doinbest/Yachiyo/xjx/模版搭建/Code/upper-computer-web/local-car/assets/parasol-original.png

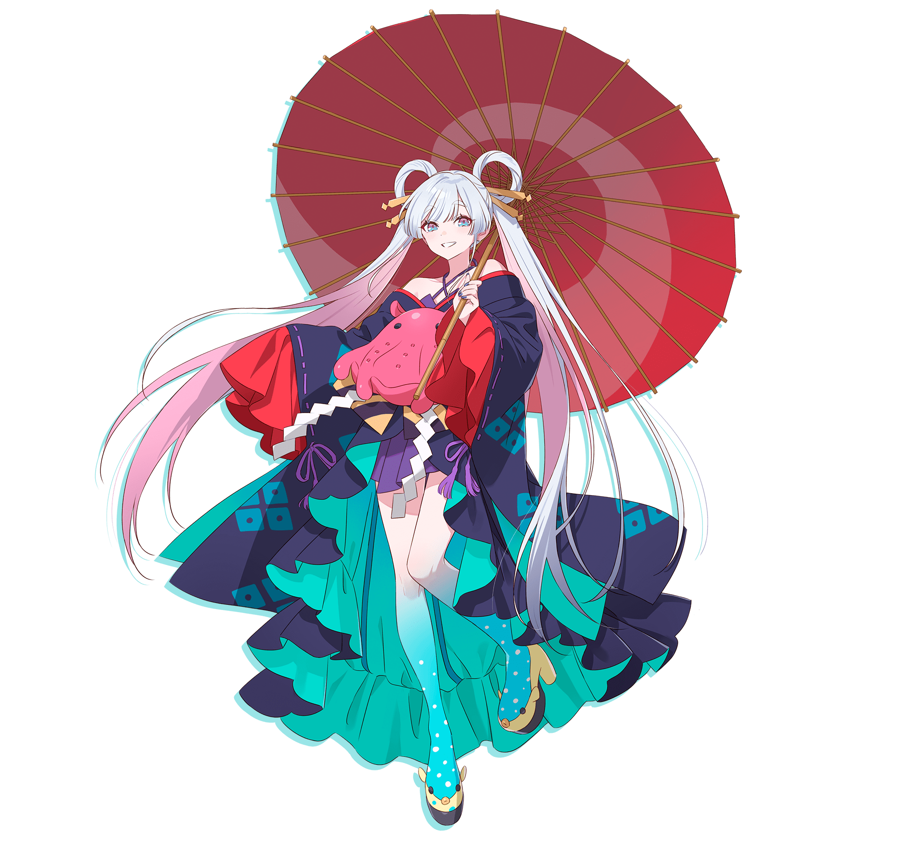
xjx/模版搭建/Code/upper-computer-web/local-car/assets/parasol-original.png
