doinbest/Yachiyo/xjx/模版搭建/docs/开发记录/README.md

# 历史开发记录索引

- [编号环外部85与车仓18](2026-10-17-编号环外部85与车仓18.md)：外部取放默认85 mm，车仓取出及固定放回共用18 mm；仅修改源码、网页初值与对应说明，未测试编译或烧录。

- [取消独立编号环取仓X30避让](2026-10-17-取消独立编号环取仓X30避让.md)：run/take取仓后X保持收回，Z高位后再转Base；正式比赛及反向store保持，验证和下载状态分别记录。

- [机构None动作应答与查询保留](2026-10-17-机构None动作应答与查询保留.md)：修改前保存0d2bff5；ID5～8动作按TX完成推进，保留真实查询及200 ms到位证据；只编译、审查，未烧录或操作实车。

- [独立编号环取仓先抬Z再转Base](2026-10-17-独立编号环取仓先抬Z再转Base.md)：仅run/take采用抬Z/收X并行准备，夹紧后Z高位与X避让均到位再回转；比赛与反向store保持，验证和下载分别记录。

- [使能与回零前核验Receive](2026-10-17-使能与回零前核验Receive.md)：覆盖ID5～8首次使能/HOME，RAM核验完成才发送，停止/失能不等待；相关验证和编译通过，用户明确要求未烧录。

- [静止应答模式切换诊断入口](2026-10-17-静止应答模式切换诊断入口.md)：四轮RAM模式切换/轮询交错/2、3、5 ms对照，保留运动拦截、停车优先和恢复原设置；实现、软件验证、下载与实机分别记录。

- [混用驱动版本只读识别](2026-10-17-混用驱动版本只读识别.md)：bus read ID version，兼容5/7版本帧，编译/下载/真实读取状态单列。

- [编号环共用高度与双向完整取放](2026-10-17-编号环共用高度与双向完整取放.md)：一个外部高度、一个车仓升降距离；正向放置后抬Z，反向入仓后抬Z/X30/Base回位，未测试编译下载。

- [比赛航向测试接口适配修复](2026-10-17-比赛航向测试接口适配修复.md)：运动/取仓替身衔接补齐，参数传递和5组相关回归通过；全量推进至底盘零速交接断言，仅修改测试层。

- [静态视觉自适应制动与X速度前瞻](2026-10-17-静态视觉自适应制动与X速度前瞻.md)：制动预算随实际批次/反馈年龄更新，静态X按纠偏速度执行60 ms有限前瞻，保留完成精度；软件、编译、下载及实车状态分别记录。

- [正式比赛可选起步平滑处理](2026-10-17-正式比赛可选起步平滑处理.md)：新增默认关闭的lower/linear开局连续转向选项，保留QR停车、K倍率、暂停进度和原默认路线；源码/主机验证/未下载状态分别记录。

- [航向测试入口返回值修复](2026-10-17-航向测试入口返回值修复.md)：补显式返回值，两项航向测试通过；完整回归已越过旧阻断点，后续停在比赛航向夹具缺接口处，仅改测试。

- [第二批物料台接近直线误限速修复](2026-10-17-第二批物料台接近直线误限速修复.md)：长直线与60弯道分离，正式linear接近上限800，后续路线静态检查；未测试编译下载。

- [静态视觉底盘与X独立调度](2026-10-17-静态视觉底盘与X独立调度.md)：底盘不再被普通机构查询连带阻塞，X最新目标空闲发送，保持最终精度与停稳；验证、编译与下载分别记录。

- [正式比赛加工与首层暂存离站矫正](2026-10-17-正式比赛加工与首层暂存离站矫正.md)：保留两批加工离站，补第一批暂存离站；第二批码垛暂不增加，未测试编译下载。

- [编号环视觉矫正取仓放置完整入口](2026-10-17-编号环视觉矫正取仓放置完整入口.md)：grab ring run环/仓/本次下降距离，自动航向及位置对准后取仓放置；源码接入，未测试编译下载。

- [比赛倍率K统一缩放](2026-10-17-比赛倍率K统一缩放.md)：总限速、各段平移速度及起停加速度统一缩放并锁定，网页草稿/设备值分离；后续按用户要求停止编译和审查，未下载。此前已执行验证事实单独记录。

- [静态视觉有限目标反馈间断续调](2026-10-17-静态视觉有限目标反馈间断续调.md)：资格暂缺保留目标并暂停使用，连续实测恢复后续调；已审查并补主入口反馈边界回归，同步现行文档，验证与烧录状态分别记录。

- [工位放置高度110与码垛100](2026-10-17-工位放置高度110与码垛100.md)：加工/第一层暂存共用110 mm，码垛100 mm；共用加工夹取同步110，仅源码修改。

- [加工区取回后离站航向矫正](2026-10-17-加工区取回后离站航向矫正.md)：两批加工三件全部入仓记账后，空爪观察并复核航向，再回Base、退出转向；软件、编译和手动烧录状态分别记录。

- [加工与暂存旧故障覆盖审查](2026-10-17-加工与暂存旧故障覆盖审查.md)：四工位分支未确认旧故障复发，13组工位/集成专项及16个ID8抢占场景通过；新增离站校正的现行文档例外待对齐，本轮未改运行代码或下载。

- [比赛转向上限与固定视觉选项](2026-10-17-比赛转向上限与固定视觉选项.md)：转向可选360、默认100，高位与视觉矫正固定开启；仅改源码未测试下载。

- [比赛控制台默认开启视觉航向矫正](2026-10-17-比赛控制台默认开启视觉航向矫正.md)：比赛卡片与命令构造默认开启，保留显式关闭和设备实际读回；仅网页修改，25项相关测试通过。

- [X/Z驱动加速度0档试用](2026-10-17-XZ驱动加速度0档试用.md)：默认及接口改为支持X/Z零档，按用户安排未测试、编译或下载。

- [ID8反馈查询被停车抢占修复](2026-10-17-ID8反馈查询被停车抢占修复.md)：纯查询取消只重采反馈，不重放运动或延长原期限；新专项及22组联动通过，Keil 0错误0警告，未烧录，代码审查按用户要求延后。

- [静态对准停稳衔接与提前识别](2026-10-17-静态对准停稳衔接与提前识别.md)：连续静止时间接续但补新反馈，加工/暂存/码垛换环及准备期间预请求，接管不重启且排除准备期坐标；本轮仅主机验证，未编译烧录。

- [物料台与车仓下降高度调整](2026-10-17-物料台与车仓下降高度调整.md)：默认45/25/25 mm，软件验证及下载状态分别记录。

- [静态视觉恢复交接与连续纠偏修复](2026-10-17-静态视觉恢复交接与连续纠偏修复.md)：重发前保留新到坐标/待解析USB输入，采用混合批新有效帧并结束旧漏检计时；有限目标续调、速度及完成精度保持。主机验证通过，未编译主车固件、未烧录或部署视觉端。

- [取放与ID8并行衔接实施](2026-10-16-取放与ID8并行衔接实施.md)：视觉期间选仓、X30后Base/ID8并行、第三件270°提前准备、同角度读回和100 ms等待；软件验证及独立审查结果见记录，未编译主车固件、未烧录。

- [HWT101比赛快速标定](2026-10-16-HWT101比赛快速标定.md)：保留完整20＋30秒，新增显式20＋10秒快速模式；内部采集、判据、保存与恢复共用。定向C及网页验证通过，未编译主车固件、未烧录或实车验收。

- [串口张大头多机控制对照分析](2026-10-16-串口张大头多机控制对照分析.md)：按用户范围仅比较UART张大头，区分逐轮生效、缓存同步、反馈与估时完成；未改运行代码。

- [开源工程来源清单整理](2026-10-16-开源工程来源清单整理.md)：汇总历史记录及本对话可确认的28个GitHub/Gitee入口，区分代码深读、视觉程序、邻近AGV与资料收录，仅文档整理。

- [首件放置车仓正转90度避让](2026-10-16-首件放置车仓正转90度避让.md)：按用户确认补充加工/暂存/码垛首件Base到位后ID8+90°，等到位再放置，暂停保存绝对目标；Node41项通过，C未编译运行、未烧录。

- [行驶总线故障与公开实现对照分析](2026-10-16-行驶总线故障与公开实现对照分析.md)：确认P022错误恢复会清掉未解析的完整应答；区分静态X Both竞争嫌疑、UART帧错误及坏帧，核对原厂CSDN、DMA开源示例及本地HAL；仅分析登记，未改控制代码或编译烧录。追问时更正0x04为FE，NE为0x02。

- [静态视觉实测剩余目标与2120开口恢复](2026-10-16-静态视觉实测剩余目标与2120开口恢复.md)：高位静态漏检期间按共同时间实测位移扣减有限像素目标，预计到点不假报完成；恢复车仓下降前2120 μs。静态复核及Node38项通过，C未编译运行、未烧录。

- [加工进站转向后贴近Y350](2026-10-16-加工进站转向后贴近Y350.md)：380停稳转180°后以≤50 mm/s贴近350，之后才视觉；两批固定/雷达共用，暂停续接与425离站保持，标准预览连接同步；C仅准备，未编译烧录。

- [正式比赛接入已验证色环航向矫正](2026-10-16-正式比赛接入已验证色环航向矫正.md)：正式色环反号1∶1、IMU P闭环及独立10°/s上限，地图同步与转后复测；Node54项通过，C未编译运行、未烧录。

- [加工区编号环对准耗时与取仓闭爪核查](2026-10-16-加工区编号环对准耗时与取仓闭爪核查.md)：24秒耗时拆分为首帧等待、5次视觉重获及2次F6超时；静态X Both与动态Receive区分，闭爪步骤仍在；仅分析未改程序。

- [比赛卡住问题系统分析](2026-10-16-比赛卡住问题系统分析.md)：按现场版本区分零速占用、恢复旧错误与真实通信异常；确认P014仅定位失效分支仍遗漏及P020测试前置错配，P019当前源码已改待验证；本轮只读分析、未编译烧录。

- [Z轴任务速度统一250](2026-10-16-Z轴任务速度统一250.md)：扫码、夹取、抬升、放置和入仓统一250，旧速度键同步兼容，手动Z默认2250 RPM；验证及下载状态见记录。

- [追踪结束与普通任务零速交接修复](2026-10-16-追踪结束与普通任务零速交接修复.md)：P019公共MoveTo/转向/路径接管排空零速，新取放busy拒绝保留上下文；Node38项通过，C未编译运行、未烧录。

- [比赛恢复与IMU资格五项修复](2026-10-16-比赛恢复与IMU资格五项修复.md)：P008反馈准入、P012启动模式复核、P014保留阶段等待IMU、P015未知MODE恢复及P016终态归属；源码及静态核查完成，Node124项通过，C/Keil/下载及实车未验证。

- [四轮状态补读与总线交接修复](2026-10-16-四轮状态补读与总线交接修复.md)：P018单次3A漏答有限补读，停车/迟到回复补齐原2 ms交接，保守状态年龄及自动证据；未编译烧录，C仅补用例。

- [地面与转盘取放入口及高度](2026-10-16-地面与转盘取放入口及高度.md)：地面Z−120、入仓下降20，地面静态与转盘追踪入口分开，下降共用比赛Z配置；验证与下载状态见记录。

- [参数读取取消与恢复停车修复](2026-10-16-参数读取取消与恢复停车修复.md)：P017纯读取消排空、写后快照核验及停车配置互斥，恢复前自动取证；本轮未编译烧录，C用例待运行。

- [整场比赛流程再次静态审查](2026-10-16-整场比赛流程再次静态审查.md)：确认P008后续反馈准入仍被拒绝及P016旧路线跨轮次暂停问题；P014/P015/P012仍在，速度回归夹具需同步；本轮不编译烧录。

- [扫码后右上接驳降速](2026-10-16-扫码后右上接驳降速.md)：扫码后到右上直线改800/800，停车300；本轮未编译烧录。

- [右下扫码直线降速](2026-10-16-右下扫码直线降速.md)：第3段目标速度/起步加速度改800/800，停车300；前段斜移及扫码离站不变，本轮未编译烧录。

- [原料入仓后零速交接](2026-10-16-原料入仓后零速交接.md)：修复第二件因历史底盘忙标记被bus_unavailable拒绝；专项、集成及Keil结果和下载状态见记录。本轮按用户要求暂不审查。

- [IMU全链路静态复审](2026-10-16-IMU全链路静态复审.md)：确认独立IMU短暂异常仍终止比赛、状态查询读失败阻断资格恢复，并细化P012只读复核方案；本轮仅审查，未编译或操作设备。

- [手动Base保留标定与姿态复核](2026-10-16-手动Base保留标定与姿态复核.md)：P001获准修复，手动位置保留锚点/J，清旧观测并经作业准备核验恢复；测试已补，本轮不编译烧录。

- [静态对准计时分离与稳定复用](2026-10-16-静态对准计时分离与稳定复用.md)：P007双时钟、X饱和分配、主动停车复用视觉窗口及低位Z/水平轮转；软件与编译结果见记录，本轮不烧录。

- [底部恢复兼容比赛回复](2026-10-16-底部恢复兼容比赛回复.md)：P008兼容比赛保留恢复结果，继续停车编号及四轮反馈核验；106项网页相关检查通过，未编译烧录。

- [IMU短暂异常保留地图参考](2026-10-16-IMU短暂异常保留地图参考.md)：P002暂时缺数据只撤销航向有效性，保留映射/原点；真实基准变化仍撤销。本轮不编译烧录，回归待运行。

- [扫码离站与右上角连续衔接](2026-10-16-扫码离站与右上角连续衔接.md)：linear标准右上角10 mm过点、正常路线两组停稳与反馈优先；后续工位只记录候选。本轮未编译、未烧录，C回归待执行。

- [加工离站直达Y425](2026-10-16-加工离站直达Y425.md)：加工两批末件入仓后直接返回425，统一固定/雷达交接及暂停恢复，保留进站380和视觉锚点；验证与下载状态见记录。

- [不再处理余弦雷达开局P010](2026-10-16-不再处理余弦雷达开局P010.md)：用户当前不使用余弦模式，P010移出当前待修复范围；保留代码和历史问题证据，仅文档更新。

- [HWT101保存读回恢复与结果判定修复](2026-10-16-HWT101保存读回恢复与结果判定修复.md)：P011保存后只读恢复共用5秒期限，失败总体FAIL保留测量结果；测试已补，用户要求不编译烧录。

- [动态追踪通信中断与恢复停车修复](2026-10-16-动态追踪通信中断与恢复停车修复.md)：串口首故障为ID2位置回复缺失且收到X异步通知；动态X改Receive、固定动作保留Both，取消停车与定位分离，pause撤销待续接自动恢复。编译、下载及实车状态见记录。

- [比赛恢复定位与旧动作交接](2026-10-16-比赛恢复定位与旧动作交接.md)：同一中断动作先核验新鲜反馈后续接，区分停车与定位待恢复；保留其他对话修改，本轮不编译、不烧录，C用例待运行。

- [HWT101原生标定保存确认失败核查](2026-10-16-HWT101原生标定保存确认失败核查.md)：官网及最新两轮日志表明30秒验证通过后保存读回BUSY；复现P011短暂读失败及PASS误报、P012启动未复核，未改运行代码或烧录。

- [整场比赛流程审查](2026-10-16-整场比赛流程审查.md)：确认雷达加工离站越界、静态纠偏计时与网页恢复等5项新问题，复核P002；记录主机/网页通过项及失败，未改控制代码或烧录。

- [Base作业姿态117.5度与前序改动集成交付](2026-10-16-Base作业姿态117.5度与前序改动集成交付.md)：更新共享作业/回仓角度，汇总前序近回零、诊断与视觉流程修改的本轮编译下载证据。

- [Base自动回零改为就近](2026-10-16-Base自动回零改为就近.md)：上电、rehome及网页快捷按钮改mode=0；用户确认此前驱动重置后未设零，源码未编译烧录。

- [Base回零失败事务诊断](2026-10-16-Base回零失败事务诊断.md)：补充失败命令、配置阶段、原始应答与读回差异；只增诊断，未编译烧录。

- [静态预对准交接去重](2026-10-16-静态预对准交接去重.md)：空爪对准保存位置保留已完成窗口，取仓复用有效停稳证据；新帧与失效重验保留，C用例已准备、未编译烧录。

- [比赛与视觉追踪复核](2026-10-16-比赛与视觉追踪复核.md)：正式feedback及扫码/码垛衔接符合方向，确认HOLD稳定重建和快照后重复停车两处效率问题；仅审查及修正文档，未改运行代码、未编译烧录。

- [追踪实测与估计分离](2026-10-16-追踪实测与估计分离.md)：feedback/visual不运行指令位置预测，predict保留独立估计；50 mm预算及参考改用真实时间对齐的实测位移，延迟计入限速；暂不编译烧录。

- [静态对准新帧调度与增益入口](2026-10-16-静态对准新帧调度与增益入口.md)：静态纠偏按新有效帧，忙时保留最新观测及Z总线机会；上位机静态λ显式读写核对。本轮暂不编译、不烧录，验证状态见记录。

- [视觉对准与底盘机械臂联动审查](2026-10-16-视觉对准与底盘机械臂联动审查.md)：追踪预测位置混入实测、静态100 ms忙后等待及第三轮稳定窗口；核对取仓恢复、暂停与码垛快照，同步准心和低位高度文档；本轮不改运行代码、不编译烧录。

- [视觉像素位移尺度](2026-10-16-视觉像素位移尺度.md)：固定识别姿态640×480 px覆盖450×330 mm，更新共享J默认值及网页元数据；验证、编译和下载状态分别记录。

- [2026-10-16 原地转向单P0.1](2026-10-16-原地转向单P01.md)：仅将原地转向P由0.02改为0.1，角速度上限仍100°/s；本轮不烧录。

- [2026-10-16 正式比赛速度分配](2026-10-16-正式比赛速度分配.md)：分段起步500/800/1000、停车300，航向P0.1/D0；备份、验证与下载状态分别记录。

- [普通航向纠偏死区与视觉精转例外](2026-10-15-航向纠偏死区与视觉精转例外.md)：普通平移/heading/hold增加±0.1°死区，视觉精转绕过；本轮按用户要求仅源码及静态核对，未编译、未烧录。

- [线性起步与停车减速度分离](2026-10-15-线性起步与停车减速度分离.md)：独立测试初值500/300，制动预算使用减速度，正常到点参考降零后停车；普通路线300/300保留。

- [底盘测试直接启动与按需准备](2026-10-15-底盘测试直接启动与按需准备.md)：直接提交本次运动、展示最近回报及年龄，查询与准备独立；仅网页修改。

- [底盘1ms控制与独立曲线周期](2026-10-15-底盘1ms控制与独立曲线周期.md)：控制目标1 ms、独立测试曲线周期可调，默认1 ms；软件、下载、实车状态分别见记录。

- [单段测试余弦K与航向PD可调](2026-10-15-单段测试余弦K与航向PD可调.md)：K、P、D按次受理并回报，默认沿用现行K200/P0.02/D0；验证与下载状态见记录。

- [直线航向恢复单P0.02](2026-10-15-直线航向恢复单P002.md)：关闭D，保留±0.50 rad/s限幅；软件验证、下载及实车结果分别见记录。

- [单段测试线性加速度可调](2026-10-15-单段测试线性加速度可调.md)：按次输入、端到端指令及实际值回报；软件验证、下载与实车状态分别见记录。

- [2026-10-15 直线航向PD试验版](2026-10-15-直线航向PD试验版.md)：P0.10/D0.01、40 ms实际测量率滤波、直线±0.50 rad/s；原地转向保留。
- [四轮分配、航向保持与左偏重心打滑分析](2026-10-15-底盘四轮分配与左偏重心打滑分析.md)：30×30 cm外框与轮心几何分开核对；速度逆解未见明显错误，航向为P，编码器/IMU存在滑移观测盲区；36个假设条件及三组图说明附着、加速度和段长约束，未再次操作设备。

- [四轮反馈时间对齐修复](2026-10-15-四轮反馈时间对齐修复.md)：位置组连续读取、共同时间插值及已发送目标诊断；31项相关主机、43项网页检查通过，3项既有失败另记；已下载校验，后退两米到点停稳，用户确认仍不走直，高速稳定性未通过。

- [四轮同步下发与反馈时序核查](2026-10-15-四轮同步下发与反馈时序核查.md)：同步批次未见拆批错误；真实代码主机模拟复现异步反馈假差速/假横移，快照规划目标不等于已发送目标；6项专项通过，未改固件或操作实车，实车横摆因果待证。

- [底盘解除锁定与1000 mm/s测试](2026-10-15-底盘解除锁定与千速测试.md)：解除入口恢复总线和四轮反馈，网页665项通过、正常解除入口实机验证；一米前进与两米后退到点停稳，采集中断另记；两米中段明显横摆由用户确认，直线稳定性未通过，中段采样缺失尚待定位，另有峰值超目标和末端慢收敛。

- [IMU返回正常模式后的完整验证](2026-10-15-IMU返回正常模式后的完整验证.md)：实机两段各10秒、旧固件5秒验证通过；已见零偏阶段后提前回0继续等待并完整验证/保存，新固件整轮状态见记录。

- [IMU双阶段兼容审查与实车失败核查](2026-10-15-IMU双阶段兼容审查与实车失败核查.md)：本次兼容与文档一致；最新实机在第二次读取恢复后提前读到模式0而失败，登记P003，未操作设备。

- [IMU原生标定双阶段兼容](2026-10-15-IMU原生标定双阶段兼容.md)：实机在约10秒由模式1进入模式2，被旧单模式判断误拦；兼容有效标定阶段并保留严格正常模式确认，下载及实车状态见记录。

- [IMU恢复模式复核与诊断](2026-10-15-IMU恢复模式复核与诊断.md)：恢复模式异常间隔100 ms复核、保留中止前模式证据；专项、编译及下载状态分别见记录。

- [余弦减速连续性修复](2026-10-15-余弦减速连续性修复.md)：反馈触发连续余弦减速、低速位置收敛及速度变化约束；专项、全量、编译、烧录与实车状态分别见记录。

- [底盘单段测试准备与停止副本](2026-10-15-底盘单段测试准备与停止副本.md)：独立副本主动查询、四轮反馈准备、自动结果及卡片停车；副本审查后已按用户确认合入正式工作区；合入后Node653项、Python104项通过，原有测试时序竞争已修正；重启本地服务并刷新网页后生效，未实车验收。

- [IMU读取中断续接](2026-10-15-IMU读取中断续接.md)：读取失败先等待5秒恢复，原生标定续接、验证重采完整窗口；专项、网页637项与Keil通过，下载与实车状态见记录。

- [启动参数预读取消回零](2026-10-15-启动参数预读取消回零.md)：串口重启诊断，ID7/0x42早期超时取消HOME；Both准备延后至首次固定位置动作，专项与Keil通过，下载及实车状态见记录。

- [原版视觉与STM32兼容审查](2026-10-15-原版视觉与STM32兼容审查.md)：用户当前使用上传原版；格式匹配，但旧角度有效复用及锁定后失稳会被当前STM32接受，已做跨端报文回放；本轮仅审查和状态文档同步。

- [码垛前方黑线航向](2026-10-15-码垛前方黑线航向.md)：Python/STM32/网页分开接入0D色环与0E前方黑线；专项、网页与Keil通过，全量固件仍有失败，DAP探测成功但未烧录，远端未部署。

- [比赛流程连续衔接](2026-10-15-比赛流程连续衔接.md)：扫码立即离站、恢复并行、高位连续追踪夹取、件间准备重叠及机构到位应答；本轮暂不编译、不烧录。

- [编号环独立自动取仓放置](2026-10-15-编号环独立自动取仓放置.md)：选择料盘，复用比赛的保存对准位置、取仓、恢复X和放置流程。

- [夹爪打开统一2450微秒](2026-10-15-夹爪打开统一2450微秒.md)：普通打开、车仓取料、初始化和释放共用2450 μs；夹取仍1920 μs，下载与实车结果见记录。

- [视觉作业姿态127.5度](2026-10-15-视觉作业姿态127.5度.md)：统一Base视觉准备与作业返回角，用户要求只修改不编译烧录。

- [IMU标定异常与BUSY恢复](2026-10-15-IMU标定异常与BUSY恢复.md)：持续HAL_BUSY局部恢复主控I2C2，模式退出等待通信并保留首次错误；验证及下载状态见记录。

- [总线噪声告警与恢复放行](2026-10-15-总线噪声告警与恢复放行.md)：短时RX错误保留当前事务；零速缓存已确认后的同步拒绝告警；非比赛自动通信恢复。

- [IMU原生标定审查](2026-10-15-IMU原生标定审查.md)：4项相关主机验证通过，确认P002短暂IMU异常导致地图锚点及原点丢失；同步现行协议与恢复手册，未修改固件或烧录。

- [第二层码垛先对准后取仓](2026-10-14-第二层码垛先对准后取仓.md)：空爪对准第一层同色物料、保存位置后取仓，恢复X并直接下降码垛。

- [加工进站Y380](2026-10-14-加工进站Y380.md)：两批固定路线、雷达目标与网页共用预览同步为Y380。

- [工位放置加深10 mm](2026-10-14-工位放置加深10mm.md)：加工/暂存第一层−140 mm、第二层−110 mm；加工取回共用高度。

- [加工观察点与暂存纵向进站](2026-10-14-加工观察点与暂存纵向进站.md)：加工Y400直接视觉接管、工位换环保留实际位置、中心至暂存停车转向后纵向行驶，连续转弯暂缓。

- [原料预分度与固定返回角](2026-10-14-原料预分度与固定返回角.md)：原料预分度取消Base名义角±2°门槛，保留外侧姿态与停稳反馈；固定返回参考+130°，收X阶段补交未提交分度。

- [线性模式恢复分段开局](2026-10-14-线性模式恢复分段开局.md)：线性恢复斜移至(2100,300)、停稳顺时针转90°再直行；余弦连续开局保留，预演分别选择；相关测试、审查及Keil通过，DAP检测失败未下载。

- [底盘双模式与X/Z固定档位](2026-10-14-底盘双模式与XZ固定档位.md)：默认linear300、可选cosine K200；比赛锁定与单段结果对比，X20/Z255固定动作恢复；审查修复两项网页问题，测试及Keil通过，DAP探测失败未下载。

- [X/Z余弦速度规划](2026-10-14-XZ余弦速度规划.md)：固定X伸缩、Z升降保守曲线，30个相关固件测试、34项网页测试及Keil编译通过；DAP探测失败，未下载。

- [第一批物料台恢复横移后转向](2026-10-14-第一批物料台恢复横移后转向.md)：右侧保持90°横移至物料台中间，停稳后原地转0°；第二批曲线保留，本轮仅修改未编译烧录。

- [底盘独立余弦运动测试](2026-10-14-底盘独立余弦运动测试.md)：八方向单段位移复用当前K=200，独立参考与距离/速度输入。

- [开局右通道长距离转向](2026-10-14-开局右通道长距离转向.md)：替换贴近禁区的内凹短弯，在600 mm内完成90°转向，开局段200 mm/s，固件和网页共用几何。

- [路线直线余弦加减速K200](2026-10-14-路线直线余弦加减速K200.md)：400 ms速度过渡、短段峰值适配及反馈制动，连续转弯约束保留；验证与下载结果见记录。

- [比赛动作省时与默认路线速度1000](2026-10-14-比赛动作省时与默认速度1000.md)：固定目标与完成姿态复用新鲜反馈，夹爪等待拆分为300 ms；Z先到0再收X，加工取回顺序保留。

- [上位机转向输入上限500°/s](2026-10-14-上位机转向输入上限500.md)：仅放宽网页输入，保留固件限制，相关34项测试通过。

- [近准心漏检等待与加工区900 mm](2026-10-14-近准心漏检等待与加工区900mm.md)：短漏检保留识别流、新鲜帧恢复，统一加工目标及进出站衔接。

- [暂存第一层先对环后取料](2026-10-14-暂存第一层先对环后取料.md)：空爪预对准保存位置、回仓取料后直接放置，保留暂停续接与第二层流程。

- [物料台进站姿态完成衔接修复](2026-10-14-物料台进站姿态完成衔接修复.md)：修正move位置修正阶段漏接work_ready造成的到站不夹取。

- [加工第三件车仓避让](2026-10-14-加工第三件车仓避让.md)：直接转至仓3+90°，抬Z后回仓3并行Base，保存暂停目标；后续7组C回归及编译、DAP烧录校验通过。

- [独立航向停车证据修复](2026-10-14-独立航向停车证据修复.md)：解决已停稳但0D请求被阻塞。
- [编号环简写默认高位修复](2026-10-14-编号环简写默认高位修复.md)：补齐两个串口入口的Z=0保持默认，并同步比赛默认说明。

- [航向观察高度与暂停窗口修正](2026-10-14-航向观察高度与暂停窗口修正.md)：保留更高实际Z、区分标定资格、恢复后重新观测；本轮未编译烧录。
- [独立视觉航向测试](2026-10-14-独立视觉航向测试.md)：共用准备姿态，原地观测/标定后校正。
- [加工暂存默认高位对准](2026-10-14-加工暂存默认高位对准.md)：比赛与独立工位默认Z=0识别，保留显式低位对照及原实际取放高度；含验证和下载结果。

2026-10-14：[ 比赛视觉航向分支实现与验证 ](2026-10-14-比赛视觉航向分支实现与验证.md)，默认关闭；尚未标定时开启只观测。

- [底盘三组反馈直接确认停稳](2026-10-14-底盘三组反馈直接确认停稳.md)：取消额外500 ms等待，保留停车发送后3组新鲜四轮反馈及速度/位移门槛，含回归与下载结果。
- [项目规则精简与现行约定整理](2026-10-14-项目规则精简与现行约定整理.md)：合并现行规则、迁移详细任务约定，同步旧总述和按需读取入口，仅文档调整。

- [底盘页精简与雷达页面命名纠正](2026-10-14-底盘页精简与雷达页面命名纠正.md)：底盘重复说明与指令展示精简；确认两个雷达接口均属于F407，纠正F1旧标题，网页610项回归通过。

- [比赛视觉矫正分支修改计划](../superpowers/plans/2026-10-14-比赛视觉矫正分支修改计划.md)：默认关闭的测试选项、两批阶段插入点、随Base/X/Z运动的相机约束及63字符命令兼容；尚未执行运行代码修改。

- [色环参照校正地图航向方案](../superpowers/specs/2026-10-14-色环参照校正地图航向方案.md)：IMU相对测角准确，针对摆车初始角误差，用加工/暂存固定环列校正全局航向映射；仅方案，未改运行代码。

- [新版视觉代码收录与工位校准接入分析](2026-10-14-新版视觉代码收录与工位校准接入分析.md)：原样新增视觉文件并保留旧入口；分析0x0D三环姿态、两工位调度、暂停恢复与接入验证，尚未修改固件或部署。

- [控制台全页审查与冗余分析](2026-10-14-控制台全页审查与冗余分析.md)：比赛页共享状态与停止语义、各页职责和展示层级审查；核对雷达方向、速度绑定及状态年龄，含离线验证，仅分析未重构。

- [物料取放合并追踪入口](2026-10-14-物料取放合并追踪入口.md)：统一控制台入口、颜色/参数/状态，保留折叠联调与诊断；无需烧录。

- [编号环对准高度与抬升选择](2026-10-14-编号环对准高度与抬升选择.md)：独立对准选择高低位和结束后保持/抬升，上限处省去重复运动。

- [统一DX/DY与物料台一次横移](2026-10-14-统一DXDY与物料台一次横移.md)：删除MCU旧准心与码垛重复补偿；90°一次左移至(1200,2100)再转0°，含回归与烧录结果。

- [比赛工位视觉对准高度分支](2026-10-13-比赛工位视觉对准高度分支.md)：比赛入口选择按工位高度下降对准或Z=0高位对准，固件锁定本轮模式并支持暂停续接。

- [加工区持料放置连续下降](2026-10-13-加工区持料放置连续下降.md)：车仓取料后恢复保存X，Z直接下降至−130 mm，不在−100 mm中途停顿；覆盖暂停续接与单次释放。

- [加工取回先对准再固定下降](2026-10-13-加工取回先对准再固定下降.md)：最新取回需求，−100 mm识别对准后固定水平位置下降至−130 mm；最终下降不再依赖视觉，保留机构到位和停车。

- [加工区连续下降与车仓并行分度](2026-10-13-加工区连续下降与车仓并行分度.md)：正式空爪对环连续下降，取仓/加工入仓时ID8与抬Z收X并行，加工取回下降前采用2120 µs开口。

- [加工取回在夹取高度对准](2026-10-13-加工取回在夹取高度对准.md)：先降至实际夹取高度，同高度DX/DY对准与闭爪，出窗不再提回30 mm；保留±1 px窗口，覆盖暂停和视觉恢复。

- [扫码段并行衔接](2026-10-13-扫码段并行衔接.md)：右下开局Base35°、右上扫码准备及扫码后Base回转与底盘平移重叠，保留扫码/转向汇合与新鲜避让证据。

- [比赛动作连续衔接](2026-10-13-比赛动作连续衔接.md)：末件入仓直接行驶、Base与底盘平移重叠及汇合、总线忙重试、相容纯途经点连续通过；包含并行暂停三种完成顺序验证与本轮构建下载结果。

- [比赛启动命令八字段修复](2026-10-13-比赛启动命令八字段修复.md)：网页及固件同步支持新比赛命令，定向回归通过，Keil编译及DAP下载校验成功。

- [DMA接收与比赛恢复重试](2026-10-13-DMA接收与比赛恢复重试.md)：实时DMA游标、独立恢复错误证据、限时通信重试及编号环下降对照。

- [比赛内总线恢复与扫码转向修复](2026-10-13-比赛内总线恢复与扫码转向修复.md)：通信故障保留任务、恢复并重新验证后续跑，正式扫码取消180°掉头；本批未编译烧录。

- [车仓取料开口2120 μs](2026-10-13-车仓取料开口2120us.md)：用户实测专用取料开口，车仓/Base到位后设置并等待1秒；手动2500/1920保留，本批未编译烧录。

- [夹爪自定义脉宽测试](2026-10-13-夹爪自定义脉宽测试.md)：保留2500/1920μs快捷值，新增与雷达卡片一致的手动输入；复用现有grip duty，不改自动默认、不需新固件。

- [加工台先对准再取料与X避让](2026-10-13-加工台先对准再取料与X避让.md)：先空爪稳定对环并保存X/Z，再回仓取料；前两盘提起同步伸X30mm，第三盘保持收回，恢复位置后放置；X上限130mm，本轮不编译不烧录。

- [加工台对准和放置高度](2026-10-13-加工台对准和放置高度.md)：加工台对准−100 mm、最终松爪−130 mm，Z回零后载入；流程重排继续暂缓。

- [比赛暂停与终止分离](2026-10-13-比赛暂停与终止分离.md)：暂停保留续接，停止结束本轮；修正原暂停错误依赖到位标记，统一使用实际停车反馈，保留夹持、配置、参考及库存。

- [比赛自动准备底盘定位](2026-10-13-比赛自动准备底盘定位.md)：开始即声明摆车完成，固件自动获取四轮反馈、验证并复用或建立右下定位；短时缺反馈等待恢复，普通暂停不重设原点。

- [普通位置稳定反馈到位](2026-10-13-普通位置稳定反馈到位.md)：新增缺失到位位时的时间/误差补充判定，覆盖入仓等X/Z动作；审查复位遗漏已修复，软件验证通过。

- [入仓默认下降40 mm](2026-10-13-入仓默认下降40mm.md)：固件与网页默认值同步，回归和编译通过，Keil烧录校验成功。

- [ID8正向仓位](2026-10-13-ID8正向仓位.md)：仓2/3默认+90°/+180°，测试与编译通过，Keil烧录校验成功并运行。

- [ID8近似回零继续](2026-10-13-ID8近似回零继续.md)：HOME失败后停稳验证并建立近似参考，软件验证和编译通过；OpenOCD及Keil自动下载均未成功。

- [Base负向方向回零](2026-10-13-Base负向方向回零.md)：自动Base及网页快捷入口使用方向模式；读改写保留参数，核对负向后启动，测试和编译通过，探针检测失败未烧录。

- [初始化开爪与下载规则](2026-10-13-初始化开爪与下载规则.md)：Z/X验证后先开爪再启动Base，取消两个DAP的数量要求；回归和编译通过，自动下载因SWD IDR读取失败未完成。

- [ID8到位容差与等待时间](2026-10-13-ID8到位容差与等待时间.md)：容差±2.5°仅用于完成确认，保持精确目标与电机使能；延长等待并补充超时诊断，定向回归和Keil通过，未烧录。

- [入仓返回停止后允许换色夹取](2026-10-13-入仓返回停止后允许换色夹取.md)：已释放记账后可换色换仓，自动补齐准备姿态；重复停止取消待启动任务，定向回归与Keil通过，未烧录。

- [指定料盘入仓无需库存确认](2026-10-13-指定料盘入仓无需库存确认.md)：指定1/2/3号盘直接入仓，完成后记录库存；自动选仓及续接保留，定向回归/Keil通过，未烧录。

- [车仓1号采用就近回零](2026-10-13-车仓1号采用就近回零.md)：共用选仓接口对仓1执行ID8就近回零、仓2/3保持最短定位；回零验证后继续，保留库存及任务上下文，未烧录。

- [雷达盘实测转出与收回](2026-10-13-雷达盘实测转出与收回.md)：TD-8125MG实测2450 μs转出扫描、1450 μs收回；删除旧快捷档与停PWM接口，保留手动输入，规则和代码已同步，未烧录。

- [统一比赛任务实现与验证](2026-10-12-统一比赛任务实现与验证.md)：统一入口、实际扫码与固定码分离、追踪入仓/持料放置/加工取回、停车续接、独立审查；软件验证通过，未烧录与整场实车验收。

- [统一比赛任务需求与实施计划](2026-10-12-统一比赛任务需求与实施计划.md)：统一入口、两种执行码来源都实际扫码且串口屏只显示实际码；入仓也X收回并删除旧参数，持料对准后自动放置。AGENTS/设计/计划已更新，本轮未改运行代码。

- [地图留白与控制栏空间](2026-10-12-地图留白与控制栏空间.md)：保留完整地图比例，收窄多余白色边带并扩展右侧控制栏；宽栏建图按钮三列，窄屏两列，相关回归42项通过。

- [PD12雷达盘舵机控制](2026-10-12-PD12雷达盘舵机控制.md)：五档及自定义微秒脉宽、独立停止PWM、优先取消旧命令；软件测试和Keil编译通过，未烧录，安装行程待实测。

- [手动车仓取出保持X收回](2026-10-12-手动车仓取出保持X收回.md)：take work跳过伸X到x_car阶段，Base/ID8到位等待1秒后直接下降夹取，X保持收回；其他入仓/释放配置保留。

- [手动车仓取出不依赖库存](2026-10-12-手动车仓取出不依赖库存.md)：take work按所选盘直接执行，取消库存/颜色前置要求；未知颜色不伪造红色，保留自动搬运库存及实际机构校验。

- [车仓取出保持并转128度](2026-10-12-车仓取出保持并转128度.md)：选盘、取放口到位等待1秒、默认下降40/上升40 mm，保持闭爪转到参考+128°；独立取出入口和显式停车续接，未烧录。

- [追踪夹取衔接车仓入仓](2026-10-12-追踪夹取衔接车仓入仓.md)：夹取默认100 px/10 ms、Z−50，准备到位开爪2500 µs；固件一条任务完成ID8先分度、Base回仓、放料记库存及返回，显式续接保留上下文；网页入口融合，仓位默认0°/−90°/−180°。软件验证/编译通过，未烧录。

- [追踪夹取窗口与保持时间可调](2026-10-12-追踪夹取窗口与保持时间可调.md)：上位机可调双轴夹取窗口及连续视觉保持，默认±5 px/200 ms；下降仍50 px，保留Z到位/停车反馈，启动前读回确认。

- [纯视觉追踪恢复速度与增益](2026-10-12-纯视觉追踪恢复速度与增益.md)：用户实车反馈80/30、lambda1过慢，两验证组恢复160/60 mm/s、lambda2，保留X前瞻60 ms；只调整参数，提前减速算法未在本轮修改。

- [追踪夹取两阶段下降](2026-10-12-追踪夹取两阶段下降.md)：双轴50 px边追踪边下降，默认5 px与Z到位后停车确认闭爪；下降暂停/恢复、Z反馈轮询及中文提示同步，软件验证通过，待实车验收。

- [纯视觉追踪收敛参数调整](2026-10-12-纯视觉追踪收敛参数调整.md)：visual/feedback默认80/30 mm/s、lambda1.0、X前瞻60 ms；原预测参数保留，网页模式预设与固件同源。

- [物料追踪与码垛采用视觉偏差](2026-10-12-物料追踪与码垛采用视觉偏差.md)：物料视觉默认372/345，追踪与码垛直接使用B2 DX/DY，保留码垛39/−1补偿及独立静态参考。

- [Base回零降级继续](2026-10-12-Base回零降级继续.md)：单独 HOME 失败经实际零速与位置验证后接受近似参考；保留严格模式、局部确认和硬故障停车。

- [Base电流与驱动诊断](2026-10-12-Base电流与驱动诊断.md)：新增单次只读电流/回零/驱动配置查询，核对重载调参依据与限制。

- [Base与ID8角度关系纠正](2026-10-12-Base与ID8角度关系纠正.md)：Base回零即朝向车仓，作业+128°、默认回仓−128°；ID8仓位独立。

- [准备抓取128度同步](2026-10-12-准备抓取128度同步.md)：共用准备姿态改为回零参考加128°，当时车仓方向误设为Base参考−90°，已按用户澄清纠正。

- [Base最后回零](2026-10-12-Base最后回零.md)：Z/X与ID8先并行完成，上电Base最后回零；重新回零同样先Z/X、后Base，保留停止与局部验证。

- [抓取任务状态查询入口说明](2026-10-12-抓取状态查询入口说明.md)：先在独立副本验证，再应用正式控制台；准备按钮旁提供明确查询与反馈跳转，追踪页展示抓取状态，拒绝提示说明具体入口。

- [2026-10-12-规则与机构运行基线确认](2026-10-12-规则与机构运行基线确认.md)：确认Base侧方准备128°、夹爪当前2500/1920 µs及旧结构500/700 µs、香橙派无需重开、ID8仓位0°/−90°/−180°、右下−180°起步及右上雷达(2050,2250)；本次仅同步文档，明确准备角与仓位默认值的固件差距。

- [2026-10-12-底盘标定向导与归位验证计划](../superpowers/plans/2026-10-12-底盘标定向导与归位验证计划.md)：用户认可上位机标定向导后形成完整计划，覆盖三系数共用模型、STM32测试采样、实测拟合、参数应用复测及最终180°归位。当前仅文档，尚未实现、构建、烧录或实车验收；照片中心偏差仅作粗估，不写固定补偿。

- [控制台开始停止链修复](2026-10-12-控制台开始停止链修复.md)：全局手动机械臂停车、单轴ACK抢占、HTTP旧动作取消、解除编号匹配及三模式只读查询。

- [姿态准备停止与局部参考恢复](2026-10-11-姿态准备停止与局部参考恢复.md)：准备中停止后直接重试，只补剩余动作；手动Base就近回零后由准备入口局部确认并继续。

- [右下跑图起步朝向统一](2026-10-11-右下跑图起步朝向统一.md)：按已确认二维码前路线统一180°起步，驶入通道后转90°；固件与C预演一致。

- [2026-10-11-扫描与跑图准备解耦](2026-10-11-扫描与跑图准备解耦.md)：支持先扫描后准备；复用合适原点，保留地图与行车就绪的独立判断。

- [UART5应答期限按接收时间判定](2026-10-11-UART5应答期限按接收时间判定.md)
- [2026-10-11-转盘点动与UART5串口诊断](2026-10-11-转盘点动与UART5串口诊断.md)：静止ID8测试、总线恢复、重复点动模式问题与即时故障回复。

- [2026-10-11-上电四机构并行回零](2026-10-11-上电四机构并行回零.md)：恢复ID8就近回零，三轴先启动再验证，停车中断所有未完成回零，四者完成后交接IMU。

- [2026-10-11-上位机Z轴相对角度范围](2026-10-11-上位机Z轴相对角度范围.md)：Z轴输入及发送校验统一为±3600°，Base/X保留±360°。

- [2026-10-11-总线恢复残余速度复查](2026-10-11-总线恢复残余速度复查.md)：复现单次残余速度导致恢复退出，原期限内复查并补充速度诊断。

- [2026-10-11-物料追踪纯视觉与反馈减速对照](2026-10-11-物料追踪纯视觉与反馈减速对照.md)：保留预测追踪，新增两个只跟随验证入口，参数隔离及停转过调审查。

记录保留当时版本、原因、参数和验证状态，不自动代表当前设备版本或现行操作。当前入口见[资料索引](../README.md)，已知暂缓问题见[问题清单](../待解决问题.md)。

[2026-10-09整理前文档快照](2026-10-09-文档整理前快照/README.md)保存旧规则、README、协议和交接内容。

## 2026-10

2026-10-11 二维码路线到点转180°：按用户要求，在专用二维码测试的两种起点路线末段追加原地转向，右下直行到接近点后由90°转至−90°，右上由−90°转至90°。沿用 `ChassisMotion_TurnTo` 的IMU闭环、四轮停车确认和取消流程，转向耗时计入路线段预算；只有转向完成并停稳才交给原Z下降/上升扫码逻辑。右下出发斜移、顺时针90°以及正式固定路线、搬运任务经过二维码的行为保留。状态新增原因 `qr_scan_turn`，网页显示“到二维码处原地转180°”，相关按钮说明、操作手册与底盘协议同步。

新增路线及扫码交接断言在旧实现分别失败，修改后通过；验证两起点最终航向、原地转向、单次执行、取消、驱动故障、停车未确认时不继续及Z等待转向。完整固件主机回归PASS，见[固件回归](../../.embeddedskills/tests/qr-arrival-turn-firmware-suite.log)；网页548项通过，见[网页回归](../../.embeddedskills/tests/qr-arrival-turn-web-suite.log)。Keil template构建0错误0警告，见[构建日志](../../.embeddedskills/build-qr-arrival-turn/template-template-build.log)，Flash 256280字节、RAM 187032字节。本次未烧录、复位或发送实车指令；实际转向尚未上板验收，此前ID4无有效应答和ID1帧错误须在实车测试前解决。

2026-10-11 18:25 单ID4通信实测：用户执行 `bus test 4 10`，发送完成30、有效应答0、应答超时30、UART错误0、拒绝0。此次主控与地址4未建立有效应答通信；与18:23 ID1的18笔正常/12笔UART错误不同。测试允许运动隔离下的选定只读请求，且发送计数30，不能将无应答解释为运动锁定拦截。received=0仅表示没有匹配地址/功能/格式的有效应答，不证明RX线上无任何字节；max_reply_ms=0为没有成功样本，不是零延迟；uart_errors=0也不等于通信健康。仍需核对驱动实际地址4、115200/8N1、串口模式和TX/RX/GND支路；用户此前4号重启与Phase相线报错不直接证明本次超时根因。全断电后只保留主控与4号通信支路、正确共地并供电复测，可区分多机共线影响与目标支路/配置问题。此次仅读取用户日志并记录分析，没有改产品代码、烧录或发送实车命令。

2026-10-11 18:23 单ID1通信实测分析：用户在已烧录测试版上执行 `bus test 1 10`，发送30笔，有效18、UART错误12、超时0、拒绝0，成功应答耗时均显示1 ms；状态3A为5/10正常，位置36为5/10正常，速度35为8/10正常。11笔0x04 FE，1笔0x06 NE+FE；HAL当前包定义NE=0x02、FE=0x04，[ST RM0090第980页](https://www.st.com/resource/zh/reference_manual/DM00031020.pdf)说明FE为接收停止位未在预期时刻被识别，NE为采样噪声。成功原始状态`01 3A 03 6B`表示使能和到位，速度`01 35 00 00 00 6B`为0，位置计数7至15；本轮不支持把问题归为驱动未使能、完全无应答或单纯等待预算不足。检查源码确认仅目标ID查询，其他普通提交/排队读暂停；成功查询间隔20 ms，故障后排空并等待100 ms安静，运动锁定仍保留。记录的是故障查询数，不是错误字节数，1 ms也不证明可靠性。

上述证据优先提示UART5接收信号/配置及共享TTL支路问题，不能据事务ID断言ID1驱动故障，也不能仅靠这组日志排除主控接收/时钟等因素。用户此前确认ID8通电且通信连接，不能沿用旧未供电ID8假设；本轮全部节点供电和实际地址仍需实物核对。后续先相同条件分别测ID2/4/6作比较，再在全断电后只保留主控与目标ID通信支路、正确共地后复测同一命令，以区分共享支路影响和目标链路问题；本轮只分析源码、用户日志和官方手册，未改产品代码、未烧录或发送实车命令。

- [2026-10-11-机械臂设零与回零快捷按钮](2026-10-11-机械臂设零与回零快捷按钮.md)

2026-10-11 18:22 单ID通信测试固件烧录：用户明确要求烧录，沿用已确认CMSIS-DAP/SWD、4000 kHz、stm32f4x配置，将最终Keil `template.hex` 写入主车并执行verify/reset。OpenOCD返回programmed=true、verified=true、returncode=0；固件SHA256为 `5DE60C36900F06D5CE389CE6993FD14BB10B308E3D6E464432FD03DAA572319D`，证据见[烧录结果](../../.embeddedskills/logs/openocd/bus-test-flash-20261011.json)。本次未发送电机通信测试或其他串口命令，单ID实物通信尚未验收。烧录后须重开香橙派程序，等待用户完成后再进行依赖视觉的实车测试；网页串口服务更新需重启服务并刷新网页。

2026-10-11 单ID电机通信测试：按用户要求新增 `bus test <1..8> [1..100轮]`（默认10轮）、`bus test status`、`bus test stop`。独立PROBE事务来源保留原0～7编号，暂停其他普通总线提交/排队读，等待原在途只读事务和100 ms线路安静后，仅发所选ID的3A/36/35查询；不运动、不使能、不写配置，紧急停止可打断。已有运动隔离时允许选定只读查询，成功不解锁、不抹首次故障，一台超时后可换测另一台，不要求全部8台先恢复。逐笔打印原始HEX、耗时与当前UART错误，汇总发送/有效回复/超时/传输错误/拒绝；发送超时与应答超时分开。共享TTL线路的电气干扰、重复地址仍需实物对照，不能凭事务ID认定故障来源。

网页“系统与标定”增加ID选择、测试轮数、结果和结束入口，前后端停止锁定的只读白名单均同步，普通进入/刷新不发测试帧。控制台原实现先在新增命令断言处失败，修改后通过；真实motor_bus虚拟UART验证目标ID独占、非目标回复忽略、锁定下测试、当前NE与历史FE分离、超时后换ID、运动准入及紧急停止。完整固件回归通过，见[回归日志](../../.embeddedskills/tests/bus-test-firmware-suite.log)；收尾故障提示与统计回归通过，见[控制台验证](../../.embeddedskills/tests/bus-test-console-final.log)。网页548项、服务39项通过，见[网页日志](../../.embeddedskills/tests/bus-test-web-suite.log)、[服务日志](../../.embeddedskills/tests/bus-test-bridge.log)，最后的发送/应答超时显示专项21项通过，见[终端日志](../../.embeddedskills/tests/bus-test-terminal.log)。最终Keil template构建0错误0警告，见[构建日志](../../.embeddedskills/build-bus-test-final/template-template-build.log)。未修改EIDE、官方Emm驱动或硬件配置，未烧录、复位或发送实车命令，实物通信尚未验收。

2026-10-11 17:23用户提供底盘run运行时帧错误：09:34:56构建的设备在启动前`locked=0 reason=idle error=0 ack=2 units=65536 yaw_valid=1`，`chassis run 100 0 0 1000`受理后首次故障为`reason=uart_error fault_ms=60214 owner=1 addr=1 func=0xF6 active=1 wait=1 uart_error=0x04`。HAL当前包将0x04定义为FE；[ST RM0090第980页](https://www.st.com/resource/en/reference_manual/rm0090-stm32f407-advanced-armbased-32bit-mcus-stmicroelectronics.pdf)说明接收时未在预期时刻识别停止位会由硬件置FE。故障发生在底盘速度指令应答阶段，不是启动准入拒绝、ID8读取超时或软件校验失败；上下文ID1不证明干扰源必为ID1。普通完整应答后2 ms交接仍在源码，未发现此次修改删除延时；9月27日已实测未供电TTL节点仍连接时FE、全部供电后恢复，现优先询问ID8及其他节点供电/通信连接状态，再核对地址、115200/8N1和支路波形。启动`recovered_fe=1 last_ms=33`是启动早期历史恢复，与本次60214 ms错误分开。证据见[用户日志摘录](../../.embeddedskills/wheel-single-check-20261011/chassis-run-fe-user-1723.log)。本轮仅分析和记录，无产品代码修改，无实车发送或烧录；具体电气或驱动应答原因尚未实测定位。

17:23诊断补充：用户回复确认ID8通电且通信线连接，因此不能把本次故障归为ID8未供电支路。其余节点的供电、实际地址及UART设置仍待核对；此前用户对4号驱动做的Rebot是否为普通重启或Restore尚不明确，只有恢复出厂才需重点核对地址是否改变，不将普通重启等同地址恢复。后续以单ID1只读查询及单支路对照区分驱动/配置和共享线路问题，再判断连续应答交接。此补充未定位具体故障源。

2026-10-11 关闭ID8车载转盘上电自动回零：用户要求仅取消转盘启动回零。将 `Turntable_Init()` 的自动待办标志初始化为false，三轴 `home_complete` 不再触发ID8使能、回零或位置查询；手动 `turntable home`、原点建立、分度与库存语义保留。新增缺失ID8的启动回归：连续600次主循环、机械臂由未就绪转为就绪，不发送电机帧、不锁共享总线、不伪造参考；旧实现先断言失败，修改后通过，后续手动回零仍读取实际多圈位置建立第一仓参考。完整固件主机回归PASS，见[回归日志](../../.embeddedskills/tests/id8-manual-home-suite.log)；Keil `template.uvprojx` / Target `template` 增量编译0错误0警告，见[构建日志](../../.embeddedskills/build-id8-manual-home/template-template-build.log)。已同步硬件基线、机械臂协议和视觉任务说明。本次仅修改和构建，未烧录或发送实车命令；设备仍需更新固件才生效，既有ID1恢复超时未在此次修改中验收。

2026-10-11 09:22底盘run拒绝诊断：`chassis run 100 0 0 1000`格式有效；09:22:01 IMU验证通过。沿此前串口诊断授权，经已连接COM11、115200服务仅发送`chassis task`和`info`，09:26返回`reason=bus_unavailable locked=1 units=65536 yaw_valid=1`，首次共享总线故障为`reason=reply_timeout fault_ms=7833 owner=7 addr=8 func=0x36 uart_error=0`。该故障发生在三轴回零完成、车载转盘自动就近回零受理之后：ID8位置读取未得到应答，隔离共享总线进而禁止底盘启动；不是此次run参数或IMU验证失败。此前多次`bus recover`还在ID1查询超时，恢复失败与首次ID8故障须分开判断。需实物核对ID8供电、地址、通信及底盘ID1应答，尚未确认具体线缆/驱动原因。证据见[当前诊断](../../.embeddedskills/wheel-single-check-20261011/chassis-run-current-diagnostic.log)与[拒绝及恢复记录](../../.embeddedskills/wheel-single-check-20261011/chassis-run-rejection.log)。未改产品代码，未发送运动、使能、恢复或复位命令。

2026-10-11 单轮指令与极性审查：核对 `arm_console.c` 的 fl/rl/rr/fr 解析、`motor_id_config.h` 的 ID1～4、`mecanum_chassis.c` 的单帧非同步 F6 批次，以及 `motor_bus.c` 的原帧 DMA 发送。当前源码的每条 `wheel` 只给目标 ID 写入非零速度，不广播启动、不作 IMU 纠偏，但不会停止此前已启动的其他轮子；逐轮验证须在两次测试间 `wheel stop` 并确认停车。`+10/-10 RPM` 八组虚拟 UART 检查通过；连续 fl→fr 检查证明只发送 ID1、ID4 两条非零 F6，中间没有给 ID1 停车。日志见 [polarity-review.log](../../.embeddedskills/wheel-single-check-20261011/polarity-review.log)。正值方向配置为左前/左后 dir=0、右后/右前 dir=1，负值反转；新结构的实际极性、已烧录版本和实物联动尚未由本次检查确认。本次未修改产品代码，未发送实车命令。

后续实物现象：用户报告 rl -10 时2/4轮转、rr -10 时3/4轮转、fr -10 时4轮不转，并确认四轮全部接地。现有服务日志确认08:06:48、08:07:14、08:07:33三条命令被主控受理，中间08:07:05和08:07:24均已确认停车，排除此前命令持续未停这一解释；启动构建标记仍为05:46:06。日志见 [ground-follow-up.log](../../.embeddedskills/wheel-single-check-20261011/ground-follow-up.log)。接地状态下4号轮可能被整车位移带动，尚不能认定4号驱动响应其他地址；建议先架空四轮复测4号正反转，确认轮胎绕自身轴转动后再判断极性。主控受理、驱动应答及实际转动分别判断；本次仅读取已有服务日志，没有发送运动、配置或查询指令。

使能入口核查：用户随后确认右前轮未成功使能。当前 `wheel` 只发 F6 速度帧，底盘没有单独 F3 使能的 ASCII 入口，也没有四轮启动使能流程；`enable base|z|x|all` 仅机械臂ID5～7，`turntable enable` 为ID8。官方 `Emm_V5_En_Control` 与X42S手册第50页一致，ID4立即使能帧为 `04 F3 AB 01 00 6B`，属于电机总线二进制协议，不能作为网页ASCII文字指令粘贴执行。板子上电与电机输出使能分开；未使能的具体原因需核对EN配置、驱动状态或保护记录。此轮仅解释现有入口，没有修改产品代码或发送使能命令。

4号驱动重启后的新增证据：用户报告屏幕 `Phase AABB error`。厂家张大头智控发布的 [ZDT_X系列_V2说明书](https://2048ai.net/681c767ba5baf817cf497faa.html) 将 `Phase AA BB Error`、`Phase A+ A- Error`、`Phase B+ B- Error` 列为电机线序错误；当前X42S手册第6页亦将Phase相线错误指向线序检查。建议断电并与驱动断开后测两组绕组、检查接头/断线，按同组接A+/A−及B+/B−，确认无误后空载校准。原先4号未主动转动与相线错误相符，但未实测确认具体接线或电机/驱动故障。用户的Rebot是否为普通重启或Restore恢复出厂尚不明确；若为后者，校准后另核对ID4。未改代码或执行实车命令。

- [2026-10-11-右下起点二维码路线测试](2026-10-11-右下起点二维码路线测试.md)

- [2026-10-11-恢复三轴上电回零与使能恢复](2026-10-11-恢复三轴上电回零与使能恢复.md)

- [2026-10-11-暂时关闭机械臂上电自动回零](2026-10-11-暂时关闭机械臂上电自动回零.md)

- [2026-10-11-实车点云冻结与采集方向修复](2026-10-11-实车点云冻结与采集方向修复.md)

- [2026-10-11-清除历史雷达结果](2026-10-11-清除历史雷达结果.md)

- [2026-10-11-雷达安装随起点与独立坐标](2026-10-11-雷达安装随起点与独立坐标.md)

- [2026-10-11-车辆状态卡片精简](2026-10-11-车辆状态卡片精简.md)

- [2026-10-11-雷达参考坐标与实车映射修正](2026-10-11-雷达参考坐标与实车映射修正.md)

- [2026-10-11-实车起点与停车信息精简](2026-10-11-实车起点与停车信息精简.md)

- [2026-10-11-预演转向停顿与机械臂标记](2026-10-11-预演转向停顿与机械臂标记.md)

- [2026-10-11-F407十五圈稳定雷达接入](2026-10-11-F407十五圈稳定雷达接入.md)

- [2026-10-11-地图监控分工与路线编号](2026-10-11-地图监控分工与路线编号.md)

- [2026-10-11-实车监控与路线计划对照](2026-10-11-实车监控与路线计划对照.md)

- [2026-10-09-右上起点二维码与缓慢降Z控制测试](2026-10-09-右上起点二维码与缓慢降Z控制测试.md)

- [2026-10-09-X42瞬时堵转误判与追踪停车修复](2026-10-09-X42瞬时堵转误判与追踪停车修复.md)

- [2026-10-09-追踪电机故障串口排查与后台记录](2026-10-09-追踪电机故障串口排查与后台记录.md)

- [2026-10-09-逐帧像素记录与速度诊断精简](2026-10-09-逐帧像素记录与速度诊断精简.md)

- [2026-10-09-动态追踪整段磁盘记录与TXT导出](2026-10-09-动态追踪整段磁盘记录与TXT导出.md)

- [2026-10-09-控制台故障原因中文提示](2026-10-09-控制台故障原因中文提示.md)

- [2026-10-09-反装夹爪舵机2500与1920脉宽同步](2026-10-09-反装夹爪舵机2500与1920脉宽同步.md)

- [2026-10-09-MaterialVision退役与控制台保留](2026-10-09-MaterialVision退役与控制台保留.md)
- [2026-10-09-底盘与视觉任务收敛](2026-10-09-底盘与视觉任务收敛.md)
- [2026-10-09-项目规则README与协议分层整理](2026-10-09-项目规则README与协议分层整理.md)
- [2026-10-09-退役ArmVision独立对准](2026-10-09-退役ArmVision独立对准.md)
- [2026-10-09-机械轴参数统一与定义收敛](2026-10-09-机械轴参数统一与定义收敛.md)
- [2026-10-09-控制台输出与旧版本冗余清理](2026-10-09-控制台输出与旧版本冗余清理.md)
- [2026-10-09-取消上层代码风格要求与规范精简](2026-10-09-取消上层代码风格要求与规范精简.md)
- [2026-10-08-静态对准统一与手动码垛滚轮调高](2026-10-08-静态对准统一与手动码垛滚轮调高.md)
- [2026-10-08-转动物料追踪反馈饥饿与停车锁定分析](2026-10-08-转动物料追踪反馈饥饿与停车锁定分析.md)
- [2026-10-08-编号环独立参考点378333](2026-10-08-编号环独立参考点378333.md)
- [2026-10-08-编号环横向接近与渐进下降](2026-10-08-编号环横向接近与渐进下降.md)
- [2026-10-08-编号环对准追踪参数与顶部返回修复](2026-10-08-编号环对准追踪参数与顶部返回修复.md)
- [2026-10-08-编号环对准后保持低位观察](2026-10-08-编号环对准后保持低位观察.md)
- [2026-10-08-码垛准心后固定像素补偿](2026-10-08-码垛准心后固定像素补偿.md)
- [2026-10-08-控制台视觉任务UI整理](2026-10-08-控制台视觉任务UI整理.md)
- [2026-10-08-控制台故障模拟与按钮恢复](2026-10-08-控制台故障模拟与按钮恢复.md)
- [2026-10-08-实时追踪过调与响应滞后分析](2026-10-08-实时追踪过调与响应滞后分析.md)
- [2026-10-08-反馈轮询切换与追踪启动修复](2026-10-08-反馈轮询切换与追踪启动修复.md)
- [2026-10-08-动态追踪行程暂停后自动续追](2026-10-08-动态追踪行程暂停后自动续追.md)
- [2026-10-08-动态追踪公平查询与停车回读修复](2026-10-08-动态追踪公平查询与停车回读修复.md)
- [2026-10-08-一键追踪与快速物料夹取](2026-10-08-一键追踪与快速物料夹取.md)
- [2026-10-08-Base微调绝对目标修复](2026-10-08-Base微调绝对目标修复.md)
- [2026-10-08-0608追踪夹取日志分析](2026-10-08-0608追踪夹取日志分析.md)
- [2026-10-07-首仓库存待核对与路线启动诊断](2026-10-07-首仓库存待核对与路线启动诊断.md)
- [2026-10-07-追踪实时长日志与发送反馈诊断](2026-10-07-追踪实时长日志与发送反馈诊断.md)
- [2026-10-07-转盘上电回零与自动软件参考](2026-10-07-转盘上电回零与自动软件参考.md)
- [2026-10-07-路线作业Base并行转向修复](2026-10-07-路线作业Base并行转向修复.md)
- [2026-10-07-蓝色首件路线与任务码隔离](2026-10-07-蓝色首件路线与任务码隔离.md)
- [2026-10-07-粗加工单件放置标定](2026-10-07-粗加工单件放置标定.md)
- [2026-10-07-机械臂统一位置接口与过度互锁检查](2026-10-07-机械臂统一位置接口与过度互锁检查.md)
- [2026-10-07-机械臂初始车载放料入口](2026-10-07-机械臂初始车载放料入口.md)
- [2026-10-07-最新版视觉数字同心圆协议分析](2026-10-07-最新版视觉数字同心圆协议分析.md)
- [2026-10-07-普通停车等待反馈应答交接修复](2026-10-07-普通停车等待反馈应答交接修复.md)
- [2026-10-07-实车后向机械臂两批任务流程](2026-10-07-实车后向机械臂两批任务流程.md)
- [2026-10-07-入仓反馈过期DAPLink验证与共用速度](2026-10-07-入仓反馈过期DAPLink验证与共用速度.md)
- [2026-10-07-UART5应答驱动统一调度实施](2026-10-07-UART5应答驱动统一调度实施.md)
- [2026-10-07-UART5应答交接间隔与入仓连续循环实测修复](2026-10-07-UART5应答交接间隔与入仓连续循环实测修复.md)
- [2026-10-07-UART5上板通信测试与紧急停车间隔修复](2026-10-07-UART5上板通信测试与紧急停车间隔修复.md)
- [2026-10-07-IMU短暂异常后有效状态恢复](2026-10-07-IMU短暂异常后有效状态恢复.md)
- [2026-10-07-ID8转盘控制台基本控制](2026-10-07-ID8转盘控制台基本控制.md)
- [2026-10-06-雷达缺包角度插值与逐圈证据修复](2026-10-06-雷达缺包角度插值与逐圈证据修复.md)
- [2026-10-06-第一阶段底盘伸缩轴稳定追踪](2026-10-06-第一阶段底盘伸缩轴稳定追踪.md)
- [2026-10-06-机械臂上电回零提交忙与故障诊断修复](2026-10-06-机械臂上电回零提交忙与故障诊断修复.md)
- [2026-10-06-实车监控判障范围恢复150至2250](2026-10-06-实车监控判障范围恢复150至2250.md)
- [2026-10-06-实车监控三圈判障与结果同步提速](2026-10-06-实车监控三圈判障与结果同步提速.md)
- [2026-10-06-串口免断电清理四轮同步缓存](2026-10-06-串口免断电清理四轮同步缓存.md)
- [2026-10-05-雷达紧凑结果原子刷新与提速实测](2026-10-05-雷达紧凑结果原子刷新与提速实测.md)
- [2026-10-05-雷达无线坏页恢复与DAPLink实测](2026-10-05-雷达无线坏页恢复与DAPLink实测.md)
- [2026-10-05-雷达单次扫描切换与旧圈补读修复](2026-10-05-雷达单次扫描切换与旧圈补读修复.md)
- [2026-10-05-车载取放口X默认100mm](2026-10-05-车载取放口X默认100mm.md)
- [2026-10-05-正式雷达首段显示与执行统一](2026-10-05-正式雷达首段显示与执行统一.md)
- [2026-10-05-正式雷达路线接驳折角优化](2026-10-05-正式雷达路线接驳折角优化.md)
- [2026-10-05-正式雷达改为F1逐格计数判障](2026-10-05-正式雷达改为F1逐格计数判障.md)
- [2026-10-05-实车监控安装偏移与场边回波实测修复](2026-10-05-实车监控安装偏移与场边回波实测修复.md)
- [2026-10-05-实车监控参考坐标90度修正](2026-10-05-实车监控参考坐标90度修正.md)
- [2026-10-05-实车监控全场雷达与绕障预演验证](2026-10-05-实车监控全场雷达与绕障预演验证.md)
- [2026-10-05-实车监控F1算法对齐实施与验证](2026-10-05-实车监控F1算法对齐实施与验证.md)
- [2026-10-05-F1雷达连续结果回传与同步提速](2026-10-05-F1雷达连续结果回传与同步提速.md)
- [2026-10-05-F1雷达持续扫描显示延迟分析](2026-10-05-F1雷达持续扫描显示延迟分析.md)
- [2026-10-05-F1雷达持续建图与无线结果同步修复](2026-10-05-F1雷达持续建图与无线结果同步修复.md)
- [2026-10-04-雷达连续实时点云](2026-10-04-雷达连续实时点云.md)
- [2026-10-04-雷达起点中心与障碍轮廓修正](2026-10-04-雷达起点中心与障碍轮廓修正.md)
- [2026-10-04-雷达恢复F1单点判障阈值](2026-10-04-雷达恢复F1单点判障阈值.md)
- [2026-10-04-雷达实机原始包验证](2026-10-04-雷达实机原始包验证.md)
- [2026-10-04-雷达安装朝向参数与历史地图提示](2026-10-04-雷达安装朝向参数与历史地图提示.md)
- [2026-10-04-雷达原始采集诊断与5x5显示](2026-10-04-雷达原始采集诊断与5x5显示.md)
- [2026-10-04-地图起点箭头与单圈雷达扫描](2026-10-04-地图起点箭头与单圈雷达扫描.md)
- [2026-10-04-LDS50C直连上位机第一阶段](2026-10-04-LDS50C直连上位机第一阶段.md)
- [2026-10-04-F407雷达建图上位机第二阶段](2026-10-04-F407雷达建图上位机第二阶段.md)
- [2026-10-04-F1雷达结果回传纠偏](2026-10-04-F1雷达结果回传纠偏.md)
- [2026-10-03-雷达通信查询验证](2026-10-03-雷达通信查询验证.md)
- [2026-10-03-雷达连续报警与停止锁定排查](2026-10-03-雷达连续报警与停止锁定排查.md)
- [2026-10-03-雷达超时排查与网页诊断修复](2026-10-03-雷达超时排查与网页诊断修复.md)
- [2026-10-03-雷达结果自动显示与分页提速](2026-10-03-雷达结果自动显示与分页提速.md)
- [2026-10-03-雷达双起点约束建图与规划](2026-10-03-雷达双起点约束建图与规划.md)
- [2026-10-03-转向100度每秒与控制台角度单位](2026-10-03-转向100度每秒与控制台角度单位.md)
- [2026-10-03-视觉联动二次提速与12秒颜色等待](2026-10-03-视觉联动二次提速与12秒颜色等待.md)
- [2026-10-03-蓝黑主题与停止入口分析](2026-10-03-蓝黑主题与停止入口分析.md)
- [2026-10-03-控制台提示地图与历史入口精简](2026-10-03-控制台提示地图与历史入口精简.md)
- [2026-10-03-控制台平移测试范围提升](2026-10-03-控制台平移测试范围提升.md)
- [2026-10-03-扫码首段先斜移再直行](2026-10-03-扫码首段先斜移再直行.md)
- [2026-10-03-开源参考路线电机RPM](2026-10-03-开源参考路线电机RPM.md)
- [2026-10-03-底盘低速转向路线与验收顺序](2026-10-03-底盘低速转向路线与验收顺序.md)
- [2026-10-03-地图留白与轨迹图例调整](2026-10-03-地图留白与轨迹图例调整.md)
- [2026-10-03-地图比例与控制区重排](2026-10-03-地图比例与控制区重排.md)
- [2026-10-03-参数页对齐与夹爪等待说明](2026-10-03-参数页对齐与夹爪等待说明.md)
- [2026-10-03-参数页密度与标题提示优化](2026-10-03-参数页密度与标题提示优化.md)
- [2026-10-03-参数控制台与ID8单件取放](2026-10-03-参数控制台与ID8单件取放.md)
- [2026-10-03-UART5上电帧错误恢复](2026-10-03-UART5上电帧错误恢复.md)
- [2026-10-02-项目目录整理](2026-10-02-项目目录整理.md)
- [2026-10-02-雷达融合实现与联调](2026-10-02-雷达融合实现与联调.md)
- [2026-10-02-视觉源码更新与align-pick容错分析](2026-10-02-视觉源码更新与align-pick容错分析.md)
- [2026-10-02-抓取参考诊断与终端精简](2026-10-02-抓取参考诊断与终端精简.md)
- [2026-10-02-STM32主车固件精简](2026-10-02-STM32主车固件精简.md)
- [2026-10-02-Code目录统一](2026-10-02-Code目录统一.md)
- [2026-10-01-网页参数调试页实施计划](2026-10-01-网页参数调试页实施计划.md)

## 2026-09

- [2026-09-30-连续视觉任务参考恢复](2026-09-30-连续视觉任务参考恢复.md)
- [2026-09-30-蓝色目标关联与阶段切换修正](2026-09-30-蓝色目标关联与阶段切换修正.md)
- [2026-09-30-蓝色协同对准预检与优化方案](2026-09-30-蓝色协同对准预检与优化方案.md)
- [2026-09-30-蓝色协同对准短暂漏检容忍](2026-09-30-蓝色协同对准短暂漏检容忍.md)
- [2026-09-30-蓝色协同对准模拟与停止修正](2026-09-30-蓝色协同对准模拟与停止修正.md)
- [2026-09-30-蓝色协同对准参数提速与对比](2026-09-30-蓝色协同对准参数提速与对比.md)
- [2026-09-30-蓝色协同对准两次恢复实测](2026-09-30-蓝色协同对准两次恢复实测.md)
- [2026-09-30-联调暂关抓取底盘行程限制](2026-09-30-联调暂关抓取底盘行程限制.md)
- [2026-09-30-烧录后蓝色协同对准串口验证](2026-09-30-烧录后蓝色协同对准串口验证.md)
- [2026-09-30-抓取Z轴默认250RPM](2026-09-30-抓取Z轴默认250RPM.md)
- [2026-09-30-夹爪700us与视觉任务颜色选择及回零分析](2026-09-30-夹爪700us与视觉任务颜色选择及回零分析.md)
- [2026-09-30-保持香橙派不变的STM32蓝色重新识别](2026-09-30-保持香橙派不变的STM32蓝色重新识别.md)
- [2026-09-30-仅协同对准改为蓝色物料](2026-09-30-仅协同对准改为蓝色物料.md)
- [2026-09-30-上位机抓取参数集中区](2026-09-30-上位机抓取参数集中区.md)
- [2026-09-29-视觉漏检暂停与有限恢复](2026-09-29-视觉漏检暂停与有限恢复.md)
- [2026-09-29-视觉初始模型底盘方向实测修正](2026-09-29-视觉初始模型底盘方向实测修正.md)
- [2026-09-29-行程超限停止确认与视觉串口诊断](2026-09-29-行程超限停止确认与视觉串口诊断.md)
- [2026-09-29-控制台中文化与通信启动改进](2026-09-29-控制台中文化与通信启动改进.md)
- [2026-09-29-X轴视觉响应同向修正](2026-09-29-X轴视觉响应同向修正.md)
- [2026-09-29-B2协议兼容恢复](2026-09-29-B2协议兼容恢复.md)
- [2026-09-27-电机总线恢复与手动操作检查](2026-09-27-电机总线恢复与手动操作检查.md)
- [2026-09-27-扫码与静止物料单件协同抓取方案](2026-09-27-扫码与静止物料单件协同抓取方案.md)
- [2026-09-27-单件抓取实现与标定](2026-09-27-单件抓取实现与标定.md)
- [2026-09-27-单件抓取实施计划](2026-09-27-单件抓取实施计划.md)
- [2026-09-27-关闭物料任务底座自动回零](2026-09-27-关闭物料任务底座自动回零.md)
- [2026-09-27-Z轴普通升降默认500RPM](2026-09-27-Z轴普通升降默认500RPM.md)
- [2026-09-27-Z轴安装方向修正](2026-09-27-Z轴安装方向修正.md)
- [2026-09-27-UART5首次锁定诊断](2026-09-27-UART5首次锁定诊断.md)
- [2026-09-26-PE9舵机按键测试](2026-09-26-PE9舵机按键测试.md)
- [2026-09-25路线速度上限与地图布局](2026-09-25路线速度上限与地图布局.md)
- [2026-09-24速度曲线离线地图实验](2026-09-24速度曲线离线地图实验.md)
- [2026-09-24-F103物料台转盘双按键控制](2026-09-24-F103物料台转盘双按键控制.md)
- [2026-09-23串口屏任务码显示适配](2026-09-23串口屏任务码显示适配.md)
- [2026-09-22默认Receive与上电IMU验证](2026-09-22默认Receive与上电IMU验证.md)
- [2026-09-22远程重启与Z轴归零](2026-09-22远程重启与Z轴归零.md)
- [2026-09-22距离制动与停稳纠偏](2026-09-22距离制动与停稳纠偏.md)
- [2026-09-22地图遥测恢复与路线速度](2026-09-22地图遥测恢复与路线速度.md)
- [2026-09-22前进变顺时针旋转静止检查](2026-09-22前进变顺时针旋转静止检查.md)
- [2026-09-22准备状态与1米每秒上限](2026-09-22准备状态与1米每秒上限.md)
- [2026-09-22停车请求节奏修正](2026-09-22停车请求节奏修正.md)
- [2026-09-22USART1-DMA与无线输出整理](2026-09-22USART1-DMA与无线输出整理.md)
- [2026-09-21控制台与历史代码清理](2026-09-21控制台与历史代码清理.md)
- [2026-09-15航向保持串口抓包](2026-09-15航向保持串口抓包.md)
- [2026-09-14起步航向保持补偿](2026-09-14起步航向保持补偿.md)
- [2026-09-14同步取消后保留只读反馈](2026-09-14同步取消后保留只读反馈.md)
- [2026-09-14停车取消反馈查询修复](2026-09-14停车取消反馈查询修复.md)
- [2026-09-14串口设备识别与静止查询](2026-09-14串口设备识别与静止查询.md)
- [2026-09-14IMU验证前Z轴归零](2026-09-14IMU验证前Z轴归零.md)
- [2026-09-14IMU改动对照与指令精简](2026-09-14IMU改动对照与指令精简.md)
- [2026-09-14COM37功能验证](2026-09-14COM37功能验证.md)
- [2026-09-14COM23遥测与最小运动复测](2026-09-14COM23遥测与最小运动复测.md)
- [2026-09-12步进底盘底层与开源实现对照](2026-09-12步进底盘底层与开源实现对照.md)
- [2026-09-12无线地图遥测限速发送](2026-09-12无线地图遥测限速发送.md)
- [2026-09-12控制台指令与网页适配分析](2026-09-12控制台指令与网页适配分析.md)
- [2026-09-12扫码与转盘接近路线](2026-09-12扫码与转盘接近路线.md)
- [2026-09-12底盘同步与二维地图对齐](2026-09-12底盘同步与二维地图对齐.md)
- [2026-09-12工创开源HWT101零偏校准核查](2026-09-12工创开源HWT101零偏校准核查.md)
- [2026-09-12实车前四段反馈路线](2026-09-12实车前四段反馈路线.md)
- [2026-09-12地图遥测COM23实测定位](2026-09-12地图遥测COM23实测定位.md)
- [2026-09-12准备跑图与10秒验证](2026-09-12准备跑图与10秒验证.md)
- [2026-09-12八千代控制台与二维码接入](2026-09-12八千代控制台与二维码接入.md)
- [2026-09-12两批搬运离线路线](2026-09-12两批搬运离线路线.md)
- [2026-09-12UART5循环DMA与单次失能故障修复](2026-09-12UART5循环DMA与单次失能故障修复.md)
- [2026-09-12HWT101原生零偏标定](2026-09-12HWT101原生零偏标定.md)
- [2026-09-12COM23共用控制台与软件停车](2026-09-12COM23共用控制台与软件停车.md)
- [2026-09-11新PCB与USB通信迁移](2026-09-11新PCB与USB通信迁移.md)
- [2026-09-11底盘补偿航向独立测试](2026-09-11底盘补偿航向独立测试.md)
- [2026-09-11工程整理与OLED三页](2026-09-11工程整理与OLED三页.md)
- [2026-09-11IMU标定Flash持久化](2026-09-11IMU标定Flash持久化.md)
- [2026-09-11HWT101手动标定与自动验证](2026-09-11HWT101手动标定与自动验证.md)

## 其他历史资料

- [第一版智能搬运车软件底座实现与使用手册](第一版智能搬运车软件底座实现与使用手册.md)
- [历史Zigbee网页原型协议](历史Zigbee网页原型协议.md)

- [比赛开始自动初始化库存](2026-10-13-比赛开始自动初始化库存.md)

- [比赛扫码Base35度姿态](2026-10-13-比赛扫码Base35度姿态.md)

- [观察位置边界误差修复](2026-10-13-观察位置边界误差修复.md)

- [比赛路线与转向速度](2026-10-13-比赛路线与转向速度.md)

- [比赛双起点与雷达分支](2026-10-13-比赛双起点与雷达分支.md)

- [加工取放与暂存共用高度](2026-10-13-加工取放与暂存共用高度.md)

- [码垛对准与释放默认−100 mm](2026-10-13-码垛对准与释放负100mm.md)

- [原料追踪并行车仓分度](2026-10-13-原料追踪并行车仓分度.md)

- [视觉角单次试转](2026-10-14-视觉角单次试转.md)

- [Base共用作业姿态130度](2026-10-14-Base共用作业姿态130度.md)

- [视觉角试转默认反号](2026-10-14-视觉角试转默认反号.md)

- [开局与物料台连续转弯](2026-10-14-开局与物料台连续转弯.md)：内侧边移边转、暂停续行与共用C预演；编译通过，当前DAP CMD_INFO失败，未烧录。

- [2026-10-14 工位取料最大开口与间隔分析](2026-10-14-工位取料最大开口与间隔分析.md)

- [2026-10-14 比赛航向仅进站一次](2026-10-14-比赛航向仅进站一次.md)

- [2026-10-14 航向五秒与间断一致采样](2026-10-14-航向五秒与间断一致采样.md)
