doinbest/Yachiyo/xjx/模版搭建/Code/reference/2026-09-26/a/Lds50cHost/README.md

# LDS-50C 扫描建图上位机

这是一个面向 Windows 的 LDS-50C-2/-3 雷达上位机。它可以从雷达串口接收单圈或持续更新的整圈原始数据，完成角度、距离和能量筛选；随后把点转换到 2400 × 2400 mm 场地坐标，生成可调整的 5 × 5 地图、标记障碍格，并用四邻域 A* 规划路径。

## 已实现功能

- 雷达直连：串口连接、`LSTARH` 启动、`LSTOPH` 停止、单圈扫描和逐圈刷新的持续扫描。
- 支持普通 `CE FA` 和固定角分辨率 `CF FA` 数据帧、状态帧和报警帧。
- 单次模式冻结一圈原始点；持续模式每完成一圈就替换为最新点云。修改角度、距离、能量筛选条件本身不会触发新扫描。
- 每次单次或持续扫描都会按固定顺序向雷达发送 `LMDMMH`、`LOCONH`、`LFFF1H`、`LSSS1H`、`LSTARH`，分别请求毫米单位、能量数据、去拖点、设备滤波并启动扫描；结束时发送 `LSTOPH`。
- 可在“接收原始”和“上位机筛选”之间切换显示，并可把最新完整一圈的接收数据导出为 CSV。显示模式不会改变障碍格和规划路径。
- 点云画布默认显示 `-2400～2400 mm` 的四个象限，支持以鼠标位置为中心滚轮缩放，也支持按住鼠标左键拖动平移；左上角实时显示鼠标所在场地坐标和相对雷达的顺时针角度。雷达默认位于第一象限左下角附近 `(230, 230) mm`。
- 2400 × 2400 mm 物理场地、5 × 5 分区、禁区编辑和路径规划只作用于第一象限；其他象限仅显示雷达回波。
- 5 × 5 分区的 4 条内部竖线与 4 条内部横线可分别拖动，也可输入毫米值。
- 中间四格为黄色固定禁区，普通格可单击切换为橙色手动禁区，扫描障碍为红色。
- 黑、白两套地图背景；路径以蓝色折线显示，编号任务点以橙色圆形标记显示。
- 支持“编号任务路线”和“普通起点到终点”两种规划方式。默认任务顺序为 `1-5-4-2-3-4-2-3-1`，允许重复经过同一格和原路回退。
- 规划结果包含完整任务顺序、展开格、物理坐标、每段距离、方向和转向（含掉头）。
- STM32 模式支持“暂存配置 → 应用配置 → 下载路径 → 读回配置校验”。
- 本机设置保存在 `%LOCALAPPDATA%\Lds50cHost\settings.json`。

## 接线警告

雷达供电与 UART 电平不是一回事：

- 雷达电源为 `DC 5.1 ± 0.2 V`，手册说明启动电流可达 1.5 A，正常工作约 300–400 mA；电源纹波应小于 50 mV。
- UART 为 `3.3 V` 电平、8 数据位、1 停止位、无校验。不要把 5 V TTL 信号直接接到雷达 RX。
- USB-UART 或 STM32 必须与雷达共地，TX/RX 交叉连接。
- 线序和颜色必须按手头硬件版本及原厂说明核对；接反电源可能损坏雷达。

## 使用方法

1. 用 5 V 稳定电源给雷达供电，以 3.3 V USB-UART 将雷达连接到电脑。
2. 运行 `Lds50cHost.exe`，按控制台显示的地址打开浏览器（默认通常是 `http://localhost:5000`）。开发环境可运行：

   ```powershell
   .\.tools\dotnet\dotnet.exe run --project .\src\Lds50cHost
   ```

3. 选择“雷达直连”、COM 口和波特率。LDS-50C-2 可用 384000；两型号均可按设备配置选 500000、768000、921600，默认 500000。
4. 点击“连接”，再点“单次扫描”。程序会启动雷达、等待完整一圈、冻结点云，然后自动发送停止命令。
5. 若要实时观察数据，点击“持续扫描”。雷达保持旋转，每完成一圈就刷新点云、障碍格和路径；点击“停止持续扫描”后保留最后一圈结果。
6. 在“接收原始”和“上位机筛选”之间切换，判断可疑点来自雷达返回还是上位机筛选。这里的“接收原始”是雷达固件处理后实际发回的点，不是激光器未经设备滤波的光学采样。
7. 调整筛选参数并点“应用筛选”；调整雷达坐标、分区边界和障碍阈值。默认使用编号任务路线；若只需普通路径，可把“规划方式”切换为“普通起点到终点”后选择起点和终点。障碍格判定与 A* 路径规划始终只使用“上位机筛选”后的点，即使画布正在显示“接收原始”。
8. 需要保留数据时，点击“下载最新完整一圈 CSV”。文件只包含已经组装完成的一圈，列依次为 `index`、`angle_deg`、`distance_mm`、`energy`；扫描尚未完成时下载按钮不可用。
9. 在地图空白处按住鼠标左键拖动可平移视图；短按普通格仍可切换手动禁区，黄色固定禁区不能解除。
10. 需要下载给 STM32 时，先断开雷达串口，把同一个串口切换到 STM32，选择“STM32 配置”，再点“下载、应用并校验”。确认运行参数无误后，如需断电保留，再单独点击“保存到 STM32 Flash”。
11. 点击“保存本机配置”，下次启动会自动加载。

角度坐标采用原厂定义：雷达正前方为 `0°`，顺时针增加。因此本软件的场地转换为 `X = 雷达X + 距离 × sin(角度)`，`Y = 雷达Y + 距离 × cos(角度)`。

## 编号任务路线

默认分区和雷达位置下，五个任务点为：

| 编号 | 所在格 | 默认物理坐标（mm） | 坐标来源 |
|---:|---|---:|---|
| 1 | R1C1 | `(230, 230)` | 雷达旋转中心的精确坐标 |
| 2 | R3C1 | `(350, 1200)` | 分区中心 |
| 3 | R5C3 | `(1200, 2050)` | 分区中心 |
| 4 | R3C5 | `(2050, 1200)` | 分区中心 |
| 5 | R1C3 | `(1200, 350)` | 分区中心 |

任务路线输入支持连字符、英文逗号、中文逗号和空白，例如 `1，5 4,2-3-4-2-3-1` 在应用后会统一显示为 `1-5-4-2-3-4-2-3-1`。路线必须包含 2～16 个编号，只能使用 1～5，必须从 1 出发并回到 1，且相邻编号不能相同。输入无效时会显示中文原因，并保留当前路径不变。

点 1 会随雷达 X/Y 参数移动；点 2～5 会随对应分区边界移动。点 2～5 所在格为任务点保护格：雷达点仍会显示并计入该格点数，但不会把这些格标红或阻断路线，也不能手动设为障碍。其他固定、手动和扫描障碍照常参与每一段四邻域 A* 规划；若某一段不可达，诊断区会明确显示类似“任务段 1→5 无可用路径”。

下载到 STM32 的仍是展开后的路径负载 v1，而不是只下载九个任务编号。协议允许重复格和回退；单帧最多 409 个路径点、408 段，总负载 4091 字节。详细字段见 [上位机与 STM32 协议](docs/stm32-protocol.md)。

## 雷达状态与异常判断

诊断面板显示最近一帧雷达状态的接收时间和四项实际状态。开始新扫描后，在收到状态帧前会显示“等待雷达状态”。本软件预期四项分别为：

- 距离单位：毫米。若显示厘米，程序会换算为毫米；状态在一圈中途变化时会丢弃当前半圈，避免一圈内混用两种单位。
- 能量数据：开启。关闭时无法可靠使用“最低能量”筛选。
- 去拖点：开启。关闭时旋转拖尾或边缘伪点可能明显增加。
- 雷达滤波：开启。关闭时雷达发回的噪点分布可能与原厂上位机不同。

状态不符合预期会以警告样式显示。要定位“空旷位置却出现一条墙”的问题，应在雷达和场地保持不动时，先看“接收原始”是否已经存在该回波，再导出 CSV 核对对应角度与距离，最后用原厂上位机测量同一面实体墙作对照。

## 构建与测试

仓库带有零外部测试框架依赖的测试运行器：

```powershell
.\.tools\dotnet\dotnet.exe restore .\Lds50cHost.slnx --source .\packages --packages .\.tools\nuget --force --force-evaluate -p:NuGetAudit=false
.\.tools\dotnet\dotnet.exe run --project .\tests\Lds50cHost.Core.Tests -c Release --no-restore
.\.tools\dotnet\dotnet.exe run --project .\tests\Lds50cHost.App.Tests -c Release --no-restore
.\.tools\dotnet\dotnet.exe build .\Lds50cHost.slnx -c Release --no-restore
```

生成 Windows x64 自包含版本：

```powershell
powershell -ExecutionPolicy Bypass -File .\scripts\publish-windows.ps1
```

输出位于 `artifacts\publish\win-x64`。硬件实测步骤见 [docs/hardware-verification.md](docs/hardware-verification.md)。

## 文档

- [LDS-50C 雷达协议](docs/lds50c-protocol.md)
- [上位机与 STM32 协议](docs/stm32-protocol.md)
- [硬件验证清单](docs/hardware-verification.md)
- [原始数据夹具说明](fixtures/README.md)

## 当前边界

- 目前没有随项目附带真实雷达整圈 `.bin` 数据，协议回归测试使用确定性生成帧；连接硬件后应按验证清单补录一圈脱敏原始数据。
- 上位机负责扫描、地图和规划，不负责根据编码器闭环控制车轮。毫米距离到电机脉冲/车轮圈数的换算必须由底盘轮径、减速比、编码器分辨率和实车标定确定。
- 路径规划始终基于当前最新的一圈地图；持续模式会逐圈重算，但车辆运动过程中仍不提供自身定位或闭环动态避障。
