doinbest/Yachiyo/xjx/模版搭建/docs/硬件与运行基线.md

# 已确认硬件与运行基线

正式比赛新增“起步平滑处理”选项，默认关闭，仅右下起点且linear允许开启，末尾可显式提交smooth=1（smooth=0或省略关闭），可与scale=<K>共同使用且任意顺序各至多一次。开启只在标准右下起点到二维码首段几何生效：先保持180°离开起点至约(2125,350)，沿右通道渐转至(2100,950,90°)，再接本轮扫码Y；中途不停车，二维码终点仍按新鲜反馈停稳。路径接近/转向段基准限速200 mm/s、出弯扫码直线基准上限800，均受本轮基准总限速及倍率K约束，航向角速度/跟随降速独立；不据此宣布提速或实车通过。Base仅在转正及原净空条件通过后准备扫码，保留与后续直行并行；暂停/继续/总线恢复锁定开关及路径进度，不从起点重放。右上/cosine显式开启拒绝，非标准雷达绕障保留原规划和分段，不以平滑替换绕障；独立二维码/普通动作及默认分段开局不变。设备报告start_smooth，底盘路线另报start_smooth_active表示当前首段实际采用；上位机草稿与设备读回分开，编辑/刷新/重连不发送。

Z任务速度统一默认250 mm/s：扫码升降、夹取下降、抬升、放置和入仓共用z_speed；保留z_pick_speed、qr_z_speed兼容键，显式设置任一项同步三项。普通手动Z默认2250 RPM（按480脉冲/mm折算250 mm/s），驱动加速度档位默认0（直接按目标速度运行，不使用驱动曲线）；显式手动调速保留，HOME仍使用驱动回零参数。网页开始夹取前统一写入并核对三项，读取时分别显示设备实际值；刷新/重连不自动写入。

固定视觉识别姿态的640×480 px画面实测覆盖45×33 cm，即450×330 mm；横向为1.422222222222 px/mm、纵向为1.454545454545 px/mm。此为用户提供的观察平面视野尺度，不是底盘各方向/X运动响应的完整实测矩阵；不同目标平面或下降高度的比例仍需分别核验。现行默认映射及适用范围见[B2协议](协议/视觉B2与动态追踪.md#视觉像素与位移尺度)。

linear单段测试支持独立起步加速度与停车减速度，各10～5000 mm/s²；网页初值500/300，参数受理后锁定，只覆盖本次独立动作。旧指令只给一个加速度时仍同时用于加、减速；固件省略参数与普通MoveTo保留300/300；正式linear比赛按路段分配起步500/800/1000，停车减速度300。制动包络用停车减速度，速度矢量减少当前平移动量时用减速度、增加时用起步加速度；前进与后退一致。普通linear直线到点进入位置/航向窗口后，先让平移参考按减速度降至零，再请求同步零速及真实停车确认；人工停止、取消和故障仍立即请求停车，原地转向和连续路径主体沿用独立控制。cosine保持K200，航向默认P0.1/D0。

底盘控制计算目标周期为1 ms；直线平移曲线更新周期默认1 ms，独立单段测试可在上位机填写1～100 ms整数。曲线周期只决定平移速度参考（含位置收敛、制动包络及加减速限制）的更新时间，中间复用最近参考；坐标系转换、按新鲜IMU更新的航向纠偏、四轮分配和到点/停车检查仍按控制循环执行。1 ms与1 ms时同频；例如曲线5 ms时，中间控制循环复用平移参考。参数受理后锁定，仅覆盖本次独立测试，后续普通任务恢复默认1 ms；原地转向、连续路径仍用各自控制。控制周期是主循环调度目标，不保证硬实时1 ms、IMU每1 ms出新样本或串口四轮批次每1 ms生效；同值去重、最新待发目标替换、同步批次及反馈组调度保留，不补发历史积压。

现行资料更新日期：2026-10-14。本文件集中保存已确认实物条件与协议事实；确认值、源码实现、烧录版本和设备RAM分别判断，几何精度及整场比赛仍须实测。协作边界见[AGENTS](../AGENTS.md)，任务细节见[比赛与取放约定](比赛与取放约定.md)，操作见[控制台](../Code/upper-computer-web/local-car/README.md)。

## 主车接线

2026-10-14补充实物条件：摄像头安装在机械臂运动结构上，会随Base旋转及X/Z运动；比赛已有机械臂准备负责朝向色环。相机并非固定于车体，视觉角到地图yaw的关系必须结合本次机构姿态。IMU测角准确；待设计的色环航向校正用于修正初始摆车角与地图名义角的对应误差，不是重新调整IMU测角极性或执行IMU归零。

| 接口 | 引脚 | 用途 |
|---|---|---|
| USART1 | PA9/PA10 | 无线ASCII文本控制台，115200/8N1 |
| USART2 | PA2/PA3 | LDS50C，921600/8N1，DMA1 Stream5/Channel4循环接收 |
| USART3 | PD8/PD9 | 串口屏 |
| UART4 | PC10/PC11 | 二维码 |
| UART5 | PC12/PD2 | 共享步进电机总线 |
| USB CDC | PA11/PA12 | 香橙派B2视觉 |
| I2C1 | PB6/PB7 | OLED |
| I2C2 | PB10/PB11 | HWT101，仅Z角度，SDA=PB11 |
| TIM1_CH1 | PE9 | 夹爪舵机，50 Hz PWM |
| TIM4_CH1 | PD12 | TD-8125MG雷达盘舵机，50 Hz PWM，PSC=83、ARR=19999；上电零脉宽 |

电机ID1/2/3/4为左前/左后/右后/右前，5 Base、6 Z、7 X、8车载三仓盘。车载盘与电机1∶1直连；独立F103物料台转盘另见[模块说明](../Code/物料台转盘/README.md)。CAN1/CAN2当前停用；板卡引脚、供电和探针以实际资料为准，不套用其他F407板卡。

## PD12雷达盘机构实测

用户实测TD-8125MG：**2450 μs转出扫描位置，1450 μs收回车内**。没有机构到位反馈，输出回复不替代实际位置确认。当前比赛雷达分支已由STM32自动展开、等待稳定、采集15圈并规划、收回稳定后出发；手动转出/收回仍为显式操作，进入页面、刷新和重连不动作。代码入口为[mission_navigation.c](../Code/template/App/mission_navigation.c)，机构实测和整场雷达路线验收分别判断。

用户实测超过2800 μs不响应；500～5000 μs手动输入仍作为此前授权的调试范围，不作为比赛位置范围。停止PWM未达到用户期望的实物失能效果，已按要求删除按钮、命令与接口。上电零脉宽保留；软件不新增舵机电源控制。

## Emm与机械事实

- 用户确认X轴最大行程130 mm，软件默认x_min=0、x_max=130 mm；以回零收回位置为起点。默认维护于grab_parameters.def，设备RAM另行读回；固件下载状态按对应开发记录核对，不再沿用早期“仅源码修改”的状态。

- 车仓取放前X保持回零收回位置；旧100 mm伸出方案及x_car参数、校验和网页输入已删除。比赛取仓后1/2号盘提Z并同步伸X30 mm再转Base，3号盘保持收回，这是闭爪后的避让，不恢复旧方案。单项成功、追踪自动入仓和完整两批验收分别记录，详见[取放约定](比赛与取放约定.md#车仓夹持与库存)。

- 夹爪打开/待机及各自动释放统一2450 μs（12.25%），夹取1920 μs（9.6%）；加工取回准备仍用2450 μs；车仓选仓到位后，在Base回仓转向时先用2120 μs防碰开口并计时；下降前核对Base、ID8到位及开口等待。手动自定义预填2450，显式应用只改变当前输出，不改自动默认。舵机重装后的方向与最早结构相反；TIM1保持50 Hz，车仓取料等待默认100 ms、闭合/释放等待保持对应流程。
- 用户已确认使用张大头Emm42固件，只修改电机ID，其余驱动设置默认。位置命令在1.8°、16细分下为3200命令脉冲/电机轴圈；0x36反馈为65536协议单位/电机轴圈，不能互换。手册依据为[ZDT_X42S V1.0.5](硬件资料/执行机构/闭环步进电机/ZDT_X42S第二代闭环步进电机用户手册V1.0.5_260527.pdf) Emm章节第57、72页；这些是协议事实，不要求重新进行65536单位选择实验。
- ID5～8固定动作及动态X统一仅RAM选择None并完整读回核对，不保存驱动Flash。固定动作由每轴实际反馈累计默认200 ms到位确认，TX只表示发送，9F不推进。底盘ID1～4默认None、查询仍回复；初始化不提前预读机构模式，首次使能、HOME或位置动作前按对应ID核验RAM None；原回零运动和完成判据保持。实现、编译、下载及实车状态见[本轮记录](开发记录/2026-10-17-机构None动作应答与查询保留.md)。
- UART5读取及参数配置事务按匹配回复推进，完整回复后保留2 ms非阻塞交接；底盘及机构None动作按TX完成推进，后续普通报文在TX完成后保留2 ms交接；四轮同步批次保持原子性。紧急FE/9C按TX完成推进，保留TX后2 ms停车链。实测依据见[连续入仓记录](开发记录/2026-10-07-UART5应答交接间隔与入仓连续循环实测修复.md)，不恢复旧10/80/100 ms固定门槛。
- Base保存实际多圈车仓参考；作业为原参考+117.5°，扫码为原参考+35°，作业返回车仓默认偏转−117.5°。机械臂在车体中左，作业朝车体左侧；“后向参考”是业务命名，不据此推断物理朝向。机构角与地图yaw分开，ID8仓位角独立。任务Base到位按2°临时业务容差、新鲜反馈及停稳确认；2～5°残差以≤15 RPM重发原绝对目标，不用FD模式2相对补偿；X/Z条件独立。
- X向外为正，Z向上为正。当前Z普通位置运动默认2250 RPM、加速度档位0（直接按目标速度运行）；驱动回零方向/速度由其O_Dir/O_Vel管理。任务阶段速度和驱动加速度档位、MCU加速度分别管理。
- 旧结构历史值：夹爪松开500 µs、完全抓紧700 µs，来自舵机重装前的实测，仅用于后续结构修改时对照，不作为当前控制值。结构再次改变时按实际安装重新核对开合位置。OLED Servo Test页PE2/PE3选择脉宽、PE5开关输出、PE4退出；仅进入页面不驱动舵机。
- 上电夹爪为空，等待1秒（独立启动等待，不使用car_pick_wait_ms）后Z/X碰撞回零与ID8就近回零先并行；X/Z新鲜回零、稳定位置和使能验证通过后先开爪2450 μs，待ID8建立参考后再使能并启动Base单圈就近回零（mode=0），直接使用驱动已保存的单圈机械零点；不预读/修改回零模式与方向，其余速度、电流、超时及阈值保留。驱动器重置后须先在正确车仓姿态建立并保存机械零点，模式选择不能代替设零。显式home base dir保留，负相对角方向按俯视逆时针，BASE_POSITIVE_DIR=1对应回零方向0；仅该手动模式执行RAM参数调整及核对。全部机构完成后IMU静止5秒验证。回零结束短暂未使能复查600 ms，位置稳定无驱动故障才补一次使能，1500 ms内复核；人工停止取消未完成回零和后续待办。grab rehome复用先X/Z验证、开爪再Base的顺序，不重放已完成的ID8回零；单轴回零不自动开爪。Base自动流程与显式home base near均为就近模式；既有历史实测保留，当前源码未编译烧录。
- ID8机械零点首次失能对齐、使能后保存；上电/复位自动就近回零一次，成功后建立仓1 RAM参考，后续仓2/3为+90°/+180°，无需重新实物标定。选仓1复用就近回零，选仓2/3按最短方向定位；分度±2.5°仅完成窗口，目标仍精确且保持。HOME失败仅在已退出、新鲜位置连续稳定、实际速度严格0、使能正常且无保护时建立近似参考，明确ref_degraded=1；稳定窗口不代表真实零点误差，普通停止保留标记、正常回零或人工建立参考清除。回零不清库存，显式停止或人工操作取消未启动待办；普通上电库存待核对，正式新比赛受理才初始化为空。
- 底盘配置中的轮径80 mm、约210/240 mm轮心间距及传动关系以源码与实测记录核对，轮子/IMU位置估计不能当作已消除滑移误差。

## 坐标与参数寿命

- 正式地图左下为原点，X向右、Y向上，yaw从+X逆时针；历史F1参考仅导入时用 `T(x,y)=(2400-y,x)`，不再旋转已验证的底盘、IMU或电机方向。
- 右下车体中心(2250,150)，航向180°（与−180°同向）；正式比赛linear未开启起步平滑时，先保持180°斜移至(2100,300)，停稳后顺时针转90°再直行；余弦模式采用右通道连续转弯到90°，独立二维码/普通底盘测试仍先斜移再转向，非标准绕障保留入口点。右上车体起点(2250,2250)、航向−90°。正式比赛选择起点后由STM32准备定位，最后返回所选起点；扫码段不掉头及物料台连续转弯详见[路线约定](比赛与取放约定.md#起点定位扫码与雷达)。
- 2026-10-11用户确认实车雷达只有两种起点安装：右下0°向左180°、右上0°向下270°，方向不再由网页选择。右下默认采用所提供新版F1的(2280,314)与精确标定；2026-10-12用户确认右上采用(2050,2250)，与车辆名义起点(2250,2250)分开，几何精度仍按实测核验。精确XY可分别填写应用；F1原参考情况1(230,230)只供历史参考文件解释，不作实车安装选择。
- 独立单段测试可按次指定10～5000 mm/s²线性起步加速度/停车减速度（固件省略参数默认300/300，网页初值500/300）、10～2000整数余弦K（默认200，T=K×2 ms）及各0～1的航向P/D（默认0.1/0）；这些输入不修改比赛和普通路线默认值，也不是驱动加速度档位或实测附着上限。
- 普通直线平移及定时heading/hold采用±0.1°航向纠偏死区，区内P/D输出均为0并重置D历史；原地转向、视觉精确转向和视觉坐标对准不套该死区，保留原完成精度与新鲜停稳确认。
- 固定路线默认1000 mm/s；普通MoveTo线性加减速300/300 mm/s²，正式linear比赛按路段采用起步500/800/1000、停车300 mm/s²，可选余弦K200（400 ms），转向上限100°/s。直线航向保持单P0.1、I=0、D=0，保留±0.50 rad/s限幅；与原地转向速度上限独立，具体单位及适用范围见[底盘协议](协议/系统与底盘.md#独立路线加速度测试)。网页角速度显示/输入为°/s，底层run与遥测为rad/s；路线阶段、正式/F1判障边界见[地图与雷达](../Code/upper-computer-web/local-car/docs/地图与雷达.md)。
- HWT101只使用Z轴原生角度；上电等新鲜数据后归零并做一次5秒静止验证，失败不自动反复重试。原生标定手动等待max(20秒，读回两段时长之和)，完整`imu cal start`加30秒验证，比赛快速`imu cal quick`加10秒验证，时长读回无效则标记并沿用20秒下限；本车实测0x4B/0x4D各10秒，不使用退役软件漂移补偿/外部Flash方案。连续两次每秒重探测仍为HAL_BUSY时局部重新初始化主控I2C2，保持现有配置；不发送模块复位、标定或SAVE。标定/验证中的读取中断先等待最多5秒，两个新鲜更新并确认工作模式后续接原生计时或重采完整验证窗口，不重发开始标定/归零。原生标定启动确认允许WORKMODE=1峰峰值或2零偏；等待期每200 ms读模式，已见2后回0只记为待验证并等足时限，不据此宣告完成。未见2就回0或未知模式仍复核后失败；退出正常模式后和验证只允许0。恢复模式首次不在允许范围内隔至少100 ms只读复核，连续两次不符才中止，并独立保留中止前预期/实际模式及阶段；恢复超时同样中止，之后进入最多5秒的正常模式退出；保留首次故障，未完整验证不保存。已验证状态在短暂失联后恢复通信、连续两帧新鲜数据可恢复资格，不自动重启已停止任务；定位锚点保留仍存在[P002](待解决问题.md#p002--imu短暂异常导致地图锚点及原点丢失)，资格恢复不代表地图定位已恢复。
- `grab set`、轴 `config`及转盘配置主要为MCU RAM，复位恢复固件默认；普通停止保留有效值。网页本机保存与MCU RAM分开，未实现这些参数的Flash持久化。默认值统一见[grab_parameters.def](../Code/template/App/grab_parameters.def)，不在多份手册复制整表。
- 保留的vision.py物料准心默认(372,345)、编号环默认(378,333)，具体版本及启动参数见香橙派README；所有普通B2控制使用有符号DX/DY，包括零值。STM32 ref_u/ref_v已删除，CX/CY只用于视野边缘及诊断；用户确认码垛39/−1补偿已在视觉端，STM32不重复补偿。源码、视觉部署及设备状态分别判断。P001已授权修改：手动Base位置运动保留有效车仓锚点及J数值，清除旧观测/快照，完成原作业姿态准备后恢复视觉使用；HOME/ZERO/机械设零仍重新核验参考。源码、未编译烧录及待实测状态见[修复记录](开发记录/2026-10-16-手动Base保留标定与姿态复核.md)。
- 香橙派当前实机程序已修改，启动与运行不再完全依赖USB-TypeC连接成功；2026-10-12用户确认STM32烧录后无需重开程序。本地源码、远端部署和实车验证分别记录，仓库版本差异见[香橙派说明](../Code/orange_pi/README.md)。

雷达原始数据、网页预览和正式地图的用途分开；独立扫描/规划不启动运动，正式比赛雷达分支在准备完成后按比赛调度出发，旧完整地图及本地历史图保留来源与年龄。已确认的规则不等于整车验收完成，详细来源保留在[开发记录](开发记录/README.md)。

本轮连续转弯按用户指定300×300 mm整车外框计算，旋转中心暂按车框中心；用户实测前后轮轴心距200 mm，现有运动学配置210 mm本轮未改，轮径仍80 mm。几何模拟通过不等于实车净空与定位误差已验收。
