doinbest/Yachiyo/xjx/模版搭建/docs/协议/机械臂与取放.md

# 机械臂、取放与车载转盘协议

独立编号环grab ring run/take的取仓准备允许空爪Z抬升与X回缩并行，两轴均实际到位后才转Base进车仓；下降夹紧后X保持收回参考位置，关闭仓1/2原X伸出30 mm避让，Z到本次高位且X仍在收回位后才转Base回工位。回转后恢复已保存X位置放置；首件ID8正90°及放置前汇合保持。该策略随本次动作锁定，暂停/继续保留；正式比赛原X30避让及提前回转策略、普通grab take和反向grab ring store不变。

编号环测试当前扩展：grab ring run <ring> <slot> <place_drop> [car_drop]；grab ring take <slot> [place_drop car_drop]；grab ring store <slot> <pick_drop> <car_drop>。显式距离均为(0,150] mm并受轴实际边界约束。car_drop在正向取仓时表示从z_max下降取料并返回同一高位，在反向入仓时表示从高位下降放料并返回；没有单独第二个上升高度。页面统一外部高度，从Z=0向下计算；正向最终等待Z抬到z_max（默认0）后released，反向复用fixed/proc存料状态机，等待Z高位、X收回参考+30 mm、Base参考+117.5°全部到位后stored。反向不重新视觉识别，开始要求空爪和已验证作业姿态；保留原参考与当前水平对准位置。颜色无法确定时只将指定仓标UNKNOWN，不捏造颜色，其他库存不改。停止/继续保留真实绝对目标和夹持阶段，取消结束；未增加周期运动重发或修改比赛参数。

正式比赛新增“起步平滑处理”选项，默认关闭，仅右下起点且linear允许开启，末尾可显式提交smooth=1（smooth=0或省略关闭），可与scale=<K>共同使用且任意顺序各至多一次。开启只在标准右下起点到二维码首段几何生效：先保持180°离开起点至约(2125,350)，沿右通道渐转至(2100,950,90°)，再接本轮扫码Y；中途不停车，二维码终点仍按新鲜反馈停稳。路径接近/转向段基准限速200 mm/s、出弯扫码直线基准上限800，均受本轮基准总限速及倍率K约束，航向角速度/跟随降速独立；不据此宣布提速或实车通过。Base仅在转正及原净空条件通过后准备扫码，保留与后续直行并行；暂停/继续/总线恢复锁定开关及路径进度，不从起点重放。右上/cosine显式开启拒绝，非标准雷达绕障保留原规划和分段，不以平滑替换绕障；独立二维码/普通动作及默认分段开局不变。设备报告start_smooth，底盘路线另报start_smooth_active表示当前首段实际采用；上位机草稿与设备读回分开，编辑/刷新/重连不发送。

`grab ring run <ring 1..3> <slot 1..3> <drop_mm>`：独立完整编号环取仓放置。drop_mm为正数、范围(0,150]且受真实Z软件边界约束，例如grab ring run 2 1 110表示选2号环、取1号仓、最终Z=-110 mm。要求已回零参考及空爪，无需先手动对准或登记颜色/库存。准备作业姿态后先执行比赛同源色环航向矫正（最高10°/s），只有heading_verified才进入高位对环；5秒无有效证据/参考不合格则报告原因并停止，不宣称完成。对准后保存本次release_z，复用原取仓、2120µs防碰开口、X30避让及首仓ID8避让、恢复位置放置流程。暂停用grab stop，续接grab mission continue，终止grab mission stop；保存的高度与已夹阶段保留，人工停止不自动继续。只在完成取起时更新所选仓，不清其他库存；没有合法地图原点时建立本地测试参考，已有原点保留。普通比赛5秒证据不足沿用原航向的策略不受此独立测试约束影响。

正式linear比赛支持倍率K（默认1，范围0.1～5）：先按基准路线总限速与路段基准限速取较小值，再将最终平移速度、起步加速度及停车减速度各乘K一次。基准总限速默认1000，实际总限速=基准总限速×K；基准及实际总限速均须10～5000 mm/s，超范围明确拒绝。包含扫码、工位贴近/换环/退出、右上连续换向及第二批连续路径的平移限速与加减速；转向上限、视觉纠偏、机械臂、等待、几何及到点/停稳判据独立。K随本轮受理锁定，暂停/继续/总线恢复保留；独立动作使用原默认。cosine兼容入口仅接受K=1，不能与余弦K200混用。新命令可在末尾追加scale=<K>，省略为1；设备报告route_base_speed、route_scale及实际route_speed，网页草稿预览与设备读回分开，编辑/刷新/重连不发送。

正式比赛加工取回末件在本轮视觉航向启用时不调用StoreFinishTravel：先完成三件入仓释放和记账，正常返回观察，再由父任务准备完整work_ready观察姿态。新增报告阶段`departure_heading_prepare`及`departure_heading`分别表示准备工位离站矫正、正在离站色环核验；仍报告原库存计数、第三件/仓3、本批次与工位2。色环采用现行B2/0D、反号1∶1、最高10°/s及停稳复测；结束后转入prepare_departure，才恢复Base行驶姿态，按原路线退出与转向。暂停/继续、总线恢复保留待离站状态，不重新记账；观测不足仍按原5秒规则沿用原航向，不冒充矫正成功。未新增启动指令或RAM参数，第一批暂存三件released并记账后也执行同一完整work_ready→色环核验→行驶姿态链，报告保留工位3及本批库存。第二批码垛离站暂不增加；独立测试保持原流程。详见[实施记录](../开发记录/2026-10-17-加工区取回后离站航向矫正.md)。

上位机比赛启动固定提交高位且开启矫正：grab mission qr <speed> <turn> lower fixed vhigh linear（起点、雷达、执行码和profile按本次选择生成）；页面不再提供align/visual_heading选项。turn默认100°/s，范围5～360，与固件显式转向/路径请求一致。协议仍兼容终端的旧raised/lowered/vlow等显式对照入口；设备实际采用值按回报展示，不以网页固定设置覆盖旧比赛。

X/Z普通位置动作及连续视觉位置入口默认使用驱动加速度0档：直接按目标速度运行，不使用驱动器曲线。位置请求和RAM配置允许X/Z的0～255档，Base及all入口仍为1～255；Base默认20，HOME仍使用驱动回零参数。网页允许编辑和读回X/Z的0档，刷新/重连不写入。此版不增加Z软件加减速规划，X已有视觉控制加减速与任务速度/高度保持。仅修改源码，未执行本轮测试、编译、下载或实车验证。

ID8纯反馈查询（0x36位置、0x35速度、0x3A状态、HOME的0x3B状态）被优先停车取消且总线未隔离、事件无UART错误时，转盘保留当前阶段和绝对目标，仅从位置开始重采完整反馈组；清除中断组及稳定证据，不用旧回复确认到位，不重发FD/HOME/使能/保存。旧应答仍按MotorBus原期限排空，排空超时仍是通信故障；转盘Started、MotionBudget、StopStarted不重置，完整组反复被抢占时仍检查原运动/HOME期限。显式Turntable_Stop撤销原阶段，不因随后读取消事件恢复旧运动。新增诊断为`WARN turntable feedback_read_cancelled resume=read_only target_deg=...`，等待期间reason为`feedback_read_interrupted`；真实故障及非查询命令取消保持原分类。实施及验证见[记录](../开发记录/2026-10-17-ID8反馈查询被停车抢占修复.md)。

正式比赛加工放置、暂存第一层及第二层码垛，在目标仓已确定且Base外侧静止时，ID8与视觉对准并行，不等对准或快照完成。对准仍须新鲜坐标及真实停稳后保存位置，之后才取仓。提前分度的目标随本件交接，不因下一阶段busy检查而取消或重发；已完成仓1HOME暂停后只补读原目标，未完成才续接。首件90°避让可跨picked移交放置，Z及Base完成后可恢复X，下降前汇合；COMPLETE间隙的暂停/取消仍停止所拥有的ID8任务。加工第三件270°可与换环移动重叠，夹起后仍等Z高位才回180°。同角度失鲜先查实际位置/速度/状态，逐组释放总线，保留200 ms实际稳定判据。三项夹爪等待默认100 ms，旧显式参数不自动覆盖；刷新、重连不自动写设备。原料台抬Z后收X和普通入仓Base前等待ID8仍按原顺序，待明确机械条件后另行修改。

当前机构None动作应答与反馈到位已实现于源码；参数与查询仍等待真实回复。本轮只编译和审查，未烧录；结果见[本轮记录](../开发记录/2026-10-17-机构None动作应答与查询保留.md)。

加工区、暂存第一层及第二层码垛的首件放置（取仓1且已保存对准快照），闭爪等待后并行抬Z和伸X30 mm；X避让到位即可启动Base转向及ID8正转90°，Z继续原抬升。Z与Base完成后可报告picked并恢复保存X，ID8目标移交放置流程；外部下降前必须确认ID8新鲜到位，不能把picked当作已经放置。仓1就近回零完成后保存“仓1参考角+90°”绝对避让目标（默认90°），暂停/恢复保持目标、只走剩余角度，已确认到位后失鲜只补读；终止撤销待办。转盘保持避让角至下一件正常选仓，不立即转回，不改变仓2/3库存；原1/2号仓X30 mm和加工第三件取回270°避让均保留。 状态reason=car_pick_tray_clearance；ID8的slot=0仅标识避让姿态，不是清库存或撤销原点。无对准快照的独立grab take 1 work沿用原流程。

正式比赛开启视觉航向时，色环B2/0D采用用户已实测确认的反号1∶1关系（视觉+α→底盘相对−α），不再要求手填head_proc/head_temp映射参数；零点0、比例1仅为本次色环策略，不写入RAM标定参数。仍需原观察高度匹配、可靠Base参考、完整作业姿态及新鲜静止反馈。取3帧新鲜一致角度、最大差0.3°，视觉残差≤±0.2°时通过；需要转动时同步地图航向，再用IMU独立P0.1/D0闭环转正，单次转角到位±0.1°、500 ms起步，角速度上限min(本轮转向上限,10°/s)，停稳后重新取帧复核。黑线B2/0E不套色环实测关系，仍使用独立标定；独立普通核验/观测及单次试转保持各自语义。 状态新增heading_method=direct_ring|mapped|observe|none及heading_speed（°/s，实际采用上限）；turn_speed仍是本轮普通路线转向上限。

Z任务速度统一默认250 mm/s：扫码升降、夹取下降、抬升、放置和入仓共用z_speed；保留z_pick_speed、qr_z_speed兼容键，显式设置任一项同步三项。普通手动Z默认2250 RPM（按480脉冲/mm折算250 mm/s），驱动加速度档位默认0（直接按目标速度运行，不使用驱动曲线）；显式手动调速保留，HOME仍使用驱动回零参数。网页开始夹取前统一写入并核对三项，读取时分别显示设备实际值；刷新/重连不自动写入。

新取放请求先检查活动所有者及底盘零速交接，资源忙时保留上一任务的result、operation、库存及快照。接管已排空的零速不代表停稳，新任务仍完成原PREPARE停车和机构/四轮反馈取证；没有待发运动且实际反馈就绪后才推进。

地面夹取入仓新增`grab store ground <slot 0..3> <color 1..6>`：0按库存选空仓，明确仓位沿用原指定盘规则；复用比赛加工取回的静态颜色高位对准、固定下降、三仓避让和入仓确认，不依赖编号环号。z_proc_place默认−110 mm、z_car_lift默认0、z_place默认−25 mm；转盘追踪仍用独立z_grab默认−45 mm和track_store_drop_mm默认25 mm。两者夹取下降速度共用z_pick_speed默认250 mm/s，Z加速度沿用当前轴配置默认0（直接按目标速度运行）。新入口不改原`grab store proc`固定夹取语义。

动态X绝对前瞻使用专用None入口，不为每个短目标请求异步FD/9F；通过完整读参、仅RAM切换及全字段读回核对，保留其他参数。固定Z/Base/X/ID8同样使用None及实际反馈默认200 ms到位，HOME和人工停车仍独立。TX完成只表示已发送，不代表X已到位或停稳；追踪继续依靠新鲜位置/状态反馈。详见[动态追踪协议](视觉B2与动态追踪.md)。

动态追踪预算与估计分离：visual/feedback使用真实时间对齐的轮位置/IMU实测坐标与速度，predict保留独立控制估计；三模式50 mm预算、参考及延迟限速以实测为准，不增加固定等待、不改变夹取及暂停语义。报文布局保持，详见[B2实测与估计](视觉B2与动态追踪.md#实测位移与控制估计)。

静态协同对准按新有效B2帧更新，正常纠偏及显式低位Z目标不再额外限频100 ms；底盘纠偏独立提交可替换的最新速度目标，不因普通机构查询、机构ACK或在途四轮速度批次暂停计算；实际发送顺序、总线公平性和停车优先仍由底层执行。X单独只保留最新待发绝对目标，机构空闲并完成必要反馈让读后立即发送；等待时不累计未受理位移，重复快照只可发送一次该待办，不重复纠偏。有限目标的待发X在发送前再次按实测剩余距离限幅；停车、暂停、换目标及阶段退出撤销待办。，不补发历史帧或重复积分。漏检恢复、视野、机械边界及视觉/停车完成判据保留。`grab get lambda`、`grab set lambda <0.001..10>`沿用共享静态参数，默认2.5 s⁻¹；上位机“仅协同对准”提供显式读取和写入后读回比较，编辑/重连不发送。动态追踪λ独立。详见[B2静态调度协议](视觉B2与动态追踪.md#静态协同对准的新帧调度与λ)。

视觉默认J尺度按固定识别姿态640×480 px覆盖450×330 mm换算，j00=640/450、j11=j12=480/330 px/mm；其余交叉项和方向保持。静态与动态流程共用，已有显式J设置/响应标定仍可使用，协议报文和±100 px原料窗口不变。参数及适用范围见[B2像素映射](视觉B2与动态追踪.md#视觉像素与位移尺度)。

比赛视觉航向开启时，每次进入加工区或暂存区仅启动一次航向观测：加工区两批及暂存区第一批使用色环B2/0D，暂存区第二批码垛使用色环前方黑线B2/0E；同次访问的换环、逐件放置和加工取回不重复。第二批再次进站重新观测。每件色环/物料位置对准保留；暂停、继续与总线恢复续接当前阶段，未完成观测可继续取证，独立航向测试不变。

航向采样使用独立5秒窗口，从机构停稳、开始请求时计时；漏检、USB重试及采样组重置不延长截止时间。允许间断有效帧累计，至少3个不同序号且接收时刻递增的新鲜样本；最后一帧必须新鲜。已标定使用head_spread比较换算后的角度，未标定/独立观测使用图像角最大差0.3°并取三帧平均值；不凭未标定图像角自动更新地图。无效/缺失帧不清空已有有效样本，不一致则重建采样组；机构运动后旧样本作废。5秒内证据不足报告heading_no_observation并沿用原航向继续。尚未成功提交的校准也受该截止时间约束；已采用校准或开始转向后仍完成运动和停稳验证，不以采样超时跳过。人工暂停后重新给予观测窗口，普通物料视觉等待参数不变。

现行比赛、取放和路线要求统一见[比赛与取放约定](../比赛与取放约定.md)。本文维护命令与完成语义，带日期的实测段落保留当时事实，不从早期版本或历史失败推定当前状态。

比赛扫码衔接：入口扫码姿态仍与允许的平移并行；收到本轮有效码后立即冻结执行码并离站，不等屏幕发送完成或机构/ID8停稳。抬Z、收X、Base恢复行驶参考与小车前进重叠；新车体转向、工位作业核对对应姿态，独立二维码测试仍停车结束。屏幕使用独立USART3 DMA异步刷新、失败重试不阻塞路线。暂停和终止沿各自现行语义。

2026-10-13比赛内部衔接优化不新增串口指令：每批末件入仓（单件赛事入仓同样适用）在释放记账、提Z收X及Base到行驶参考后直接报告`stored`，普通独立入仓仍返回观察姿态。正式比赛在本次新鲜反馈确认X收回、Z达到转移高度后，可重叠Base姿态转动与进站/换位/离站平移；工位作业与离站交接仍等待双方完成。两批加工末件取回入仓记账后保持180°，以50 mm/s局部上限直接到(1200,425)，不先回380；抬Z/收X新鲜避让成立后才平移，425处等待本次停稳及完整travel_ready，再转90°去中心。`return_processing_exit`表示返回加工离站点；进站在380转向、贴近350观察，已保存的实际视觉锚点仍保留，其他工位保留`return_station_center`。路线短暂`busy`保留原阶段重试；共线同向的纯途经点可合并，扫码、工位、转角保持边界。暂停保留两侧绝对目标及结束策略，继续重新核验避让资格。详见[实施记录](../开发记录/2026-10-13-比赛动作连续衔接.md)。

2026-10-13赛事增加`bus_recovery_retry`阶段：可恢复通信错误间隔750 ms重试，15秒内允许启动重试，超过窗口保留进度等待处理；已启动的低层尝试可完成自身验证。手动恢复成功暂停，自动恢复成功续接，人工pause撤销自动续接，stop取消本轮及待重试。`bus recovery`为只读短诊断，`bus attempt`/`bus attempt_rx`记录本次恢复证据，`bus first`为原始首故障；不以历史首故障推断本次失败。接收错误类型、步骤和对环下降对照操作见[连接与恢复](../../Code/upper-computer-web/local-car/docs/连接与恢复.md)。

当前工位默认：z_rough_align与z_temp_align为−100 mm低位对照高度；z_proc_place为−110 mm，加工取放及第一层暂存共用；z_stack_place为−100 mm。默认高位Z=0对准后分别下降110/100 mm。Z回零验证后安装默认值，可用grab get读取、grab set显式修改RAM。

2026-10-13比赛停车分为`grab mission pause`（保留进度、可显式继续）与`grab mission stop`（撤销本轮及抓取子任务续接、结束本轮）。`grab stop`保持正式比赛暂停的兼容语义。终止时保留夹爪输出、有效参考、配置和已完成库存，处于`cancelling`或`cancel_wait`时不能开始新比赛或继续。抓取停车链完成后，最后四轮停车监控核验本次发送完成、新鲜连续停稳反馈；确认后置`cancelled`且`stop_confirmed=1`。未确认时为`cancel_wait`，处理故障后明确再次发送`grab mission stop`重取证据。路线暂停同样使用独立停车监控，不依赖只用于位置任务到位的`motion.stop_confirmed`；恢复路线定位就绪后才恢复抓取子任务。

操作步骤见[视觉任务](../../Code/upper-computer-web/local-car/docs/视觉任务.md)，协议单位与硬件事实见[运行基线](../硬件与运行基线.md)。参数默认值、范围及载入阶段统一见[grab_parameters.def](../../Code/template/App/grab_parameters.def)，实际运行值用grab get/config读回；不再复制历史默认表。

2026-10-12统一比赛固件与网页已实现车仓入/出X保持收回，旧x_car参数及字段已删除。新版明确选择qr/fixed来源，两者均实际扫码；软件实现与实车结果见[实施记录](../开发记录/2026-10-12-统一比赛任务实现与验证.md)。

## Base电流与驱动只读诊断

`bus read <id 1..8> current|voltage|error|home|driver` 单次读取实际驱动数据；Base为ID5。示例：`bus read 5 current` 返回相电流mA；`voltage`返回供电mV；`error`返回有符号位置误差及Emm角度；`home`返回保存的回零模式、方向、RPM、超时及碰撞阈值；`driver`返回闭环电流上限、开环工作电流、输出限制原始值、堵转保护及驱动到位窗口。

这些命令不改参数、不运动、不执行HOME/ZERO，不解除停车锁定。任务空闲后读取，运行中返回tasks_busy；复用单ID只读诊断隔离，停车可中断，完成后释放隔离。当前主车使用Emm驱动布局：误差65536单位/圈，配置回复33字节；X固件布局不在此入口的支持范围。供电/电流为读取当时样本，不是回零过程峰值；普通位置配置`config base`不代表驱动保存的回零速度、电流上限。

读取需烧录含此入口的新固件，网页系统与标定页的“电机只读诊断”可选Base及项目；服务端更新后需重新启动服务并刷新页面。停止锁定期间两端均允许这些查询；完成确认仍以回零专用状态为准。

## 现行静态对准与码垛

短时定位速度资格或三轴反馈缺失/失鲜时，有限目标及实测历史保留但暂停使用；同一定位代次、原点、单位、目标和观察姿态下，反馈恢复且共同时间包围样本齐全后，按实际累计位移续调，不要求先有新图像。不可用期间仍走原宽限减速及停车期限，不扩大600 ms反馈新鲜度、不补算指令位移；定位重建导致代次变化、参考/姿态变化、真实驱动异常、换目标或停止仍撤销目标，停车后不凭旧目标自动续走。有限目标层的保留不取消整个取放任务原有反馈准入：反馈字段必须有效并满足feedback_ms（默认2000 ms）。仅超过有限目标600 ms年龄门槛、但仍满足任务准入时可暂停后续调；字段valid=false或超过任务期限仍沿原feedback_stale停车。定位feedback_valid从有效变无效会递增代次并重建里程基线，旧目标仍撤销；独立速度资格失效不一定改变代次。

静态漏检时，有合格高位视觉/实测时间基线则继续有限剩余调整；否则沿原趋势减速，默认loss_grace_ms=250 ms。接近窗口、重获新误差方向变化或宽限耗尽仍停车，不是单次漏检一律停车。停车期间同请求的有效新帧已经恢复时，撤销待重识别并保留原数据流，避免重复B2/0A清掉视觉跟踪。新鲜性优先用实际接收时刻，恢复仍需停车确认及恢复起点后的3次新观测；旧缓存、错误目标或暂停前报文不能推进。再次持续缺有效数据仍沿原窗口重发，不重置恢复期限。新增vision_gap_expired、vision_pause_near_window、vision_pause_direction_change与vision_stream_retained原因；不改变原控制和停车条件。

静态对准加减速按实际底盘速度受理间隔计算；制动预算采用max(20 ms，本次对准实际四轮速度批次间隔)加共同实测时刻年龄，不再额外固定加250 ms；首批只建立计时基线，之前任务/空闲及显式停车不计为发包间隔。按共同时间实测位移差得到运动速度，沿当前纠偏方向快于上一轮指令时增加制动余量。普通跑图和动态追踪保留各自控制。静态X采用纠偏速度匹配的None短前瞻：目标由当前实测X加本次X纠偏速度乘60 ms生成，受原x_speed、机械范围、lead_mm及实测剩余目标限制，发送前重新核验。60 ms仅表示有限目标前瞻长度，不增加固定等待。忙时只留最新位置/速度，不累计等待位移；同脉冲但速度改变仍更新，零速/已消耗目标撤销旧前瞻。最低RPM和分数脉冲按实际命令量化，同方向亚脉冲不撤回尚在执行的小步；反向、停车、暂停、换目标及阶段退出清理旧待办/分数。保留±1 px、3帧/200 ms视觉稳定及真实停稳，不逐条等待200 ms。低位Z写入后给水平纠偏一次受理机会，到期轴反馈仍可读取。X达到限速后由底盘J补足剩余像素纠偏，底盘速度/加速度、X范围与目标领先限制保持；底盘不能独立补偿时按可行速度缩放。ALIGN完成的视觉稳定窗口保留至本流程停车后，不重计完整视觉保持；必须另有停车发送后的真实三轴/四轮停稳证据和新的在窗B2观测才能推进。偏离、漏检、人工停止、暂停或反馈失效仍重新核验。详见[B2静态调度](视觉B2与动态追踪.md#静态协同对准的新帧调度与λ)。

空爪预对准完成且保持原姿态时，保存位置复用刚完成的视觉稳定窗口，但必须另取一帧新鲜在窗坐标并核验三轴/四轮停稳；不重计完整stable_ms。保存快照至取仓之间没有新动作、反馈仍有效时移交停稳证据，不重复发送停车或重计稳定窗口；新的任务阶段、机构动作、底盘运动/停车、人工停止或反馈失效取消本次移交资格，按原流程重新核验。取仓后的持料放置、避让、夹爪等待及正常静态稳定参数保持。 不新增串口命令或RAM参数；只将刚完成快照到车仓取料的交接作为证据复用入口，普通手动取料及暂停续接保留原准备。

夹爪手动脉宽测试：网页“机械臂与夹爪 → 夹爪舵机”提供500～2500 μs整数输入，使用现有`grip duty <百分比>`，50 Hz下百分比为脉宽/200。例如2300 μs发送`grip duty 11.5`。默认`grip open`=2450 μs、`grip catch`=1920 μs；手动值只改变当前输出，下一次自动open/catch会恢复默认，不修改任务参数。输入编辑不发送，必须明确应用；沿用当前任务忙/停车限制。

车仓取料下降前使用已实测的2120 μs（10.6%）防碰开口，由`GRAB_CAR_PICK_OPEN_PULSE_US`独立维护；`grab take <slot> work`及比赛复用CarPick，在ID8/Base到位后设置该输出，再等待car_pick_wait_ms（默认100 ms）后下降。未夹取续接可重新建立防碰开口，已经闭爪从提起续接不重新开爪。普通OPEN/CATCH及手动默认按钮仍为2450/1920 μs，网页自定义预填2450 μs。历次值的变化保留在开发记录；本次恢复源码尚未编译、烧录或实车验收。

| 命令 | 语义 |
|---|---|
| `grab align color <1..6> [z_mm] [stay]` | 颜色静态对准，直接使用B2 DX/DY |
| `grab align ring <1..3> [z_mm] [stay]` | 编号环静态对准，直接使用B2 DX/DY，不预伸50 mm |
| `grab ring align [1..3] [z_mm] [stay]` | 编号环旧入口兼容，省略编号默认1 |
| `grab start align <color>` | 原物料对准兼容入口 |
| `grab stack align <1..6>` | 按视觉B2的DX/DY归零对准并停稳保持，补偿由香橙派完成 |
| `grab stack lower <z_mm>` | Z绝对位置，可向上调整或覆盖尚未完成目标，不松爪 |
| `grab stack release` | 松爪并保持高度，不自动提起 |
| `grab stack lift` | 独立提起至最高 |
| `grab ring place <z_mm>` | 已对准并人工装料后，Z下降/松爪/提起，不取仓或改库存 |
| `grab status [base|x|z]` | 任务或短轴诊断，只读 |
| `grab stop` | 结束任务/识别并请求停车，普通停止保留有效参数/参考 |

颜色与编号环共用静态控制参数，动态追踪独立。环对准先抬Z/收X、转Base，再请求编号识别；省略高度默认Z=0并保持，显式低位对照才在横向接近后随新坐标逐步下降。640×480边缘左右64 px/上下48 px暂缓下降，Z目标最多领先反馈5 mm，按新有效B2观测和机构条件更新，不再附加100 ms门槛；总线忙时保留最新待处理帧，按既有25 ms轮询规则给反馈读取机会，重复快照不累加下降。完成要求目标高度、±1 px窗口和停稳；明确填写高度且省略stay时抬Z到最高等待装料；省略高度或带stay时保持对准高度并继续只读显示偏差，不持续运动纠偏。这些分段阈值为当前调试值，精度待实车验收。

码垛39/−1像素补偿已由用户加入香橙派程序。STM32与单项/比赛码垛均直接使用视觉B2的DX/DY，目标为0/0；不重复追加补偿，不再经过第二次对准。STM32 ref_u/ref_v参数已移除，准心只在视觉端按任务管理；到位、停车、新鲜坐标和释放验证仍保留。

固定Base/Z/X及ID8位置动作统一None（Response=0），动态X共用该模式。首次固定位置动作、使能或回零前，按对应ID完整读参、仅RAM修改应答字段并完整读回核对，不保存驱动Flash；初始化不提前预读，已核验的None复用，回零运动参数和完成判据保持独立。动作按TX完成推进，transmitted仅表示已发送、acknowledged保持false；查询及参数报文仍等待真实回复；100 ms是缺回复期限，不是固定延时。普通固定动作不再以FD/9F或状态到位位直接完成：X/Z/Base按各自本次目标，在新鲜位置、状态和实测静止证据上独立累计arrival_hold_ms（默认200 ms）；ID8按完整新鲜位置/速度/状态组累计stable_ms（默认200 ms）。累计随新反馈推进，状态机汇合时直接使用结果，避免X/Z串行重计；缓存和超时不能完成。相同已确认目标在机构未动、未停车、参考未变且反馈有效时可复用，不重发或完整重计；变化或失鲜后重新取证。车仓显式仓1HOME保持原语义。连续视觉X按TX完成推进，不等待动作ACK，不逐条等待200 ms；既有X/Z避让、Z先抬再收X、Base回仓前等待ID8及合法并行保持。 底盘ID1～4默认None，查询仍等待真实回复。Base目标2°业务误差及2～5°低速原绝对目标修正保持；HOME、人工停车和静态视觉稳定独立。

固定取放的主动查询不再每25 ms机械轮转六项。X/Z/Base分别按位置、状态实际反馈年龄选取最超期字段：活动且未确认完成的轴目标间隔25 ms，保持轴150 ms；并行动作均参与调度，后台字段超期后可获得机会。三轴提交间隔下限5 ms且只允许一笔在途；自定义feedback_ms较短时，目标间隔不超过其四分之一，实际仍受串口及其他总线客户占用限制。停车优先取得本次停车后的数据，姿态准备同样补齐所需新反馈；视觉让读时若全部字段仍新鲜，立即撤销让读标记，继续处理待纠偏观测。静态纠偏原25 ms让读机会保持，动态追踪独立调度不变。

ID8在普通分度、角度和点动已发起运动后，完整位置/速度/状态组完成至下一组的等待由50 ms缩短为25 ms；每组后仍释放总线给其他客户，HOME及其他操作保持50 ms。机械臂arrival_hold_ms及车仓stable_ms默认仍200 ms，目标容差、真实反馈、人工停车和回零检查不放宽。固定机构及动态X统一None动作应答；TX完成后继续调度，实际固定到位独立累计默认200 ms。

旧vision和material命令只回复退役提示，不自动转为运动。响应标定使用 `grab calib ref` 人工确认当前观察姿态，再以 `grab calib <1..6>` 启动；`grab calib status` 只读，`grab stop` 取消并停车。GrabTask 唯一管理标定任务，grab_calibration只推进采样；Base/Z/夹爪保持当前状态。成功更新共用 J 的前后与 X 两列：前后为像素/mm，X 像素/电机度乘 `x_ppm × 360 / 3200` 后转成像素/mm；侧向 j01/j11 保持原值。失败/取消保留上次有效模型，姿态确认不覆盖有效模型。手动Base参考P001仍按原延期策略处理。见[退役记录](../开发记录/2026-10-09-MaterialVision退役与控制台保留.md)。

## 车载转盘与单件取放
ID 8、三仓、1∶1 直连为已确认硬件关系。2026-10-12用户再次确认机械回零对应仓1；相对仓1的角度为0°、+90°、+180°，分别对准仓1/2/3。当前源码默认值已同步为0°/+90°/+180°；旧设备RAM是否已设置仍需分别get读回。显式set只修改RAM，复位恢复新固件默认；库存上电仍待核对。人工对齐首仓后执行 `turntable origin`，读取实际位置建立偏移。该命令不回零、不清驱动位置计数。常规使用改为首次失能手动对齐第一仓、使能、`turntable save_zero` 保存机械零点；以后执行 `turntable home`，成功后自动同步第一仓参考，无需每次人工建立参考。机械零点保存在 ID 8 驱动器，区别于 STM32 RAM 中的仓位角度和库存。位置指令使用 3200 命令脉冲/圈，反馈使用 65536 协议单位/圈。

| 命令 | 含义 |
|---|---|
| `turntable get <key>` / `turntable set <key> <value>` | RAM 参数读写；`slot1_deg` 只读；其余键为 `slot2_deg`、`slot3_deg`、`speed_rpm`、`acc`、`pos_tol_deg`、`stable_ms`、`feedback_ms` |
| `turntable enable` / `turntable disable` | 单独使能/失能 ID 8，应答后读驱动状态确认 |
| `turntable save_zero` | 将当前单圈机械零点保存到 ID 8 驱动器（0x93，存储标志 1），同时同步第一仓参考 |
| `turntable home` | 单圈就近回零（0x9A，模式 0）；回零状态、速度和位置稳定后自动恢复第一仓参考 |
| `turntable origin` | 人工对齐后的参考采集，受理后等待反馈结果 |
| `grab status base\|x\|z` | 短轴诊断：实际/目标、驱动状态位、新鲜度、停稳、任务到位结果；只读，不发送电机动作 |
| `grab place car` | 独立车载放料：Z提起、X收回、Base转到已验证后向参考、Z到z_place后松爪并停留；不驱动ID8、不更新库存；旧伸X已删除 |
| `turntable index <slot>` | 仓1单圈就近回零，仓2/3最短方向分度；仍需已建立车仓参考与仓位配置 |
| `turntable jog <degree>` | 从当前实际位置相对点动，角度单位 ° |
| `turntable stop` / `turntable status` | 停止请求 / 查询状态；受理、发送和停稳分别报告 |
| `turntable inventory` | 读取三仓软件库存 |
| `turntable inventory empty` | 人工核对后确认三仓为空 |
| `turntable inventory <slot> empty\|unknown\|<color>` | 校正指定仓库存；保留 B2 色号 1～6，`unknown` 表示待核对 |
| `grab start fixed` | 原料固定夹取入最低编号空仓 |
| `grab track pickstore <color> <slot 0..3> [predict\|visual\|feedback]` | 原料DX/DY追踪夹取时并行启动ID8目标仓分度、停车核验、提起收X、核验ID8到位、Base回已验证后向参考、入仓/记库存/返回观察；默认feedback，0自动选空仓，1..3按明确指定的可用盘执行，无需库存确认 |
| `grab track store <slot 0..3>` | 已追踪夹取物料入仓或继续中断的同一入仓流程，0可续接原仓；不重新夹取，保存颜色/高度/返回姿态 |
| `grab start fixed <slot> <color>` | 原料固定夹取入指定仓 |
| `grab start pick [color]` / `grab start pick <color> <slot>` | B2 对准后原料入仓；省略颜色仍为红色 1 |
| `grab store proc <slot> <color>` | 已完成水平对准处夹取粗加工物料并入仓 |
| `grab ring take <slot 1..3>` | 编号环独立自动放置：采用已对准环号，重新核验并保存X/Z及z_proc_place，再取所选车仓、恢复X、下降释放提起；无需库存/颜色登记，完成所选盘置空。不扫码/跑路/清空库存；grab stop暂停，grab mission continue续接，grab mission stop终止。 |
| `grab take <slot> rough\|temp1\|temp2` | 从车载仓取出，在已对准处向粗加工/暂存第一层/第二层竖直释放 |
| `grab take <slot 1..3> work [depth_mm]` | 车仓取出并保持：提起收X、ID8先分度到位、Base回车仓参考；等待car_pick_wait_ms（默认100 ms）、下降/闭爪/等量上升。1/2号盘提起同时X向外伸30mm，3号盘保持收回；两轴到位再转Base至参考+117.5°。默认car_pick_drop_mm=40，Z从z_max开始；完成picked且该仓库存置空，不自动开爪/释放 |
| `grab return` | 有有效外侧参考时显式返回保存的观察姿态 |

转盘调试初值为 30 RPM、加速度档位 8、位置容差 2.5°、稳定 200 ms、反馈窗口 2000 ms。这些是软件初值，仓位及旋转余量仍需实物验收。分度按新鲜位置、速度、状态反馈判断，不能用命令 ACK 替代到位。上电库存全部待核对，普通停止和恢复不清库存；中断夹取/释放后涉及仓位标待核对。

2026-10-13起，明确指定1/2/3号仓的入仓（追踪夹取入仓、已持料入仓、固定夹取及加工取回入仓）视为用户已选择可用料盘，不再因软件UNKNOWN/OCCUPIED拒绝，也不提前清空任何仓记录；完成放料后更新该仓库存。slot=0自动选仓仍只选择记录为空的仓。续接仍限定原仓位，保留高度、参考和真实运动反馈检查。正式比赛启动的三仓初始条件不由单项指定仓操作改写。

2026-10-13起，共用`Turntable_Index(1)`复用`turntable home`的0x9A模式0就近回零；手动选仓、追踪入仓、车仓取出和比赛任务均适用。仓1以ID8已保存的机械零点为准，成功后同步第一仓软件参考；不重新保存零点、不清位置计数，也不改库存、持料和比赛进度。必须确认回零结束、无回零失败、使能正常、无驱动保护故障、新鲜位置连续稳定且实际速度≤1 RPM，才报告`OK turntable home complete ref=1`并允许后续Base动作；不再要求普通位置到位bit1。停止中断该回零，等待停车后显式续接原任务。软件实现不代表已烧录或实车验收。

2026-10-11转盘点动修复：`jog`仍表示从新鲜实际位置相对转动指定角度，仓2/3的`index`按最短方向分度；固件先计算实际多圈绝对目标，再换算为3200命令脉冲/圈，使用FD模式1发送。本车模式2已有Base异常记录，本次ID8再次−90°时实际位置未跟随目标，不能继续依赖模式2。位置定位完成后主动回复`OK turntable arrived`及角度、目标、速度；运行失败立即回复`ERR turntable fault`及动作原因、总线锁定、总线原因、故障地址/功能码和UART错误，区别于下一条命令被拒绝。详见[串口诊断记录](../开发记录/2026-10-11-转盘点动与UART5串口诊断.md)。

最高 Z 位置为 0，下移目标为负。旧 `z_grab / z_lift / z_place` 保持绝对目标含义；新参数仍使用 `grab get/set`：

| 界面距离（正数） | 固件绝对目标或换算 | 固件初值 |
|---|---|---|
| 原料夹取下降 | `-z_grab` | `z_grab=-45 mm` |
| 原料夹取后抬升 | `z_lift-z_grab` | `z_lift=0 mm`，抬升 45 mm |
| 加工取料 / 取料后抬升 | 共用 `z_proc_place` / `z_car_lift` | 默认−110 mm / 0 mm绝对Z |
| 车仓放料下降 / 放料后抬升 | `-z_place` / `z_car_lift-z_place` | `z_place=-25 mm`、`z_car_lift=0 mm` |
| 车仓取料下降 / 取料后抬升 | `car_pick_drop_mm` / 回到取料前z_max高度 | 默认25 mm，z_max=0时取料目标为−25 mm |
| 粗加工释放下降 | `-z_proc_place` | 默认110 mm，实际RAM须读回 |
| 暂存第一层 / 第二层释放下降 | `-z_proc_place` / `-z_stack_place` | 第一层共用加工高度110 mm；第二层默认100 mm |

追踪入仓的放料Z使用`z_lift-track_store_drop_mm`，默认0−25=−25 mm；该下降距离范围0～10000 mm，但启动还核验实际Z行程及必须低于提起目标。原固定/静态/加工取放仍使用`z_place`，不随该参数变动。

车仓取出并保持单独使用`car_pick_drop_mm`，默认25 mm，范围大于0且不超过150；显式命令距离只作用于本次任务，不改该RAM默认。等待使用RAM参数`car_pick_wait_ms`，grab_parameters.def源码默认100 ms，车仓分度和Base反馈到位后开始计时，X保持收回，不按网页串口写出计时。所有车仓取放前使用X收回关系，旧伸X已删除；外侧视觉X对准及取仓后的30 mm避让例外保留。任务停止保留上下文，原仓再次执行work续接，已闭爪从提起继续；下降/闭爪已开始但提起未确认时仓位置UNKNOWN，确认提起后置EMPTY。颜色沿用开始时仓内颜色，不靠新选颜色覆盖。

2026-10-12用户明确手动`take work`只需要选择料盘，不需要库存或颜色前置登记。此入口允许软件UNKNOWN/EMPTY仓执行；已知颜色可保留，未指定时状态color=0，不默认红色、不发相机识别请求。车仓参考、行程及机构反馈仍按原流程处理。自动选仓及`take rough|temp1|temp2`仍使用库存记录；明确指定仓的入仓按上述2026-10-13规则执行。

车仓取放X位置统一使用回零收回参考`x_min`，不再要求单独配置车仓伸出参数。旧x_car参数、默认恢复、校验及网页字段已删除；不能恢复旧参数仅设置为0。`base_car_offset=-117.5°` 是Base从作业姿态返回车仓的原相对转角配置：作业为回零锚点+117.5°，车仓方向就是实际回零锚点本身。ID8仓1/2/3的0°/+90°/+180°相对转盘仓1，与Base转角独立。修改某组下降距离时，界面按该组抬升距离计算提起目标；二层放置高度以实物设置为准，不代入赛题名义高度。

仅检查当前场景所需参数，未知后续高度不阻断已具备条件的前序任务。车仓取放前Z提起、X收回；Base已在外侧且静止时，ID8分度可与抬Z/收X并行，汇合到位后Base回仓。1/2号盘闭爪后提起同步伸X30 mm，两轴到位再转Base；3号盘不伸X。保存绝对目标及参考，续接不重复追加避让；完整入仓/取出结果才释放占用并推进调度。统一两批与自动码垛已实现，实车验收另记。

`grab stop`、`stop all`覆盖ID8，保持夹爪当前输出与Z使能；反馈不足时停车仍未确认。比赛中自动通信恢复可在验证后续跑，手动bus recover等待明确continue；非比赛按原恢复语义，不自动重启已停止任务。软件库存和结果来自动作反馈，不是物料或碰撞传感器确认。

`stop base/z/x`为人工优先停车，可取消当前ARM事务的ACK等待，不因该事务忙而丢弃请求；停车FE仅发送所选ID5/6/7。连续停止合并尚待发送的目标，完成时分别回复对应轴`OK stop <axis> sent`；真正`stop all`仍覆盖ID1～8并取消未发四轮批次，追踪正常零速保持使用原`StopScheduled`调度。停车结果表示发送完成，不能代替新鲜机构停稳反馈。None动作取消不等待缺省不存在的ACK；显式Receive兼容事务的取消仍保留既有总线隔离，优先停车不受该隔离阻挡；正常ACK完成后停车不新增隔离。

参数页五标签全部展开，初始“未读取”，`unset` 留空。读取全部顺序查询所有设备组（雷达整组分页一次），路线待用速度属于浏览器本地设置。应用只提交当前标签的改动，先等待受理，再主动读回比较，拒绝和部分成功分别显示。停止可取消剩余参数请求但保留草稿；断线或 MCU 重启将旧值标历史。页内链接只导航，不读写参数、不启用遥测、不启动运动。

夹爪等待分为三项RAM参数，默认均为300 ms：`close_ms`控制闭爪后提起，`release_ms`控制松爪后退出及入仓记账，`car_pick_wait_ms`控制车仓/Base到位并设置2120 μs防碰开口后下降取料。网页“运动与标定 → 夹爪动作时序”可分别读取和显式写入，普通停止保留，复位恢复固件默认。它们不控制舵机速度，当前PWM夹爪没有到位反馈；视觉稳定、机械臂反馈到位与底盘停车条件保持独立。

### 自动三轴回零与诊断
上电/复位等待1秒后，Z/X碰撞回零与ID8车仓就近回零先并行执行。Z/X的HOME按应答依次发出，不等待Z运动完成才启动X；随后逐轴验证回零结束、稳定位置及正常使能。Z/X均验证成功后先打开夹爪（2450 µs），保留Base启动前原有等待，并等待ID8完成回零建立参考后，才使能并启动Base单圈就近回零（mode=0）。Base承载整套机械臂，最后执行；直接发送0x9A/00使用已保存的单圈机械零点，不执行自动方向参数准备。驱动重置后先在正确车仓姿态设置并保存机械零点；切换回零模式不能替代设零。就近HOME返回0x12表示已在零点，仅接受本条命令结果，随后仍按原HOME退出、新鲜位置与使能/停稳反馈验证；E2/EE仍报错。ID8仍由独立总线所有者推进，全部机构完成后才安排IMU静止5秒验证。`grab rehome`同样先并行Z/X、验证后开爪再启动Base，不重放已完成的上电ID8回零，也不新增其参考依赖；单轴手动命令保留，HOME受理不会自动建立三轴参考。不修改驱动器保存的回零电流、方向、模式或电机ID。

回零中的`grab status`增加`home_started/home_verified`位图，bit0/1/2分别为Z/X/Base；Z/X已验证、ID8仍在回零时为`home_wait_turntable`，此时位图为3/3，Base尚未启动。上电ID8未建立参考报告`home_turntable_failed`，不启动Base。停止先中断已启动但尚未验证完成的回零，再逐轴读取退出状态，同时取消未启动的Base与ID8待办并中断ID8回零；一轴退出未确认不阻止其他轴收到中断。60秒运动窗口从各轴HOME请求受理时计时，Base不消耗前序回零等待时间；停车5秒窗口保留，中断回零标志不等于实车停稳。

每轴先读取回零标志，过温、过流或编码器/校准未就绪则停止；本次 HOME 发送前的 bit3 表示上一次回零失败，允许新 HOME 重试，不把它判成本次失败。HOME 受理后的 bit3 对 X/Z 或严格模式 Base 仍按本次回零失败停止；Base 默认允许下述降级验证。随后发送使能并读取实际电机状态，不能以 ENABLE ACK 代替使能确认。使能状态在 1500 ms 内仍不成立时为 `home_enable_failed`，不开始该轴 HOME。

HOME 完成后仍读取回零状态、位置和电机状态，要求连续两轮使能正常且位置稳定；X/Z 保留 ±182 反馈单位的零点窗口，Base 使用驱动保存的机械原点对应的实际多圈坐标，不清零。若仅使能位短暂为 0，先按 100 ms 查询节奏复查 600 ms（两轮完整的回零/位置/状态查询）；其间使能自行恢复则继续原流程。超过宽限且确认 HOME 成功、位置稳定、无过流/过温/回零失败/堵转保护，输出 `OK grab home_enable_recovery axis=... home_flags=... motor_flags=... raw=...`，仅补发一次 ENABLE，不重发 HOME。补发后 1500 ms 内重新核验两轮位置和使能；持续未使能报告 `home_enable_failed`，位置相对恢复前变化超过本轴稳定窗口（X/Z 为 182 反馈单位，Base 为 5°）报告 `home_position_changed`。驱动真实故障、总线错误和人工停止均不会触发补使能。

除下述 Base 单独回零失败可降级外，这些失败沿现有停止和回零中止流程处理，不建立失败轴参考。排除驱动/通信问题后，可用 `grab rehome` 重新验证；普通人工停止后不会自动续跑。诊断报告增加 `enable_recovery=0/1`，表示本轴是否已提交恢复使能。

回零请求未被总线接收且返回 `HAL_BUSY` 时，固件保持当前轴，按原有 100 ms 轮询节奏重试；已受理的 HOME 不重发，原有每轴 60 s 超时不变。总线因通信错误或超时锁定后，比赛沿既有保留进度的恢复流程处理；非比赛场景由固件停止任务、排空事务后自动恢复通信，恢复内可重试的通信错误间隔2秒重试。人工停止取消待办，同一旧故障不再次触发。自动恢复通信不重启已中断的HOME或宣告参考有效；停止及回零中止的优先发送仍保留。

请求提交硬失败时先输出 `ERR grab home_request axis=... action=... result=... bus_locked=... bus_reason=... uart_error=... fault_ms=...`，随后状态报告 `reason=home_bus_fault`（总线锁定）或 `home_request_failed`（其他提交错误）。驱动回零标志异常仍为 `home_driver_fault`，与提交错误分开。

已受理事务异步失败时，在原有 `ERR grab home ...` 和停车流程前增加以下诊断；不改变原有 `home_feedback_failed`、停车、中止、超时或降级条件：

- `ERR grab home_transaction`：`axis/step/action/result` 是失败发生时的轴、回零步骤和任务命令；`phase` 区分普通事务 `none`、显式手动Base方向回零的 `params_read`（0x22读参数）、`params_write`（0x4C仅RAM写入）、`params_verify`（0x22读回核对）、`trigger`（0x9A发送HOME）。`func` 为本次子命令功能码，`mode` 仅在HOME动作时有意义。
- `sent/ack` 保留原任务命令的发送/应答语义：Base准备参数期间均为0，不能把参数配置应答当成HOME已发送。`wire_sent/reply/bus_result/tx_ms/uart_error` 是当前子事务的实际发送完成、匹配应答、总线结果、发送完成时刻及其错误；无总线事件时 `bus_result=none`，发送时刻仅在 `wire_sent=1` 时有效。这里的 `uart_error` 不是历史首故障，也不包括已成功重启RX的软告警，后者仍看 `WARN bus rx_restarted`。
- `code_valid=1` 才可将 `code` 解释为驱动命令返回码；参数写入的E2/EE不再丢失。读取状态返回的普通标志不是命令码；`code_valid=0` 时不能用 `code=0x00` 推断驱动成功或某个特定故障。
- `ERR grab home_reply axis=... step=... len=... hex=...`：保存本次匹配应答，冒号分隔十六进制；未收到应答为 `len=0 hex=none`。缓存最多18字节（覆盖当前机械臂最长参数应答），`len` 为实际长度；超长时仅输出前18字节，不把零填充当作收到的数据。
- 读回不一致再输出 `ERR grab home_verify axis=... offset=... expected=... actual=...`，`offset` 从参数块首字节0起，报告首个差异。此时没有驱动拒绝码也可能失败，应结合原始18字节与该差异判断。

网页终端为上述三种行提供中文说明，导出的原始协议不变。原有 `home_flags/motor_flags` 仍是最近有效缓存，不代表失败那次事务收到了这些标志，也不能单凭它们锁定本次原因。手动 `home base dir` 的结果事件也携带同一子事务证据；自动流程和 `grab rehome` 输出上述完整诊断。

三轴回零流程已启动、尚未全部验证时，`missing=home_pending` 表示“回零未完成，参考尚未验证”，不能解释为用户漏设 `x_ppm`。X验证成功后恢复命令脉冲尺度约31.746脉冲/mm及回零边界；旧车仓伸出参数恢复将随参数退役删除。三轴完成后才按真实配置输出missing=none或具体缺项；网页中文摘要不参与协议解析。

下表列出现行网页模板与前端范围；固件仍检查任务互锁、位置单位、反馈、IMU 和机械条件。模板占位符不是发送字面值。

| 命令模板 | 用途 | 参数/限制（网页） |
|---|---|---|
| `pos {axis} {degree}` | 相对转动 | axis=base/z/x；网页Z输入范围−3600～3600°，Base/X为−360～360°；Z固件不设单圈角度限制，底层仍检查命令脉冲限制 |

## 机械臂通信错误

2026-10-03 启动接收修复：UART5 在本次上电首次发送尝试前、没有活动事务时遇到单独的 FE 帧错误，会清理接收残片并重启接收，按现行2 ms应答交接与队列调度继续提交请求。接收重启成功才算恢复；失败锁定并报告 `rx_restart_failed`。运行中的NE/FE/ORE短时接收错误，在未锁定且不处于专用探测/恢复过程时，仅清理接收残片并重启RX DMA，保留当前TX、原应答期限和真实应答校验，不重发HOME或运动。报告WARN bus rx_restarted；应答缺失仍按原超时处理。DMA错误、接收溢出及接收重启失败沿故障路径处理。此行为不重发已发送的电机运动命令，也不修改驱动配置。

`info` 在发生过启动恢复时追加 `[MOTOR BUS STARTUP] recovered_fe=<次数> last_ms=<最近一次故障时刻> rx_restarted=1`，表示历史启动接收恢复记录，不是当前实时健康保证。原 `[MOTOR BUS] locked/reason` 仍表示隔离状态与首次隔离原因。当前 `owner=9` 且 `addr=0 func=0 active=0` 表示没有历史发送事务，9 是 owner 枚举的结束标记；单电机通信测试 owner 为8，ID8转盘实际 owner 为7。旧固件未加入测试前的结束标记为8。

### 当前机械臂方向
`config <axis> <rpm> <acc> <limit_pulses>` 的acc对X/Z允许0..255，对Base及all入口仍为1..255；默认Base20、X/Z0。该配置用于固定X/Z任务、手动位置、Base、视觉连续纠偏及标定。固定X/Z直接发送场景速度与所配置档位；0档直接按目标速度运行，不追加MCU余弦规划。阶段速度由x_speed、x_transfer_speed、z_speed、z_pick_speed等决定；grab accel和grab track accel仍是视觉MCU加速度（mm/s²），与驱动档位独立。

`grab get/set` 的名称、默认值、范围和启动/回零载入时机由 `Code/template/App/grab_parameters.def` 定义，网页数值元数据由 `python Code/tools/sync_grab_parameters.py` 生成。`z_speed` 和 `z_pick_speed` 范围均为大于 0、至 333.333 mm/s，`grab track pick` 显式速度也使用此范围；运动前仍按当前 `z_ppm` 检查 1～3000 RPM。网页默认 Z 下限同步为 −110 mm、Base 偏转范围同步为 ±360°。默认值载入时机、未知场景高度留空及 RAM 保存规则保留。

- X：`pos x` 正值向外，负值向内；正值协议方向 CCW（1）。
- Z：当前安装实测 CCW 向下，已将正值协议方向改为 CW（0），使 `pos z` 正值向上、负值向下。设备是否具备此方向以当前固件和读回为准；`info` 输出 `arm positive_dir base=1 z=0 x=1 (0=CW 1=CCW)` 可核对。
- `home z collision` 的方向独立采用驱动器 `O_Dir`；当前安装要向上回零，应将其设为 CW。STM32 方向宏不修改驱动器已存储的回零参数。
- Z 普通运动上电默认等效于 `config z 2250 0 0`：普通位置默认速度2250 RPM、Emm加速度档位0（直接按目标速度运行）、单次脉冲数无限制（不代表机械行程保护）。控制台临时`config`只在RAM，STM32复位后恢复默认值。固定Z任务同样读取该档位；回零速度仍由驱动器`O_Vel`决定。

现有 `enable/disable/state` 命令不变。单轴错误增加总线隔离状态：

- `ERR motor tx bus_locked=0/1`：请求未能提交到电机发送层。
- `ERR motor communication axis=base bus_locked=0/1`：异步传输失败，没有有效电机返回码。
- `ERR ack_timeout axis=base state_unknown bus_locked=0/1`：未在期限内收到合法应答，不能据此判断电机没有执行命令。

`bus_locked=1` 表示共享 UART5 总线处于故障隔离，后续普通电机请求会被拒绝；不是网页按钮失效，也不是驱动实际复位的证明。参见[UART5 循环 DMA 修复记录](../开发记录/2026-09-12UART5循环DMA与单次失能故障修复.md)。

2026-09-27 起，启动及 `info` 增加 `BUILD motorbus_diag=1 date=... time=...`。上述通信错误后以及 `info` 中输出首次锁定记录：

```text
[MOTOR BUS] locked=1 reason=uart_error fault_ms=12345 owner=2 addr=7 func=0x3A active=0 wait=0 uart_error=0x00000004
```

此行为格式示例，不是实车采样。`fault_ms` 为 MCU 启动后的故障时刻；`owner` 为 0=停车、1=底盘、2=机械臂、3=旧驱动接口、4=四轮反馈、5=尚无事务。`active/wait` 为故障记录时是否存在事务/等待应答；空闲 UART 错误时，`addr/func` 仅标记最后下发的事务，不能据此归责该电机。`drain_timeout` 则标记被取消且尚未收完应答的查询。

| reason | 含义 |
|---|---|
| `none` | 当前没有保留的隔离记录，其他故障字段不用于判断 |
| `uart_error` | UART5 HAL 错误回调；错误码在重新启动接收前保存 |
| `rx_overflow` | UART5 软件接收环形缓冲溢出 |
| `reply_timeout` | 已发送，等待驱动器应答超时 |
| `tx_timeout` | 未在期限内收到发送完成回调 |
| `cancelled_reply` | 取消了等待应答的普通事务，保留迟到应答隔离 |
| `drain_timeout` | 被取消的反馈查询未在期限内收完应答 |

`uart_error` 为位掩码：PE=0x01、NE=0x02、FE=0x04、ORE=0x08、DMA=0x10，可组合。首次记录不会被后续失败覆盖；正常查询不会清除记录或解锁。`info` 只读取 RAM，即使总线锁定也可以查看。详见[首次锁定诊断记录](../开发记录/2026-09-27-UART5首次锁定诊断.md)。

### Base 回零降级继续

`grab get base_home_degrade` 读取策略；`grab set base_home_degrade 1` 为默认比赛模式，`0` 为严格模式。该项为 MCU RAM 配置，普通停止保留，复位恢复源码默认 1。网页“参数调试 → 运动与标定”提供同名参数，显式应用并读回才生效。

仅在本次 Base HOME 已受理、编码器及校准就绪且只有回零失败 bit3 时降级。要求 HOME 已退出、无过温/过流，读取新鲜位置及电机状态，使能正常、无瞬时堵转/堵转保护，再读取实际 0x35 转速。连续两轮位置稳定且实际转速为 0 RPM，才把当前多圈位置作为近似后向车仓参考，继续上电 IMU 验证或手动 Base 回零后的姿态准备。Base 两次位置差窗口为 5°，并不表示距离保存机械零点不超过 5°；X/Z 的窗口仍为 182 反馈单位。降级且短暂失能时，恢复 ENABLE 前也须读取实际零速，之后仍核验新鲜反馈。

输出 `OK grab home_degraded axis=base failed_home_flags=0x0B rear_deg=... reference=approximate motion=quiet`，完成原因为 `home_complete_degraded`；状态字段 `base_home_degraded=1` 持续到该参考失效或正常回零重新建立，后续准备、抓放及普通停止仍可见。`home_verified` 位图表示流程已验证通过，Base 可能为降级参考，必须结合此字段，不等于三轴均精准回零。近似参考的误差会带入 Base 作业 +117.5° 和返回车仓，不写驱动机械零点、不清多圈位置、不改变 ID8 仓位或底盘航向。

严格模式退出或降级验证超时后，如果本次 Base 回零失败且 X/Z 已验证，可在“视觉任务 → 回零与通信恢复”点击“确认 Base 近似参考并继续”，或发送 `grab home accept`。人工需确认当前方向接近车仓；命令仅重新读取 Base 反馈，不重发 HOME/X/Z 动作，仍要求上述停稳与正常驱动状态。接受后不自动恢复此前已取消的姿态准备，需再次点击准备；上电流程会继续安排 IMU 验证。中断可能清除驱动失败位，显式接受仍标记为近似参考，保留原始失败标志。无本次失败记录、X/Z 未验证、机构正忙或总线锁定时拒绝。人工停止取消待办，不迟到续跑。

过温/过流、编码器或校准未就绪、堵转保护、读回失败仍沿原故障停车路径。HOME 持续运行、实际转速非零、位置持续变化不会建立参考；短时波动恢复后继续验证，60 秒原有上限保留。

## 后向机械臂两批任务

已启动的进站作业姿态持续等待work_ready，不依赖底盘之后是否切入move位置修正阶段；姿态启动仍限于原work_turn/work_dock边界。底盘已到工位且确认停稳、该次姿态完成后才交接抓取；暂停继续保留已经启动的姿态，不重复创建准备任务；恢复时仍按原流程重新核验姿态，不用旧任务完成状态放行。

2026-10-13通信恢复新增状态`bus_recovery_stopping/bus_recovering/bus_recovery_verify/bus_recovery_wait`，比赛回复可附带`bus_recoveries`与`auto_resume=0|1`；恢复计数仅诊断。仅当前锁定且属于串口噪声/帧/溢出或通信超时的故障自动触发，历史fault不触发。抓取子任务在退出前保存阶段、绝对目标、夹持/释放及库存上下文；总线恢复复用已有停止/中断HOME、三轮8电机检查、四轮零速缓存写入/同步/新鲜反馈验证（四轮零速写入均已确认时，单独同步被拒绝改记告警，仍逐轮验证真实停稳），恢复后重新获得机构和四轮停车证据、原定位资格再续接。不重新HOME/ZERO、不重扫、不初始化库存。驱动未使能或保护等验证失败保留待处理。

比赛活动期间手动`bus recover`转入保留比赛的恢复路径，受理回复`OK bus recover requested mission_preserved=1 tasks_resumed=0`，完成后等待`grab mission continue`；自动故障恢复成功可续接原阶段。恢复中`grab mission pause`取消自动续接意图，`grab mission stop`终止本轮并取消恢复。`bus_recovery_wait`下continue明确重试恢复并请求续跑。非比赛或终止停车阶段仍可沿旧入口恢复硬件，不重新获得已终止任务所有权。

Base回零位置稳定窗口按GRAB_BASE_HOME_STABLE_TOL_DEG，当前为5°（65536反馈单位/圈）；连续新鲜反馈确认，不能据稳定窗口推断真实零点误差。X/Z维持原182反馈单位窗口。回零按HOME退出/结果、实际位置、使能及无故障验证，允许降级时结合base_home_degraded字段；普通位置到位位不是回零必要条件。

Base共用作业转角按当前要求统一为117.5°，需与既有路线及工位车体转向衔接。共用 `grab pose work` 和从后向参考进入任务准备已统一为后向锚点加117.5°，由 `grab_parameters.def` 的 `GRAB_BASE_WORK_OFFSET_DEG` 定义；需烧录新固件后生效。该机构准备转角与地图车体yaw分别管理，既有工位车体转向规则保留。

正式命令为 `grab mission qr [speed_mm_s] [turn_deg_s] [lower|upper] [fixed|radar] [lowered|raised]` 或 `grab mission fixed <15字符码> [speed_mm_s] [turn_deg_s] [lower|upper] [fixed|radar] [lowered|raised]`；路线默认1000 mm/s、范围10～5000，转向默认100°/s、范围5～360；扫码接近统一使用路线速度。省略来源不受理。`grab mission status`查询，`grab stop`暂停，`grab mission continue`从config_wait或暂停阶段继续；`stop_wait`表示续接待处理，须结合stop_confirmed和reason区分停车待确认与已停稳但反馈/参考待恢复；按本轮自动或人工续接安排重新核验，不一概要求重复恢复总线。物理Base回零朝后，保存其实际多圈锚点；作业为锚点+117.5°，车仓方向就是锚点，车仓X使用收回位置。`grab pose rear|work`先核验Z抬起、X收回再转Base，work到位后开爪2450 µs、rear保持夹爪，不执行HOME/ZERO；不得用于已持料的正式对准准备。普通准备停止保留锚点和配置，再次启动按新鲜停稳位置补齐剩余动作，不把中途位置当成新原点。

正式比赛开始表示用户已按所选起点放车并清空料盘，不额外确认。机构准备后STM32自动选择四轮反馈，等速度/位置/状态新鲜、静止、使能正常无驱动保护，再检查已验证IMU；符合所选起点的原定位直接复用，否则建立本轮(2250,150,180°)或(2250,2250,−90°)定位。缺反馈/IMU短时等待恢复，不清零或重校IMU，不依赖网页遥测；暂停保留原点，已出发阶段不重新声明起点。独立单件测试和准备跑图维持原行为，具体证据见[现行定位约定](../比赛与取放约定.md#起点定位扫码与雷达)。

任务外已发送Base普通位置动作不再调用完整参考失效：保留有效RearBase及J/航向标定数值，清除旧观测、追踪参考/拟合、本件快照和待续接子动作，撤销当前位置资格；ACK未知同样须复核，未发送不触发。视觉入口返回work_pose_required；已有grab pose work完成原锚点+117.5°及既有机构新鲜到位/停稳核验后解除该等待，不自动发起视觉或运动。普通停止、rear/qr准备及grab calib ref不解除等待。HOME/ZERO/ORIGIN_SET真实参考改变仍走参考失效与核验流程。当前仅源码完成，未编译烧录，见[修复记录](../开发记录/2026-10-16-手动Base保留标定与姿态复核.md)。

任务外 `home base near` 已实际发送完成、底层结果成功后，若仅后向 Base 锚点待验证，`grab pose rear|work` 可受理本轴局部验证：状态为 `homing operation=pose ref_cause=base_reference_verifying home_scope=base`，仅读取HOME状态、位置和使能，沿既有连续稳定反馈规则建立锚点后自动衔接已请求的姿态。X/Z配置保持；Base视觉参数按既有回零验证规则恢复。HOME发送完成本身不构成回零完成证明；运动未结束时等待，失败、未校准、总线错误不建立锚点。手动回零发送未完成或传输结果未知、非near模式、随后Base移动/清零/停止/中断均不能走该自动恢复。停止局部验证取消后续姿态，恢复需重新 `home base near` 后再准备；不要求重新回零X/Z。局部诊断中 `home_started/home_verified` 只报告Base的bit2，X/Z不被伪报为本次已验证；完整回零诊断为 `home_scope=all`。

正式任务在二维码处交接真实扫码及Z搜索流程，基线排除启动前旧码与模拟码。串口屏只显示本轮真实结果，采用码在真实扫码后冻结；固定模式采用请求中的固定码，绝不把固定码写入QR模拟缓存。每批原料三件入仓→粗加工三件全部放好再取回→暂存；第二批按第一批颜色对应环码垛→返回所选起点。粗加工环1/2/3为右/中/左，暂存为下/中/上，间距150 mm，按已确认官方图。所有工位交接用station/visit，不依赖中转点序号。

正式比赛第一批从(2100,2100)保持90°向左平移到(1200,2100)，phase=work_approach、direction=lateral；到点及停车确认后在原位顺时针转90°至0°，phase=work_turn、direction=turn。两阶段分别核验停车，不在横移中转车体。第二批从中心进入物料台保留连续转向；右下标准开局按本轮profile区分，默认linear保持180°斜移至(2100,300)，停车后顺时针原地转至90°再直行扫码，cosine才保留连续转至90°的开局。连续曲线的phase为entry_curve/work_curve、direction=curve，物料台曲线转弯完成后标记work_dock准备Base姿态。曲线中间不请求停车，暂停保存路径进度，终点仍核验新鲜定位与实际停车。加工观察点(1200,380)到点转180°后直接视觉接管，不固定贴近Y300；中心到暂存区采用0°倒车或180°前进，外侧(425,1200)再转90°并保留75 mm接近；Base工作为原参考+117.5°。姿态避让资格成立后可并行平移，工位交接仍等待双方完成；不删除绕障途经点。旧grab route和radar task start为独立首件测试，保持其原分支语义。

任务报告沿用 `OK|ERR grab route state=...`，字段为 `mode=mission code_source=qr|fixed source=qr|fixed scan_code=... exec_code=... code=... batch=1|2 item=1..3 slot ring station visit stored placed stop_confirmed elapsed_ms reason`。`code`兼容字段与exec_code相同，采用前为none；实际扫码单独scan_code。stored/placed各0～12，只在完整子动作结果完成后计数。config_wait的reason为具体缺项，grab set在此允许填写；普通暂停保留库存和进度，重复完成不重复计数。仓1/2/3默认0°/+90°/+180°，运行RAM仍须读回。启动要求有效转盘参考及仓位配置；正式新比赛受理表示实盘已清空，自动初始化三仓空库存，不检查旧库存或另行确认空仓。

本机C规划结果增加 `route_profiles.task_fixed/task_planned` 与任务阶段 `arm_pose=rear|work`，旧fixed/planned字段不变。预览只播放底盘，不计实际取放耗时。接口、工位表、软件验证与实车顺序见[后向任务记录](../开发记录/2026-10-07-实车后向机械臂两批任务流程.md)。

### 正式取放与独立入仓共用 X 速度

`grab get/set x_transfer_speed`（mm/s，默认 60，上限 100）用于固定取放、X 收回、工位口伸出和行驶/作业姿态切换。`grab place car` 与正式 `grab mission` 共用 `axis_move()` 和这一参数，不维护独立入仓运动代码。`x_speed`用于静态视觉对准，默认值按grab_parameters.def及设备读回；动态追踪 `grab track set x_speed` 独立，默认 60。Z下降、观察、提起、色环放置及扫码统一使用任务速度，默认250 mm/s（当前尺度2250 RPM）；`z_speed`、`z_pick_speed`、`qr_z_speed`为同步兼容键，设备实际值以读回为准。Base 默认 60 RPM；任务转向已停稳但差大于2°且不超过5°时，以≤15 RPM重发同一个绝对目标，不使用模式2相对补偿，按临时2°容差和新鲜停稳反馈确认。固定X/Z、视觉连续纠偏与Base均读取对应config轴档位，X/Z到位判据独立保留。参数只在 STM32 RAM 中，复位恢复固件默认值。

本次 DAPLink 运行中实测：UART5 在读取 ID4 位置时出现 FE（0x04），另一次设 X 60 mm/s 后在回缩阶段读取 ID4 状态时出现 NE（0x02）；随后总线锁定并停止反馈更新，任务报 feedback_stale/stop_unconfirmed。不是 X 行程超时。bus recover 曾恢复全部驱动并确认四轮停稳；完整入仓动作尚未实车通过。

后续05:58烧录校验成功，实测x_transfer_speed=60、X反馈速度约59.2 mm/s；在约20.8 mm缓存位置遇到ID2速度读取期间的UART5 FE，仍未完成入仓。bus recover后确认三轴/四轮停稳。

### 06:26 最终实测：应答交接与连续入仓

本条更新此前“普通Receive应答后立即推进”和05:58仍失败的现场状态。普通事务收到完整匹配应答后等待2 ms再发送下一条，不恢复旧10/80/100 ms调度门槛；紧急FE/9C绕过此普通应答间隔，保留既有TX后2 ms停车链节奏。相同固件只把RAM间隔从2改为0，入仓在X约11.8 mm再次出现UART5 FE；恢复2 ms后完成。

自动Base转向使用保存的多圈朝后锚点计算绝对目标，发送FD模式1；不重新HOME/ZERO。仅Z上限收回允许在新鲜反馈、命令后持续静止、现有位置容差内且使能无故障时确认，不依赖驱动到位位；下降松爪和所有X目标仍要求驱动到位。独立入仓与正式任务继续共用同一机构动作和x_transfer_speed=60 mm/s。

06:26:53经DAPLink烧录校验后，连续两轮 `grab place car` → `grab pose rear` 均完成，中间未复位或重新回零：入仓X约100 mm、Z约−60 mm并执行开爪；最终travel_ready，Base约−0.012°、Z约−0.065 mm、X约0.011 mm，三轴速度为0，首故障记录为空。完整赛事流程与带料实际释放仍需对应实物验收。详见[应答交接与连续循环记录](../开发记录/2026-10-07-UART5应答交接间隔与入仓连续循环实测修复.md)。

### 蓝色单件路线测试

`grab route [speed_mm_s]`（默认1000、10～5000）现复用正式后向任务流程：准备后向姿态→右下固定路线→二维码直接通过→原料前车体/Base转向作业→蓝色3入第一仓→后向收回结束，完成reason=single_piece_stored。不继续加工、暂存或返回起点。`radar task start`仍保留旧模拟扫码/红色首件流程。

单件测试用本地固定颜色，不写QR或屏幕任务码；报告mode=single source=test code=none color=3 slot=1，已有真实/模拟任务码继续保留。正式grab mission仍按任务码，两入口不会同时运行。第一仓需已建立转盘参考、配置角度、确认空仓；不要求第二/第三仓配置或为空。取放缺项仍config_wait，可补齐后grab mission continue；grab stop取消。控制台视觉任务→单件抓取第5项直接显示启动按钮，上方单件颜色选择不影响此入口。

### 转盘手动就近回零与软件参考

ID8上电自动就近回零恢复，启动等待完成后与Z/X回零并行，仅执行一次；ID8与Z/X完成后才启动Base，不等待三轴`home_complete`。自动与手动`turntable home`使用驱动器已保存机械零点，不发送save_zero或清位置计数。读取回零状态、实际位置、速度与正常使能并稳定确认后，将实际多圈位置存为OriginRaw，第一仓相对角度0°、ref=1；启动受理不表示参考已建立。停止或受理的显式人工操作取消尚未启动的自动待办，不在恢复总线后重放。

回零完成日志为 `OK turntable home complete ref=1`，自动启动另外报告`OK turntable boot_home accepted mode=near`。自动/手动HOME或人工对齐后的`turntable origin`实际成功前，第一仓软件参考保持未建立，不预置reference_valid=true。第一仓默认slot1_deg=0；第二/第三仓已确认相对角度+90°/+180°，当前源码默认已同步为+90°/+180°，运行RAM值仍需读回；库存上电仍待核对，不因回零改为空。

2026-10-07首仓诊断补充：单件路线启动分别报告first_slot_angle_unset（第一仓角度未配置）、first_slot_inventory_unknown（库存待核对）、first_slot_occupied（已有物料），不再混成first_empty_configured_slot_required。启动失败报mode=single source=test code=none color=3 slot=1，不套旧模拟扫码状态。视觉页第5项旁提供“确认第一仓为空”，显式发送turntable inventory 1 empty；复位不自动假定空仓。

底盘自动路线与grab route共用ChassisMotion停车判定。位置整组和四轮速度由不同UART事务更新，等待四轮新速度后再消费新位置组；某轮速度仍是新鲜的上次样本时只等待，不判作运动或重复计组。当前以停车发送完成后的连续至少3组新四轮反馈确认，保留600ms新鲜度、≤1RPM/≤2mm和路线停车3秒超时，取消额外500ms稳定等待。独立停车监控采用同一组数、速度及位移门槛；视觉/机械臂任务自己的稳定时间独立保留。软件回归覆盖交错反馈、旧缓存、运动重置及毫秒计时回绕。

### 机械臂位置接口与运行中查询
机械臂内部Position/PositionEx不因底盘路线运行统一拒绝，仍以请求互斥及UART5实际TX完成推进，到位另取真实反馈；动作是否可并行由任务层按姿态和步骤控制。正式任务的Base转向共用PositionEx，没有测试专用位置旁路；手动命令与自动任务互斥、HOME/ZERO及驱动配置的限制保留。

`grab route status`、`grab mission status`只读当前组合路线；`chassis task`、`chassis route status`只读底盘缓存状态，任务运行时可查询，不启动/停止执行。

### 正式持料与加工取回接口

父任务直接调用抓取接口，不由网页发送延时命令。正式比赛第一层暂存先空爪对准目标编号环，确认新鲜视觉、稳定及停车后保存本件实际X/Z、工位、环号和绝对释放目标；保持底盘位置与朝向，抬Z收X并回仓取料，保留1/2号盘伸X30 mm避让。持料转回作业方向后恢复保存X并确认到位，Z连续直达保存的z_proc_place目标松爪，不再请求色环视觉。默认高位Z=0，显式低位使用z_temp_align；暂停继续保留本件快照和已夹/已释放阶段。第二层码垛先空爪识别第一层已放好的同色物料，协同对准并核验新鲜视觉及停稳后保存实际X/Z、目标颜色和z_stack_place绝对释放目标；再抬Z收X、回仓取出第二批物料（1/2号盘仍并行伸X30 mm避让），持料转回作业方向、恢复保存X，确认机构到位后下降至保存高度释放。取仓后至释放不再请求视觉，不因持料遮挡而重对准；暂停/通信恢复保留本件快照及已夹/已释放阶段，终止作废快照。独立持料测试入口保持原语义。正式粗加工放置先调用`GrabTask_AlignPlaceStartForSlot("rough", ring, raised, slot)`明确本件仓位，独立未指定仓的入口保持`GrabTask_AlignPlaceStart("rough", ring)`：默认在绝对Z=0高位识别；显式低位对照才在视觉启动纠偏后连续下降到z_rough_align；对准编号环并稳定停稳，`GrabTask_AlignPlaceCapture()`再次核验新鲜坐标与机构停稳，保存实际X/Z，完成后才调用`GrabTask_CarPickStart(slot)`。目标仓明确且Base在外侧静止时，ID8分度与视觉对准及后续抬Z收X并行，汇合到位后Base才回仓。1/2号盘闭爪提起同时伸X30mm，X到位即可保持闭爪转参考+117.5°，Z继续抬升；3号盘保持收回，仍等Z抬升到位再转。随后`GrabTask_AlignedPlaceStart("rough", ring, color)`恢复保存X并确认到位，Z直接发送一次完整z_proc_place目标（默认−110 mm），途中不停车、不切换目标，确认最终到位后释放并提起；不要求持料时重新识别被物料遮挡的环。暂停保留本件快照及绝对放置目标，继续不重复松爪，终止或参考变化清除。暂存第一层使用同一预对准/保存/放置接口，scene为`temp1`，低位对准高度改用z_temp_align；第二层码垛复用预对准/保存/放置接口，scene为`temp2`、target为第一层物料颜色1～6，使用z_stack_place，加工取回复用`GrabTask_ProcessedStoreStart`，取回默认在Z=0识别对准后下降至−110 mm夹取。完整released/stored结果才推进父任务。

加工取回受理后，先输出2450 µs打开脉宽进行视觉识别，对准停稳后再下降，Z到位以1920 µs闭爪，后续入仓松爪仍2450 µs。车仓取料下降前使用独立2120 µs防碰开口。加工区前两件在Base外侧静止条件下，ID8可在视觉对准期间提前分度，并与后续下降夹取、Z抬升和X收回重叠；提前到位反馈过期时使用VerifySlot补读，不能重复触发HOME。暂停停止取消提前分度，继续保存原目标仓和已闭爪阶段。共用车仓取出入口使暂存/码垛取料也采用相同提前分度；原料动态追踪此前已提前分度。

加工区第三件取回入仓单独避让：正式比赛在换环前/途中满足Z高位及Base外侧静止条件时，保存仓3配置角、仓3+90°避让角及z_car_lift绝对高度并启动270°预备；下一件取回接管该目标，不覆盖第二件库存和stored结果。独立取回在受理时建立相同目标。Base在外侧且Z已提起时，ID8从仓2直接正转180°到避让位置（默认270°），不在中途仓3停下或确认；避让到位后才开始对准/下降。夹取后必须等Z抬升到位，再反转90°回仓3（默认180°），可与收X及Base回仓并行；X收回、Base和ID8均到位后才下降入仓。暂停/通信恢复沿用保存的绝对目标，已到避让位置且机构处于低位时只补读验证，不重新旋转；释放后才记库存。此例外不作用于原料、加工区前两件、暂存或码垛；同一加工取回接口指定仓3的单项测试也采用该避让。 内部Turntable_AngleStart使用保存的参考角目标及FD模式1，180°方向在原分度容差内优先正向，普通index/jog语义保持。Turntable_AngleVerify仅读位置/速度/状态；低位恢复若实际偏离已确认目标，报告position_changed并按现有故障停车处理，不在低位自动转仓。未新增串口命令。

`z_rough_align`、`z_temp_align`为显式低位对照使用的绝对对准Z参数，当前默认均为−100 mm；高度范围使用z_min/z_max，放置/夹取高度不得高于对应对准高度。加工取回默认在绝对Z=0；显式低位对照才先降至z_rough_align确认到位。使用物料DX/DY按`dx_tol/dy_tol`（默认各±1 px）、`frames`（默认3帧）、`stable_ms`（源码默认200 ms）稳定对准并确认停车。随后停止视觉请求，固定水平位置下降至z_proc_place（默认−110 mm），确认Z到位就闭爪；最终下降不核验视觉误差、不因视觉缺失等待，也不提起重获。暂停前尚未对准则继续视觉对准；已进入最终下降则只续接原绝对Z目标，仍验证机构反馈。入仓后保持原高位返回。编号环准心由视觉端独立管理；独立暂存持料测试低位持料放置按原渐进下降/重获流程，raised对准后的最终下降不依赖视觉，不重复松爪。

2026-10-13连续追踪入仓：释放等待及库存记账已完成、仅剩返回时，停稳后可用新`grab track pickstore`或`grab track pick`选择下一件。固件回报`phase=prepare`，先复用空夹抓取姿态准备，再自动进入新追踪。仍持料、释放未记账或停车未确认时不跳过原任务；准备期间stop取消待启动请求。旧件库存保留，不重复投料。

2026-10-13 ID8分度：默认pos_tol_deg=2.5，仅作为到位接受窗口，位置指令仍发精确目标角度，成功到位不提前停车或失能，驱动继续修正并保持。位置等待预算=max(5000 ms, 2×理论匀速时间+feedback_ms+stable_ms)，不改变转速或加速度档位；超时附带实际/目标角度、偏差、容差、速度、原始状态位、新鲜度、已用时间和预算。驱动故障、使能及停稳条件保留；普通位置到位bit1不再作为分度完成的必要条件，新鲜位置在容差内、速度≤1 RPM、无堵转状态且使能正常持续stable_ms后完成。驱动仍保持精确目标指令。

历史实现记录（2026-10-13，当时的自动方向模式已被当前就近模式取代）：上电及grab rehome的Base阶段改为单圈方向回零（mode=1），X/Z验证后先开爪2450 µs再进入Base阶段。home base dir同样自动读取0x22参数，仅以0x4C不存储方式将模式设1、方向设为负相对角度对应的0，读回完整参数核对后发送0x9A。保持原有速度、超时、电流与碰撞阈值；不改机械零点。此方向按用户实物为俯视逆时针。显式home base near仍保留就近模式，ID8回零不变。网页Base快捷回零默认改为负向。

2026-10-13 ID8近似回零：HOME失败bit3置位时不立即中断整车初始化；等待HOME退出、无过温/过流及电机堵转标志，新鲜反馈使能正常、实际转速严格0 RPM、相邻位置变化在pos_tol_deg内并持续stable_ms，才接受当前位置为1号盘近似参考。位置稳定窗口不代表距真实零点误差已知。输出reference=approximate、ref_degraded=1，状态reason=home_approximate，初始化继续。近似参考用于后续分度，不写机械零点、不清计数或库存；普通停止保留标记，正常回零或显式建立参考后清除。仍在运行或暂未停稳时继续等待，保留原60秒回零上限；堵转和真实驱动故障仍停车。

普通固定位置动作采用axis_stable_arrival测量确认，arrival_hold_ms默认200 ms；每轴随新反馈独立累计，复用仍有效的同目标证据。旧Both/9F直接完成及500 ms后备均为历史实现，不作为当前路径。X/Z按pos_tol、Base按现行业务容差，HOME、停车及静态视觉稳定独立。

比赛起点与雷达（2026-10-13）：省略末尾选项时为lower、fixed。upper为右上(2250,2250)，初始航向−90°；lower为右下(2250,150)，初始航向180°。路线模式fixed与执行码来源fixed是独立概念。radar由STM32在开始后展开雷达，采集15圈当前起点的新地图，规划并收回雷达后出发；失败进入config_wait，显式continue重试，不使用旧地图或自动改走固定路线。最终返回所选起点。

当前工位默认：z_rough_align与z_temp_align为−100 mm低位对照高度；z_proc_place为−110 mm，加工取放及第一层暂存共用；z_stack_place为−100 mm。默认高位Z=0对准后分别下降110/100 mm。Z回零验证后安装默认值，可用grab get读取、grab set显式修改RAM。

### 比赛工位视觉对准模式（2026-10-13）

比赛命令末尾可选lowered/raised：省略默认raised；lowered仅用于显式下降对照。raised在绝对Z=0完成加工区编号环、加工物料取回、暂存一层色环及二层物料码垛对准。受理后复制为本轮模式，暂停、继续及通信恢复保留，状态报告align=lowered或align=raised。独立工位取放接口也默认高位，Ex接口仍可显式选择低位对照；原料追踪不受此选项影响。

高位模式在新鲜视觉稳定、停车确认后，保持水平位置并下降到原实际取放高度；最终下降不再依赖视觉，暂停续接也不重新请求该阶段视觉。加工区和第一层暂存先空爪对环再取仓，恢复保存X后连续下降到释放高度。高位无需配置未使用的对准高度，但真实取放高度、Z=0软件行程和机构反馈仍须有效。网页草稿与设备采用模式分开显示，不在切换选项或重连时发送指令。

比赛命令在对准模式之后可追加linear或cosine，省略默认linear；例如`grab mission fixed 156+123+516+231 1000 100 upper radar lowered cosine`。命令链最多12字段、95字节，不含换行；模式与倍率在受理后冻结，状态profile字段报告本轮模式，route_scale报告本轮倍率，暂停及通信恢复不改变。

### 编号环独立对准高度与完成动作（2026-10-14）

视觉任务 → 编号环 → 第一条“视觉对准”提供两个独立选择：对准高度默认“高位对准 · Z=0”，可显式选“下降对准 · 仅对照测试”（草稿−100 mm）；完成后默认“保持对准高度”，也可选“抬回上限 · 默认Z=0”。统一点击“开始对准”发送一条命令。

高位表示回到绝对Z=0，不是保持任意当前高度；选择高位时下降高度输入禁用但保留草稿，不参与命令校验。抬高复用既有z_max上限（默认0），在该上限完成对准且有本次停车后的新鲜、正常、静止位置反馈时，直接完成，不重复发送抬升。保持高度时继续识别供观察，不继续纠偏；抬高完成停止识别。比赛入口的本轮选择不影响这个独立入口。

四种组合使用现有协议（以1号环、下降−100 mm为例）：

| 对准高度 | 完成后 | 指令 |
|---|---|---|
| 下降−100 mm | 抬高 | `grab align ring 1 -100` |
| 下降−100 mm | 保持 | `grab align ring 1 -100 stay` |
| Z=0 | 抬高 | `grab align ring 1 0` |
| Z=0 | 保持 | `grab align ring 1 0 stay` |

手动命令 `grab align ring 1`、`grab ring align 1` 省略Z高度时也默认Z=0并保持；旧别名 `grab ring align` 省略环号默认1号环。明确填写Z高度时保留原语义：不带stay则完成后抬回上限，带stay则保持该高度。

修改选择、切页、刷新与重连不发送动作。通信故障A/B对照入口保留。后续手动装料在对准停稳后执行，需要高位装料时选抬高；第三步下降松爪后仍按既有规则返回本次放置开始高度。

### 视觉角单次底盘试转

此入口和已标定的自动视觉航向校正均走`ChassisMotion_TurnToPrecision`，绕过普通平移航向保持的±0.1°纠偏死区；原有完成精度及新鲜停稳判定保留。普通死区不修改视觉DX/DY对准、图像角测量或地图角校正。

`grab heading angle <proc|temp> [<1|-1> [speed_deg_s]]`：省略方向默认−1（反号），显式+1仍为同号；方向参数为图像角到本次底盘相对转角的符号，不是固定转动1°；速度默认5°/s，范围5～10。先完成`grab pose work`。与普通`grab heading proc|temp [speed]`共用独立定位和停车准备，但强制前后观测模式，即使已有标定也不提交地图角或自动闭环校正。附加`line`时使用独立黑线协议：`grab heading angle temp -1 5 line`，普通核验为`grab heading temp 5 line`；不附加时仍为色环0D。黑线参数`head_line_zero/head_line_gain`单独标定，未设置时普通核验仅观测。获取所选参照的新有效B2/0D或0E角后固定一次目标`当前地图角 + 方向×图像角`，跨±180°归一；通信忙重试同一目标，按0.1°精度转向、停稳后再次观测。角度超出当前水平线协议−90°～+90°不转动并报告`heading_angle_mismatch`。

状态仍为`OK|ERR grab route ... mode=heading`，增加`heading_source=ring|line`、`probe=1`、`probe_before`、`probe_after`、`probe_delta`、`probe_yaw_delta`（单位°，缺失为nan）。准备转动/转动中为`heading_probe_turn`/`heading_probe_moving`；`reason=heading_probe_done`仅表示一次试转和前后观测完成，不代表已对正。转前缺图不动；转后缺图报告`heading_no_observation`。`grab stop`沿用人工停止与新鲜停车确认，不能continue续转。此入口不加入正式比赛自动调用，不清库存，不写标定参数。

工位换环保留本次进站首个成功视觉对准/放置时的底盘定位XY及对应环号，下一环按150 mm间距计算目标，保持首次对准的离台距离；每件仍需视觉微调确认。暂停与通信恢复保留锚点，下一次工位到站清除重建；定位反馈暂缺时沿用任务等待新鲜定位，不用过期值建立锚点。命令格式不变。

### 比赛倍率命令与读回

示例：`grab mission qr 1000 100 lower fixed vhigh linear scale=1.2`，基准总限速1000，实际总限速1200；扫码段基准800→960、起步800→960、停车300→360，工位局部50→60。K=1网页沿用旧命令，不增加尾字段。`route_scale_range`表示倍率非法，`route_scaled_speed_range`表示有效总限速越界，`route_scale_linear_only`表示cosine不能采用非1倍率。底盘路线缓存另报告base_speed_mm_s、route_scale及有效speed_mm_s，phase_speed_mm_s为本段有效值。连续路径的原60限速、300向量变化率和150前瞻制动参考均乘K，角速度不乘；路径副本缩放，暂停时原几何和未缩放路径保持。
