doinbest/Yachiyo/xjx/模版搭建/docs/开发记录/2026-10-15-IMU双阶段兼容审查与实车失败核查.md

# IMU双阶段兼容审查与实车失败核查

## 范围与操作边界

用户开始重新标定，要求审查本次代码及现行文档，不发送实车命令、不复位、不再次烧录；期间补充本次又失败。主代理与独立审查者按 `.embeddedskills/imu-mode-stage/baseline/` 比较本次差异，读取本地已有串口事件并运行纯主机检查，没有串口/HTTP命令、调试器连接或硬件操作。本轮未修改固件或网页源码。

## 代码审查

未发现可确认的本次新增代码缺陷。启动确认及原生退出写0之前允许模式1/2，正常模式退出后和验证仍只允许0；100 ms异常复核、5秒读取恢复截止、原20秒总计时、完整30秒采样及保存确认保持。恢复模式证据不被后续正常模式退出及status寄存器刷新覆盖。

四个源文件哈希与08:55:55下载清单一致，冻结HEX哈希仍为932cae049b67343ca188b847646ce2359fcd66ba3a0e372d48e8d90ca222117b；实物日志构建时间08:53:46及allowed_mode_mask字段也与该版本相符。主机通过及文件一致不代替实车通过。

独立审查者得到相同结论：提前0的拒绝路径在本次前已有；当前证据不足以把它改成成功。未将其他既有未提交修改并入本次审查结论。

## 最新实车失败证据

服务原始事件24723～24799，08:56:32.520发送imu cal start，08:56:32.789收到受理。第一次约10秒角度读取异常后，08:56:44.764报告i2c_recovered，CAL_WAIT模式2及掩码6正常续接；证明本次模式2兼容已生效。

08:56:48.440第二次读取中断，08:56:50.502/50.612两次模式读回0，设备tick=54554/54664，间隔110 ms，仍处于CAL_WAIT。08:56:51.076报告recovery_mode_changed；最终elapsed_ms=18183、samples=0、verify_elapsed_ms=0、i2c_errors=2、save_requested=0。尚未进入30秒验证，因此这次不能称为漂移再次超标。此前上电5秒drift=0.05457度/秒失败是另一轮结果。

主机使用真实驱动/状态机重放“约10秒模式2且BUSY，约16秒模式0且BUSY”，18.130秒复现同一失败；starts=1、zeros=0、saves=0。可确认失败触发路径，不证明模块为何提前回0。程序正常退出写0仅在原20秒后启动，本轮失败前没有走该路径；失败后退出写0不解释先前读值。

本车当前0x4B/0x4D时长未读取，同系列资料默认各10秒不足以推定本车参数；自动提前完成、异常退出或模块重启仍待区分。登记[P003](../待解决问题.md#p003--imu原生标定在20秒前回到模式0)，本轮不放行提前0、不放宽漂移门限或保存条件。

## 文档一致性与同步

AGENTS、主车README、系统与底盘协议、硬件基线、连接恢复手册的模式允许范围及复核条件与代码一致。上轮历史记录所写“下载时尚未实车重测”保留为当时事实，本记录补充之后的失败。本轮在问题清单登记P003，并在对应现行手册补充目前实车未通过及证据边界；没有修改规则迁就未确认行为。根README已区分源码、软件验证和实车验收，并链接问题清单，无需改写能力入口。

## 软件验证

本轮重新运行7项检查通过：hwt101_i2c_test、hwt101_calibration_test、hwt101_recovery_integration_test、hwt101_read_recovery_test、arm_console_host_test、hwt101_upload_test.py、arm_console_test.py；网页terminal-format/protocol共47项通过；另有上述纯主机实机序列回放通过（成功复现失败路径）。日志位于.embeddedskills/imu-stage-review/。

未重跑固件全量，不声明全量通过；本轮无产品源码变更，因此未重编译或烧录。当前标定仍未实车通过，后退1000 mm、500 mm/s余弦测试仍未执行。后续需要用户另行允许只读设备参数诊断后取得实机时长及版本行为证据。
