doinbest/Yachiyo/xjx/模版搭建/docs/开发记录/2026-10-15-IMU恢复模式复核与诊断.md

# IMU恢复模式复核与诊断

## 依据与范围

用户要求针对原生标定失败修改程序并烧录验证。实机run_id=4在约10.3秒发生一次角度寄存器0x3F读取WRONG_START，约2秒后恢复通信，整轮12.341秒以recovery_mode_changed结束；未进入验证、未保存。原日志仅有最终正常模式，不能证明触发中止时的具体读回值，更不能据此认定模块重启或真实退出标定。原始日志为.embeddedskills/logs/serial/imu-native-cal-20261015-083805。本次只修复单次异常模式读回立即中止的处理并补充诊断，不修改底盘余弦、I2C配置、HAL或漂移阈值，不处理P002。

## 实现

- 读取恢复仍需两个不同更新的新鲜角度。模式首次不符隔至少100 ms只读复核，连续两次成功读回仍不符才中止；匹配后续接原阶段。新增读取错误撤销连续不符判断并重新取证，仍共用原5秒恢复截止，不重发MODE=1、归零或SAVE。
- 独立记录恢复开始时步骤及预期模式、首次/最近成功模式、最近HAL/有效性、读取次数与时刻，保留至下次恢复或新一轮。退出恢复正常模式及status刷新不会覆盖证据。未成功读取时mode_seen=0；最近读取失败时mode_valid=0，不能使用last_mode冒充本次值。
- main.c输出[IMU MODE]，imu status提供同一证据；网页仅新增诊断字段及复核原因中文显示，刷新后生效。原失败、中止、验证完整新窗口、正常模式退出及保存确认保持。
- 同步AGENTS、主车README、系统与底盘协议、硬件基线和连接恢复手册。历史记录保持原事实。

## 验证

先用真实I2C驱动及标定状态机注入一次异常模式，旧程序在CALIBRATING继续断言失败；修改后通过。覆盖间隔前不复核、tick回绕、单次不符后继续且标定不重启、验证重采不重零、持续不符退出及证据不被正常模式覆盖、人工取消、原有通信超时/保存/漂移故障。输出测试在旧上传器缺少[IMU MODE]时失败，新增后通过。

7项检查通过：hwt101_i2c_test、hwt101_calibration_test、hwt101_recovery_integration_test、hwt101_read_recovery_test、arm_console_host_test、hwt101_upload_test.py、arm_console_test.py。网页terminal-format/protocol共47项通过。主车Keil template为0错误0警告。本轮按影响范围验证，未重跑固件全量，不声明整个工程全部测试通过；此前全量失败保持原记录。

日志与产物位于.embeddedskills/imu-mode-confirm/。当前DAP serial=7b168f48、SWD stm32f4x、1000 kHz重新探测成功，身份与当前工程核对；读回CPUID=0x410fc241、DBGMCU_IDCODE=0x10076413、Flash=1024 KiB。冻结固件为.embeddedskills/imu-mode-confirm/build/imu-mode-confirm.hex，SHA256=8e6d33f652f1d13af5ee5cd56e18bc3579bfcd5aa463e192569f0793505044ab。

## 下载与实车状态

首次下载在0x08000000写入阶段失败，记录为flash-attempt-1.json；随后只读核对目标仍连通、扇区未保护、Flash状态无错误标志。沿用相同探针、速率、目标、program verify reset exit及相同冻结固件重试，保留原始完整输出，不解锁、不整片擦除、不改变下载参数。

2026-10-15T08:49:27第二次完成下载校验，programmed=true、verified=true，SHA256=8e6d33f652f1d13af5ee5cd56e18bc3579bfcd5aa463e192569f0793505044ab；结果见.embeddedskills/imu-mode-confirm/flash-result.json及flash-attempt-2.log。首次失败的瞬时原因尚未确定。按约定本轮立即结束，未追加串口或调试器操作。

本轮软件验证不能证明物理I2C异常消失；新固件尚未实车重做原生标定或验证此前后退1000 mm、500 mm/s余弦运动。按协作约定，下载校验成功立即结束本轮，不追加串口标定/运动、复位或再次下载；后续调试期间按用户指令开展代码与现行文档审查。
