doinbest/Yachiyo/xjx/模版搭建/docs/开发记录/2026-10-15-余弦减速连续性修复.md

# 余弦减速连续性修复

用户授权修复小车末端减速时反复起停，保留K200作同条件对照。此前实车前进1000 mm、目标500 mm/s，完整快照记录剩余53.174 mm时速度指令为0；340 ms后的缺字帧保留了48.447 mm/s指令及25.263 mm剩余距离，只作为诊断线索，不视为完整实车复现证据。日志位于`.embeddedskills/logs/serial/cosine-test-1000-0-500-20261015-080749/`。

## 实现

- 保留K200、400 ms半余弦起步及距离制动参考，不改张大头驱动PID或硬件参数，linear300与曲线路径、独立转向保持原控制。
- 删除余弦制动距离中“实测速度减上一轮指令速度”的重复扣除，避免输出越低、下次扣除越多的自反馈。
- 同段采用已观测最大反馈年龄作为制动预算，新帧刷新不立即放宽；新位移、出弯及停车后纠偏重新建立预算。
- 余弦有效位置增益取min(2.5,1/(2×delay+T))，delay为250 ms驱动响应余量加上述年龄，T=400 ms。速度矢量变化受曲线峰值加速度约束；末端20 mm内速度上限取min(50,10/delay) mm/s。不会在到点前锁定零速，也不会完成400 ms过渡后强制整段爬行。
- 到点/航向、最多两次20 mm/s停车后纠偏、真实驱动故障及新鲜四轮停稳检查不变。短段和末端可能更慢，不能以本次修复宣称比赛提速。

## 验证

新增`chassis_cosine_continuity_test.c`调用真实控制器。修改前1000 mm/300 mm/s/200 ms延迟产生13个距目标大于25 mm时的零速周期，测试按预期失败。最终版本五个用例覆盖300/500/1000 mm/s、100/200 ms延迟、120 ms快响应及200 ms响应/600 mm/s²受限带载；提前归零和减速后回升均为0，真实模型终点误差约−7.73～−6.36 mm，均在10 mm内。

探索过固定时间减到低速的实现，但慢响应会超调，保守提前又会增加长段低速爬行；最终实现保留空间制动参考并平滑、减弱延迟位置反馈。外力推移测试沿用原30 mm总位移与20 mm/s反向限制，未放宽原到位或停车容差。

全量固件回归第一处失败为grab_mission_pause_test；继续检查剩余用例共82项通过、8项失败，详见`.embeddedskills/cosine-continuity/tests-remaining/summary.json`：grab_mission_pause_test、grab_pose_test、grab_track_task_test、motor_bus_test、turntable_test、turntable_bus_fairness_test、mecanum_bus_test、mechanical_arm_emergency_chain_test。这些构建均不链接本次修改的chassis_motion.c，不属于本次余弦改动引入的回归；本轮不修改无关机构/总线行为。不得称全量回归通过。

最终版本11项底盘控制专项已全部通过，Keil编译0错误、0警告；烧录状态如下。软件模型不替代修复版实车验收。

## 交付状态

- 专项：最终11项全部通过，覆盖位置/航向、连续性、余弦短段与延迟预算、距离纠偏、曲线路径、停车、转向和任务取消/暂停；全量仍有上述8项独立失败。
- Keil：Target template，0错误、0警告；冻结HEX和源码哈希见`.embeddedskills/cosine-continuity/build-final/manifest.json`。
- 烧录：2026-10-15T08:32:08+08:00，指定DAP探针及1 MB STM32F4核验后，冻结HEX执行program verify reset exit成功，烧录与读回校验通过。
- 实车：修复版尚未验收；整场比赛完成率和定位效果仍需实物确认。

## 后续实车记录：09:28后退专项

2026-10-15 09:28，用户授权后退1000 mm、目标合速度500 mm/s并读取日志。沿用当前串口服务COM23、115200/8N1，未修改固件、复位或烧录。开始时比赛与路线均空闲；上轮原生标定测角已通过，但SAVE读回失败仍使control_ready=0。确认四轮新鲜零速后，沿用用户此前“重新验证，通过后继续测试”的授权，仅执行一次imu verify：51个样本、完整5000 ms，drift_dps=0、rms_deg=0、i2c_errors=0，verified=1、control_ready=1。保存持久性仍未验证，该静止验证不能证明上轮SAVE成功。

原点无效，故在空闲状态建立chassis origin 0 0 0，仅作为本次局部测试参考。随后只发送一次chassis test -1000 0 500 cosine，动作id=1。设备最终报告state=3、elapsed_ms=5985、peak_mm_s=560.534、error_mm=9.261、stop_ms=185、stop_confirmed=1；最后一帧四轮新鲜转速均为0，总线tx.error=0。峰值为四轮反馈推算，约比目标高12.1%；位置误差也为轮速/位置反馈定位值，未用外部尺量确认。

无线串口存在缺字，部分帧虽能解析JSON但数组长度已损坏，分析时另按字段形状筛选，仅保留6帧有效运动/终态快照。有效样本中速度指令由500逐步降至171.377、47.643、35.286、12.950 mm/s，最终归零；未观察到提前归零后重新提速。采样稀疏，不能据此证明每个控制周期连续或宣布实物顿挫已经消除；末端轮速仍有波动，整场验收尚未完成。

日志：`.embeddedskills/logs/serial/cosine-test--1000-0-500-20261015-092822/`，含原始events.jsonl、transcript.txt、result.json、validated-motion-samples.csv及analysis.json。验证日志：`.embeddedskills/logs/serial/imu-verify-cosine-20261015-092802/`。09:26预检查因control_ready=0退出，未发送运动，日志另行保留。
