doinbest/Yachiyo/xjx/模版搭建/docs/开发记录/2026-10-15-底盘四轮分配与左偏重心打滑分析.md

# 底盘四轮分配、航向保持与左偏重心打滑分析

## 本轮边界与实车事实

用户确认刚下载的时间对齐版本仍未走得很直，要求Review四轮分配、IMU航向保持，并按30×30 cm、重心偏左做高速打滑预估。对于相对上轮的左右摆变化，用户另答“没注意”。本轮只审查、读取已保存日志、查询原始研究资料及做主机仿真；没有再发送运动、标定、复位或烧录。

用户不知道总重、重心偏移、高度与地面参数，因此以下接触模型均为条件分析，不是测出了本车重心、摩擦系数或实际摆幅。部署固件源码SHA256与`.embeddedskills/wheel-alignment/manifest.json`一致。

刚完成的后退任务：2000 mm、1000 mm/s、cosine，仅发送一次，7.078秒到点，反馈位置误差9.488 mm，158 ms停稳确认，最终四轮0 RPM；实际直线稳定性未通过。1250.093 mm/s为异步轮速估算峰值，不能单独证明车体真实超速或轮地打滑。原始证据及下载状态见[时间对齐修复记录](2026-10-15-四轮反馈时间对齐修复.md)。

## 代码审查发现

| 项目 | 源码事实 | 判断与影响 |
|---|---|---|
| 四轮逆解 | `u=[vx-vy-kω, vx+vy-kω, vx-vy+kω, vx+vy+kω]`，顺序FL/RL/RR/FR，`k=(轴距+轮距)/2`；RPM按`60/(πD)`换算 | 未发现这一层的明显公式、单位或正反向符号错误；物理轮序/滚子安装仍不能仅凭源码验证。 |
| 正反向协议 | 逻辑向前为正，发送/反馈按0/0/1/1映射电机方向；F6缓存四轮后FF同步 | 一致；没有发现普通调速四轮各自立即执行。 |
| 纯直线目标 | 80 mm轮径、传动比1：300/500/1000 mm/s分别约72/119/239整数RPM | 重心左偏不应直接改成左右轮不同的固定速度。载荷改变所需推力/扭矩，不改变理想直行的相同轮速条件。 |
| 航向保持 | `ω=clip(0.02×角度误差[°], ±0.15)` rad/s，新IMU更新后计算；不是含I/D的PID | 最高纠偏约8.59°/s。误差1°给0.02 rad/s；它控制角度，不直接观测纯横向滑移。不能仅因“不直”就加大P或加I。 |
| 地图补偿 | `distance_command`先按X/Y目标误差取方向和限速，再按当前地图yaw转为车体系速度，另叠加航向P | 源码已经有车头偏角对应的横向补偿，不能用“完全没补偿车头偏角”解释本车。补偿需要轮地接触真正实现侧向分量。 |
| 横向位置反馈 | 位置来自轮编码器与IMU融合，当前已对齐时间；没有独立地面横向位置观测 | 时间对齐消除了一个错误来源，仍不能消除打滑造成的里程计盲区。车头角度正确、编码器估计Y近零，都不能证明实际走直。 |
| 加速度约束 | linear限平移向量300 mm/s²；cosine K200对应T=0.4 s，1000 mm/s名义峰值3927 mm/s²；驱动档位0 | 没有根据轻载轮载荷/摩擦限制附着需求，也没有独立的逐轮附着/扭矩分配。现有3000 RPM上限是协议/转速约束，不是轮地附着约束。 |
| 角速度变化 | 平移向量有变化率限制，直行航向P输出没有对应的角加速度变化率限制 | 航向误差快速变化时，`k×Δω/Δt`还会叠加各轮加速度。理论±0.15在20 ms反向时可额外产生3375 mm/s²的单轮线加速度；这是最坏阶跃计算，不是本次实测。 |
| 几何 | 源码轴距210 mm、轮距240 mm、轮径80 mm；现行实物记录前后轮心距200 mm，轮径/轮距仍近似 | 30×30 cm是外包络，不应直接代入轴距/轮距。仅210→200使旋转力臂225→220 mm，约2.3%，不宜据此解释所有横摆；各轮有效半径差尚需区分。 |
| 整数RPM | F6为整数RPM，80 mm轮1 RPM约4.189 mm/s | 小角度纠偏呈台阶，阈值随行驶RPM舍入相位变化；可能造成小幅残差/极限环，不足以单凭源码解释明显大幅横摆。 |

主要位置：[运动学](../../Code/template/App/chassis_model.c)、[运动与航向控制](../../Code/template/App/chassis_motion.c)、[参数](../../Code/template/App/chassis_config.h)、[同步与反馈](../../Code/template/App/mecanum_chassis.c)、[位置观察器](../../Code/template/App/chassis_observer.c)。

当前控制链是“X/Y位置P与曲线限速→地图到车体系变换→叠加航向P→麦轮逆解→四轮F6/FF→驱动内环→轮地接触”；没有在MCU额外做四轮实际转速之间的速度PID同步环。驱动器自己的闭环不能保证轮子不相对地面滑动。

## 本轮日志能确认什么

5条快照仅2条同时满足完整状态结构；另1条虽可解析JSON，任务对象却混入了反馈字段、缺少target/applied/feedback，不能作为完整样本。完整快照都在后段，不能还原高速中段最大横偏或航向误差。新整理文件位于原串口日志目录的`wheel-target-following.csv`、`snapshot-validation.json`。

批次91的四轮查询在9 ms内，目标发送后9～18 ms读取：目标逻辑RPM为-103/-117/-98/-111，实际反馈为-108/-127/-65/-57。这个样本确认同批目标下存在瞬态轮速差；不能直接认定稳定跟随误差或某驱动坏了。后续批次133，目标-36/-38/-35/-37、反馈-33/-38/-31/-35，差异明显较小。还需要分辨驱动动态、真实附着和航向输出变化。

后段command积分位姿Y约325 mm，feedback估计Y约1 mm。前者同时使用指令角速度积分形成自己的角度，不是实际横移，也不能直接代替已发送车体系vy；不能据325 mm宣称测出了车身侧滑量。

## 模型一：速度分配与航向执行敏感性

速度逆解采用源码轮心几何210×240 mm，力学模型采用现行实物记录200 mm轴距、暂按240 mm轮距，避免把车体外框当轮心矩形。

航向P在理想角速度跟随下的等效增益为`0.02×180/π=1.146 s⁻¹`，时间常数约0.873秒。它最终使角度误差减小，但实际横向偏移不会因此自动归零。

为了尊重源码已有地图补偿，引入侧向执行比例η：请求`vx_body=V cosψ, vy_body=-V sinψ`，实际只实现η倍侧向分量时，地图侧速为`(1-η)V sinψ cosψ`。η=1时这个理想模型侧移为0；η=0.5时补偿只实现一半。初始角误差3°、V=1000 mm/s、沿现有P规律回正，3秒累积条件横偏约22 mm（η=0.5）或44 mm（η=0）。这些是执行敏感性例子，η和初始误差没有在本车标定，不能当实车预测。

同样，若驱动存在80 ms一阶滞后，3927 mm/s²峰值处的近似瞬态轮速误差可达75 RPM量级；这说明几十RPM瞬态差不必然是故障。80 ms只是假设，源码0.25秒响应预算不是测出的驱动时间常数。一阶模型不会自行产生超过全程最高目标的真实速度，不能用它单独解释1250 mm/s峰值。

航向与量化敏感性

## 模型二：左偏重心、载荷转移与附着边界

采用平地、四轮均接触、四角等效垂向刚度相同、理想45°滚子的简化模型。刚性四点支撑本身不能唯一决定各轮载荷；这里明确指定等效支撑假设，实际可能因车架扭曲、弹性和地面不平而不同。

重心向左偏e、离地h，轮心前后距L、左右距B，加速度ax向前为正，各轮法向载荷比例为：

`Ni/(mg) = 1/4 × [1 + sy×2e/B − sx×2axh/(gL)]`

其中sx为前+1/后−1，sy为左+1/右−1。转向或侧向加速时还应计侧向载荷转移，本表只考察直行起停。

典型假设e=40 mm、h=100 mm、L=200 mm、B=240 mm：静止左侧承担66.7%、右侧33.3%。向前以3927 mm/s²加速时，ID1/2/3/4约承担23.3%/43.3%/26.7%/6.7%；右前轮大幅减载。前进制动时轻载角转为右后；后退加速时是右后，后退制动时是右前。它可能使加速/制动的偏航扰动反向，不保证实际一定左右摆。

理想45°滚子下，轮的纵向广义驱动力近似满足`|fi|≤μNi/√2`。本模型未把工业文献中的具体地面摩擦系数当作本车实测值。该接触方向与附着条件参考[Galati等，Scientific Reports，2022](https://www.nature.com/articles/s41598-022-24270-x)；载荷、接触各向异性和实际轨迹的关系另参考[Manzl等，Mechanism and Machine Theory，2024](https://doi.org/10.1016/j.mechmachtheory.2023.105548)。

需要区分三种“配力”，它们不是给左右轮随意改转速：

1. 等轮驱动力：最轻轮先超附着；而且左偏重心下会有`e×ma`偏航力矩，不能把它直接当作配平后的直行方案。驱动速度环可能自行形成不同驱动力抵消，所以“左偏”不等于必然跑斜。
2. 配平重心力矩的最小范数驱动力：左侧各轮为`ma/4×(1+e/k)`，右侧为`ma/4×(1−e/k)`，k=(L+B)/2；同时满足纵向合力ma、横向合力0、绕重心力矩0。
3. 允许四轮在不改变上述合力/力矩的零空间中进一步优化驱动力：在各轮摩擦界内求可行性，作为同一简化模型内的乐观上界。本车速度模式没有显式实现这样的扭矩优化，不把该上界当可用实测能力。

e=40 mm、h=100 mm、μ=0.5时，等轮努力的轻轮筛查约1708 mm/s²；配平最小范数边界约1973 mm/s²；进一步理想配力的可行上限约2826 mm/s²。总重在这些归一化附着比例中约掉，但电机扭矩、惯量和高转速余量仍依赖总重，不能据此说重量不重要。

| 目标速度 | 当前T=0.4 s名义峰值加速度 | 与上述典型假设模型比较 |
|---|---:|---|
| 300 mm/s | 1178 mm/s² | 低于上述边界，仍不代表所有地面都能通过 |
| 500 mm/s | 1963 mm/s² | 接近最小范数配力边界，轻轮和地面变化可能使余量不足 |
| 1000 mm/s | 3927 mm/s² | 超过这一假设中的理想配力可行上限，值得优先排查附着/加速度 |

加速度与载荷模型

## 模型三：参数范围与速度方案

扫描左偏0/20/40/60 mm、高度60/100/140 mm、μ=0.3/0.5/0.7，共36个条件。除了几何基准，重心、摩擦和支撑刚度均未经实测。本区间内最小范数配力的最低边界约1016 mm/s²；这不是所有可能地面的保证值。

保持左偏40 mm、高100 mm，仅改变假设μ：

| μ | 最小范数配力边界 | 1000 mm/s对应的T临界值（未留余量） |
|---|---:|---:|
| 0.3 | 1347 mm/s² | 1.167 s |
| 0.5 | 1973 mm/s² | 0.796 s |
| 0.7 | 2465 mm/s² | 0.637 s |

因此K400/T=0.8 s不是通用答案：典型μ=0.5条件下1000 mm/s只刚接近边界，μ=0.3时仍过快。可把1000 mm/s的T=1.5～2.0 s（K750～1000）作为后续候选范围，峰值约1047～785 mm/s²；这是仿真候选，不是本次参数修改或附着保证。500 mm/s、T=1.0 s的峰值约785 mm/s²，可用于更温和的比较。

附着参数敏感性

还需同步考虑任务段长。现行余弦控制的有效位置增益是`min(2.5,1/(2delay+T))`，不是只把T放大就完成设计。按delay=0.30秒举例，要在到点收敛限速前达到V，理想必要距离近似`D≥VT/2+V(2delay+T)`：1000 mm/s、T=1.0/1.5/2.0 s分别约2.1/2.85/3.6 m，实际还受反馈、短段降峰和驱动影响。两米场地不能承诺长T下达到1000。

现行linear300在两米起停，理想无延迟三角速度峰值也仅约775 mm/s；加0.3秒响应预算约730 mm/s量级。要充分达到1000并停下，至少约3.33 m，计上述响应预算约3.63 m。两米linear对照适合验证“温和加速度下是否走直”，不能冒充1000 mm/s匀速验收。500 mm/s下两米更适合作完整起停对照。

## 建议顺序与未完成项

- 先保持航向P参数，做相同方向/距离的温和加速度对照，区分加速度附着问题与即使匀速也存在的轮径/安装/偏载问题；这只是后续测试建议，本轮没有发起运动。
- 补实测轮心几何、四轮静态载荷比例和地面条件。四轮称重需保持其余轮同高度支撑，才能估计左右载荷比例；未知值不从本模型反推成实物事实。
- 中段记录应优先覆盖同批已发送四轮目标、查询/回复时刻、当前IMU角与航向输出、位置组共同时间。当前长快照损坏使证据不够，不能继续凭终点位置判断走直。
- 若角度基本稳定而车身横移，优先处理附着与独立横向观测；若角度本身振荡，再核对轮地角速度响应、延迟和航向输出变化率，才判断是否需要调整P或加入角速度阻尼。当前没有足够数据支持直接增加I/D。
- 本次未做扭矩分配、打滑观测、参数修改或固件修复。时间对齐版本已下载，但高速直线效果仍未通过，[P005](../待解决问题.md#p005--高速直线稳定性未通过及偏载附着待核查)保留根因未定状态。

## 可复现产物与验证

运行`python Code/tools/chassis_slip_review.py`；依赖NumPy/Matplotlib。当前系统旧Matplotlib与NumPy2不兼容，本次仅在忽略目录`high-speed-left-cg/deps`放置NumPy1.26用于分析进程，没有修改全局Python环境。模型脚本、CSV、summary.json、PNG及SVG分别保存；数值校验覆盖载荷总和/力矩、驱动力合力与力矩、零空间可行性及239 RPM纯直线基准。图已渲染并检查。

`.embeddedskills/analysis/high-speed-left-cg/traction-grid.csv`保存36个条件，`summary.json`保存中心案例与单位；这些本地分析产物未加入固件工程，不需要编译/烧录。本轮只读核对已部署源码哈希未变化，未改原始日志、原始失败测试或历史审查结论。
