doinbest/Yachiyo/xjx/模版搭建/docs/开发记录/2026-10-15-底盘测试直接启动与按需准备.md

# 底盘测试直接启动与按需准备

## 要求与实现

用户要求底盘测试不要每次运动前重复检测，改为展示状态，有故障时再处理。本轮仅修改网页流程及现行文档，未改固件、Python服务或设备参数。

- “开始测试”只校验表单并提交一次`chassis test`，不先查询任务/路线/比赛/IMU，不申请准备租约，不开关反馈或设置原点。固件原有实时准入与故障、停车判定保留。
- 新增状态区：连接、总线、IMU、定位反馈、设备任务与最近拒绝。状态来自收到的实际报文，并显示回报年龄；未知时明确未读取，不把缓存作为当前运动许可。未单独读取IMU时可展示底盘任务回报的航向有效标志，完整验证资格仅按IMU回报展示。
- “查询状态”只读`chassis task`与`imu status`，不修改反馈配置或定位参考。
- “准备/恢复测试状态”显式执行原有准备流程：核对任务占用、IMU、四轮新鲜静止反馈，开启四轮反馈，仅缺少参考时建立本地(0,0,0°)并读回；已有有效参考保留。准备完成不自动发车，不自动重置IMU或恢复比赛。
- 总线停止锁定沿用底部解除/恢复入口；IMU未验证沿用系统页。设备拒绝显示具体原因，不自动修复、不自动重发运动。
- 受理后仍按动作编号读取进度和真实停车结果。停止、断线和设备重启取消待办；重连保持被动，下一次运动需人工再次点击。

## 软件与界面验证

- 先添加“开始只发送一条运动、不申请准备租约”的回归，旧实现因发送了完整准备序列而失败；实现后通过。
- 单段测试生命周期22项通过：直接启动、连续两轮不重复准备、参数保留、显式查询只读、缓存年龄/断线作废、设备拒绝无自动修复或重发、显式准备保留有效参考、短时反馈恢复、暂停比赛不被准备接管、准备/受理等待期间停止和断线等。
- 网页完整回归结果见`.embeddedskills/direct-chassis-test/web-all.log`；语法及按CRLF约定的差异检查通过。
- 使用内置浏览器打开本地页面并切换底盘，确认“开始测试”、独立查询/准备/停止按钮和最近回报状态可见；检查无页面脚本错误。仅浏览、刷新和接收现有服务事件，未点击查询、准备、运动、停车、复位或其他设备操作按钮；收到的其他页面/现场运动报文不计为本轮发车验收。

## 文档与交付状态

已同步AGENTS、主车README、上位机README、地图与雷达、连接与恢复、系统与底盘协议；历史自动准备记录保留当时事实。主车README同时补齐现有可选曲线周期参数的接口写法。

刷新现有网页即可使用。本轮未编译、烧录或发送实车命令，已有固件保持；当前改动不要求重启本地服务。操作效率与现场连续测试仍由用户验收。
