doinbest/Yachiyo/xjx/模版搭建/docs/开发记录/2026-10-15-直线航向PD试验版.md

# 直线航向PD试验版

## 用户确认与范围

用户确认参考GongXun2025思路实施更积极的PD：P0.10、I0、D0.01、D滤波40 ms；随后要求考虑1000 mm/s测试，允许进一步提高角速度限幅。本轮选择直线±0.50 rad/s（约28.65°/s），不是前一轮候选±0.30。1000 mm/s、80 mm直驱名义约239 RPM；0.50 rad/s在当前210/240 mm轮心几何下增加各轮约±26.86 RPM角速度分量，左减右加或相反，不表示实际附着能力。

## 实现

- `chassis_config.h`维护PD与滤波值，未改linear300、cosine K200、驱动档位、路线速度、IMU资格、停车与总线恢复规则。
- `chassis_motion.c`在已有heading/hold/MoveTo直线控制中使用`omega=0.10*error_deg-0.01*filtered_yaw_rate_deg_s`，再按±0.50 rad/s限幅。没有积分项，没有新增0.5°航向死区。
- D对实际航向测量求导，依据真实`heading_sample_tick`而非控制循环/串口消费时刻。角度差按±180°处理；低通采用`alpha=dt/(40ms+dt)`。同一样本不重复更新D，零时间样本不除零。沿用原IMU数据资格及gap条件，未新增停车条件。
- 新任务播种当前位置、清空滤波速度；位置补偿续段也清空旧D。目标变化不产生误差微分冲击，IMU失效按既有处理作废导数基线。
- 原地转向使用独立`CHASSIS_TURN_KP=0.02`，保留已有速度、起停、精转与停稳确认；连续弯道`path_command`的独立算法保留。普通显式角速度命令不套PD。
- 参考[作者航向参数](https://github.com/zpclyn/GongXun2025/blob/19cb6a69ba3580465f58ab9f204dbaf33878c969/控制代码/CarBody/Chassis_PID.c)和[航向调用](https://github.com/zpclyn/GongXun2025/blob/19cb6a69ba3580465f58ab9f204dbaf33878c969/控制代码/CarBody/Chassis.c)理解PD用途；原项目未见根许可证，本轮没有复制其实现。对方D=3乘相邻调用误差差，本车D0.01按每秒测量变化率定义，不能将其视为等值换算。

## 软件验证

先添加`chassis_heading_pd_test.c`，旧控制在首个P输出检查失败，见`.embeddedskills/heading-pd/red.log`；接入PD后通过，见`green.log`。

16项相关主机测试通过：heading PD、motion、heading/map同步、model、stop、distance、cosine distance、cosine continuity、curve motion、turn、localization、observer、telemetry、mission stop feedback、route pause feedback及真实异步总线heading。结果保存在`.embeddedskills/heading-pd/tests/results.json`及逐项日志。

PD专项覆盖1000 mm/s目标与双向限幅、实际变化率阻尼正反号、40 ms滤波、重复样本不重滤波、真实采样时间与前台延后消费、±180°和毫秒回绕、停止/重启导数清空、零时差样本及原地转向P不变。原motion及mecanum heading测试按新PD行为更新旧0.04/0.15期望，未删除原测例。主机测试不是地面附着、轮速响应或整场比赛验收。

## 当前文档同步

同步AGENTS、主车README、底盘协议、地图与雷达操作手册及硬件运行基线；历史P控制审查与打滑估算保留当时事实。本版仍待实车确认直线效果，P005不据软件通过关闭。

## 构建、下载与实车

Keil `template.uvprojx` / Target `template` 构建通过，0 errors/0 warnings；ROM317152字节，RW+ZI192896字节。本次重新连接DAP 7b168f48 / SWD100 kHz，读回CPUID410fc241、F407设备ID413、Flash1024 KiB；未凭USB枚举或旧记录假定链路。固件与源文件SHA256见`.embeddedskills/heading-pd/manifest.json`。下载状态：2026-10-15T11:44:10+08:00，DAP烧录并校验成功；HEX SHA256=ebd263ab13d150daabe305e9175637dc909c8859bb942e709fa721bee852eb10，结果见`.embeddedskills/heading-pd/flash-result.json`与`flash.log`。未发送实车运动指令，尚无本版实车结论。

## 下载后首轮前进测试

用户另行要求“请测试，向前走”，沿用此前2000 mm、1000 mm/s、cosine参数。复用COM23/115200本地串口服务，IMU verified/control_ready/normal_mode均1，没有重新标定/归零。开启四轮反馈后确认新的零速位置组；本次烧录后origin_valid=0，显式建立本地(0,0,0)测试参考。

运行中服务仍为旧准备白名单，准备租约内的本地原点请求被HTTP400拒绝，尚未送至MCU；保留第一次准备失败日志。随后释放租约，通过既有普通手动接口设置原点并等待MCU回复，再重新获取准备租约核验。未重启服务、复位或再次烧录，未因失败重放运动。

实际只发送一次`chassis test 2000 0 1000 cosine`，id=1。结果state=3/feedback_arrived，elapsed_ms=6656，error_mm=9.466，stop_ms=136，stop_confirmed=1；最终四轮0 RPM、新鲜反馈，总线locked=0/error=0。最终反馈XY=1990.436,0.155 mm，航向=-0.082°。

峰值估算1291.694 mm/s仍来自异步轮速缓存，不是地面真实速度证据。采到3个结构完整的运行中task样本，yaw=[-1.4, 0.01, -0.08]°、omega=[0.3995, 0.0035, 0.0121] rad/s，仅代表采到的时刻，不保证覆盖全过程峰值；实际走直/横摆效果等待用户现场反馈，P005保持未验收。

日志：`.embeddedskills/logs/serial/heading-pd-forward2000-20261015-114908`，含events.jsonl、transcript.txt、metadata.json、result.json、analysis.json及解析样本；已核对运动TX恰好一次。首次未发运动的准备日志目录为`.embeddedskills/logs/serial/heading-pd-forward2000-20261015-114807/`。

## 用户视频反馈与晚间手动测试证据

用户提供`38b69e27984ab90b165fcd77046f3579.mp4`，1280×720、30 fps、约5.57秒，确认行驶中段有明显左右晃动。逐帧查看可见移动中车身姿态变化，不能只按终点偏角评价走直；手持视角、透视和未同步时间限制下，不从图像直接给出精确物理偏角或侧滑毫米值。

本轮仅提取视频帧并GET读取现有本地串口服务日志；没有发任何MCU命令、复位、修改参数或烧录。日志中20:42～20:44存在用户手动执行的4次前后各2000 mm、1000 mm/s、cosine测试，不是本轮自动发出的运动。

最新20:44:00前进测试id4，目标模块角约0.04°。采到的运行样本：20:44:01.887航向−6.51°、误差+6.55°、输出+0.5000 rad/s；20:44:03.044航向+2.19°、误差−2.15°、输出−0.2170 rad/s；后段恢复约−0.08°。这证明已有航向方向反转/过冲，不是仅凭视频怀疑纯横向滑移；采样约1秒一次，不能还原真正峰值、频率或D项分量。视频本身没有与MCU时间严格对齐，不将某帧强配某条报文。最终state3、6728 ms、轮式位置误差8.862 mm、停稳确认208 ms，仍不代表走直通过。

在−6.51°样本里，同条报文的共同时间定位角为+0.497°、反馈年龄128 ms；最新角与旧时刻融合角相差约7°。这两个角本来就属于不同测量时刻，不是直接证明IMU或插值算法算错，但说明高速段的动态及反馈滞后需要重点核查。当前位置规划、实时航向PD、驱动响应及轮地附着之间可能互相影响。

P0.10/D0.01与±0.50限幅这版未解决晃动。现有证据支持先停止放大增益/限幅，重点检查航向误差、实际角速度、P/D分量、下发批次和轮速的时间关系；较大P/限幅与延迟可能放大反摆，但不能仅凭低频日志证明D过大、P单独致振或根因全是打滑。后续参数收敛与任何高频遥测改动需另行实施验证，不凭本视频自动烧录。

分析产物：`.embeddedskills/analysis/pd-video-20261015/`，保存原服务事件快照、四轮次航向样本、最新轮次详细报文、4 fps接触表和1.75/2.25/2.75秒原分辨率帧。

## 航向响应延迟离线估算

用户要求“估算一下”，本轮只读源码、读取已保存样本，并运行独立Python分析；未发送MCU命令、改固件、复位或烧录。分析脚本、675组CSV（每控制器135组）、JSON、PNG和SVG位于`.embeddedskills/analysis/heading-pd-estimate/`。原始假设与完整数值见summary.json，曲线已渲染检查。

### 从日志估算纠偏量级

当前输出上限0.50 rad/s=28.65°/s，当前几何对应每轮±26.86 RPM。若车身理想跟随该上限，100 ms可转2.86°；这只是角速度积分尺度，不是本车实际响应。若已经以10～25°/s转动，单100 ms响应延迟内即可再转1～2.5°，还未计驱动减速；不能由此反推本车延迟就是100 ms。

以第2轮未饱和样本e=0.86°、omega=0.3179 rad/s估算，若打印角误差与输出属于同一控制样本，P项约0.086 rad/s，剩余D项约+0.2319 rad/s（约为P的2.7倍），相当于滤波测量转速约−23.19°/s。其他样本也给出约25～27°/s量级。这里并无真实P/D分量遥测；当前打印角可能比缓存控制输出新至多一个控制周期，不能把这些残差当作精确D实测。它提示D与时序也要检查，不能仅按P小来判断。

1000 mm/s、偏角6.55°时，地图方向补偿请求的车体系侧向速度约114 mm/s。源码已经进行该补偿；若侧向实际执行比例仅0.5（未经实测），地图残余横速约56.7 mm/s，200 ms约11.3 mm。这里只展示偏航和附着不足如何共同放大横移，不宣称测出实际侧滑。

### 延迟模型与比较

模型为`tau*dq/dt+q=gain*u(t-L)`、`dpsi/dt=q`，实际航向20 ms采样控制、D按dt/(40ms+dt)低通、带各自输出限幅；积分1 ms，初始偏角6.55°。它只模拟航向执行链，没有摩擦、偏载、轮速量化或X/Y位置环，不是整车1000 mm/s轨迹仿真；速度只用于上文横向影响换算。控制器参数与源码单位一致。

扫描tau=40/80/150 ms、命令到响应纯延迟L=20/60/100/140/180 ms、增益0.7/1.0/1.3、初始角速度−20/0/+20°/s。均为敏感性假设，未从低频日志辨识本车tau、L或增益；尤其不能把定位feedback_age_ms直接当作航向控制延迟。

中心示例固定tau80 ms、gain1、初始角速度0，比较从+6.55°回正后反向过冲（°）：

| 纯延迟 | 当前P0.10/D0.01/限幅0.50 | 候选A P0.05/D0.003/限幅0.25 | 候选B P0.06/D0.005/限幅0.30 |
|---|---:|---:|---:|
| 60 ms | 0.00 | 0.00 | 0.00 |
| 100 ms | 0.24 | 0.00 | 0.00 |
| 140 ms | 1.32 | 0.10 | 0.10 |
| 180 ms | 2.46 | 0.51 | 0.68 |

当前PD在100 ms中心假设下可快速收敛，180 ms下4秒内仍未进入持续±0.3°；说明当前参数对延迟变化更敏感，不能只按一个理想小延迟模型认定实车会稳定。在人为选定的135组中，当前PD有27组末1秒峰峰值>0.6°，候选A/B为0；这些是有限模型案例计数，不是实车成功率、稳定性证明或普适参数。单独删除D、保留P0.10和限幅0.50时反摆更严重，因此不支持直接认定D无用或把D清零。

假设响应延迟下的航向变化

### 下一轮候选，不是已实施修改

优先候选A：P0.05、I0、D0.003、40 ms滤波、±0.25 rad/s限幅。相较当前，P减半、D为0.3倍、最大纠偏减半；仍比原P0.02的比例纠偏强2.5倍，限幅也高于原0.15。每轮最大角速度修正约13.43 RPM，1000 mm/s名义239 RPM下约5.6%。候选B保留更快纠偏，但首轮优先A收敛。

保持平移模式与K不变可作控制器对照，但不能据本模型排除平移加速度、轮地附着或四轮动态问题。后续应补新鲜IMU采样时间、测量角速度、P/D分量、最终角速度及实际应用批次的紧凑日志，再判断是否需要角速度变化率约束。当前仍部署P0.10/D0.01/±0.50，未把候选参数写入固件。

数值检查包含零偏角零扰动不自行产生运动、正负镜像、旧P零延迟回正；图表仅用于上述假设比较。

## 用户提供旧P版本对照后的诊断调整

用户指出最初P0.02时，中途晃动与当前P0.10/D0.01版本差不多。这是重要的实车对照：不再把“PD增益过大/过小”作为首要根因，也不把上节延迟模型当成已经验证的根因。参数可能改变纠偏过程，但当前证据不支持继续靠换一组增益解决共同问题。上节候选A仅保留为分析建议，暂不实施。

源码复查确认两版共用：X/Y位置误差决定地图平移方向，实时IMU yaw再把地图速度变换为车体系vx/vy，最后另叠加航向角速度。因此，即使航向P较小，也并非四轮接近固定等速；车头变化和轮式横向位置误差均可产生横向速度请求。1000 mm/s、6.55°偏角时，单坐标变换的侧向分量约114 mm/s，对应麦轮对角组每轮约27.2 RPM的加减分量，不能把该量误当作航向P输出或本轮已发送实测值。

后续优先区分：同批四轮固定目标下的真实跟随/机械接触；地图到车体系补偿是否依据正确且同一时间基准的航向；位置外环是否追逐滞后或受滑移影响的Y估计；调速批次间隔与反馈轮询是否形成变化节奏。原始异步四轮缓存、峰值估算和终点姿态均不能替代这些证据。

有意义的实车分层对照为：固定车体系速度且vy=0/omega=0；随后只加入航向保持；再加入完整位置闭环。每层明确速度/距离、停车方式并分别验收，不能直接把“只开航向”的模式与还含地图侧向补偿的模式混淆。本轮没有发起上述运动，没有修改参数、保护或固件；PD和位移曲线保持已下载版本。
