doinbest/Yachiyo/xjx/模版搭建/docs/开发记录/2026-10-15-码垛前方黑线航向.md

# 码垛前方黑线航向

日期：2026-10-15。

用户确认黑线位于色环前方，要求沿用色环校准的角度参考、使用不同协议，并最终明确同步修改Python、STM32和网页。附件内容只作为源码输入，不作为额外操作指令。

## 实现与来源

- 本地 `Code/orange_pi/combined_color_digit_ring.py` 以最新附件 `combined_color_digit_ring(1).py` 为基准更新；附件SHA256为 `D2B148E33D04820A8772553A0CDB138B5764847001460C97F1670ABB5449149C`。旧仓库版本由Git追溯，不在活动工程复制源码备份；`vision.py`和原附件未修改。
- 新附件已经包含0E。对照附件AST，本次只修改三个定义：`_measure_black_line_band_support`、`_extract_pile_line`、`PileLinePoseDetector`；颜色、编号环、色环检测及USB实现保持附件版本。颜色准心(357,324)、编号环/姿态准心(367,316)按附件保留，未改回历史参数。
- 色环请求/回复目标0D、码垛前方黑线0E；仍为4字节请求和14字节回复。0E前两槽为0，角度为有符号0.01°，STOP仅诊断。黑线与色环共用图像水平0°、右端向下为正的参考，未臆造透视补偿或实测比例。
- 黑线采用浮点拟合方向算角；法向剖面识别完整黑带和两侧亮背景，支持不同画面宽度。每帧重新核验稳定窗口；漏检缓存只用于画面提示，线上Valid=0，重获后三帧重新确认。
- Camera新增独立来源请求、快照Target和目标匹配；0D/0E不能互相充当证据或进入普通DX/DY控制。像素日志POSE增加c=13/14。
- 比赛视觉航向开关及每次进站一次的时机保留。加工区两批、暂存第一批使用色环；暂存第二批码垛使用黑线，换环不重复启动。暂停/恢复保留来源，仍按原采样窗口重取证据。
- 黑线映射使用独立RAM参数head_line_zero/head_line_gain，默认NAN，不借用暂存色环零点/增益；观察高度、Base参考失效及机械尺度改变时按现有范围撤销对应资格。黑线入口限定暂存区，沿用暂存可转范围；未标定时普通核验仅观测。
- 网页独立测试增加参照选择；选黑线自动选择暂存区，仅编辑不发送指令。设备回传heading_source=ring|line，独立页和比赛页按设备来源显示；参数页新增黑线零点/比例。
- 独立入口：`grab heading temp 5 line`；显式单次试转：`grab heading angle temp -1 5 line`。不附加来源的旧入口保持色环0D。
- 未新增C模块或改动Keil工程清单，未修改EIDE、引脚、IOC、HAL、取放流程、车体地图目标或IMU测角方向。

## 验证

1. Python专项8项通过：独立0D/0E正负角报文、分包/合包/重复目标、共用参考角、稳定后抖动与恢复、漏检无效和重新确认、3/7/11/21像素合成黑带、空白/全黑/大阴影拒绝、浮点小角输出。测试先在附件复现6处失败，再验证修改版通过；未运行main、未打开相机或串口。日志 `.embeddedskills/pile-line-python-20261015.log`。
2. 固件5组专项通过：camera_usb_test、station_heading_test、grab_heading_source_test、contest_heading_test、grab_route_test。覆盖来源隔离、角度解析、标定独立性、参考失效、第二批自动选黑线、旧入口兼容；保留原STOP独立、五秒、暂停重获及新鲜反馈测试。日志 `.embeddedskills/pile-line-focused-20261015.log`。
3. 网页全量637/637通过。日志 `.embeddedskills/pile-line-web-20261015.log`。
4. Keil主车Target template构建成功，0错误、0警告。产物 `Code/template/MDK-ARM/template/template.hex`、`template.axf`；日志 `.embeddedskills/pile-line-keil-20261015.log` 及 `.embeddedskills/build/pile-line-20261015/template-template-build.log`。
5. 全量固件回归未通过，不能表述为整套软件通过。主流程通过两批12入仓/12放置的生产GrabTask集成后，在grab_mission_pause_test中止，定位到grab_task_test.c:386的阶段等待断言。移除本次GrabTask与参数定义的黑线改动后，在隔离的主机测试副本复现相同断言；不是本次黑线新增行为。证据 `.embeddedskills/pile-line-baseline-result-20261015.log`。
6. 随后继续余下测试，仍失败的测试/场景为grab_pose_test、grab_track_task_test、motor_bus_test、turntable_test、turntable_bus_fairness_test、motor_bus_startup_test（含其异常场景）、mecanum_bus_test、mechanical_arm_emergency_chain_test（含first_tx_error和单轴场景）、motor_bus_circular_rx_test。余下62条顶层测试语句成功，12条测试/场景语句失败，不将语句数冒充用例数。完整位置和输出见 `.embeddedskills/pile-line-firmware-20261015.log`、`.embeddedskills/pile-line-firmware-remainder-20261015.log`。总线文件已有其他未提交修改，本轮未扩展修复这些逻辑，其余失败的起因尚未逐项证明。
7. 回归过程中同步三项过时测试夹具：网页默认追踪保持改为现行0ms；比赛PoseStart模拟真实busy返回；二维码离站断言采用现行立即恢复路线语义。仅更新测试，不改相关生产行为。

## 下载、部署和实车状态

- 沿用已确认的CMSIS-DAP序列号7b168f48、SWD、stm32f4x、1000kHz和工程mission-dap.cfg，当前probe成功；日志 `.embeddedskills/pile-line-dap-probe-20261015.log`。
- 全量固件回归仍有明确失败，本轮保留已构建产物，未烧录；不能把探测成功表述为下载校验成功。
- Python和网页已更新本地文件；未SSH、未切换香橙派服务、未部署远端视觉；刷新本地网页才加载本地改动。新固件尚未下载时不要把新网页入口视为旧固件已支持0E。
- 未发送实车运动/串口命令，未为测试复位目标；黑线视野、真实宽度、遮挡、透视零点、车体角映射和码垛连续执行尚未实车验收。

现行依据已同步AGENTS、比赛与取放约定、视觉协议、机械臂协议、视觉任务手册和对应README；历史设计及当时下载记录保留，不以本次源码覆盖既有实测事实。
