doinbest/Yachiyo/xjx/模版搭建/docs/开发记录/2026-10-15-编号环独立自动取仓放置.md

# 编号环独立自动取仓放置

用户要求编号环页在手动装料/下降外，增加选择料盘、按比赛流程自动取出并放到已对准环上的入口。新增grab ring take <slot>，STM32沿用已完成对准的环号，重新核验新鲜视觉/停稳并保存位置，复用比赛CarPick与AlignedPlace；无需盘内颜色/库存登记，z_proc_place共用比赛默认−140 mm，Base共用127.5°。不跑路、不扫码、不重置其他库存或串口屏。普通停止支持显式续接；终止撤销上下文。

回归先补网页命令测试，旧版本报未知命令；实现后生产联调覆盖三仓UNKNOWN库存、X恢复后下降、取仓后无视觉、抓取/下降/释放暂停及只松爪一次。完整固件主机回归通过；84项网页控制/交互/协议/比赛面板测试通过；最终生产联调另覆盖无地图原点及旧路线取消/旧motion故障不阻挡独立取放，三仓均完成、暂停续接不重复夹取/释放，未知颜色保留0。Keil template最终编译0错误0警告，相关差异空白检查通过。

完整回归首先发现新API在停车反馈模拟中缺少桩，补齐；另有加工取回测试硬编码旧2500 μs与当前2450 μs配置不一致，仅将断言改用ARM_GRIPPER_OPEN_PULSE_US，未改舵机配置，重跑通过。

DAP 7b168f48新鲜探测成功，SWD DPIDR 0x2ba01477、Cortex-M4目标检查成功；烧录未成功：skill后端报告erase_failed；沿用同一配置直接OpenOCD重试，目标识别device id=0x10076413、Flash 1024 KiB，进入Programming Started后报Failed to write memory at 0x200007b0、error writing to flash at address 0x08000000，返回1。未取得programmed/verified成功证据。重试前CPU PC=0xfffffffe、MSP=0xfffffffc，旧固件不可假定完整保留，须成功重烧后实车测试。原始日志.embeddedskills/tests/ring-take-flash-retry-20261015.log，失败JSON ring-take-flash-20261015.json。日志：.embeddedskills/tests/ring-take-full-20261015.log、ring-take-web-20261015.log、ring-take-final-build-20261015.json、ring-take-probe-20261015.json。未执行实车取放验收，全面审查待交付后独立进行。

## 交付后审查

按用户“审查”执行代码和现行文档检查，并安排独立只读审查。未发现本轮可复现的取放动作缺陷；重新核验同一环、实际X/Z快照、三仓取出、1/2号盘避让、无视觉放置、暂停续接及终止作废快照的链路保持。暂停比赛会拒绝独立流程，QR模块和串口屏没有被此入口写入。

发现并修复两处P2显示问题：protocol.mjs的ring_place描述分支原被非mission提前返回挡住，误显示“组合路线”；app.mjs的状态卡为独立取放显示无意义的“第—段 / 来源qr / none”。新增真实状态解析与真实渲染回归，分别先复现失败再修复通过；完成状态改为“取仓放置完成”，不再显示“两批任务结束”。

文档同步：新流程开口由残留2120 μs改为当前2450 μs；区分手动放置输入默认−150 mm和自动共享z_proc_place默认−140 mm；明确不改QR模块/串口屏，但独立父任务状态替代上次已结束比赛的状态副本。

本轮验证：网页控制/交互/协议/比赛面板86项通过；生产GrabTask+contest_mission集成回归通过（完整两批高/低位流程、独立三仓、无地图原点、陈旧路线错误、多阶段暂停续接且只夹取/释放一次）；相关差异空白检查通过。日志为.embeddedskills/tests/ring-take-review-web-20261015.log和ring-take-review-integration-20261015.log。本轮仅修改网页显示、测试和文档，未改固件运动代码，未重新编译、操作实车、复位或烧录。上一轮烧录失败仍未解除，固件实车部署及完整取放验收仍待完成。
