doinbest/Yachiyo/xjx/模版搭建/docs/开发记录/2026-10-16-HWT101原生标定保存确认失败核查.md

# HWT101原生标定保存确认失败核查

2026-10-16。用户补充HWT101静止时角度缓慢漂移，要求检查原生标定失败。范围包括官网流程、现有I2C驱动/标定状态机及最新本机日志。本轮未修改运行代码，未发送设备命令、未标定/归零/复位、未烧录；执行了主机回放与文档同步。

## 直接结论

最新两次实机原生请求均完成模式1/2/0观测和完整30秒静止验证，失败发生在SAVE已发送后的读回确认。不能再把这两次归为旧的“20秒前模式0被拒绝”，也不能称为30秒漂移再次超标。

现有程序对保存确认的一次短暂I2C读取失败直接退出，不使用其他读取阶段的5秒恢复机制；随后因verified仍为1，最终组合报告DONE/PASS、reason=save_failed、control_ready=0。这解释了“测量已通过，整轮仍有问题”的表现，未证明I2C变忙的物理来源或掉电保存成功。

## 官网核对

- [维特HWT101产品页](https://wit-motion.cn/proztmz/54.html)确认型号为单Z轴角度/角速度模组，不能混用多轴磁场校准流程。
- [维特官方商店HWT101系列FAQ](https://witmotion-sensor.com/products/hwt101ct-485-military-grade-z-axis-inclinometer-mems-tilt-sensor-built-in-highly-integrated-crystal-gyroscope-rotation-angle-at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)给出静止漂移的自动获取零偏流程：WORKMODE=1，等待20秒，WORKMODE=0。当前本车主要时序与此一致，使用I2C寄存器写入而非UART帧。FAQ同时说明航向来自角速度积分，无磁力计，空间运动与明显振动可能引起漂移；这些是适用条件，不是本车物理故障已经查明。
- [官方HWT101使用手册V23-0705](https://cdn.shopify.com/s/files/1/0601/1712/3269/files/HWT101_V1.0.pdf?v=1770279805)来自[HWT101官方产品资源页](https://witmotion-sensor.com/products/hwt101-military-grade-crystal-inclinometer-mems-tilt-angle-sensor-module)，确认I2C接口、Z轴量程/换算背景及供电/连接要求。官网参数不能替代本车长时间漂移实测。

未从官网资料中取得本车固件版本SAVE期间具体不可访问时长的保证，因此不把“模块写Flash造成BUSY”写成已证实原因，也不据此任意增大固定延时或取消保存确认。

## 最新实机证据

来源为`.embeddedskills/logs/serial/20261015-204133-c2da65.jsonl`，以下时间已转换为Asia/Shanghai。文件名起始日期不代表其中所有事件都发生在当天。

| 本轮启动 | 30秒验证 | 最终结果 |
| --- | --- | --- |
| 2026-10-15 21:58:07 | 301样本，漂移0.00048°/s，RMS 0.0055°，模式位图0x07 | 21:59:04，save_requested=1、save_readback_ok=0、save_state=ERROR、HAL=2、control_ready=0 |
| 2026-10-16 03:18:35 | 301样本，漂移0.00000°/s，RMS 0.0000°，模式位图0x07 | 03:19:30，同样保存确认失败，HAL=2、control_ready=0 |

第二次之前03:18:33的5秒验证确实因漂移失败：drift_dps=-0.09459、relative_deg=-0.478、I2C错误0，约为每分钟漂移-5.68°。随后原生标定的30秒窗口通过，且bias从0xFFA2变为0xFF3D。说明这次内部零偏变化与短时输出改善有实际证据；不能据此外推长期温漂、完整比赛或掉电保持已经通过。

HAL=2在当前接口表示HAL_BUSY。`[IMU FAULT]`保留的是本轮首次故障，不一定是最终保存确认那次的寄存器/错误码；日志不足以进一步确定SDA/SCL电气状态、供电、模块内部操作与主控BUSY标志的因果。不得把首故障寄存器当成最后失败的精确现场。

摘取的两轮完整IMU事件保存在`.embeddedskills/imu-native-audit-20261016/native-sessions.json`，本机产物不保证随Git提交。

## 代码发现

### P011 / P2：保存确认短暂读取失败不能续接，且总体状态误报PASS

`hwt101_calibration.c:587～592`排除三个SAVE阶段的读取恢复；`715～721`在模式或零偏第一次读失败时直接SaveFailed。SaveFailed保留verified并进入退出；`663`按verified选择DONE，Finish再据DONE+verified生成PASS。因此保存未确认时仍有DONE/PASS，却不给control_ready。

真实驱动及标定状态机回放，只在SAVE已受理后注入一次MODE读取HAL_BUSY，后续链路全部正常，得到：

```text
state=DONE result=PASS reason=save_failed HAL=2
verified=1 control_ready=0 requested=1 readback=0 saves=1 recoveries=0
```

单次HAL_ERROR同样复现。该路径与两次实机记录一致；仿真证明处理缺陷，不证明实物BUSY的电气起因。

建议修复：区分保存命令发送失败与发送后读回暂不可用。SAVE已确认发送后只做有限只读恢复、重新取得正常模式及零偏证据，不重发SAVE、原生开始或归零；未确认时明确报告总体未完成，保留“30秒测量验证通过”的独立事实。长期不恢复、模式异常及真实写入失败仍保留失败。修复后需覆盖单次BUSY/ERROR、恢复超时、取消、保存不重发和结果字段一致性。

### P012 / P2：启动模式首次异常读值没有只读复核

`hwt101_calibration.c:617`在首次启动读回为0或未知值时立即start_readback失败并发送退出模式0，未走其他阶段已有的至少100 ms只读复核。一次模式0读值、随后实际模式仍为1的主机回放得到FAILED/start_readback、starts=1、exits=1、recovery_reads=0。与现行模式异常复核要求不一致。

这能解释另一类偶发启动失败，但最新上述两轮均成功进入原生等待，因此不是它们的结束原因。建议仅复核读值，不重发启动；连续不符再失败，1/2仍正常受理。

## 软件验证与状态

现有hwt101_calibration_test、hwt101_read_recovery_test、hwt101_recovery_integration_test通过。新增本机回放源位于`.embeddedskills/tests/review_hwt101/save_read_glitch.c`、`save_busy_glitch.c`、`initial_mode_glitch.c`，链接真实驱动/状态机，分别复现上述缺陷。现有保存故障测试明确接受DONE/PASS配save ERROR，说明通过原测试不能排除P011。

本轮没有改变漂移门限0.01°/s、RMS门限0.1°、标定时长或运行控制；未做Keil构建及任何硬件操作。P002地图锚点丢失仍是独立问题，不是上述静止漂移的测量来源。原生保存确认与启动复核尚未修复，长时间静止漂移和掉电保持仍待后续实测。
