doinbest/Yachiyo/xjx/模版搭建/docs/开发记录/2026-10-16-整场比赛流程审查.md

# 整场比赛流程审查

2026-10-16，按用户“整个程序比赛任务流程review”请求，审查HEAD `b7a8706`及当前未提交工作区。保留已有修改。本轮未修改控制代码、未做Keil目标构建、未烧录、未复位，未连接串口或SSH；进行了GCC主机回归、Node/Python网页测试和针对性软件回放。

## 代码发现

确认5项新问题，并复核既有P002。下列优先级是修复顺序，不代表实车已经发生对应事件。

### P006 / P1：雷达路线加工区离站进入禁止区域后转向

真实`RadarPlan_BuildFromStart`输出在两次加工访问后均插入中间点(1200,350)。`chassis_route_profile.c:158`仅当紧邻目标Y≥425时加入undock，因此实际生成380→350，再在350处从180°转至90°，跳过现行要求的先退至Y425。来源是`radar_map.c:487～492`的栅格中心接驳，不是测试手工构造的路线。

使用实际雷达规划与阶段生成源码回放，输出第9/10与17/18段均复现。调用网页已有`footprintDiagnostic({x_mm:1200,y_mm:350,yaw_rad:135*Math.PI/180})`，当前300×300 mm车框与加工区白色禁止区域相交（非行车区6）；相同135°姿态在Y380和Y425不相交。这里证实的是当前软件几何模型的越界，未进行实车运动。

修复方向：规划接驳与离站语义统一，确保任何雷达中间点都不能把加工离站引向台面或在离站净空点之前转向；保留有效绕障。回归应使用真实规划器输出，覆盖两批、两起点及实际转向扫掠。

### P002 / P1，既有：短暂IMU不可用永久清除地图定位

`chassis_motion.c:166～170`在一次控制角读取失败或过期时清除map_anchor_valid；`chassis_localization.c:82～84`随之清除origin_valid。IMU资格恢复只恢复测角，路线继续所需原点仍无效，`chassis_route.c:334`持续拒绝续接。比赛出发后不能靠重设名义起点规避。源码链路本轮复核成立，原登记及历史回放保留在[待解决问题P002](../待解决问题.md#p002--imu短暂异常导致地图锚点及原点丢失)，未修复。

### P007 / P2：静态纠偏把忙轮询当成控制更新时间

`GrabTask.c:1628～1635`在机械臂忙、轮批次/同步忙或补读反馈时更新LastControl，却没有受理新输出。随后加速度限幅和X积分只使用最后一个空闲循环的间隔，实际纠偏能力随主循环频率变化，影响比赛空爪预对准与加工取回对准。

真实控制器回放：初始静止、加速度300 mm/s²、总线忙80 ms，在第81 ms空闲。每1 ms调用一次忙分支时下一次速度绝对值为0.300000 mm/s；相同时间仅在空闲时调用为24.299999 mm/s。当前`grab_static_frame_test`反而断言忙时LastControl更新，未覆盖真实控制间隔要求。修复应区分最近受理输出的时间与总线调度时间，同时保留最新帧、不重复积分及反馈限幅。

### P008 / P2：底部恢复不认识比赛恢复的成功回复

比赛中全局停止保留任务；总线同时隔离后，底部“解除停止锁定并恢复底盘”发送`bus recover`，`arm_console.c:2185～2187`转交比赛恢复。成功由`contest_mission.c:511～512`报告`grab route state=paused reason=bus_recovered`。但`stop-recovery.mjs:63～65`只等待非比赛路径的`OK bus recover complete`。

按实际回复格式的软件模拟复现：固件成功后网页仍等25秒，报“等待bus recover完整回复超时”，停止锁仍保留；下一次在底盘已健康时重试才可完成。应兼容比赛保留路径的成功/失败结果，并继续完成本次停车编号核对、反馈恢复；不能将修复通信等同于自动续跑比赛。

### P009 / P2：自动续跑被显示成等待人工继续

`protocol.mjs:381～386`不转换auto_resume，实际`auto_resume=1`解析为字符串`"1"`；`mission-panel.mjs:95`却使用`===1`。恢复期间因此始终显示“验证成功后保持暂停，等待手动继续”，而固件会自动续跑。实际协议行的内存解析已复现。应统一字段类型，并覆盖自动、人工两种恢复显示。

### P010 / P2：开启雷达使余弦标准开局退回分段停车转向

`radar_map.c:550`为标准右下开局插入中间点(2100,300)，而`chassis_route_profile.c:145～156`只有直接目标为扫码工位5时才生成entry_curve。因此无障碍标准地图下，余弦+雷达仍为斜移、停车原地转90°、直行；相同起终点的固定路线则为entry_curve，与当前余弦连续开局约定不符。非标准绕障保留接驳的要求不能代替标准入口模式。

应在真实规划输出中识别已确认的标准入口，并核对连续曲线扫掠；不能直接删掉绕障中间点。已有“planned”用例主要由固定目标拼接路线，没有覆盖真实规划器生成的上述接驳点。

## 已核对流程与通过证据

- 总任务的两批顺序、执行码冻结、实际码异步显示、扫码后机构恢复/平移并行、路段速度分配与模式锁定，未发现其他已确认问题。
- 真实比赛父任务+GrabTask/tracking集成分别运行raised/lowered：12次stored、12次placed，通过取放暂停及机构/底盘并行完成顺序检查。该测试模拟了工位路线，不覆盖上面的真实雷达规划接驳缺陷。
- 原料feedback追踪、高位窗口下降、Z完成闭爪、入仓、空爪对准保存快照后取仓、第二层按同色快照码垛、库存与暂停交接相关主机用例通过；新帧静态调度和对准停稳交接用例通过，但其计时断言未能识别P007。
- 路线暂停/停车、正式速度分配、共同时间反馈观察器及雷达规划主机用例通过；现有覆盖不能替代规划器与路线阶段的真实组合验证。
- 网页重连不发运动、停止取消待办、库存只在新比赛受理时初始化的所查路径未确认新增问题。

## 回归失败与覆盖限制

正式入口`python Code/tests/run_firmware_tests.py`在`grab_mission_pause_test`失败后停止。本轮以临时执行器继续执行该位置之后的顶层测试步骤，未改正式测试入口；7个C测试程序存在失败，记录为9个失败调用步骤：

| 测试程序 | 首个失败及当前判断 |
| --- | --- |
| grab_mission_pause_test | 等待GRAB_SETTLE，当前追踪夹取已绕过该阶段并完成stored；阶段列表过时 |
| grab_transfer_test | 断言pick/align漏检前速度完全相等；现有两入口准备/Z调度不同，进入宽限前速度已不同；不等同于P007的独立回放 |
| motor_bus_test | 要求反馈事件tick恒为171失败；本轮未完成根因定位 |
| turntable_test | 夹具遇未建模的事务触发assert(0)，未完成后续测试 |
| turntable_bus_fairness_test | Turntable_Index(2)受理断言失败，后续公平性检查未执行 |
| mecanum_bus_test | 恢复成功断言失败；本轮未完成根因定位 |
| mechanical_arm_emergency_chain_test | 初次位置受理断言失败，默认/first_tx_error/single_0调用失败；单轴循环在首个失败后未执行single_1/2 |

后四项中的部分夹具仍假定固定位置动作可跳过Both参数准备；不能把所有失败一概视为无害或全部归因于本轮未提交改动。motor_bus/turntable/mecanum及上述四个对应测试源码相对HEAD均未改变。本轮不据此宣称全量回归通过。

Node网页测试695项，694通过、1失败：`radar-diagnostics.test.mjs:37`提取requestStop到独立VM后未声明新增staticAlignGain，触发ReferenceError；实际页面存在该变量。Python网页服务测试105项通过。

针对性回放源与产物保存在本机`.embeddedskills/tests/nav-review-radar-profile.c`、`review_static_busy.c`及对应exe；失败摘要为`competition-review-20261016-remaining.json`；Node日志在`.embeddedskills/logs/2026-10-16-competition-web-review-node.txt`。这些本机产物不保证随Git提交。

## 文档同步与交付状态

已将[硬件与运行基线](../硬件与运行基线.md)中残留的P0.02、对称独立加速度总述同步为当前P0.1/D0、固件300/300与网页500/300及正式分段参数。现行比赛路线要求保留，没有改写规则迁就P006/P010。问题索引登记5项新发现；本记录补充当前证据，不改写此前开发记录中的当时验证/下载事实。

网页比赛模式选项/采用值仍显示“线性300 mm/s²”，属于显示文字漂移，未在本轮改运行代码。香橙派本地源码与远端部署、设备RAM、现车固件版本及完整实车验收分别核对；本轮软件通过项均不代表整场实车通过。
