doinbest/Yachiyo/xjx/模版搭建/docs/开发记录/2026-10-16-正式比赛速度分配.md

# 正式比赛分段速度与单P航向

## 需求与保存点

用户确认将右下起点的分段速度表应用到正式比赛，直线航向P改为0.1，D保持0。修改前全部非忽略文件已提交为`2df6f28`；忽略的日志、设备状态和构建产物保留原位。

用户已确认起步800/1000的独立测试稳定。原始日志`20261015-204133-c2da65.jsonl`中，2000 mm、起步1000、停车300、P0.1/D0两次为5342/5341 ms，峰速919.478/935.176 mm/s；截图测试14为1000 mm、500/300，耗时4589 ms、峰速558.181、终点误差7.823 mm，不能将截图后来填写的2000 mm当成本次距离。

## 实现

- `chassis_config.h`集中维护比赛起步500/800/1000、停车300及速度上限300/700/800/1000。普通MoveTo默认加减速仍300/300，网页独立测试初值仍500/300。
- `ChassisRouteProfile_ApplyTaskLinear`在正式linear阶段生成后分配速度及起步加速度，依据工位/visit与阶段几何，不按雷达路点序号识别。固件与网页预演C核心共用此函数，阶段速度取用户本轮上限与分段上限的较小者，名义时间预算同步调整。
- 短斜移≤300 mm采用500/300、上限300；扫码及右上接驳1000/300、上限1000；首批原料台横移800/300、上限700；两批到加工区800/300、上限1000；其他通道800/300、上限800。工位进退/换环及位置补偿保持原50或更低速度和300/300。
- 正式linear提交MoveToTuned，使停车减速度独立保持300。阶段参数在生成时确定，待提交重试及暂停续接复用；不将用户填写的低速度自动抬高。
- cosine K200与第二批原料台连续曲线保持；曲线向量变化率仍300、主体参考限速60，未把它当作普通直线提速。独立二维码和普通路线不套比赛分段表。
- 普通直线、heading/hold的默认P0.1/D0，网页独立测试默认一致。保留±0.50 rad/s、±0.1°死区及原地转向独立P0.02。视觉角校准与原地转向不套本次分段参数。

完整回归发现已有死区边界失败：修改前Git版本同样无法通过`observe(180,-.1f)==0`。诊断确认度/弧度转换及累计浮点误差使标称±0.1°落到边界外。仅在死区比较增加0.0001°浮点容差，原角度归一化算法保持；新回归确认±0.1°无输出，±0.1002°仍输出纠偏，视觉精确转向仍绕过死区。该容差不是IMU实测精度。

## 软件验证

已先运行新增比赛分配测试，旧实现因短斜移仍提交1000 mm/s而失败；实现后正式固定/规划路线22次平移、16次转向、200 mm/s低速上限、暂停续接、cosine和独立二维码检查通过。航向纯P0.1、D关闭、限幅及原地转向独立参数检查通过。

网页Node685项、规划服务27项通过；正式路线、航向、暂停续接及后续协议/显示检查通过。全量固件回归不是全绿：下列8项失败均在修改前提交2df6f28的独立源码副本中复现，未据此修改无关实现：grab_mission_pause_test、grab_pose_test、grab_track_task_test、motor_bus_test、turntable_test、turntable_bus_fairness_test、mecanum_bus_test、mechanical_arm_emergency_chain_test。基线核对结果保存在`.embeddedskills/mission-speed-baseline-failures.json`。

## 实车状态

此前独立直线效果由用户确认。新的载料1720 mm、横移、所有工位衔接及整场比赛尚待实车验收。本轮不自动发车或发送串口运动命令。

## 本轮最终结果

- Keil `Code/template/MDK-ARM/template.uvprojx` / Target `template`构建通过，0错误、0警告；Code281456、RO34572、RW3316、ZI189684字节。
- 固件保留为`.embeddedskills/mission-speed/mission-speed.hex`，SHA256及源码校验保存在同目录`manifest.json`；构建日志为`build/template-template-build.log`。
- 使用确认过的`mission-dap.cfg`、SWD1000 kHz、探针7b168f48及同一CubeIDE OpenOCD后端检测。找到CMSIS-DAPv2设备，但报`CMSIS-DAP command CMD_INFO failed`，没有完成SWD目标核对，未执行烧录。
- 对照最近成功的`.embeddedskills/asymmetric-linear/probe.log`、`flash.log`确认同样使用CMSIS-DAPv2；未切换猜测后端或提高调试参数。程序代码已应用，实机固件尚未更新；DAP链路恢复后应使用上方已保留产物下载校验。
- 本次同步AGENTS、主车README、地图操作手册、比赛约定、硬件基线及底盘协议；历史记录保持原事实。后续独立审查应包含代码及现行文档一致性，实车完成率另行验收。
