doinbest/Yachiyo/xjx/模版搭建/docs/开发记录/2026-10-16-视觉对准与底盘机械臂联动审查.md

# 视觉对准与底盘机械臂联动审查

2026-10-16，按用户要求审查原料转盘追踪、加工/暂存色环、码垛视觉及底盘、X/Z、Base、ID8联动。基于HEAD b7a8706及本轮未提交的像素尺度修改；保留其它任务的工作区修改。本轮仅审查及同步现行文档，不修改运行代码、不编译、不烧录、不操作设备。

## 已确认代码问题

P2，既有动态追踪反馈链将预测位置作为新实测提交。`GrabTask.c`的`track_observer`先检查原始轮位置年龄≤600 ms，再以已发送指令积分加平滑校正或旧斜率外推填入`sample.position`，并把四轮`time_ms`统一写为当前时刻；IMU也未设置真实样本时间。`ChassisObserver_Feedback`据此判为新位置组并更新feedback，随后`TrackInput.motion_mm`参与50 mm接近余量和预测模式的视觉自身运动补偿。因此轮反馈短时缺失或响应滞后时，预测更新仍会改变所谓实际已走距离。位置预测可保留作控制估计，但不能代替以真实样本时间融合的实测反馈。反馈模式另外保留原始反馈年龄计算，并非全部年龄归零。本项不是新J尺度修改引入。

## 明确效率损耗

- 静态`align_control`最短100 ms更新，最优也只有10 Hz；机械臂或底盘同步批次忙时还将`LastControl`更新为当前时刻，实际空闲后继续受100 ms门槛限制。例如100 ms尝试遇忙、103 ms空闲，最早也到200 ms才再次具备时间资格。这是源码分支计算，未执行C时序回归。动态追踪20 ms参数不控制该静态入口。
- 正式空爪对环/码垛预对准先累计视觉稳定，再停车后重新累计；进入HOLD又清除HaveCapture，父任务保存位置时`vision_read`会再次清空稳定证据，再等3帧及200 ms。最后一轮在机构没有再次运动时也会发生。保留停车后的新鲜坐标复核有意义，重复整个稳定窗口仍有优化空间；本轮没有修改既有静态稳定规则。

## 联动核对结果

- 原料高位±100 px准入后连续下降，底盘/X继续追踪；Z完成即闭爪，随后调度水平零速与X停保持，不走低位再次对准或整套停稳等待。ID8在外侧姿态条件满足时预分度，Base回仓前仍汇合确认。新比例下±100 px约对应横向±70.31 mm、纵向±68.75 mm，夹取容差仍待实测。
- 加工/暂存空爪对准后，保存位置前核验四轮和X/Z/Base新鲜停稳；1/2盘取料时X30避让与Z提起并行，两者完成后转Base。回到外侧后恢复保存X，再连续下降至绝对释放目标，正式持料阶段不重新识别。
- 第二层码垛识别第一层同色物料，保存X/Z及z_stack_place，再取仓恢复放置；暂停保留快照、夹持和释放阶段。加工取回最终下降停止视觉，Z到位直接闭爪，暂停该段不重新请求视觉。
- 未发现上述正式色环/码垛取仓后重新对准、先下降再恢复X、暂停重复记库存等可确认的新功能缺陷。此前独立审查记录的问题未因本轮只读核对而自动修复。

## 文档同步

- 比赛约定的z_temp_align从误写−110 mm纠正为源码默认−100 mm；z_stack_place仍为−110 mm。
- B2协议及视觉手册的当前本地新版准心改为物料(357,324)、编号环(367,316)，与combined_color_digit_ring.py及香橙派README一致。保留旧版本历史说明，实机入口/参数与本地待部署程序分别判断；STM32不新增准心或码垛补偿。

## 验证及实车状态

- 本地新版黑线/色环姿态Python检查8项通过；旧vision.py入口USB/协议检查13项通过。后13项不覆盖新版颜色/编号环完整检测，也不证明当前香橙派部署正确。
- 现行源码调用链及相关C测试内容已阅读；未运行C回归、未编译Keil，未下载、复位、连接串口或SSH。无实车耗时或整场通过结论。
