doinbest/Yachiyo/xjx/模版搭建/docs/开发记录/2026-10-16-追踪实测与估计分离.md

# 追踪实测与估计分离

2026-10-16，用户授权修正动态追踪预测位置混入实际位移，并要求判断估计是否需要。用户当前主要使用feedback，预测模式很久未用；继续遵守暂不编译、不烧录。

## 取舍与实现

- feedback/visual不需要指令位置预测：控制由新鲜DX/DY及反馈减速推进。保留predict既有平滑估计以维持原视觉自身运动补偿能力，未删除该模式；估计观察器仅predict运行。
- `GrabTask.c`以原轮位置和各自position_ms、IMU真实last_update_ms构造实测样本，复用ChassisObserver共同窗口插值。实测速度来自共同窗口的轮位置增量，不把估计或旧斜率外推送入实测通道。
- 新增独立body_left_mm供三模式50 mm预算和自动/显式参考使用；motion_mm仅为控制坐标，predict保留估计，visual/feedback为实测。实测年龄包括共同时间、原轮位置与X位置；预算制动计入测量、控制和发送延迟，不新增固定等待。
- ChassisObserver增加可选max_span_ms，零值保持普通底盘原250 ms限制；动态显式使用600 ms，匹配原单轮读取窗口及已有300 ms交错反馈场景。仍要求有真实包围样本，不外推实测、不放宽每轮年龄和驱动故障条件。
- 暂停、参考、预算、持料/库存及任务流程保留；没有调像素窗口、J尺度、速度、增益或电机加速度。估计多一份独立观察器及历史存储，链接占用须后续编译确认。
- 同步AGENTS、主车README、比赛约定、机械臂/B2协议和视觉手册；网页改为“实测反馈最大年龄”和“控制用局部坐标”，离线报告字段改为feedback_age_p95_ms。TRACK线协议19项布局不变；旧审查报告保留发现时的事实。

## 验证状态

- 准备grab_track_motion_test并注册主机套件，覆盖三模式命令发送但编码器未变、缓存时间不推进、仅实测移动扣预算及predict估计可变化但预算不变；已有交错反馈用例增加实测共同时间检查，控制器预算测试同步新输入字段。
- 遵守用户限制，未运行任何C编译或C回归、未构建Keil、未烧录/复位/部署或发送设备命令。C测试只有源码准备，不报告通过。
- GrabTask、grab_tracking、chassis_observer、新用例及两个既有追踪用例共6个C文件，完成不展开宏/头文件、以占位类型解析的语法结构检查；不是类型、链接或运行验证。3个Python文件语法、实测/估计数据流静态断言及8份现行文档相对链接检查通过，按现有CRLF格式启用cr-at-eol的git diff --check无空白错误（未修改Git配置）。
- tracking_report_test.py的10项Python测试及网页grab-track.test.mjs的26项测试通过；只覆盖报告与网页行为，不代替C控制回归。
- 独立只读审查核对三模式数据流、预算参考、模式切换与暂停恢复，未发现必须修复的运行问题；已补齐fixture的新字段并修正文档旧状态说明。该结论限于静态审查。
- 设备运行效果、动态预算行为及完整比赛仍待后续软件验证、烧录和实车验收。
