doinbest/Yachiyo/xjx/模版搭建/docs/开发记录/2026-10-16-追踪结束与普通任务零速交接修复.md

# 追踪结束与普通任务零速交接修复

2026-10-16，用户授权修复三件原料入仓后停止，并要求排查同类等待。沿用本轮不编译、不烧录限制；保留其它会话已有修改，不操作串口、探针或实车。

## 原因与实现

日志BUILD为06:58:34；07:01:54已stored=3，07:01:55停在leaving/busy，机械臂随后travel_ready。闭爪同步零速已发出，但Mecanum_IsBusy保留显式停车占用。此前仅下一件tracking_start能识别历史占用，普通MoveTo仍拒绝；父任务只重试，没有能改变这个占用的步骤。原始证据见[P019](../待解决问题.md#p019--第三件原料入仓后离站一直busy)和`.embeddedskills/analysis/third-raw-departure-20261016/evidence.json`。

- MoveTo公共启动入口允许上一生产者结束后接管已发送完成的四轮零速，TurnTo/PathStart共用。不清显式停车标记、不假报到点，不另发FE或增加固定等待。直接定时、velocity/hold和IMU仍沿原准入。
- 交接仍排除活动抓取、待发运动、停车/故障；机构并行只沿现有PoseClearance/QrDeparture条件。接管时四轮速度/位置/状态需在600 ms内、速度≤±1 RPM、使能且无0x0c保护，IMU和地图有效。
- 未排空报告chassis_handoff_wait，比赛local_move和路线Pending保留原目标/参数重试；真实总线故障报告bus_unavailable，保护/失能不放行。网页增加相应中文原因。
- 新固定/视觉取放先检查活动所有者，再覆盖操作与结果。排空零速允许进入原PREPARE停车及新鲜反馈取证；busy拒绝不再破坏上一任务的完成上下文。相邻原料原有交接保持。

## 同类等待核查

| 分支 | 处理与边界 |
| --- | --- |
| 两批第三件入仓→回中心→下一站 | MoveTo不再被历史占用永久拦截；仍等真实到点后交接 |
| 工位换位、转向、后续路径 | 共用MoveTo入口；路线已有姿态和转向互斥保留 |
| 下一颜色追踪 | 原raw_handoff保持，不追加停车、不充值50 mm预算 |
| 新固定/视觉取放 | 接管零速后完成原PREPARE；busy拒绝先保留旧结果 |
| 扫码离站等待路线接管 | QrDepartStart已有QrDeparting/travel_ready幂等处理，不重复重启动作；未改 |
| 暂停及总线恢复 | ResumeReady已有选择一次、后续只重开轮询；原阶段和显式继续规则保留，未新增退出计时 |
| 静态对准到保存/取仓 | 已有真实停车、快照和移交资格；未增加清busy捷径 |

本轮未确认这些已核查分支中有其它确定卡点；这不是项目不存在其他问题或整场实车通过的结论。P010余弦雷达开局、P013其它路段连续化不在本轮修改范围。

## 回归准备与验证

先准备C用例再修改运行代码，按用户限制未进行编译或C红绿运行。

- 新chassis_zero_handoff_test链接生产Mecanum、MotorBus和ChassisMotion，模拟HAL及定位/IMU边界，覆盖真实历史busy与零速并存时的平移/转向/路径接管；活动追踪、姿态并行、未发完零速、待发非零、停车、总线故障、过期/运动/保护/失能及直接定时/速度入口拒绝。接管不发FE、不假到位。
- 新grab_raw_handoff_test使用真实GrabTask，覆盖重复busy拒绝保留stored/操作/库存，资源恢复后受理并进入PREPARE。
- 新chassis_handoff_retry_test使用真实路线，覆盖busy/grab_task_busy/chassis_handoff_wait等待后重新提交原目标，invalid_target不吞掉。
- 扩展contest_choreography_test覆盖两批末件离站等待、恢复后回中心并进入下一站；公共运动夹具及两个拥有姿态替身的夹具同步依赖，三项新用例登记主runner。
- Node终端显示38项通过，不调用编译器或设备。静态接口/调用检查、runner Python语法、3项新用例登记与包含路径、4个既有Keil模块登记、10份文档592个本地链接目标及差异空白检查通过；C、Keil及实车均未运行。

## 交付边界

源码、测试、现行规则、模块协议、主车说明和问题状态同步；历史开发记录保留。未生成本轮固件，未烧录、复位或发车。后续允许编译时先运行新增真实组件组合及既有比赛/暂停/运动回归，再构建主车Keil Target template。实车须核验两批末件离站、工位换位、等待期间人工停止及暂停继续，单项成功不代替完整比赛验收。
