doinbest/Yachiyo/xjx/模版搭建/docs/开发记录/2026-10-17-工位放置高度110与码垛100.md

# 工位放置高度110与码垛100

用户要求加工区与暂存第一层下降110 mm、第二层码垛下降100 mm。沿用当前只修改、不测试、不编译、不烧录的安排。

## 实现

唯一参数表grab_parameters.def中z_proc_place默认-120改为-110 mm，z_stack_place默认-110改为-100 mm。以Z=0高位为基准，加工释放及第一层暂存放置到Z=-110，第二层码垛释放到Z=-100。既有z_proc_place同时用于加工区取回夹取及独立地面取料，因此这些共用入口也采用-110；没有拆分新参数或改变流程。原料转盘夹取-45、车仓放料-25、车仓取料下降25 mm保持。

网页元数据由原工具重新生成，地面取放初值随参数表更新；页面说明同步110/45/25及X/Z零档的当前设置。普通显式自定义高度和已受理动作的绝对目标保留原语义，刷新/重连不写设备参数。AGENTS、比赛约定、机械臂协议、硬件基线、主车README及网页操作手册同步当前值；历史开发记录不改写。现有默认值断言源码同步，显式自定义测试数据保留，未执行测试。

## 状态

源码和网页默认值修改完成；仅运行元数据生成工具，未运行测试、未编译、未烧录、未操作实车。当前设备RAM及已烧录版本未读回，不能据此认定实车已采用新高度。此前HEX不包含本次修改。
