doinbest/Yachiyo/xjx/模版搭建/docs/开发记录/2026-10-17-比赛航向测试接口适配修复.md

# 比赛航向测试接口适配修复

用户确认修复完整主机回归中比赛航向测试缺少模拟接口的问题。本轮只补测试夹具和测试用例，不修改小车运行代码，不编译Keil固件或烧录。

## 接口适配

检查时，当前工作区已接入`ChassisMotion_TestParametersDefaults`、`ChassisMotion_MoveToTuned`的共享替身，以及`contest_heading_test`专用的`MISSION_TEST_STUB_LOCAL_TUNING`编译定义。本轮保留这些已有改动，并追加真实比赛`local_move`调用路径的验证：倍率2时，基准局部限速50得到100 mm/s，加速度/减速度均为600 mm/s²；目标坐标不变，忙碌拒绝不推进阶段，资源恢复后可重试。

继续编译发现同一组比赛测试还缺少新取仓入口。已在不链接真实GrabTask的共享替身分支中补齐：

- `GrabTask_RingTakePrepareAtZ`：检查显式高度，转发到原对环取仓准备替身，保留原准入结果。
- `GrabTask_CarPickStartEx`：检查0～150 mm内的正下降距离，转发原取仓替身，记录本次距离。
- `GrabTask_RingStoreStart`：旧比赛替身不模拟新增独立“环处夹取入仓”动作，明确返回拒绝，不伪造成功。该新增入口不属于本轮航向测试覆盖范围；链接真实GrabTask的组合仍直接使用生产函数。

真实GrabTask测试组合仍排除这些替身，不重复定义或覆盖生产函数。没有关闭编译警告、删除断言或把拒绝强行改成成功。

## 验证

本轮先保留缺接口的原始链接失败日志，再补齐接口。最终5组相关主机回归全部通过：`contest_heading_test`、`contest_mission_test`、`mission_scale_task_test`、`mission_grab_integration_test`、`mission_stop_feedback_test`。包含新增参数传递/忙碌重试用例，以及真实GrabTask两批12入仓/12放置和独立编号环放置流程。

完整入口`python Code/tests/run_firmware_tests.py`已通过参数元数据检查和前20组，越过航向返回值及接口缺失阻断；随后在`chassis_zero_handoff_test.c:48`的`Mecanum_IsBusy() && Mecanum_VelocityHandoffReady()`断言失败。该测试直接链接chassis_motion、mecanum_chassis、motor_bus及chassis_model，不链接本次修改的比赛夹具。本轮不据此改动电机控制逻辑，也不宣称完整回归通过。

后续额外编译曾发现新增`GrabTask_RingStoreStart`未覆盖，补齐后上述5组重新通过。原始中间失败日志与最终结果均保留在`.embeddedskills/heading-test-interfaces-20261017/`，最终结果见`related-results-final.json`，全量推进记录见`full-suite.log`。

本轮当前剩余阻断是底盘零速交接断言，具体是测试前置还是实现问题尚未定位，不能直接解释为实车电机故障。主车README、视觉任务手册和开发索引已同步新状态；历史开发记录保留原有事实。本轮无实车命令、复位、固件编译或下载。
