doinbest/Yachiyo/xjx/模版搭建/docs/开发记录/2026-10-17-混用驱动版本只读识别.md

# 混用驱动版本只读识别

用户明确授权修改、编译烧录并通过串口读取版本分析。本轮该授权覆盖下载后的既有自动回零与随后只读诊断；不新增手动运动、回零或配置写入命令。保留此前全部工作区改动。此前04:24只读查询确认ID7为25/25成功0超时、回零完成，而bus read 1 version被旧固件拒绝。

## 实现

新增bus read <id> version，复用原单IDProbe。1F读取兼容5字节（ID/1F/FW8/HW8/6B）和7字节（ID/1F/FW16/HW16/6B），7作为请求最大预期，只对1F放宽长度。扩展硬件series/type字段不为6B，合法byte4终止区分短版。原期限、抢占、2 ms交接保留；取消纯读取排空5或7字节，不重放运动或重发查询。00/EE拒绝只关联当前选定ID的版本探测。版本数据原始值输出，短格式不猜准确型号/补丁；扩展格式保留FW数字及硬件字段。

厂商依据：项目ZDT_X42S用户手册第67页扩展格式；张大头智控Emm_V5说明书6.3.4短格式（https://devpress.csdn.net/xian/68945b69080e555a88d61cd3.html）。该网页示例与解释值本身不一致，因此不按短FW码硬编码全部版本名称。

## 验证与状态

新增motor_bus_version_test先在旧白名单上出现预期拒绝，再实现通过；覆盖5/7分片、回显、错误ID、拒绝、取消排空及原超时不重发。原motor_bus_probe_test的运动等待ACK断言在修改前基线也失败（底盘现已默认None）；夹具显式选择Receive后覆盖其原ACK语义，不修改控制默认。版本测试及该诊断测试通过；交接2ms和控制台主机测试通过。后续构建、下载及真实逐ID读取结果另行追加，不用软件通过代替现场通信正常。

构建/烧录/实机读取结果见下方新增记录；早期阶段说明保留当时事实。

构建结果：2026-10-17 04:32:33，Keil template/Target template，0错误0警告，ROM351128、RAM196164字节。HEX SHA256=d2d870ebc2e2b97a84a6848d3096f6f3d32d98e7517507b064897d1598116fc6。版本/Probe/2ms交接/控制台/恢复取证5项通过。额外motor_bus_test第116行、motor_rx_error_boundary_test第66行失败均在修改前源码副本同样复现，保留基线差异，不宣称全量回归通过。

## 实际下载与读取结果

2026-10-17 04:34:52，DAP 7b168f48 / SWD100 kHz，STM32F407系列ID0x10076413、Flash1024 KiB，Programming Finished及Verified OK确认烧录校验成功；HEX SHA256=d2d870ebc2e2b97a84a6848d3096f6f3d32d98e7517507b064897d1598116fc6。日志位于.embeddedskills/motor-versions-20261017/flash.log，源文件/HEX哈希清单manifest.json保留。

设备启动回报编译时间04:32:28；04:34:56回零完成，随后原IMU验证通过。用户当次明确要求下载后串口分析，故继续只读读取；没有启动比赛、手动HOME、运动或配置写入。04:36:06～04:36:28逐ID版本读取8/8成功，0超时、0 UART错误、0拒绝，回复1～2 ms。最终总线locked=0、recovery active=0。

| ID | 格式 | 固件原始值 | 固件显示 | 硬件原始值 | 原始应答 |
|---|---|---|---|---|---|
| 1 | 7字节 | 0x00C9 | 2.0.1 | 0x2314 | 011F00C923146B |
| 2 | 7字节 | 0x00C8 | 2.0.0 | 0x230A | 021F00C8230A6B |
| 3 | 7字节 | 0x00C9 | 2.0.1 | 0x230A | 031F00C9230A6B |
| 4 | 7字节 | 0x00C9 | 2.0.1 | 0x2314 | 041F00C923146B |
| 5 | 5字节 | 0x0003 | 保留原码，不猜补丁版本 | 0x0082 | 051F03826B |
| 6 | 7字节 | 0x00C8 | 2.0.0 | 0x230A | 061F00C8230A6B |
| 7 | 7字节 | 0x00C8 | 2.0.0 | 0x2314 | 071F00C823146B |
| 8 | 5字节 | 0x0003 | 保留原码，不猜补丁版本 | 0x0082 | 081F03826B |

实测扩展回包的硬件series=2，已超出项目旧手册只列0/1的范围，保留原始硬件字0x23xx，不凭旧枚举断言实际板卡型号或TX电气方式。ID5/8短码0x03、0x82同样不映射成未经确认的型号。ID2/6/7为扩展版本200，ID1/3/4为201，版本混用已证实；不能仅据版本差异判定NE原因，也不升级任何驱动固件。

启动时仍有2次NE：1112 ms发送06F3AB01006B期间，cursor34、NDTR29（位置35），新增FF；4320 ms发送05366B期间，cursor35、NDTR28（位置36），新增FF。两次恢复未打断本次回零，8台版本查询阶段无新增NE。发送当时的owner/ID只是事务背景，不能据此定位噪声一定由该驱动产生。修复X线束后ID7正常，但接收异常源尚未定位，未宣称行驶/多机总线已验收。

完整串口事件目录：C:\Users\xjx\Desktop\Code\STM32F407VxT6\模版搭建\.embeddedskills\uart-ne-20261017\live-043550，结构化版本数据：.embeddedskills/motor-versions-20261017/versions.json。
