doinbest/Yachiyo/xjx/模版搭建/docs/协议/系统与底盘.md

# 系统与底盘协议

线性模式的正式右下标准开局恢复分段路线：(2250,150,180°)保持朝向斜移到(2100,300)，新鲜反馈确认停稳后顺时针原地转到90°，再直行至本轮二维码纵坐标；各平移段使用本轮路线速度上限及300 mm/s²线性规划，不套连续弯道200 mm/s上限。转向停稳后才准备Base扫码姿态，并可与后续直行并行。余弦模式保留右通道连续开局；右上起点、右上角至物料台、第二批进站、非标准绕障和独立二维码测试保持各自现行路线。
`chassis task`仍为只读查询，补充`origin_valid`、`origin_mm=x,y`、`origin_deg`、`feedback_valid`、`feedback_mm=x,y`、`feedback_deg`和`feedback_age_ms`，角度单位为度、坐标为毫米、采样年龄为MCU毫秒。准备跑图在IMU与四轮检查后查询这些字段：原点符合 `(2250,150,-180°)`（车头朝物料加工区域，+180°同向，现有网页准备命令沿用+180°表示），且当前位置在10 mm/2°内、反馈年龄≤600 ms时复用原点；否则等待人工确认起点后才写入`chassis origin`。最终仍等待本次遥测会话中的新鲜静止反馈，查询受理不等于准备完成。

命令、单位和解析字段按主题集中维护；网页只露出常用操作，表中的兼容命令不表示每个都有按钮。旧CRC、sys.ping#及B3接口已退役。操作步骤见[连接与恢复](../../Code/upper-computer-web/local-car/docs/连接与恢复.md)和[地图与雷达](../../Code/upper-computer-web/local-car/docs/地图与雷达.md)。

## 通用命令目录

| 命令模板 | 用途 | 参数/限制（网页） |
|---|---|---|
| `pos {axis} {degree}` | 相对转动 | axis=base/z/x；degree=-360～360 |
| `enable {axis}` | 使能 | axis=base/z/x/all |
| `disable {axis}` | 取消使能 | axis=base/z/x/all |
| `state {axis}` | 查询状态 | axis=base/z/x/all |
| `stop {axis}` | 停止 | axis=base/z/x/all |
| `position {axis}` | 读取当前位置 | axis=base/z/x |
| `home {axis} {mode}` | 执行回零 | axis=base/z/x/all；mode=near/dir/collision/limit |
| `origin {axis}` | 保存机械零点 | axis=base/z/x/all |
| `zero {axis}` | 当前位置计数清零 | axis=base/z/x/all |
| `config {axis}` | 读取运动配置 | axis=base/z/x/all |
| `config {axis} {rpm} {acc} {limit}` | 设置运动配置 | axis=base/z/x/all；rpm=1～3000；acc=1～255；limit=0～3200 |
| `grip open` | 松开夹爪，2500 µs | 50 Hz PWM，占空比 12.5% |
| `grip catch` | 抓紧夹爪，1920 µs | 50 Hz PWM，占空比 9.6% |
| `grip idle` | 待机松开，2500 µs | 与 `grip open` 同一位置 |
| `grip duty {duty}` | 手动设置占空比，仅供标定 | duty=2.5～12.5；反装实测打开12.5%、夹取9.6%；脉宽µs=占空比×200 |
| `chassis {direction} {distance}` | 定距前后移动 | direction=forward/backward；distance=1～200 |
| `chassis velocity {forward} {left} {yaw}` | 持续速度控制 | forward=-1000～1000；left=-1000～1000；网页yaw=-500～500 °/s；当前固件仍限制±360 °/s |
| `chassis stop` | 底盘停止 | — |
| `wheel {wheel} {rpm}` | 单轮测试 | wheel=fl/rl/rr/fr；rpm=-100～100 |
| `wheel stop` | 车轮停止 | — |
| `camera material {target}` | 相机识别物料 | target=1/2/3/4/5/6 |
| `camera stop` | 停止相机请求 | — |
| `camera status` | 相机与 USB 状态 | — |
| `camera ring {number}` | 相机识别编号环，不运动 | number=1/2/3，B2目标0A/0B/0C |
| `grab calib ref` | 人工确认当前标定观察姿态 | 不运动、不回零、不覆盖有效模型；普通停止保留 |
| `grab calib {target}` | 底盘前后/X实际响应标定 | target=1..6；先确认姿态，保持Base/Z/夹爪 |
| `grab calib status` | 只读标定阶段、确认及上次结果 | 运行和停止锁定中均可读；不启动采样 |
| `grab stop` | 取消任务/标定，执行现有停车确认 | 保留上次有效模型；受理不等于物理停车完成 |
| `info` | 设备信息 | — |
| `help` | 固件指令帮助 | — |
| `bus test {id} [rounds]` | 单 ID 只读通信测试 | id=1～8；rounds=1～100，省略为10；每轮读取状态、位置、速度 |
| `bus test status` | 本次或最近一次测试统计 | 仅缓存，不发送电机帧 |
| `bus test stop` | 结束通信测试 | 不表示电机停车；实际停车使用既有停止入口 |
| `chassis run {vx} {vy} {omega} {hold_ms}` | 平移与转向测试 | vx=-300～300；vy=-300～300（合速度≤300 mm/s）；网页角速度=-500～500 °/s，当前固件仍限制±100 °/s，发送时换算rad/s；seconds=0.1～59 |
| `chassis heading {vx} {vy} {heading} {hold_ms}` | 航向保持测试 | vx=-300～300；vy=-300～300（合速度≤300 mm/s）；heading=-180～180；seconds=0.1～59 |
| `chassis turn {map_yaw_deg}` | 反馈到角的原地转向 | 地图绝对航向−180～180°；转向上限100°/s（约1.745329 rad/s），接近目标减速，到角并确认四轮停稳后完成 |
| `chassis origin {x} {y} {heading}` | 设置地图初始位姿 | x=-10000～10000；y=-10000～10000；heading=-180～180 |
| `chassis task` | 读取运动任务 | — |
| `chassis route start [speed_mm_s]` | 开始第 1 段 | 10～5000 mm/s，省略时1000；15个业务目标继承启动速度 |
| `chassis route auto [speed_mm_s]` | 自动执行15个业务目标 | 10～5000 mm/s，默认1000；确认到位停稳后直接继续，附加停留0 ms |
| `chassis route next` | 手动下一段 | — |
| `chassis route cancel` | 取消路线 | — |
| `chassis route status` | 查询实车路线 | — |
| `chassis move {dx} {dy}` | 单段相对位移测试 | dx=-300～300；dy=-300～300 |
| `chassis hold {speed} {seconds}` | 捕获当前已验证模块航向的定时直行 | speed=-100～100；seconds=1～10；无地图原点要求 |
| `chassis status` | 读取旧版直行测试状态 | — |
| `chassis feedback` | 读取四轮反馈缓存 | — |
| `chassis feedback {wheel}` | 选择反馈对象 | wheel=0/1/2/3/4 |
| `chassis feedback on` | 开启反馈轮询 | — |
| `chassis feedback off` | 关闭反馈轮询 | — |

反馈对象选择 `chassis feedback 0|1|2|3|4` 只更新后续轮询名单，并关闭自动轮询，需显式 `chassis feedback on` 恢复。2026-10-08 起，已有查询排队、等待应答或应答未消费时也可以选择；已有查询按原电机编号和请求标记正常完成，不取消、不重新解释其回复。动态追踪和静止对准调用同一接口选择四轮，再开启轮询，避免连续应答轮询始终忙而阻塞任务启动。详见[反馈切换修复记录](../开发记录/2026-10-08-反馈轮询切换与追踪启动修复.md)。
| `chassis profile receive` | 旧客户端兼容入口；固件上电默认 Receive，无需发送 | 不支持 none |
| `chassis units {units}` | 确认协议位置单位 | units=0/65536 |
| `chassis reset-confirmed` | 确认驱动已实际复位 | — |
| `imu status` | 读取 IMU 状态 | — |
| `imu cal start` | 原生零偏标定 | — |
| `imu verify` | 静止验证 5 秒 | — |
| `imu cal cancel` | 取消标定或验证 | — |
| `imu stream on` | 开启模块角度输出 | — |
| `imu stream off` | 关闭模块角度输出 | — |
| `qr status` | 检查支持 / 接收统计 | — |
| `qr read` | 读取最新任务码 | — |
| `qr stream on` | 跟随新任务码 | — |
| `qr stream off` | 关闭任务码跟随 | — |

`camera status` 的 `state=Idle|Off|Wait|Ok|Lost|Stale` 沿用独立相机快照；只有 `Ok` 且数据有效时输出数值 `cx/cy/dx/dy/seq`，其余为 `na`。`age_source=rx frame_age_ms=<间隔>` 为最近匹配报文到达 MCU 后的间隔，不是香橙派图像采集时延。`camera material/ring/status/stop` 的协议和独立坐标输出保留。

`grab calib status` 回复 `OK grab calib phase=<阶段> ref=<0|1> calibrated=<0|1> reason=<原因> fdx=<值|na> fdy=<值|na> xdx=<值|na> xdy=<值|na>`。`calibrated` 和响应表示上次成功结果；失败/取消后仍可读取。前后响应单位像素/mm，X响应单位像素/电机轴度。网页单独解析此回复，不覆盖普通 `grab state=...` 快照。当前普通任务通过 `operation=calibration` 标识标定。

2026-10-09：`ArmVision`、`MaterialVision`、旧后退搜索以及 `vision`/`material` 命令组已退役，只回复 `ERR retired` 与替代入口，不自动转成运动、不取消正在运行的任务或待执行重启。静态对准使用 `grab align color <1..6>|ring <1..3> [z_mm] [stay]`；响应标定移入 `grab_calibration` 并由 GrabTask 唯一调度、轮询及停车。PE2在OLED概览页不启动旧对准，舵机测试页的PE2选择保留。见[退役记录](../开发记录/2026-10-09-MaterialVision退役与控制台保留.md)。

底盘 `velocity`、无距离的 `backward`、`hold` 与 `run/heading/MoveTo/turn` 共用 ChassisMotion 任务状态；`velocity` 持续到显式停车，允许直接更新目标，不以60秒定时任务代替。`hold` 保留捕获当前模块航向、驱动档位20与原时间/速度范围，常规路线/定时曲线仍使用驱动档位0。视觉静态/动态输出已计算自己的加速度约束，直接交给 Mecanum 总线执行，不另套 ChassisMotion 曲线。`chassis status` 的 hold 字段保持兼容；`chassis task` 查询共用运动任务。

路线命令被拒绝时，`ERR chassis route` 仍携带实际路线状态与进度，`reason` 说明本次拒绝原因：`format`（命令或数字格式）、`speed_range`（超出10～5000 mm/s）、`route_reserved`（路线运行或工位交接占用）、`motion_busy`（其他底盘运动占用）、`next_requires_waiting`（不处于手动待继续阶段）、`stop_failed`（取消时停车请求失败）。进入执行后的失败继续使用原路线故障原因；普通拒绝不清除进度，后续 `chassis route status` 返回实际路线原因。

## 主控重启与 Z 轴归零

| 命令 | 用途 | 条件与结果 |
|---|---|---|
| `system reset` | STM32 软件复位，重新执行启动初始化 | 人工确认整车静止，软件任务及通信空闲；不是整车断电，也不代替停车 |
| `imu zero` | HWT101 当前 Z 轴角度设为零 | 保持静止；不标定零偏、不保存参数，不授予航向控制资格 |

`system reset` 先回复 `OK system reset pending target=stm32 peripherals_not_reset=1`，紧急回复完成 USART1 发送后再等待 200 ms，通过 CMSIS `NVIC_SystemReset()` 请求主控复位。200 ms 只是无线链路留时，不保证网页收到。发送失败或超过 5 秒取消重启；等待期间拒绝新业务命令，Ctrl+C、`chassis stop`、合法的 `stop all/base/z/x`、`grab stop`、`camera stop` 可取消重启并执行各自原有停止操作。忙时返回 `ERR system reset busy`。主循环卡死或无线链路中断时无法依靠此命令恢复。

忙检查反映软件任务与通信事务，不是整车静止检测。机械臂 `pos/home` 收到驱动 ACK 后仍可能在运动；发送重启前必须人工确认整车静止。

重启后 RAM 中的任务、验证、地图锚点及订阅重新初始化；电机驱动器、HWT101、香橙派等外部设备并未断电复位，夹爪 PWM 会经历启动初始化。网页收到 `STM32 mechanical arm console ready` 后清除旧状态；请重新验证 IMU、准备跑图和手动开启订阅。本地服务停止锁定期间两条命令均不允许发送，须先确认停车并解除锁定。

`imu zero` 异步执行解锁 `0x69=0xB588` → 等待 100 ms → `CALIYAW 0x76=0` → 等待 100 ms → 读取后续新样本。受理回复为 `OK imu zero started ...`；结束回复 `OK imu zero sample before_deg=... after_deg=... verified=0 control_ready=0`。这表示已收到写入后的样本，是否接近零由实际 `after_deg` 判断；不是漂移验证通过。`imu status` 中结果为 `ZERO_SAMPLE`。I2C 失败、无新样本和取消流程沿用现有标定错误报告。归零会撤销旧航向资格与地图锚点；跑图前重新 `imu verify` 并设置地图起点。`imu cal cancel` 也可取消归零流程。

## 补充接口与操作语义

网页全局停车、原始Ctrl+C及`chassis stop`共同取消自动任务，并覆盖手动Base/X/Z位置运动、四轮及ID8。机械臂任务空闲时补发优先`stop all`；任务占用时保留既有任务中断流程。夹爪输出、Z使能和有效参考保留。`chassis stop-status`中的`wheels_stopped/stop_confirmed`仍仅代表四轮，不能据此确认其他机构停稳。

本地HTTP层（不增加串口命令）：`GET /api/status`返回`command_epoch`；`POST /api/send`对非只读、非停车动作要求携带整数`command_epoch`且等于当前值。模块停止、全局停止、主动断开递增该值并取消旧队列，旧HTTP动作即使随后入队也拒绝；只读和停车可跨代次执行。队列回复及事件携带当前代次，网页只允许新的显式动作，不重放旧请求。`POST /api/resume`要求`stop_token`匹配当前停车请求的token，服务端在同一锁内核对并解除；旧解除不影响后来停车。可信同步CMD入口保持原命令操作，HTTP字段由网页自动维护。

- `chassis stream on <非零uint32会话编号>` / `chassis stream off`：手动遥测订阅。
- `chassis stop [非零uint32客户端编号]`、`chassis stop-status`：独立停车与查询，详细语义见下文。
- `screen status`：读取 USART3 屏幕通信统计，可通过手动终端发送；不属于网页快捷按钮。
- `imu verify 5` 是 `imu verify` 的兼容别名。`imu verify 120` 已移除，返回格式错误。
- `imu cal clear` 为兼容入口，取消当前标定/验证并清除本次验证资格；`imu cal forget` 返回 `ERR imu cal forget deprecated no_erase=1`，不擦除存储。它们不恢复旧软件补偿方案。
- `chassis run vx vy 0 hold_ms` 保持起步模块航向，须本次 IMU 验证通过且数据新鲜，不要求地图原点；非零 omega 执行给定转向。`chassis heading` 仍需锚点。
- `imu cal start` 依次解锁、写 `WORKMODE 0x48=1`、等待20秒、重新解锁并写 `0x48=0`、回读正常模式及零偏，再写 `CALIYAW 0x76=0` 归零，从后续新样本起验证30秒；通过后重新解锁并发送 `SAVE 0x00=0`，回读模式及零偏。寄存器步骤间隔至少100 ms，因此总耗时略长于50秒。独立 verify 同样先归零，再静止验证5秒。原生标定、归零及重新验证都会撤销旧航向资格，需重新建立地图原点。
- `imu status` 的 `zero_requested/zero_sample_received/zero_before_deg/zero_after_deg` 区分归零请求与后续样本；HAL 成功不单独证明实物归零完成。
- `stop all` 的作用取决于当前任务，不能等同整车硬件急停。`grab stop` 的受理回复仅表示已请求停车，完成应以任务停车反馈为准。
- 本车已确认 Emm42 固件仅修改 ID，控制台准备流程使用默认 Receive 应答及 65536 反馈单位/电机轴圈；固件定位初始化默认采用65536，无需重复确认或实测协议常量；units命令保留作诊断配置。四轮安装方向与实际地图起点仍需确认，不能以 3200 控制脉冲/圈替代反馈单位。`chassis reset-confirmed` 不操作硬件复位。

## 二维码查询与事件

查询不消费主循环任务码，跟随开关不启动扫码器。

| 命令 | 含义 |
|---|---|
| `qr status` | 读取接收统计，不消费任务码 |
| `qr read` | 读取最新有效缓存，可重复读取 |
| `qr stream on/off` | 开启/关闭新码事件上报，不控制扫码器 |

回复形式：

```text
OK qr status valid=0 seq=0 age_ms=NA received=0 accepted=0 rejected=0 uart_errors=0 stream=off event_dropped=0
OK qr read valid=0 seq=0 code=NA age_ms=NA
OK qr stream=on
EVT qr code seq=1 code=123+231+312+123 age_ms=0
```

有效原码为四组三位数字；`seq` 与 MCU 毫秒时间为 uint32，可回绕。`age_ms` 是 MCU 计算的最新有效码年龄，没有有效码时为 NA。`received` 按字节、`accepted/rejected` 按完整帧、`uart_errors` 按 UART 错误计数。重复有效码同样递增序号；没有新码不表示离线。新码事件最多 5 Hz，只保留最新待发事件，`event_dropped` 与地图丢弃统计独立。格式化与发送在主循环运行；主循环原单次消费接口保留。

详见 [八千代控制台与二维码接入](../开发记录/2026-09-12八千代控制台与二维码接入.md)。

## 实车反馈距离与完整路线

### 独立路线加速度测试

`chassis test <forward_mm> <left_mm> <speed_mm_s> [linear|cosine]`：以受理时车头为参考，前向为正、左向为正；合位移大于0且不超过3000 mm，合速度10～5000 mm/s。固件换算到当前地图坐标后调用与普通路线相同的 `ChassisMotion_MoveTo`，保持起步航向，采用所选linear300或cosine K200，省略为linear，共用反馈制动，不改变比赛速度参数或驱动加速度档位。

需要有效地图参考、已验证IMU及新鲜四轮停稳反馈。独立测试可在初始化完成后显式发送 `chassis origin 0 0 0`，把当前位置作为本地测试起点；该命令替换地图定位但不复位IMU。已有有效参考时无需重新建立，连续测试均相对当前朝向。正在运行或保留工位占用的路线不能被该测试接管。

例如 `chassis test 1000 0 1000` 前进1 m，`chassis test 0 -500 1000` 右移500 mm。回复 `OK chassis test reason=accepted id=... profile=linear|cosine` 仅表示受理，`chassis task` 查询实际状态/目标/反馈；`chassis stop` 请求停止，完成以新鲜反馈确认为准。测试超时按距离/速度加余量计算，最短60秒、此接口最长385秒，不是每次固定运行时间。

`chassis task`对距离任务另返回`OK chassis test_result id=... state=... profile=... elapsed_ms=... peak_mm_s=... error_mm=... stop_ms=... stop_confirmed=...`。elapsed_ms含停车确认，完成后冻结；peak_mm_s来自新鲜四轮转速正运动学的平移合速度；error_mm为最终反馈位置与目标之差的模；stop_ms为末次停车请求到确认的耗时，停车中为已等待时长。state=3且stop_confirmed=1才是成功结果；其他状态不代表已到位。单段测试在比赛存在待续接进度时拒绝，不能用它切换比赛模式。

网页入口为“底盘 → 底盘单段运动测试”，支持八方向，默认500 mm、1000 mm/s；斜移按合距离归一化。原 `chassis move` 的300 mm/50 mm/s与 `chassis run` 的定时曲线保持原语义，原地转向使用其独立控制器。

### 既有距离与路线接口

`chassis move <map_dx_mm> <map_dy_mm>`用于相对地图位移诊断（长度>0且≤300 mm、50 mm/s）。`chassis turn <map_yaw_deg>`使用地图绝对航向，纯转向时平移输出为零，保留原点与IMU锚点；`chassis heading`仍使用模块角度。原点需显式`chassis origin`设置。

底盘直线平移提供linear与cosine两种模式：linear为默认，软件向量加减速度300 mm/s²；cosine为K=200、名义400 ms半余弦速度过渡，短段降低峰值。两者都计入反馈年龄和驱动响应的制动余量，共用1000 mm/s路线默认速度、工位局部限速、位置/航向及新鲜停稳判定。除线性模式恢复分段开局外，其他连续转弯和原地转向保持现行独立控制。线性制动用恒加速度刹车距离反解，余弦制动用曲线剩余积分反解。保留Kp=2.5末端收敛、20 mm内50 mm/s限速及停车后20 mm/s纠偏，完成仍核验实际位置/航向和新鲜四轮停稳反馈。连续转弯向量变化率保留300 mm/s²，弯道结束从当前速度衔接；页面平移速度不控制旋转，路线转向采用100°/s上限。首个目标内部按(2250,150)→(2100,300)→(2100,1200)执行，保持180°斜移，在(2100,300)顺时针转至90°再直行，中间点不触发工位交接；雷达规划的其他绕行路点不变。长段先转向再前进或后退，到工位恢复90°；暂存位在(425,1200)转向，最后75 mm进出不超过min(启动速度,50)。start模式每个业务目标完成后等待人工next，内部阶段自动连续执行；auto模式业务目标停稳后直接继续，附加停留0 ms。每个转向/行驶动作更新action_id，业务segment/visit保持不变；取消任意阶段后不再提交后续动作。段预算包含转向和接近，范围60～400秒，修正不延长原截止时间。完整目标及实车检查见[低速转向路线与验收顺序](../开发记录/2026-10-03-底盘低速转向路线与验收顺序.md)。

`@CHASSIS`详细快照为v1，紧凑流为v2；原route对象/数组布局保留，增加可选状态：

- `localization`：generation、feedback_tick、origin_valid。
- `route`：state（idle/running/stopping/waiting/done/error/cancelled）、reason、segment（固定路线1～15，规划路线动态）、action_id、target（业务目标地图X/Y mm、航向deg）、error、feedback_valid、stop_confirmed。
- `route_meta`：action_id、total、station、visit、phase、direction、speed_mm_s（本次启动设置）、phase_speed_mm_s（当前阶段限速）、phase_target（内部目标X/Y/yaw）、planned。只与同帧同action_id的route合并。phase可为turn/move/arrival_turn/dock_approach/dock/undock；direction可为turn/forward/reverse/lateral/diagonal。
- `distance`：距离或原地转向任务输出；active、state、reason、action_id、target/error数组及feedback_valid、stop_confirmed。独立move/turn清除旧路线显示；活动路线段显示优先。

`feedback_arrived`和stop_confirmed表示轮子反馈估计到站并满足停止条件，不表示视觉精确对准。等待人工继续期间仍占用任务；查询/停止允许，其他运动/标定/修改定位配置拒绝。详见[实车前四段反馈路线](../开发记录/2026-09-12实车前四段反馈路线.md)。

## USART1 DMA、诊断与发送节奏
USART1 使用 DMA2 Stream2 / Channel4 循环接收，128 字节 DMA 缓冲，IDLE、半满、全满事件读取实时 DMA 写入位置并投递到 512 字节软件环形缓冲。命令在主循环解析。接收损坏/溢出后丢弃到下一换行；Ctrl+C 始终单独锁存，随后由主循环取消运动生产者并请求停车。UART 错误在主循环恢复 RX，不在错误中断中执行阻塞重启。

发送使用 DMA2 Stream7 / Channel4 普通模式，最多64字节一段，不再添加固定30ms等待；DMA完成后下一次主循环继续发送。已开始的完整遥测帧和文本行不被其他消息插入。边界处按以下顺序选择：停车回复 → 普通回复 → 二维码事件 → 地图遥测 → 雷达分页 → IMU/视觉调试。停车回复有独立 1 KB 队列；普通回复 8 KB；IMU/视觉各一个 320 字节最新值槽、每路发送开始间隔至少 500 ms。连续调试更新覆盖未发旧样本，不占普通回复队列；关闭对应输出取消未发样本。

优先级不能抢占正在发送的完整帧，也不能保证无线送达。旧32字节/30ms为历史试调参数，当前已改为64字节且取消固定等待；115200 / 8N1的UART理论字节率11520 B/s不是DL-20无线净吞吐。DMA只减少CPU中断开销，不提高空中链路带宽，取消等待后的无线完整性需实测。

手动诊断命令（不增加专用按钮）：

| 命令 | 含义 |
|---|---|
| `console status` | RX 字节数、软件溢出次数/峰值、UART ORE/FE/NE/DMA 错误；TX 完成字节数、普通回复排队量/峰值及各类丢弃；接收重启成功/失败次数 |
| `chassis snapshot` | 按需输出完整 v1 底盘状态 JSON，不自动开启遥测；未订阅时 session 可为 0 |

`rx_peak` 最大可用值 511，`reply_pending` 只计算尚未取出的普通回复，不包含正在发送的一段。`tx_bytes` 统计 MCU 发送完成，不代表电脑收到；失败段可能已发部分字节而未计入。`debug_dropped` 包括最新值覆盖/取消/拒绝/发送失败，`dropped` 仍是地图软件统计，均不能当作无线丢包率。所有计数掉电重置，uint32 自然回绕。

## 地图紧凑遥测 v2

订阅仍为 `chassis stream on <session>`，先发送 **v1 config**，之后定期发送 **v2 state**。最短状态生成周期仍为 2000 ms，发送积压时延后生成。网页同时兼容 v1 对象状态与 v2 紧凑状态；新固件须使用本次更新的本地控制台。

v2 保持 `@CHASSIS ` 前缀和 JSON；根字段 `v/kind/session/t_ms/trace_seq/dropped` 保持名称，以下字段改为定长数组。单位和数值精度不变，四轮顺序仍是 FL/RL/RR/FR；数组长度或类型错误会清除当前状态，不能补造有效值。

| 字段 | 数组顺序 |
|---|---|
| `task` | `[state, reason, id, control_dt_ms]` |
| `target` | `[vx_mm_s, vy_mm_s, omega_rad_s, rpm_FL, rpm_RL, rpm_RR, rpm_FR]` |
| `feedback` | `[[rpm×4], [raw_position×4], speed_valid_mask, position_valid_mask, [speed_ms×4], [position_ms×4], seq, span_ms]` |
| `yaw` | `[valid, rad]` |
| `pose` | `[[command_valid,x_mm,y_mm,yaw_rad], [feedback_valid,x_mm,y_mm,yaw_rad]]` |
| `localization` | `[generation, feedback_tick, origin_valid]` |
| `route` | `[state,reason,segment,action_id,[target_x,target_y,target_deg],[error_x,error_y,error_deg],feedback_valid,stop_confirmed]` |
| `distance`（仅位移模式） | `[active,state,reason,action_id,[target_x,target_y,target_deg],[error_x,error_y,error_deg],feedback_valid,stop_confirmed]` |
| `tx` | `[seq,stage,error,ack_profile,tx_complete,acknowledged,acknowledged_wheels]` |

valid mask 的 bit0..3 对应四轮，取值 0..15；其余有效性字段仍为 JSON boolean。网页先展开为具名字段，再复用原来的地图、四轮数据和准备跑图检查。没有删掉停车/新鲜度判断所需字段，也不把“估计到站”改成视觉精确到站。

config 的 `telemetry_period_ms` 当前为 2000；旧 config 没有该字段时按 200 ms 处理。首次配置等待 8 秒，配置后接收超时为周期三倍；重复/乱序 MCU 时间丢弃，配置或 trace_seq 变化断开轨迹。反馈估计仍要求四轮位置、采样时间及航向有效，网页依据 MCU 时间检查 600 ms 新鲜度。`stream off` 取消未发地图快照，已开始的帧发送完整后结束。

历史限速依据见[2026-09-12 记录](../开发记录/2026-09-12无线地图遥测限速发送.md)，2026-09-22当时实现及验证见[USART1 DMA 整理](../开发记录/2026-09-22USART1-DMA与无线输出整理.md)。

## 本地服务与独立停车查询

当前网页共享模式从设备列表手动选择串口，不默认选择 COM 号；通信格式默认 115200 / 8N1，由本机服务独占，网页和 CMD 共享接收事件。服务只监听 `127.0.0.1:8765`。GET `/api/status` 获取启动会话 token；POST 须携带同源 Origin 及 `X-Console-Token`，脚本同样遵守这两个请求头。

| 接口 | 用途 |
| --- | --- |
| GET `/api/status` | 连接、停车、配置、准备锁定与最新事件编号 |
| GET `/api/events?after=N` | 读取编号之后的事件；gap 表示记录窗口已过期 |
| GET `/api/ports` | 只读枚举端口号及设备名称，不打开串口 |
| POST `/api/connect` | 显式 `port`、`baudrate`，网页传入用户选中的端口、默认115200 |
| POST `/api/send` | 单条 ASCII `command`；返回排队编号，不等于发送完成 |
| POST `/api/stop` | 清空待发命令、取消准备、锁定运动并优先停车 |
| POST `/api/resume` | 明确解除软件停止锁定，不启动任务 |
| POST `/api/disconnect` | 先请求停车、最多等待 6 秒，再释放串口 |
| POST `/api/config` | 保存人工确认的 profile、units_per_rev、directions_confirmed |
| POST `/api/preparation` | active、owner；限定准备所有者的配置命令，其他来源只允许取消/停止，查询回复也由准备所有者独占；150 秒超时释放 |

事件包括实际 TX、原始 RX 行、连接变化、停止和系统信息。浏览器使用 TX 事件确认已经写入串口；设备处理和物理执行仍以各自回复判断。原始字节和分块时间保存在 `.embeddedskills/logs/serial/`。

2026-09-14 修正：事件对象 `id` 始终为递增流游标；停止事件的 MCU 停车编号使用 `stop_id`，不可覆盖事件 `id`。GET status 返回的 `stop.id` 保持为 MCU 停车编号。

固件新增原始 `0x03`（Ctrl+C）处理，清除未完成输入、取消底盘路线及可继续驱动底盘的自动任务。`chassis stop [非零uint32客户端编号]` 与 `wheel stop` 共用同一停车入口。客户端重发同编号不会重建请求；新的运动会使旧停止确认失效。普通手动停车可省略编号。

`chassis stop-status` 和停车受理返回：

```text
OK chassis stop id=1 token=123 requested_ms=100 tx_complete=0 wheels_stopped=0 reason=pending_tx
```

`tx_complete` 是电机总线停车发送完成；`wheels_stopped` 是发送后至少三组新鲜四轮反馈覆盖 500 ms、各轮速度绝对值 ≤1 RPM、相邻位置变化 ≤2 mm 的独立停止确认。无需到达地图目标、设置地图单位或有效 IMU。停车请求临时获取全四轮速度/位置，按 Emm 固定 65536 单位/圈解释；原轮询关闭或单轮选择也能执行。完成/失败释放临时采集需求，保留用户及任务最近的轮询开关/选择。确认结果作为该 token 的历史结果保留，直到新运动或新请求使其失效；不是永久静止监视。常见 reason 为 pending_tx、monitoring、stopped、missing_feedback、timeout、new_motion、tx_failed。

停车通信节奏（2026-09-22）：立即发送一次 Ctrl+C 和带编号停车请求，不再附加无编号文本停车。未受理时每2秒重试同一编号，最多3次；受理后每2秒查询停车状态以兼容旧固件。2026-09-29 起固件在受理、发送完成、四轮确认或原因变化时主动上报同一格式（包含 token），匹配确认到达即关闭等待中的断开流程，不再等待下一次查询。总等待6秒，超时停止自动发送。连接未断开、未解除锁定且编号匹配的迟到回复仍可更新发送/停止结果，不重新启动查询，不自动解除锁定。

软件请求发出、MCU 受理、发送完成和反馈停止分开显示。旧固件的通用 OK 不能完成本次停车确认；无线失联不能保证停车。详见 [共用控制台与停车记录](../开发记录/2026-09-12COM23共用控制台与软件停车.md)。

### 同步取消后的只读诊断

单台电机通信排查使用 `bus test 4 10`（示例：ID4、10轮），不需要先恢复全部电机。任务必须空闲且当前停车发送已结束；已在发送的普通读请求先完成或超时，然后等待线路安静100 ms。测试每轮仅向选中ID依次发送 `3A`状态、`36`位置和`35`速度查询，不发送运动、使能、回零或参数写入；其他普通总线提交与排队读取暂停，测试结束后恢复原有轮询设置。紧急停车可以打断测试。

原始回复为 `OK bus test reply id=4 round=1 func=0x3A reply_ms=2 hex=04:3A:03:6B`。拒绝、超时和UART错误使用ERR前缀。`bus test status`仅查询缓存；完成报告包含 `attempts/sent/received/timeouts/uart_errors/rejected/max_reply_ms/last_uart_error/locked/reason`，分别是提交次数、发送完成数、有效回复数、超时数、传输错误数、驱动拒绝数、最大回复耗时、最近一笔UART错误、共享运动锁定和测试阶段；一轮有3笔请求。`received`是有效协议回复，不表示使能或回零正常，须根据原始状态字判断。

总线已锁定时仍可进行上述选定ID的只读测试；一次超时后仍可继续查询或结束后换测其他ID，不清除首次故障、不解除运动锁定。当前错误由`last_uart_error`记录，`info`保留首次故障，两者可能不同。`bus test stop`只结束诊断；实际停车仍用既有停车命令。

软件只隔离其他ID的主动查询。所有驱动共用TTL线路，其他节点的电气干扰、重复地址或线序问题仍可能影响目标；正常回复只证明当前查询有响应，不能单独确定干扰源。需要物理支路对照时全断电后再调整接线，按已确认硬件保持正确共地。

运动中停车可能保留 sync_cache_uncertain / locked=1；这表示运动禁止，不应解释为所有状态查询失败。取消底盘运动应答造成隔离时，已开启的四轮反馈可在停车发送结束后继续读取。真实UART故障/超时仍阻止轮询。chassis stop-status 的 wheels_stopped 与运动解锁独立，确认停止不会自动恢复运动。

普通通信锁定可用 `bus recover` 请求停止任务并进行免断电检查，`bus status` 查询结果。检查全部 ID1～8 的速度、故障及回零状态，通过后解锁共享总线，不自动归零或续跑。恢复期间普通命令被拒绝，停止仍可取消恢复。网页停止锁保持不变。

2026-10-06起，`bus recover`也处理停车打断非零同步批次后的缓存不确定锁定：保持旧排空及ID1～8三轮速度/状态/回零检查；随后给ID1～4各写入同步F6零速目标并核对Receive应答，再逐地址发送FF同步、核对应答，最后重新读取四轮速度/状态/回零反馈，全部通过才解锁。严禁广播触发ID5～8。成功回复增加`chassis_cache=cleared wheels_stopped=1`；过程原因依次为`zeroing_chassis`、`syncing_zero`、`verifying_zero`。驱动拒绝、超时、仍运动或人工取消均不解锁，可处理原因后重试同一指令，不自动续跑、不清有效参数或追踪参考，也不重充接近预算。新的运动请求使上一份缓存恢复证明失效。网页停止锁仍需人工解除。

`chassis reset-confirmed`仍保留，仅用于驱动器已经实际复位后的确认，不是强制解锁指令。若`bus recover`返回`chassis_ready=0`，查看`bus status`/`info`的具体原因，不把命令受理当作恢复成功。历史流程见 [电机总线恢复与手动操作检查](../开发记录/2026-09-27-电机总线恢复与手动操作检查.md)。

2026-10-06零速停车修正：中断明确四轮RPM全0的同步F6批次，且不存在此前非零/未知同步缓存时，不制造同步缓存不确定锁定；停车仍优先发送。取消中的零速F6 Receive应答使用排空流程处理，避免晚到ACK污染后续事务；排空超时仍报真实总线故障。后续运动重新写入全部四轮目标再同步，不将此例外用于非零运动批次或既存故障。

## 上电默认行为
### 控制台参数保存边界
`grab set <key> <value>` 和 `config <axis> <rpm> <acc> <limit_pulses>` 修改 STM32 RAM 参数，沿用现有忙状态和取值范围检查；读取成功只确认当前运行值。STM32 复位/重新上电后重新初始化为已烧录固件默认值，机械参考仍需按现有回零与验证流程建立。运行时命令不改写源码宏定义，也不写入 Flash。

网页路线速度只保存到浏览器本地设置，抓取参数的网页预填值只决定输入框内容；它们都不等于固件默认值或 MCU 掉电保存。当前未提供这些参数的保存/加载命令或上电 Flash 加载流程。W25Q128 存储接口和默认关闭的读 ID 诊断完整保留，参数持久化属于后续独立需求。

Emm42 应答方式固定按已确认的 Receive 默认配置初始化（`chassis task` 中 `ack=2`），不修改驱动器寄存器。控制台与准备跑图均不再发送 profile 设置。

外设初始化完成后自动等待 HWT101 新鲜数据（最多 5 秒），只启动一次 Z 轴归零及完整 5 秒静止验证；请从上电起保持整车静止。通过后 `verified=1 control_ready=1`；失败保持禁止依赖航向的运动，不自动反复归零，可用 `imu verify` 或 `imu verify 5` 手动重试。取消等待不会再自动启动。

验证成功后的运行期 I2C 异常、数据过期或超过 300 ms 的采样间隔只暂停 `control_ready`；连续两帧不同更新编号的新鲜有效角度且没有新增 I2C 错误后恢复。重复读取缓存不计入恢复。`reason=control_data_invalid` 表示暂停，`control_data_recovered` 表示恢复；累计错误统计不清零。恢复不写 IMU 寄存器、不归零、不保存、不自动重启停止的任务。验证失败、取消、仅归零、模式未确认或原生标定保存失败均不通过此路径恢复。

以上恢复描述仅表示IMU标定模块的资格恢复。当前系统级缺陷[P002](../待解决问题.md#p002--imu短暂异常导致地图锚点及原点丢失)：底盘在角度暂时不可用时仍清除地图航向锚点，定位模块随即清除原点；资格恢复后不会恢复地图定位。短暂异常保留有效定位的要求仍有效，尚未实现完整恢复；已出发比赛不能通过重设名义起点绕过此问题。原生标定或显式归零真正改变模块角度原点时，作废旧定位仍是预期行为。

### 标定异常及I2C BUSY恢复

读取失败后沿用每秒一次地址探测；连续两次重探测返回 `HAL_BUSY` 时，仅对主控已配置I2C2执行 `HAL_I2C_DeInit` / `HAL_I2C_Init`，再探测并读取新角度。沿用100 kHz、PB10/PB11及现有模块地址，不发送模块复位、标定、归零或保存命令，不清除角度更新编号和累计错误。单次BUSY、随后正常的短暂故障及普通无应答不触发此初始化；恢复失败后仍保持不可用，可在后续探测中继续尝试，累计次数只供诊断。

标定已开始后发生通信异常，原生流程中止并进入正常模式恢复。恢复最多等待5秒，涵盖每秒重探测及局部BUSY恢复；链路未就绪时不消耗三次模式退出尝试。通信恢复后重新解锁、写 `WORKMODE=0` 并回读；恢复成功仍报告原标定失败，未完成本轮30秒验证时不保存、不授予控制资格。5秒内不能确认正常模式返回 `normal_mode_unconfirmed`；排除故障后显式 `imu cal cancel` 重试退出，再用 `imu verify` 验证，或在整车静止时显式重新原生标定。取消恢复保持取消语义，不自动重跑原生流程。

失败终端新增 `[IMU FAULT] first_reason / first_HAL / error / state / op / reg / tick / reinit_count`，保留本轮首次失败，最终 `reason/HAL` 仍表示流程结束原因。`imu status` 另报告驱动最近失败的 `last_HAL/error/state/op/reg/fault_ms`、`probe_failures/reinit_count/reinit_HAL`；op为0探测、1读取、2写入、3局部初始化，reg为寄存器地址。HAL=0/1/2/3分别为OK/ERROR/BUSY/TIMEOUT；state及error为当前HAL包的原始状态/错误码。未就绪的入口拒绝不证明模块内部零偏未曾变化，后续新请求会建立新的本轮诊断；第一次原生异常的完整终端日志应保留。

5 秒是归零后采样窗口，不包含初始化、等待传感器或无线传输耗时。漂移阈值 0.01°/s、残差 RMS 阈值 0.1°、最大样本间隔 300 ms 保持不变；短时通过不代表长期温漂或断电保存验证。`imu cal start` 仍是手动 20 秒原生标定加 30 秒验证。

自动模式使用 `waiting / auto_dwell` 表示停稳后的1秒等待，手动next在自动模式下被拒绝。总线故障、反馈失效和取消操作中止自动继续。末段等待结束后为 `done / route_complete`。查询附加 `auto`、`total=16`、`dwell_ms=1000`；自动流程不执行扫码与抓放，离线编辑也不会上传目标点。

## 距离任务停车与纠偏
历史距离控制曾按刹车距离提前限制速度，Kp=1.5、软件加减速度100mm/s²；这些数值不再代表当前实现，当前双模式直线规划见本协议距离路线章节。可设置1000mm/s不表示每段实际达到此速度；短段会受制动距离限制。末端期望速度限制20mm/s。

`position_correcting`表示已确认停稳后进行低速位置修正（误差≤100mm且航向合格，最多两次）。`position_not_reached`与`stop_confirmed=1`表示已停稳但未到位，路线不会续跑。`stop_unconfirmed`表示停车反馈未在3秒内确认。以上反馈仍基于编码器，不代表视觉精对准。完整说明见开发记录《2026-09-22距离制动与停稳纠偏》。

2026-09-25 历史参数：路线省略速度时使用5000 mm/s；自动模式确认停车后再等100 ms，查询返回`dwell_ms=100`。距离控制Kp=2.5、加减速度1000 mm/s²，末端20 mm内限速50 mm/s；停车后的纠偏另限20 mm/s。2026-10-03已将默认路线速度改为200 mm/s、加减速度改为300 mm/s²，上限仍为5000 mm/s；`chassis move`仍为50 mm/s。历史数值不代表当前默认值，实车带载加速度和停车距离需独立验收。

## 现行时序与恢复边界

UART5普通事务在匹配Receive完整应答后保留2 ms非阻塞交接；紧急FE/9C按TX完成推进、保留TX后2 ms停车链。USART1采用64字节DMA分块，不设全局30 ms等待；正式雷达结果仍使用独立100 ms非阻塞页调度。ACK、发送完成、停车确认分别解释。总线恢复检查ID1～8，成功不自动续跑，不清参数/参考；同步缓存仍不确定时保留对应运动限制。

## 两起点扫码控制测试（2026-10-11）

`grab qr begin [upper|lower] [speed_mm_s]`：默认50 mm/s，范围10～200；省略起点仍为原右上测试。先验证已完成机械回零参考、扫码下降参数及所选起点；进入preparing自动选择并开启四轮反馈，等待新鲜速度/位置后行驶。右上显式设置`chassis origin 2250 2250 -90`，从 `(2250,2250,-90°)` 经 `(2100,2100,-90°)` 到 `(2100,qr_scan_y,-90°)`。右下显式设置`chassis origin 2250 150 180`，再执行`grab qr begin lower 50`：保持车头朝左180°斜移到 `(2100,300)`，确认到位后原地顺时针90°至车头朝上90°，完成转向后直行到 `(2100,qr_scan_y)`。两者共用原IMU、四轮新鲜反馈与停稳确认；测试不自动设置起点。右下扫码测试与普通固定、雷达路线统一使用180°初始朝向。

`grab qr status`输出`OK|ERR grab qr state=idle|preparing|driving|scan|stopping|done|cancelled|error code=none|DDD+DDD+DDD+DDD reason=... elapsed_ms=...`。`done`仅在本轮真实UART任务码已接收且机构停车反馈确认后成立；任务码的显示沿用主循环二维码缓存到串口屏的既有接口，本状态不代替屏幕接收确认。`grab qr stop`、`grab stop`及全局停止均取消继续推进；查询可在任务忙时执行，停止可打断等待。

两起点路线均在 `(2100,qr_scan_y)` 到位停稳后原地转180°：右下由90°转至−90°，右上由−90°转至90°，转向使用既有IMU航向闭环和四轮停车反馈，阶段为`driving/qr_scan_turn`。转向预算计入此段超时；转向中取消、驱动故障或停车未确认均不进入Z扫码。正式固定路线及搬运任务的二维码经过点保持原行为。

底盘完成180°转向且确认停车后，等待`qr_wait_ms`；无本轮新UART码时仅Z轴以`qr_z_speed`下降到`qr_z_min`。Base/X不发位置运动；保留夹爪输出。新二维码收到时停止下降，沿既有停车流程确认；到下限未扫码进入`qr_lower_wait`，等待qr_wait_ms后以同速返回扫码开始时的实际Z高度（`qr_ascending`）；返回停稳后保持`scan/qr_not_found`。一次往返途中收到新码立即停车；人工取消不会自动返回或续跑。驱动真正保护、失能或下降期间反馈失效仍走故障停车。启动前缓存/模拟结果不作本轮成功。

扫码参数默认`qr_scan_y=1200 mm`（1100～1300），`qr_z_min=-50 mm`（−150～0且必须符合现有机械Z边界），`qr_z_speed=5 mm/s`（大于0～20且须可换算驱动RPM），`qr_wait_ms=1000 ms`（0～10000）。均由`Code/template/App/grab_parameters.def`定义，使用`grab get/set`读写，仅RAM有效。

位置依据：[官方命题与运行](../赛事资料/智能搬运赛题/原始资料/附件2-1-第九届中国大学生工创大赛智能+工程创新赛道命题与运行.pdf)第3页图1、第6页二维码说明。图1启停区1位于右上，二维码板沿右侧1100～1300 mm范围随机摆放；1200是区域中心的测试默认接近点，不是固定板位或自动定位结果。
