doinbest/Yachiyo/xjx/模版搭建/docs/开发记录/2026-09-12八千代控制台与二维码接入.md

# 八千代·巡航控制台与二维码接入

日期：2026-09-12。状态：软件交付，未烧录、未连接实车、未发送实车指令。

## 实施基线与边界

按作者批准的“八千代控制台改版实施计划：基于已交付的底盘与地图基线”完成三阶段：网页结构/命令、二维码桥接、集成验证。本轮开始前已保存 `.embeddedskills/backups/yachiyo-20260912-020017.zip`，保留原有未提交修改。没有修改 CubeMX、Keil 源文件列表、底盘控制算法和地图运动学。地图页仍单次挂载，共用 USART1 连接；原生 USB CDC/B2 保持原用途。

本轮文件：

- `upper-computer-web/local-car/index.html`、`styles.css`、`app.mjs`：品牌、六模块、表单、公共终端、背景和状态。
- `protocol.mjs`、`serial.mjs`：新增命令定义/校验/分类，更新版本化引用。保留原 ASCII/CRLF 通道。
- `map-view.mjs`：仅增加经过现有遥测状态模型确认的全局状态提示、时间任务结束文案和资源版本；不以任意 JSON 或单个数据包宣称会话有效、频率达到 5 Hz。
- `qr-panel.mjs`：支持检查、缓存查询、跟随、四组拆分、历史/当前区分；没有视频或主动扫码。
- `template/Hardware/QR.c/.h`：非消费快照、序号、接收时间、统计及 UART 错误处理；原 `QR_TaskCodeGet()` 行为保留。
- `template/App/console_tx.c/.h`：独立事件待发槽；回复优先于事件，事件优先于地图遥测。
- `template/App/arm_console.c`、`template/Core/Src/main.c`：查询命令、5 Hz 上报和 UART4 错误回调。
- 更新/新增 QR、发送队列、控制台和网页命令/解析测试，以及 README、两份规划和协议说明。

## 页面操作

名称为“八千代·巡航”，英文 `INTELLIGENT MATERIAL HANDLING · 2027`；显示“立创·天空星STM32F407VxT6开发板”。继续使用作者原始撑伞 PNG，原图与自选图片共用显示规则。

左侧六页：机械臂与夹爪、底盘、视觉任务、二维码、地图与遥测、系统与标定。机械臂选择轴后直接使能/失能/读状态/停止，相对运动独立；全部轴不能生成单轴运动。视觉三层分别为任务执行、相机调试、标定与分步测试。`material auto` 只发送一条启动命令，`ALIGNED` 显示对准完成。

底盘新的有限任务入口使用物理单位，保持时间 0.1～59 秒转换为整数毫秒，默认速度 0。界面显示保持及总时长。HWT101 模块目标角度和人工地图初始位姿分别填写；旧速度/位置/单轮/hold 测试放调试区。旧 hold 无新版起停规划。驱动参数确认不自动操作。

右侧反馈仅展示对应模块的明确回复。通用错误和无法归属的回复保留在终端；浏览器“已发送”不表示驱动应答或物理停止。`stop all` 的提示按源码修正：视觉/物料忙时优先取消该任务，否则停止全部机械臂轴；新的底盘任务忙时也会请求停止，不称为整车急停。

公共终端支持分类、跟随、导出、清空和收起；短窗口初始收起。清空日志不会清空二维码、设备状态和地图轨迹。手机宽度停止按钮固定于底部。保留 `sky-atelier-v1` 设置与 `{label,wire}` 收藏，未知收藏按手动分类原样保留。

## 二维码实现

新增 `QR_SnapshotGet()` 原子复制最新有效码、序号、接收时间与统计，不清除 ready。主循环原 OLED、串口屏和任务码分组的消费入口不变。

命令：`qr status`、`qr read`、`qr stream on/off`。查询在运动/标定互锁之前独立处理，不调用执行器。跟随默认关闭，只上报开启后的新码；旧缓存通过 `qr read` 获取。

原码格式：`DDD+DDD+DDD+DDD`，CR 或 CRLF 结束。错误帧丢弃至 CR，避免从损坏数据的合法后缀拼出有效码。重复有效码也递增序号。统计 `received` 按字节、`accepted/rejected` 按 CR 结束帧、`uart_errors` 按 UART 错误。年龄/序号采用 uint32 回绕语义。

事件使用独立单槽 `ConsoleTx_Event()`，最多 5 Hz，最新待发覆盖旧事件并计数。发送中帧不被修改；HAL_BUSY 时尚未发送内容保留在原队列，下次仍优先回复。关闭跟随清除未发事件，不中止已经发送中的帧。`event_dropped` 包含生产端跳过及发送端替换/取消/失败，不影响地图丢帧计数。

网页先显式检查支持。只有与待处理查询匹配的回复建立支持资格；超时/旧固件错误不会显示成功。重连撤销支持和跟随状态，但保留任务码历史。没有新扫码不判离线；查询不触发扫码、颜色选择或运动。

## 软件验证结果

| 检查 | 实际结果 |
|---|---|
| `python tests/run_firmware_tests.py` | PASS；包括 QR、发送队列、控制台、机械臂、视觉、HWT101、底盘及 USB B2 回归 |
| `python tests/chassis_map_contract_test.py` | 已由上述完整套件实际执行并 PASS；7 组速度及量化/限幅/脉冲基线，生产 C 遥测与浏览器契约 |
| `node --test upper-computer-web/local-car/tests/*.test.mjs` | 35/35 PASS；包括当前工作区已有路线模型测试，路线功能不计为本轮新交付 |
| JS 语法检查 | app.mjs、map-view.mjs 通过 |
| Keil `template` | 0 错误、0 警告；Flash 100108 B，RAM 36816 B |
| 浏览器 | 六页可加载；离线切页/模拟操作 TX=0；地图节点只有一个、切页保留轨迹；浅深主题及原图可显示 |
| 布局 | 1366×768、1920×1080、390×844 已检查；1920×1080 下 125% 的等效 CSS 空间 1536×864 已检查，无横向溢出。未单独操纵外部 Chrome/Edge 的原生缩放菜单 |

日志：`.embeddedskills/tests/host-tests.log`、`.embeddedskills/tests/yachiyo-web-tests.log`、`.embeddedskills/build/template-template-build.log`。

独立审查修复了：发送锁被拒绝的并发请求提前释放；`EVT qr` 未归类；地图全局提示绕过会话检查；旧 hold 误显示新版起停时长；确认下拉框缺少空选项。资源入口及修改子模块已更新版本标识。

## 作者上板步骤

1. 双击 `upper-computer-web/local-car/start.cmd`，桌面 Chrome/Edge 打开本地地址；已有旧页面先 Ctrl+Shift+R 刷新。
2. 自行烧录本轮构建固件。页面选择实际 USART1/Zigbee COM 口，115200 / 8N1。连接本身不发送命令。
3. 二维码页点击检查支持，确认状态回复；未扫码时读取显示“—”，不是错误。
4. 用 UART4 已接好的二维码模块扫描符合四组格式的码，点击读取。反复读取应返回相同缓存，不影响 OLED/串口屏原显示。
5. 手动开启跟随后重新扫码，观察四组、序号和事件更新；重复同一码也应递增序号。关闭跟随后不再有新的事件，仍能读取缓存。
6. 断开重连，确认跟随不自动恢复、需要重新检查支持。切换模块和清日志不应清任务码历史。
7. 再手动开启地图遥测观察两类数据同时出现；二维码事件不应覆盖地图帧，命令回复仍可正常读取。关闭各订阅后结束测试。
8. 运动测试另按既有底盘/机械臂上板步骤进行。软件回归不代表扫码器、电机、Zigbee 或整车比赛动作已验收。

## 作者反馈后的纵向布局修订

作者认为固定一屏布局遮挡人物，批准恢复纵向方案。已取消页面定高和工作区内滚动，改为工作台顶部导航、左侧功能纵向排列、右侧独立完整人物。反馈移到工作台下方，终端默认展开，停止栏仍固定可见。地图继续全宽，保留同一个地图节点和终端，原路线编辑代码不变。

本次修改 `index.html`、`styles.css`、`app.mjs`（仅取消短屏自动折叠终端）。资源版本为 `vertical-1`；修改前备份为 `.embeddedskills/backups/yachiyo-vertical-before.zip`。网页 35/35 通过，日志 `.embeddedskills/tests/yachiyo-vertical-web-tests.log`。实际检查桌面 1366×900、1920×1080 与手机 390×844、浅深主题、人物滚动停留及地图节点唯一性。浏览器操作 TX=0；固件未改动，本次无需重新烧录。
