doinbest/Yachiyo/xjx/模版搭建/docs/开发记录/2026-09-14同步取消后保留只读反馈.md

# 2026-09-14 同步取消后保留只读反馈

## 问题

运动中停车中断部分同步批次，运动锁sync_cache_uncertain有必要保留，但原实现同时停止四轮查询，无法取得停车后的新反馈。

## 修改

- motor_bus.c/.h：仅取消底盘0xF6/0xFD运动应答造成的隔离可开启只读诊断权限。只允许反馈所属模块向地址1..4发送严格格式的0x35/0x36/0x3A读取，不允许其他命令借此发送。原运动隔离保持。
- mecanum_chassis.c：CANCELLED运动锁下，停车发送结束后允许已开启的反馈轮询继续。正常取消反馈事件不把已停止状态改成发送故障。
- 迟到运动ACK功能码不同，不能完成当前反馈请求。实际UART错误、超时、发送失败会撤销隔离下的诊断权限，避免旧查询回复污染新的查询。
- 保留前一轮只读取消的旧回复接收/丢弃机制。机械臂、其他事务、部分同步缓存保护不自动解除。
- 停止确认仍需要已确认位置单位与新鲜完整反馈。此次未放宽阈值、未代填65536、未修改CubeMX或网页协议。

## 验证

新增同步取消后反馈用例，修改前不能发出速度查询而失败；修改后通过。覆盖运动ACK不能冒充轮速、12项四轮反馈全部恢复、运动仍拒绝、实际UART错误关闭诊断、停止确认成功但运动锁仍保留。

python tests/run_firmware_tests.py 全部PASS，包含C/网页合同测试。
Keil template：0 errors / 0 warnings，Flash109680 bytes，RAM38616 bytes。
日志：.embeddedskills/build/template-template-build.log 与 .embeddedskills/tests/host-tests.log。
固件：template/MDK-ARM/template/template.hex。未自动烧录或操作实车。

## 上板步骤与恢复

1. 烧录后静止开启全部四轮反馈，确认持续更新。
2. 最小有限时长任务期间触发停车，检查stop-status发送完成及反馈接收时间继续更新；任务可保持sync_cache_uncertain/locked=1，这表示禁止运动仍有效，不表示只读反馈失败。
3. 已确认位置单位并满足三个新组覆盖500ms等条件才显示wheels_stopped=1。units=0仍不会通过完整停止确认。
4. 确认实物停止后，对四个驱动器实际断电复位以清除可能缓存的同步目标；主控若也重启则重新准备，若未重启则先关闭反馈并等在途查询结束，再由人工明确执行chassis reset-confirmed。该指令不是代替物理复位的清错按钮。
5. 重新核对反馈、IMU与原点，不自动续跑取消的路线。真实通信错误需先修复原因。

动态停车上板及完整路线验收仍未完成。

## COM37 上板复测：无线回复中断，动态验收无效

串口助手回复正常后接管，最初共用服务无RX；直接serial工具查询成功，相同非阻塞参数独立查询也成功，再连接共用服务恢复。四轮valid=1,1,1、rpm0，task error0 locked0 ack2。

随后IMU查询起无RX；向服务提交有限任务chassis run 20 0 0 2000并约0.8秒后提交停车，均未收到确认。停车token1436352779在6秒内未获MCU确认。停止后续动作，释放服务并用直接串口工具补发chassis stop；后续chassis task回读state3 reason cancelled dt_ms0 seq0 stage5 error0 ack2 locked0 units0。seq0不能证明运动任务执行，本次不计为动态停车测试成功。

再查stop-status和feedback仍无RX，故无法取得最终新鲜轮速。共用服务保持断开，直接串口调用已关闭端口，便于用户接管。无线链路不稳定的根因未定，不能只归因于共用服务。动态保护修复尚待稳定链路下验证。

## COM12 静止验收

接管用户释放的COM12/115200，info/task恢复，四轮valid=1,1,1、rpm0。静止统一停车token2414452576/id3，tx_complete1；task cancelled/stage5/error0/locked0。停车后再次查询四轮均有效，MCU接收时间推进到508xxx ms。units0仍使wheels_stopped未确认。

主机收取停车回复时出现数秒积压及残缺行（例如OK chassis stop ils_stopped...），6秒超时后仍持续收到查询积压。停发等待后单次四轮查询完整。没有启动动态任务；动态验收仍待稳定通信，不能把静止四轮零速当作完整停止确认。共用服务保留COM12连接与停车锁。

## COM12 动态停车上板结果：只读反馈恢复通过

设置receive，四轮全部有效后执行chassis run 20 0 0 2000，在主机提交约0.8秒后发送chassis stop。共用服务将文本stop转为统一停车（raw03/文本/令牌查询），并非单条无轮询停车。token3560653381/id3，requested_ms337803，tx_complete1。

task state4 reason sync_cache_uncertain seq10 stage5 error5 ack2 locked1 units0，运动保护保留。停车后两次完整四轮快照：MCU约375xxx与379xxx ms，全部valid=1,1,1/rpm0，位置均[3071,3263,-3161,-3249]，证明反馈未随运动锁停止且两次读数稳定。IMU前后-0.24/-0.30度，含采集间隔内零漂，不单独作为纯运动误差。

只读反馈恢复验收通过；完整wheels_stopped仍为0/missing_feedback，因位置单位未确认。未伪填单位、未清锁、未继续运动或路线。一次反馈回复缺4号行，后续两次完整；串口持续输出可靠性仍需关注。下一步实际复位驱动清除可能同步缓存并核实每圈位置单位，再验证完整停止条件、定距和跑图。

## 2026-09-14 17:35 COM12 新会话：遥测60秒通过，IMU验证失败

共用服务原已退出，重新以start.cmd --serial-port COM12 --no-browser启动CMD（PID8088），HTTP127.0.0.1:8765。info/task正常，receive应用，四轮反馈有效无总线错误。

imu verify 10：FAIL drift_or_noise，101样本，drift_dps=-0.05056，relative_deg=-0.500，rms_deg0.0039，max_gap100ms，I2C错误0。verified/control_ready=0。未据此启动航向或地图任务。

遥测session3702485289持续60.04s：config1/state29/invalid_json0，状态到达间隔1.991205..2.010327秒。最后帧四轮速度和位置valid全部true，dropped0。位姿无效来自units0、无原点、IMU未验证，不是JSON错误。日志.embeddedskills/logs/serial/telemetry-60s-20260914-173524.json。结束后显式关闭遥测并查询info，未发送运动命令。

本轮未重做之前通过的最小运动与动态取消反馈恢复；仍待IMU静止原生标定/再验证、实测每圈位置单位、恢复起点后100mm定距及路线实物验收。完整任务未宣称通过。
