doinbest/Yachiyo/xjx/模版搭建/docs/开发记录/2026-09-22USART1-DMA与无线输出整理.md

# USART1 DMA 与无线输出整理（2026-09-22）

## 范围与基线

用户在 CubeMX 关闭 CAN、添加 USART1 DMA 并配置 NVIC 后授权集成。
修改前 Git 检查点：b249e04。原有主机回归通过，Keil template 0 错误、0 警告。
本轮只做软件集成，不连接串口、不烧录、不操作电机。

## 实施清单

- [x] 输出调度：停车回复独立队列，IMU/视觉最新值槽，保留完整帧边界和无线限速。
- [x] 遥测：紧凑状态帧、浏览器解码、详细诊断按需读取。
- [x] 诊断：RX 溢出/UART 错误、TX 队列峰值及丢弃/字节计数。
- [x] DMA：RX 循环 + IDLE/HT/TC，TX 普通模式；错误恢复和 Ctrl+C 行为。
- [x] 配置与验证：恢复 4 KB 栈并同步 ioc，修复 RX Circular，清除 EIDE CAN 悬空项，主机/网页/桥接/Keil 回归和独立审查。

## 决策记录

- 在用户正在使用的项目目录内建立 codex 分支实施，保留已生成文件及现有本地服务入口，避免另建工作树导致用户继续编辑不同副本。
- CubeMX 生成的 USART1 RX 是 Normal，需要同时修正 ioc 与生成代码为 Circular。
- CubeMX 将栈从 0x1000 恢复为 0x400；恢复既有 4 KB，并同步 ioc 防止再次生成回退。
- 工程清单逐项比对确认自研模块未丢失；不回滚 CubeMX 的格式变化。EIDE 中仍有 CAN 文件项，需同步删除。
- 32 字节 / 30 ms 仍是待实测限速参数，不以 DMA 改造为由提高空中链路负载。

## 验证记录

基线日志：`.embeddedskills/tests/usart1-baseline.log`、`.embeddedskills/build/usart1-baseline/`。

## 实现与参数

- RX：DMA2 Stream2 Channel4 / Circular / High；128 字节 DMA + 512 字节软件环形缓冲。回调读取实时 NDTR，避免 IDLE 先于延迟 HT/TC 时重复消费。错误恢复只终止 RX，不中止健康 TX；损坏命令丢弃到换行，Ctrl+C 独立锁存。
- TX：DMA2 Stream7 Channel4 / Normal / Low。停车回复独立 1024 字节 FIFO，普通回复 8192 字节，IMU/视觉各 320 字节最新值槽、每路至少 500 ms 发送开始间隔。32 字节 / 完成后 30 ms 限速保留。完整文本行及已开始的 JSON 不插入其他回复。
- NVIC：UART5/DMA1 Stream0/7=1；USART1/DMA2 Stream2/7=2；UART4=3；USB OTG FS=4；USART3/DMA1 Stream3=5；SysTick=15。子优先级均 0。UART5 DMA 仲裁 RX High、TX Medium，串口屏 TX Low。
- CAN 保持停用；EIDE 删除失效 CAN 清单；栈恢复 0x1000，同时写回 CubeMX 配置。
- 地图：v1 config + v2 紧凑状态，2000 ms 最短周期。仅压缩重复字段名，保留四轮原始值、时间戳、有效性、控制目标及路线/停车语义，网页兼容旧 v1。完整 v1 状态由 `chassis snapshot` 按需获取。
- `console status` 提供接收/发送诊断，两个新增查询通过网页和本地服务的只读分类，停车锁定时允许使用。

## 软件验证（2026-09-22）

- 新增输出优先级、DMA 接收、紧凑帧及只读分类测试，均先观察缺失接口/行为导致的失败，再实现通过。
- `python tests/run_firmware_tests.py`：通过，覆盖 DMA 回绕/重复事件/恢复、停车锁存、发送优先级/帧边界、固件功能及实际 C 输出到浏览器的协议合同。日志 `.embeddedskills/tests/usart1-final-host.log`。
- JavaScript：67/67 通过，日志 `.embeddedskills/tests/usart1-final-web.log`。
- Python 桥接：18/18 通过，日志 `.embeddedskills/tests/usart1-python.log`。
- Keil template：0 错误、0 警告，日志 `.embeddedskills/build/usart1-dma/template-template-build.log`。
- 示例状态实测序列化长度：紧凑 488 字节，具名详细状态 995 字节，约减少 51%；不能将此样本当作所有任务的固定帧长。
- 链接 map：RX DMA 缓冲与 TX active 缓冲位于 0x2000xxxx SRAM，未放入 DMA 不可访问的 CCM。静态报告已知最大调用栈 1744 字节，含未知调用路径提示；4 KB 配置仍需实物栈水位验证。
- Keil / EIDE 文件路径逐项检查无悬空项，差异空白检查通过。

## 待实物验收

未烧录或发送任何实车串口命令，未改变 DL-20 模式。待用户确认硬件与烧录后，先静止检查 info / console status、遥测完整率和停车回复延迟，再比较 USART1 有线与 DL-20 无线相同输出。读取软件 dropped=0 不能证明无线没有丢字。连续数据超过 DMA 缓冲覆盖时间而中断长期不能执行仍可能丢失；主机测试不能测量实车中断延迟。

新固件配合更新后的本地网页使用；重启本地 Python 服务并刷新网页，使新增只读查询与 v2 解码同时生效。硬件运动验收独立进行。

## 独立审查

审查发现一项重要边界问题：初始化/错误恢复后的空 IDLE 事件可能将旧 DMA 缓冲误当成新一圈数据。已新增初次启动及错误恢复后的空事件断言，先重现失败，再将初始游标统一为环边界 RX_DMA_SIZE 后通过；HT/TC 正常回绕保持通过。修正后再次执行完整固件主机回归及 Keil 构建，均通过。其余检查未发现具体阻塞问题，未遗留次要项。

工程保留在 `codex/usart1-dma-console` 分支及当前目录，供用户继续使用；不推送、不合并远端。
