doinbest/Yachiyo/xjx/模版搭建/docs/开发记录/2026-09-22停车请求节奏修正.md

# 停车请求节奏修正

用户日志显示一次点击会发送 Ctrl+C、无编号 stop、三次带编号 stop，随后每500ms查询，6秒停止发送后回复仍持续数十秒。代码证实这是桥接自动重试/轮询；不能仅凭延迟断言无线硬件故障。

删除无编号文本请求，保留立即 Ctrl+C 与带编号请求。重试和查询间隔均为2秒；未受理最多发送3次同编号，受理后只查询，6秒超时停止发送。超时后同连接、仍锁定且同编号的迟到回复更新结果，未确认停止时仍保持timeout，不重新查询。确认停止也不自动解锁。断开或解除锁定后忽略迟到回复的状态更新。

同步修正准备跑图白名单残留 imu verify 10，改为 imu verify 5，并移除已退出准备流程的 profile 设置许可。

验证范围：模拟串口测试覆盖首次发送序列、清队列和锁定、重试上限、受理后只查询、迟到回复、错误编号、解除锁定后忽略回复；不连接真实串口。Python桥接20项与JavaScript68项回归通过。本次仅修改本地服务与文档，不修改固件；需要停车后重启本地服务生效，不需要烧录。
