doinbest/Yachiyo/xjx/模版搭建/docs/开发记录/2026-09-27-单件抓取实施计划.md

# 单件抓取实施计划

> 状态更新（2026-09-29）：本文 B4 设计与验证结果保留为历史记录；B4 已退出当前固件任务链。现行请求、稳定条件及限制见 [B2 协议兼容恢复](2026-09-29-B2协议兼容恢复.md) 与 [上位机协议](../上位机协议.md)。不再要求部署双协议香橙派程序。

> 执行：按已确认的方案与新顺序连续实施，使用测试先行；独立协议工作与任务模块可以并行，集成统一验证。

**目标：** 提供固定姿态抓取、物料台协同对准、单件视觉抓取和前四段模拟扫码抓取入口，首件提起后等待人工验收。

**方案依据：** `2026-09-27-扫码与静止物料单件协同抓取方案.md`，以及用户本轮认可的“固定位置抓取→协同对准→单件流程→路线扫码”顺序。

**修改前快照：** `ee59714`。用户已确认底盘方向、机械臂极性和Base回零点设置完成。现有文件及资源已提交；`.embeddedskills`日志、备份不入库。

**架构：** 新增独立 GrabTask 业务模块，复用现有电机总线、反馈和夹爪；不改变硬件引脚、时钟、驱动器配置。旧手动对准和纯16段路线保留。抓取运行期间由该任务独占运动入口；路线在第2/4段停车后显式交接。

**技术栈：** C99/STM32 HAL、Python视觉程序、原生网页JavaScript、现有主机测试与Keil。

## 全局约束

- Base保持工作角度，不自动回零；位置命令3200脉冲/圈与反馈65536单位/圈分开换算，并按安装方向统一符号。
- X/Z的毫米换算、机械边界、观察/夹持/提起位置、闭合时间、准心和像素响应均由显式配置提供；缺项时拒绝运动，不猜实测参数。
- 首轮只抓静止红色，500/800 us，下降期间不做水平追踪，完成不自动计数、不进入第5段。
- 所有运动非阻塞；ACK、到位、停止发送和实际停止分别处理。停止或故障不松爪、不失能Z。
- 沿用B2旧协议；新增可区分的详细颜色帧，携带粗/精阶段、采集帧序号和帧年龄。旧帧不具有自动下降资格。
- 同一次视觉计算给出底盘前后/左右及X修正；局部2×3响应矩阵加权求解，合成限幅，X接近边界逐渐减权；不采用15像素交接。
- 不执行烧录、串口发送或实车运动。未知实测参数不妨碍软件实现和主机测试。

## 接口与任务

- [x] 1. 视觉协议：Camera.c/.h与orange_pi/change.py保持旧B2；增加 `Camera_MaterialStartDetailed` 与 `Camera_DataTypeDef.Phase/FrameId/AgeMs`。测试粗/精、旧帧、重复帧、损坏/分片包及同色请求行为。
- [x] 2. GrabTask.c/.h：提供 `GrabTask_Init/Process/IsBusy/Stop/MotorEventHandle`、`GrabTask_Command(unsigned count,char *tokens[])`。命令最多6字段/63字节。`grab start fixed|align|pick`；`grab status`；`grab stop`；分组 `grab set ...` 配置。测试缺项不运动、到位反馈、绝对零目标、超时/丢帧、联合修正及保持夹持。
- [x] 3. 站点与任务码：路线新增 `ChassisRoute_StationStart(float speed)`、`ChassisRoute_StationResume()`、`ChassisRoute_StationFinish()`；第2和4段进入station状态，IsBusy为false但入口继续保留给组合任务。QR新增模拟数据发布接口，独立来源字段，不增加真实UART统计；屏幕新增发送完成状态。测试1秒等待、显示失败停留、第一组颜色及第4段后不续跑。
- [x] 4. 集成：主循环接入、控制台/按键互锁及紧急停止、允许站点刷新屏幕；机械臂绝对零目标可用。Keil/EIDE同步新增文件；维护现行协议和方案状态。
- [x] 5. 网页：提供单件抓取调试、配置和状态，组合入口 `grab route <speed>`；停止覆盖组合任务；不默认串口、不自动发运动命令，断线重连不恢复。
- [x] 6. 验证：新增用例先失败再实现；固件主机回归、视觉Python协议测试、网页与桥接回归、Keil构建，独立审阅关键停止/反馈路径。

## 重点审阅与验证

1. 未标定、配置含NaN/越界、运行中修改配置必须拒绝。
2. 旧视觉协议、重复帧、粗定位小误差不得触发下降；丢帧后停止，重新累计稳定条件。
3. 只收到运动ACK、旧的reached、旧的速度或位置反馈不得当作到位。
4. 路线waiting与station区分；显示必须完成实际发送才能续跑；取消不能在下一循环复活。
5. 闭合后故障与停止保留PWM和Z使能；成功仅为动作完成、等待人工确认。

## 执行记录

- 2026-09-27：先创建修改前Git快照；实施仍在本目录，保留已有分支，不另建空白基线。

- 最终软件验证：`python tests/run_firmware_tests.py`全部通过，包含新的抓取状态机、路线交接、屏幕完成门槛及10项B4 Python协议测试；旧B2的6项测试继续通过。
- 网页回归88项、桥接回归21项通过；浏览器检查了未连接状态、空白标定参数与分步操作入口，没有发送硬件命令。
- Keil Target `template`构建成功：0错误、0警告；Flash 129884 B，RAM 41704 B，生成AXF与HEX。EIDE仅同步清单，本次未另跑EIDE构建。
- 独立审阅后修复：路线正常stopping过渡被误判取消、屏幕在途更新被旧完成事件清掉、X低速亚脉冲余量丢失、陈旧轮反馈误判停稳、旧单轮反馈选择残留；相关回归通过。忙闲交替的X修正用例先确认失败，再验证修复通过。
- 日志：`.embeddedskills/tests/host-tests.log`、`.embeddedskills/logs/tests/grab-web-20260927.log`、`.embeddedskills/logs/tests/grab-bridge-20260927.log`、`.embeddedskills/build/template-template-build.log`。旧主机测试日志另存时间戳副本。
- 实物边界：未烧录、未向硬件发送运动命令。实测位置/尺度/响应矩阵/闭合时间仍由上板标定补齐；动态绝对目标更新行为仍需实测确认，首件抓持仍由人工验收。
