doinbest/Yachiyo/xjx/模版搭建/docs/开发记录/2026-09-29-视觉初始模型底盘方向实测修正.md

# 2026-09-29 视觉初始模型底盘方向实测修正

> 后续更新：用户确认摄像头随X朝车体左侧伸出后，j12已改为+2。下文保留当时实测与交付记录，当前值和新产物见《2026-09-29-X轴视觉响应同向修正》。

## 授权与保存

用户授权根据串口摄像头坐标继续调整 STM32 的“仅协同对准”。沿用本地桥接选择的 COM11、115200/8N1，没有连接 SSH、修改香橙派、烧录或复位。修改前检查 Git，保留全部原有改动；本轮涉及源码、回归和协议说明的快照为 `.embeddedskills/backups/vision-axis-before-20260929-190610.zip`。

## 实机短移证据

19:01重连原COM11，camera status报告usb=1、rx_bytes=107478、checksum_errors=0、overflows=0。grab为空闲/回零完成；IMU verified=1、control_ready=1。独立camera material 1重新收到B2红色坐标。

| 限时指令 | 移动前坐标主簇 | 移动后坐标主簇 | 观察结论 |
| --- | --- | --- | --- |
| chassis run 0 10 0 500 | 约(310,383) | 约(308,359) | 正左向命令主要使CY减小，DY=338−CY增大 |
| chassis run 10 0 0 500 | 约(308,359) | 约(329,358) | 正前向命令主要使CX增大，DX=CX−334增大 |

两个指令都由MCU限时结束（500ms保持，加既有起停过渡），随后查询均为timed_complete、error=0、locked=0。没有把命令速度乘时间当作实测位移；没有把主簇近似值当作精确均值。静止识别仍偶尔跳至另一坐标簇，本轮没有修改算法或放宽像素容差。

第一段随后独立停车请求token=965331266收到四轮停稳确认。第二段独立停车token=2343002083于19:03:34写出，桥接六秒超时；最终19:05:59才收到相同token的tx_complete=1/wheels_stopped=1。该墙钟延迟包含通信/缓存延迟，不能当作实际机械停车耗时，也不能把四轮确认扩展为机械臂三轴确认。停止锁保留，没有继续闭环运动。原始事件在 `.embeddedskills/logs/vision-axis-probes-20260929.json` 和 `vision-live-20260929.jsonl`。

## 修改与界限

GrabTask初始J由 `[0,2,0];[-2,0,-2]` 改为 `[2,0,0];[0,2,-2]`。行对应DX、DY，列对应命令前向、左向、X伸出。前两列按上述限时运动的主要响应方向修正，避免把水平误差交给主要改变垂直像素的轴。

2像素/mm仍是原试运行尺度，交叉项为初始近似，未完成基于反馈距离的尺度标定；X列未测，保留原值。准心、行程、速度、抓放位置与故障门槛未改。model仍为initial，不能解释为完整标定通过。

新增隔离水平/垂直误差的默认求解器回归：X位于回缩边界时，负水平误差应生成正前向修正；负垂直误差应生成正左向修正。原代码先断言失败，修改后通过；更新原默认方向与X两端边界测试，保留任务不夹取/不转Base的回归。

## 验证与交付

- 针对性RED/GREEN：`.embeddedskills/tests/vision-axis-red.log`、`vision-axis-green.log`。
- 完整固件主机回归PASS：`.embeddedskills/tests/vision-axis-firmware.log`。
- Keil template构建0错误/0警告：`.embeddedskills/build/vision-axis/template-template-build.log`。
- HEX：`template/MDK-ARM/template/template.hex`。
- SHA256：`a878b9c80edb53b739e424448c5b4490cf22fe96c70415b76112032cccc223bb`。

本轮没有网页/桥接代码修改，未重复网页和桥接回归。新默认值仅存在源码和新构建产物，未写入运行中MCU的RAM、未烧录。烧录会载入新模型并按原程序回零；需在串口回复稳定后，继续验证“仅协同对准”能否收敛、X轴响应与尺度。两次限时实测不等于完整视觉闭环或抓取验收通过。
