doinbest/Yachiyo/xjx/模版搭建/docs/开发记录/2026-09-30-蓝色协同对准两次恢复实测.md

# 2026-09-30 蓝色协同对准实测：重新请求两次有效，第三次漏检停止

## 条件与范围

用户要求再执行一次仅协同对准，解释后列出 dx、dy 变化。复用用户已选的本地串口桥接 COM14 / 115200 / 8N1，仅发送一次 `grab start align`；没有 SSH、香橙派代码修改、烧录、复位或抓取动作。

预检 `info` 返回 BUILD date=Sep 30 2026 time=02:28:03，GRAB protocol=B2 align_color=3 pick_color=1；总线 locked=0，IMU ready/fresh/verified/control_ready=1、result=PASS，任务 idle，USB已连接。板上构建时间晚于上一轮 Codex 02:20 构建，本轮没有替用户烧录；运行中两次出现 vision_reacquire_wait，证明本次实测确实走到新版重新请求分支。

## 结果与解释

北京时间 02:31:52 发送启动命令，收到蓝色模式受理。有效状态样本 dx 从 -95 到 -86、-61，第一次恢复后 -61，第二次恢复后 -60，再到最后有效报告 -57；dy 为 -2 至 0。已记录有效状态样本中，横向误差绝对值减少 38 px，约40%，尚未到达对准完成状态。记录不是逐相机帧采样，不能排除未记录帧中的跳变，也不能凭此确定香橙派内部漏检原因。

在任务 3.669 s、4.819 s、6.494 s 触发三次视觉失效。前两次分别先停车确认、提交蓝色B2重新请求，再于4.529 s和5.417 s恢复；从500 ms窗口开始到恢复分别约134 ms和102 ms。第三次已经用完每任务2次恢复额度，触发 vision_recover_limit，并于7.258 s确认停稳。不是本轮15秒脚本上限截断，也不是 vision_recover_timeout。新策略能恢复短暂中断，但未解决反复漏检，因此本次实车对准未通过。

脚本在收到 stopping 后发送 grab stop；该命令已发出，但后续新鲜 grab status 仍报告 error / vision_recover_limit / stop_confirmed=1，不将“发出停止命令”描述为已切换 idle。02:32:27 再次读回上述停稳状态。没有进行第二次运动测试。

## dx、dy与时序

dx、dy是像素误差，越接近0越接近目标参考点；na表示没有可用于当前对准的有效坐标，不代表误差0。表格按固件 elapsed 排序，避免串口队列延迟造成错误时序：3.049 s的周期状态在3.669 s暂停报告之后才到PC，不算一次实际恢复。prepare阶段带有上次任务elapsed=6804，未用作本轮时间数据。没有插值或捏造丢失期间坐标。

| 任务时间/s | 状态 | 原因 | dx/px | dy/px | 恢复次数 | 停稳确认 |
|---:|---|---|---:|---:|---:|---:|
| 0.994 | acquire | running | na | na | 0 | 1 |
| 1.050 | align | running | -95 | -1 | 0 | 0 |
| 2.049 | align | running | -86 | -1 | 0 | 0 |
| 3.049 | align | running | -61 | 0 | 0 | 0 |
| 3.089 | align | running | -61 | 0 | 0 | 0 |
| 3.669 | vision_pause | vision_pause_stopping | na | na | 0 | 0 |
| 4.395 | vision_pause | vision_recover_wait | na | na | 0 | 1 |
| 4.395 | vision_pause | vision_reacquire_wait | na | na | 0 | 1 |
| 4.529 | align | vision_recovered | -61 | -2 | 1 | 0 |
| 4.819 | vision_pause | vision_pause_stopping | na | na | 1 | 0 |
| 5.315 | vision_pause | vision_recover_wait | na | na | 1 | 1 |
| 5.315 | vision_pause | vision_reacquire_wait | na | na | 1 | 1 |
| 5.417 | align | vision_recovered | -60 | 0 | 2 | 0 |
| 6.189 | align | vision_recovered | -57 | -1 | 2 | 0 |
| 6.494 | stopping | vision_recover_limit | na | na | 2 | 0 |
| 7.258 | error | vision_recover_limit | na | na | 2 | 1 |

## 日志

- 原始逐事件记录：`.embeddedskills/logs/blue-align-once-20260930-023152.jsonl`
- 按固件时间排序的状态CSV：`.embeddedskills/logs/blue-align-once-20260930-023152-dx-dy.csv`
- 预检与结束后查询：`.embeddedskills/logs/blue-align-live-20260930.jsonl`

本轮仅实测与记录，未修改生产代码或放宽恢复次数、恢复窗口、停车条件。

## 补充：动作来源与提速限制

用户随后询问缺少参数字段和dx变化来源。configuration_missing按任务模式检查所需参数是否已设定、范围和换算是否合法；missing=none表示该模式配置检查通过，不代表图像有效、任务到位或参数已经完成实物标定。用户贴出的grab start fixed是固定取放，准备后直接下降，不启动视觉请求，dx/dy=na属正常；Color=red只是通用状态中的模式目标色字段，不能据此认定fixed正在识别红色。

本次蓝色对准日志中，1.050 s的X反馈为-0.009 mm，6.189 s为0.017 mm，变化约0.026 mm；2.049 s和3.089 s的底盘前向速度指令分别5.690和9.150 mm/s。当前初始模型规定底盘前后主要改变dx，底盘左右与伸缩轴主要改变dy。因此dx变化主要由底盘引起。vf/vl是控制器提交的速度指令，不是逐轮测得的实际车速。

源码视觉默认body_speed=10 mm/s、lambda=0.3、accel=10 mm/s²，控制更新间隔至少100 ms且还会等待电机总线空闲。现有算法已按像素误差比例减速；在初始2 px/mm模型下，dx=-61且dy近0时，未限幅的前向速度为9.15 mm/s，单独提高body_speed不会改变这个期望值。提速需要联合考虑误差增益、速度和加速度，仍须保留近目标减速及漏检停车。快速对准静止目标与持续跟随移动目标的结束条件不同，已向用户询问目标；本次解释阶段未改参数或代码、未再次驱动实车。
