doinbest/Yachiyo/xjx/模版搭建/docs/开发记录/2026-10-03-UART5上电帧错误恢复.md

# UART5 上电帧错误恢复

## 现场证据与原因

19:29:20 用户提供的 `info`：`locked=1 reason=uart_error fault_ms=29 owner=8 addr=0 func=0 active=0 wait=0 uart_error=0x04`。19:25:24 原始日志中 Z 回零在 `elapsed=1000` 时报告 `home_request_failed`。首次回零命令之前，接收帧错误已令总线隔离；请求因此无法入队，X/Z 参考也没有通过回零恢复。`missing=x_ppm` 是后果。

可确认的软件问题是：发送任何命令前的启动接收 FE 与运行中通信故障采用同一隔离策略，一次启动异常阻断整个回零流程。导致 FE 的具体电气因素尚未实测；不据此认定某个驱动器损坏。owner=8 是枚举结束标记，不是车载转盘 ID。

## 修改与边界

修改前检查点 `cd1a1e5`（前一实现 `c35cf55`），工作区原本干净。修复在 `motor_bus.c/.h`，控制台只追加诊断输出。

- 首次 HAL 发送尝试前、无活动事务/恢复/已有隔离，且错误恰为 FE 时，停止 DMA、清接收残片、重启接收。
- 成功后保留请求队列，沿原有 10 ms 间隔发送；重复启动 FE 可再次恢复，没有新增累计失败次数限制。
- DMA 停止或接收启动失败，报告 `rx_restart_failed` 并隔离；DMA 错误及软件接收溢出不适用例外。
- 首次发送尝试永久关闭此例外，普通停止、手动恢复不重新打开。运行中的原有隔离/停车/应答处理保持原语义。
- `info` 增加历史启动恢复次数与最近故障时刻；参数、位置参考、回零顺序不变。Emm、Flash、IOC、EIDE 不修改，不烧录和操作硬件。

## 软件验证

新增主机回归先在旧代码复现失败：注入 29 ms FE 后 `!MotorBus_IsQuarantined()` 断言失败。修复测试直接链接真实 MotorBus、MechanicalArm 和 Emm 帧封装，检查重复 FE、待发 Z 回零请求保留、10 ms 间隔、实际 0x9A 帧与 ACK、残片不能作为 ACK、首次发送后的空闲/活动错误仍隔离、手动恢复不重开启动例外，以及接收重启失败/DMA停止失败/DMA错误/溢出。

验证日志位于 `.embeddedskills/motorbus-startup-20261003/`：`baseline-firmware.log`、`red.log`、`firmware.log`、`build/`、保护文件哈希。

- 修改前、修改后固件完整主机回归均 PASS；新增启动测试主场景及五个错误场景全部通过。
- 首次全量回归发现旧 `motor_recovery_test` 在任何发送前注入 FE 并期待锁定，与本次修复目标冲突。将其前置改为一次真实状态查询并收到应答，再注入 FE，保留原运行故障、八电机恢复和停止检查；首次结果留在 `firmware-initial.log`。
- Keil `template` 于 2026-10-03 19:34 构建成功，0 错误、0 警告。Code=150708、RO=17592、RW=2420、ZI=79852；未压缩 Code+RO+RW 为 170720 字节，静态 RAM 为 82272 字节，较上一版分别增加 212 和 16 字节。
- 15 项保护文件 SHA-256 与修改前一致；`git diff --check` 通过。构建工具临时改写的日志默认目录已恢复，不提交本地工具配置变化。

## 上板验收与回退

由用户烧录本次构建的 `Code/template/MDK-ARM/template/template.hex` 后，观察一次完整上电：Z → X → Base 回零完成，再静止完成 IMU 验证。读取 `info`，发生启动 FE 时应出现恢复计数且不因这次 FE 锁定；没有 FE 时不输出额外恢复行。若出现实际运行故障，保留新的首次故障记录再分析。

软件模拟和编译不等于实车验收。优先以 `git revert` 撤销修复提交，保留检查点及后来工作，不使用 `reset --hard`。
