doinbest/Yachiyo/xjx/模版搭建/docs/开发记录/2026-10-03-底盘低速转向路线与验收顺序.md

# 2026-10-03 底盘低速、转向路线与验收顺序

## 目的和交付边界

本轮按用户批准方案实施：优先稳定实现动作，保留已有速度上限；从右下起点出发，开局斜向直达扫码位，长段通过转向采用前进或后退。软件修改、回归与Keil构建由Codex完成；没有打开实车串口、烧录、复位或执行机构运动。实车验收由用户按本记录顺序进行。

硬件方向和地图继续使用现有基线：左下原点、X向右、Y向上，地图航向从+X逆时针计；起点为车体中心 `(2250,150,90°)`。Emm42只改ID、其余驱动默认，3200命令脉冲/电机轴圈与65536实时位置协议单位/圈分别使用。

## 参数及RPM

| 参数 | 本轮默认 | 保留的限制 |
|---|---|---|
| 固定、雷达、首件组合路线启动速度 | 200 mm/s | 输入10～5000 mm/s |
| 距离加减速度 | 300 mm/s² | 编译参数，尚无底盘RAM加速度命令 |
| 暂存进出站 | min(路线速度,50) mm/s | 固定绝对地图目标 |
| 独立chassis move诊断 | 50 mm/s | 单次位移长度≤300 mm |
| 原地转向 | ≤0.15 rad/s；起步过渡500 ms | 地图航向−180°～180° |
| 电机命令速度 | 由车体速度/几何计算 | 3000 RPM |

5000是车体mm/s上限，不是5000RPM。按当前80 mm轮径、1∶1直驱，200 mm/s直行理论47.75 RPM，整数命令约48；50 mm/s约12 RPM。开局车头保持90°，200 mm/s斜线的无纠偏逻辑轮速约 `[41,54,41,54]` RPM（FL/RL/RR/FR）；原始回包符号仍受左右镜像方向影响。0.15 rad/s纯转向约8 RPM/轮，一次90°理想转动至少10.47秒。实际指令还受加减速、航向纠偏、整数化和到点制动影响，反馈RPM与请求值分别记录。

项目开源参考的22个有效子点已逐点核算，见[开源参考路线电机RPM](2026-10-03-开源参考路线电机RPM.md)。参考Fast未启用，平移名义最高260 RPM，原地右转按角度PID变化、上限200；其vx/vy直接组合成RPM，不能套用另一套M3508换算。这里的新200 mm/s约48 RPM是当前主车参数，与参考代码里的200 RPM分别使用。

网页启动速度是浏览器设置，统一用于下次固定/雷达/组合路线。旧设置高于200时一次迁移为200，原值留存可查看；10～200保留。迁移后用户仍可明确选择到原上限。页面加载、保存、导航和离线播放不发运动命令。路线执行中保持已接受速度。未实现这些底盘参数的Flash保存。

## 固定15个业务目标

| 段 | 目标/mm | 主要动作 | station/visit |
|---|---|---|---|
| 1 | 2100,1200 | 保持90°斜向直达扫码位 | 5/1 |
| 2 | 2100,2100 | 90°前进 | 0/0 |
| 3 | 1200,2100 | 转180°向西前进，到点恢复90° | 4/2 |
| 4 | 1200,350 | 90°后退到粗加工位 | 2/3 |
| 5 | 1200,1200 | 90°前进 | 0/0 |
| 6 | 350,1200 | 180°前进到425接驳，转90°低速进站 | 3/4 |
| 7 | 1200,1200 | 90°低速退到425，转180°倒车向东 | 0/0 |
| 8 | 1200,2100 | 转90°前进 | 4/5 |
| 9 | 1200,350 | 90°后退 | 2/6 |
| 10 | 1200,1200 | 90°前进 | 0/0 |
| 11 | 350,1200 | 同第6段 | 3/7 |
| 12 | 1200,1200 | 同第7段 | 0/0 |
| 13 | 2100,1200 | 180°倒车向东，到点恢复90°，不再次扫码 | 0/0 |
| 14 | 2100,300 | 90°后退 | 0/0 |
| 15 | 2250,150 | 90°斜向返回起点 | 1/8 |

手动 `start/next`每个业务段执行全部内部动作，只在段末等待一次。自动模式确认停车后等待100 ms继续。所有工位最终保持90°观察姿态；沿用已验证align控制和B2，不新增回零或标定。到点反馈容差10 mm、航向2°；完成还要求三组至少500 ms的新鲜停车反馈。底盘转向不重设地图锚点，也不把反馈位置吸附到目标。

暂存点 `(350,1200)`原地转90°会使现有300 mm车体模型进入非行车区，因此使用绝对接驳 `(425,1200)`与75 mm短侧移，低速≤50；南北方向且车头90°时无需插入该转向。原料点转向的模型最小转盘间距约7.9 mm，实际外廓、定位误差及转盘净空需现场核查。最终起点反馈到点不等于实际外框完全入启停区。

雷达任务首腿直线无障碍时走起点→扫码，受阻则四邻居A*，整个首任务腿保持90°。返程先到 `(2100,300)`恢复90°，最后斜向入起点，避免在右边界转向。工位访问顺序仍为起点→扫码→原料→粗工→暂存→原料→粗工→暂存→起点；中转点不触发交接。

共享C规划表示格路可达；车体旋转通行另做离线诊断。300 mm方框扫掠约424 mm，部分400 mm走廊中的转角有干涉。离线诊断标明首个冲突坐标、阶段和障碍，新增绕行折点先实测净空，再进行全程实车验证。没有增加通用在线足迹互锁、双起点识别或运动中的实时雷达避障。

## 新接口与状态

`ChassisMotion_TurnTo(map_yaw_deg,timeout_ms)`与 `chassis turn <map_yaw_deg>`只输出角速度，角度−180..180为地图绝对航向。现有 `chassis heading`仍使用HWT模块角度。转向未到角、未停稳时不启动下一平移或交接；停车后偏角可在原截止时间内继续修正。取消任一阶段后不续跑。

路线状态增加phase、direction、当前阶段目标、启动速度和阶段速度。原@CHASSIS路线数组保持兼容，新route_meta绑定同帧action_id；雷达nav帧保持256字节预算，阶段由reason显示。内部动作更新action_id，业务段及station/visit不变。扫码交接5/1、首原料交接4/2，组合入口仍是模拟任务码→首件红色pick，不是全赛事自动搬运。

## 软件验证记录

实施前基线：固件完整主机回归通过，网页173项、桥接26项、雷达服务7项、雷达线协议契约通过。

新增转向主机模型包含100 ms整数RPM指令批次、120 ms电机响应和300 ms反馈组：90→180与180→90均约12.02秒，最终误差约1.47°；170→−170约3.92秒，误差约1.55°；XY漂移保留。距离延迟模型中1750 mm、200 mm/s约11.02秒完成，峰值200；75 mm、50 mm/s约2.92秒完成。以上均为软件模型，不是实车成绩。

构建仅维护Keil，官方Emm、W25Q128、IOC、EIDE配置不改。最终结果见本记录末尾。

```powershell
python Code/tests/run_firmware_tests.py
node --test Code/upper-computer-web/local-car/tests/*.test.mjs
python -m unittest discover -s Code/upper-computer-web/local-car/tests -p test_bridge.py
python -m unittest discover -s Code/upper-computer-web/local-car/tests -p test_radar_service.py
python Code/tests/radar_wire_contract_test.py
```

Keil工程 `Code/template/MDK-ARM/template.uvprojx`，Target `template`。记录错误、警告、Program Size、AXF/HEX时间与日志，构建成功后由用户按实际探针下载。

## 实车检查验证顺序

每条运动命令单独执行并观察；保存原始日志与实测结果。串口从设备列表选择，不沿用日志或工具配置中的COM号。Emm Receive和65536沿已确认设置使用，不重新要求一圈协议单位实验。

| 顺序 | 操作 | 检查及记录 |
|---|---|---|
| 1 | 烧录已构建AXF/HEX；启动local-car/start.cmd并选实际串口 | 下载版本、上电回零/IMU最终状态；不把受理当实物完成 |
| 2 | info、bus status、imu status；chassis feedback 0/on，再chassis feedback | 四轮位置速度有效、静止≤1 RPM；已有verified/control_ready资格复用，失败才静止imu verify 5 |
| 3 | 静止chassis stop，再chassis stop-status | 受理、tx_complete、wheels_stopped分别确认；明确解除网页停止锁 |
| 4 | 必要时架空wheel fl 10→wheel stop，依次rl/rr/fr | ID1/2/3/4对应FL/RL/RR/FR，正向向车头滚动；已有可靠记录可复用，raw符号可镜像 |
| 5 | 落地chassis run 50 0 0 1000，停稳后chassis run -50 0 0 1000 | 前后方向、实测位移/侧偏、起停距离；移动中做一次停车响应检查 |
| 6 | 实际场地中心设置chassis origin 1200 1200 90；chassis turn 180、再turn90；转后短前后测试 | 正方向地图逆时针，到角且停车后完成；记录中心漂移、角度误差和耗时；不重新归零 |
| 7 | 同一实际位置不同yaw静止radar scan，读取图与路径 | 同一世界障碍投影一致，验证安装方向；2170,230,180只是参考预设 |
| 8 | 实物摆回右下起点；准备跑图或chassis origin 2250 150 90、chassis stream on 1；snapshot | 原点与实际位置/朝向一致；准备不运动；检查启动速度200及旧速度迁移提示 |
| 9 | 静止radar scan，完成后radar status并读取完整map/path | 完整圈才换图，障碍方向、格位和路径正确；坏帧/DMA/单位变化在10秒窗口重采未完整圈 |
| 10 | chassis route start 200 | 直接斜向到扫码位，不在旧2100,300停车；记录轨迹、漂移、停点和二维码视场 |
| 11 | chassis route next逐段；查询route status/task/snapshot | 先转再长段前后，工位最终90；检查原料实际转盘间距、425转向和75 mm进出、返程外框入区 |
| 12 | 各工位qr/camera/vision status，按需要camera material及grab start align | 核查视场及实际颜色；已验证align不重做标定；抓放另核对实际场景参数、外侧参考和库存 |
| 13 | 回正确实物起点重新准备；chassis route auto 200 | 15个目标完整连续执行；记录时间、最大偏差和异常原因，仅几何路线不自动抓放 |
| 14 | 起点重新扫描现场障碍；离线检查新增转角净空；radar nav start 200 | 规划方向/绕行与反馈一致，station/visit不因中转变化；取消保留完整图 |
| 15 | 当前配置/库存已验收，分别grab route 200、radar task start 200 | 模拟扫码5/1→首原料4/2→红色pick；检查真实夹持、入仓及软件结果，结束后不自动第二件 |
| 16 | 取消、网页断开重连；实际锁定才bus recover、bus status | 无剩余动作重发；普通停止/恢复保留有效配置、参考及历史图；恢复不自动续跑/回零 |

每次至少记录固件版本、启动与阶段速度、业务段/工位、起止实物位置、实际与反馈yaw、停止距离和异常原因。地图页导出完整快照；终端保留原始报文，通信JSONL与RX/TX二进制日志位于 `.embeddedskills/`。独立粗加工/暂存机械高度及车载第二/第三仓仍按现有实际标定状态验收。

## 最终交付验证

- 固件完整主机回归：PASS。包括低速距离/转向延迟模型、15目标与全部内部阶段取消、工位语义交接、原点保留、转向后位置修正及固定剩余截止时间。
- Python桥接26项、雷达服务13项：PASS；雷达线协议契约：PASS。地图/规划50,577项检查无失败。静止雷达投影在不同yaw仍落在相同世界坐标。
- 遥测兼容：紧凑v2与详细v1保留原route布局、加入route_meta；生产C→网页契约PASS。最大身份值下雷达nav帧审查为253/256字节，布局不扩展。
- 当前共享C默认固定路线29个内部阶段、雷达默认32个阶段，理想及整数RPM预览均通过现有300 mm车体扫掠检查。预览限制3000 RPM、平移加减速300 mm/s²；历史16段编辑器限制仍为100 mm/s、100 RPM。
- Edge无头实际页面：无JS异常；加载、切页与播放未发送运动/连接请求，仅离线规划POST `/api/radar/plan`；显示29阶段与默认200。截图及检查结果保存在 `.embeddedskills/analysis/chassis-route-20261003/`。
- 软件测试、浏览器预检及构建均不等于实车验收。本轮没有串口连接、烧录或运动；未实施双起点识别，保留既有双起点设计资料。参数仍为固件默认/RAM或浏览器本地设置，没有新增Flash保存。

网页完整回归187/187通过；运动/雷达与路线/网页分别完成独立规格、质量审查。路线审查发现并修复两项边界：通用斜向计划的194.04°输出转换为−165.96°，与TurnTo范围一致；短EW暂存进出即使保持90°也经425接驳，最后75 mm限速。新增回归均先复现失败再通过，固定及标准雷达阶段数量保持一致。

最终Keil于2026-10-03 14:35:01构建成功，0错误、0警告：Code=148692、RO-data=17428、RW-data=2384、ZI-data=79760；Flash占用168504字节，RAM占用82144字节。产物为 `Code/template/MDK-ARM/template/template.axf` 与 `template.hex`，日志 `.embeddedskills/build/template-template-build.log`；结构化构建结果 `.embeddedskills/analysis/chassis-route-20261003/keil-final.json`。Keil清单含新增C路线模块，XML解析通过。官方Emm、W25Q128、IOC、EIDE无差异。

最终固件主机日志 `.embeddedskills/analysis/chassis-route-20261003/firmware-final.log`，生产工具原始UTF-8日志 `.embeddedskills/tests/host-tests.log`；网页日志 `web-root-final.log`，审查报告 `review-motion-radar.md`、`review-route-web.md`均在同一analysis目录。临时预览服务已关闭，没有保留自动连接或后台运动入口。
