doinbest/Yachiyo/xjx/模版搭建/docs/开发记录/2026-10-03-视觉联动二次提速与12秒颜色等待.md

# 视觉联动二次提速与12秒颜色等待（2026-10-03）

用户准备进行实车夹取，目标颜色可能尚未转入视野，出现后停留可能只有3～4秒；要求参考此前提速经验，提高底盘和机械臂响应，并延长识别等待。用户确认连续静止15秒会被判结束，本次先设12秒识别等待。基线为修改前已提交且工作区干净的`2316b9a`。

## 参数与行为

| 参数 | 本轮前 | 本轮后 |
|---|---:|---:|
| body_speed | 20 mm/s | 40 mm/s |
| lambda | 0.6 s⁻¹ | 1.2 s⁻¹ |
| accel | 20 mm/s² | 60 mm/s² |
| x_speed | 5 mm/s | 10 mm/s |
| z_speed | 27.777778 mm/s（250 RPM） | 55.555556 mm/s（500 RPM） |
| vision_wait_ms | 首次未设固定超时；恢复1500 ms | 首次及恢复均12000 ms |

视觉提速由align/pick共用，仍按误差比例减速。自动Z运动共用一个速度值，因此下降、提起、放置和前往观察高度都会提速；回零驱动速度、普通手动轴配置与此独立。机械行程和电机协议单位不变。X的10 mm/s是控制参数上限；默认尺度下整数RPM向下取整为5 RPM，理论速度约8.4 mm/s，不等于实测速度。

新增`grab get/set vision_wait_ms`，范围1500～120000 ms、整数，网页参数调试的视觉标签同步显示、读取、应用与读回比较。首次等待从B2请求发送成功开始计时；丢失后恢复窗口从确认停稳开始计时。12秒不包含所有准备、停车确认耗时，不是比赛判停计时器。

首次窗口超时报告`vision_acquire_timeout`，恢复超时仍报告`vision_recover_timeout`。累计恢复次数只保留诊断，不再因为成功恢复两次而退出；每次恢复仍使用新的连续观测。原`retries`是停稳后偏出夹取窗口的重新对准限制，本次未改其语义。

保持坐标年龄1000 ms、短漏检250 ms、稳定200 ms及三次新观测；长时间等待不延长旧坐标有效期。人工停止、总线故障、驱动反馈、软件行程与夹取前到位确认保持原处理。香橙派与B2协议未修改。

## 前后模拟

复用生产GrabTask控制和状态机、现有主机硬件端点；2 px/mm初始视觉模型、连续有效坐标、机构理想执行。原参数固定为本轮前20/0.6/20/X5，新参数使用固件默认40/1.2/60/X10。两组均采用相同起点、反馈和对准条件，计时从对准阶段开始。

二次提速模拟对比

| 场景 | 首次进入±5 px：原→新 | 对准与停车完成：原→新 |
|---|---|---|
| DX=-95，DY=-1 | 5.25→2.70 s | 6.05→3.50 s |
| DX=-95，DY=-60，底盘/X联动 | 6.10→3.65 s | 7.20→4.75 s |

曲线不包含Z下降及夹爪闭合；不是移动物料或实车实验。80 mm下降按匀速计算由2.88降到1.44秒，实际还含加减速、反馈和夹爪等待。大初始偏差时，单靠本次参数不能保证在3～4秒驻留内完成夹取；应在观察姿态提前等待，实测目标进入视野时的偏差与完整动作时长。

源码为`Code/tests/grab_tuning_sim_test.c`。CSV、绘图脚本、PNG/SVG与模拟输出位于`.embeddedskills/vision-tuning-20261003/`，未修改9月30日图表和历史记录。绘图使用现有yolo_all Python环境，没有安装依赖。

## 软件验证与产物

- 固件全套主机回归通过；新用例覆盖首次等待10秒后收到颜色、恢复等待10秒后重获、多于两次恢复、12秒边界及超时、人工停止、align/pick一致性。原短漏检、新鲜坐标、停稳、取放及Flash诊断测试继续通过。
- 网页198项通过；新增参数读写与默认值、恢复计数及12000 ms状态解析均覆盖。中文日志补充首次颜色等待超时原因。
- Keil Target `template`：0错误、0警告。最初构建未产生日志，重新启动构建后得到新HEX，未将旧产物作为本次成功结果。
- Emm、Flash、IOC、EIDE等15个保护文件与本日保护哈希基线一致，Git差异仅包含本批范围。
- 实际ROM由169016增至169200字节（+184）；RAM保持82272字节。构建工具未压缩Flash合计170972字节，口径与实际ROM不同。
- 日志为上述目录的`firmware-tests.log`、`web-tests.log`、`simulation.log`及`build/template-template-build.log`；链接基线为`before.map`。
- HEX：`Code/template/MDK-ARM/template/template.hex`，SHA256为`e927f21c81f690a37afdd93537e921ab26f293614ca21b7cfd05541807e20154`。

## 实车生效与验收

本轮只测试、编译，没有烧录、复位或发送运动指令。烧录后读取body_speed、lambda、accel、x_speed、z_speed、vision_wait_ms，核对40、1.2、60、10、约55.5556、12000；刷新网页后“读取当前全部参数”可统一核对。既有固件可临时修改前五项RAM值，新等待参数及恢复策略需要本次固件。

先验证仅协同对准的近目标减速和停稳，再验证固定位置的Z下降/提起，最后用实际转盘做pick。记录目标首次有效坐标、进入窗口、开始下降、夹紧与提起的时间，分别测试首次颜色迟到和识别—丢失—识别。对准HOLD不等于完整抓取；库存与车载几何所需参数仍按现有流程标定。

回退优先`git revert`本批提交，先保存后来新增的工作，不使用`reset --hard`。临时速度可设回20/0.6/20/X5/Z27.777778；要恢复旧等待和两次恢复策略，需要回退固件实现并重新构建、烧录。
