doinbest/Yachiyo/xjx/模版搭建/docs/开发记录/2026-10-03-雷达通信查询验证.md

# 2026-10-03 雷达通信查询验证

## 问题与边界

用户换成学生电源5V直接供电并与单片机共地后，16:58诊断仍为bytes=738022、packets=0、bad=3、overflow=0、alarm=122984、last_alarm=256、unit=unknown。此前也测过4.9V。接收报警说明F407收到数据，扫描受理只说明控制台启动了软件流程，尚不能确认F407→雷达指令线及查询应答。用户要求保持现有接线，通过修改程序验证。

本次增加身份查询和原始RX证据，不改供电、USART2/USART1配置、IOC、官方Emm、Flash、EIDE、底盘或机械臂行为；未连接真实串口、未发送硬件命令、未烧录/复位。实机电源故障原因尚未排除。

## 基线与实现

修改前工作树干净，既有提交`76aa76bb9c1280d2de80dfd51c3c59f32de00830`作为本次Git检查点；修改前固件全套回归及Keil Target template通过，0错误/0警告。

- `radar probe`仅查询LUUIDH，6字节ASCII、不附CRLF，使用现有非阻塞UART2发送队列；不发LSTARH、不设置设备参数、不清地图。读取结果用`radar probe status`，它不重发雷达命令。
- 分别报告MCU TX完成与雷达身份应答；只有发送后的PRODUCT SN及非空身份文本才确认通信。发送完成后等待2秒，持续HAL_BUSY及TX完成超时各500ms；SN分片支持报警穿插，未带结束符时以50ms文本间隔收束。
- 绝对DMA游标排除查询前已到达的DMA/工作缓存字节。接收恢复或覆盖只丢弃未完成SN片段，保留窗口和计数。持续报警、普通测量包、命令回显、旧SN及空SN不能误报成功。
- 保存最多24字节未经解码的原始RX前缀和最多24字符身份。窗口计数与结果结束后冻结；雷达停止可取消查询，已完成地图、点云、RAM参数及证据保留。
- status诊断增加第3页：tx_done、last_tx、tx_errors、uart_errors、rx_ready。每页含前缀和CRLF仍不超过256字节，按页合并，兼容旧诊断。
- 网页“雷达建图→通信检查”增加验证/读取结果两个按钮；停止锁定中可做查询，页面进入及切页不发TX。结果、中文/原始日志、CMD及JSONL均保留证据，旧查询不会混入新id。断线或MCU重启将旧结果标历史。

命令由用户手册的查询表确定；身份前缀核对[厂家旧LDS-50C ROS驱动](https://github.com/BlueSeaLidar/bluesea/blob/9dc5e7866635eb7bc045ba46e951be770abb30b8/src/bluesea_node.cpp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)，并对照[厂家SDK](https://github.com/BlueSeaLidar/sdk2/blob/7fc0f940595732b3ad2cf0001038a64cd3d54086/sdk/LidarDataProcess.cpp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)。两个核对版本的根目录未发现许可证文件，本项目仅使用公开协议事实，自行实现接收逻辑，没有复制/导入SDK实现；原始源码只读摘录保存在忽略的分析日志中。

## 验证证据

新增测试先在未实现的查询API、控制台诊断页数、网页日志分发、停止锁定许可及CMD输出处失败，然后实现并验证：

- 固件主机全套通过。`test_radar_probe`覆盖真实UART调度/DMA路径中的分包SN、连续1200包报警后SN、无终止符、无回复、回显、测量流、旧DMA/工作缓存、空SN、UART恢复、HAL_BUSY/ERROR/TX超时、停止取消和命令占用。
- `test_radar_scan`补充完整地图后执行查询，确认scan/map编号、点云、地图mask和RAM参数保留；两个雷达目标在补充用例后再次通过。控制台满uint32计数/身份及24字符SN/24字节HEX不超256字节。
- 网页194/194通过，包括实际app.receive分发、分页面合并、旧查询证据隔离、历史标记及MCU发送完成不能误报身份确认。
- 桥接28/28通过；FakeSerial验证停止锁定仍允许查询、禁止扫描/任意附加雷达指令，原始查询结果进入CMD和JSONL。
- Keil Target template为0错误/0警告。Emm_V5.c/.h、w25q128.c/.h、IOC和EIDE三个配置共8项SHA256一致；Keil工程清单没有新增固件源文件。
- 用8767端口的独立FakeSerial服务预览，未使用8765真实控制台。实际点击模拟仅报警与SN成功、只读结果入口；确认停止锁仍存在、扫描仍禁用。手机窄屏和1440×900桌面均可显示；截图里的MOCK12345属于模拟，不能作为实机查询成功的证据。预览期间只有radar probe、radar probe、radar probe status三条模拟控制台命令。

日志目录：`.embeddedskills/radar-probe-20261003/`，包含baseline-firmware.log、red-firmware.log、red-console.log、red-web.log、red-bridge.log、firmware.log、web.log、bridge.log、test_radar_probe.log、test_radar_scan.log、build-baseline/、build-after/、baseline.map、after.map、protected-before/after.json及probe-preview[-desktop].png。查询测试和页面预览均未访问实车UART。

| 链接报告项目 | 基线 | 修改后 | 变化（B） |
|---|---:|---:|---:|
| Code | 148812 | 150572 | +1760 |
| RO | 17352 | 17524 | +172 |
| RW | 2384 | 2412 | +28 |
| ZI | 79760 | 79844 | +84 |
| 静态RAM（RW+ZI） | 82144 | 82256 | +112 |
| 链接Total ROM Size（含压缩RW镜像） | 166808 | 168740 | +1932 |

Keil工具另以未压缩RW计算flash_bytes=170508，不能拿该口径与基线链接ROM166808混算。诊断使用固定小缓冲区，无动态内存或连续原始串流输出。

## 实机验证步骤

1. 用户使用本次编译HEX更新主车，重启本地start.cmd以加载Python桥接变更，网页Ctrl+F5；保持现有雷达线和供电。新代码不能仅靠网页刷新加载到STM32。
2. 连接原控制台端口，读取`radar status`：应有status及3页diag。保存TX完成数、最近命令、错误和RX就绪。查询不需要跑图准备、遥测或解除停止锁定。
3. 若还在扫描，发送`radar stop`并等当前STOP结束；随后执行`radar probe`或点击“验证雷达通信”。等待约2秒，再执行`radar probe status`或“读取验证结果”。
4. 粘贴完整三条probe及新diag。confirmed/sn_reply和SN证明本次身份查询往返；tx=true但alarm_only/无SN表示MCU已完成发送，接收仍是报警，身份查询尚未确认。tx_busy/error/timeout指向MCU发送阶段。reply_unknown保留原始RX，可能包含未识别应答；no_reply仅说明该窗口没有收到数据。
5. RX前缀若反复是CE CE CE CE 00 01，就能直接核对0x0100并非网页数字转换造成。该字节与手册电源故障示例一致，但外部供电、雷达内部故障或查询支持情况仍需据实继续定位，不能只据此判定学生电源/XL4015有问题。
6. 身份查询成功后，再静止执行radar scan；测量包增长、报警新增停止、ready及points_valid=true才说明扫描恢复。不要要求累计报警清零。无需先做地图定位；工作室环境同样可以检查完整点云。

本轮软件回归、模拟页面及编译通过，不表示实机已回复SN或雷达供电故障已排除。回退前保存后续工作，使用`git revert`撤销本次通信验证提交，保留76aa76b及之前历史，不使用reset --hard。实现与说明随同一独立提交保存，具体哈希见Git记录和交付信息。
