doinbest/Yachiyo/xjx/模版搭建/docs/开发记录/2026-10-05-实车监控参考坐标90度修正.md

# 实车监控参考坐标90度修正

日期：2026-10-05。范围：正式`#map/monitor`的“沿用备用页安装设置”入口、正式角落起点格的扫描障碍豁免及对应说明；备用`#map/radar`继续使用独立F1参考坐标。

## 原因与修正

正式监控复制备用安装参数时，原实现直接写入备用的`radarX/radarY`，并用`zero_deg=90°`匹配F1的sin/cos投影，遗漏了参考地图到赛事地图的整场逆时针90°转换。两页数值相同不能说明其场地坐标一致：F1原始0°朝+Y，而参考地图经转换后这一方向在正式赛事地图中朝−X。

复制入口按以下关系写入正式雷达RAM：

- 位置：`T(x,y)=(2400-y,x)`，即`lidar_x=2400-backup.radarY`、`lidar_y=backup.radarX`。
- 原始0°地图方向：F1的+Y对应正式90°，再随整场逆时针90°转换为180°，写入`zero_deg=180°`。
- 原始角域、距离、能量和障碍阈值沿用备用页设置；不复制备用任务或网格。

因此同一个备用(230,230)测试安装对应正式(2170,230,180°)。这是测试安装的坐标转换，固件生产默认下方(2250,150,180°)保持原值，上方标准角落配置也不因复制入口变化而改写。

## 坐标修正后实机发现与起点规则

坐标修正后的正式RAM位姿为(2170,230,180°)，实机静止扫描中的R2C1、R5C1方向与现场布局相符。但右下启停格R1C5分别积累200点、196点，并被标为扫描障碍，导致第一段规划无路。此次无路的直接原因是雷达所在起点格参与扫描判障，不是坐标仍需继续旋转；不据这些点数推定全部回波的实物来源。

沿用用户此前确认的F1起点格保护目的，正式扫描建图在`RadarMap_Finish`中仅对雷达所在的标准角落起点格豁免扫描障碍：安装格为右下R1C5/bit4时只豁免bit4，安装格为右上R5C5/bit24时只豁免bit24；安装在其他格时不追加该豁免。另一角落、粗加工和暂存仍正常判障，既有二维码前bit14、原料前bit22豁免保留，不扩展为全部工位保护。

格内原始`counts`与证据均保留，`RadarMap_FinishRaw`继续输出原始证据；人工`radar map.mask`及规划函数不自动清除起点格障碍。自动起点冲突判定仍仅依据二维码前bit14、原料前bit22，不增加起点格冲突条件，也不因扫描豁免抹去冲突证据。

## 影响范围与历史记录

坐标转换仅在复制备用F1安装参数时执行。已是`current`的正式设备地图、路径、点云及冻结pose继续按当前赛事坐标使用，不再次旋转；底盘、IMU、电机方向、车辆原点及工位锚点不变。正式扫描掩码新增上述安装起点格豁免；备用F1页、正式判障网格边界、路径算法和运动入口不变。

[全场雷达与绕障预演验证记录](2026-10-05-实车监控全场雷达与绕障预演验证.md)保留原(230,230,90°)测试参数、计数、耗时和外框检查事实，并补充坐标遗漏状态。旧结果不能作为修正后正式坐标对齐或实车绕障验收的依据，应用新安装参数后需以新完整圈的地图与路线核对。

## 验证结果

软件验证：坐标回归先在旧实现上复现2项失败，修复后网页404项测试全部通过；雷达服务23项测试通过。起点格保护回归先复现4项失败，修复后雷达地图/规划273752项检查通过，完整固件主机回归PASS。Keil Target `template`编译0错误、0警告；Flash 194392 bytes、RAM 110880 bytes。

DAPLink使用CMSIS-DAP/SWD、4000 kHz，烧录当前HEX并得到`Verified OK`。烧录校验期间探针出现一次USB busy/late transfer提示，随后完成校验并正常恢复运行。按本轮“不驱动步进电机”约束，在本次启动的`GrabTask_BootHomeStart`入口命中断点后跳过一次自动回零；未修改固件正常上电流程，普通复位仍会执行原有自动回零。

COM14、115200/8N1的最终读回为(2170,230,180°)、原始角域0～360°、距离100～40000 mm、能量0～255、阈值1。两次真实静止扫描均收齐同圈地图与路径：

| 扫描 | 完整圈状态到达 | 同圈地图/路线收齐 | 扫描障碍格 | 起点格原始计数 | 设备路线 |
|---|---:|---:|---|---:|---|
| 第一次 | 3417 ms | 5286 ms | R2C1、R5C1 | R1C5：119，不判障 | 可达，19点 |
| 第二次 | 2814 ms | 4767 ms | R2C1、R5C1 | R1C5：182，不判障 | 可达，19点 |

时间均从扫描命令请求开始统计，包含串口链路与后台接收，不是纯雷达机械旋转时间。两次设备路径均包含完整业务顺序`1→5→4→2→3→4→2→3→1`。验证没有调用路线模拟审查，没有发送底盘、机械臂或步进电机运动命令；最后停止雷达，保留设备完整结果。

最终通过前，无线接收曾出现截断行和参数应答超时。临时通过DAP清除周期状态Watching标志让无线队列排空；随后正常雷达命令自动恢复Watching，改用仅写入3个变化参数并逐项读回的验证流程，不增加固定30 ms等待，不修改无线发送算法。本轮结果证明坐标/起点保护及最终两圈串口同步通过，不宣称无线偶发丢字问题已彻底消除，也不代表实车运动验收。

证据：`.embeddedskills/monitor-frame-20261005/serial-summary.json`、`serial-coordinate.jsonl`、`flash-no-motion.log`及`build/template-template-build.log`；软件日志位于`.embeddedskills/tests/monitor-frame-web.log`、`monitor-frame-service.log`、`monitor-frame-firmware.log`。
