doinbest/Yachiyo/xjx/模版搭建/docs/开发记录/2026-10-05-车载取放口X默认100mm.md

# 车载取放口 X 默认 100 mm

用户指定 `x_car` 为 10 cm，即相对 X 回零原点的绝对位置 `100 mm`。本次只修改该固件默认值，不改雷达、网页、通信节奏或 Base 回零流程。

## 原因与修改

此前 `GrabTask_Init()` 将 `x_car` 留为未设置；启动回零又清除 X 相关参考，而 X 回零成功后只恢复尺度、行程和预伸位置，未恢复车载取放口位置。因此复位或回零后会报告缺少 `x_car`。

- 在 `Code/template/App/mechanical_arm_config.h` 集中定义 `MECHANICAL_ARM_CAR_X_DEFAULT_MM=100.0f`。
- 在 `GrabTask_Init()` 和 X 回零反馈验证成功的分支恢复该值；100 mm 位于现有 X 默认行程 `[0,100] mm` 内，不扩大行程。
- `grab set x_car ...` 仍只改 RAM，普通停止保留调参值，复位或验证回零后恢复固件默认；手动改变 X 原点仍使相关参考失效。
- 保留现有驱动故障处理；日志中的 Base `home_flags=0x0B` / `home_driver_fault` 为独立问题，不能通过补齐 `x_car` 消除。

## 软件验证

先新增回归并确认旧实现读取不到 `x_car=100`，修改后验证初始化、重置、完整启动回零、参数就绪、普通停止保留调参及手动 X 参考失效。

- `python Code/tests/run_firmware_tests.py`：完整固件主机回归通过；日志 `.embeddedskills/tests/host-tests.log`。
- Keil 全量重建 `Code/template/MDK-ARM/template.uvprojx`，Target `template`：0 错误、0 警告；日志 `.embeddedskills/build/template-template-rebuild.log`。
- Flash 192904 字节，RAM 110872 字节；产物 `Code/template/MDK-ARM/template/template.hex`。

## 上板确认

尚未烧录或发送设备命令。烧录新固件后，在 X 回零验证成功后通过 `grab get x_car` 读回应为 `100`；取放位置仍需实车动作验收。若仍有 Base 回零故障，应单独排查，不把参数读回当作三轴回零或取放成功。
