doinbest/Yachiyo/xjx/模版搭建/docs/开发记录/2026-10-06-第一阶段底盘伸缩轴稳定追踪.md

# 第一阶段：底盘与伸缩轴稳定追踪

## 范围与交付状态

按用户确认的完整计划实现独立动态追踪。从已对准/小偏差姿态进入，像素到点仍保留目标速度前馈；只操作底盘和X，到可达窗口边缘停车保留姿态。不实现大偏差拦截、下降夹取、入仓或自动追下一圈。

已完成控制器、GrabTask接入、追踪总线节奏、独立网页卡、诊断导出及测试，早期版本已Keil构建和DAPLink验证烧录。现场已完成仅观察、恢复间隙及首次静止目标追踪，发现反馈调度问题；最新修复按用户电池耗尽后的要求只编译、不再烧录。真实6/8/10 rpm跟随尚未验收，不能用编译或理想模型宣称稳定追踪成功。

## 实现

- `Code/template/App/grab_tracking.c/.h`：纯C控制器，32个目标/机构运动样本、240 ms局部二次拟合，样本不足一阶估计；重复seq/时间戳不重复计误差。用曝光延迟假设插值机构运动，估计`g=e-Jq`，计算`Jv=-(目标预测速度+lambda·预测误差)`。零误差保留速度，物料停止后前馈回落。
- `GrabTask.c`：观察、匹配、跟随、视觉/窗口暂停、人工停止。局部底盘观察器独立于正式地图；从HOLD保留X/Z/Base，不先执行x_pre。以四轮位置差估计近期速度，按X位置时间戳外推，避免把低频速度缓存或旧X位置当成当前相机运动。
- 速度约束：加权最小范数分配（约30%底盘接近、70%X），活跃约束枚举后重新求解剩余自由度，再按可实现需求缩放。X0～100 mm；料台方向底盘累计接近50 mm，以固定局部参考累计，普通停止/重新开始不重置。依据剩余距离、发送周期及速度提前制动；没有硬编码未经标定的转盘相位。
- X位置流：120 ms前瞻、12 mm领先限幅，按需求速度换算RPM，脉冲余量保留。忙时最新目标替换，不排旧小段；目标停止取消旧前瞻段。
- `mecanum_chassis.c`：追踪专用80 ms目标节奏，其他模式仍100 ms。四轮同步和Receive应答、UART5 10 ms事务间隔、停车优先保持；批次间明确留反馈机会，X位置优先更新，轮位置公平轮询，轮速/驱动状态较低频读取。
- 短漏检≤250 ms：沿近期目标运动预测并衰减，不继续重复积分旧像素误差；更久停车等待新坐标后接回。窗口边缘停车只人工启动。真实驱动故障、人工停车和原点/观察参考变化沿用既有处理。
- `grab-track.mjs`及主页面/桥接：独立卡、13项预设、显式写入读回、优先停止、中文摘要。网页启动/刷新/重连不运动、不自动建立参考；静态参数与追踪参数分开。
- MCU128条环形记录；计算时间、视觉seq/rx、误差、目标速度、实际/命令速度、位置、预算、反馈年龄及请求/发送年龄均记录。`Code/tools/tracking_report.py`仅处理日志，分别统计启动与稳定部分，不访问串口。
- 停车后的记录导出使用紧凑19项CSV及IEEE CRC32，每200 ms发送一条，网页只补读坏条/缺条，收齐才导出；该节奏不进入运动控制路径，不恢复USART1固定30 ms等待。

不修改IOC、EIDE、Emm官方驱动、香橙派B2程序、静态align/pick参数、雷达/路线或上电回零行为。仅Keil添加新模块。

## 参数、方向与机械几何

沿用现有观察姿态：Base回零方向朝车体左侧料台，底盘前向用于横向跟随、左向与X伸出共同承担接近；J列次序为车体前向、左向、X。像素误差为`(CX-ref_u, ref_v-CY)`。不改已验证轮向、IMU符号或地图原点。

料台半径150 mm、物料轨迹半径100 mm、底盘中心初距370 mm、朝台外缘≤150 mm：初始间隙70 mm，预留20 mm，接近预算50 mm。该参考由人工在停止姿态建立，不是假装在线测得料台距离；真实移动料台、换观察姿态后应局部重建。X实际0～100 mm，不扩大机械行程。

追踪默认body_speed160、x_speed60 mm/s；accel300 mm/s²；lambda2.5 s⁻¹；x_weight2.333333；lead12 mm；tol5 px；control50、batch80、latency50、fit240、horizon120、grace250 ms。独立可调上限body300/X100，默认不使用第二阶段240/600档。

`x_ppm`仅负责命令脉冲/mm换算，不能拿它调速度。Emm默认3200命令脉冲/圈，X运动RPM=`|v_x|·x_ppm·60/3200`；位置反馈使用65536协议单位/圈，两者不同。底盘mm/s经麦轮模型/轮径/传动比换算每轮RPM。软件300 mm/s²、底盘驱动加速度档20和X档8是三种不同量，不能混写。计算50 ms不是实际发送20 Hz，必须用同步完成日志核对。

延迟50 ms只作联调假设；日志保留0/50/100 ms接收预测残差比较，接收年龄不等于完整拍摄延迟。现场仍需同高度静止物体±5 mm校正J和运动验证，若现有模型尺度明显不符只改相关J。

## 软件验证

控制器测试覆盖：6/8/10 rpm双方向、零误差不停、启动速度未匹配、自身相机运动扣除、目标停止、重复帧/同时间戳、噪声/延迟/短漏检、X两端、单轴受限重分配、预算保留、奇异J和冻结记录。GrabTask测试覆盖无X回缩/Z/Base/夹爪动作、实际停车反馈、Pi重开后显式观察重发B2、空闲后重新进入刷新反馈但保留参考。

理想模型测试：20 ms时间步、即时执行命令、latency=0、±45°近侧窗口。表中的“末段”仅指该窗口最后35%，不冒充全部稳定段；启动峰值仍保留，全段统计不删除启动样本。

| 名义转速 | 方向 | 末段二维误差RMS / px | 末段峰值 / px | 启动峰值 / px | 实物验收 |
|---|---|---:|---:|---:|---|
| 6 rpm | 两方向相同 | 2.00 | 2.28 | 15.04 | 未完成 |
| 8 rpm | 两方向相同 | 2.67 | 3.16 | 25.18 | 未完成 |
| 10 rpm | 两方向相同 | 4.87 | 8.33 | 37.99 | 未完成 |

因此模型证明可持续跟随趋势，但启动过渡仍明显；不能据末段RMS判定现场已经达到5 px要求。

真实生产总线代码+8 ms模拟应答：45个四轮批次，最大批次间隔99 ms，50次X位置回复，最大X反馈间隔143 ms；验证Receive、同步、旧目标不排队、轮反馈公平与停车。不是UART5实物追踪成绩。

固件主机回归PASS；网页428/428；桥接32/32。Keil最终构建0错误0警告，Code187928、RO20844、RW2680、ZI127272，RAM总计129952 B（含现有4 KiB栈及堆），保持既有存储区域配置。日志位于`.embeddedskills/stable-tracking-20261006/`。

## 上板证据与现象

- COM14明确115200/8N1，DAPLink CMSIS-DAP/SWD、F407目标，使用带地址HEX；最终紧凑日志版`flash-compact.json`记录programmed/verified均true，HEX SHA256 `016872CFC663D2A807F781C44CE5D5885C89D5BE774CBAE25461769923E58AAC`。
- 重新烧录后Z/X/Base回零完成，missing=none、耗时5603 ms；IMU5秒PASS，51样本、max_gap100 ms、I2C错误0。最终版启动广播在开始记录前已结束，`boot-compact.log`为空；事实以`postflash-grab.json`、`postflash-imu.json`查询及前版`boot-final.log`区分，不把空日志当启动抓取成功。
- 仅观察已受理、底盘/X命令速度为0；X反馈年龄摘要约73～76 ms。尚无转盘6/8/10 rpm实际运动段。
- 首次Pi程序重开时MCU尚保持旧识别请求，USB rx_bytes=0；显式观察现已重新发送B2。空闲再观察曾因旧反馈退出，现改为先刷新反馈，不清有效预算或参数；软件回归与上板重新进入分别记录。
- 此阶段尚未建立料台参考或发送`grab track start`；后续恢复间隙与首次静止目标追踪见末节。追踪不自动移动Z、Base、夹爪，烧录后的原上电回零独立发生。

## USB重枚举与本轮范围

用户报告每次烧录后香橙派视觉程序退出。核对本地`vision.py`：USB接收异常存入`reader_error`，`get_command()`向主循环抛出异常；主循环finally关闭摄像头/USB及窗口。源码支持USB断开导致整程序退出这一机制，尚未取得Pi现场异常栈。STM32显式observe可以重发B2颜色请求，但不能重启Linux进程。用户明确要求“先完成追踪，不改香橙派”，本轮不修改连接层、不SSH、不部署；重连修复留后续。

## 最终版仅观察及静态入口实测

`observe-compact.log`、`observe-report.json`：128/128记录、CRC全对、缺条0，无需补传，冻结窗口6350 ms；计算间隔p95=50 ms，X位置反馈年龄p95=81 ms。控制环保留新样本约20.04 Hz；直接视觉状态seq在1秒摘要间增加31～33，原始B2接收约31～32 Hz，二者是不同统计口径。USB checksum_errors/overflows/invalid_reports均0。命令前/左/X均0；环内实际位移0，四轮位置量化估计最大0.02 mm/s、X0。停车请求07:28:49.683，确认07:28:50.222，约539 ms（含无线）；这是观察状态停车流程，不冒充运动制动成绩。

物料未对准时误差(-151,-58) px，仅观察不作纠偏，不能将此误差当追踪失败；静物速度估计归零，静态数据不能标定完整拍摄延迟。此时ref=0，room=0不代表已经用完预算，而是尚未建立料台参考。完整统计181个新测量；128行仅覆盖末段窗口。

用户随后明确授权静态对准。`align-entry.log`：`grab start align 3`受理后5956 ms进入HOLD，dx/dy=-3/-3 px、X12.837 mm、Z-0.002 mm、Base0.02°，stop_requested/stop_confirmed均1；无下降夹取、无track start。静态align过程中会移动底盘接近，不能拿对准前370 mm距离给对准后重新充值50 mm预算；已请求用户核对对准后的实际距离，再开始6 rpm动态段。

## 后续实车验收顺序

1. 仅观察确认Pi程序及颜色坐标恢复，不要求此步物料位于目标像素点。
2. 将机构放到已验证的观察高度，物料静态align至HOLD或小偏差，确认上述370 mm几何及X反馈余量，静止建立料台参考。
3. 先6，再8，最后10 rpm，两个方向；6/8各一段，10每方向连续三段，只验收近侧窗口，到窗口边缘停车保留姿态。
4. 每段记录转速/方向/起始姿态、startup时间与峰值、全段/稳定误差、速度/位移、批次/X年龄、剩余预算及stop_confirmed。稳定后二维RMS≤5 px、95%样本每轴≤10 px，实际批次p95≤120 ms、X年龄p95≤200 ms。
5. 使用日志比较0/50/100 ms假设，不把当前串口接收时差当拍摄延迟；若相机响应尺度不符，先做三方向±5 mm局部J检查。没有样本或参考时报告缺项，不用软件模拟作实车通过。

## 恢复间隙、首次追踪及电池暂停（08:00后）

用户确认对准后车体到料台边缘仅15 mm，并授权低速退55 mm、X补偿。四轮位置反馈测得远离58.293 mm、前向0.144 mm；停车发送完成且四轮停稳。按实测退距补偿，X从12.837到71.189 mm，位置/到位状态及第二次稳定位置读回均通过。Z、Base、夹爪未参与准备动作。用户实测确认间隙70～75 mm，X仅剩约30 mm；保留0～100 mm实际行程。

`observe-restored-gap.log`：静物CX333/CY326，误差约(-1,+12) px；128条冻结记录CRC完整，观察命令速度全零。基于用户确认间隙建立局部参考，预算50 mm；停止保留参考，不修改正式地图原点。

`track-first-armed.log`、`track-first-frozen.log`：首次`grab track start 3`针对**静止**物料，0.8秒进入跟随标记，随后在约2秒控制记录后因`feedback_stale`停车。实际确认stop_requested/stop_confirmed均1；40/40冻结记录CRC有效。全段二维RMS7.06 px，启动每轴峰值1/12 px，标记跟随的14样本RMS2.87 px；短暂跟随标记不代表稳定实车追踪验收。X到66.17 mm，局部累计靠台位移为负（远离），没有消耗接近预算。未启动转盘。

根因回归使用真实MotorBus/Mecanum代码，模拟8 ms应答并同时提交X位置命令与读位置：原40次读请求的四轮低频状态周期超过2000 ms，第三轮状态年龄2001 ms时断言失败，而位置年龄128 ms正常。改为4轮位置后轮流读取一轮速度/状态，低频全周期24次请求；原鲜度条件不放宽，不暂停反馈。修复后该负载39批、最大批次110 ms、46次X位置回复、最大X反馈年龄99 ms通过。另以80 ms延迟模拟GrabTask机械臂事务，X最大年龄160 ms、Z/Base及状态最大880 ms，通过。

同时实物日志发现首次批次间隔混入了此前手动动作到追踪的空闲时间（48605 ms），既污染统计也影响制动延迟。新增失败回归后修正：仅计本段真正已发送的速度批次，首批间隔未知为0，第二批起报告真实差值，观察/停止不沿用旧值。原始40条证据仍保留，不回写历史数据；旧日志的batch p95不能当实际批次时间。

当前静物运动估计仍出现较大波动，待反馈调度修复上板后，先核对同高度局部J、自身运动补偿与0/50/100 ms延迟假设，再启动6 rpm逆时针测试。首段残差0/50/100分别4.60/7.96/12.61 px，只是预测口径比较，不能据此直接认定真实拍摄延迟为0。

用户随后通知电池耗尽，要求“完成代码修改后先只编译，暂时结束对话”。本轮最终修复不烧录、不继续串口或运动；后续先供电并烧录，再确认香橙派程序恢复、机构观察姿态和实际间隙。复位会回零X，不能假装仍保持71 mm补偿位置；不再使用对准前15 mm间隙建立50 mm预算。

最终验证：固件主机全回归PASS；Keil Target `template`在08:14:38构建成功，0错误0警告，Flash211480 B、RAM129952 B。日志`build-battery-pause/template-template-build.log`；HEX SHA256 `4F8F87A22493AD822871B734F63B45A0D819EB5C648703330EBB446D606D4362`。该HEX尚未烧录，设备仍是此前版本；静物持续跟随与6/8/10 rpm验收均待续测。

## 用户重新烧录后：手动转盘测试准备（15:39后）

用户已自行重新烧录，改为人工慢转物料台，STM32只追踪，不发送物料台转盘电机命令。用户再次确认车体到料台间隙70～75 mm、蓝色物料静止。本轮未再烧录；现场查询回零完成5803 ms、missing=none，IMU五秒验证PASS/51样本/最大间隔100 ms/I2C错误0。不能把用户烧录等同于本轮工具校验下载。

复位后X约0，`manual-before-pose.log`仅观察曾出现坐标从约(286,457)跳至(550,122/123)，继而回原位置；目标静止、机构实际/命令速度为0，USB校验错误与溢出均0。跳点污染了二次速度估计。B2不包含粗/精定位阶段或目标身份，本地Pi源码粗定位取最大颜色轮廓，精定位才采用相邻目标选择；当前证据不足以断言现场具体误识别物体，也没有改Pi或为此新增固件过滤门槛。

`manual-restore-x55.log`：只恢复X，实际0.002→55.045 mm，到位及稳定反馈确认，临时6 RPM执行后恢复原手动配置40 RPM/acc20/limit3200；未动Z、Base或夹爪。`manual-at-x55.log`：观察8秒，CX275/CY361，dx/dy=-59/-23；128/128冻结记录CRC有效、静止目标速度估计回到0，未再出现上述跳点。尚未进入动态追踪。

随后进行切向底盘小位移检查，`manual-cal-forward5.log`原定5 mm，但无线查询及缓存反馈延迟使最终编码器位移为前向13.553 mm、左向0.176 mm。停车发送完成且四轮停稳。该结果说明不能用无线逐次读缓存位置来精确截停毫米级校正；后续应由板上控制闭环执行，不重复此主机截停方法。

此次人工停车中断同步批次，`chassis task`报告`sync_cache_uncertain`、stage5/error5/locked1。总线恢复检查通过、arm_ready=1，但chassis_ready=0，固件要求实际驱动复位以清除同步缓存；没有假称驱动已复位而发送`chassis reset-confirmed`。因此新的observe被`bus_unavailable`拒绝，`manual-cal-forward-after.log`不含有效新视觉数据，不能用于J标定或追踪成绩。已请求用户重新上电，转盘继续静止；正式手动旋转段尚未开始。此时不是COM14连接中断或追踪算法失败。

## 重新上电后：分时轮反馈与静物振荡定位（16:00后）

用户重新上电并确认Pi程序恢复、物料静止、车距未人工改变。COM14正常，不把静物追踪误差归因于无线中断。恢复X到65 mm，仍保留实际0～100 mm行程，Z/Base/夹爪不参与追踪。

发现共享底盘反馈观察器要求四轮时间跨度≤250 ms，而追踪公平轮询的真实编码器位置读数相差300～500 ms，导致旧补偿反复丢弃基线。新增实码回归：20 mm/s运动4秒、每100 ms更新一轮，旧观察器q=0且valid=0；追踪专用时间对齐后q=80.001 mm、v=19.999 mm/s，停车后位姿保留、真实过期仍无效。共享地图观察器、IMU、电机极性和正式原点未修改。

此第一版反馈修正经过主机全回归及Keil0错误0警告，DAPLink烧录校验成功（`flash-feedback-alignment.json`；HEX SHA256 `4329E38068E6309E4E74831F711CA3FFC9B55CB543DF200FE86D03BE414A0824`）。启动回零和IMU通过，`feedback-alignment-inspect.log`保留读回。用户重开Pi后视觉约31～32 Hz，仅观察静物坐标稳定。

低速实物验证均为**静止物料**，未让用户转盘；追踪临时body_speed=20、x_speed=10 mm/s：

| 原始日志 | 冻结记录 | 全段二维RMS | 每轴p95 | 四轮批次p95 | X反馈年龄p95 | 结论 |
|---|---:|---:|---|---:|---:|---|
| `feedback-alignment-static-track.log`，fit240/latency50 | 113/113、CRC完整 | 10.55 px | 24/4 px | 103 ms | 97 ms | 反复修正，未通过 |
| `feedback-alignment-static-fit500.log`，仅把fit改500 | 112/112、CRC完整 | 8.07 px | 24/2 px | 102 ms | 97 ms | 仍振荡，不采用此调参作为修复 |

两段均确认停车，参考保留；fit500仅是RAM诊断，不改变固件默认240。短暂“stable”标记的低RMS不能替代全段验收。0/50/100统计为预测残差口径，不能用它直接宣称实际相机拍摄延迟为0。

进一步失败回归表明：将一轮上一段约400 ms的平均编码器速度外推到现在，正反向切换时出现7.211 mm峰值位置误差及3.581 mm单次跳变。此跳变经240 ms二次拟合放大成静物虚假速度；实物记录目标速度估计峰值达927.88 px/s。不是物料真实在高速运动。

第二版在**追踪局部**保留32条已完成同步批次的轮运动积分，按每个编码器的原时间戳计算创新，用真实位置持续校正短暂命令推演，并在100 ms内连续吸收修正，避免单轮回复造成相机位姿瞬跳。未受理/未同步发送的请求不进入推演；actual速度诊断仍来自编码器测量斜率，预测位移不冒充独立测量。未改共享底盘观察器、UART5事务间隔、反馈调度、J、静态align/pick或其他业务参数。

软件回归：相同反向测试误差降为2.284 mm、单步0.442 mm；加入30 Hz量化像素、50 ms视觉延迟、100 ms命令批次、80 ms电机响应和分时编码器的静物闭环，2秒后RMS2.676 px、峰值7 px。属于软件模型，不代表实车通过。完整固件回归PASS，日志`command-alignment-tests.log`；Keil在16:36:49构建0错误0警告，Flash212500 B、RAM130744 B，日志`build-command-alignment/template-template-build.log`，HEX SHA256 `56B2ECFF553274FB13164897E9A14A97A7EE1ACF706FAC4906442DECD743C072`。

第二版DAPLink烧录及校验均成功，`flash-command-alignment.json`记录programmed/verified=true。`command-alignment-boot.log`完整记录回零完成6903 ms，随后`command-alignment-inspect.log`确认IMU五秒PASS、51样本、max_gap100 ms、I2C错误0、底盘无锁定或发送故障。X只恢复至63.218 mm，读回到位/稳定反馈确认，原手动RPM/加速度/脉冲限制恢复；未在此准备动作中移动底盘、Z、Base或夹爪。

用户重开Pi后，`command-alignment-observe.log`最初收到静物CX333/CY336、误差-1/+2 px，随后无线查询突然无回复。DAPLink诊断CFSR/HFSR为0；uwTick及观察器时间曾不增长，内核暂停时PC在HAL_UART_IRQHandler、xPSR异常号54（USART2中断），DFSR.HALTED置位。恢复运行后COM14回复和实际停车确认恢复；尚未确定最初调试暂停的触发来源，不归因于算法振荡或确认无线模块损坏。

`command-alignment-reference-retry.log`复测无新视觉数据并已停车，stop_confirmed=1、ref=0；camera只读确认usb=1、rx_bytes=686、checksum_errors/overflows/invalid_reports=0。停顿后的Pi是否退出未取得现场异常栈，已请求重开程序再继续。第二版尚未完成实物运动追踪，转盘仍静止；不得把21条仅观察静物误差或软件2.676 px结果写作新补偿版实车追踪通过。

### 第二版静物实测与后续阻塞（16:52后）

用户再次重开Pi，`command-alignment-reference-final.log`确认新蓝色坐标恢复、X约63.19 mm，停止状态建立参考并取得停车确认。本次没有重新烧录。

`command-alignment-static-track.log`：静物追踪约6秒，114/114条冻结记录CRC有效、无缺条；全段二维RMS8.108 px、每轴p95为18/2 px、峰值28/2 px，四轮实际批次p95为103 ms，X反馈年龄p95为96 ms。短暂跟随标记60条的RMS1.949 px不能代替整段；静物随后振荡，仍未达到稳定追踪要求。环内前向位移7.46 mm、左向0.01 mm、X变化-1.32 mm，最小剩余接近预算49.99 mm。末尾停止反馈确认，转盘全程未启动。

最高823.07 px/s是`GrabTracking_Update`输出的目标速度估计，不是Center坐标的直接测量速度，也不是底盘实测速度。算法先从像素误差减去J乘相机机构位移，再以240 ms二次拟合估计速度和加速度，最后按接收年龄加50 ms进行预测。MCU该段记录的横向坐标在seq279/280/282/283分别为321/322/348/351，接收时间639022/639059/639122/639157 ms；最大估计出现在seq283。本地Pi源码终端默认每1秒打印一次，而USB坐标更新更快，因此终端显示与MCU中间帧必须区分；尚未取得同一时段Pi逐帧原始输出，不能据此直接认定Pi识别算法错误。即使坐标恒定，机构位移补偿变化也能产生非零拟合速度；分时反馈、命令预测及视觉过滤时序不一致是继续调查的重点，不能把823当物料真实运动或直接用限幅掩盖。

计划中的下一次仅观察被`ERR grab track bus_unavailable`拒绝，`command-alignment-poststop-observe.log`保留失败输入，不能算有效观察或新的追踪成绩。随后只读查询显示底盘stage=5/error=5/locked=1，COM14通信正常。执行既有`bus recover`后，设备返回`arm_ready=1 chassis_ready=0 reason=chassis_cache_or_state_requires_reset`，随后`tx_complete=1 wheels_stopped=1 reason=stopped`。确认驱动停止与解除运动锁定是不同结果；没有发送未经实际驱动复位确认的`chassis reset-confirmed`，也没有开始手动转盘追踪。

已向用户说明需要重新考虑估计闭环：保留自身运动补偿与240 ms拟合，但不能将短窗拟合噪声直接高增益送入前馈。用户追问Center未变为何会产生823 px/s；当前先解释测量、运动补偿及预测的区别，尚未实施新的估计器架构调整。

### Center稳定性串口核验（17:11后）

用户要求继续调用串口，先用既有`camera material 3`独立识别入口，不启动任何运动，不因底盘锁定而跳过视觉验证。`center-only-still-serial.log`记录12.3秒、24条限频坐标输出，全部为CX333/CY339、DX-1/DY-1，序号2226到2599。无线调试输出自身受约500 ms限频，因此24条不能冒充完整USB逐帧记录；接收序号增长支持原始视觉约31～32 Hz。此前首次回复中偶有CX332，仍是1 px量级，未复现运动测试中的大幅坐标变化。不能据静止样本直接否定运动过程的视觉延迟或补偿失配。

用户随后确认电机/整车重新上电并重开Pi。只读核对回零完成7004 ms、missing=none，IMU5秒PASS、51样本、max_gap100 ms、I2C错误0，底盘error=0/locked=0。复位后的X从约0恢复至55.067 mm，再至63.083 mm；两段实际位置和到位/稳定反馈均确认，临时6 RPM后恢复原手动配置。准备动作只动X，未动底盘、Z、Base或夹爪，未烧录。

`center-check-static-observer.log`为新一段**仅观察**：128/128冻结记录CRC完整，无缺条；环内6350 ms，140个新视觉样本覆盖整段统计。计算间隔p95为50 ms、X反馈年龄p95为82 ms；底盘/X实际及命令速度均为0，环内位移均为0，USB checksum_errors/overflows/invalid_reports均0。误差X恒为-1 px，Y为1或2 px，即CX恒333、CY在336/337变化。

此段横向目标速度估计峰值0，纵向峰值38.78 px/s，最后1秒两轴均为0。这给出一个独立证据：即使没有机构运动补偿变化，1 px量化/识别波动经240 ms二次拟合及加速度预测仍能产生数十px/s瞬时前馈。按当前J纵向2 px/mm，38.78 px/s对应约19.39 mm/s的联合运动需求（尚未执行），不能将其当成物料真实运动。运动中的823 px/s还有补偿、时序及闭环因素，不宣称此只观察段已经完全证明其全部根因。

本段结束stop_confirmed=1，随后底盘查询stage=5/error=0/locked=0；未因纯观察停止引入同步缓存锁定。X约62.99 mm，转盘始终静止，当前ref=0（上电后未重新建立），不是接近预算耗尽。本次只做串口验证和记录，未修改估计器或运行新的追踪运动段。

### 噪声约束估计器及静物追踪实测（17:42后）

用户授权继续修改、烧录验证。保留自身运动补偿、默认240 ms局部拟合、目标速度前馈和位置纠偏，不以到点窗口关掉前馈。拟合加入0.5 px RMS的量化噪声初值、12 px/s速度及80 px/s²曲率连续先验；曲率缺少跨像素证据时逐渐减弱加速度，线性趋势清楚时加快速度更新，弱趋势慢更新。不是固定速度阈值删掉慢速物料，也不是对823 px/s结果直接截断。最后一次原始拟合、补偿坐标及趋势权重仅由显式status额外输出，128条循环记录及19列CSV保持不变。

软件失败回归及修复：一像素静物噪声的峰值前馈由17.619降至3.918 px/s；回放此前静物观察日志由38.78降至4.277 px/s。5 px/s量化慢运动估计5.327 px/s，没有被当成静物。6/8/10 rpm双方向理想模型末段RMS为2.33/2.67/4.63 px、峰值2.50/3.15/8.04 px，启动峰值16.31/26.20/37.93 px；带Pi自适应滤波模型的静物闭环2秒后RMS1.445 px、峰值5 px。这些是软件证据，未替代转动物料验收。

估计器版Keil构建0错误0警告，Flash213468 B、RAM130776 B；17:42:59 DAPLink编程及校验成功，已烧录HEX SHA256 `1EBD9D9A7D200AAD57A4B88B2603B919EE463DD517F24505D3A2A7843CDED42A`。`noise-estimator-after-flash.log`确认回零完成6803 ms、missing=none，IMU5秒PASS/51样本/max_gap100 ms/I2C错误0；BUILD广播仍是未重编译的旧对象时间，不能仅用该时间判断HEX版本。用户重开Pi后，只恢复X到55再63.052 mm，到位及稳定反馈均确认，手动配置恢复；未动Z/Base/夹爪。此时仍采用此前用户确认的70～75 mm间隙，静止建立50 mm接近预算。

`noise-estimator-observe.log`：128/128条CRC完整，仅观察新视觉145次，原始USB约32 Hz、控制50 ms周期；坐标一像素波动，环内目标估计峰值4.37 px/s，运动命令及位移为0，USB校验/溢出/非法报告均0，结束stop_confirmed=1。

`noise-estimator-static-track.log`：物料及转盘始终静止，body_speed=20、x_speed=10 mm/s；约8秒共同纠偏，初始误差约(+8,-37) px，约2秒进入±5 px窗口，随后保持约(+1,0～2) px，无此前反复摆动。完整155个新测量包含启动的每轴RMS为2.216/9.516 px，二维RMS约9.771 px、每轴p95为5/30 px。末段128条CRC全对，覆盖6350 ms，二维RMS1.4307 px、每轴p95为1/2 px、峰值2/4 px；四轮实际批次间隔p95=102 ms，X反馈年龄p95=99 ms。冻结环报告中的first_stable_ms=150仅相对末段环起点，不是本段真实启动时间；不删启动样本冒充全程稳定。

本段局部底盘总位移约前向-3.06 mm、左向+12.32 mm，X约63.05→69.60 mm，剩余接近预算37.68 mm；末次目标速度、加速度及前馈归零。按几何推算间隙比此前70～75 mm减少约12.32 mm，下一次不能在此位置重建新的50 mm预算。实际停车反馈确认；末段环内位移仅前向0.10/左向0.25/X1.26 mm，不能代替整段总位移。报告`noise-estimator-static-track-report.json`及原始日志保留。此结果仅证明新版**静物收敛与稳定保持**，尚未完成手动转盘、6/8/10 rpm及双方向追踪验收。

### 零速同步停车误锁定修复及当前烧录阻塞（18:06）

下一段启动被bus_unavailable拒绝。`noise-estimator-poststop-inspect.log`显示stage5/error5/locked1但四轮速度均0；`noise-estimator-stop-cache-memory.log`直接只读DAP内存确认四轮同步F6缓存RPM全为0、BatchIndex=4、SyncCacheUncertain=1。根因是停止中断已开始的同步批次一律按可能含运动目标处理，连零速批次也锁定；Receive模式下取消在途零速F6的迟到应答又被按普通运动取消隔离。

修复限于明确四轮F6/RPM全0的同步批次：没有既存非零/未知同步缓存时不再制造缓存不确定锁定；仍立即发送优先停车，后续运动必须重写全部四轮目标才广播同步。取消中的零速F6应答按既有排空流程消费，停车优先不变；排空超时、非零批次、真实驱动故障和既存未知缓存处理不放宽。软件测试覆盖Receive模式五个中断时刻、晚到ACK、停车、重新运动完整四轮写入与原非零取消锁定。没有发送虚假的reset-confirmed或手工清除设备锁定。

最终完整固件主机回归PASS（`noise-and-zero-stop-final-regression.log`），真实生产总线模拟39批、最大批次110 ms、46次X回复/最大反馈年龄99 ms；Keil18:06:12构建0错误0警告，Flash213588 B、RAM130776 B，`build-noise-and-zero-stop-final/template-template-build.log`。最新HEX SHA256 `4D9C4FA78F90C821D4239935C5B8D40728429A5B291914AE8FF9684473FF5255`。

此前零速修复烧录尝试及再探测均在CMSIS-DAP CMD_INFO阶段无响应，未连接目标，`flash-zero-sync-stop.json`明确status=error，不能据管道退出码0宣称烧录成功。**设备仍为已实测的估计器版，最终零速停车修复尚未烧录。** 已请求用户仅重新插拔DAPLink USB，保持机构及物料台不动；恢复后先烧录校验并核对零速停车/重启，再考虑恢复间隙、X姿态和料台参考。串口当前锁定不是视觉估计失败，也不能把未进行的手动旋转段写成通过。

### DAP恢复、零速停车实测及剩余预算恢复（18:11～18:22）

用户重新上电后CMSIS-DAP恢复，18:11:14最终零速修复烧录及校验成功，`flash-noise-and-zero-stop-final.json`的programmed/verified均true；`noise-and-zero-stop-final-inspect.log`确认回零完成5603 ms、missing=none、IMU5秒PASS、51样本、max_gap100 ms、I2C错误0、error/locked均0。该次boot监听结束早于复位后广播，不能用仅有空字节的boot文件宣称捕获启动。

`noise-and-zero-stop-final-zero-validation.log`：六次零平移/零角速度HOLD_CURRENT请求与优先停车、不同无线等待间隔，每次均得到tx_complete=1、wheels_stopped=1，并能受理下一次请求，error=0/locked=0；最终四轮RPM为0。编码器仅1～9个协议单位量化差，不发生有意义的车体位移。这是实物停车/再启动证据；软件测试覆盖精确在途中断时刻，无线请求无法证明每次都恰好打断同一UART5字节。

重新上电只回零X，不恢复底盘原位置。前一段消耗12.32 mm接近预算，按此前确认间隙推算当前58～63 mm，不能在当前位置重新充值50 mm。新增兼容命令`grab track reference [remaining_mm]`，默认行为50 mm不变，允许显式0～50 mm恢复已知剩余预算；仅改变局部预算锚点，不增加行程、改J或正式地图原点，普通stop/start仍保留锚点。新增失败测试先证明旧命令拒绝37，再验证37读回、超过50拒绝且不改变旧锚点、start/stop不充值。软件全回归PASS（`noise-stop-budget-regression.log`）。

18:20:07 DAPLink再次烧录及校验成功，`flash-noise-stop-budget.json`的programmed/verified均true；当前设备与交付HEX为SHA256 `E85DB70461CDCB7411D5BA7A5E2B2EC5396891779CB8811D79DB0AE6C25FBF6A`。Keil0错误0警告，Flash213732 B、RAM130776 B，`build-noise-stop-budget/template-template-build.log`。`noise-stop-budget-boot.log`捕获原上电回零完成7003 ms，之后inspect确认IMU5秒PASS/51样本/max_gap100 ms/I2C错误0，底盘无锁定。仅恢复X到55再69.515 mm，位置、到位及稳定均确认，手动配置恢复；用户重开Pi后以`grab track reference 37`显式建立剩余预算并确认停止，`noise-stop-budget-reference37.log`保留回复及room=37.00。

最终版`noise-stop-budget-static-final.log`：静物低速纠偏约4秒，74/74冻结记录CRC有效、无缺条；初始(+7,+1) px，约0.5秒进入跟随，整段二维RMS2.5811 px、每轴p95为7/1 px、峰值7/1 px；64个跟随标记样本RMS1.4737 px，仅作附加口径。实际批次p95=112 ms，X反馈年龄p95=100 ms；局部前向-3.15 mm、左向-0.59 mm、X约69.50→68.74 mm，预算37→37.59 mm，实际停车确认。此段涵盖启动，不用稳定段替换整段。转盘始终静止，尚未取得人工旋转样本；已通知用户准备小角度慢转，等待其准备好再启动。

### 人工较快往返转动：低速限幅未通过（18:24～18:29）

用户准备后开始35秒追踪，测试脚本仍沿用静物body_speed=20、x_speed=10 mm/s，而不是固件追踪默认160/60。首个10秒串口轮询返回已发现坐标大幅变化，尚未发出“可以开始转”的提示；随后用户明确说明已在近端不匀速、较快来回转动，速度比6 rpm快不少。不能把此段直接诊断为静物估计器噪声回归，也不能据此声称真实物料恒定某转速或已通过动态追踪。100 mm半径下6 rpm线速度约62.83 mm/s，低速限幅不足以覆盖该运动。

`noise-stop-budget-manual-turn.log`及同名report.json：128/128条CRC完整，末段6350 ms二维RMS107.31 px、每轴p95为170/55 px，无稳定样本；整段677新测量每轴RMS118.509/44.669 px。固件100 px误差分箱的p95=100为溢出下界，不当作精确100 px。命令反复达到20/10上限，反馈批次p95=103 ms、X年龄p95=95 ms，不能把低速度限幅导致的落后解释成总线失联。目标估计仅是局部补偿拟合结果，未取得转盘角度/时间基准，不用估计值冒充实测速率。

本段正常结束实际停车确认，局部底盘forward=-54.65 mm、left=-21.32 mm，X停在82.703 mm，room=58.32 mm（远离料台增加余量，不是重新充值参考）；最小预算未越界。`noise-stop-budget-manual-poststop-inspect.log`确认四轮RPM0、grab stop_confirmed=1，但底盘stage5/error5/locked1：这次停止中断的是**非零**同步批次，既有未知缓存锁定仍生效；本轮零速例外不能清除它，没有使用虚假的reset-confirmed。随后观察被bus_unavailable拒绝，不是成功的新观察段。

使用不依赖底盘运动资格的`camera material 3`只读核验，`noise-stop-budget-after-manual-center.log`：用户停止转动后约6秒坐标稳定在CX370/CY325、DX36/DY13，USB校验/溢出/非法报告均0、序号持续增长。期间未发底盘/X运动，最后camera stop受理。当前追踪RAM测试限幅仍20/10，软件默认仍160/60；下一段必须先恢复电机运动资格、保留或按实际间隙恢复参考，再用原计划速度档单方向慢转验证，不能只解除限幅后直接从未知状态运行。**静物修复已实测有效，动态转动物料验收尚未通过。**

### 18:58 后续：串口恢复同步缓存

用户明确授权免断电恢复功能并烧录；增强`bus recover`，用四轮零速缓存写入、逐地址同步及新鲜停稳反馈解除取消锁定，不假称驱动器已物理复位。最终COM14三次恢复全部通过，耗时约2.2～2.3秒，四轮实际RPM0、error0/locked0，不自动继续运动。详见[串口免断电恢复记录](2026-10-06-串口免断电清理四轮同步缓存.md)。该次烧录已触发三轴回零，当前不再是前段X=82.703的观察姿态；后续追踪需恢复姿态和视觉连接。本轮不追加动态追踪验收。

### 19:30 续测：恢复视觉与启动缓存反馈资格

用户重开Pi后，COM14收到约31 Hz合法B2报文，126条Valid=0，USB校验/溢出均0；不是继续0字节失联。仅恢复X至55.039再63.015 mm，实际到位及稳定反馈确认，手动RPM/acc/limit恢复，未动底盘/Z/Base/夹爪。`resume-x63-observe.log`六秒仅观察稳定CX357/CY367、误差23/-29。重新停止/observe请求后`resume-reference50.log`坐标变为431/396、误差97/-58；机构当时未运动，不能当作目标匀速转动。现场尚未确认是实际物料变化还是Pi重新粗定位选取，不修改Pi算法。后续测试工具增加`--keep-observing`，在停止姿态建立参考后保持仅观察，接入start不重复重启B2目标选择；建立失败仍停止。

`resume-default-speed-static.log`已读回独立追踪160/60 mm/s，上板约0.4秒后因feedback_stale退出；实际停车确认。不能据此宣称默认速度静物或动态通过。首轮诊断X缓存年龄1587 ms，回归进一步复现：暂停后的轴反馈年龄1900 ms、轮位置500 ms均未超过旧阈值，旧启动资格仍放行，其随后可能在首批运动时过期。测试`restart_waits_for_current_feedback`先证实旧代码TrackReady错误放行；修正仅在新observe/start资格阶段要求三轴位置/状态及四轮位置/速度/状态收到本次StartTick之后的回复。运行阈值600/2000 ms不放宽，普通停止保留参考与预算，不强制回零，不改变估计器、J、静态align/pick或总线速度。先前实物feedback_stale的具体单项未在报文中记录，不把软件复现冒充单项现场诊断。

本次新测试及固件全部回归通过，`resume-startup-red3.log`为失败证据，`resume-startup-green.log`及`resume-startup-regression.log`为通过证据。Keil0错误0警告，Flash214156 B/RAM130776 B，`build-resume-startup/template-template-build.log`。19:42:17 DAPLink烧录、校验成功，`flash-resume-startup.json` programmed/verified=true，HEX SHA256 `76B96D9FFECB23DC15A817F2464D2A85417F1C9B123799128658D5F96ADF0E4D`。

`resume-startup-boot.log`监听结束过早为0字节，不冒充已捕获启动；随后`resume-startup-after-flash-inspect.log`读回回零完成6903 ms/missing=none、IMU5秒PASS/51样本/max_gap100/I2C错误0、chassis error0/locked0、X0。再恢复X至约67 mm，实际到位和稳定反馈记录在`resume-startup-x55.log`/`resume-startup-x67.log`。烧录后尚需Pi程序恢复；真实启动恢复及手动慢转均待续测。前段已消耗约1.5 mm接近，复位不会归还；下一次参考使用48 mm剩余预算而非自动充值50，当前X仍限0～100 mm。

### 19:45～20:08 默认速度静物摆动与运动补偿估计权重

用户重开Pi后，以48 mm剩余预算建立参考并保持仅观察，start不再重复重发B2。`startup-fixed-static160.log`默认160/60 mm/s、50 ms补偿延迟运行约6秒，117/117记录CRC完整，无feedback_stale，实际停车确认；但全程二维RMS29.89 px、横向峰值75 px、没有稳定样本。实际批次p95=111 ms、X反馈年龄p95=96 ms。底盘局部前向-30.76/左向+12.88 mm，X约67→80.17 mm，剩余预算35.12 mm；这次不再是此前20/10 mm/s静物通过口径。停止后纯观察CX336、CY334/335稳定、USB约32 Hz，不据此把运动过程跳变直接归咎于识别算法。

闭环回归扩展到160 mm/s、20及75 px初始误差，仍使用真实控制器/观察器、100 ms同步发送、80 ms电机滞后、交错编码器以及Pi自适应滤波模型；旧版20 px初始误差两秒后RMS18.985 px/峰值33 px，按原5/10 px要求失败。软件试调latency=150 ms可稳定模型，但不能直接视为现场延迟标定。

串口实测`static160-latency150.log`在初始(+2,+3) px时全程RMS1.91 px、113/113记录、109跟随标记样本，批次p95=102 ms、X年龄95 ms。然而小偏差复测`static160-offset22-latency150.log`仍摆动：初始约22 px，112/112记录，全程RMS13.84 px/峰值32 px，无稳定样本，最终误差约(0,-2) px且停车确认。准备时低速前向位移目标5 mm，但交错反馈和停车延迟导致实际编码器位移10.094 mm（`latency150-offset5.log`）；不把该动作冒充5 mm尺度标定。两次非零批次取消锁定均由`bus recover`约2.23/2.36秒恢复，四轮RPM0，不重启、不重建料台参考。

本次仅修改`grab_tracking.c`拟合噪声：运动中计算`J*(上一控制速度-实际反馈速度)`，按50 ms不确定性尺度增加该像素轴噪声方差，再进入原速度/曲率先验、趋势置信权重和曲率证据；仅观察保持0.5 px量化初值。目的为不把电机尚未匹配和交错反馈造成的自身运动补偿残差当作高置信度物料加速度。未加目标速度硬截断、未降低160/60上限、未改变50 ms延迟默认或原240 ms拟合窗口；实际完整拍摄及滤波延迟仍待动态现场确定。静态align/pick、J、原点、预算、行程和停车条件不变，RAM不增加。

同一失败回归修正后：20 px初始误差模型两秒后RMS0.563 px/峰值2 px，75 px初始误差RMS1.229 px/峰值4 px；原一像素静物噪声峰值3.918 px/s、5 px/s慢目标估计5.327 px/s、零误差前馈及6/8/10 rpm两方向理想闭环均通过。转盘模型现在明确输入运动状态及真实执行速度，未用零实际反馈掩盖模型差异。完整固件回归PASS（`motion-fit-weight-regression.log`），Keil0错误0警告，Flash214300 B/RAM130776 B。以上仍是软件证据，尚未证明本版实车静物或动态追踪通过。

20:06:31 DAPLink烧录及校验成功，`flash-motion-fit-weight.json` programmed/verified=true，HEX SHA256 `EA9E131D87B12B5C70136D91C6DB15FC19560797382E06791D0FC28822068C85`。`motion-fit-weight-boot.log`捕获启动但监听结束在X回零阶段；后续`motion-fit-weight-inspect.log`确认完整回零7903 ms/missing=none、IMU5秒PASS/51样本/max_gap100 ms/I2C错误0、chassis error0/locked0。只恢复X至55再79.058 mm，位置、到位/稳定反馈均确认，临时手动配置恢复；未发底盘/Z/Base/夹爪准备动作。最后旧参考预算约36.18 mm，重新烧录不归还物理接近距离，下一段显式按35 mm保守恢复，而非新50 mm。已请求重开Pi，等待后续实车静物及人工慢转验证。

### 20:13 新版权重默认速度静物实测

用户重开Pi后，`motion-fit-weight-reference35.log`恢复剩余接近预算35 mm，纯观察收到CX351/CY338、误差(+17,0) px，X79.01 mm；保持observe接入start，不再重复重发B2。本次不改代码、不烧录、不移动Z/Base/夹爪。

`motion-fit-weight-static160.log`默认body_speed160、x_speed60 mm/s及latency50 ms运行约6秒，116/116冻结记录CRC完整、无缺条，覆盖5750 ms并包含启动。全程二维RMS4.313 px，每轴RMS4.298/0.360 px、p95为15/1 px、峰值17/1 px；启动600 ms后首次稳定。104个稳定标记样本二维RMS1.535 px，每轴p95为3/1 px、峰值4/1 px。启动误差仍单独保留，全程横向p95不符合10 px，不能用稳定段替代全程结果。

实际四轮批次p95=101 ms、X反馈年龄p95=91 ms，控制周期p95=50 ms。环内有效采样约20 Hz受50 ms控制记录采样限制，不将该数字当作Pi真实发送帧率。底盘局部前向-7.06 mm、左向-0.62 mm，X79.01→78.70 mm；最低剩余接近预算34.65 mm、结束35.62 mm。实际速度峰值（前向/左向/X）17.07/3.42/1.13 mm/s，命令峰值21.25/0.87/2.04 mm/s；未触及速度上限或实际行程。最终stop_confirmed=1。

这次实物证据支持新版在默认限速、小偏差静物条件下收敛并稳定保持；尚未进行本版人工旋转，更未完成6/8/10 rpm双方向验收。下一段等待用户准备后先启动，再提示单方向慢转10～20°、约3～5秒，避免把未经测量的急速往返当作匀速验收。

### 20:16～20:28 追踪正常X停保持抢占四轮批次修复

用户准备后启动25秒追踪，但尚未发出开始慢转提示，约4秒即出现`chassis_tx`并确认实际停车，故未取得人工旋转段。`motion-fit-weight-manual-slow.log`含79个新样本，每轴RMS1.000/0.159 px，故障前目标仍335/338，不能将此次退出归为动态追踪不准。`motion-fit-weight-manual-fault-inspect.log`显示chassis stage5/error5（CANCELLED）/locked1，四轮实际RPM0、missing=none；随后info显示MotorBus本身未隔离，不能将其宣称COM14断连。

源码定位：`track_io`在X速度<=0.1 mm/s且有旧前瞻目标时调用紧急`MechanicalArm_Stop(X)`；官方封装发送FE优先帧，`MotorBus_Submit`会取消另一所有者的在途普通事务。即使被取消的是零RPM四轮F6、不触发总线隔离，底盘收到CANCELLED事件仍进入故障。原零速停车例外只处理整体停车取消，不使正常追踪中无故收到的取消变为成功。新增真实MechanicalArm+MotorBus回归先用原紧急API复现`wheel_event.result==MOTOR_BUS_REPLY`断言失败，再改为正常调度API通过。

新增`MechanicalArm_StopScheduled`仅接受单轴，仍发送相同地址FE/98/00/6B和原STOP完成事件，但优先标志false，等完整四轮事务结束再发送；追踪取消旧X目标使用该入口。人工`stop`、故障停车、广播停止及官方Emm_V5源码不变，不把驱动锁定直接清除、不放宽实际故障。总线实回归加入位置段与普通FE停保持交替，39批/最大110 ms、46次X读取/最大年龄99 ms，正常停保持至少三次且无锁定；原紧急停车测试保留。完整固件回归PASS，日志`scheduled-x-hold-regression.log`。

Keil20:24:55构建0错误0警告，Flash214476 B、RAM130776 B；`build-scheduled-x-hold/template-template-build.log`。20:26:03 DAPLink烧录programmed/verified=true，HEX SHA256 `6563C38193ACB5317E1EE2E440D7A7803A15C5D9B4042999D87539CE8366FA4D`。`scheduled-x-hold-after-flash-inspect.log`确认回零完成7203 ms、missing=none、IMU5秒PASS/51样本/max_gap100 ms/I2C错误0、底盘error0/locked0。只恢复X0→55.036→78.725 mm，实际到位/稳定及原手动配置恢复；未额外移动底盘/Z/Base/夹爪。预算按上次35.62 mm余量下一段恢复35 mm，不充值50；等待用户重开Pi。正常X停保持修复已有软件证据，烧录后的实物追踪、人工慢转和6/8/10 rpm验收仍待验证。

### 20:30～20:37 正常X停保持实测与人工转动记录时序

用户重开Pi后，以35 mm剩余预算建立局部参考并保持仅观察；`scheduled-x-hold-reference35.log`收到新鲜蓝色坐标336/339，X约78.69 mm。`scheduled-x-hold-manual-slow.log`于20:30:23启动160/60 mm/s追踪，20:30:45发出停车，20:30:46反馈确认停止。全段435个新样本，每轴RMS2.000/0.299 px，二维RMS约2.022 px；最后128条记录全部CRC通过，覆盖6.35秒，二维RMS2.002 px、每轴峰值2/1 px，控制周期p95=50 ms、四轮批次p95=101 ms、X反馈年龄p95=97 ms。环首已处于稳定跟随，报告中first_stable_ms=0只相对该冻结窗口，不代表启动无过渡。全段X约78.69→79.19 mm、结束接近余量约35 mm；无chassis_tx或反馈失效。`scheduled-x-hold-static-poststop.log`确认底盘error0/locked0、四轮实际RPM0、stop_confirmed=1，未调用bus recover。

该追踪窗口内坐标始终约336/338～339，没有可辨认的人工转动变化。用户随后回复“已经转完了”；20:35后仅发`camera material 3`重新获取视觉、不发送机构运动，收到约48/361（误差-286/-23 px），接着`camera stop`受理。最终坐标确实改变，但转动的具体时刻未确认，且重新发B2可能重新选取目标，不能据最终差异判定转动期间闭环表现。此次证据支持正常X停保持连续22秒不再打断四轮批次及小偏差静物保持；人工慢转、6/8/10 rpm双方向追踪仍未验收。下一段需让物料回到近端小偏差姿态，并给人工操作留出足够时间；保留既有参考和剩余预算，不重新充值50 mm、不为测试时序再烧录。

### 20:44～20:57 通信中断后恢复观察姿态及首段人工转动

20:44通过交互串口进入track_follow，起始约334/338，随后COM14完全无回复；结束串口会话后直接重开COM14、发送grab track stop/status及chassis stop仍0字节。端口CH340仍可枚举，不将无回复归因于算法，也没有将发送完成冒充停车确认。已告知用户先停止人工转动、确认实车停车及恢复供电。该次交互工具只保存进程日志，未保存完整串口RX文件，不能据此补造运动记录或剩余预算。

用户重新给PCB上电、X回零，并明确要求恢复伸出。`reboot-restore-x-inspect.log`确认home_complete/missing=none、IMU5秒PASS、底盘error0/locked0、X约0。按先55再24 mm恢复：`reboot-restore-x55.log`和`reboot-restore-x79.log`实际到位及稳定反馈通过，X最终79.076 mm，手动rpm40/acc20/limit3200恢复，没有额外发底盘/Z/Base/夹爪动作。随后用户要求继续，收到合法新蓝色坐标331/338，偏差-3/0；复位使追踪局部参考丢失，显式恢复上次35 mm剩余预算而非充值50 mm，`reboot-track-reference35.log`保留仅观察后接入start。本次没有修改或烧录固件。

`reboot-track-manual-long.log`在160/60 mm/s、延迟50 ms下运行约90秒，包含人工转动和大量前后静止样本。20:53:54左右目标开始明显变化，20:54:00左右重新进入跟随，最终334/338并长期保持。用户回复转完后请求结束记录；PTY的Ctrl-C没有提前结束Python循环，最终按既定90秒窗口停车并导出。因此不能宣称“回复后立即冻结动态圈”：128条完整CRC记录只覆盖最后6.35秒的静止保持，不能用其误差0 px和实际速度接近0冒充动态段通过。该限制属采集工具时序，不修改固件跟随逻辑来掩盖。

设备全段统计1791个新样本，每轴RMS11.258/3.706 px（二维约11.85 px），每轴p95=10/6 px；该统计被大量静止样本稀释，仍不是独立动态段RMS。低频状态动态横向误差至少93 px、纵向至少28 px，低频记录不能证明真实峰值上限。动态期间X一度接近100 mm，最后94.391 mm；局部底盘最终前向128.20 mm、左向32.05 mm（接近），低频诊断前向曾190.78 mm、剩余预算曾0.75 mm，最后2.95 mm。人工实际转角/速度尚未量化，不给这一段填6 rpm或10～20°已执行的结论。

`reboot-track-manual-poststop.log`确认stop_requested=1/stop_confirmed=1、四轮RPM0且全部反馈有效、chassis error0/locked0、IMU正常。最后冻结静止窗控制周期p95=50 ms、四轮批次p95=90 ms、X反馈年龄p95=88 ms；运动期低频诊断批次约101 ms。串口、反馈与正常X停保持本段未打断任务，但动态误差不达既定稳定追踪指标，不能宣布验收。保留X姿态、局部参考及2.95 mm剩余预算，不自动恢复为35或50 mm；继续运动前需处理实际可达窗口，并核对人工转动实际角度/用时及动态估计问题。

### 21:09～21:11 反向小窗口追踪未通过

用户补充上一段实际为约120多度、5秒、单方向转动，末端仅小幅反转；120°/5秒约4 rpm，不能继续记为10～20°测试或比6 rpm更快。100 mm物料半径的120°弦长约173 mm、近端接近分量约150 mm，超过该段开始时35 mm底盘接近预算与约21 mm X伸出余量之和。但该几何事实不能代替对动态过冲的诊断。

用户保持在上一段转动末端，明确计划往回转。`window20-reverse-physical.log`起始CX336/CY338、X94.39 mm、剩余接近2.95 mm，未重建参考或充值预算；提示顺时针朝近端20～30°、3～5秒，用户回复转完，实际角度和用时仍待补充。采集辅助脚本新增`--freeze-after-motion`，仅让运动后回到小误差/近零命令保持时提前结束测量并执行原停车、导出，未改变固件控制；本段实际因窗口边缘反馈确认而结束，没有使用保持结束条件。

本次冻结128/128条记录CRC全部有效，包含动态过程，覆盖6350 ms、121个新有效视觉样本：二维RMS30.94 px，每轴RMS14.74/27.20 px、p95为32/65 px、峰值36/77 px；不能用7个稳定标记样本RMS3.78 px宣称通过。全段931个样本含约40秒静止等待，每轴RMS5.543/9.808 px，同样不代替独立动态段。实际四轮批次p95=102 ms、X反馈年龄p95=94 ms，无反馈失效或总线锁定。

低频状态显示X先94.39→60.85 mm、底盘远离产生34.26 mm接近余量，之后反向接近并伸至99.97 mm，余量耗尽触发track_window_end。冻结窗口局部前向净位移-188.38 mm、左向+8.40 mm、X+5.48 mm；这些是编码器观察器结果，不是已测量的真实车体位移。运行记录中left曾超过35 mm参考接近量（末端约40 mm），说明仅按软件300 mm/s²与批次间隔计算的余量限速还不能证明实际停止距离满足接近预算，后续需核对实际速度、驱动制动与观察器误差，不能仅以最终room=0视为边界控制通过。

`window20-reverse-poststop.log`确认四轮RPM0、全部反馈有效、stop_requested=1/stop_confirmed=1、chassis error0/locked0、X99.969 mm及IMU正常。当前没有继续追踪，没有重置剩余预算，也没有烧录或修改香橙派。

当前动态问题仍未解决。源码和设备报文均标记model=initial，J仍为[[2,0,0],[0,2,2]] px/mm，而非当前观察姿态实测模型。自身运动补偿使用该J减去机构运动后拟合目标速度；J尺度或观测时序误差会进入目标速度前馈并反过来驱动机构。现有记录无法将真实物料运动、模型尺度误差与滤波/反馈时序误差独立分离，因此这里只提出待验证假设，不宣称已定位唯一原因，不继续盲目增减速度/延迟参数。下一步应在静止目标下取得小位移响应，先核对局部J及时间响应；当前X接近100 mm、接近预算耗尽，恢复测试姿态需依据实际间隙，不能重新赋予50 mm预算。

随后用户确认本段反向实际也约120°、3～5秒，平均约4～6.7 rpm。因此本段是大角度反向运动，不是20～30°小窗口验收，也不是已测量的匀速6 rpm测试。跨越大角度会改变局部观察条件；但不能仅凭角度较大把X反向过冲及接近预算超出全部归因于操作。仍需在近端静物姿态核对J/时间响应，然后实际完成小窗口测试。

### 21:24～21:42 实际间隙80 mm、局部尺度标定及RAM试验

用户实测当前车体靠料台外缘到料台边缘约80 mm，取代此前仅按局部编码器接近量推算的间隙，不能继续声称实际只剩20 mm。保留20 mm后的理论接近余量60 mm，本轮仍以原计划最大50 mm建立参考。此处并未证明轮编码器尺度、相对料台方向和侧向位移与真实间隙完全一致，该差异仍需后续实际运动测量核对。

COM14先可打开但grab status、track status、info均0字节；`gap80-before-calibration.log`、`gap80-status-retry.json`、`gap80-info-retry.json`保留证据，没有发运动命令。用户随后回复ok，重试通信恢复；`gap80-reconnected-inspect.log`确认PCB实际也重启过，home_complete8004 ms、IMU5秒PASS/51样本/最大间隔100 ms，X回到约0、追踪参考失效。香橙派仍持续发合法B2无目标报文，rx_bytes4032/invalid_reports288，不是Python退出或USB0字节；恢复X至55再95.06 mm后重新看到蓝色314/358，未要求再重开Pi，也未烧录。

临时诊断脚本`probe_local_scale.py`按静止目标执行原计划小位移，仅X、底盘前向和底盘侧向，Z/Base/夹爪不动。每个停止姿态取8个不同序号视觉快照，记录实际编码器位移、往返像素变化和停稳证据；底盘使用4 mm/s/500 ms保持与既有500 ms过渡/减速，实际总位移约4.3 mm，不将请求值冒充反馈位移。这里是局部静态像素尺度测量，尚非拍摄延迟或真实轮径/滑移标定。

| 轴 | 外出实际位移 mm | 返回实际位移 mm | 外出像素尺度 px/mm | 返回像素尺度 px/mm |
|---|---:|---:|---|---|
| X伸缩 | -5.0603 | +5.1003 | u=-0.148、v=1.704 | u=0、v=1.691 |
| 底盘前向 | +4.3354 | -4.2338 | u=1.845、v=0.058 | u=1.890、v=0.059 |
| 底盘侧向 | -4.4159 | +4.2817 | u=0、v=1.812 | u=0、v=1.868 |

原始日志为`gap80-scale-x.log`、`gap80-scale-forward.log`、`gap80-scale-left.log`。各停稳窗口噪声0～1 px，往返同号且尺度接近，支持该姿态J主对角/接近项约1.87、1.84、1.70，而不是全部2；小交叉项仍在量化及极小偏航影响范围内，本轮没有凭这一次测量加入交叉项。它证明原初始尺度存在偏差，**不证明是全部动态过冲的唯一原因**。

通过原`grab set/get`显式临时写入并读回j00=1.87、j11=1.84、j12=1.70，其他J项仍0；这些是RAM试验值，属于GrabTask共享视觉模型，当前静态align也会读到，尚未更改固件默认或声明独立追踪模型已实现。复位会恢复原默认2。本轮先验证该尺度，不把静态取放流程改动混入试验。`gap80-measured-j-reference50.log`以用户实测80 mm间隙恢复50 mm局部预算，并保持仅观察接入start。

`gap80-measured-j-static.log`8秒静物追踪从(-19,-20) px启动，默认160/60 mm/s、延迟50 ms；152个新样本全段每轴RMS5.505/4.982 px，二维约7.425 px，p95为14/14 px，启动仍有来回摆动，不能宣布全段符合5/10 px标准。最后128条完整CRC记录覆盖6350 ms（不含最初约1.3秒）：二维RMS3.853 px、每轴p95为8/4 px、峰值10/4 px；89个稳定标记样本RMS1.646 px只作附加统计。实际四轮批次p95=102 ms、X反馈年龄p95=99 ms。末端目标334/338附近，底盘局部前向9.64 mm/侧向5.09 mm、剩余接近44.91 mm，X约99.15 mm。

`gap80-measured-j-static-poststop.log`确认四轮RPM0、反馈全部有效、stop_requested=1/stop_confirmed=1、chassis error0/locked0、IMU正常。当前已停止、保留参考与44.91 mm预算，无新的烧录或动态追踪验收。后续小窗口提示改为实际物料沿100 mm半径圆周移动约3～4 cm（约20°），避免再次把约120°操作当作小窗口；等用户准备后才启动，物料先保持静止。

试验结束后已显式恢复并读回j00/j11/j12=2，避免临时标定试验值继续影响原静态align/pick。实测J保存在日志，下一段追踪对照再临时应用；没有更改静态功能的固件默认。当前X姿态及剩余预算不因J恢复而清除。

### 21:51 小窗口启动与静物等待记录

用户回复准备好后，COM14预检确认四轮零速、反馈有效、IMU正常、无运动锁定、X99.151 mm；未重启或重建参考。临时重新应用并读回实测J=1.87/1.84/1.70，observe取得334/337～338的新蓝色坐标、ref=1及room44.91 mm，然后启动追踪并提示实际只转20°/圆周3～4 cm。`window20-calibrated-physical.log`记录21:51:28受理，45秒后按采集脚本时限停车；该时段坐标基本不变、底盘未出现明显位移，目前不能当作动态20°验收，需用户核对实际转动时间。

全段893个新样本RMS为0/0.209 px，末端128条冻结记录完整且CRC无错误，仅覆盖静止的最后6.35秒；不能将该零误差静物窗口称为运动追踪通过。X启动微调99.15→98.33 mm，剩余接近预算44.91 mm保留，停车已反馈确认，随后四轮RPM0且反馈有效。试验J再次恢复并读回2，不影响原静态默认；本轮未修改或烧录固件。

### 21:57～22:07 重试运动记录与恢复间隙

用户确认上一段未转动，重新试验仍临时应用实测J，不重建参考；`window20-calibrated-repeat.log`等待阶段静止，随后记录真实目标移动并到达窗口边界停车，X98.33→99.98 mm、局部接近44.81 mm、剩余预算0.10 mm。128条冻结记录完整CRC通过，覆盖最后6.35秒，二维RMS4.784 px、每轴p95为9/10 px、峰值13/11 px，窗口含运动前静止，不能冒充完整动态段验收。四轮实际批次p95为102 ms、X反馈年龄p95为95 ms。全段1754样本含长时间静止，RMS0.847/0.976 px不能代表运动误差。停车后四轮零速、chassis error0/locked0，J恢复并读回2，无固件修改或烧录。用户随后说明操作失误，要求再次重测，实际角度/方向尚未确认。

用户实测当前车体到料台边缘仅约20 mm，已无保留20 mm后的接近余量。按重试准备执行低速远离料台请求55 mm；`retry-gap20-retreat55.log`最终编码器退离59.818 mm、切向-0.107 mm，人工急停路径发送完成且四轮零速已确认。实际间隙仍需物理测量，不能把编码器退离量直接当作实际增加间隙。

随后observe被`bus_unavailable`拒绝，查询确认为四轮`sync_cache_uncertain/error5/locked1`，非COM14断连；串口`bus recover`返回complete、checked=0xFF、chassis_cache=cleared、wheels_stopped=1，任务不自动恢复，无重新上电。重新仅观察蓝色坐标约304/463，对目标334/338偏差约-30/-125 px，X99.98 mm，无伸出余量；停止并确认后等待用户恢复物料近端观察位置，不用大偏差追踪消耗刚恢复的间隙。Z/Base/夹爪未动作，既有固定参考仍保留，room57.00为退离后局部积分结果，未人为重置预算。实际间隙及新近端姿态确认前不启动追踪。

### 22:13～22:18 77 mm实测间隙与近端姿态恢复

用户确认退车后实物间隙约77 mm，且蓝色物料已转到近端。`gap77-near-observe.log`新鲜坐标249/251，对目标334/338误差-85/+87 px；X99.98 mm。没有直接启动大偏差追踪，采用分步底盘切向移动与X回缩准备，方向由已验证J确定，未向料台靠近，Z/Base/夹爪不动。

底盘前向请求20 mm，实际编码器24.151 mm、靠近方向仅0.247 mm；X以手动6 RPM回缩25 mm，实际99.982→74.942 mm，reached=1及重复位置反馈停稳，原手动40 RPM/acc20/limit3200恢复。新坐标295/301，误差-39/+37 px。随后前向请求16 mm，实际20.273 mm、靠近方向-0.194 mm；X再回缩18.5 mm，实际74.963→56.454 mm，重复位置与到位确认。两次手动底盘优先停车后的同步缓存均按既有bus recover处理并确认完成，任务不自动恢复，不要求断电或回零。

`gap77-prepared-pose-observe.log`确认蓝色337/341、每轴误差3 px、X56.47 mm及伸出余量43.53 mm，局部room56.91 mm是保留原料台参考后退离恢复的积分结果，未重建或人为充值预算。仅观察结束后stop_requested=1/stop_confirmed=1。共享J仍为原值2，未应用之前另一姿态的临时标定值；当前不声明J动态标定已完成。未启动动态追踪，等待用户开始信号再做真实小窗口；本轮无固件代码修改、编译或烧录。

### 22:22～22:25 近端手动追踪：过冲与命令/反馈不一致

用户明确开始后，`gap77-near-window20.log`记录启动受理，约2秒进入334/338保持。22:23:05～14发生第一段明显运动，最终恢复334/338；但中途低频状态已记录横向误差-50 px，不能将最后回到目标称为稳定追踪通过。利用同一运行设备累计统计在samples849与990的平方和差分，可估计这141个新视觉样本的每轴RMS约14.41/5.62 px（原始累计RMS仅保留三位小数，结果为近似值）。这比含长时间静物等待的全段统计更能反映这一局部动态过程，仍不是已确认20°或匀速6 rpm验收。

从运动前22:23:05状态到22:23:16稳定状态，X约57.42→81.77 mm，局部前向43.29→12.82 mm、左向-5.56→14.85 mm，均为反馈观察器坐标。没有独立实物位移测量，不将这些数值冒充真实位移或用其反推已执行转角。实际操作角度、方向、用时及是否有第二次操作待用户核对。

22:23:44后又出现目标变化，随后cx/cy约361/332、dx/dy约27/6持续不消失；X反馈一直约81.78 mm。最后冻结记录`gap77-near-window20-frozen.log`128/128完整CRC通过，覆盖6350 ms、128个新有效样本，每轴RMS与p95都是27/6 px，二维RMS27.66 px，无稳定标记。该窗口实际速度字段（编码器位置变化推导）三轴均为0，而请求速度峰值为38.31/5.78/13.49 mm/s；X净位移0，前向/左向仅-0.11/-0.07 mm。四轮完成批次p95=102 ms、X反馈年龄p95=98 ms，说明控制计算和报告的发送节奏正常不能独立证明机构执行了请求。需核对实际发送的四轮RPM、X目标及驱动执行，不能先归因于视觉算法、COM14断连或硬件供电。源码确认Mecanum_Velocity_Request仅替换待发批次，实际sent_rpm在同步批次结束后更新；当前trace只有计算命令和发送年龄，没有逐批次sent_rpm，不能据此宣布已定位唯一原因。

采集主进程被主机中断后没有执行脚本finally停车；随后立即独立发送grab track stop，取得stop_requested=1/stop_confirmed=1、四轮RPM0/有效反馈、chassis error0/locked0。不能把这次结束描述为120秒自动停车已验证。设备全段2766个新样本每轴RMS17.572/4.070、p95=27/6 px，包含静物等待和异常保持；128条环形记录只保留末尾，第一段动态详细记录已覆盖，未用末尾冻结窗冒充完整动态过程。停车末端X81.775 mm、room33.79 mm、IMU yaw约-5.16°，未重建参考或恢复接近预算。未改固件、烧录或修改香橙派。

用户随后重新上电，并说明本轮主动规避回零。只读`gap77-user-repower-inspect.log`收到home_stop_unconfirmed/home_pending、底盘stage5/error2/locked1、x_ppm=unset，position x被bus_locked拒绝。当前状态属于新上电且未完成原点验证的现场状态，不直接作为新回零算法故障；只读检查后没有补回零、解锁、恢复X或重新启动追踪。上一段日志保留，不能把重启后状态或姿态套回上一段，也不能因串口仍可收发而宣称电机链路已恢复。
