doinbest/Yachiyo/xjx/模版搭建/docs/开发记录/2026-10-07-UART5应答交接间隔与入仓连续循环实测修复.md

# UART5应答交接间隔与入仓连续循环实测修复

日期：2026-10-07。硬件：主车STM32F407、DAPLink CMSIS-DAP、共享控制台COM14/115200。用户授权串口复位、运动验证及烧录。实际使用控制台共享串口API，没有另开COM14争抢连接；DAPLink运行中读取状态，并用于构建产物烧录校验。

## 故障与对照证据

原始报错不是X行程超时：UART5出现FE/NE后总线锁定，机构缓存停止更新，继而feedback_stale及stop_unconfirmed。静止四轮反馈查询约20秒正常；关闭底盘反馈后的单独X动作约30.24 mm也完成。组合入仓则在不同轮电机查询阶段复现。

保留Receive完整应答控制，增加普通应答收齐后2 ms交接，首次完整入仓通过。随后在同一份已烧录固件上仅用DAPLink把RAM中的reply_settle_ms从2改为0；确认回零完成后启动入仓，X约11.768 mm再次出现UART5 FE（0x04），首故障为四轮反馈owner、ID1、功能0x35。恢复为2。该对照支持零间隔应答交接是本车通信故障的触发条件，不证明Receive应答机制本身错误，也不能仅据此确定具体电气根因。

本地X42S手册提示命令之间需要几毫秒延时。采用实测有效的2 ms，不恢复旧10 ms发送门槛或80/100 ms批次限频。完整匹配应答仍是事务推进依据；部分应答不放行。紧急FE/9C绕过新增普通交接，保留原有TX完成后2 ms停车链及迟到应答排空。

## 连续回收时发现的两处问题

1. Z上限收回目标0，实际−0.062～−0.065 mm、速度0、使能无故障且反馈新鲜，驱动到位位仍未置位，任务卡住。仅对Z上限收回允许用命令后持续静止及原有位置容差确认；下降放料和全部X目标仍要求驱动到位位，不放宽X判定。
2. Base从−90°回0°使用FD模式2相对当前位置，实测却到约+89.681°。现代手册将模式2定义为相对实际位置，但本车行为不符合这次命令预期，不能据此断言驱动版本不支持。自动动作改用FD模式1绝对目标，目标来自保存的实际多圈朝后锚点，不重复HOME/ZERO，也不清视觉模型。主机测试覆盖RearBase=397°时车载307°、作业487°、返回397°。

固定取放X速度仍为共用x_transfer_speed默认60 mm/s，独立grab place car与正式任务使用同一axis_move和Base动作；静态视觉x_speed=10、动态追踪独立默认60不混用。本次没有修改驱动器配置、官方Emm_V5、IOC或EIDE。

## 最终烧录与实车结果

Keil Target template：06:26:16构建，0错误、0警告。06:26:53 DAPLink烧录并校验成功。之后无复位、无重新回零，连续执行：

| 动作 | 结果 | X / mm | Z / mm |
| --- | --- | ---: | ---: |
| 第一轮grab place car | released，执行开爪 | 99.997 | −60.009 |
| 第一轮grab pose rear | travel_ready | −0.018 | −0.065 |
| 第二轮grab place car | released，执行开爪 | 99.997 | −60.011 |
| 第二轮grab pose rear | travel_ready | −0.012 | −0.065 |

每次完成stop_confirmed=1，首故障有效字段均为空。结束后DAPLink读取三轴速度均0，Base约−0.012°、Z约−0.065 mm、X约0.011 mm；应答交接RAM值2。现场保持后向收回姿态，关闭调试服务器时没有复位或暂停CPU。released表示控制流程执行开爪完成，不等于带料实际脱落或全赛事搬运验收。

## 软件验证与证据

固件主机回归PASS，包含新增motor_bus_reply_settle_test：部分应答不放行、完整应答后+1 ms不发/+2 ms发送、紧急停车绕过普通交接。既有冻结时钟UART模拟用宏0保持原协议测试节拍，专门测试用2覆盖生产交接行为。Z测试覆盖上限静止确认、下降未到位拒绝、越容差与故障拒绝；Base测试覆盖绝对模式及多圈锚点。

证据保存于.embeddedskills/analysis：

- ack-absolute-final-firmware.log：最终固件主机回归。
- ack-absolute-car-rear-cycles.json：四次实际动作及运行中DAPLink样本。
- ack-absolute-car-rear-serial.json：同轮串口事件。
- ack-absolute-final-state.json：结束后三轴与总线记录。first_fault前16字节为有效故障字段；其后残留报文字节不表示故障。
- driver-fd-mode.png：本地手册FD位置模式章节渲染。

现行协议以docs/上位机协议.md的06:26最终实测更新为准；此前零间隔和05:58失败记录保留为历史事实。
