doinbest/Yachiyo/xjx/模版搭建/docs/开发记录/2026-10-07-粗加工单件放置标定.md

# 粗加工单件放置标定

用户准备单独验证蓝色物料从第一仓释放到粗加工对应色环。现有grab take 1 rough复用正式取放状态机，按已对准位置释放，不识别色环；z_proc_place原为unset。用户摆好小车并将蓝色物料临时放到蓝环作为夹持高度参照。request427 grab pose work完成，Base=89.60°、X=0、Z约0；用户确认夹爪在物料正上方。

空夹爪手动Z点动：request428下降5mm；用户确认其目标为-70mm而非-70cm后，request432到-69.99mm、state=0x03。用户要求继续到-80mm，request438到-80.00mm、state=0x03。用户确认实际还有至少10mm行程且未顶住工位，request441/444分两步到约-85/-90mm。request445/448实际raw=-884555/-884559，对应约-89.98mm，state=0x01（使能、未到位、无堵转/保护标志）；保持等待用户确认高度。

此轮仅手动高度标定，尚未设置z_proc_place或扩大自动任务z_min，尚未取仓/松爪放置。若高度确认-90mm，需将自动任务有效Z范围包含实际放置高度，并验证下降释放所需到位反馈；不将原-80mm软件下限描述为物理极限。

## 下行实际堵转

用户继续指定-100mm，request449/452分两步到-95/-100mm，request453实际raw=-983032，state=0x03，到位。用户随后要求直接到-120mm，先按分步计划向-110mm移动（request455，pos z -540.0439453125，实际4800脉冲）。request456实际raw=-1018259，对应约-103.583mm；request457 state=0x0D（使能，堵转检测及堵转保护标志，未到位）。立即request458 stop z，回复OK stop z sent；request459位置仍-1018259。未发送后续-120mm命令，未改自动Z行程范围或释放参数。询问用户是滑块下端还是夹爪/工位接触，等待具体接触原因后安排退回；不将软件下限与本次碰撞点自动等同，不反复冲撞。

## 重上电后作业姿态-150mm试位

用户确认此前夹爪碰到物料或工位，随后重新上电并要求X先外伸10mm。request461/477回零报告home_axis_fault/home_driver_fault，自动参考参数仍未恢复；当前单轴驱动state正常。request469执行X外伸10mm，用户确认已避开此前接触位置后request474一次向-120mm请求；用户中断该轮并重上电（后续Z/X位置回到约0），因此未确认-120mm结果。

用户要求重新执行先转机械臂/外伸，再一次下降-150mm。request483手动Base相对90°，实际约89.6°，state=0x81；request486 X外伸10mm，state=0x03。用户确认此作业方向路径无遮挡且有足够Z行程，request490读Z=-20raw，request492发一次pos z -8099.89013671875（71999脉冲）向绝对-150mm。request493/495实际raw=-1474239，对应约-149.967mm，两次位置一致；request494/496 state=0x01，使能、无堵转、未置到位位。此轮没有中间停点，未松爪、未变更Z软件下限或放置参数，等待用户确认夹持放置高度；驱动到位位尚未满足，不能称自动释放验收通过。

用户确认约-150mm高度适合且授权夹取。request497/498位置稳定raw=-1474243、state=0x01，无堵转；request499 grip catch已执行。request500按实际位置向-140mm抬升，request501位置raw=-1376438，约-140.019mm，request502 state=0x03到位。等待现场确认蓝色物料是否真正夹起；未自动松爪、未回仓、未将未恢复的自动参考冒充有效。-150mm作为用户确认的本次粗加工试位高度记入记录，RAM参数及固件默认尚未更新。

用户确认蓝色物料已夹起并离开工位。继续原位手动放置验证，request505下降回-150mm，request506/508两次位置raw=-1474307一致（约-149.974mm），request507 state=0x01，无堵转但未置驱动到位位；request509与位置读取交错返回ERR busy，仅诊断查询未执行。依据用户现场已确认高度，以手动步骤request510 grip open释放，request511提起至-140mm，request512位置raw=-1376286（约-140.003mm）、request513 state=0x03到位。等待用户确认物料在蓝色环内稳定落下且夹爪脱离。该结果只覆盖人工对准/取放，不作为grab take 1 rough自动完成证据；后续自动下降释放的驱动到位位问题须核查，未修改其判定。

## 第二轮原位夹取/放置

用户授权重复夹取、提起、下降、放置。request516下降至约-149.986mm，request517/519位置raw=-1474421一致，request518 state=0x01无堵转；按既有现场高度手动request520 grip catch，request521提起至-140mm，request522 raw=-1376298、request524 state=0x03。request523诊断与位置读取交错返回ERR busy，随后单独重读成功。request525回到-150mm，request526 raw=-1474417（约-149.985mm），request527 state=0x03到位；request528 grip open、request529提起，request530 raw=-1376294（约-140.004mm）、request531 state=0x03。本轮释放前驱动到位位已满足，动作链完整执行，无堵转；物料是否稳定落环仍待现场观察确认。自动取仓/路线/固件参数没有修改。

## 2026-10-07 粗加工1号黑白环手动装料测试

入口：视觉任务 →「粗加工1号黑白环 · 手动装料放置测试」。小车人工摆在1号环前，先空爪对准，再人工装入蓝色物料并点击闭合夹爪，最后执行下降放置。官方地图粗加工环从左到右为3、2、1，圆心间距150 mm；环是黑白印刷标记。

- `grab ring align`：使用现有B2黑色（5）通道，复用协同对准、停稳与反馈流程，观察X起始10 mm；完成后停止视觉请求，保持底盘/X，进入等待装料状态。
- `grip open` / `grip catch`：色环对准完成的保持阶段允许人工夹爪操作；下降期间仍由任务控制夹爪。
- `grab ring place -150`：Z绝对位置下降至−150 mm，到位后松爪，再提起到本次对准的观察高度；保持Base/X，不从车载仓取料、不改变库存。完成后可再次人工装料并放置。
- `grab status`：读取ring_align/aligned、ring_place/pending或ring_place/released；`grab stop`结束测试。

B2仅返回目标颜色圆心，不识别数字1。此入口依赖人工摆位，让1号环成为相机主要目标，不能保证画面中多个环时自动选择编号1。沿用香橙派现有程序，未修改或部署视觉脚本。黑色环实际识别与放置精度需实测。

Z回零验证后软件下限由−80改为−150 mm，依据本轮用户确认的实际可夹取高度；原料夹取、车载放置和正式粗加工参数各自保留，未以此次测试覆盖正式任务高度。

软件验证：新增黑环对准/手动装料放置回归，覆盖未对准拒绝、应答未到位不松爪、反馈到位释放并提起、无转盘分度/库存改写。Keil编译0错误0警告；当前实车尚未执行黑环视觉放置。

本次交付验证：固件主机全套PASS；网页439项PASS；Python串口桥接33项PASS；最终Keil 0错误0警告，OpenOCD programmed/verified=true。串口请求533确认z_min=-150；534返回home_driver_fault、ref_cause=home_verifying；535/536分别Z/X raw=0x03，537 Base raw=0x81。与此前手动标定上电回零故障同类，当前未完成机构参考验证，未执行黑环视觉运动。已提醒烧录后重新打开香橙派程序。

### 09:04 黑环对准缺视觉参数的根因与恢复修复

串口545/546确认ref_cause=home_verifying、ref_u=unset，原因是上电Base回零未通过，原视觉默认矩阵未恢复，并非黑色B2请求失败。DAPLink直接读取当前AXF符号对应RAM：BootHomeFlags=0x0B、valid=1、BootAxisIndex=2（Base），普通state base=0x83不能替代回零完成证明。

发现恢复入口两个缺陷：grab rehome只允许idle/complete，拒绝error；控制台grab stop只调用GrabRoute_Stop，后者只取消busy任务，导致inactive error不退出。修复为允许无竞争任务的error启动原验证回零，并让显式stop对inactive抓取状态也请求取消。完整保留总线和竞争任务检查、0x3B故障判据；不直接填写矩阵或绕过Base验证。boot_stop新增失败轴、回零/电机原始状态及有效标记诊断。回归覆盖真实回零失败→重试成功恢复参数，以及控制台停止inactive状态；抓取、控制台、姿态和命令结构测试PASS，Keil0错误0警告。

修正版OpenOCD烧录及校验通过；串口559实测idle/home_complete/missing=none/ref_cause=home_verified，560读回ref_u=334，561读回j00=2，IMU本轮PASS/control_ready=1。此次启动已恢复有效参考，未启动视觉运动；已提醒重新打开香橙派。此前Base 0x0B是实际驱动回零失败，本次回零通过不能证明其间歇原因已消除。

2026-10-07色环准备时序更新：`grab ring align`从已验证后向姿态启动时，先抬Z、收X；随后Base顺时针90°与X伸到绝对10mm并行进行。UART5按匹配应答依次发出两条指令，不等待Base到位才发X；两轴均到位、观察Z到位后才请求B2识别。不重复发送已完成的10mm伸出指令。已在外侧姿态时只准备观察Z/X，不再重复转90°。控制台黑白环测试移除单独“切到外侧作业姿态”前置按钮，直接对准可完成整个准备流程。

方向排查本轮记录：用户确认可做短距离试动，579前向10mm/s·500ms、584左向10mm/s·500ms、590左向20mm/s·1000ms均限时结束。黑色坐标约(378,134)→(375,134)，未获得足够可靠的像素响应符号，未翻转矩阵。用户随后要求停止并改成Base/X同步准备；594停止视觉，598轮反馈零速。本轮新回归覆盖Base尚未到位时X已经受理、X未到位不请求视觉、两轴到位后可完成对准；抓取/姿态/取放回归PASS，网页439项PASS，Keil0错误0警告。方向是否收敛仍待正确观察姿态下复测，不能把准备时序修正称为方向问题已解决。

### 09:27 上电UART5故障与串口恢复

用户报告ring_align缺x_ppm/z_ppm及全部尺度/视觉参数。606状态ref_cause=home_verifying；本次启动日志明确UART5 uart_error=0x00000002、fault_ms=27，Z回零请求tx_error/home_bus_fault，故三轴参考未恢复。607显示此前bus recover已complete/unlocked，608～610普通电机状态Z/X=0x03、Base=0x83；这不等于回零参考有效。

用户授权串口修复后直接对准。611完整rehome中Z/X验证成功，Base 0x3B再次0x0B失败；612位置raw=-406（约+2.23°），613普通状态0x81。615取消并确认idle/stop_confirmed=1；616按上一已验证后向锚点附近作−2.12°小幅位置调整，617读回raw=-56；618重新验证仍在Base home_driver_fault，619错误。未直接补矩阵掩盖失败，也未启动ring_align。已请求用户确认当前实物是否朝后，供后向机械零点恢复判断；现有参考缺项的直接原因和Base重复驱动失败分别记录。

2026-10-07后续调整：用户将黑白环识别前的伸出位置改为X绝对20mm（原10mm时序记录为历史）。`grab ring align`仍在Base转90°时并行伸出，两轴均到位才识别；再次执行不会累计多伸20mm。抓取、姿态、取放回归PASS，网页抓取20项PASS，Keil0错误0警告。本次DAPLink烧录尝试失败：CMSIS-DAP command CMD_INFO failed；串口621/622无回复，故20mm源码/HEX尚未确认写入设备，等待重新接线/上电后重试。

2026-10-07最新调整：黑白环按钮识别前X绝对位置改为50mm，Base转90°与X伸出仍并行，两轴到位后识别；覆盖此前20mm设置。相关抓取回归PASS。新固件须成功烧录后才生效。

09:46 imu_invalid串口恢复：630读回ready/valid/fresh均1、i2c_errors=0，但上电run_id=1静止验证FAILED/drift_or_noise，drift=-0.02092deg/s、rms=0.0235deg、control_ready=0；631抓取idle/missing=none/home_verified。633执行imu verify，run_id=2实际PASS/verified=1/control_ready=1，51样本/5205ms、drift=0、rms=0、i2c_errors=0。只重新静止验证，未修改阈值、重写机构参考或烧录；未自动执行黑环运动。
