doinbest/Yachiyo/xjx/模版搭建/docs/开发记录/2026-10-08-实时追踪过调与响应滞后分析.md

# 实时追踪过调与响应滞后分析

本轮只分析，不修改控制代码、不烧录、不启动新运动。通过现有 COM38 共享串口只读查询 `grab track status`、`grab track log status`；查询时任务已取消且停车确认。

## 证据范围

- 2026-10-08 05:07:56 启动蓝色动态追踪；05:10:29 开启实时记录；05:14:16 人工停止任务。
- 实时记录候选总数 3259；在完整连接日志中找到 192 条 CRC32 校验通过的记录，其中 79 条带运动标志、75 条为不同的新鲜运动观测。实时行缺字、缺行严重，主动跳过诊断和无线传输缺字均可能造成缺失。不能把缺失比例当视觉丢包率，也不能把稀疏记录间隔当控制周期。
- 已保存原始连接快照、提取文本、校验通过的行和解析数据到 `.embeddedskills/analysis/20261008-tracking/`。`session.jsonl` 保留原始事件；`latest.log` 为本轮及准备期间 RX 文本；`validated.log`、`rows.json` 仅含本轮校验通过记录。
- 05:11:57 有发送 `grab track log stop`，未找到对应 `log_end`；本次查询仍返回 `enabled=1`。这次记录订阅停止没有得到设备确认，不能把按键发送当成已停止。当前任务空闲，不因此自动启动或继续运动。

## 正常控制节奏与局部滞后分别评价

人工停止后读取的固件全段统计：

| 指标 | 数值 | 含义 |
|---|---:|---|
| 控制更新间隔 P50 / P95 | 20 / 20 ms | 正常控制节奏 |
| 预测更新间隔 P95 | 20 ms | 定时预测节奏 |
| MCU 收到视觉至计算 P95 / 最大 | 1 / 33 ms | 不包含曝光、相机驱动缓冲和 Pi 处理/滤波 |
| 单次计算 P95 / 最大 | 2 / 2 ms | 没有计算耗时过大的证据 |
| 四轮批次间隔 P50 / P95 | 22 / 49 ms | 应答推进的实际发送节奏 |
| 单个四轮批次最大耗时 | 20 ms | 批次自身传输/应答耗时 |

控制间隔最大 20770 ms、批次间隔最大 21116 ms 包括未更新/未发送的等待区间。源码在视觉暂停、停车确认阶段会暂不调用追踪计算或不提交运动；这两个最大值不能独立证明运行中卡住 20 秒。应与状态和连续运动记录一起判断。

79 条带运动标志的有效记录中，X 位置反馈年龄 P95=97 ms，四轮位置反馈年龄各轮 P95=116～126 ms。速度反馈是轮流读取，个别轮速度年龄可达数百毫秒；`actual` 为位置/观察器估计，不能据此宣称测出了纯电机响应时间。

## 明确的穿越参考点片段

以下时间为 MCU 上电毫秒数，均通过整行 CRC。水平误差为 `CX-ref_u`，速度为底盘前后方向：

| t / ms | dx / px | 指令 / mm/s | 反馈估计 / mm/s | 累计前后位移 / mm |
|---:|---:|---:|---:|---:|
| 274170 | +14 | −33.63 | −28.41 | −47.54 |
| 274235 | +6 | −14.16 | −33.76 | −49.59 |
| 274417 | −6 | +11.34 | −17.90 | −51.25 |

误差接近零时指令已经减速；182 ms 后误差从 +6 变成 −6，指令已反向，反馈仍沿原方向运动。最后一行四轮已发送逻辑 RPM 为 `[1,1,1,1]`，支持“新方向已发出，而运动反馈尚未跟上”的判断。目标本身可能仍在运动，不能把这 182 ms 全部当电机延迟；可以确认的是闭环跨过参考点后仍有反向响应滞后。

另一个连续片段：t=289587/289641/289704 ms，dx=−6/−9/−14 px，前后指令=−6.96/+0.88/+10.90 mm/s，反馈=−27.38/−27.54/−23.11 mm/s。减速、反向后反馈仍保持原方向，误差继续增大。

X 同样存在期望与反馈不一致：t=282232～282407 ms，期望约 −50～−60 mm/s，X 反馈估计约 −19～−27 mm/s；X 新目标发送年龄 13～23 ms。不是单纯一直排队没发出，但 X 位置运动、驱动加减速与反馈求速共同影响响应。

## 源码中会放大局部过调的因素

1. **速度指令与机构响应不完全匹配。** 软件默认加速度 300 mm/s²；底盘驱动使用其独立加速度等级，X 绝对位置指令使用等级 8，并将速度转换为未来 120 ms 的位置目标。驱动等级不能直接当作 mm/s²。前后、左右、X 不是同一种实际响应，当前分配仍依赖统一的运动模型。
2. **视觉滤波延迟随运动变化。** 当前项目 `vision.py` 的 `AdaptiveCenterFilter` 在变化较小时使用最近三帧中值和 alpha=0.35，变化大时改用原始坐标及 alpha=0.85。有效连续片段按 MCU 包序号估算每帧间隔中位 28 ms（34 对局部样本），低变化分支的滤波滞后可粗估到约 80 ms，尚未计入曝光和处理。该估算不是实测整链路延迟，也未读取 Pi 正在运行文件验证版本。固定 50 ms 自运动补偿可能在接近目标、减速反向时失配。
3. **矩阵仍是初始模型。** 本轮状态为 `model=initial`；材料追踪使用 `ref=(334,338)`、`J=[[2,0,0],[0,2,2]]`，即约 2 px/mm，源码明确不是实测标定。比例或耦合误差会使相机自身移动残差进入目标速度估计。240 ms 拟合窗和速度/加速度先验又会保留之前趋势；不能简单把这些窗口相加成固定延迟。色环独立参考 `(378,333)` 没有混入本轮材料追踪。

这些因素能解释为什么接近零误差或目标变化方向时容易多走一段，但本轮稀疏日志不足以单独判定每项占比。

## 行程暂停不是过调

192 条有效实时记录中 152 条底盘接近余量小于 0.5 mm，79 条运动标志记录中 26 条 X≥95 mm。这是日志样本分布，不是全时段比例。状态多次明确报告 `track_window_end`，并找到 13 条完整 `track_window_recovered` 状态行，说明目标回到可达范围后有自动续追。

底盘向料台接近预算固定 50 mm，X 范围 0～100 mm。在当前姿态和物料转动轨迹下，部分目标暂不可达；此时停车等待表现为“响应慢/停顿”，但需要与参考点附近的反向滞后分开。普通等待没有重置预算，也不是又发生反馈饥饿故障。

固件整段 RMS_u=114.413、RMS_v=72.686 px 包含初始大偏差和边界附近目标，不适合拿来作为近目标稳定追踪精度。固件 P95 错误直方图上限为 100 px，打印 `p95=100` 是饱和桶，不表示实际 P95 恰好 100 px。`residual_0/50/100` 为不同预测跨度的残差，不能直接把最小项当最佳曝光补偿延迟。

## 后续改进顺序

先核对/测量材料追踪姿态下的像素—毫米矩阵和时序，并让接近参考点的减速参考真实反馈速度，降低反向时继续沿旧方向走的距离。针对 X 的位置目标前瞻和驱动响应单独调节，不仅提高发送频率或统一加大速度。

视觉侧应核实运行版本和近目标滤波行为，结合上述实测调整补偿；不直接把 `latency_ms` 改为估算值。保留现有应答推进、正常跟随和行程返回后续追。实时记录应减少传输负担并确认启停 ACK；下一轮可低频长日志配合停车后导出 128 条高频冻结记录，覆盖一次反向过程，再评估修改收益。

本轮分析没有新增门槛、放宽反馈超时、改参考预算、改材料/色环参数或烧录。
