doinbest/Yachiyo/xjx/模版搭建/docs/开发记录/2026-10-08-编号环横向接近与渐进下降.md

# 编号环横向接近与渐进下降

## 问题与结果

用户要求先横向接近，再随目标接近进度下降；目标仍靠近画面边缘时暂缓下降。旧 `grab ring align` 一取得编号环坐标就提交完整的 Z 对准高度，可能在 1/3 号环尚未进入中央视野前先降到底。

本轮只调整编号环对准阶段。首次有效坐标先提交底盘/X横向对准，至少下一条新坐标才允许更新Z目标；不等待每段Z到位才继续横向运动。对准高度默认−100mm，独立放置高度默认−150mm，命令和控制台按钮不变。

## 下降规则

- 当前视觉图像640×480。环心处于左右64像素、上下48像素的边缘区域时，Z目标保持在最近测得的高度，不继续追加下降；进入中央区域后继续。
- 用环心相对 `ref_u/ref_v` 的横纵误差，分别除以该方向准心到中央区域边缘的距离。两者较大值决定剩余接近比例，允许高度由Z最高点逐步趋近用户设置的对准高度。已进入±1像素窗口的误差按0计算，以便准确到达最终高度。
- Z目标每次最多领先实际位置反馈5mm，最短更新间隔100ms；需要新坐标及有效机构反馈。短暂漏检时最多执行已提交的小段，不使用重复坐标继续追加下降。边缘暂停不取消任务、不重新回零、不清模型。
- 最终完成仍需要对准Z高度反馈到位、DX/DY各≤1像素和停稳确认。随后停止视觉请求，保持底盘/X，仅抬Z到最高等待人工装料；抬高时不重新追踪。

这些边缘和分段数值为本轮初始调试值，未经本轮实车视觉验收。原料追踪、入仓、放置松爪流程不改。控制台说明及缓存版本同步更新。

## 验证与烧录

新回归先在旧逻辑下因边缘目标仍下降而失败；实现后通过。覆盖首次横向指令先于下降、左右/上下边缘暂停、中央区域部分下降、重复帧不推进、Z只有应答但未移动时不继续累计目标或完成、重新居中后到达目标并停止视觉抬高。

- 固件主机回归：`grab_task_test`、`grab_transfer_test`、`grab_grace_test`、`grab_pose_test`、`grab_command_sim_test`（链接console_tx.c）、`grab_tuning_sim_test`，全部PASS；日志 `.embeddedskills/tests/host-tests.log`。
- 控制台抓取及导航测试23项PASS。
- Keil工程 `Code/template/MDK-ARM/template.uvprojx`，Target `template`：0错误、0警告，Flash234020字节。构建记录 `.embeddedskills/build/ring-progress-build-20261008.json`，HEX `Code/template/MDK-ARM/template/template.hex`。
- 2026-10-08 01:18:12，OpenOCD经CMSIS-DAP/SWD烧录STM32F4成功，`programmed=true`、`verified=true`；记录 `.embeddedskills/build/ring-progress-flash-20261008.json`。

已提醒用户重新打开香橙派程序。本轮未启动视觉实车运动，待程序重开后观察1/3号环接近与渐进下降效果。
