doinbest/Yachiyo/xjx/模版搭建/docs/开发记录/2026-10-09-X42瞬时堵转误判与追踪停车修复.md

# X42瞬时堵转误判与追踪停车修复

## 证据与原因

用户在关闭实时记录、使用上一版启动加速度修正后仍出现故障。20:58的两轮截图均为 ID7（X轴）`flags=0x05`，记录的接收与检测时间相同。该值使能位为1、瞬时堵转位为1、堵转保护位为0。源码此前在轴状态回调、轮停稳检查、追踪轮反馈检查和回零后的普通轴状态检查中以 `0x0C` 任一位判断致命故障，误把瞬时检测等同驱动保护。未证实此前没有原始状态快照的每次轮故障都属于同一原因。

依据：[X42第二代用户手册V1.0.5](../硬件资料/执行机构/闭环步进电机/ZDT_X42S第二代闭环步进电机用户手册V1.0.5_260527.pdf) PDF第73–74页。瞬时堵转要求速度、电流两条件；驱动保护另要求持续时间。不是以加速度推测根因，也不据此认定不存在机械阻力。

## 本轮串口验证

通过用户网页已连接的 COM38、115200/8N1 共享服务发送 `grab track begin 3 50`，实时像素和速度记录保持关闭，不刷屏读取。21:01:41启动、21:05:47发送 `grab stop`，21:05:48收到 `state=idle reason=cancelled stop_confirmed=1`。本轮约4分06秒未见电机故障，未声称已完成手动旋转条件下的故障复现。该运行使用修改前设备固件，只能说明故障不是每次必现，不能验证待烧录修复。

串口原始日志保留于 `.embeddedskills/logs/serial/20261009-190539-ffa902.jsonl`；本轮摘录、手册原文和页面图存于 `.embeddedskills/analysis/20261009-2058-x-stall/`。

## 修改与保留判断

- 普通 `0x3A` 状态检查改为失能或 `0x08` 堵转保护才故障停车；`0x04`保留为原始诊断位，不新增累计次数或超时。
- 回零 `0x3B`专用状态语义保持独立；停车与动作完成仍校验新鲜位置、速度等反馈。
- 保留首次故障原始状态快照，正是此快照将本次原因定位到ID7与0x05。
- 保留上一轮首帧速度修正：原先 `dt=0` 跳过限加速度，可直接输出最大速度；修正后首帧为零、后续按原加速度增长。回归测试证明该独立缺陷存在，但它没有解决0x05误判，不能称为本次根因。没有调低原有参数或驱动配置。

## 验证与上板

状态位回归覆盖轴回调、追踪轮反馈、轮停稳检查：0x03/05/07/83/85/87不中止；失能0x00/02/04与保护0x08/09/0D中止；首次轴/轮故障快照保持不被恢复状态覆盖。先在旧逻辑观察到断言失败，再修改验证通过。

完整固件主机回归通过（`.embeddedskills/tests/tracking-stall-bit-fix-20261009.log`）；Keil Target `template` 构建通过，0错误、0警告，产物 `Code/template/MDK-ARM/template/template.hex`。`git diff --check`通过。此次未烧录、复位或修改驱动参数。新固件烧录后须重开香橙派程序，再复测地面接触下的手动转盘追踪；如果仍停机，使用新快照判断真正保护、失能或其他原因。
