doinbest/Yachiyo/xjx/模版搭建/docs/开发记录/2026-10-09-反装夹爪舵机2500与1920脉宽同步.md

# 反装夹爪舵机2500与1920脉宽同步

用户实测确认反装后的打开位置为2500 µs，夹取位置使用`grip duty 9.6`。TIM1为50 Hz，20 ms周期，因此9.6%对应1920 µs；不采用此前按对称反向推算的2300 µs。修改前工作区干净，基线提交为`f751afa`。

| 操作 | 脉宽 | 占空比 | 指令 |
|---|---:|---:|---|
| 打开 | 2500 µs | 12.5% | `grip open` / `grip duty 12.5` |
| 夹取 | 1920 µs | 9.6% | `grip catch` / `grip duty 9.6` |
| 待机松开 | 2500 µs | 12.5% | `grip idle` |

固件Arm预设和OLED测试共用Arm.h中的两个实测脉宽常量；自动取放继续调用Arm_GripperSet，不逐处更改动作状态机。上位机机械臂与编号环按钮显示对应µs，手动占空比预填9.6%，说明列出两个实测位置；更新浏览器入口及协议资源版本以加载新显示。

软件验证：实际Steer定时器比较值验证打开/待机2500、夹取及直接9.6%均为1920；OLED预选不运动、开关/退出停止PWM及路线期间原有行为通过。固件主机回归通过，网页490项通过，主车Keil template构建0错误/0警告。日志在`.embeddedskills/gripper-reverse-firmware.log`、`gripper-reverse-web.log`和`gripper-reverse-keil.json`。

50 Hz、手动2.5～12.5%范围、任务等待时间和停车保持夹爪策略不变。没有修改HMI编辑工程、引脚/时钟、EIDE或独立转盘；未连接实车或烧录。新版固件烧录后快捷指令才使用新预设；当前设备仍可直接使用两条grip duty指令。
