doinbest/Yachiyo/xjx/模版搭建/docs/开发记录/2026-10-11-UART5应答期限按接收时间判定.md

# UART5应答期限按接收时间判定

用户授权修改代码并烧录验证。此前静止轮询首故障是ID1/0x36应答超时，660次单ID请求及恢复后连续轮询正常；现有日志未保留故障瞬间字节，现场根因仍未证明。源码存在先过期后解析的问题，测试复现：TX在1000ms完成，回复1001ms入队，前台1150ms处理，旧代码将及时回复判为超时。

## 修改

MotorBus_Process先消费RX缓存，ParseByte仅接受完整帧末字节早于TX完成后100ms截止时刻的匹配应答，再对未完成请求判超时；取消请求排空沿用同一规则。100ms期限、FE/驱动故障锁定、停车优先和2ms交接均保留，不自动重放运动。有效应答事件仍保留真实接收时间，因此动作完成检查不会把晚处理时刻冒充新鲜反馈。

首故障保存请求发起后的RX字节计数、最近16字节、最近RX时间、处理入口积压、解析残片和当次MotorBus_Process间隔；bus status仅在有首故障时输出一条fault证据。恢复后historical=1，旧证据不代表当前锁定。IRQ仅更新固定长度环形记录，无格式化或UART发送。

## 验证

新增主机回归先在旧代码的及时应答断言失败；修复后通过。覆盖及时完整帧延迟处理、末字节恰好100ms拒绝、分片末字节99ms通过、完整帧101ms拒绝、TX回调延迟消费、毫秒回绕、取消请求及时排空及故障RX证据。

完整固件主机回归通过；Keil Target template构建0错误0警告。输出见[host-regression.txt](../../.embeddedskills/uart5-deadline-20261011/host-regression.txt)和[构建日志](../../.embeddedskills/uart5-deadline-20261011/build/template-template-build.log)。

使用已确认CMSIS-DAP序列号7b168f48、SWD 1000kHz烧录，OpenOCD确认Programming Finished、Verified OK及Resetting Target。固件SHA256 `6278f3fe31f3822ffc6f93069326d39115a2953c8db3a4de096ea6c44393be6a`，info构建时间22:20:37。日志见[flash.log](../../.embeddedskills/uart5-deadline-20261011/flash.log)。

启动后Z/X/Base确认home_verified=7，ID8回零完成，IMU验证51样本、control_ready=1。通过网页现有COM14/115200连接启用四轮反馈，设置(2250,150,90°)原点并开启遥测，连续观察60秒以上；最新原点有效、反馈位姿有效，locked=0、reason=none、fault_ms=0、error=0。最后累计26352次事务，四轮各6573次请求、timeouts/rejected均0；ID4成功数6572反映快照时仍有一次在途请求，不能把它计为失败或宣称所有请求已完成。四轮最终RPM均0，valid=1,1,1，控制台溢出、UART错误及回复丢弃均0。

静止测试覆盖原先设置原点/开启遥测后约17.8秒出现故障的操作窗口，不执行底盘移动或雷达扫描。遥测恢复测试前off状态，普通四轮反馈保持on，网页串口仍可用。上板证据见[boot.json](../../.embeddedskills/uart5-deadline-20261011/boot.json)、[live-validation.jsonl](../../.embeddedskills/uart5-deadline-20261011/live-validation.jsonl)、[final-status.json](../../.embeddedskills/uart5-deadline-20261011/final-status.json)。

该修改消除了主机测试复现的晚解析误判路径，实车静止验证未复发；未声称原始偶发超时或此前FE的电气根因已完全消除。烧录后无需重开香橙派程序。
