doinbest/Yachiyo/xjx/模版搭建/docs/开发记录/2026-10-11-右下起点二维码路线测试.md

# 右下起点二维码路线测试

## 需求与实现

新增右下扫码路线，保留原右上测试。用户确认二维码接收始终开启，Z 轴只需下降、上升，扫到有效二维码后停止 Z；复用现有搜码流程，不改变 Base 和 X。

右下初始位置 `(2250,150)` mm，车头朝左180°。先保持朝向斜移到 `(2100,300)`，位移约212 mm；到位后原地顺时针转90°，车头变为朝上90°；完成转向再直行到 `(2100,qr_scan_y)`，默认 `qr_scan_y=1200` mm，直行约900 mm。底盘停稳确认后进入现有 Z 搜码流程：先等新码，未取得新码时下降、再上升，过程中扫到本轮真实新码立即停止并等待停止确认。现有默认下降量50 mm、速度5 mm/s保持不变。

二维码页“起点到二维码控制测试”默认选择右下，可切换右上；选择、输入、刷新和连接不发运动命令。界面分别提供对应的起点设置按钮与启动入口。右下使用 `chassis origin 2250 150 180` 与 `grab qr begin lower 50`；右上使用 `chassis origin 2250 2250 -90` 与 `grab qr begin upper 50`。旧 `grab qr begin [speed]` 保持右上语义，默认速度50 mm/s，允许10～200 mm/s。

两条测试共用原回零参考、IMU验证、新鲜四轮反馈及到位停稳确认。右下扫码的180°起始朝向与普通固定路线的90°起始朝向独立，测试不会自动改起点。正常停止、取消保留配置与参考。

## 验证结果

- 先新增回归用例，确认原代码拒绝右下路线与新命令；红阶段证据在 `.embeddedskills/qr-lower-red-20261011-065958/host-tests.log`。
- 路线测试验证斜移、转向、直行顺序，转向完成前不发直行，转向中取消不继续下一段，并保留原右上与普通固定路线回归。
- 任务测试验证新命令、起点匹配、新鲜反馈等待、底盘停稳后才启动 Z；现有二维码/Z 控制测试通过。
- 完整固件主机回归通过，日志 `.embeddedskills/qr-lower-firmware-tests.log`；网页 Node 测试546项通过、0项失败，日志 `.embeddedskills/qr-lower-web-tests.log`。
- 浏览器核对右下/右上切换后的起点按钮、路线说明和指令预览正确，未点击执行。
- Keil Target `template` 编译通过，0错误、0警告；日志 `.embeddedskills/build-qr-lower-route/template-template-build.log`。Flash253288 bytes，RAM186808 bytes。
- 产物 `Code/template/MDK-ARM/template/template.hex`，SHA256 `59c6da64657ee476daa2a3eaf067b998cce138a65ae86a1edbee55584714c621`。

本次未烧录、未发送实车运动命令，实际行驶与扫码效果待上板验收。后续烧录后需重开香橙派程序，再进行依赖视觉的实车测试。

## 现行操作说明

- [视觉任务](../../Code/upper-computer-web/local-car/docs/视觉任务.md)
- [系统与底盘协议](../协议/系统与底盘.md)
