doinbest/Yachiyo/xjx/模版搭建/docs/开发记录/2026-10-11-扫描与跑图准备解耦.md

# 扫描与跑图准备解耦

## 问题与依据

用户要求支持先雷达扫描、再准备跑图并执行已有规划。此前扫描记录`origin_generation`，网页每次准备都写入`chassis origin 2250 150 90`；`ChassisLocalization_Origin`增加定位版本，雷达控制台要求版本一致，因此首次设置原点也会让先前完整图无法执行。定位短暂失效同样增加版本。现场证据见[启动拒绝记录](2026-10-11-雷达路线启动拒绝串口检查.md)，其“先准备再扫描”的顺序限制是当时版本事实。

## 实现范围

- `radar_console.c`：完整地图及采集配置决定适用性；不再将历史采集定位版本与当前定位版本比较。冻结地图分页与即时状态使用同一规则，采集不因定位版本变化退出，实际底盘运动仍中止静态采集。地图、路径、稳定点的采集身份保持不变。
- `chassis_telemetry.c`：只读`chassis task`增加原点、当前位置、位置有效性及年龄，查询不重设原点、不启动运动。原有紧凑遥测数组结构保持兼容。
- `route-preparation.mjs`：IMU检查通过后再查询底盘；已有原点在目标0.1 mm/0.1°以内、当前位置在10 mm/2°以内且新鲜有效时复用，直接开启本次遥测。否则继续等待人工确认起点，确认后才设置原点；最终仍需四轮静止与本次会话的新鲜位置。
- 界面说明支持两种操作顺序，地图失效提示指向雷达标定/扫描参数，底盘未就绪与地图失效分别说明。

`ChassisLocalization.generation`及运行中路线连续性检查未放宽；短暂反馈故障保留地图，但是否继续运动仍由既有底盘流程决定。路线启动继续要求真实有效原点、当前位置、速度、新鲜度和总线就绪。上起点只规划、参数改变后的地图失效及停车响应保留。未改EIDE、IOC、HAL或电机驱动配置。

## 验证与部署

新增STM32回归模拟扫描定位版本0、首次准备版本1，旧代码拒绝，修改后成功；覆盖定位版本变化后地图分页/状态仍适用、参数改变仍拒绝、采集期间版本变化不退出而运动仍退出。网页新增匹配原点复用、缺失/偏移/过期/角度异常需确认、确认前停车和新总线故障不推进用例。

Keil Target `template`构建通过，0错误0警告。`python Code/tests/run_firmware_tests.py`完整回归通过；网页`node --test Code/upper-computer-web/local-car/tests/*.test.mjs`共558项全部通过。完整网页回归首次仅因旧文案断言“请重新扫描”失败，已按新的“雷达标定或扫描参数已变化，请重新采集或重算地图”说明同步用例，再次完整运行通过。

日志位于`.embeddedskills/build/map-preparation-20261011/template-template-build.log`、`.embeddedskills/tests/map-preparation-firmware-20261011-223055.log`与`.embeddedskills/tests/map-preparation-web-20261011-223249.log`。差异检查按仓库既有CRLF行尾运行通过。

本次本地源码更新与编译，尚未烧录、未发送实车命令；需烧录新固件并刷新网页。实车验收分别检查准备→扫描→执行、扫描→准备→执行、重复准备、反馈恢复后重新准备及实际标定变化。按现行规则无需重开香橙派程序。
