doinbest/Yachiyo/xjx/模版搭建/docs/开发记录/2026-10-11-暂时关闭机械臂上电自动回零.md

# 暂时关闭机械臂上电自动回零

后续已按用户要求恢复，现行行为见[恢复三轴上电回零与使能恢复](2026-10-11-恢复三轴上电回零与使能恢复.md)。以下保留暂停版本的当时事实。

用户发现驱动器 ID 与固件不一致，自行更正后 Z 回零仍报告 `home_axis_fault`，反馈为 `home_flags=0x03 motor_flags=0x02`，停止未确认。为单独测试各轴，用户再次要求关闭上电回零并直接烧录；本次不修改电机 ID、碰撞电流或故障判定。

`main.c` 启动不再调用 `GrabTask_BootHomeStart()`，改为直接安排静止 IMU 5 秒验证。保留 `grab rehome` 和逐轴控制，未回零不伪造机械臂位置参考。ID8 自动请求仍等待三轴 `home_complete`，不会因 IMU 通过而启动。

固件启动横幅明确 `arm auto-home=off`。网页启动文字按实际横幅区分自动回零暂停与旧固件回零流程，普通启动消息不再预言回零；仍须收到 IMU PASS/control_ready 才显示就绪。更新模块缓存版本，刷新网页加载新提示。

## 验证

- 网页 Node 回归 544 项全部通过，包含新增暂停回零横幅与旧固件流程兼容测试。
- IMU、GrabTask、姿态、二维码控制、ID8 转盘、控制台主机测试与控制台协议检查通过（7 项）。
- Keil Target `template` 构建 0 错误、0 警告，Flash 252108 B / RAM 186792 B。核验当前 HEX 含 `arm auto-home=off` 横幅，入口无自动三轴回零调用。
- 2026-10-11 05:22:15，经已确认 CMSIS-DAP / SWD / 4000 kHz、`target/stm32f4x.cfg` 烧录成功，OpenOCD 返回 `programmed=true verified=true`。结果见 `.embeddedskills/boot-home-disabled-flash-result.json`；构建及主机测试日志同目录保留。
- 本次未执行逐轴运动或回零实测；由用户继续单轴调试。烧录后需重开香橙派程序，再进行依赖视觉的实车测试。
