doinbest/Yachiyo/xjx/模版搭建/docs/开发记录/2026-10-11-机械臂设零与回零快捷按钮.md

# 机械臂设零与回零快捷按钮

用户要求在“机械臂与夹爪”的轴控制区直接提供设置机械零点、就近回零和碰撞回零。

在使能、失能、读取状态和停止所选轴下方新增三个快捷按钮，复用当前轴选择及既有命令构建、发送和连接/停车状态控制：`origin <axis>`、`home <axis> near`、`home <axis> collision`。点击时读取当前所选轴，全部轴沿用现有固件语义。原高级回零及计数清零入口保留。

设置机械零点使用驱动器存储命令，不移动电机，不替换为计数清零。回零参数沿用驱动器配置；界面提示 Base 通常就近回零、X/Z 通常碰撞回零，全部轴使用同一方式。单轴回零不自动建立三轴任务参考，现有 `grab rehome` 流程保留。

验证：`node --check Code/upper-computer-web/local-car/app.mjs` 通过；协议与串口桥接共 36 项既有测试通过。浏览器确认三个按钮直接显示，切换 Base/Z 后对应指令分别为 `origin base|z`、`home base|z near`、`home base|z collision`；本页发送计数保持 0。界面截图见 [快捷按钮预览](../../.embeddedskills/screenshots/arm-homing-controls-20261011.png)。仅修改本地网页和操作说明，未修改固件、烧录或发送实车命令。
