doinbest/Yachiyo/xjx/模版搭建/docs/开发记录/2026-10-11-车辆状态卡片精简.md

# 车辆状态卡片精简

用户要求优先继续精简“当前车辆与停车状态”，沿用此前确认的四项状态及单个详情入口设计。本轮仅涉及本地网页显示和订阅按钮，不调整雷达网格、规划、固件或实车停车条件。

- 卡片改为“车辆状态”，保留本次两个起点选择。开始监控/暂停更新合成一个按钮，仅发送原有`chassis stream on <nonce>`或`chassis stream off`，不发送运动或停车命令。
- 未连接、未订阅、等待状态和断流分别只显示一条提示；隐藏没有有效状态的实时数据。监控中按车辆状态、当前目标、计划速度（阶段限速）、当前指令速度四项显示；指令平移速度取vx/vy合速度，非零角速度显示°/s。启动速度和分量可悬停查看，转向阶段不把0 mm/s解释为转向速度。
- “最近停车”仅有已确认记录时显示，坐标和计划偏差分两行。零速指令不证明已停车；确认依据沿用设备停车状态与同帧有效反馈，断连/暂停保留历史。
- 空停靠记录不占位置。停靠列表、完整路线、遥测状态、服务停车和记录说明统一收进默认关闭的“历史与详情”，无额外嵌套折叠。
- 切页和重连不自动开启订阅，准备跑图已有的订阅流程保留。发送失败不伪造订阅切换；按钮等待发送时禁用，避免同一切换重复点击。

验证：先确认旧实现不能满足新行为用例；专项15项通过，新增发送失败用例后网页全量534项通过、0失败。浏览器验证未连接页仅显示一个按钮和提示，空实时/历史块隐藏，详情可展开再收起，默认关闭，控制台无错误。未连接实际串口或发送运动命令；监控启停、新鲜度、零速不等于停车、历史保留及失败发送由软件测试验证。截图和测试输出保存在`.embeddedskills/`。前端更新刷新网页即可，无需烧录。
