doinbest/Yachiyo/xjx/模版搭建/docs/开发记录/2026-10-11-转盘点动与UART5串口诊断.md

# 转盘点动与UART5串口诊断

## 现场证据

用户报告回零完成后`jog -90`实物转动约90°，后续点动被总线锁定拒绝。其`info`及本次COM14/115200/8N1读取均确认固件构建20:56:00，首故障`uart_error fault_ms=33990 owner=7 addr=8 func=0x3A uart_error=0x00000004`。该故障发生在ID8状态读取附近，FE并不能直接证明ID8驱动板损坏。用户确认ID1～8全部供电。

本次串口执行`bus test 8 10`及`bus test 8 100`，共330次状态/位置/速度只读请求均成功，timeouts/uart_errors/rejected均为0，最大回复1 ms；实际0x3A返回83，速度为0。这是静止单ID证据，不证明运动或多机交接无错误。

获准后执行一次`bus recover`，回复`arm_ready=1 chassis_ready=1 reason=complete`，并收到四轮停稳确认。后续−90°测试未再次触发FE，却以`position_timeout`结束：实际270.187°、目标180.187°。`info locked=0`，仍保留33990 ms的历史首故障；不能把历史FE当成本次运动失败原因。最终只读原始回复保存在[final-readonly.jsonl](../../.embeddedskills/uart5-diagnosis-20261011/final-readonly.jsonl)。前段终端工具的daemon日志不保存串口原文，330次测试及恢复结果以上述实际工具输出汇总为依据。

## 定位与修改

手册ZDT_X42S V1.0.5第57页说明FD模式0/1/2分别为相对上一输入目标、绝对坐标、相对实时位置。当前turntable却使用模式2发送增量；本车已有Base及独立转盘模式2实测异常，本次ID8再次−90°未改变实际位置符合这一模式不适配现象。旧模拟测试默认模式2正常相对执行，遗漏了该故障。

转盘改为读取新鲜多圈位置、计算jog增量或index最短角度后的最终绝对目标，再按3200命令脉冲/圈发送模式1。反馈仍为65536单位/圈；参考偏移、仓位、库存、回零方式和真实停稳检查保留。绝对目标超出FD四字节脉冲范围时拒绝，避免转换溢出。

新增即时`OK turntable arrived`与`ERR turntable fault`，记录总线锁定、原因、地址、功能码及UART错误；此前只在下一条操作时看到bus_locked，且到位也无主动回复。网页专门翻译`OK bus motion`为运动隔离状态，区分error=2通信/发送异常与实物仍在运动；保留IMU验证场景的motion原因翻译。

没有忽略FE、重放运动指令或更改驱动器配置。当前HAL在DMA接收时把FE作为阻塞错误终止接收，MotorBus再锁定并停止任务；改变这一策略需要对应复现证据，本次未凭静止查询正常就认定线路无问题。

## 软件验证

复现模式2被当作绝对目标的驱动行为后，旧turntable回归在分度到位断言失败；模式1修复后通过。覆盖连续两次−90°累计变化、负多圈位置及跨零、实际位移与脉冲尺度、到位日志、FE即时诊断、缺ACK仍停车、参考/库存保留。慢速15秒转盘并发总线测试保持609次机械臂和952次四轮回复在新鲜窗口内。

完整固件主机回归通过，新增FE用例单独通过；网页终端测试24项通过；Keil Target template构建0错误0警告。主机完整输出：[host-regression.txt](../../.embeddedskills/uart5-diagnosis-20261011/host-regression.txt)，构建输出：[build log](../../.embeddedskills/uart5-diagnosis-20261011/build/template-template-build.log)。

## 烧录与实车验证

用户确认机构范围清空后，使用已确认CMSIS-DAP（序列号7b168f48）烧录。4000 kHz首次写入失败；降至1000 kHz重试，OpenOCD确认Programming Finished、Verified OK并复位成功。日志：[flash-retry-1000.log](../../.embeddedskills/uart5-diagnosis-20261011/flash-retry-1000.log)。固件HEX SHA256为`19466FFEEAA36E33D52091D2386512B5424AD63FDD9CBB4FD1397493DC565A4B`。增量构建的info时间来自main.c编译时间21:19:24，最终Keil构建完成于21:51:09；新增到位回复亦确认加载了本次转盘代码。

复位后Z/X/Base自动回零确认`home_started=7 home_verified=7`，ID8回零完成、参考有效，IMU验证通过。随后执行已获准的一次−90°/+90°往返：−90°到位角269.802°、目标269.912°；+90°返回角0.153809°、目标359.912°（角度跨零等价，圆周误差约0.242°）。两次均收到`OK turntable arrived speed_rpm=0 ref=1`。最终`state=arrived arrived=1 moving=0`，`locked=0 reason=none fault_ms=0 uart_error=0`，ID8请求237次、成功237次、拒绝和超时均0。闲置状态fresh=0表示停止持续采样，不否定此前新鲜反馈确认的到位。

原始上板串口收发：[postflash.jsonl](../../.embeddedskills/uart5-diagnosis-20261011/postflash.jsonl)。此次验证证明模式1点动及往返完成，未复现原始FE；不能宣称电气干扰、接线或运动中UART帧错误的根因已排除。后续烧录无需重开香橙派程序。
