doinbest/Yachiyo/xjx/模版搭建/docs/开发记录/2026-10-11-雷达路线启动拒绝串口检查.md

# 雷达路线启动拒绝串口检查

## 现场与只读证据

用户点击“执行扫描后的雷达路线”后车辆未运动，顶部显示故障、停车未确认。2026-10-11通过已运行的127.0.0.1:8765本地服务复用COM14/115200读取串口；不关闭用户网页连接，不发送车辆运动或扫描命令。原始事件保存在`.embeddedskills/radar-nav-diagnosis-20261011/before.json`，只读查询保存在同目录`readonly.json`及`readonly-detail.json`。

按北京时间，22:02:55接受`radar scan lower 15`，22:03:01完成结果确认。22:03:26第一次启动返回`navigation_or_grab_not_ready`，路线状态`error/start_origin_or_feedback`，未提交运动（segment=0、id=0）。22:04:01准备跑图发送`chassis origin 2250 150 90`；22:04:14再次启动返回`map_origin_or_parameters_changed`。

扫描结果身份origin=0；当前底盘遥测localization generation=1。radar_console适用性要求扫描原点版本与底盘原点版本相同，所以准备原点后旧扫描不能启动。第一次则因未准备起点参考而被chassis_route拒绝。

当前只读`chassis task`报告cancelled、error=0、locked=0；`chassis stop-status`报告tx_complete=1、wheels_stopped=1、reason=stopped。历史首总线故障为ID4/0x35应答超时，恢复后locked=0，不能当作当前锁定。`chassis route status`仍保留历史启动失败state=error、reason=start_origin_or_feedback、stop_confirmed=0；map-view界面根据路线的stop_confirmed显示“停车未确认”，与独立四轮停车确认不是同一状态。

## 处理顺序与范围

先准备跑图建立起点参考，再静止采集15圈并确认设备路线完整，最后执行扫描后的路线。扫描后重新设置原点需要重新扫描。此次仅检查和解释，没有修改代码、烧录或启动实车路线。界面历史失败提示与当前停车状态的统一可作为后续明确修复范围；不能用旧路线stop_confirmed=0判定车辆当前仍在运动。

## 22:11重启后的位置应答超时及串口分析

用户新日志显示回零与IMU验证正常，但启用底盘反馈并设原点后约17.8秒进入锁定。串口首故障确认`locked=1 reason=reply_timeout fault_ms=17774 owner=4 addr=1 func=0x36 uart_error=0`；0x36为实时位置查询，error=3为超时，stage=6为故障。没有证据证明这是上次ID8帧错误或扫描原点问题。控制台收发溢出、UART错误、回复丢弃计数均0。

本次通过网页现有串口服务执行静止只读`bus test`：ID1和ID4各100轮（各300请求），ID2和ID3各10轮（各30请求），合计660请求全部成功，超时、UART错误和拒绝均0，最大回复2ms。此模式轮内每个请求间隔20ms，普通多ID轮询采用2ms应答后交接，不能仅用单ID测试替代连续轮询验证。

在此前明确授权的停车和总线恢复范围内执行`bus recover`，全部8驱动检查完成、四轮停稳、locked=0/error=0。恢复会关闭普通反馈轮询；随后显式`chassis feedback 0`及`chassis feedback on`，恢复四轮静止自动读取。连续约26秒，总线transactions由1968增至10739（新增8771）；没有新增超时或锁定。ID1累计timeouts=1仍为17774ms旧故障，info保留首故障不代表当前仍锁定。最后四轮raw_rpm=0、valid=1,1,1，反馈时间持续更新。

源码显示请求TX完成后100ms应答期限，并先判超时、后解析RX缓存。若前台处理曾长时间延迟，及时进入缓存的帧也可能在解析前被判超时；这是源码可见的待验证路径，不是本次已证明的现场根因。现有诊断未保存首故障前后的UART5原始字节、缓存积压与主循环间隔，因此仍无法区分驱动未回、线上损坏、解析漏帧或处理延迟。未修改代码、延长超时或放开真实故障互锁，也未发送底盘移动命令。完整证据在`.embeddedskills/radar-nav-diagnosis-20261011/probe-analysis.jsonl`、`recovery-continuous.jsonl`、`automatic-feedback.jsonl`。
