doinbest/Yachiyo/xjx/模版搭建/docs/开发记录/2026-10-12-Base电流与驱动诊断.md

# Base电流与驱动诊断

## 需求与依据

用户要求添加Base电流读取指令，并允许参考网上资料分析重载可调参数。本次添加单次只读诊断，不写电流、原点或回零参数，不烧录、不重启、不发送新的实车指令。

此前串口实测已确认ID5的near回零报告0x0B，在位置稳定检查前失败；30次状态/位置/速度读取全部成功。当前电机额定电流和实际驱动配置未读到，不把力矩不足当已证实根因。

官方协议依据为[本地X42S手册](../硬件资料/执行机构/闭环步进电机/ZDT_X42S第二代闭环步进电机用户手册V1.0.5_260527.pdf)第64、68～69、73、103～106页；网上对照[厂商Emm V5说明书](https://blog.csdn.net/zhangdatou666/article/details/132644047)，未采用第三方项目的调参数值或复制其代码。较旧Emm板卡与X42S的电流规格、输出限制倍率可能不同，以实际型号与读回为准。

## 实现

- `bus read 5 current|voltage|error|home|driver`分别读0x27/0x24/0x37/0x22/0x42。单次隔离沿现有bus test机制，任务空闲时受理，停止可中断；其他ID1～8也可显式选择。
- 当前主车Emm配置读取33字节，总线事件和解析缓冲由32增至40；只读白名单限定功能、长度及0x42辅助码0x6C，仍不允许诊断所有者发送修改电流等写命令。
- 0x37有符号32位误差用int64解码，按65536单位/圈换角度；0x42按33字节/21参数布局解码电流上限、输出限制原始值、堵转阈值和0.1度到位窗口；X布局不声称支持。
- 网页目录、中文摘要及Python/JS停车锁定只读分类同步。官方Emm_V5驱动不修改，未增加工程源文件，无需更改Keil清单。

## 调参建议及限度

优先读实际Ma_Limit与相电流；若实际电流接近限幅、明显欠跟随，且电机额定电流及实际驱动板留有余量，再考虑逐步提高闭环电流上限。高于已有额定范围的电流不作为建议默认值。回零速度过高时先降低O_Vel重测；只有读回超时确实过短、运行确实拖到该期限时才提高O_Tmo_Ms。软件2度为相邻反馈稳定窗口，不能替代驱动原点确认。

Ma是开环工作电流，与闭环Ma_Limit不同；O_SL_Ma是碰撞回零检测阈值，不改善near回零力矩。PRWindow是驱动位置到达窗口，可影响普通到位位，但没有资料确认放宽可消除本次0x0B；不把它作为已证实修复。堵转保护Clog_Ma/Clog_Ms与力矩上限不同，不能用关闭保护或提高阈值代替根因验证；PID、刚性系数、输出电压限制先保留实测基线。

单次空闲电流仅是保持时样本，不是运动峰值。回零过程电流采样不在本次实现范围。后续实车需先烧录新固件，并更新/重启本地服务；本轮仅软件验证。

## 验证

新增回归首先复现旧总线拒绝0x27、旧网页停车锁定误挡查询。修复后总线测试验证相电流分片、33字节配置分片及禁止写命令；控制台测试验证2500mA、24000mV、负360度、30RPM/10000ms、3000mA/0.8度解码、拒绝帧不伪造数据、停车中断。完整固件主机回归通过；网页571项通过；Python桥44项通过；Keil构建0错误0警告。
