doinbest/Yachiyo/xjx/模版搭建/docs/开发记录/2026-10-12-PD12雷达盘舵机控制.md

# PD12 雷达盘舵机控制

2026-10-12 用户要求在本地上位机“机械臂与夹爪”提供雷达盘舵机脉宽测试和失能按钮，以核对未知的安装方向与行程，并在触碰限位时停止控制。

## 实现与依据

- 用户已用 CubeMX 加入 PD12 / TIM4_CH1，PSC=83、ARR=19999、初始 Pulse=0。当前 APB1 42 MHz、TIM4 84 MHz；计数 1 μs、PWM 周期 20 ms。保留该次生成修改及其他未提交业务改动，仅补初始化调用、独立 `Hardware/lidar_servo.c/.h` 和 Keil 清单；未修改 EIDE。
- 上电以 CCR1=0 启动 PWM，不主动转到1500 μs。`lidarservo pulse` 支持整数500～2500 μs；越界/格式错误保留原输出。网页提供五档快捷值、自定义输入、独立红色失能及状态查询。
- `off` 清零CCR1，不切断舵机供电；无脉冲后的保持行为与电流须实测。输出更新在下一PWM周期内生效。查询是软件输出状态，没有假设机构到位或电流下降。
- 改变雷达朝向会干扰采图/路线，故在既有取放/路线/底盘运动/IMU标定以及雷达采集期间拒绝新脉宽；结束任务后重试即可，不清参数、参考或进度。失能与查询绕过这些忙状态，失能不停止其他机构或扫描。
- 浏览器和Python服务将`off`作为优先命令，取消尚未发出的普通动作及旧HTTP动作，停车锁定/准备等待期间仍能使用；不解除停车锁定。进入页面、编辑输入、刷新、重连不发舵机动作，也不重放旧脉宽。

## 软件验证

- 新增网页测试先因缺少命令失败；新增服务测试先因失能没有抢占旧脉宽队列失败，实施后通过。
- 独立审查发现网页接受`1500.0`但固件整数解析拒绝；新增回归先失败，再为该命令将数值规范化为整数文本，覆盖`1500.0`、`1500.`、前导零和首尾空白并通过。
- `lidar_servo_test`：上电零脉宽、五档与1537 μs、边界拒绝、失能/重新输出、初始化失败处理通过。
- `arm_console_host_test`：实际字节输入与解析，整数/溢出/非法字符串、任务忙拒绝、失能及查询放行、其他任务状态保留通过。
- 网页Node全套586项通过；实际app模拟覆盖编辑不发送、显式应用、准备等待/正在发送/参数忙/停车锁定下失能可用。
- Python `test_bridge.py` 45项通过；FakeSerial验证旧脉宽被取消、失能优先、停车锁定下查询/失能可用。
- Keil `template` 编译成功，0错误、0警告；源码清单对照HEAD无删除项。日志在 `.embeddedskills/tests/lidar-web.log`、`lidar-bridge.log` 及 `.embeddedskills/build/template-template-build.log`。

## 生效与实物验收

### 同日脉宽上限放宽至5000 μs

用户实测2500 μs仍未将雷达盘转出、低于2500向车内转；点击off后设备回复enabled=0/pulse_us=0，但舵机仍保持。23:25本地日志证明off/status已被固件受理，停止信号不等于断电卸力；型号未知，未把该现象归因为软件输出持续有脉冲。

随后用户明确要求检查PD12配置，正确时放宽输入到5000。核对IOC、生成的tim.c、SystemClock_Config和初始化调用：PD12复用AF2/TIM4_CH1，AF推挽、无上下拉，TIM4时钟84 MHz（APB1为42 MHz、分频4后定时器倍频），PSC83、ARR19999、向上计数、PWM1/高有效、初始CCR0，MX_TIM4_Init后调用LidarServo_Init；没有发现配置错误，也没有另一个业务写htim4。软件配置正确不替代引脚实测波形。

仅将雷达舵机驱动、控制台解析/帮助/错误文本、网页输入及当前手册同步为500～5000 μs；夹爪范围、五档快捷值、PWM周期和停止逻辑保留。5000计数对应5 ms/25%占空比，小于20000周期计数。该上限是用户授权的扩展测试范围，不代表未知舵机可接受或能到达目标位置。

新范围测试先因原2500上限失败，修改后通过；C驱动覆盖3000/4000/5000及5001拒绝，控制台主机测试覆盖5000受理和越界/非法文本保留原输出，网页测试覆盖扩展脉宽及停PWM命令。Keil template编译0错误、0警告。本轮没有烧录或发送实车命令，需烧录新固件并刷新网页后生效；不需要因本次范围修改重启服务或重开香橙派。

### 同日布局调整

用户截图反馈雷达舵机区域过于松散。仅调整网页：标题旁排列失能/查询，五档快捷值等宽，自定义输入/应用同排，移除重复的小标题和说明，安装说明按需展开，保留直接可见的供电提醒；相对运动指令预览也将命令与按钮同排。串口协议、发送条件及固件保持原有行为。

相关 Node 测试40项通过；本地浏览器检查蓝色/黑色主题和390 px窄屏，页面宽度无溢出，未连接或发送设备命令。效果图位于 `.embeddedskills/tests/lidar-servo-layout.jpg`。本次布局更新只需刷新网页，无需重新烧录或重启服务。

本轮未烧录、未发送实车串口命令。需要烧录主车新固件，退出旧本地服务后重启并刷新网页、手动选实际串口；无需重开香橙派程序。安装方向、各脉宽对应位置、限位范围及停PWM后的电流尚未实测；若失能后仍顶住限位，切断舵机供电。改变安装姿态后确认雷达方向并重新采图，再执行路线。
