doinbest/Yachiyo/xjx/模版搭建/docs/开发记录/2026-10-12-纯视觉追踪恢复速度与增益.md

# 纯视觉追踪恢复速度与增益

## 实车反馈与取舍

用户提供33秒摄像头录像，确认运行“纯视觉＋反馈减速”。后续控制台截图确认设备读回为底盘80、X30 mm/s、lambda1.0、X前瞻60 ms。约23～27秒的采样画面中DY从−99、−54、−22、−8收敛到+3，用户认为追随过慢，希望保留此前够用的速度，再处理过调。录像未包含同步电机指令和实际速度，不能据此确认哪些阶段已触及速度上限。

用户最终批准两验证组采用以下较积极的参数。本轮只实现这些默认值及网页预设，不修改控制算法。

| 参数 | 本轮visual/feedback默认 | 前一轮默认 | predict保留 |
|---|---:|---:|---:|
| body_speed | 160 mm/s | 80 mm/s | 160 mm/s |
| x_speed | 60 mm/s | 30 mm/s | 60 mm/s |
| lambda | 2.0 s⁻¹ | 1.0 s⁻¹ | 2.5 s⁻¹ |
| horizon_ms | 60 ms | 60 ms | 120 ms |

未碰到限速和其他分配约束时，同误差的纠偏需求变为前一轮两倍；速度上限也恢复。实际响应仍受反馈减速、加速度、总线和驱动影响，不能把需求增幅当成实车速度保证。联合加速度300、反馈body_accel300/x_accel120 mm/s²、窗口±5 px、其他参数与驱动档位保持。

## 实现与范围

- `grab_parameters.def`继续作为唯一默认值来源；调整TRACK_COMPARISON_DEFAULT的三项初值，X前瞻仍60 ms。
- 同步生成网页元数据、预设说明、当前操作手册与协议；保留前一轮开发记录作为当时事实。
- 现有两阶段夹取仍在新鲜双轴偏差进入默认±5 px且Z反馈到夹取高度时请求停车，保持使能；停稳后核验新鲜坐标再闭爪，不新增200 ms视觉停留或失能操作。
- 提前减速算法未在本轮修改，不能宣称视频过调已解决。原预测、静态对准、码垛、参考、库存和停车恢复逻辑保持。

## 生效操作

当前兼容固件可以通过更新后的网页应用，无需为改RAM参数烧录。先停止并确认停稳，分别选visual、feedback，点击“填入追踪预设 → 应用并核对 → 读取全部”，确认字段下方“最近读回”为160、60、2、60。输入框是草稿，页面刷新或切组不修改设备RAM。新版固件初始化才使用本轮默认，普通停止或重连不会覆盖已写配置。香橙派无需为此次MCU参数调整重开。

## 验证

更新现有固件模式默认值断言和网页预设隔离测试，先在旧默认上失败：固件80/30不满足160/60，网页80不等于160。修改后两项均通过；原预测2.5/120保留，网页选组及填入预设不发送命令。

- `python Code/tests/run_firmware_tests.py`：完整固件主机回归通过，包括追踪夹取的新鲜坐标、停车核验、下降暂停/恢复及保护不闭爪用例。
- `node --test Code/upper-computer-web/local-car/tests/*.test.mjs`：576项通过、0失败。
- Keil `Code/template/MDK-ARM/template.uvprojx` / Target `template`：0错误、0警告；生成hex/axf，Flash 266748 B、RAM 187472 B；未构建EIDE。
- 参数生成一致性与差异空白检查通过。
- 独立审查未发现可执行问题，确认两验证组/predict隔离、定义与网页元数据一致、无被动写入或RAM重置，停车与闭爪流程保持。

日志位于`.embeddedskills/analysis/tracking-speed-restored-*-20261012.*`，编译日志目录为`.embeddedskills/build/tracking-speed-restored-20261012/`。本轮未烧录、未复位、未向实车发送指令，实际提速和过调表现待测试。
