doinbest/Yachiyo/xjx/模版搭建/docs/开发记录/2026-10-12-追踪夹取两阶段下降.md

# 追踪夹取两阶段下降

用户要求双轴偏差进入±50 px即可下降，进入±5 px可夹取，试验追踪与夹取衔接效果。修改前保存工作区快照提交`6282241`，保留既有控制台、回零、雷达与文档修改；原追踪夹取、任务与控制器三组回归通过。

## 行为

`grab track pick`仍使用原预测追踪与既有颜色、夹取高度/下降速度表单。新鲜B2 DX、DY绝对值均≤50 px时进入下降，底盘/X持续追踪；新坐标移出窗口只暂停Z，重回后向同一绝对高度续降。下降窗口在`grab_parameters.def`集中定义。

Z实际反馈到夹取高度、机构到位判据满足，且新测量双轴进入`tol_px`（默认5 px）时立即开始原停车确认。停稳后复核停车发送之后的新鲜坐标与Z实测高度，满足才闭爪；停车时目标移出精确窗口则在原参考/预算内恢复追踪。取消旧200 ms视觉稳定等待与整段下降/闭爪漂移估算门槛；机械反馈稳定、实际停车及`close_ms`闭爪等待保留。提至`z_lift`后完成`picked`，保持物料等待下一步，不自动入仓、不改库存。

短漏检沿原宽限处理，持续缺失、行程窗口暂停及人工停止均停住正在下降的Z；可恢复的暂停继续本轮，人工停止结束本轮。加一个Z状态/位置轮询机会，避免XY追踪期间缺少下降到位证据。网页同步“下降并持续对准”“偏差移出±50 px，暂停Z，继续追踪”和“到夹取高度、停稳后闭爪”等中文说明。纯视觉和反馈减速入口仍只跟随，静态环/颜色、码垛、准备和车载取放沿原状态机。

## 验证

新增生产状态机测试先在旧实现50 px不下降处失败，修改后通过。覆盖双轴50/51与5/6 px边界、下降期间持续XY请求、Z未到位不闭爪、重复坐标不触发闭爪、停车后新坐标复核、移出窗口Z暂停/续降、短漏检/持续漏检恢复、人工取消、Z保护故障及提起完成。共享总线模拟20/25/80 ms应答：X位置最大年龄119/125/319 ms，Z位置119/199/639 ms，全部机构反馈最大年龄599/499/1599 ms，均在原2 s时效内，X写入持续存在。这里是软件模拟，不是实车串口测量。

完整固件主机回归通过，证据见[固件日志](../../.embeddedskills/tests/two-stage-pick-firmware-suite.log)；最后新增总线延迟专项单独运行追踪夹取测试并通过，见[夹取专项日志](../../.embeddedskills/tests/two-stage-pick-final-target.log)。网页576项通过，见[网页日志](../../.embeddedskills/tests/two-stage-pick-web-suite.log)；Python串口服务100项通过。参数生成检查随完整固件回归通过。Keil主车`template.uvprojx` / Target `template`构建0错误0警告，Flash 266764字节、RAM 187472字节，见[构建日志](../../.embeddedskills/build-two-stage-pick/template-template-build.log)。EIDE未修改、未构建。

## 实车验收

独立只读代码审查核对状态机、共享事务、停车期间无后续目标发送、恢复时Z续降及参考保留，未发现需修复的问题；审查者独立运行最终追踪夹取测试通过。

本次只改本地源码、测试、文档并构建，未烧录、复位、部署或发送实车运动指令。更新固件、刷新网页后，用“追踪并夹取”显式启动；核对实际Z夹取高度、下降速度及夹爪1920 µs闭爪设置。先看下降是否在50 px内开始、下降期间是否持续对准，再看5 px到位时闭爪和提起，以及手动来回转/停转、移出窗口、漏检恢复和顶部停车。Z下降改变相机距离，实际误差收敛、停车期间目标移动及夹取成功率仍需视频/串口实测，不把模拟通过标为物理效果已改善。
