doinbest/Yachiyo/xjx/模版搭建/docs/开发记录/2026-10-12-追踪夹取衔接车仓入仓.md

# 追踪夹取衔接车仓入仓

用户批准合并追踪夹取和物料取放的原料入口，并要求本轮快速完成、不另做审查。修改STM32与本地网页，保留原追踪、固定夹取、加工取回和车载取出；没有烧录、复位或发送实车串口命令。

## 当前实现

- 默认夹取窗口双轴±100 px、视觉保持至少10 ms、原料夹取Z−50 mm、提起Z0 mm；原下降速度111.11111111 mm/s不变。下降启动/续降窗口仍双轴±50 px，10 ms不替代新视觉、Z到位、停车反馈或闭爪等待。
- `grab pose work`以原后向参考+128°完成准备后打开夹爪2500 µs；Base未到位不提前开爪，rear准备保持夹爪输出。
- `grab track pickstore <color> <slot 0..3> [predict|visual|feedback]`默认feedback，0选最低编号已确认空仓；先检查车仓/后向参考、仓位库存和目标行程。夹取与提起完成后在GrabTask内切换至现有入仓状态机，最终结果为stored。
- 提起到z_lift、收X、ID8分度并确认到位、Base到已验证RearBase、X到x_car、下降到z_lift−track_store_drop_mm、松爪、等待close_ms、记库存、提起收X，返回本轮下降开始前保存的Base/X/Z观察姿态。Base回仓不发HOME，ID8仓2/3角度不用于Base。
- 新参数track_store_drop_mm默认60 mm，网页用夹取高度+上升距离计算z_lift，再减入仓下降距离得到放料目标。参数由grab_parameters.def维护并同步网页元数据；旧固定/静态/加工流程继续使用z_place。
- ID8固件仓位默认同步为0°/−90°/−180°。这不表示旧设备RAM已经改动；新固件初始化后才使用新默认，上电库存仍UNKNOWN。
- `grab track store <slot 0..3>`将只夹取后的持料继续入仓，或续接中断入仓；0可续原仓。保存本次颜色/仓位/高度/返回姿态，拒绝改变续接仓位和重新启动追踪夹取。释放前停止保持夹爪；放料途中停止将涉及仓位置待核对；释放后续接补齐等待/库存及返回，不重复闭爪/松爪。软件记录不等同于新增夹持传感器。
- 物料取放页使用完整流程，动态追踪页有同一快捷入口及“只追踪夹取（不入仓）”。网页逐项写入并读回参数，成功后只发送一次启动；停止/断线/读回失败作废未完成启动。切页/刷新/重连不自动动作。原静态夹取折叠保留，路线/两批任务暂时继续原分支，待连续三件实车验证后再统一替换。

## 软件验证

- 新grab_track_store_test通过：连续三仓不同颜色、分度到位先于Base转动、释放后库存记录、返回原姿态；分度/下降/释放/返回阶段停车与续接；续接保留高度、错仓拒绝、不重复夹取；只夹取后入仓及超行程拒绝。
- 原小窗口测试显式配置5 px/200 ms保留覆盖；准备测试确认Base到位后才打开夹爪；转盘测试核对新仓位默认值。工作区已有Z驱动默认加速度255的修改被保留，底层传输测试改为核对选中轴实际配置，不重置该修改。
- 网页581项、Python100项通过，完整Firmware host regression suite通过。新网页用例覆盖先核对全部参数、单次启动、启动期间停车/断线/不一致取消及被动重连。
- 参数生成一致性检查、app语法检查、Git差异空白检查通过。Keil template编译0错误/0警告；产物Code/template/MDK-ARM/template/template.hex。EIDE未修改或构建。
- 日志：`.embeddedskills/analysis/tracking-store-{web,python,firmware}-20261012.log`、`.embeddedskills/analysis/tracking-store-build-20261012.json`及`.embeddedskills/build/tracking-store-20261012/template-template-build.log`。

下一步是烧录后验证实际料盘落料高度、X取放口位置与连续三件搬运。本轮默认上升50 mm/入仓下降60 mm为软件预设，用户可在启动前按实物调整；软件测试不代表已完成带料实车验收。操作说明见[视觉任务](../../Code/upper-computer-web/local-car/docs/视觉任务.md#原料追踪夹取与入仓)。
