doinbest/Yachiyo/xjx/模版搭建/docs/开发记录/2026-10-13-ID8到位容差与等待时间.md

# ID8到位容差与等待时间

用户报告仓2目标270°、停止后角度271.022°，此前到位等待超时。停止后反馈已不新鲜，不能据此还原超时瞬间；旧默认1°窗口可能造成未通过到位确认。

本次按用户确认将默认容许误差设为±2.5°。该值只参与完成判定，绝对位置目标仍为精确目标角度，不在进入窗口时发送停车或失能。仍要求新鲜反馈、驱动到位、零速度及稳定等待。

位置运动等待预算采用两倍匀速理论时间加反馈周期和稳定时间，最少5秒，给驱动加减速与共享总线采样留出时间。超时新增实际角、目标角、误差、容差、速度、驱动标志、反馈新鲜度、耗时和预算诊断。

软件验证：turntable_test与turntable_bus_fairness_test通过。覆盖正负2.4°接受、2.6°拒绝、目标指令保持准确、接受时不追加停车且保持使能，以及3.5秒后到位仍可完成。Keil template构建成功，0错误、0警告。

本轮未烧录、未执行实车运动。只读检测识别到CMSIS-DAP v2序列号7b168f48，SWD识别Cortex-M4/stm32f4x成功；尚未完成AGENTS要求的Keil Debug预期两个无线DAP-Link对应关系核对，因此未满足持续自动烧录条件。构建结果及探针日志位于`.embeddedskills/mission-integration/id8-tolerance-build.json`和`id8-tolerance-probe.log`。实车到位效果待烧录后验证。

## 01:31实车日志后的修正

用户反馈误差0.637207°、速度0 RPM、fresh=1、flags=0x81，仍于5秒超时。定位到软件同时要求驱动位置到位bit1，导致放宽主控容差未覆盖该情况。现取消分度完成对bit1的依赖，仍要求使能、无故障、新鲜位置在容差内、速度≤1 RPM并持续稳定；不改变目标或发送额外停止/失能。Base堵转处理按用户要求保持不变。

回归使用0x81与正负2.4°残差，修改前复现失败，修改后完成且反馈有效、moving为0、未增加停车；2.6°仍超时。转盘功能与总线公平性两项通过，Keil构建0错误0警告。构建日志`id8-reached-bit-build.json`、探针枚举`id8-reached-bit-probes.log`位于同一日志目录。本轮仅枚举到一个CMSIS-DAP，未完成规则要求的两端无线链路核对，未烧录。
