doinbest/Yachiyo/xjx/模版搭建/docs/开发记录/2026-10-13-初始化开爪与下载规则.md

# 初始化开爪与下载规则

按用户要求删除AGENTS中必须识别两个无线DAP-Link的条件。编译及验证通过后，核对已确认探针与实际SWD目标，连接正常即自动下载校验；不以USB枚举数量判断链路。

完整初始化及grab rehome在Z/X均验证完成后发送夹爪打开（Arm_GripperSet OPEN，2500 µs），随后沿原有ID8等待和Base启动等待执行Base就近回零。单独Base验证和单轴手动回零不新增开爪，Base堵转逻辑未改。代码位置为GrabTask.c的boot_axis_verified。

grab_pose_test新增顺序断言：Z/X验证前开爪次数为0，两轴验证后为1且Base尚未HOME，完整初始化后仍只开爪一次。grab_pose_test与grab_task_test通过；Keil template编译0错误0警告。上一轮ID8不依赖位置到位bit1的修改包含在本次构建。

自动下载已尝试，但未成功：指定CMSIS-DAP 7b168f48、SWD 1000 kHz、stm32f4x。只读探测成功；首次保存日志路径有误，之后连接报告CMD_INFO mismatch；重新连接成功并进入Programming Started，但Flash探测时cannot read IDR，最终Programming Failed、退出码1。没有烧录校验成功或复位运行完成的证据，不宣称设备已更新。日志位于.embeddedskills/mission-integration/boot-open-{build.json,probe.log,flash.log,flash-retry.log}。编译产物为Code/template/MDK-ARM/template/template.hex，可用用户已验证的Keil链路下载。
