doinbest/Yachiyo/xjx/模版搭建/docs/开发记录/2026-10-13-加工区持料放置连续下降.md

# 加工区持料放置连续下降

用户本轮确认：从车仓取出物料放到已对准的加工区色环时，Z无需先恢复−100 mm再下降30 mm，应连续下降到放置高度。

## 实现

保留空爪在`z_rough_align`（默认−100 mm）对环、真实停稳并保存X/Z，之后回车仓取料。持料转回参考+128°后，只恢复保存X并确认到位，Z直接按`z_proc_place`（默认−130 mm）发送完整下降目标，确认到位后松爪。删除原先恢复对准Z再切换最终目标的状态标记及分支。

下降期间不重获视觉；普通暂停保存原绝对放置目标，继续重新提交同一目标，不在对准高度停下或重复释放。加工区取回仍采用−100 mm识别对准、−130 mm闭爪，暂存/码垛保持原行为。控制台原因文案与现行规则、操作说明、协议同步。

## 验证

专用回归先在旧实现的首个下降目标断言失败，修改后通过。覆盖−130 mm及改为−120 mm的放置目标、X未到位不下降、经过−100 mm不追加运动指令、Z未到位不松爪、下降中暂停续接无需视觉、释放后暂停不重复松爪，以及原持料视觉放置/码垛行为。

完整回归首次在`grab_task_test.c`的Z抬升500 RPM预期失败。工作区已有`z_speed=111.11111111 mm/s`、`z_ppm=480`，对应1000 RPM；用本轮修改前的`GrabTask.c`也复现同一断言失败。同步该测试后，另一处`mechanical_arm_bus_test.c`普通Z指令预期仍为500 RPM，而当前既有`mechanical_arm.c`默认已是1000 RPM。两处只同步测试预期，未修改运行参数；原始失败及基线复现日志均保留。

独立审查未发现本轮确定问题，并独立重编译运行放置专用回归通过。最终完整固件主机回归通过，控制台日志测试31项通过；Keil编译0错误、0警告。

按已确认配置检测DAP（序列号7b168f48、SWD、STM32F4、1000 kHz），OpenOCD在探针通信阶段返回`CMSIS-DAP command CMD_INFO failed`，未识别当前目标，因此未烧录。已保存本轮`firmware.hex`与SHA256，构建后源码及参数哈希一致；结果、失败证据与最终通过日志均在`.embeddedskills/aligned-place-continuity/`。软件验证通过不代表设备已更新，实车动作连贯性仍待验收。
