doinbest/Yachiyo/xjx/模版搭建/docs/开发记录/2026-10-13-加工取回先对准再固定下降.md

# 加工取回先对准再固定下降

用户本轮修改要求：加工区物料在Z=−100 mm识别和对准，确认后下降至−130 mm夹取；最终下降引起的像素变化不再纠偏。此要求替代此前在−130 mm同高度对准的方案。

## 当前行为

- 受理后先设置2120 µs开口，Z到`z_rough_align`（默认−100 mm）后识别物料DX/DY。
- 前段保持`dx_tol/dy_tol`默认各±1 px、至少3个新帧、200 ms稳定及真实停车要求。
- 确认后停止视觉请求，固定水平位置，下降至`z_proc_place`（默认−130 mm），Z到位即闭爪。最终下降的像素偏移、缺帧或不再返回视觉数据均不阻断夹取，也不提起重新对准。
- 下降前暂停继续原视觉阶段；最终下降中暂停继续原绝对Z目标，不重新请求视觉。仍保留机械限位、驱动故障、到位及停车反馈。
- 保留此前ID8提前分度、2120 µs开口、加工放置空爪连续下降，以及其他持料放置的视觉复核。
- 控制台增加“加工物料已对准，保持水平位置下降夹取”，对准原因改为“在观察高度对准加工物料”。AGENTS.md及现行操作/协议说明同步更新，历史记录保留当时实现。

## 验证

专用回归先在旧代码首次识别高度断言失败，修改后通过。覆盖−100 mm识别、前段出窗不闭爪、±1 px边界、视觉暂停恢复、Z未到位不闭爪、最终下降120/−80 px漂移及无视觉均可夹取、各阶段暂停续接、最终下降续接不依赖相机请求、一次闭爪及入仓库存。检查缺失/颠倒高度在动作前拒绝。

全量固件主机回归通过，控制台日志测试31项通过；独立审查未发现本轮引入的确定错误，审查者单独运行加工取回专用回归通过。Keil编译0错误、0警告。

沿已确认配置检查DAP（序列号7b168f48、SWD、STM32F4、1000 kHz），OpenOCD在探针通信阶段返回`CMSIS-DAP command CMD_INFO failed`，未能识别当前目标，因此未烧录。固件副本及SHA256保存在`.embeddedskills/processed-two-height/firmware.hex`和`artifact.json`；测试、审查、构建及探针日志在同目录。软件验证通过不代表设备已更新，实车精度仍待验收。
