doinbest/Yachiyo/xjx/模版搭建/docs/开发记录/2026-10-13-正式扫码保持90度航向.md

# 正式扫码保持90°航向

## 本次要求

正式比赛到二维码点后取消底盘强制180°转身，扫码与扫码后沿右侧通道向北行驶保持90°。到 `(2100,2100)` 后保持90°横移至 `(1275,2100)`，在那里转为0°，再倒车75 mm到 `(1200,2100)` 原料工位。本批禁止编译、烧录和硬件操作。

## 原因与修改

`chassis_route.c` 的正式 `TaskRoute && scan_qr` 分支原先在通用扫码行驶阶段末尾追加 `qr_scan_turn`、将最终航向改为−90°，并额外累计180°转向时间。下一段沿右通道按−90°倒行，随后原料工位阶段又要求90°，从而产生多余掉头。

本次删除正式分支的扫码转身及对应时间项，保留扫码段速度限制、扫码Y坐标参数与工位交接。正式扫码结束的最终航向由路线剖面保持为90°。`ChassisRouteProfile_BuildTask()` 已有原料区横移、外侧转为0°、75 mm倒车入站阶段，本次仅补充说明，没有改变这些阶段的算法或坐标。

独立右上/右下二维码测试使用的 `QrRoute` 分支继续保留原 `qr_scan_turn`；普通固定路线仍调用原 `ChassisRouteProfile_Build()`。机械臂扫码准备仍使用既有Base参考+35°，本次未修改机械臂或比赛调度的扫码后恢复逻辑。机构Base角度与地图底盘yaw分别管理。

网页 `RouteProfileRunner` 消费C生成的阶段记录，离线 `task_fixed/task_planned` 预览由 `radar_plan_cli.c` 调用同一 `ChassisRouteProfile_BuildTask()`，未找到独立追加正式扫码180°的网页代码，因此没有另写网页转向规则。

## 检查与待执行验证

- `Code/tests/chassis_task_route_test.c` 更新扫码及暂停继续后的目标航向断言为90°，新增固定任务路线和以固定点构成的规划任务路线测试源码，覆盖扫码Y=1100/1200/1300 mm、Base扫码准备只触发一次、扫码点不追加转身、向北保持90°、向西横移至1275、外侧转0°及倒车入站。
- `Code/tests/chassis_task_profile_test.c` 增加扫码点至上方接驳点仅包含90°直行阶段的断言；原料区横移与入站断言仍保留。
- 静态核对正式/独立扫码分支、路线剖面、C预览生成及现有测试调用。差异空白检查按现有CRLF行尾配置执行。
- 按本批明确要求没有编译任何固件或主机C测试，没有烧录、复位、串口发送或硬件探测。新增C测试尚未执行，不能据此声称测试通过；完整比赛连续执行与实车车体包络仍需后续验收。
