doinbest/Yachiyo/xjx/模版搭建/docs/开发记录/2026-10-13-观察位置边界误差修复.md

# 观察位置边界误差修复

实车05:01:17第一件入仓释放并登记后，在返回观察X阶段axis_limit。主机以初始X=-0.009mm复现：保存目标-0.008789mm，返回失败；0mm对照正常。

增加仅用于测量观察/返回位置的边界归一化：在既有pos_tol内的微小越界归到x/z合法端点；范围内保持原值，明显越界和非有限值不掩盖。所有ObserveX/ObserveZ采集点统一使用；运动指令axis_move仍严格校验，并在失败时输出轴、目标、上下限及当前位置。未放宽机械行程。

回归先复现失败再修复通过：X负零点、Z正上限偏差后完成入仓并连续夹第二件；明显越界及直接越界命令仍拒绝。追踪入仓、姿态、普通取放、完整两批生产状态机集成通过。

Keil编译0错误0警告；05:07:42下载校验Verify OK，Application running。未执行实车夹取验收。
