doinbest/Yachiyo/xjx/模版搭建/docs/开发记录/2026-10-13-雷达盘实测转出与收回.md

# 雷达盘实测转出与收回

用户2026-10-12实测确认PD12舵机型号TD-8125MG：1450 μs收回车内、2450 μs转出。要求删除其他快捷值与停PWM功能，保留手动脉宽，并将两点及后续出发前扫描用途写入规则。2026-10-13完成收尾验证。

## 当前实现

- 固件`lidar_servo.h`记录`LIDAR_SERVO_SCAN_PULSE_US=2450`与`LIDAR_SERVO_STOW_PULSE_US=1450`，控制台`lidarservo out/in`分别调用这两个实测值。
- 网页仅保留“转出扫描 · 2450 μs”“收回车内 · 1450 μs”、手动输入及查询；原五档快捷值、红色停PWM按钮、固件off命令/SignalOff接口、浏览器与Python优先停止例外均删除。旧off请求返回格式错误，保留当前输出。
- 手动范围沿用此前授权的500～5000 μs，预填改为1450；上电仍为零脉宽，不自动收回或转出。用户实测超过2800不响应，5000不作为比赛位置。查询仅表示软件输出，不冒充机构到位。
- 将TD-8125MG、2450转出采图、1450收回车内及后续“出发前转出—确认稳定—扫描—扫描完成收回—出发”的机构基线写入AGENTS、硬件基线、地图雷达操作及雷达协议。两点不再标为待实测；自动扫描和比赛衔接不在本轮实现，仍由显式按钮操作。
- 保留既有采图/任务忙限制，避免采集时移动雷达盘；状态查询仍可用。收回也是机构运动，不赋予停车优先级，不解除停车锁定。

## 验证

- 新命令测试先因缺少out/in失败，修改后通过；C控制台覆盖两点数值、任务忙拒绝和off不再改变输出，驱动测试覆盖两点寄存器计数及手动边界。
- 网页Node全套588项通过；Python串口桥接45项通过，包括out/in为普通动作、停车锁定禁止动作且查询允许、off没有优先权限。
- `lidar_servo_test`及`arm_console_host_test`通过；Keil template编译0错误、0警告，未改IOC/时钟/EIDE或增加工程模块。
- 本地浏览器确认两个按钮、手动输入1450及查询，旧按钮不存在；页面接入既有服务后本页TX为0，没有实车动作发送。截图`.embeddedskills/tests/lidar-poses.jpg`，回归日志`lidar-poses-web.log`与`lidar-poses-bridge.log`位于`.embeddedskills/tests/`。

## 生效

本轮未烧录。需烧录新主车固件、退出旧本地服务后重启并刷新网页；实际串口由用户选择，不重放旧动作，无需重开香橙派程序。实测机构位置由用户确认，软件通过不表示新增命令已上板或整套扫描出发自动流程已验收。
