doinbest/Yachiyo/xjx/模版搭建/docs/开发记录/2026-10-14-底盘独立余弦运动测试.md

# 底盘独立余弦运动测试

用户需要独立验证当前加速度控制下的直行等运动，无需先执行扫码和取放。

新增 `chassis test <forward_mm> <left_mm> <speed_mm_s>`，按开始时的车头把位移换算到地图坐标，复用普通路线 `ChassisMotion_MoveTo`。保持现有K=200、短距离降峰值、反馈制动和末端判定；不改变驱动档位。合位移最大3000 mm，速度10～5000 mm/s，超时按距离和速度计算。

底盘页面置顶单段测试卡片：八方向、默认500 mm/1000 mm/s，提供当前位置建立测试参考和状态查询。原定时运动折叠保留。当前参考可复用，建立测试参考显式替换地图定位；不是重置IMU，也不需要跑到地图起点。地图碰撞规划不参与该单段测试，用户在空旷区域按实际距离进行测试。

新增回归覆盖身体坐标换算、斜移合距离、参数边界、低速长段预算、任务与工位占用拒绝、页面被动加载及停车锁。现行主车说明、系统与底盘协议及操作手册同步。

验证与编译：固件主机完整回归通过；网页621项测试通过；Keil Target template编译0错误、0警告，Flash 305908字节、RAM 189872字节。构建日志位于 `.embeddedskills/build/chassis-single-20261014/`，测试日志为 `.embeddedskills/tests/chassis-single-20261014.log` 与 `chassis-single-web-20261014.log`。

烧录与实车：沿用已确认探针7b168f48、SWD、stm32f4x、1000 kHz执行OpenOCD检测，返回 `CMSIS-DAP command CMD_INFO failed`，未建立目标连接，未烧录。保留 `.embeddedskills/build/chassis-single-20261014/firmware.hex`，SHA256 `a954c0c87fe44c7a1d6a959f798ac80da6c567d2dabae2538f8bbb11c13c40ab`；探针结果见同目录probe.json。未发送实车运动指令，完整审查与实车结果待后续轮次。
