doinbest/Yachiyo/xjx/模版搭建/docs/开发记录/2026-10-14-底盘页精简与雷达页面命名纠正.md

# 底盘页精简与雷达页面命名纠正（2026-10-14）

## 本次需求与确认

用户授权落实此前底盘页的精简建议，并纠正雷达审查中的F1分类：雷达前期曾在F1单片机验证，参考代码已经放在reference，当前正式STM32程序只有F407。

此前审查建议“雷达建图明确标为F1诊断”不符合当前工程定位，已在[原审查记录](2026-10-14-控制台全页审查与冗余分析.md)中撤回并解释。

## 调用链核对

- 网页实车监控使用`radar …`，雷达建图页使用`RadarHostClient`发送`radar host …`；二者使用同一个共享串口服务。
- F407的`radar_console.c`分派`host`到`RadarHostConsole_Command()`，主车Keil清单包含`radar_console.c`、`radar_host.c`和`radar_host_console.c`。
- `current`及`f1_host`分别是同一F407固件中的两套配置/结果接口。`f1_host`是历史协议及快照标识，不能据此判断为另一份正在运行的F1固件。
- 本轮保留协议标识、导出格式、历史安装坐标、页面既有算法和操作命令。

## 实施

- 底盘主表单合并方向、IMU要求及时间说明，动态时间只显示一次；输入、范围及发送语义保持原有实现。
- 整车运动测试、原地转向、航向保持、地图位移及地图位姿表单使用已有紧凑样式，原始命令及复制按钮放进“查看指令”。执行按钮按动作明确命名。
- 四轮快照、高级运动与驱动复位后恢复保留原有分组，路线执行继续位于地图页。
- 雷达建图页内标题从“F1雷达诊断与对照”改为“雷达建图与诊断”，明确由当前F407固件完成15圈采集；顶层“雷达建图”名称保留。
- 同步控制台README、地图模块手册及审查记录，解释F1历史命名与当前F407接口的关系。

本轮只调整网页展示和说明，没有修改固件、串口后端、指令构造、参数值、机械动作或任务调度。

## 验证

- 执行当前全部网页Node测试文件：610项通过，0失败。日志在`.embeddedskills/review/chassis-layout-20261014-node.txt`。
- 浏览器在1280×720检查底盘主表单、高级运动折叠和雷达建图标题；底盘命令预览仍为`chassis run 0 0 0 1000`，仅输入展示与指令展开方式改变。
- 检查时共享串口已由原服务连接，本轮仅浏览与展开页面，网页发送计数保持0；没有发送查询、运动、停车、标定或参数写入。
- 界面截图：`.embeddedskills/review/chassis-page-20261014.jpg`、`.embeddedskills/review/radar-page-20261014.jpg`。
- 本轮涉及文件通过`git diff --check`；产品未提交修改保留。
- 无固件构建、烧录或实车动作验收。网页刷新即可加载；本次未修改服务端，不需为此重启串口服务。
