doinbest/Yachiyo/xjx/模版搭建/docs/开发记录/2026-10-14-路线直线余弦加减速K200.md

# 路线直线余弦加减速K200

## 需求与实现

用户确认沿用反馈到点，引入余弦加减速，长直线K=200，短距离自动适配。默认路线速度仍1000 mm/s。

- 在原chassis_motion中独立实现半余弦起步，T=2K ms=400 ms；没有移植开源计时跑图或改变电机档位。
- 短段峰值为min(请求速度, 可用距离/(T+响应时间))；加减速合计名义距离peak*T。余量采用现有半个位置容差；响应时间保留0.25 s。末端Kp、工位限速、纠偏及三组停车反馈保留。
- 减速上限反解余弦减速剩余积分，再加v*delay；delay取驱动响应加定位组/轮速/位置最大反馈年龄，额外考虑实测速度大于指令的响应余量。因此末端实际速度由反馈制动包络、位置闭环共同约束，不承诺实车恰好400 ms停稳。
- 连续转弯保留原300 mm/s²向量变化率和角速度/跟随约束，退出弯道从当前速度接入；暂停重启与停车纠偏建立新曲线。
- 新增chassis_cosine_distance_test并接入固件回归；修改原距离测试的起步预期。

## 参考来源与许可核查

参考用户指定GongXun2025的K含义和通用半余弦数学公式，来源版本19cb6a69ba3580465f58ab9f204dbaf33878c969，链接：https://github.com/zpclyn/GongXun2025/blob/19cb6a69ba3580465f58ab9f204dbaf33878c969/控制代码/CarBody/Chassis.c 。该版本文件树未发现LICENSE/COPYING，不复制其代码；本轮基于现有half_cosine和反馈控制独立实现。硬件采用本车80 mm轮径、1:1传动及现有运动学，不套用对方RPM路线参数。

## 必要验证

新增测试先在旧实现失败（100 ms速度曲线采样），再在新实现通过。原带延迟模型的1750 mm/1000 mm/s由6.62 s变为4.42 s；900 mm/500 mm/s由5.02 s变为4.22 s；212 mm/1000 mm/s由3.12 s变为2.62 s；75 mm/50 mm/s由2.62 s变为2.82 s。数值包含仿真停车取证，只代表该模型，不是实车承诺。

连续曲线220 ms延迟用例曾暴露定位组年龄未计入制动，已补入并通过三条曲线、延迟及暂停续接回归。

完整固件主机回归通过（101个GCC构建的C测试程序及脚本检查），日志`.embeddedskills/tests/cosine-suite-20261014.log`。Keil工程`Code/template/MDK-ARM/template.uvprojx`、Target `template`构建成功，0错误0警告；日志`.embeddedskills/build/cosine-k200-20261014/template-template-build.log`。

OpenOCD用既有CMSIS-DAP配置、序列号7b168f48、SWD 1000 kHz检测；识别到VID:PID=0xfaed:0x4873，但CMSIS-DAP CMD_INFO失败，未取得目标连通证据，未执行烧录。检测日志`.embeddedskills/build/cosine-k200-20261014/probe.json`。

构建产物已保存为`.embeddedskills/build/cosine-k200-20261014/firmware.hex`，SHA256 `5aef09c0abca2508c6b252363df6353657350eebc68c20788c7f47207e17fa0a`。设备仍不能视为已运行本次修改。
实车带载、打滑、停车误差与整场耗时：未验收。全面代码与现行文档审查安排在交付后独立轮次。
