doinbest/Yachiyo/xjx/模版搭建/docs/开发记录/2026-10-14-近准心漏检等待与加工区900mm.md

# 近准心漏检等待与加工区900 mm

用户要求：近准心短时漏检时保持停稳、等待新帧，避免每次重发识别；恢复后仍凭新鲜坐标确认对准。地图中心到加工区采用900 mm。

## 实现

- 静态视觉近准心或settle发生短漏检，沿原停车流程确认机械反馈，保留原B2识别流。独立保存最后有效坐标时刻，无效帧不能续期；持续无有效坐标达到loss_grace_ms才触发原单次重获。保留原等待超时、实际停稳确认、人工暂停和通信恢复。
- 恢复需停稳后3次新鲜有效坐标，之后重新累计对准稳定证据，不能使用旧坐标触发下降。动态追踪未修改。
- 两批加工目标从(1200,350)改为(1200,300)，距中心(1200,1200)900 mm。固定比赛路线保持Y425外侧转向，靠近从75增至125 mm；退出加工区先保持作业朝向到Y425，再转向。雷达工位表、固定路线表及网页预览同步；绕障途经点保留。

## 验证

- 新增近准心多次短漏检不重发、连续有效帧恢复、持续缺失触发一次重获的回归。新增900 mm目标及外侧进出站断言。先确认新增用例在原实现失败，再完成修复。
- 13组相关C测试通过：grab_grace、grab_task、grab_stack、grab_station_align_height、grab_held_place、mission_grab_integration、grab_mission_pause、grab_bus_recovery、chassis_route_profile、chassis_task_profile、chassis_task_route、chassis_route_continuity、test_radar_map。比赛集成覆盖两批、暂停与姿态并行；雷达几何检查301988项通过。
- 网页路线24项Node测试、离线雷达服务26项Python测试通过。
- 本轮证据保存在 `.embeddedskills/vision-gap-proc900-20261014/`。编译与当前DAP识别/下载结果见下方补记。

## 实车范围

本轮不发送运动命令、不做实车运行验收。900 mm是地图目标距离，不代表里程计或实际车体包络已校准。示例300 mm方形车体在Y300时靠加工白区边界的理论间隔为0 mm，实际外框、定位误差和进出站转向仍以实物验收为准。

## 编译与目标识别

Keil template构建成功，0错误、0警告。当前DAP串号7b168f48经SWD识别Cortex-M4，DBGMCU IDCODE=0x10076413、Flash=1024 KB，与F407工程一致。固件SHA256为97001698487c377197ee6afa9bb92917592b0f8e4569c8a2f1a00bb8df56fbaf。

04:44 当前DAP下载成功，OpenOCD返回programmed=true、verified=true。未启动比赛或实车动作测试，现场效果待验收；下一轮按用户审查指令检查代码与现行文档一致性。

## 后续审查（只读运行逻辑）

- 审查范围限定本轮差异，对照修改前快照；核对Camera有效/无效快照、恢复序号与时间、人工暂停/继续和总线恢复，未使用历史未提交改动作为本轮新增问题。
- 固定两批路线均在Y425转至180°后靠近Y300，退出至Y425后再转向。补充执行级测试覆盖退出途中暂停/继续，续接同一绝对目标，无重复位移。mask0雷达规划保持既有(1200,350)等绕障途经点，不将固定路线的125 mm退出段强加到不同规划路径。
- 复跑grab_grace_test、grab_mission_pause_test、grab_bus_recovery_test通过；新增离站暂停探针通过。证据位于同目录日志下的review/。
- 文档将“每轮只成功重发一次”澄清为“最多一次，短漏检可不重发”；路线头文件旧Base90°注释改为车体工位航向0°/180°/90°。仅文字调整，没有改运行逻辑，没有重新构建或烧录，没有发送串口/运动命令。
- 实车到站位置、实际外框余量和现场视觉连续性仍待验收，软件审查不替代实测。
