doinbest/Yachiyo/xjx/模版搭建/docs/开发记录/2026-10-15-IMU原生标定审查.md

# IMU原生标定审查

日期：2026-10-15。范围为当前HWT101 I2C驱动、原生零偏标定状态机、控制台及网页入口、底盘角度资格与定位调用链。检查了已有工作区差异并保留；本轮未修改固件或网页实现，未发送实车命令、复位、烧录或部署。

## 标定流程核对

当前 `imu cal start` 实际执行：解锁 `0x69=0xB588` → `WORKMODE 0x48=1` → 静止20秒 → 重新解锁并写 `0x48=0` → 回读模式和零偏 → 解锁并写 `CALIYAW 0x76=0` → 从后续新样本起验证30秒 → 通过后解锁并写 `SAVE 0x00=0` → 回读模式和零偏。寄存器步骤至少间隔100 ms，总时间略长于50秒。

I2C发送寄存器地址和低字节在前的两个数据字节，不发送UART帧头；与[维特官方SDK的I2C分支](https://github.com/WITMOTION/WitStandardModbus_WT901C485/blob/main/ESP32/ESP32_sdk/mian/wit_c_sdk.c)一致。[厂家HWT101CT FAQ](https://witmotion-sensor.com/products/hwt101ct-485-military-grade-z-axis-inclinometer-mems-tilt-sensor-built-in-highly-integrated-crystal-gyroscope-rotation-angle-at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)支持 `0x48=1`、20秒、`0x48=0` 流程；本车版本适用性仍以已有用户协议及实际寄存器读回为依据，不把其他接口或型号的说明当作实车兼容验收。

验证使用角度展开及线性拟合，阈值仍为漂移绝对值≤0.01°/s、残差RMS≤0.1°、最大采样间隔300 ms。STM32不扣除拟合漂移，不加载外部Flash旧偏置。验证PASS、保存请求、读回成功及实物断电保持分别解释；`persistent=UNTESTED`不代表已完成断电验收。取消和异常恢复最多尝试三次正常模式写入及回读，保存失败不授予控制资格。标定全过程的整车静止仍由用户保证；软件任务空闲不能证明车体无外力或振动。

## 代码发现

确认一项P1集成问题，登记为[P002](../待解决问题.md#p002--imu短暂异常导致地图锚点及原点丢失)：标定模块运行期短暂失联能恢复资格，但 `heading_read` 在资格暂不可用时清除地图锚点，定位模块随后清除原点。资格恢复后不会恢复地图定位。问题属于既有底盘调用链，当前未提交改动没有引入该路径；标定状态机自身的两帧资格恢复测试不能覆盖此问题。

复现使用真实 `chassis_motion.c`、`chassis_localization.c`、`chassis_observer.c`、`chassis_model.c`，借用现有硬件fixture注入资格失效与恢复。建立原点后各标志为1；失效后全部为0；恢复后仅heading为1，anchor/origin/feedback仍为0。证据保存在 `.embeddedskills/tests/imu-native-review-20261015/anchor-loss.c` 和 `anchor-loss.log`。

原生20秒流程、I2C字节序、正常模式恢复及验证后保存流程未发现新的可确认代码缺陷。该结论限定为源码和主机验证，不代替模块实际标定效果或断电保持验收。

## 文档同步

系统与底盘协议补全原生标定后归零及保存的实际步骤；连接与恢复手册区分资格恢复与地图定位恢复。保留现行短暂异常应保留有效定位的要求，并明确当前P002未修复。历史开发记录不覆盖原事实，新增本记录并登记问题。

## 软件验证及实车状态

本轮重新编译并运行以下4项主机验证，全部通过：`hwt101_i2c_test`、`hwt101_calibration_test`、`arm_console_host_test`、`hwt101_upload_test.py`。运行命令通过 `Code/tests/run_firmware_tests.py` 的 `build_test` / `run` 入口，追加输出到 `.embeddedskills/tests/host-tests.log`，没有清空旧日志。额外最小用例成功复现P002，未修复。

未构建Keil、未烧录、未进行实车寄存器写入、50秒静止标定或模块断电测试；本轮审查不宣称这些验证通过。

## 后续实车日志补充：报错后重启角度恢复

用户随后提供01:32:11验证入口报错、01:36:08状态查询及01:41:30重启后PASS截图，描述多次出现“标定报错但重启后角度恢复”。本轮通过已运行本地控制台的只读 `GET /api/status` 和 `GET /api/events` 取回完整历史，未发送串口命令；110条IMU及启动相关事件快照保存为 `.embeddedskills/tests/imu-native-review-20261015/incident-events.json`。以下时间按Asia/Shanghai解释，运行固件启动报告为 `Oct 15 2026 01:23:16`。

| 时间 | 直接证据 |
|---|---|
| 01:31:31～32 | 上电5秒验证失败：`drift_dps=-0.05973`、`rms_deg=0.0021`、51样本、最大间隔100 ms、无本轮I2C错误；零偏为 `0xFF7C`。 |
| 01:31:43 | `imu cal start` 受理，返回 `cal_ms=20000 verify_ms=30000`。 |
| 01:31:48、01:31:53 | 状态为 `CALIBRATING`，已经运行5秒及10秒。依据当前状态机，该状态说明启动写入及WORKMODE=1回读已成功，不能把后续入口报错解释为这次原生流程完全没有执行。 |
| 01:31:54 | 最终失败 `normal_mode_unconfirmed HAL=2`、`elapsed_ms=10395`、`samples=0`、`save_state=NOT_REQUESTED`。当前HAL定义中2为HAL_BUSY；该HAL/原因已经是退出模式恢复失败的结果，不保留第一笔通信失败的完整现场。时序诊断中 `imu_read current_ms=6`，没有证据表明发生超过300 ms的主循环阻塞。 |
| 01:32:07、01:32:11 | 后续 `imu verify` 在入口报 `imu_not_fresh`，未发送归零、未启动新验证。其全零诊断属于新请求状态，不能替代01:31:54的原始失败现场。01:32:08用户发送过取消恢复请求。 |
| 01:36:08 | `ready=0 fresh=0 updates=3472 last_ms=36019 i2c_errors=7 registers_valid=0`：通信仍未恢复，只保留旧角度缓存。 |
| 01:40:09 | 再次原生标定请求在入口失败，未开始。 |
| 01:40:16、01:41:17 | 出现同一固件的新启动报告。事件中没有对应 `system reset` TX；用户随后确认本次为整车断电再上电。 |
| 01:41:30 | 新上电5秒验证PASS：51样本、`drift_dps=0 rms_deg=0`，零偏读回变为 `0xFF47`；仍未请求SAVE。 |

本次可确认：第一次原生标定实际进入过模块模式，之后的正常模式恢复及固件流程失败；整车断电再上电后模块读回零偏发生变化，静止输出通过5秒检查。用户同时确认实际转动后的测得转角恢复准确，这属于本次用户实物观察，未提供定量转角对照。该证据支持内部参数变化在这次整车断电后仍可观察到；不证明完成了完整20秒获取、30秒验证及固件SAVE流程，也不能据此确定模块内部的保持机制或完整动态精度范围。

当前应进一步区分：内部获取中已产生零偏变化、异常后模块是否继续保持获取模式，以及STM32 I2C状态/外设是否卡住。源码目前只有每秒重新探测，没有I2C局部重初始化或线状态诊断；`HAL_BUSY`可以来自句柄状态、锁或总线BUSY，日志尚不足以确定是哪一种。用户确认整车断电，因此本次恢复同时涉及STM32及模块重启，不能把原因单独归到主控软件状态。原生获取对模块的作用、模式退出失败及通信恢复应联合核查；本次实物测角恢复不等于固件流程通过。该调查与P002定位锚点问题分别处理，本轮未实施修复。
