doinbest/Yachiyo/xjx/模版搭建/docs/开发记录/2026-10-02-STM32主车固件精简.md

# STM32 主车固件精简（2026-10-02）

本轮按用户确认的计划清理未使用模块与兼容接口，保持现有运行行为。没有烧录、复位、串口发送或实车操作。

## Git 检查点与提交

分支为 `codex/usart1-dma-console`。修改前已将目录迁移、参考代码导入及已有开发修改一起保存为独立检查点；没有将被忽略的日志、缓存和构建输出强制加入 Git。

| 阶段 | 提交 | 内容 |
|---|---|---|
| 清理前检查点 | `dd469b575c71d836a7069b29aab756a2611c7b51` | `chore: checkpoint before firmware cleanup` |
| 第一批 | `36c08bd` | 删除未使用的 LED、延时和集中头文件，仅同步 Keil 文件清单 |
| 第二批 | `5b5aa2a` | 删除未使用的 Camera/ArmVision 读取接口及机械臂回调转发，迁移相关测试 |
| 第三批 | 按 `docs: record firmware cleanup and parameter storage boundaries` 查询 | 同步参数保存说明、工程状态和本记录 |

## 实际删除范围

- 活动固件删除 `Hardware/led.c/.h`、`System/delay.c/.h`、`Core/Inc/headfile.h`，Keil 移除五个对应条目。没有其他源码包含这些头文件或调用这些模块。
- 删除机械臂三个未使用的 UART5 回调转发接口及声明。主程序原本已直接分发到 MotorBus；中断文件只修正旧接口注释，未改执行逻辑。
- 删除 `ArmVision_DataGet`、`ArmVision_DataPeek`、`Camera_DataGet` 及声明，同时删除仅用于旧接口的两个新数据通知标志。
- 保留 ArmVision 最近坐标及进度输出，保留 Camera 共享快照、全局收帧序号、时间、有效标志和诊断计数。
- Camera 测试通过快照验证原有协议场景，并核对两个消费者重复读取同一帧不会消耗数据；删除其他视觉测试的旧接口桩和旧读取计数断言。

Emm 驱动、Flash 驱动及读 ID 诊断、IOC、外设初始化、主循环调度、控制算法与默认参数全部保留。ArmVision、MaterialVision、GrabTask 和仍被测试使用的底盘运动接口没有整块删除。

## 参数保存的现状

| 参数来源 | 生效与保存方式 |
|---|---|
| 已烧录固件中的宏和初始化常量 | 决定上电默认值；修改源码后需要重新构建、烧录 |
| `grab set`、`config <axis> ...` | 修改 STM32 RAM；复位/重新上电恢复固件默认值 |
| 网页输入预填值 | 只决定输入框内容，用户执行命令后才修改设备 RAM |
| 网页保存的路线速度 | 保存于本机浏览器；不自动修改当前运行路线，也不自动发送运动命令 |

当前没有这些控制台参数的 Flash 保存与启动加载流程。保留 W25Q128 驱动不等于参数已掉电保存；原生 IMU 保存和驱动器自身配置属于独立机制，本次未调整。

## 验证与资源变化

清理前、第一批和第二批均运行完整固件主机回归，结果为 PASS；Keil Target `template` 三次构建均为 0 错误、0 警告。回归包含 B2 拆包/粘包、校验/无效目标、请求重启/缓存清理、坐标过期、多消费者快照、UART5 总线/恢复、机械臂、抓取/停车/回零、视觉任务、OLED 和 Flash 诊断。

第一批验证 Keil 清单中的全部 98 条文件路径有效，XML 对比仅删除五个文件条目，其他工程设置保持一致。保护哈希保存于 `.embeddedskills/logs/firmware-cleanup/protected-baseline.json`：35 个基线文件中，只有计划内删除的集中头文件和只修正注释的中断文件发生变化，其余 33 个文件逐字节一致。

| 链接报告项目（字节） | 清理前 | 第一批后 | 第二批后 | 最终变化 |
|---|---:|---:|---:|---:|
| RO（代码及只读数据） | 137712 | 137712 | 137696 | −16 |
| RW（初始化数据及零初始化数据） | 42448 | 42448 | 42448 | 0 |
| ROM（含压缩初始化数据） | 138344 | 138344 | 138332 | −12 |

未使用函数此前大多已被链接器剔除，删除源码主要降低维护负担。保留 Emm 驱动，其 1024 字节 MMCL 缓冲区仍在；两个旧通知标志删除后，链接报告的 RAM 总量因布局对齐没有变化。不据此声称实车性能提升。

EIDE 按用户要求完全不修改、不构建；其旧清单仍引用已删除的模块，也保留原有 SPI 文件缺项，不将其描述为已同步或可用。实车启动、运动和显示仍需独立验收，软件测试与编译不代表已完成实车验证。

日志和三个阶段的链接报告保存在 `.embeddedskills/logs/firmware-cleanup/`；既有日志未删除。当前 HEX/AXF 仅为本地构建产物，未下载到硬件。

## Diff 排查与回退

查看整个精简范围：`git diff dd469b5..HEAD -- Code/template Code/tests AGENTS.md README.md docs Code/upper-computer-web/local-car/README.md`。查看单批改动可用 `git show 36c08bd` 或 `git show 5b5aa2a`。

需要回退时先保存随后新增的工作，再按需要执行 `git revert <精简提交>`；撤销全部精简时按第三批、第二批、第一批的顺序回退。保留检查点与之前的开发历史，不直接使用 `reset --hard`。
