doinbest/Yachiyo/xjx/模版搭建/docs/开发记录/2026-09-12工创开源HWT101零偏校准核查.md

# 工创开源项目 HWT101 零偏校准源码核查

核查日期：2026-09-12。仅分析源码，没有修改本车固件，没有向实物发送指令。

## 结论

用户提出“先检查 HWT101 模块内部零偏校准”的方向应当优先验证。之前本车的 `imu cal start` 是 STM32 对模块输出角度拟合漂移斜率，再进行外部补偿；保存到 W25Q128 的也是这个外部补偿值。它没有完成用户提供的官方“进入零偏获取—静止等待—恢复正常模式”流程。

本轮从先前参考项目中重点核查了六套直接使用 HWT101 的工程，并补查两套邻近项目。发现两套确实包含 `0x48` 零偏获取实现，其中 `2025GongChuang_AGV` 具有可追踪的启动、22 秒计时、恢复正常模式调用链。其余几套主要做起始角度归零、角度解析和航向 PID。

两个模块都漂移，使共同的配置、校准状态及测试环境成为优先检查对象，但不能仅凭此确定唯一根因。源码能证明作者编写了哪些步骤，不能证明本车模块版本一定相同，也不能替代实物校准前后测试。

## 1. 最有价值的参考：Thirtynine3939/2025GongChuang_AGV

- 核查提交：`f1fbab3605f4941fdc14a13d9380aa48700a4b87`。
- [原始下位机源码压缩包](https://github.com/Thirtynine3939/2025GongChuang_AGV/blob/f1fbab3605f4941fdc14a13d9380aa48700a4b87/程序/下位机/Chassis_v2.0.zip)。本轮实际下载并解压检查，不是根据 README 推测。

压缩包内路径均相对 `Chassis_v2.0/`：

| 文件位置 | 实际行为 |
|---|---|
| `Drive/Source/hwt101.c:23–30` | 分别定义解锁、角度归零、保存、重启、`FF AA 48 01 00` 零偏获取及 `FF AA 48 00 00` 正常模式命令 |
| `Drive/Source/hwt101.c:46–57` | `ZerobiasCal_Start(time)` 发送零偏获取命令，记录起始秒数、等待时间，启动 TIM10 |
| `MY/main.c:71–73` | `BTN_ZEROBIASCALI` 事件调用 `ZerobiasCal_Start(22)` |
| `Drive/Source/task.c:140–198` | 实体按键也能启动或中止校准；完成后有角度归零和 OLED 提示 |
| `Drive/Source/task.c:200–221` | 周期任务检查 elapsedSeconds；到期发送正常模式命令，停止计时并标记完成 |
| `Drive/Source/task.c:104` | 校准计时处理函数实际注册到任务调度表 |
| `MY/main.c:48–49` | 主循环实际运行任务处理和按键扫描 |

其核心流程可以概括为：

```text
用户按键
  → 向 HWT101 发 0x48 = 1
  → 定时等待 22 秒，主循环继续运行
  → 向 HWT101 发 0x48 = 0
  → 标记流程结束，重新设定航向起点
```

这是模块内部校准，不是 STM32 计算 `yaw - bias × time`。普通角度置零 `GyroYaw_SetZero()` 使用另一条 `0x76` 命令，与零偏获取分开。

需要保留的验证边界：

- 校准结束路径没有显式发送 `save_settings`；保存命令出现在初始化配置流程中。不能据此声称此次校准结果已经掉电保存。
- 开始和结束校准函数本身没有各自重新解锁；初始化阶段有解锁。是否需要重新解锁，应以手中版本的协议为准。
- 发送封装额外追加回车换行并延时 200 ms；这是项目作者的封装方式，不应直接作为本车 I2C 写寄存器格式。
- “等待结束”只是流程完成标志，没有计算校准后的静止漂移率，因此其完成提示不是精度验收结果。
- 上电显示等待按键，不能把它描述成每次上电都自动执行内部校准。

## 2. 有内部校准入口但流程不完整：enginer-train

原参考名称为 `lzw1996145/enginer-train`，当前 GitHub 重定向到 `Ycn115/enginer-train`。

- 核查提交：`8f2f08e42ac95fafdfdb0e51af525893c98ff47b`。
- [HWT101 驱动](https://github.com/Ycn115/enginer-train/blob/8f2f08e42ac95fafdfdb0e51af525893c98ff47b/Drivers/Hardware/HWT101.c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)。

`HW101_adjust()` 的实际顺序：解锁，等待 1 秒，发送 `FF AA 48 01 00`，连续十五次等待 2000 ms（共 30 秒），再次解锁，等待 1 秒，发送保存命令。

实际调用链：

- `Drivers/Hardware/serial_task.c:273–275`：屏幕命令 `0xC1` 设置 `turn_self_zero_flag`。
- `Drivers/Hardware/control.c:770–774`：该标志触发 `HW101_adjust()`。
- `Core/Src/main.c:144–145`：启动时调用 `HWT101_Init()`，紧邻的 `HW101_adjust()` 调用被注释。

因此它提供的是手动校准入口，不能说每次上电都会校准。

与用户提供的 FAQ 比较，`HW101_adjust()` **缺少显式发送 `FF AA 48 00 00` 恢复正常模式**，不能当作完整标准流程照搬。其他实现问题包括长时间阻塞、未检查 DMA 发送结果，以及函数最后一次 DMA 使用局部数组但未等待完成便返回。

初始化里的 `0x76` 只是角度归零；配置、保存和重启本身不等于获取新零偏。

## 3. zpclyn/GongXun2025：软件设置航向起点

本轮检查本工作区 `GongXun2025-main/控制代码/` 文件；此前综合报告记录版本为 `19cb6a6`，本轮没有把本地副本重新认证为该提交。

目录提示（2026-10-02）：本地参考项目现已整体移至 `reference/GongXun2025-main/`，以上保留当时路径和核查事实。

- [仓库](https://github.com/zpclyn/GongXun2025)
- `Hardware/HWT101.c:20`：USART2 接收初始化，只配置 PA3 和 `USART_Mode_Rx`。
- `Hardware/HWT101.c:93–96`：`HWT101_AngleCheck()` 更新软件角度基准。
- `Hardware/HWT101.c:158`：输出角度是展开后的 yaw 减去 `HWT101_CheckYaw`。
- `CarBody/Chassis.c:40`：底盘代码也直接更新该软件基准；`CarBody/Chassis.c:79` 等位置将 yaw 用作 PID 反馈。

已检查代码没有通过该 HWT101 串口执行内部零偏获取。减去初始角度可以使当前方向显示为零，但角度若每秒增长 0.1°，归零后仍会以相同速度增长。PID 依赖这个测量，也不会自动识别传感器零偏。

## 4. Wuyanzu-wuhu/gc-stm32F4-：第一帧设为零点

- 核查提交：`a3476a5a309e8676bf9935f51710491cf8c8b057`。
- [HWT101 驱动](https://github.com/Wuyanzu-wuhu/gc-stm32F4-/blob/a3476a5a309e8676bf9935f51710491cf8c8b057/Hardware/HWT101.c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)。

UART4、230400 bps、DMA 接收。第一次收到角度时记录 `Start_Yaw`，以后用 `current_yaw - Start_Yaw` 并处理角度范围，作为相对世界航向。

驱动虽然提供串口发送函数，但在已检查的应用源码中，没有找到内部零偏获取命令及对应执行流程。该减法也是设置初始参考方向，不能消除后续随时间变化的漂移。

## 5. gcs-gold-medal 与 gongchuangsai_MBH：SDK 接收与角度归零

- `yuanxiexie531-glitch/gcs-gold-medal` 提交：`cb1b0299a3083d59ebb767831a2778fe35a53ef7`。
- `cheese-shredded-ice/gongchuangsai_MBH` 提交：`debe55def09374ad147e131f2ee0095412dfcdcd`，同时检查初赛和决赛目录。
- [上游 SDK 扩展](https://github.com/yuanxiexie531-glitch/gcs-gold-medal/blob/cb1b0299a3083d59ebb767831a2778fe35a53ef7/yyb_stm32/imu/wit_c_sdk.c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)
- [派生项目决赛启动流程](https://github.com/cheese-shredded-ice/gongchuangsai_MBH/blob/debe55def09374ad147e131f2ee0095412dfcdcd/电控程序/BMH-决赛/USER/main.c#L290)

`imu_init()` 初始化普通串口协议和维特 SDK、注册回调并扫描波特率。`imu_scan()` 从 SDK 缓存换算角度。

容易误解的函数 `WHT101_ANGLEZCali()` 在 `wit_c_sdk.c:503–510` 只做：

```text
解锁 → 写寄存器 0x76 = 0
```

它是 Z 轴角度置零，不是静止等待约 20 秒的内部零偏获取。

SDK 中存在通用 `WitStartAccCali`、`WitStartMagCali` 等函数，`imu.c` 中对应命令分支被注释。不能把多型号通用 SDK 中的加速度/磁场校准函数当成 HWT101 专用零偏流程。

另一个重要调用边界：上游当前 `USER/main.c:91` 有测试用无限循环，位于 `WHT101_ANGLEZCali()` 调用之前。因此其后正式比赛流程不能描述成当前提交上电必然执行。派生项目把角度归零放进 `car_Start` 等启动函数。两者都没有在已查应用源码中形成 `0x48` 零偏获取流程。

这些仓库未实现该流程，不代表作者没有在上位机中预先校准过实物；源码不能证明这件事。

## 6. 两套邻近项目的适用边界

- `liaojingwu20041031/GX-Intelligent-Logistics-Silver`（`c6359fbadc494e281ec3154aabb898b69419deeb`）：`Core/wc/my_uart.c` 接收 `0D 0A + 24 字节浮点数据 + 0A 0D`，得到姿态和 XY 位置；`Gyro_Init()` 发送单字节 `0x00`。这是该项目的外部姿态/定位接口，不能等同于直接给 HWT101 写零偏寄存器。
- `flamingoTOM/VisionStack-AGV`（`02f5adee7d3d63b1865e6de22aad2abb7a7c4d02`）：公开控制源码含 `JY901` 接口。不能仅凭维特型号相近，用其参数作为本车 HWT101 专用校准依据。

先前综合报告中其他以视觉算法为主的项目，本轮没有逐个重新审计，不能据此宣称所有参考项目均已排除校准实现。

## 7. 对本车的直接含义

当前 `template/Hardware/hwt101_i2c.c` 只有设备探测和读角度，没有给 HWT101 写内部零偏获取模式。`imu cal start`、`corrected` 和 W25Q128 参数保存属于 STM32 外部补偿，不能替代模块内部校准。

应先做一个能区分原因的实物对照，再决定是否保留外部补偿：

1. 分别固定两只模块，在相近供电、上电时长和静止条件下，记录模块原始 yaw 的变化；例如记录 120 秒并计算角度变化/时间，跨 ±180° 时展开角度。
2. 使用与模块固件匹配的官方“自动获取零偏”流程，校准期间全程静止。用户提供的 FAQ 和 `2025GongChuang_AGV` 源码均指向 `0x48=1 → 约20秒 → 0x48=0`。
3. 恢复正常模式后，再记录原始 yaw 120 秒；比较校准前后的漂移率，不用现有外部 `corrected` 作为内部校准效果证据。
4. 根据对应版本协议确认保存要求，再彻底断电重启复测，验证掉电保持。不能只验证 MCU 复位。
5. 模块内部零偏改变后，旧的 STM32 外部补偿值应失效，避免继续自动恢复旧值、形成重复补偿。以后确有残余漂移，再针对校准后的输出评估是否需要额外补偿。

本车使用 I2C2；以上竞赛工程的有效参考是校准时序。`FF AA ...` 是 UART 帧，不应直接塞给 `HAL_I2C_Mem_Write()`。I2C 写寄存器的数据格式、解锁要求和保存步骤仍应依据对应 HWT101 协议确认。

“保存到陀螺仪内部”的合理目标是保存模块自己获取的校准参数。不能把 STM32 拟合出的 `0.11652 °/s` 未经单位、比例、符号和寄存器语义核对就写入某个内部寄存器；这些竞赛实现也没有这样做。

## 核查方式与边界

通过 GitHub API 获取提交和目录，下载相关自研源文件；下载与解压 `Chassis_v2.0.zip`。远端源码临时副本位于 `C:/Users/xjx/AppData/Local/Temp/hwt101-source-audit/`。核查了命令定义、启动入口、手动事件、周期任务和实际调用位置。临时副本不作为本车编译输入。

这份记录修正先前报告中容易混淆的“角度归零/零偏”表述。没有进行构建或烧录，因为本轮没有修改固件；没有验证任何开源车的实测精度。
