doinbest/Yachiyo/xjx/模版搭建/docs/开发记录/2026-09-12步进底盘底层与开源实现对照.md

# 步进电机底盘底层与开源实现对照

日期：2026-09-12。用户已说明 HWT101 内部校准完成。本轮只分析当前代码、参考源码和本地电机手册，不改功能代码，不编译或操作电机。

## 1. 当前控制链

```text
视觉/控制台的运动要求
  → Mecanum_Velocity_Start / Mecanum_HeadingTest_Start
  → 车体前向速度、向左速度、逆时针角速度
  → Mecanum_Wheel_Speed_Calc：四轮线速度
  → 轮径/减速比换算电机 RPM，处理各轮电机方向
  → Emm_V5_Vel_Control：构造 F6 命令
  → UART5 DMA → 地址 1、2、3、4 的电机驱动器
```

驱动器处于闭环模式时，电机自身的位置/速度跟随由驱动器内部处理。STM32 的主要任务是整车运动学、航向修正、路径速度规划及通信；不应直接照搬 DJI M3508 工程里的“STM32 转速 PID → 电流命令”控制层。

电机内部闭环不等于整车位置闭环：轮子准确转动仍可能出现麦轮滑移、轮径误差和车身侧偏。

当前轮号：左前 1、左后 2、右后 3、右前 4；机械臂 5、6、7 与底盘共用 UART5。

## 2. 运动学和单位

当前配置：轮径 100 mm、减速比 1、轴距 150 mm、轮距 250 mm。这里是源码值，不能代替作者实测值。轮径注释仍说明其属于暂定规格。

记 vx 为前向 mm/s、vy 为向左 mm/s、w 为逆时针 rad/s，k=(轴距+轮距)/2=200 mm。

```text
左前 = vx - vy - k*w
左后 = vx + vy - k*w
右后 = vx - vy + k*w
右前 = vx + vy + k*w
电机转速 RPM = 轮缘线速度 / (π*轮径) * 60 * 减速比
```

这套正逆运动学在定义上互相一致，实物还必须满足相应 X 型麦轮安装和正方向约定。电机镜像安装造成的反向，应调整各轮 forward_dir，不要与运动学符号混在一起。

对于当前配置：前进 100 mm/s 约为四轮 19.10 RPM；纯逆时针 0.1 rad/s 时左轮线速度 -20、右轮 +20 mm/s。

开源项目常把 vx、vy、w 直接加减后发作 RPM，w 实际是轮速差修正量。因此不能把那些项目的 PID 系数直接填进本车：本车航向 PID 输入为 deg，输出为 rad/s，然后再乘 k 并换算 RPM。

## 3. 开源项目的实际实现

| 项目与核查位置 | 发送方式与控制组织 | 对本车的价值和边界 |
|---|---|---|
| 本地 `GongXun2025-main/控制代码/CarBody/Chassis.c` 与 `Hardware/StepMotor.c`（2026-10-02 起位于 `reference/GongXun2025-main/`） | 上层修改目标缓存；TIM6 回调轮流发送四轮速度，snF=1，再广播同步；上层有世界/车体坐标变换、航向 PID 和正弦加减速 | 适合参考“计算目标”和“总线发送”分离；不能直接照抄中断里的阻塞等待，也没有保证四轮目标来自同一帧快照 |
| `Wuyanzu-wuhu/gc-stm32F4-`，`Hardware/MC.c:309–333,388–588` | 速度命令 snF=1；四轮发送后同步触发；Chassis_Core 有加速、匀速、减速、转向状态，执行坐标变换和航向控制 | 最接近当前串口步进架构；1 ms 延时与其串口配置相匹配的程度仍需验证，不可机械照抄 |
| `Ycn115/enginer-train`，`Drivers/Hardware/move.c:115–167,206–267` | 四轮速度缓存后同步触发；运动过程中读取四轮位置，根据剩余路程调整速度 | 可以借鉴读取反馈决定运动进度；其长 while、逐轮延时查询不适合直接集成本车主循环 |
| `yuanxiexie531-glitch/gcs-gold-medal`，`yyb_stm32/can_ZDT/yyb_move.c` | CAN 传输；car_move 的四轮速度是 snF=false；按 X/Y 距离的位置运动则 snF=true 后同步 | 说明“使用 CAN”不等于“软件已经同步四轮”；保留运动思想，不替换本车 UART 发送层 |
| `cheese-shredded-ice/gongchuangsai_MBH` | 与上游同源，CAN 步进控制和分阶段动作组织 | 不把同源实现算作独立验证，具体参数与本车不同 |
| `Thirtynine3939/2025GongChuang_AGV`，下位机 `Drive/Source/car.c`、`motor.c` | Car_Move 换算轮速，MotorA/B/C/D_Move 修改定时器 ARR/CCR，输出电机脉冲；不是 UART F6 命令 | 适合借鉴航向/运动任务；底层定时器驱动和轮子布局参数不可直接移植 |

容易误读的两处源码：

- GongXun2025 的 `CarBody/Mecanum.c` 带 M3508、减速比 19 和电流输出，不能与实际步进控制链 `Chassis.c → StepMotor.c` 混为一谈。
- enginer-train 的 `Step_run_acc_dec()` 更新 `Angle_Pid`，随后却把 `Blance_Pid.Out` 传入速度接口。因此只能说它具备相关框架，不能据此断言该函数已经正确使用刚算出的航向修正。

远端文件使用上轮下载的提交快照：gc-stm32F4- `a3476a5`；enginer-train `8f2f08e`；gcs-gold-medal `cb1b029`；gongchuangsai_MBH `debe55d`；2025GongChuang_AGV `f1fbab3`。本地 GongXun2025 副本未重新认证提交。

参考链接：

- [gc-stm32F4- MC.c](https://github.com/Wuyanzu-wuhu/gc-stm32F4-/blob/a3476a5a309e8676bf9935f51710491cf8c8b057/Hardware/MC.c)
- [enginer-train move.c](https://github.com/Ycn115/enginer-train/blob/8f2f08e42ac95fafdfdb0e51af525893c98ff47b/Drivers/Hardware/move.c)
- [gcs-gold-medal yyb_move.c](https://github.com/yuanxiexie531-glitch/gcs-gold-medal/blob/cb1b0299a3083d59ebb767831a2778fe35a53ef7/yyb_stm32/can_ZDT/yyb_move.c)
- [2025GongChuang_AGV 下位机源码包](https://github.com/Thirtynine3939/2025GongChuang_AGV/blob/f1fbab3605f4941fdc14a13d9380aa48700a4b87/程序/下位机/Chassis_v2.0.zip)

## 4. 当前最需要处理的差距

### 4.1 速度模式没有四轮同步，发送仍阻塞主循环

`mecanum_chassis.c:467–519` 每轮发送 F6，snF=0，随后延时 10 ms。第一轮与第四轮命令下发相差约 30 ms，一轮发送包含四次延时，约占主循环 40 ms 以上。HAL_Delay 使用系统 Tick，实际时间还含 Tick 量化及中断开销。

DMA 使字节传输异步，不会让后面的 HAL_Delay 自动变成非阻塞。UART5 115200、8N1 时，8 字节自身线速时间约 0.694 ms，但仍需考虑驱动器处理、应答和帧间隔，不能直接去掉所有延时。

建议方向：固定一组四轮目标快照，按顺序发送 snF=1 的四条命令，完成约定的发送/应答检查和帧间隔后，再同步触发；用主循环中的简单发送阶段替代长阻塞延时。不是简单把参数 0 改成 1 就结束。

本地手册第 37、60 页明确说明同步标志与广播触发。广播作用于总线上所有已缓存同步命令的电机；本车机械臂共用 UART5，所以需要明确整组发送的所有权，以及发送中途失败时缓存命令如何处置。

### 4.2 HAL_OK 不代表电机已收到或到位

`Emm_V5_TxStatusGet()` 记录的是 `HAL_UART_Transmit_DMA()` 启动结果。当前 HAL 实现在 `stm32f4xx_hal_uart.c:1379` 直接保存发送缓冲指针并启动 DMA。

应区分：启动发送成功、发送完成、电机接受命令、电机运动到位。这四者不是同一个状态。

当前 UART5 接收由机械臂模块承接，其请求处理按机械臂轴地址和预期功能码匹配；底盘没有独立的四轮应答/实时位置/到位反馈管理。`Mecanum_IsBusy()` 是软件运动记录，不能证明轮子已静止。

建议先做单轮读状态/读位置，再建立四轮状态缓存，不要一开始就做完整里程计。静态命令数组在同一发送函数被再次调用前也必须确保 DMA 已不再使用；HAL_BUSY 检查发生在组包后，并不能保护已被重写的共享缓冲。

### 4.3 低速整数 RPM 对视觉精调有直接影响

速度接口将 RPM 四舍五入为整数。按代码中的 100 mm 轮径与直驱：

- 1 RPM 对应 5.236 mm/s。
- 视觉精调固定 8 mm/s，换算 1.528 RPM，取整到 2 RPM，即理论 10.472 mm/s。
- 15 mm/s 换算 2.865 RPM，取整到 3 RPM，即理论 15.708 mm/s。
- 低于约 2.618 mm/s 的目标，四舍五入后会成为零。

这些仅是命令量化造成的理论差异，还没有计入加速、滑移。不能只通过继续调视觉 PID 解决。

手册第 81 页提供 Emm 速度 0.1 RPM 输入选项。若决定采用，必须四台驱动器配置一致，并同时调整 STM32 打包比例、范围和读取校验；仅修改一边会产生十倍速度误差。本轮未改变此配置。

### 4.4 航向测试已接原始模块角度，视觉动作还没有

`Mecanum_HeadingTest_Start/Process` 调用 `HWT101_Cal_ControlAngleGet()`，锁定起始角度，按约 100 ms 周期用 P 控制产生角速度，期间检查新鲜度并在异常时结束。当前参数 Kp=0.02、限幅 0.15 rad/s。

`MaterialVision.c:235,254` 仍调用 `Mecanum_Velocity_Start(前向速度,0,0)`，没有将航向误差换算成角速度。因此模块校准完成并不等于视觉搬运已经锁航向。

先验证现有独立测试方向和效果，再接入视觉动作，符合此前作者选择的开发顺序。保留每次启动的静止验证要求，不等于需要每次重新标定。

### 4.5 通用位置接口不能保证组合运动路径

`Mecanum_Move_Control()` 虽然把位移正确换算为各轮脉冲，并同步启动，但四轮都使用同一个 120 RPM 和加速度档位。

例如前进 100 mm、左移 50 mm，四轮路程为 50、150、50、150 mm。同速度启动会使短路程轮先停，执行过程不保持所需的四轮速度比例，不能据此承诺直线斜移。同步开始不等于同步结束。

该通用接口当前未见业务调用；应在启用组合位移前处理各轮速度/加速度规划，或改用按车体轨迹生成的速度控制。纯前后、纯横移等四轮绝对路程相同的情况与此不同。

位置命令 raF=0 按手册表示相对上一目标位置；raF=2 才是相对当前实时位置。动作中途被停止再下发时，两者差别明显，接口名称和使用场景需要明确。

## 5. 本地手册核对出的参数差异

依据：`docs/硬件资料/执行机构/闭环步进电机/ZDT_X42S第二代闭环步进电机用户手册V1.0.5_260527.pdf`。

| 项目 | 代码现状 | 手册依据/处理 |
|---|---|---|
| Emm 命令最高速度 | `MECANUM_MAX_MOTOR_RPM=5000`，驱动旧注释也写 5000 | 第 53、57 页为 0–3000 RPM；应按实物固件确认并统一，协议上限也不是比赛推荐速度 |
| 位置命令脉冲 | 默认 3200/圈 | 第 57 页，在 1.8°、16 细分设置下成立 |
| 编码器配置 | `CHASSIS_ENCODER_COUNTS_PER_REV=16384` | 不能拿它解释 0x36 实时位置：第 72 页 Emm 回包按 65536/圈；X 固件又是另一单位 |
| 反馈换算调用 | `Mecanum_Distance_To_Encoder` 当前仅定义，未见业务使用 | 暂未因此影响速度输出，但后续接反馈之前要区分物理编码器、命令脉冲和协议位置单位 |
| 加速度 | 当前速度控制 acc=20 | 第 53 页这是档位，不是 20 mm/s²；每隔 (256-20)*50μs=11.8ms 改变 1 RPM，acc=0 则直接启动 |
| 到位回包 | 底盘没有管理 | 第 105–106 页说明应答配置 None/Receive/Reached/Both/Other；收到 02 和收到 9F 不同，需按配置决定查询/等待逻辑 |
| 心跳 | 注释把 100 ms 刷新解释为防超时 | 第 38 页说明保护时间可配置；代码定期刷新不证明实物已启用超时停车 |

当前速度逐轮单独限幅，若未来大速度输入导致某轮饱和，四轮比例会改变。届时应采用整组等比例缩放。现在低速测试远未到该上限，此项优先级低于同步和反馈。

## 6. 建议按三个小功能推进

1. **确认单轮底层事实**：四台的固件类型、细分、速度缩放、回包配置，以及实际轮径和方向；实现可读的单轮状态/位置查询。以转一圈核对位置反馈单位。
2. **完善一组四轮速度下发**：固定四轮快照、同步标志、发送完成/回包状态、合理帧间隔和失败处理；协调机械臂共享总线。用低速前进、横移、原地旋转验证。
3. **完善低速与航向**：验证是否启用 0.1 RPM；调通现有独立航向测试，再把同一航向控制过程接入视觉短动作。之后才做距离反馈和组合轨迹。

不要同时更改方向、轮径、速度缩放和 PID；每一步保留一个可解释的实物结果。仅凭开源赛事成绩无法替代本车实测。
