doinbest/Yachiyo/xjx/模版搭建/docs/开发记录/2026-09-27-单件抓取实现与标定.md

# 单件抓取实现与标定

> 状态更新（2026-09-29）：本文 B4 设计与验证结果保留为历史记录；B4 已退出当前固件任务链。现行请求、稳定条件及限制见 [B2 协议兼容恢复](2026-09-29-B2协议兼容恢复.md) 与 [上位机协议](../上位机协议.md)。不再要求部署双协议香橙派程序。

> 当前状态：21:03启动缺项已按文末“任务2完整联调初值”修复。较早段落的“准心/响应尚未代填”是当时状态；当前为明确标记未实测的初始模型，后续以实车反馈调参。

修改前基线：`ee59714`（新PCB联调代码、文档及工程资源快照）。本次实现保留原有16段纯路线与旧物料对准入口，增加独立单件抓取调度。底盘方向、机械臂极性及Base回零点按用户最新确认作为已完成基线。Base在对准和夹取阶段保持工作姿态，提起后自动相对转−180°放置。上电自动执行Z碰撞、X碰撞、Base就近回零。

## 入口与实施顺序

“0 · 测试前准备”现精简为Base、X、Z三行，每轴一个按钮：Base就近回零（`home base near`），X/Z碰撞回零（`home x collision`、`home z collision`），不再放置底盘/IMU、清零或查询控件。先完成位置参考，再填写标定参数。直接放在转盘前测试不要求地图起点，前四段路线联动仍在地图页准备跑图。

网页“视觉物料”的单件抓取区域提供相应操作；串口仍为115200/8N1、空格ASCII命令，不需要手写控制程序。

| 命令 | 行为与终点 |
|---|---|
| `grab start fixed` | 人工水平对准后，检查静止反馈，打开夹爪、Z下降、闭合、提起、Base转−180°、下降放置、松爪、提起，进入hold等待人工验收 |
| `grab start align` | Z到观察高度、X到预备位置，底盘/X共同修正；精定位稳定且水平停止后进入hold，不下降 |
| `grab start pick` | 观察准备、共同对准、水平停稳、下降、闭合、提起，再自动转向、下降放置、松爪、提起，进入hold |
| `grab route <speed>` | speed为路线mm/s；原起点执行前四段，第2段停车后模拟扫码，第4段交给pick；不进入第5段 |
| `grab status` | 路线与抓取状态、缺项、位置、误差、视觉阶段/年龄及停止请求/确认 |
| `grab stop` | 取消自动推进，请求停车，保持夹爪输出与Z使能 |
| `grab set <key> <value>` | 设置单个RAM参数；运行中拒绝修改，不落盘到外部Flash |
| `grab get <key>` | 读取单个参数；未配置返回unset |

`stop_confirmed`记录最近一次停止请求的反馈确认；流程之后可能进入Z下降/提起，须结合当前state理解，不能单凭该字段认定所有机构一直静止。`elapsed`为本次任务耗时。

`hold`只表示取放或对准流程结束，仍保留机构所有权；正确抓取数不自动增加。人工检查后显式停止，确认停车，再进行下一次调试。闭合后的故障也不自动松爪或失能Z。

先进行fixed的机械动作验收，再调align，随后pick，最后route。所有命令均为操作说明，本次代码工作没有向硬件发送它们。

## 参数、单位与缺项

同日现场初测：用户确认采用电机1080°对应Z下降20 mm，换算为480命令脉冲/mm；最高点反馈 `en=1 reached=1 raw_units=-4` 接近计数零点。最初预计下降约100 mm，后续用户实测确认每次顶部回零后下降80 mm（8 cm），网页Z夹持位置现预填−80 mm，显式发送后生效。任务1增加运动配置、开爪、毫米点动、位置查询和参数集中配置；初测比例仅预填到该点动输入，点击设置才发送至MCU。标尺精度、实际夹持高度与抓牢情况后续分别验收。

现行默认值：启动时载入pos_tol=1 mm、stop_speed=2 mm/s、feedback_ms=2000、close_ms=500；上电Z回零成功后载入z_ppm=480、z_min=−80、z_max=0、z_grab=−80、z_lift=−40、z_place=−60。网页同步预填这些数值，预填不代表设备读回，未知视觉标定参数留空。配置只存在本次STM32运行的RAM，复位后重新载入默认值。位置参考须对应本次驱动器实际计数零点：`origin`保存机械回零点与`zero`清当前位置计数是不同操作；不能在测好位置后随意改变计数零点。Base已有零点保持，不为本流程重新执行zero all。

X/Z执行zero或home后，软件撤销对应轴的边界/位置配置，保留已知机械比例；Base发生位置运动或回零后撤销观察准心与像素响应。重新建立相应参考后再填写这些参数。单独保存origin不会触发运动或撤销位置配置。

| 参数 | 单位与意义 |
|---|---|
| `x_ppm`, `z_ppm` | 位置命令脉冲/mm，正数；由机械位移测得。命令3200脉冲/圈，反馈65536单位/圈分别换算 |
| `x_min`, `x_max`, `z_min`, `z_max` | 相同参考零点下的机械可用边界，mm；Z正向上、X正向外 |
| `x_pre` | 观察时X预备位置，mm |
| `z_observe`, `z_grab`, `z_place`, `z_lift` | 观察、夹持、放置和提起高度，mm；提起高度必须高于夹持及放置高度，均在边界内 |
| `pos_tol` | 轴到位允许误差，mm；还须reached、使能、反馈新鲜及位置稳定 |
| `stop_speed` | 允许静止判定的速度阈值，mm/s；不能仅检查目标速度为0 |
| `close_ms` | 500 us松开及800 us带物料闭合共用的等待时间，ms |
| `feedback_ms`, `age_ms` | 机械反馈、视觉数据允许最大年龄，ms；结合实际吞吐设定 |
| `timeout_ms`（已删除） | 后续用户明确要求取消阶段耗时退出；不再作为配置项，底层通信/上电回零超时独立保留 |
| `accel` | 协同速度变化上限，mm/s²；不等同于Emm加速度档位 |
| `travel_mm` | 视觉阶段相对起点允许的车轮行程范围，mm |
| `lead_mm` | X目标领先实测位置的最大距离，mm |
| `ref_u`, `ref_v` | 观察高度下可可靠抓住时的圆心准心，640×480图像像素 |
| `dx_tol`, `dy_tol` | 由实际夹持容差确定的误差半窗，像素 |
| `j00`, `j10` | 底盘前进每毫米导致的DX、DY变化，px/mm |
| `j01`, `j11` | 底盘左移每毫米导致的DX、DY变化，px/mm |
| `j02`, `j12` | X伸出每毫米导致的DX、DY变化，px/mm |
| `retarget_ok`（已删除） | 原人工确认开关，后续按用户要求取消；协同任务不再要求单独X轴测试或设置此开关 |

fixed需要Z换算/边界/抓取、放置与提起位置、到位容差、静止速度、闭合时间及反馈年龄，上电回零成功后这些参数已有默认值；X仅做原始位置稳定检查，不要求猜X毫米换算。align/pick再要求X位置、观察高度、准心/响应矩阵、窗口、行程等参数。

建议控制初值保留为可调软件参数：`lambda=0.3`（1/s）、`body_speed=10`、`x_speed=5`、`z_speed=5`（mm/s）、`stable_ms=200`、`frames=3`、`retries=2`、`x_weight≈2.333`。速度换算必须能够生成1～3000 RPM有效命令；毫米比例未知时不会执行。X权重不是保证70%的固定贡献，实际贡献取决于局部矩阵及边界。

## 视觉详细帧

旧B2调试请求及14字节回复继续可用。新抓取使用单独B4详细颜色帧；它不是已退役的B3圆环编号协议，也没有恢复旧CRC协议。香橙派需部署本仓库更新后的`orange_pi/change.py`，继续用实际USB设备路径的`--uart-port`启动。原附件脚本仅支持B2，不能直接用于新抓取的自动下降。

- 请求6字节：`FF B4 Color RequestId_H RequestId_L FF`。
- 回复23字节：`FF B4 Color Valid CX(2) CY(2) DX(2) DY(2) Phase FrameId(4) AgeMs(2) RequestId(2) SUM FE`。
- 多字节字段大端；DX/DY有符号；SUM为字节1～20的累加低8位。
- Phase=1粗定位、2圆心；Valid仍为0/1。FrameId来自相机采集计数；AgeMs为采集返回至发送的时间，不包含相机内部缓冲及USB传输延迟。
- MCU核对请求编号，隔离上次同色请求的迟到包；新抓取只发送一次识别请求，不周期重发打断精定位。
- MCU计算数据年龄为AgeMs加接收后的经过时间。不同接收包不等于不同图像，稳定判据必须使用递增FrameId；粗/精切换清空稳定累计。

首轮下降阶段不做水平追踪。采集或总线异常终止当前抓取，用户处理后重新显式启动，不在恢复通信后自动续跑。

## 扫码、显示与任务所有权

组合路线沿用前四段和现有到点/停车反馈判据。第2段停车确认后等待1000ms，发布共享任务码`156+123+516+231`，来源为simulated；UART4字节与真实扫码帧统计不变。第一批颜色从第一组156读取，第二组123为放置编号。OLED、串口屏与控制台共享任务码。

串口屏分行为`156+123+`和`516+231`。两行及计数字段须完成实际DMA发送后才能推进第3段；发送失败或5秒仍未完成停止推进。发送完成不表示屏幕文字已完成实物验收。

新station状态表示站点控制权交接，区别于纯路线的waiting。组合调度期间拒绝其他运动/IMU标定入口；抓取任务接管机械臂事件，拒绝外部读轴事务干扰反馈匹配。Ctrl+C、底盘停止、grab stop与相关停止命令取消自动生产者，断开或重新连接网页不会恢复运动。

## 验证与实物边界

主机测试覆盖配置缺项不运动、绝对零目标、模拟扫码统计、1000ms计时、实际发送完成、正常停车中间状态、首件交接、粗/精和重复帧、位置反馈到位、取消和故障保持等。Keil/EIDE文件清单同步新增GrabTask与GrabRoute，不修改芯片、时钟或引脚。

软件验证结果在实施计划中记录；Codex未执行烧录，用户已反馈完成机械抓取及转向放置测试，视觉联调尚未验收。需要用户按上述顺序提供实际位置、像素响应及抓持结果，确认原方案提出的单件重复抓取目标。

页面准备区补充验证：88项网页回归通过，浏览器静态预览确认X/Z独立入口、回零方式默认为未选择、选定后正确生成单轴命令，未连接时执行禁用。预览未连接桥接服务，未发送硬件命令；本次仅改网页与说明，无需重新烧录固件。

固定抓取分步面板初版验证（下述10 RPM门槛已被后续修改取消）：89项网页回归通过；毫米换算用例先确认失败再修复。独立模拟桥接验证未确认低速时禁止点动、10 RPM回复后解锁、20 mm只发送一次pos z -1080、位置反馈换算为-20.000 mm、非低速回复重新禁用。模拟事件保存在.embeddedskills/tests/fixed-ui-events.json，测试日志在.embeddedskills/logs/tests/fixed-grab-web-20260927.log。未连接实车，本次网页修改无需重烧固件。

用户后续明确要求采用原有 `config z 500 120 0`。任务1设置按钮现发送500 RPM、加速度120、单次脉冲不设上限；删除10 RPM回复校验与点动锁定，不新增500 RPM强制门槛。普通点动继续使用MCU当前配置，连接与重连不自动改写。自动fixed/pick的Z速度仍由原有grab z_speed参数控制。

用户反馈已成功抓取，并确认相对转动Base −180°可转向转盘。任务1的1.1区域新增可编辑角度控件，默认发送pos base -180；复用既有固件相对位置命令与任务互锁，不自动随抓取执行。Base回复在任务1显示，并提供位置/状态查询。89项网页回归通过；未执行实车转动，无需重烧固件。

按用户要求精简准备区：Base/X/Z各两个直接回零按钮；移除本区底盘/IMU及旧X/Z回零下拉框。任务1去掉额外Base读取和重复Z读取，Z位置与到位状态只保留在1.2；Base默认−180°、Z设置500 RPM/120/0及底部停止入口保留。固件回零协议、互锁与其他页面的通用控制不变。

用户本轮确认：下降距离为80 mm（8 cm），每次先执行回零；下降、夹取及Base转180°放到转盘上的分步动作已可用。网页更新Z夹持位置默认值为−80 mm，不将分步验收扩展为自动放置流程。现有fixed/pick仍在提起后hold。下一步先完成香橙派B4通信与观察姿态标定，再测试align，最后测试pick；Base转向或回零后，须在最终观察姿态重新设置准心及像素响应。

## 自动取放与上电回零（本轮更新）

用户确认：抓取为顶部参考−80 mm，放置先采用−60 mm；取放动作自动衔接，无需逐步点击。fixed/pick与前四段路线交接后的pick统一执行：下降夹取 → 提起至z_lift → Base相对−180° → Z到z_place → 500 µs松爪 → 等待close_ms → 提起至z_lift → hold。align仍只对准。新增参数z_place，网页预填−60 mm；放置位置须在Z边界内且低于z_lift。Base转向沿用当前Base速度/加速度，等待新鲜位置和使能/到位反馈，角度误差不超过1°且速度不超过1°/s并稳定stable_ms，不能以ACK代替到位。Base不自动转回，后续视觉测试须恢复观察姿态并重设对应准心/响应参数。

固件初始化完成后自动顺序执行Z碰撞回零、X碰撞回零、Base就近回零，三个轴逐个确认，首次命令等待1秒。依据本地Emm手册第62–63页，新增0x3B回零状态读取及0x9C中断回零接口：bit2正在回零、bit3失败、bit4/5保护、bit0/1编码器及校准就绪。每轴连续两轮确认回零空闲且无故障、位置距零不超过182原始单位（约1°电机轴）、电机使能/到位后推进；每轴最多60秒。停止或失败先等待当前读事务结束，再广播停止并中断当前轴回零（外部紧急停止可抢占；0x9C以优先、仅TX模式在总线隔离后仍可发出，读取失败则报告停止未确认），核对回零标志已退出；这不宣称物理停车已确认。停止未确认5秒超时进入error，不自动重试。

状态新增homing/turn/place/release/retract；reason提供home_z/home_x/home_base/home_complete及失败原因。日志新增b/bt表示Base实际/目标电机轴角度。上电Z回零成功后自动载入已确认的z_ppm=480、z_grab=−80、z_place=−60；未测量的边界、提起高度和视觉参数仍需配置，不猜测。手动重新回零仍遵循位置参数失效规则。上电自动回零期间原任务互锁和停止入口继续有效，IMU上电静止验证在回零任务结束后进行。

以上替代前文历史记录中“Base不动、提起即hold、准备区需手动回零”的旧实现；物料实际放稳须实车验收。

本轮软件验证：固件完整主机回归通过，新增取放顺序、相对转向、ACK不代表到位、未到放置高度不松爪、各阶段取消、视觉仅对准不放置、回零状态/零位门槛、回零故障与取消用例；真实驱动打包测试覆盖0x3B及总线隔离时0x9C仍可发送。网页89项回归通过，语法及diff检查通过。Keil构建0错误0警告。未执行烧录或实车动作，自动回零及自动放置尚待上板验收。

按用户最新要求精简任务1：移除1.1准备、1.2手动点动与试夹、1.3重复参数表单及局部反馈，仅保留完整取放流程说明和开始/停止两个按钮。统一标定入口及公共状态/日志仍保留，固件动作顺序不变。本次为网页调整，无需重新烧录。

## 香橙派坐标自动日志

align/pick进入视觉识别和对准阶段后，控制台自动以独立最新值槽输出VISION RX，每秒最多两次，不挤占grab阶段日志和命令回复。align完成停在hold时仍可观察坐标；停止任务后取消待发坐标日志。格式示例（非实车数据）：`VISION RX fn=B4 color=1 valid=1 fresh=1 cx=350 cy=321 dx=-9 dy=17 phase=2 frame=123 age=25`。cx/cy为香橙派图像坐标，dx/dy是香橙派原始偏差，不是grab按STM32标定准心重新计算的误差；phase=1粗定位、2圆心精定位，frame为相机帧号，age为采集年龄加MCU接收后的经过时间。无当前有效目标时坐标输出na，旧坐标不冒充当前坐标；fresh=0表示超过本任务age_ms。camera status仍可手动读取快照。网页将VISION日志归入视觉模块。

坐标日志验证：主机回归通过（原始坐标与偏差、过期标记、无效帧不泄漏旧坐标、停止/固定模式不输出），网页89项测试通过，Keil构建0错误0警告。未烧录；需更新固件后实车核对香橙派接收与输出。

按用户要求简化上位机终端视觉日志：Color采用red/yellow/blue/green/black/light_blue名称，仅显示CX/CY像素坐标；协议、偏差、帧号、年龄等元数据不在该行展开。无效/过期帧显示对应提示。原始接收行仍用于解析和导出；错误日志不受影响。仅网页显示调整，无需重烧固件。

## Base已停住但回零未结束、IMU启动冲突修正

用户19:15日志在home_base持续等待，并现场确认Base已停住。旧判定将单圈机械零点等同于0x36位置计数零，并要求位置运动到位位，对Base就近回零不适用。主机测试复现“Base静止、位置计数非零、0x3B完成、使能但位置到位位未置位”仍卡住。Base现要求回零无故障且完成、连续位置读数稳定、驱动使能且无堵转；不清位置计数，不要求数值零或位置运动到位位。X/Z碰撞回零仍保持原零位检查。实际板上究竟是哪项旧条件未通过，需要新版回零诊断确认，不能仅凭现场停住认定所有驱动反馈成功。

回零状态日志改为axis/step/home_flags/raw/motor_flags/stable，去掉该阶段未赋值的位置与视觉字段；每轴完成后刷新缺项，避免Z标定已加载但仍报告missing=z_ppm。Base未完成回零、持续移动、失能或故障仍不能通过。

同时修复IMU时序：main不再在回零前启动IMU验证等待；只有三轴回零成功后才调用HWT101_Cal_BootVerifyArm，随后由原主循环执行一次5秒静止验证。回零取消或失败不启动，不改动静止验证门槛或失败后不重试规则。启动/重启提示同步更新。UART5此前的帧错误属于独立问题，本次不自动解除总线锁定。

修正验证：新增Base非零计数且未置位置到位位可完成、位置仍变化不能完成、失能不能通过、IMU仅成功后启动一次、回零超过5秒后IMU仍获完整验证时长等用例。固件完整主机回归及90项网页测试通过，Keil 0错误0警告。未烧录或实车验收。

## 固定抓取默认参数与取消阶段超时

用户19:29日志确认三轴home_complete及IMU PASS，随后align因missing=z_min拒绝。用户确认Z允许范围−80～0 mm、z_lift=−40 mm，并接受feedback_ms=2000、close_ms=500默认值；要求适当放宽pos_tol/stop_speed并删除timeout。现将pos_tol=1 mm、stop_speed=2 mm/s作为待实测的初始容差，Base仍用原有1°和1°/s。手册《ZDT_X42S第二代闭环步进电机用户手册V1.0.5》第10页标注控制精度小于0.08°，这是电机轴侧指标，不能当作10 kg以上整车及夹爪末端精度；机械间隙、弹性和负载影响需要实测。

以上默认值和已确认Z位置按前述初始化时机载入，固定抓取启动配置已齐全，视觉模式仍需未知标定。网页参数表预填同一组值，并明确不是设备读回值。起始位置边界与运行边界统一使用pos_tol，允许回零后的微小计数残差，但命令目标仍必须位于配置范围内。

删除单件抓取timeout_ms参数、配置门槛、网页入口和按阶段时间退出逻辑。未到位继续等待，grab stop仍可中断；反馈丢失仍请求停止，持续无停止确认时保持stopping，不自动释放任务所有权或宣称已停。底层通信、上电回零超时不属于此参数，本次保留；没有新增自动重试、跳过或比赛恢复策略。close_ms为闭合及松开后的等待，不是故障超时。

验证：先复现旧代码超过15秒后结束等待，以及初始Z位置0.05 mm在0.1 mm容差内仍被拒绝；修改后验证下降、Base转向和放置等待超过125秒不因阶段时间退出，未到位不夹紧/松爪且可手动停止，过期反馈不能确认停止。完整固件主机回归通过，网页92项通过，Keil工程template/MDK-ARM/template.uvprojx、Target template构建0错误0警告（19:51）。日志见.embeddedskills/tests/host-tests.log、grab-defaults-web.log和.embeddedskills/build/template-template-build.log。未烧录、未验证实车容差或舵机0.5秒动作完成。

## 取消人工X验证门槛并修正启动诊断

用户19:56启动align被retarget_ok拦截，明确要求直接联调任务2，不单独测试X。删除该人工确认参数、启动门槛与网页设置项；未把“用户愿意联调”等同于实物验证通过。正常协同绝对位置更新算法、B4红色请求和反馈检查保留。

启动被拒绝时保留所请求的有效模式，align不再错误显示fixed。配置不足的主动状态回复一次输出全部必需但未配置的key，以逗号分隔，网页映射中文含义；参数存在但组合无效仍报告对应原因。不将当前未配置的X尺度/边界、观察位置、准心或响应矩阵替换为主机测试示例。按当前上电默认值，align仍缺x_ppm、x_min、x_max、x_pre、z_observe、age_ms、accel、travel_mm、lead_mm、dx_tol、dy_tol、ref_u、ref_v和六个j参数；取消人工确认不等于这些标定已完成。

验证：先复现配置齐全但未填retarget_ok时无法启动align；修复后同一测试直接进入B4红色请求和底盘/X协同运动，无夹取或Base转向，支持停止。新增启动失败mode=align、全部缺项完整输出及网页中文映射检查。完整固件主机回归通过，网页93项通过，Keil template工程/Target template编译0错误0警告（20:04）；日志为.embeddedskills/tests/align-start-firmware.log、align-start-web.log及.embeddedskills/build/template-template-build.log。未烧录和实车验收。

## X行程与随动相机信息补充

用户确认X行程100 mm、有限位，识别前X/Z均在碰撞回零位置；测得电机100°对应28 mm，换算x_ppm=(3200×100/360)/28≈31.746032命令脉冲/mm。对应轴上电回零成功后恢复X尺度、0～100 mm边界、x_pre=0和z_observe=0，网页同步预填。该尺度为用户本次测量所得初值，不等于完成全行程精度验收；手动重做回零仍按既有规则撤销对应位置参数。

相机跟随X伸缩及Z升降。核对orange_pi/change.py：算法构造器和命令行均默认准心(334,338)，图像请求640×480，实际运行可通过--center-x/--center-y覆盖。此点相对画面中心约右14 px、下98 px，不代表已适配当前夹爪。应在已确认水平能抓中物料的位置保持Base/X不动，Z回到观察高度0，再记录物料中心作为该姿态候选准心；下降后画面位置变化不能直接误判成水平偏移。仍保留未知ref_u/ref_v和像素响应，未改香橙派默认准心或将其假称实测标定。

验证：完整固件主机回归及93项网页测试通过，Keil template工程/Target template构建0错误0警告（20:23）。日志为.embeddedskills/tests/x-calibration-firmware.log、x-calibration-web.log及.embeddedskills/build/template-template-build.log。固件已生成，未烧录；X实际全程和随动相机准心仍待实物确认。

## 任务2完整联调初值

用户21:03日志仍缺14项，确认此前只补了机械参数、未落实已答应的视觉初值。现补齐age_ms=1000、accel=10 mm/s²、travel_mm=100 mm、lead_mm=2 mm、dx_tol=dy_tol=5 px、ref_u=334、ref_v=338。已有body_speed=10 mm/s、x_speed=5 mm/s、lambda=0.3/s等控制初值保留。

试运行响应矩阵J=[[0,2,0],[-2,0,-2]]，列顺序为底盘前进、左移、X伸出，单位px/mm。依据用户“画面正、物料盘在机械臂前方”的描述，采用相机正向观察的方向假设：向左移动使DX增加，向前或X伸出使DY减小。2 px/mm仅为试运行尺度，不来自实测；它与旧MaterialVision将DX交给前后运动的方向约定不同，不能据此声称旧控制已验证当前方向。状态增加model=initial/custom/unset，页面明确显示未实测；custom也不等于已标定。相机准心默认值未改，STM32现在使用同一初值。初始化及上电Base回零成功后载入模型，手动参考变化和自动Base取放转向仍撤销准心/矩阵，避免旧姿态无提示复用。

同时修正X回零端的分配：旧权重按距最近边界衰减，x_pre=0导致X完全无法离开缩回端。现先求无边界衰减的方向，再按该方向剩余行程调整X权重重新求解；0 mm处可以伸出但不可继续缩回，100 mm处可以缩回但不可继续伸出。最终位置目标仍受0～100 mm和lead_mm限制。

验证：新增“不执行任何grab set，上电三轴回零后直接align”的生产状态机回归，先在旧代码复现ConfigReady失败；修改后进入红色B4请求、X/Z零位观察和协同对准，精定位后进入hold，无夹取/转向并可停止。验证X在两端向内可动、向外参与为零，初始模型的纠偏方向符合所声明假设。完整固件主机回归、93项网页测试通过；Keil template工程/Target template构建0错误0警告（21:09），Flash 136932字节、RAM 42408字节。日志为.embeddedskills/tests/align-defaults-firmware.log、align-defaults-web.log及.embeddedskills/build/template-template-build.log。未烧录，方向、尺度和真实收敛须上板联调，软件回归不等于实车验收。

## 控制台精简抓取状态日志

用户反馈停止等待期间持续打印同一状态，要求修改控制台。终端新增默认开启的“精简抓取日志”，相同抓取状态只保留首次显示，状态、模式、原因、缺项、停止确认、回零步骤等关键字段变化继续显示。elapsed和坐标变化不单独触发抓取状态重复行显示；独立视觉坐标、错误及手动查询回复仍保留。显示隐藏条数，取消勾选恢复当前500条缓存内的完整显示，偏好存入浏览器。

过滤只作用于终端呈现，完整接收仍进入状态解析和原始日志；导出与桥接文件记录不受影响。未修改固件、发送停车或恢复命令，也不把stop_confirmed=0改为已停止。此次解决刷屏显示，电机停止确认问题仍需另行定位。

验证：新增重复状态、状态变化、错误/视觉坐标保留、手动查询、重启和取消过滤回归，网页96项测试通过，app.mjs语法检查通过。日志为.embeddedskills/tests/grab-log-web.log；浏览器确认默认开关与切换可用，未连接或操作硬件。刷新网页生效，无需重新烧录。

## 为协同对准补充就近停止入口

用户澄清需要停止任务，而不是隐藏报告。任务2增加“停止协同对准”，任务3增加“停止本次抓取”，统一复用grab stop；底部原“单件抓取停止”改名“抓取 / 协同对准停止”，原vision stop按钮明确标注为“独立 Base/X 对准停止”，避免将两套任务混淆。任务2说明停止受理与停止确认的区别，沿用已有实时状态快照和锁定时允许grab stop的逻辑。仅修改网页入口，不更改固件停止逻辑或假报停止成功。

验证：app.mjs语法检查及网页96项回归通过，日志为.embeddedskills/tests/grab-stop-web.log。本轮未发送硬件指令；实际停止确认仍待实车反馈验证。刷新网页生效，无需烧录。
