doinbest/Yachiyo/xjx/模版搭建/docs/开发记录/2026-09-29-B2协议兼容恢复.md

# B2 协议兼容恢复

用户批准恢复原 B2，与实机 test_connect.py 对接。此前单独 camera 测试用 B2，GrabTask 却请求 B4 并要求远端圆心阶段、采集帧号、采集年龄和请求编号，造成兼容断层。本轮统一所有固件视觉入口为 B2，不修改香橙派程序或自启动项。

## 实现

- Camera 删除 B4 发送和解析、远端元数据，保留 USB 分包/粘包/重同步和统计。成功请求及停止清空旧数据；忙/失败保留旧请求。增加本请求 InvalidCount，避免“有效→无效→有效”批量接收掩盖失效。
- GrabTask 根据本地接收序号去重消费，接收时间判断 age_ms。相同坐标的新报文计数，同一快照不计数；至少 3 次观测且至少 200 ms，叠加原有停稳反馈。进入停稳阶段后重新计数；失效、越界、停止及重新启动清除稳定证据。无首包时停止等待，开始对准后失效则停车报错。
- 状态使用 protocol=B2、age_source=rx、rx_seq、vision。终端保留简洁坐标及原文导出；页面显示接收含义，旧固件未提供字段显示“未报告”。camera status 的无效/过期状态不输出历史坐标冒充当前数值。
- 保持原准心、像素响应矩阵、取放位置、速度、机械与总线互锁。未改引脚、时钟、USART1 DMA 或无线发送节奏。

B2 的本地接收序号不能替代远端采集帧号；同色迟到回复无法严格辨别，也不证明圆心阶段。用户接受按“坐标持续在容差内 + 机构停稳”完成对准。

## 软件验证

- 固件主机回归：全部通过，包含 B2 4/14 字节、分包粘包、正负偏差、错误颜色/校验/Valid、有效→无效→有效、请求缓存清理、B4 拒绝、同坐标新报文和重复快照、接收序号/时间回绕、停车重新计数和无首包不下降。
- 网页回归：113 项通过；桥接回归：26 项通过。
- Keil template：0 错误、0 警告；Flash 136076 字节，RAM 42376 字节。产物 template/MDK-ARM/template/template.hex 与 template.axf。
- 日志：.embeddedskills/tests/b2-firmware.log、b2-web.log、b2-bridge.log；.embeddedskills/build/b2-restore-final/template-template-build.log。
- 修改前源码快照：.embeddedskills/backups/b2-before-20260929-031722.zip；本轮差异：.embeddedskills/b2-review.patch。
- 香橙派仓库文件与快照逐字节一致；保留现有双协议 Python 回归，不将其作为固件运行前提。

## 最终差异审查

一次独立审查发现并修复三项显示问题，各有先失败后通过的回归：相机状态查询覆盖启动提示；无效或取消后显示旧 DX/DY；日志去重隐藏视觉状态变化。修复后重新运行完整固件、网页、桥接回归及 Keil 编译，结果如上。

## 实车验收

尚未烧录、重启或驱动设备。本轮不修改、部署 orange_pi/change.py 或香橙派文件。后续依次验证 camera material 1 的 B2 坐标 → 仅协同对准 → 完整视觉取放。软件回归及编译不代替真实 USB 链路、方向/尺度和停稳验收。

后续状态（2026-09-29）：本文实施时的“对准后合法 Valid=0 立即故障”已由[短暂视觉漏检暂停与有限恢复](2026-09-29-视觉漏检暂停与有限恢复.md)替代；B2 协议本身保持不变。
