doinbest/Yachiyo/xjx/模版搭建/docs/开发记录/2026-09-29-X轴视觉响应同向修正.md

# 2026-09-29 X轴视觉响应同向修正

用户确认：Base就近回零后机械臂朝车体左侧；摄像头装在X伸缩轴上，伸出使摄像头进入转盘上方。本轮按用户明确授权修改代码，不进行串口发送、复位、烧录或实车运动。

## 实现

GrabTask初始视觉矩阵改为 `[2,0,0];[0,2,2]`，仅将j12从-2改为+2。行对应DX=CX−334、DY=338−CY，列对应车体前向、左向、X伸出。X伸出与底盘左移使摄像头朝同一方向靠近物料，垂直像素响应采用同号，避免两者相互抵消。底盘映射、B2协议、取放参数、速度、边界及互锁均保持原行为。初始化及成功Base回零均复用同一初始矩阵。

底盘两列来自前一轮限时实车方向观测；X符号来自用户确认的机构关系及软件估算，并非独立X实车测量。2像素/mm仍是初始控制尺度，需后续实车确认方向、尺度和闭环收敛。model保持initial。

## 保存与验证

检查Git状态并保留已有修改；修改前相关文件快照：`.embeddedskills/backups/vision-x-sign-before-20260929-192220.zip`。

先更新回归，旧代码在X零点负DY应允许伸出的断言处失败；修改后通过。覆盖X零点和100mm端点的可退让方向、中间位置正负误差下底盘/X同向，以及假设X真实响应为+1/+2/+4像素/mm时的误差收缩；保留align不夹取、不转Base等原任务回归。

- 针对性RED/GREEN：`.embeddedskills/tests/vision-x-sign-red.log`、`vision-x-sign-green.log`。
- 完整固件主机回归PASS：`.embeddedskills/tests/vision-x-sign-firmware.log`。
- Keil template构建0错误、0警告：`.embeddedskills/build/vision-x-sign/template-template-build.log`。
- HEX：`template/MDK-ARM/template/template.hex`。
- SHA256：`14b803b8ce235e179ee004b4eb2db70f95e06112501699a4e3a1945d5c0da022`。

本轮未修改网页或桥接代码，未重复其独立回归。新固件尚未烧录，运行中MCU参数未更新。后续烧录并完成原有回零/IMU验证后，先测试仅协同对准；软件验证不代表实车闭环通过。

## 烧录后的串口实测（19:45～19:49）

用户授权重新串口控制。通过已连接的本地桥接COM11/115200查询：j12=2，grab为空闲/home_complete；用户提供重启日志显示IMU PASS、control_ready=1，19:44:43电机总线未锁定、无错误。此前开机38ms发生UART5帧错误与恢复不完整，已在用户重启后的记录中清除；不可把历史故障直接当作本次状态。

19:46:02发送camera material 1，B2红色坐标稳定在(595,43～44)，序号持续增长；camera status报告frame=1、current_valid=1、frame_age_ms=14、checksum_errors=0、overflows=0。19:46:55发起grab start align，约1秒后进入align；约7.3秒时收到合法无效坐标并进入vision_pause。按本次8秒短时测试安排，19:47:03发送grab stop；19:47:05收到idle/cancelled/stop_confirmed=1，未进入下降或Base转向。

对准中坐标无明显收敛。用户随后明确：当时红色物料没有放在转盘上，可能识别到了夹爪，且未观察底盘是否移动。因此这组坐标不能用作目标物料的方向/尺度标定，不能据此认定模型错误或任务未输出运动。B2无目标身份字段，接收有效性不等于物料身份正确；本轮不添加协议字段、不改香橙派、不据此修改增益。等待用户放好目标再试。

本次通信已恢复及时：USART1诊断rx_overflow=0、uart_errors=0、dma_errors=0、reply_dropped=0、urgent_dropped=0；debug_dropped=405表示已有最新样本调度中的样本替换等统计，不等同于普通回复丢失。停止后查询底盘locked=0、error=0，四轮缓存速度均0且flags=0x03；最终停止判断采用grab的stop_confirmed=1。

完整桥接事件：`.embeddedskills/logs/vision-align-reconnected-20260929.json`；短时试验事件：`.embeddedskills/logs/vision-align-short-probe-20260929.jsonl`。本轮仅测试与记录，未修改固件、未烧录或复位。

## 放置真实红色物料后的短时对准（19:50～19:52）

用户确认物料已放好后继续。识别坐标由上一轮约(595,44)变为约(348,400)，符合目标场景已改变，不能单凭B2判定目标身份。19:50:39启动align，约1.2秒进入对准，初始误差约DX=7、DY=-68。完整状态读到vf=-0.436 mm/s、vl=+0.570 mm/s及X正向目标；X实际从约0伸至2.390 mm，恢复时DY分别约-59、-54。存在朝准心收敛的初步趋势，但数据波动、活动时间短，不能当作精确标定或完整收敛验收。

约运行3秒出现合法无效报文：暂停停车、停稳后等待恢复，分别在elapsed=3658和4562ms成功恢复；约5012ms第三次漏检触发vision_recover_limit，5471ms到error且stop_confirmed=1。8秒观察脚本随后按安排发送grab stop；最终查询仍为error/vision_recover_limit且stop_confirmed=1，无下降/转Base。

19:51:26复查info另发现MotorBus reply_timeout，ID4、0x36、fault_ms=382703；不能把它混同于Valid=0或覆盖grab已经报告的故障原因。19:51:47发一次bus recover，19:51:49报告arm_ready=1、chassis_ready=1、complete，19:51:50四轮停稳确认，19:51:55恢复状态success=1、locked=0。未自动续跑。

恢复后仅启动独立红色识别，不运动：19:52:23至19:52:34约11秒，camera status报告invalid_reports=11（每次成功新请求清零），checksum_errors=0、overflows=0、frame_age_ms=5。说明静止时也收到合法Valid=0；B2无法据此判断是否切换圆检测或具体算法原因，不能靠单纯增大恢复次数解决目标身份或算法稳定性。仍须单独判断识别连续性及ID4偶发通信故障。

19:52:41收到OK camera stop；19:52:50桥接因ClearCommError/PermissionError拒绝访问而断开COM11，此前任务及四轮停止均已确认。没有因断线假定停车，也没有再次自动启动运动。日志：`.embeddedskills/logs/vision-align-material-20260929.json`。本阶段未改固件或香橙派，不继续盲调J矩阵或放宽保护。

## 恢复通信后的静止连续性检查（19:57～20:01）

COM11/115200恢复后，仅启动独立识别和查询，不发送运动。19:57:17发送camera material 1；19:58:04查询得到当前坐标(348,396)、DX=14、DY=-58、seq=2981、frame_age_ms=23、invalid_reports=122，checksum_errors=0、overflows=0。约47秒内累计122次当前请求合法Valid=0报告，说明静止时坐标有效性也不连续；这不是122次串口断线，也不代表有122个独立遮挡事件。B2不携带阶段信息，无法据此判断圆检测切换或具体算法原因。

核对Camera_Process：仅在长度、尾标志、SUM、Valid取值及当前功能/颜色匹配后，将Valid=0计入InvalidCount；此计数每次成功新请求清零。当前任务依照已确认的两次恢复额度工作，尚无证据支持反转矩阵、放宽行程或增加恢复次数。19:58:08收到camera stop确认；20:00:30查询camera为Idle、active=0。20:01:16查询电机总线locked=0、reason=none；20:01:21任务仍报告上一轮vision_recover_limit，stop_confirmed=1，X=2.390mm，未自动续跑。

本地`.embeddedskills/ssh-inspection/test_connect.py`实际为0字节，不能用其解释当前实机算法；本轮未访问SSH、未修改香橙派或固件。记录位于`.embeddedskills/logs/vision-live-20260929.jsonl`。下一步需要确认实际目标画面及Valid=0产生条件，再决定识别侧问题或是否另行调整漏检策略；不能将当前初步误差收缩写成完整对准验收通过。

## 再次短时对准及静止目标跳变（20:03～20:07）

20:03:12重新独立识别，坐标约(193～195,328～329)；约7秒时invalid_reports=0。用户要求继续协同对准后，先确认总线未锁定及上一任务停稳，20:05:11.698启动8秒短时align。准备阶段X回观察位置0，进入align时DX=-141、DY=2；之后CX约201→223→250→276，DX约-133→-111→-84→-58，DY约2～4。实际报告vf约5.449～9.995mm/s，X约0：本次主要验证了水平误差对应的底盘纠偏，不能当作X整段行程标定。未达到准心或完成align。

elapsed=6597ms出现漏检暂停；7094ms确认停稳开始恢复窗口；7242ms成功恢复一次。20:05:19.732按8秒测试上限发送grab stop；20:05:20.889收到idle/cancelled、stop_confirmed=1，未夹取或转Base。

停下后20:05:55重新独立识别，在约6秒内累计18次合法无效报告，CX反复在约269～275和296～303间变化，CY约327～338；校验错误和溢出仍为0。用户随后确认物料和转盘始终静止，并询问是否识别到夹爪。B2只有颜色与坐标，不能证明识别对象身份；静止坐标跳变也可能来自同一目标检测中心不稳定，不能直接归因为夹爪或算法阶段切换。

20:06:07查询另外发现总线reply_timeout，owner=4、addr=3、func=0x35、fault_ms=1258145；此前为ID4位置查询超时，本次是ID3速度查询，不能只归因为4号轮。20:06:50停止视觉请求；20:07:12执行一次bus recover，20:07:14报告arm_ready=1、chassis_ready=1、complete，20:07:15四轮停稳确认。未再次启动运动，未修改恢复额度、模型或固件。运动日志存入vision-align-short-probe-20260929.jsonl，独立识别及恢复日志存入vision-live-20260929.jsonl。

## 用户要求再次尝试（20:09）

启动前查询总线locked=0、reason=none，grab为空闲且stop_confirmed=1。20:09:23.728发送grab start align；elapsed=1054ms进入align，DX=-42、DY=4。1201ms即出现无效坐标并暂停；2028ms恢复一次（DX=-64、DY=10），2644ms再次暂停；3552ms恢复第二次（DX=-60、DY=6），3927ms第三次漏检触发vision_recover_limit。4384ms进入error且stop_confirmed=1，未到达对准完成状态，X约-0.015mm、Z约0。8秒脚本随后发送grab stop，未自动重试。本次故障原因明确是视觉恢复额度耗尽；不能根据坐标跳变确定目标为夹爪，也不能由本轮推出新的矩阵标定值。保留原始事件日志，未修改固件或香橙派。
