doinbest/Yachiyo/xjx/模版搭建/docs/开发记录/2026-09-29-行程超限停止确认与视觉串口诊断.md

# 2026-09-29 串口实机诊断与行程超限后的停止确认修复

## 实机读取

用户授权通过现有控制台按视觉坐标分析、调参。读取本地服务确认 COM11、115200/8N1，沿用桥接 API，没有另开串口。记录保存在 `.embeddedskills/logs/vision-live-20260929.jsonl`。

- 18:23:28：grab state=stopping reason=travel_limit stop_confirmed=0 elapsed=251800，已停留四分多钟。
- 18:23:36：电机总线 locked=0，没有记录到 UART 错误；18:23:44 读回 travel_mm=100。
- 18:24:32：chassis feedback 被抓取任务互锁拒绝，未得到新的四轮原始反馈。
- 18:24:40 请求 grab stop；18:24:48 仍 stopping/cancelled/stop_confirmed=0。
- 18:26:02 通过桥接请求 chassis stop，18:26:04 收到匹配 token 的四轮停止确认（tx_complete=1、wheels_stopped=1）。此确认只针对四轮；抓取任务自身仍受下述旧固件缺陷影响。保留网页停止锁，不自动恢复运动。

本轮没有发送新的运动命令、启动识别或修改视觉矩阵，也没有复位/烧录。任务处于 stopping 时 grab set 与 camera material 均不在互锁允许范围，不能继续动态标定。

## 原因与修改

GrabTask 的 wheels() 在计算停稳反馈前检查相对任务起点的 travel_mm。触发行程故障后，车轮即使停止在越界位置，后续每次 wheels() 仍提前返回，无法更新 WheelQuiet；再次 grab stop 也无法解除该循环。不是实际轮子必须返回旧行程范围才能停止。

仅在 GRAB_STOPPING 阶段不再重复以历史位移越界提前返回；运动阶段的行程检查仍保留。停车阶段继续检查全部轮的使能/堵转、速度、位置、新鲜度及停车发送后的稳定反馈，三轴停稳检查保持不变。既不扩大 travel_mm，也不重置原点伪造停车证据。

## 验证与待完成

增加四轮分别越界的回归：先观察旧代码无法退出 stopping；修复后真实新鲜停稳反馈可结束为 error/travel_limit，人工取消则结束为 idle。仍运动或反馈过期时不得确认停止；停止后无新增纠偏、夹取或 Base 转动。针对性测试 RED→GREEN。

Keil template 编译 0 错误/0 警告，产物 `template/MDK-ARM/template/template.hex`，构建日志 `.embeddedskills/build/travel-stop/template-template-build.log`。完整主机回归结果见 `.embeddedskills/tests/travel-stop-firmware.log`。

更新固件后，先验证行程故障可正常停止，再在有限小位移和完整反馈条件下测量水平像素响应。当前不能仅凭旧坐标递减就把 J 的符号当作已实测；矩阵、准心、速度和边界均未修改。烧录/复位会触发既有三轴回零，尚待用户明确授权。

HEX SHA-256：`4e5723f7bad16405b6d2269b33335f7885e02ddbb974845e943877feb37c6ad6`。

## 用户手动烧录后的继续检查（18:31～18:41）

用户确认手动烧录，授权继续串口试验并在必要时使用控制台 system reset。串口仍为 COM11/115200。18:31 grab 为 idle/home_complete，IMU control_ready=1。

18:32 独立 camera material 1 提交成功，但后续 camera status 连续为 USB已枚举、Wait、frame=0、rx_bytes=0；18:39 再次请求返回 ERR camera busy。源码路径确认 Camera_RequestStart 的 HAL_BUSY 来自 CDC_Transmit_FS 中未完成的 TxState，不能当作收到香橙派应答。

遵循用户“只通过串口、只调整STM32”的最新要求，本阶段没有继续 SSH 或修改香橙派。18:40:06 先停止本地相机请求，再执行一次已授权 system reset；三轴回零完成，18:40:17 IMU PASS/control_ready=1。18:40:47 重发一次识别请求获 sent；18:40:56 仍 frame=0/rx_bytes=0。

这次尚无新坐标，未发送底盘试动、未修改 J 矩阵。下一步需恢复主机端 USB 会话（可在香橙派本地重新启动原视觉程序并使用原 USB 端口，无需修改算法或通过 SSH）；只有收到有效新坐标后才能做方向/尺度标定。不能把18:19的旧坐标当作重启后当前反馈。info 的旧构建时间来自未重编译的 arm_console 对象，不能单独据此判断用户是否烧录了新 GrabTask。

## 重启香橙派程序后的继续检查（18:48～18:56）

用户重新启动香橙派程序。沿用原控制台 COM11/115200；桥接此前记录18:45:57 ClearCommError/拒绝访问，重新连接原端口后 grab status 和 info 可读，回零完成、电机总线未锁定。

18:49:44 请求 camera material 1，18:49:50 收到 sent 与 B2 红色坐标；至18:51:01可见有效坐标序号553。样本包括(315,367)、(309,386)、(288,402)、(312,381)、(287,402)，证明本次请求后的USB视觉链路确实返回过有效数据。静止观测中坐标分布在约(310,383)与(288,400)附近，未测量运动响应，不能据此认定方向或尺度。

此后 COM11 虽显示已连接，却不再产生RX/原始字节事件。18:52:47 imu status、18:54:01 camera stop、18:55:39 console status 均只有桥接TX，未取得设备回复；camera stop是否被MCU执行无法确认。存在批量延迟与文本缺段，现有证据不足以区分无线链路、USB转串口、供电或MCU运行异常，不能直接归因于视觉算法或串口DMA。

本阶段未发出运动指令，未调整矩阵，未复位或烧录；需先恢复可观测的串口回复，再进行有限时长的底盘横向响应实验。原始事件保存于 .embeddedskills/logs/vision-restart-events-20260929.json，连续采集见 vision-live-20260929.jsonl。
