doinbest/Yachiyo/xjx/模版搭建/docs/开发记录/2026-09-30-保持香橙派不变的STM32蓝色重新识别.md

# 保持香橙派不变的STM32蓝色重新识别

## 用户要求与撤回范围

用户明确当前不方便修改香橙派，实际运行入口不是本地 `orange_pi/change.py`；要求优先不改香橙派，必要时恢复STM32上一版。此前一轮仅改了本地视觉文件，没有部署到香橙派，也没有改动STM32，所以不需要为撤销该方案回退STM32。

已将 `orange_pi/change.py` 按修改前快照逐字节恢复，保留更早的已有工作区修改。上轮新增的 `tests/vision_target_test.py`、`orange_pi/README.md` 已从活动目录移除；所有相关源码、报告及模拟产物均已保存在 `.embeddedskills/`。README撤销要求更新香橙派的说明，历史开发记录增加“已撤回”状态。默认不使用SSH。

## STM32侧兼容方法

先前实测单独发送 `camera material 3` 能取得有效蓝色坐标，而原暂停逻辑只等待原有数据恢复。本轮让仅协同对准在停车后重发一次同样的B2蓝色命令，以尝试重新取得识别结果；这不证明全部实车漏检都由远端某个阶段造成，也不推断当前香橙派程序内部实现。

- 仅 `mode=align` 改变。收到合法无效坐标，仍立即暂停、请求停止，并检查四轮及三轴停稳反馈。
- 确认停稳后，500毫秒原恢复窗口开始。在反馈仍停稳的情况下，调用已有 `Camera_MaterialStart(CAMERA_COLOR_BLUE)`，发送 `FF B2 03 FF`。
- USB返回BUSY时只在原窗口内重试，不延长窗口；其他发送错误触发 `camera_tx` 停止。一次暂停最多成功提交一次请求。
- 成功提交后，Camera原有逻辑清除旧缓存；本轮旧快照不会进入恢复计数。状态报告 `vision_reacquire_wait`，网页显示“已重发蓝色识别，等待新坐标”。这表示已提交USB，不是香橙派确认识别成功。
- 新请求提交后仍须3次连续新有效接收观测、当前数据新鲜且反馈仍停稳，才恢复对准。500毫秒窗口及每任务最多恢复2次保持；第三次漏检、持续漏检、USB断开、机械反馈失效、总线故障和人工停止仍按原保护处理。
- `pick`、路线pick和固定动作未增加重发。蓝色对准、红色抓取分工保持，没有新增协议、设置菜单或整任务总超时。

B2没有远端请求编号和采集时间，因此即使清除本地缓存也不能严格排除同色迟到报文，不能从接收序号断言远端采集了不同图像。本轮只复用现有协议保证，不宣称实现目标身份追踪。

## 验证

- 修改前新增回归先失败：原代码在未重新请求时已累计恢复坐标。记录 `.embeddedskills/tests/grab-reacquire-red.log`。
- 固件主机完整回归通过，新增检查覆盖停稳前不发送、BUSY期间不累计旧观测、成功重发后清缓存、3次新观测才恢复、重复快照、两次额度、BUSY超时、发送错误、再次运动时不重发、人工取消和红色抓取不重发。
- 生产 `GrabTask_Command` / 状态机 / 控制台发送队列模拟通过：蓝色合成收敛；发送通道4秒不可用及重复停止；视觉保持失效直到B2重发、随后新坐标恢复；延迟启动/停止同批处理。机械、相机及时间为模拟端点，不能替代实车验收。
- 网页117项、桥接26项通过；对应日志 `.embeddedskills/tests/grab-reacquire-{firmware,web,bridge}.log`。
- Keil Target `template`：0错误、0警告，Flash 137372字节、RAM 42408字节。日志 `.embeddedskills/build/blue-reacquire-20260930/template-template-build.log`。

## 产物与回退

- 新版：`template/MDK-ARM/template/template.hex`，调试文件 `template.axf`。
- 改动前上一版HEX：`.embeddedskills/build/blue-reacquire-20260930/previous-template.hex`。
- 修改前源码、旧HEX/AXF及撤回的本地视觉方案：`.embeddedskills/backups/stm32-blue-reacquire-before-20260930-021512.zip`。

本轮只完成代码、软件回归和编译，未烧录、复位、发送实车串口命令或访问香橙派。用户烧录新版STM32后，仍用 `grab start align`；漏检停稳后应能看到 `vision_reacquire_wait`。若香橙派仍持续输出无效坐标，任务仍会停止。新版实车效果尚未验证，已保留上一版便于回退。
