doinbest/Yachiyo/xjx/模版搭建/docs/开发记录/2026-09-30-蓝色协同对准参数提速与对比.md

# 蓝色协同对准参数提速与前后对比

## 用户要求与本轮范围

用户要求依据本次实测调整参数，并提供直观的前后对比图。按当前静止蓝色物料的快速对准场景处理，没有新增持续追随移动目标的工作模式。保持香橙派程序和B2协议，不使用SSH。

## 实测依据

来源为 `.embeddedskills/logs/blue-align-once-20260930-023152.jsonl`：有效状态dx从-95到-57 px，dy为-2～0；X反馈-0.009到0.017 mm，约0.026 mm，主要由底盘完成修正。底盘前向速度指令曾达到9.15 mm/s，接近原10 mm/s上限。三次视觉失效造成任务停止，前两次重新请求成功，最终原因为vision_recover_limit。本次不把漏检根因归咎于速度，也不声称提速会解决漏检。

## 参数变化

| 参数 | 原默认值 | 新默认值 | 用途 |
|---|---:|---:|---|
| body_speed | 10 mm/s | 20 mm/s | 底盘平移速度上限 |
| lambda | 0.3 s⁻¹ | 0.6 s⁻¹ | 相同像素偏差下的修正力度 |
| accel | 10 mm/s² | 20 mm/s² | 控制器平移速度变化限制 |

用现有初始模型估算，在dx=-61、dy=0时，期望前向速度从9.15到18.30 mm/s；dx=-6时，新参数期望仅1.8 mm/s，仍由原有比例控制在近目标处减速。实际命令还受加速度、X速度限幅和电机总线调度影响。三个默认值由视觉align/pick共用；固定取放不走该视觉控制，X/Z速度上限仍为5 mm/s。没有改变参考点、固件矩阵、引脚、时钟、电机配置或路线速度。

网页预填同步上述三值，并纠正同一默认表中遗留的旧初始矩阵，使其与已在固件使用的 `[2,0,0] / [0,2,2]` 相同。网页输入不是实时设备参数，加载页面不会自动发送。

## 前后对比图

参数前后对比

上方曲线均为相同条件模拟：起始dx=-95、dy=-1；摄像头响应2 px/mm来自尚未完整标定的现有初始模型；机械立即跟随命令、连续有效视觉。复用生产GrabTask控制和状态机，硬件、反馈、时间端点为主机模拟。没有把旧实测与新模拟当作同类性能测试，也没有给丢失期间插补坐标。

| 同条件模拟指标 | 原参数 | 新参数 |
|---|---:|---:|
| 首次进入整数坐标±5 px窗口 | 10.10 s | 5.25 s |
| 完成模拟稳定/停车检查，进入hold | 10.85 s | 6.05 s |

进入窗口用时在该模型中减少约48%；不是实车保证。图中下方单独呈现上一轮实测，漏检区间留空；右侧速度柱为相同dx、dy=0下的限幅期望值，不是实测速度。

模拟源码：`tests/grab_tuning_sim_test.c`；原始比较数据、图表脚本、PNG、SVG、指标及日志均在 `.embeddedskills/alignment-tuning-20260930/`。默认Python的matplotlib与NumPy版本不兼容，使用现有 `D:/study_software/anaconda/envs/yolo_all/python.exe` 绘制，未安装或修改依赖。

## 验证

- 新响应边界回归在修改前因仍限速10 mm/s而失败，日志 `.embeddedskills/tests/grab-tuning-red.log`；修改后通过，覆盖双向修正、近目标减速、底盘/X速度上限、加速度和进入窗口后的减速至零。
- 固件主机完整回归PASS，包含新旧参数同场景收敛比较；原有漏检重新请求、三次新观测、次数上限、人工停止和停车确认回归保留。日志 `.embeddedskills/tests/grab-tuning-firmware.log`。
- 网页117项PASS，日志 `.embeddedskills/tests/grab-tuning-web.log`。首次包装脚本打印Unicode符号遇到本地GBK编码错误，测试已完成且日志保存117通过/0失败，未将打印错误当成测试失败。
- Keil Target template编译0错误0警告，Flash137372字节/RAM42408字节。日志 `.embeddedskills/build/align-tuning-20260930/template-template-build.log`。

## 生效状态和回退

本轮通过既有COM14/115200桥接发送了一次只读grab status，显示已发送，但没有收到新回复，随后被动观察仍无回复。因此没有发送设置参数、启动运动、复位或烧录命令；板上是否仍运行之前的任务不能据此推断。

新默认值已写入源码并生成 `template/MDK-ARM/template/template.hex`，尚未烧录。旧固件也支持以下RAM命令，可在任务空闲、串口恢复后逐条设置并读取确认，本轮没有替用户发出这些命令：

```text
grab set body_speed 20
grab set lambda 0.6
grab set accel 20
grab get body_speed
grab get lambda
grab get accel
```

RAM回退为body_speed=10、lambda=0.3、accel=10；已烧录新版时复位会恢复新默认值。修改前HEX为 `.embeddedskills/build/align-tuning-20260930/previous-template.hex`；修改前相关源码与HEX/AXF完整保存在 `.embeddedskills/backups/align-speed-before-20260930-024615.zip`，保留工作区更早的未提交改动。

新参数实车速度、停车距离、图像稳定性及完整对准效果尚未验收。下一次实测应记录同一起点和观察姿态下的dx/dy、速度指令及漏检次数，再判断是否保留这组试验参数。
