doinbest/Yachiyo/xjx/模版搭建/docs/开发记录/2026-09-30-蓝色协同对准预检与优化方案.md

# 蓝色协同对准预检与优化方案

## 当前执行结果

用户确认蓝色单独识别正常，授权进行一次仅协同对准并要求优化方案。2026-09-30 00:49–00:50 通过网页已连接的 COM14、115200/8N1 查询状态。未发送 grab start align，未恢复总线、复位或执行运动，原因如下：

- grab：state=error、reason=home_request_failed、stop_confirmed=0；x_ppm/z_ppm 均为 unset。
- bus：locked=1，首个故障 reason=uart_error、fault_ms=38、uart_error=0x00000004。当前工程 HAL 定义该位为帧错误；具体电气/上电时序原因未确定。
- IMU：数据 fresh=1，但 verified=0、control_ready=0；回零未成功，启动静止验证尚未完成。
- camera：B2 target=3，USB 已连接、当前坐标有效，checksum_errors=0、overflows=0。invalid_reports=108 是查询时累计值，不可据此推算本次漏检率。

记录见 `.embeddedskills/logs/blue-align-live-20260930.jsonl`。另存桥接事件缓存 `.embeddedskills/logs/blue-align-preflight-events-20260930.json`，含历史片段，不可全部视为本次测试。

本次状态查询期间采集 31 个控制台坐标样本，CX 342–355，中位数349、标准差2.77；CY 288–308，中位数301、标准差4.16。相邻已记录样本最大差分别为9和16像素。日志采样不连续，不能当作相机逐帧跳变幅度；没有记录实物是否全程静止，不能全部归因于算法噪声。

## 恢复与一次测试计划

1. 核对电机电源和总线连接；在用户确认硬件状态及所需恢复动作后，通过既有恢复流程核对全部7台驱动。
2. 本次启动回零已失败，单独解除总线锁定不能代替回零；需恢复完整回零和5秒IMU验证。不得手填标定值绕过未完成的机械零点确认。
3. 核对固件协同对准使用蓝色、回零参数已载入、IMU control_ready=1，记录原始相机坐标与机械状态。
4. 进行一次最长15秒的对准观察，达到hold或出现故障即结束；到时仍未完成则发送grab stop。记录开始误差、收敛趋势、速度、X位移、漏检恢复次数和结束原因，并检查停止确认。

## 有依据的优化顺序（待动态测试后定参数）

- 第一优先级是启动故障诊断：若帧错误重复，检查驱动供电顺序、UART5电平与共地、连接质量及接收时序。保留故障锁定；不能因相机正常而忽略电机链路故障。
- 相机存在数像素到十余像素的日志波动。若确认物料和相机静止仍有尖峰，再对新坐标采用短窗口中值去尖峰，并保存原始/处理后坐标作比较；从3个新样本的短窗口开始验证，不直接大幅放宽5像素对准容差。
- 动态测试若误差持续收敛但目标附近反复修正，再降低近目标速度或增加进入/退出容差滞回。依据实际误差曲线确定参数，保留停稳、有效新坐标和稳定时长门槛。
- 动态测试若某轴误差增长或严重交叉耦合，先修正响应模型的方向与尺度，再调增益。当前2 px/mm仍是初始模型，不能宣称实测标定。
- 本次没有修改控制代码、下载固件或完成实车对准验收。用户关于电机电源状态的答复仍待补充。

## 全部重新上电后的第二次预检（00:53–00:55）

用户确认全部重新上电并要求再次测试。桥接日志显示00:52:51启动，随后Z、X、Base依次回零，00:52:58收到 `state=idle reason=home_complete missing=none`，设备报告回零过程耗时6904 ms。

其后通过原连接COM14、115200/8N1发送 grab status、bus status、imu status、info，只有PC写出记录，没有MCU回显或状态回复。重连同一已选端口后再次查询仍无回复。不能依据串口句柄 connected=true 判定设备链路正常，也不能确认IMU已通过验证。

重连过程中桥接按既有逻辑发送Ctrl+C和带token的chassis stop，等待回复超时；`tx_complete=false wheels_stopped=false`表示未收到固件电机发送完成与四轮停稳确认，不表示PC串口没有写出。桥接保留 `stop_latched=true`，未解除。此次仍未发送 grab start align、未修改控制参数或复位设备。

后续首先核实实物停稳状态及无线模块两端连接状态。通信恢复后应先读取总线、IMU和抓取状态并完成停车确认，再解除本地停止锁定、执行一次对准。现有证据不能区分无线链路故障、MCU串口接收异常与主循环阻塞；不能将故障直接归因于IMU，也没有依据调整视觉增益。

本次事件留档：`.embeddedskills/logs/blue-align-repower-20260930.json`。

## 通信恢复后的单次启动尝试（00:57–00:59）

用户确认应已正常。重新预检收到三轴回零完成、missing=none、总线locked=0、IMU result=PASS/verified=1/control_ready=1。IMU本次验证5000 ms、51样本、无I2C错误。通过桥接重新请求停车，00:58:36收到tx_complete=1、wheels_stopped=1，随后解除此前本地停止锁定。

00:59:11.674通过原COM14/115200/8N1写出一次 `grab start align`。之后未收到命令回显、受理状态、目标颜色或坐标日志；约3.4秒后中断测试并写出 `grab stop`。继续查询12秒仍无回复，无法确认任务是否受理、是否实际运动或是否已停止。

00:59:42另通过桥接发送Ctrl+C及带token的底盘停止请求，桥接按既有规则重发，00:59:48超时。最终保持本地stop_latched=true，未收到本次电机发送完成或四轮停稳确认。已要求用户核实实物是否运动及停稳，若仍运动先实体停机或切断电机电源。不继续发送启动命令。

此次不能评价蓝色协同对准收敛，也不能证明启动命令导致通信中断；最后一次正常反馈与启动写出之间有间隔。一次PC写出不等于固件受理。日志 `.embeddedskills/logs/blue-align-attempt-full-20260930.json`、`blue-align-once-20260930-005911.jsonl`、`blue-align-stop-20260930.jsonl`。

### 更新后的优化方案

1. **先定位间歇失联。** 保持机构静止，通过现有状态查询观察连续回复；核对无线模块两端连接与供电。必要时使用已确认参数的有线控制链路作对比，以区分无线链路与STM32处理异常。没有通信证据前不调整控制增益。
2. **补齐失联诊断数据。** 若硬件链路稳定仍复现，利用现有USART1接收错误/重启计数和主循环计时数据，补充可查询的诊断输出；必要时读取调试器现场，区分RX恢复、TX阻塞、主循环阻塞及异常处理。只在证据指出具体故障后实施修复。
3. **通信稳定后再做一次限时对准。** 启动前立即复核新鲜状态；确认mode=align、color=3后采集误差、底盘速度、X位置和恢复计数，结束必须收到停止确认。现有单次脚本无回复即停止请求，但链路断开时不能保证请求到达设备。
4. **动态数据再决定视觉/控制优化。** 静止且确认无人移动物料时统计蓝色坐标噪声；孤立尖峰考虑3样本中值。若近目标振荡再调整速度或滞回；若误差不收敛先验证响应模型。保留5像素容差与停稳门槛，当前不盲目改参数。

上述为诊断和优化方案，未实施额外控制逻辑修改；本轮未烧录或复位。

### 延迟回复与最终状态（01:01复核，取代前述未确认的临时状态）

日志补收00:59:59的 `state=idle mode=align reason=cancelled stop_confirmed=1 elapsed=492`，并于01:00:02收到本次token对应 `tx_complete=1 wheels_stopped=1`。01:01:09再次主动查询确认任务仍为idle/cancelled/stop_confirmed=1。因此最终已经确认任务停止及四轮停稳；本地停止锁定保留。

该状态同时报告 `mode=align color=1`，而本轮修改后的GrabTask.c在align模式所有此类状态报告均应为color=3，表明设备运行固件尚未体现蓝色修改。不能用旧对象文件编译时间单独判断版本；这里的依据是实际行为字段与新源码的直接差异。相机当前active=0、rx_bytes=0、rx_seq=0，任务没有留下有效视觉对准数据。

下一步优先级调整为：先在获得明确烧录意图并核对实际调试器参数后烧录已构建蓝色固件；完成回零/IMU验证并核对align状态color=3。再以静止查询排查间歇通信停顿，避免将延迟回包解释为实时反馈。链路及版本确认后才进行蓝色闭环收敛测试，再决定滤波、近目标减速及响应模型标定。此次没有完成蓝色对准验收，也没有擅自烧录或调参。
