doinbest/Yachiyo/xjx/模版搭建/docs/开发记录/2026-10-02-视觉源码更新与align-pick容错分析.md

# 2026-10-02 视觉源码更新与 align / pick 容错分析

本轮按用户要求更新本地视觉源码，并分析任务流程；STM32 固件行为未修改。用户确认 `align` 已完整验证，要求后续让 `pick` 的对准流程与其一致。

## 源码更新

- 最新源码：`Code/orange_pi/vision.py`。
- 来源：用户提供的 `D:/Document/xwechat_files/wxid_gh3hulr1y4vm22_1404/msg/file/2026-10/vision.py`，原样复制。
- SHA256：`B071F3010A8685DA06462DF2CC5BF668517634F60CB903EF9EC805AEA374B54D`。
- 删除旧 `Code/orange_pi/change.py`、`test_connect.py`，更新入口文档与 Python 测试引用。旧 Python B4 测试替换为最新 B2 请求重启和采集测试；固件测试代码不改。
- 本地复制不代表香橙派部署；本轮未连接、启动或修改实机程序。

## 原有 align 流程

以当前 `Code/template/App/GrabTask.c` 为依据，以下数值为源码默认值，实机 RAM 中已修改的参数可能不同。

1. 检查配置、机构参考和航向资格；请求停车并等待反馈确认，松开夹爪。
2. Z 到观察高度、X 到预备位置，收到机构到位反馈后发送选定颜色的 B2 请求。
3. 等待首个新有效坐标，进入底盘与 X 协同对准。误差在 STM32 中按 `dx=CX-ref_u`、`dy=ref_v-CY` 重新计算；默认准心 `(334,338)`。
4. 每个可用控制周期至少间隔 100 ms；正常对准只用新有效坐标计算速度，底盘上限默认 20 mm/s，X 上限 5 mm/s，并保留航向控制。
5. 默认双轴误差均在 ±5 像素内，机构和底盘满足静止反馈，至少 3 次新有效坐标且持续 200 ms 后进入 `SETTLE` 并再次请求停车。
6. 停稳后重新积累新坐标稳定证据。`align` 进入 `HOLD/aligned_wait_check` 等待验收；`pick` 在相同到点门槛通过后开始 Z 下降、夹取、提起、转向、放置和回提。

正常阶段没有“只回复三次”的限制，也没有整任务固定耗时截止。`SETTLE` 中新坐标再次出容差，允许重新对准，默认 `retries=2`；它与漏检恢复次数独立。

## 漏检与次数限制

| 条件 | 当前实现 |
|---|---|
| align 对准中，离目标较远，出现合法 `Valid=0` | 进入宽限状态，按上一次速度逐步减速，不立即请求停车 |
| align 超过 100 ms 没收到新有效坐标 | 也视为视觉间断，宽限计时从上一次接受的有效坐标接收时刻开始 |
| 宽限期内恢复 | 必须在默认 250 ms 截止前取得连续 3 次新有效观测；无效报文清零计数，恢复不消耗停车恢复次数 |
| 临近目标、误差方向反转、宽限超时或 SETTLE 中漏检 | 请求停车；默认“临近”指两轴均在两倍容差，即 ±10 像素内 |
| pick 对准中收到合法无效坐标 | 直接请求停车，不进入 align 的宽限状态 |
| 停车后 | 确认停稳才开启 1500 ms 恢复窗口，窗口内取得连续 3 次新有效坐标且反馈仍停稳，恢复到对准 |
| align 停车恢复 | 在窗口内重发原 B2 颜色请求，使最新 vision.py 回到粗定位；pick 保持原请求，不重发 |
| 成功停车恢复次数 | 全任务最多 2 次；已使用 2 次后再遇到需要暂停的漏检，直接 `vision_recover_limit` 并结束任务 |
| 有效坐标超时 | 默认 `age_ms=1000`；USB、总线、反馈和 IMU 异常另有故障判断 |

所以“3”主要是连续观测门槛；用户日志对应的是初始对准加 2 次停车恢复后，第 3 次需要停车时恢复次数耗尽。宽限期中的成功恢复次数没有这一上限。

## 最新视觉源码对现象的解释

采集线程覆盖最新帧，主线程只处理更新过的帧。收到颜色命令后做 HSV 粗定位，双轴误差均不超过 50 像素即切换圆环精定位。圆环定位的颜色、圆度、面积、包围圆填充率和跟踪跳变门槛更严格，粗定位能看到颜色不代表圆环阶段每帧都能通过。

一次圆环漏检就输出 `detected=False`，发送时形成 `Valid=0`；连续 5 个处理帧漏检才退回粗定位。默认请求相机 120 FPS、发送上限 50 Hz，不证明实际处理或有效坐标速率达到该值。发送受主循环限速，因此只有实际发出的无效结果才会触发 MCU；采集超时期间不会拿旧图重复发新坐标。

这能解释一种反复跳变机制：粗定位得到有效坐标，进入圆环定位后受光照或轮廓条件影响漏检，再退回粗定位。此前日志恢复时 `dx=-36,dy=-48` 恰在视觉粗转精的 ±50 像素范围内，与这一机制相容；但 B2 没有阶段字段，不能仅凭这些日志认定当时一定发生了阶段切换，也不能确认旧日志使用的就是本次文件版本。

低帧率会同时放大两个问题：例如实际处理 10 FPS，5 个漏检处理帧约占 500 ms；而 align 的宽限只有 250 ms。5 FPS 的新坐标间隔约 200 ms，也会跨过 100 ms 无新数据门槛，难以在宽限期内积累 3 次新有效观测。恢复窗口中若持续有效/无效交替，连续计数会反复清零。

MCU 的 `rx_seq` 是接收有效报文的本地序号，不是香橙派采集帧号；序号差也不能直接作为恢复观测次数，因为状态机每次看到的最新快照只计一次。B2 不携带远端采集时刻，MCU 只能测接收数据年龄。

## 后续方案建议：本轮未实施

用户提出短时丢失仍沿上次误差前进，符合当前低速、静止目标的连续对准需求。主要需要控制的是旧误差导致的过冲和目标偏离，而不是把每次漏检直接当成整任务故障。

建议 `pick` 与 `align` 共享准备、获取坐标、水平协同对准、漏检过渡、重新获取以及停稳确认；仅在确认到位后的动作分叉。两者同步使用已有 B2 重发能力，保持香橙派协议。

- 短时漏检：保留任务，以最后有效误差形成的方向/速度做低速延续；可减速或用位移反馈预测剩余误差，新有效坐标到来后立即重新闭环。延续时长应覆盖实机采集、处理和发送间隔，不能机械套用一个控制周期。
- 反复识别/丢失：不因累计第 3 次波动直接失败；恢复次数可保留为统计。持续无有效坐标则转为暂停等待或重发 B2 重新获取，再继续原任务。
- 重新看到目标：恢复水平运动与允许下降分开。是否继续运动可用较宽的观测条件；下降仍依据新的稳定坐标和真实停稳反馈。若长期无进展，再按任务耗时、位移或人工取消决定退出，参数另行确定。
- 继续使用旧误差时，不应不断把固定误差当作新测量累加移动。静止目标下车体已经前进，实际误差正在减小；应复用受限速度或估计剩余误差。即使只按默认 20 mm/s 举例，250 ms 最多约 5 mm、1 s 约 20 mm 的底盘平移，足以影响最终定位；这只是速度上限的量级说明，不是实车位移验收。

无需为本次容错引入新视觉协议。USB 断开、电机通信/反馈异常、IMU 失效与人工停车保持各自处理，不能与“仍在通信但当前未识别”混为一类。

## 软件验证

已通过源码 SHA256 一致性与 Python AST 语法检查；`usb_camera_test.py` 6 项、`grab_camera_protocol_test.py` 4 项测试全部通过。现有 `grab_grace_test.c` 主机回归和 `camera_usb_test.c` B2 驱动回归编译、运行通过。日志保存在 `.embeddedskills/tests/vision-analysis-20261002/`。

验证范围为本地源码一致性、B2 编解码/请求重启、最新帧采集，以及现有 STM32 宽限状态机；未运行无关的完整构建。结果不代表视觉性能、容错方案或完整 pick 已完成实车验证。
