doinbest/Yachiyo/xjx/模版搭建/docs/开发记录/2026-09-15航向保持串口抓包.md

# 航向保持串口抓包（2026-09-15）

COM23/115200共用服务，新固件task包含mode/target/yaw/omega。上电后重新应用receive模式，四轮反馈正常，imu verify通过，零偏0x006A，无I2C错误。

执行chassis run 50 0 0 19500，名义一米。打开imu stream（约5Hz），同时约每2秒查询chassis task。有效回复mode2，目标0.01°；实际角度-0.13°时omega+0.0027rad/s，-0.32°时+0.0065rad/s，表明已进入保向并输出反向纠偏。

连续日志叠加查询期间出现残缺行；因缺少完整任务回复，脚本中止并通过统一入口请求停车。最终task cancelled，seq185，stage5，error0，locked0。未完成原定20.5秒有限任务，不能作为完整一米验收。停止id3/token1437427750/requested_ms353399，后续独立查询确认tx_complete1。四轮查询全valid、0RPM；单位尚未确认，wheels_stopped仍0/missing_feedback。

中止前MCU时间334776～353399区间，严格匹配完整新鲜角度日志共77条，实际覆盖334776～352376，角度范围-0.50～0.04°，相对目标最大已观察误差0.51°。有数据缺口，因此不宣称真实峰值不超过0.51°；也不与前次无补偿完整一米试验作等条件改善率比较。

停止后的角度存在单独变化，未归入行驶段。无线残缺根因尚未分离；不能直接断言由固件或DL-20单方引起。第一次关闭stream被主机停车锁拒绝；显式resume仅释放主机门控后补发，最终收到OK imu stream=off，info恢复完整。没有重发一米运动。

下次降低采集负载：关闭连续stream，仅低频查询task即可取得目标、角度、补偿量。重试前需用户恢复位置并确认，不自动追加前进。原始抓包 .embeddedskills/logs/serial/heading-meter-20260915-000913.json，其余恢复过程见同时间validation日志。本轮未修改固件。
