doinbest/Yachiyo/xjx/模版搭建/docs/开发记录/2026-09-25路线速度上限与地图布局.md

# 路线速度输入上限与地图布局（2026-09-25）

将实车16段路线 `chassis route start/auto` 的网页输入及固件参数范围同步扩至10～5000 mm/s，默认值仍为50 mm/s。地图页隐藏中央串口终端，地图占用腾出的空间；其他页面保留终端及日志导出，后台串口接收和本地日志记录照常工作。离线地图模拟及底盘页其他测试指令的范围不变。

5000 mm/s 是指令输入上限，不是当前可达到的车速。工程轮速软件上限仍为400 RPM，距离运动加速度仍为100 mm/s²。按暂定80 mm轮径与1:1传动比，400 RPM 的理想轮缘线速度约为1676 mm/s；直行不计航向修正时也无法仅凭此设置达到5 m/s。单段最远约1750 mm，若理想地以100 mm/s²对称加减速，峰值仅约418 mm/s；实际还取决于反馈制动、滚轮滑移和硬件响应。400 RPM 是本工程约束，不等于已核实的 Emm 驱动器物理最高转速。本轮未改轮速上限、驱动器配置和加速度。

验证：固件主机回归通过；网页80项、Python桥接20项通过；Keil `template` 构建0错误、0警告。网页和固件测试验证输入5000被接受、5001被拒绝。未烧录或驱动实车，实际车速待实物测量。

## 同日后续：轮速限幅调整

根据《ZDT_X42S 第二代闭环步进电机用户手册 V1.0.5》第5.3.7节，当前 Emm F6 速度命令字段规定0～3000 RPM；手册的6000 RPM+是空载宣传参数，不能作为本指令的取值范围。将运动层原400 RPM限幅提高到3000 RPM，并让底层整车速度命令共用这个协议上限，代替原底层5000 RPM限幅。保留等比例限幅，不直接删除，以免四轮命令超出文档允许值。默认路线速度、100 mm/s²距离加速度和停车判断均未改变。当前路线最长约1750 mm，按现有加速度理想峰值约418 mm/s，因此本次提高轮速上限本身不会缩短多数短段。电机带载能力、供电与摩擦余量仍需实车测量。

后续验证：固件主机回归通过（含高转速输入被限制为Emm F6的3000 RPM报文边界、C/网页模型一致性）；网页80项通过；Keil `template` 构建0错误、0警告。未烧录或驱动实车。

## 同日后续：缩短自动路线时间

用户希望缩短比赛跑图时间。将距离运动软件加减速度100→1000 mm/s²、位置比例增益1.5→2.5、临近目标限速区50→20 mm且限速20→50 mm/s；已确认停稳后的纠偏仍独立限制为20 mm/s。自动路线的额外换段等待1000→100 ms；网页与固件路线默认输入50→5000 mm/s。独立的`chassis move`诊断仍为50 mm/s。保留250 ms响应预留、反馈年龄计算、10 mm到位容差、500 ms/3组真实停稳确认、故障停车和最多两次纠偏；它们用于判定是否真的停住，不是无条件等待。

延迟反馈主机模型包含100/200 ms采样延迟、120 ms电机一阶响应，不包含轮胎滑移和带载转矩限制。最长1750 mm段设5000 mm/s时，模型峰值约1165 mm/s、总运动与停车确认约4.82秒、最终误差约-7 mm；212 mm短段施加25 mm扰动后仍完成纠偏，最终误差约6 mm。与原参数下1750 mm峰值约403 mm/s相比，软件速度包络明显放宽；模型结果不等于实车成绩。待实物逐段测量位置误差、轮速反馈和停车距离后，才能继续调整加速度或减速预留。

验证：固件主机回归通过，网页80项、Python桥接20项通过；Keil `template` 构建0错误、0警告。未烧录或操作实车。
