doinbest/Yachiyo/xjx/模版搭建/docs/开发记录/2026-09-26-PE9舵机按键测试.md

# PE9 舵机按键测试（2026-09-26）

用户确认夹爪使用 270°舵机，要求用板载四个按键验证舵机。当前 CubeMX 将 PE9 配为 TIM1_CH1 PWM1，TIM1 输入时钟 168 MHz，PSC=167、ARR=19999，周期为 20 ms。夹爪驱动启动通道时 CCR=0，上电不发送有效位置脉冲。

OLED 增加第 4 页 `Servo Test`。PE4/PE5 仍翻页，底盘任务忙时也可退出该页；在测试页，PE2/PE3 首次按下输出 1500 µs，后续分别减/加 100 µs，限制在 1300～1700 µs。离开测试页将 CCR 清零；这只停止有效控制脉冲，不切断舵机电源。总览页原有 PE2/PE3 视觉任务动作保留。按键驱动原有 20 ms 消抖和每次按下单事件机制保留。

脉宽范围仅用于初步判定舵机是否响应及方向，未推定该 270°舵机的实际角度映射，也未覆盖全行程。实测时先卸除或避开可能卡住的夹爪负载，观察中位、两侧小步动作及异常发热/抖动；信号消失后是否继续保持力由舵机型号及供电决定。

软件验证：`python tests/run_firmware_tests.py` 全部通过，包含 OLED 测试页按键、范围及退出清零测试；Keil `template` Target 编译 0 错误、0 警告。日志在 `.embeddedskills/tests/host-tests.log` 与 `.embeddedskills/build/template-template-build.log`。未烧录或进行实物验收。

## 2026-09-27 实测反馈与测试页调整

用户实测：原测试页首次按下输出 1500 µs 时夹爪直接抓紧；1300～1700 µs 范围内夹爪仍保持抱紧。原先“第一次按 PE2/PE3 立即输出中位”的操作会造成意外夹紧，也不足以找松开位置。

测试页改为上电及进入页面均 Off，PE2/PE3 先调节屏上待发送脉宽，PE5 明确切换 On/Off，PE4 退出并清零脉宽。软件可调范围扩至 500～2500 µs，步进 100 µs；这只是当前 `Steer_SetDuty` 可接受的范围，不能视为轮趣科技具体型号或夹爪机构的安全范围。实际松开方向和开合端点仍需逐步实测。原本页内 PE5 翻回总览的操作改为 On/Off；从舵机页按 PE4 返回 Link 页，再按 PE4 可继续返回 Vision、Overview 页。

调整后固件主机回归全部通过，覆盖 Off 状态选值、底盘忙时拒绝开启、开关信号、上下限及退出清零；Keil `template` Target 编译 0 错误、0 警告。仅完成软件验证，未烧录和复测实物。

## 2026-09-27 夹爪开合值确认

用户实测确认：500 µs 最松开，800 µs 完全抓紧，要求固件与上位机统一采用这两个值。`Arm.c` 的 `open` 为 500 µs、`catch` 为 800 µs，`idle` 与 `open` 同为 500 µs；OLED 舵机测试页 PE2/PE3 改为这两个固定值，保留 PE5 明确启停及 PE4 退出清零。网页按钮标注脉宽、命令仍为 `grip open/catch`，手动占空比输入默认改为 2.5%。800 µs 是实际闭合点，不按更大脉宽追求夹紧力。物料抓取可靠性仍需装上实际物料验收。

同步验证：固件主机回归全部通过，网页 Node 测试 81/81、桥接测试 20/20 通过，Keil `template` Target 构建 0 错误、0 警告。新固件尚未烧录；网页显示的脉宽仅在目标板运行本次固件时成立。
