doinbest/Yachiyo/xjx/模版搭建/docs/开发记录/2026-09-27-UART5首次锁定诊断.md

# UART5 首次锁定诊断

## 实车报告与结论边界

- 用户确认 `pos x 10` 向外、`pos x -10` 向内；X 正方向已实测。
- 用户没有点击准备跑图或开启四轮反馈，不能将锁定归因为四轮未上电导致反馈超时。
- 14:39 的日志：`system reset` 仅复位 STM32（`peripherals_not_reset=1`）；14:39:12 `state x` 返回 `raw=0x03 en=1 reached=1`；14:39:14 第二次查询返回 `ERR motor tx bus_locked=1`。没有运动也复现。
- 同轮 IMU 静止验证因 drift_or_noise 失败；它不是该电机总线锁定的已确认原因，不改动 IMU 门槛。
- 空命令被网页长度校验拦截，未发送给 STM32。
- 当前源码已有循环 DMA 接收修复，主机用例覆盖连续收包；但现有日志不能证明板上固件版本，也不能区分 UART 错误、接收溢出、超时和取消。硬件根因尚未确认。

## 本次修改

1. `motor_bus.c/.h` 保留首次锁定原因、MCU 时刻、事务上下文及 HAL UART 错误码。中断里锁存错误码和时间，主循环保存记录；避免接收重启清除 HAL ErrorCode 后丢失证据。
2. `arm_console.c` 在通信失败和 `info` 中打印 `[MOTOR BUS]`；启动及 `info` 打印 `BUILD motorbus_diag=1` 和编译日期时间。
3. 总线超时、锁定条件、停止优先级、迟到应答隔离及恢复前提保持原逻辑。没有自动解锁、重发运动命令、改引脚/时钟或驱动器参数。
4. 诊断是只读 RAM 信息。空闲错误中的 addr/func 是最后事务，不等于该电机造成错误。

## 软件验证

- 新增 `motor_bus_diagnostic_test`：三次正常状态查询、查询结束后的空闲 UART 错误、HAL 清码后的原始错误保留、首次故障不被覆盖、锁定后命令未发送、显式恢复、发送/应答超时、取消和接收溢出。
- 扩展总线测试核对取消查询的 drain_timeout 上下文；扩展实际控制台测试验证诊断输出及版本标识（输出断言先失败，再实现通过）。
- `python tests/run_firmware_tests.py`：完整 PASS。旧 host-tests.log 已另存为带时间的日志；本次日志在 `.embeddedskills/tests/host-tests.log`。
- Keil `template/MDK-ARM/template.uvprojx` / Target `template`：0 errors、0 warnings；Flash 116356 B，RAM 41064 B。
- 产物：`template/MDK-ARM/template/template.hex`；构建日志 `.embeddedskills/build/template-template-build.log`。
- 未烧录、未发送实车命令。仅确认诊断和软件回归通过，不能宣称实车锁定问题已修复。

## 下一次上板采样

1. 烧录诊断版；确认启动出现 `BUILD motorbus_diag=1`。
2. 记录当时四轮与机械臂驱动器的供电状态；不启动路线、视觉运动或四轮采集。
3. 发送两次 `state x`，间隔约 3 秒；若锁定，保留紧随错误的 `[MOTOR BUS]` 行，再发送 `info` 保存编译信息与首次故障。
4. 不重复复位抹掉首次证据。按 reason 判断下一步：UART 错误查具体错误位/线路和 DMA；reply_timeout 查 addr/func 的应答；cancelled_reply 查停止/取消来源；rx_overflow 查异常数据流。

## 14:55 实车诊断反馈

用户烧录诊断版后提供：第一次 `state x` 正常返回 `raw=0x03`，第二次被拒绝，记录如下：

```text
[MOTOR BUS] locked=1 reason=uart_error fault_ms=36320 owner=2 addr=7 func=0x3A active=0 wait=0 uart_error=0x00000004
```

- HAL_UART_ERROR_FE=0x04，已定位为 UART5 帧错误导致隔离；本次不是应答超时或 RX 环形缓冲溢出。
- 锁定处理时 active=0、wait=0；addr=7/func=0x3A 是最后查询，不证明 X 驱动器是干扰源。fault_ms 为 MCU 启动后 36.320 秒，不能直接等同网页日志接收时刻。
- 当前配置为 115200/8N1，PD2 为 UART5_RX、GPIO_NOPULL。没有内部上拉不等于确认悬空；需核对外部驱动方式、空闲电平、供电与接线。
- 已询问这次四轮是否上电，以及 UART5 是 TTL 并接还是经 RS485 转换。待做供电/单驱动器隔离对照，必要时观察 RX 停止位与空闲波形。
- 未据此更改 GPIO、驱动器设置或放宽故障隔离；根本的帧错误来源尚未确认。

用户随后确认：本次四轮驱动器仍未上电，多个驱动器通过 TX/RX/GND 直接共用 TTL 串口。手册第 26 页确有 TTL 多机并接图，不能因此认定并接方式本身错误；但手册图未证明断电节点仍挂在线路上的工作状态可用。目前优先验证未上电节点影响线路电平的假设：全部节点供电后重复只读查询；或全断电后将未上电四轮的 TX/RX 支路从公共总线隔离，再给主控与机械臂上电查询。两种方案选其一，保留诊断版日志，不修改回零参数。

## 14:58～14:59 全部上电对照结果

用户确认全部驱动器上电后恢复正常。14:58:55、14:58:58、14:59:00、14:59:01 的四次 `state x` 均返回 `OK state x raw=0x03 en=1 reached=1`，本组未再出现帧错误锁定。

结合先前四轮未上电、TTL 支路仍连接时的 FE 记录，对照支持未上电节点影响公共 TTL 通信线路的判断；没有波形测量，尚不能指定为某个器件的钳位或反向供电机制。不是四轮反馈查询超时，不需要修改回零参数或自动解除故障隔离。

本车后续测试约定：接在公共 TTL 总线上的驱动器保持上电，未使用的轴不发送运动命令；若单独给机械臂供电，则全断电后先隔离未上电四轮的 TX/RX 支路，保留主控与机械臂正确共地，再上电。此结论验证了本次状态查询恢复，不代表碰撞回零或 Z 轴机械动作已经验收。
