doinbest/Yachiyo/xjx/模版搭建/docs/开发记录/2026-09-27-Z轴安装方向修正.md

# Z 轴安装方向修正

## 依据

用户实测旧固件 `pos z 10` 使 Z 轴下降。旧配置 `MECHANICAL_ARM_Z_POSITIVE_DIR=1`，发送 CCW。因此本次安装的 CCW 对应下降、CW 对应上升；此前按旧安装推导的“Z 上升用 CCW”已被本次实测取代。电机 ID 仍为 6。

## 修改

- `mechanical_arm_config.h` 将 Z 正方向从 1 改为 0，使正输入按 CW 上升、负输入按 CCW 下降。普通位置接口和显式速度位置接口共用这项配置。
- `info` 增加 `arm positive_dir base=1 z=0 x=1 (0=CW 1=CCW)`，便于检查板上固件。
- Base/X 方向、引脚、脉冲换算、运动速度及驱动器参数未修改。
- 上位机仍发送原有正负角度，无需反转网页数值。

## 独立回零参数

`home z collision` 使用驱动器内部的 O_Dir，不使用 STM32 位置方向宏。当前安装向上回零应设 O_Dir=CW，并保留 O_POT_En=Disable 以手动测试。若此前使用 CCW，则回零实际朝下；这可能解释部分现象，但不能仅据此认定先前不动已解决，也未验证碰撞电流参数。

## 验证

- 扩展 mechanical_arm_bus_test，从实际输出帧验证两种位置接口的正负 89 脉冲：ID6、0xFD、正值方向0、负值方向1、脉冲幅值89。旧配置断言失败，修改后通过。
- arm_console_host_test 验证 info 方向输出，通过。
- Keil Target template 编译 0 错误、0 警告；Flash 116420 B，RAM 41064 B。
- 固件 `template/MDK-ARM/template/template.hex` 已生成，未烧录，修改后的实物升降方向尚待确认。

## 上板步骤

1. 烧录新 HEX，用 info 确认 z=0；公共 TTL 总线上驱动器全部供电。
2. 普通运动配置只在 RAM，复位后重新发送 `config z 10 20 0`（10 RPM、加速度20、保留Z的0脉冲上限配置）。默认普通速度仍为原有2000 RPM，不用默认高速做首次方向验证。
3. 有上下余量时分别发送 `pos z 10`、`pos z -10`，每次停稳后继续，核实正上负下。
4. 在驱动器上将 O_Dir 设为 CW 后，再单独测试 `home z collision`。其 accepted 仅代表受理；是否向上运动、端点识别和重复性需实测。
