doinbest/Yachiyo/xjx/模版搭建/docs/开发记录/2026-09-27-Z轴普通升降默认500RPM.md

# Z 轴普通升降默认参数调整

## 需求与修改

用户选择将 `config z 500 120 0` 固化到程序。`mechanical_arm.c` 的 Z 轴初始化配置由 `{2000U, 20U, 0U}` 改为 `{500U, 120U, 0U}`：速度上限 500 RPM、Emm 加速度档位 120、单次脉冲数无限制。该限制不提供机械行程保护。

上电及 STM32 复位后使用此默认配置；运行期间 `config z` 仍可临时覆盖。普通 `pos z` 使用该配置，显式指定速度的 `MechanicalArm_PositionEx` 使用调用方参数。碰撞回零仍由驱动器保存的 `O_Vel` 等参数控制。此前方向修正记录中的 2000 RPM 为历史状态，由本记录替代。

## 验证

- 在已有机械臂总线测试中核对 Z 正负方向位置报文的速度与加速度字节：修改默认值前按预期失败，修改后通过；显式速度接口仍发送其自身的 10 RPM / 20 参数。
- `mechanical_arm_bus_test`、`arm_console_host_test` 通过，日志追加至 `.embeddedskills/tests/host-tests.log`。
- Keil Target `template` 构建通过，0 errors、0 warnings；Flash 116420 B、RAM 41064 B。
- 产物：`template/MDK-ARM/template/template.hex`、`template.axf`。尚未由 Codex 烧录或完成实物验收。

## 通信现象

用户报告重新连接上位机后通信恢复。此前有 Z 应答超时及 UART5 FE 帧错误；重新连接与恢复的因果关系尚未确认，本次没有修改总线锁定、恢复或重试逻辑。

## 上板确认

烧录本次固件后，使用 `config z` 查询，应显示 `rpm=500 acc=120 limit_pulses=unlimited`。普通运动保持正值上升、负值下降。实际速度、位置误差及到位状态仍需实测。
