doinbest/Yachiyo/xjx/模版搭建/docs/开发记录/2026-09-21控制台与历史代码清理.md

# 2026-09-21 控制台与历史代码清理

## 目标与实际范围

按用户确认的清理计划，将现行入口统一为 STM32 `template/`、香橙派 `orange_pi/change.py` 和 `upper-computer-web/local-car/`。用户负责需求、建议、关键取舍与实物验收，Codex 负责全部设计、编码、集成、软件验证和文档；该长期规则已写入根 AGENTS.md。

本次没有修改运动控制算法、引脚、时钟或通信参数，没有连接串口、烧录、复位或发送实车指令。未操作远端站点；原有未跟踪的串口抓包记录、截图及 `.embeddedskills/backups/` 保留。历史源码依赖 Git 追溯，没有向活动工程复制备份。

## 删除项与替代入口

| 删除内容 | 替代或现状 |
|---|---|
| 外层 React/Vinext app、资源、构建、数据库示例、依赖清单、模板测试、站点关联配置和构建归档 | `local-car/start.cmd` 与 Python 共享服务；网页业务文件未改动 |
| `orange_pi_link`、`robot_task`、`robot_safety`、`competition_task_code` 及对应头文件 | 旧 CRC/最小任务框架未进入当前 Target；当前使用 Camera USB B2、QR 和现有业务任务 |
| `jy61p`、`jy61p_show` | 当前 HWT101 I2C 驱动及 OledUi |
| `screen_verify` | 当前 ContestScreen/TJC 屏幕模块 |
| `hwt101_drift`、`hwt101_store` | HWT101 原生标定与本次启动静止验证；W25Q128 驱动及启动识别仍保留 |
| 旧 MaixCam 和 Zigbee PID 目录 | 当前 USB B2 与 USART1 文本控制台 |
| `chassis_key_test`、`hwt101_show` | 无当前调用，已同时从 Keil/EIDE 文件清单移除；保留当前按键与 OLED 业务 |
| B3 相机、视觉启动和标定 C API | 当前仅 B2 颜色识别与对准；文本 B3 命令继续明确拒绝 |
| 旧任务码、软件漂移、Flash 参数存储测试，以及 CRC 帧工具/测试 | 仅删除已退役功能的专用覆盖，保留当前功能回归 |

保留当前 `Arm` 夹爪、`mechanical_arm`、`mecanum_chassis`、MaterialVision、旧速度/单轮调试、Flash 启动检查及 IMU 诊断，它们仍有实际用途。

## 接口与文档调整

- 删除 `Camera_RingTypeDef`、`Camera_RingStart`、`ArmVision_CalibrationStart`、`ArmVision_RingStart` 和 B3 专用枚举项。`ARM_VISION_JOB_PICK_MATERIAL` 与 `ARM_VISION_CALIBRATION_MATERIAL` 显式保留数值 2，B2 的 `material` 文本保持不变，历史来源索引 1 留作 reserved。
- 控制台仍返回 `ERR Unsupported B3`；测试覆盖 `vision calib 1`、`vision ring 1`、`camera ring 1` 被拒绝且不触发相机或电机调用。
- `tests/run_firmware_tests.py` 不再调用退役 CRC 工具测试；其余有效用例保留，视觉测试增加现行编号及来源文本检查。
- 根 README 改为使用入口；AGENTS 更新授权、主动改进和开源借鉴规则；开发规范同步协作方式。
- 控制台 README 改为操作手册，明确网页 COM23 默认与 CMD `--serial-port`、工具配置的区别；不把软件默认端口当现场识别。
- [现行协议](../上位机协议.md)集中描述 ASCII、B2 边界、二维码、遥测和停车；旧 `#` 格式迁至[历史网页协议](历史Zigbee网页原型协议.md)。旧 IMU、CRC 和迁移记录增加状态提示，保留当时事实。

## 验证结果（2026-09-21）

| 检查 | 清理前 | 清理后 |
|---|---|---|
| JavaScript 控制台回归 | 61/61 | 61/61 |
| Python 共享串口桥接回归 | 15/15 | 15/15 |
| 固件主机回归 | PASS | PASS，包含 C/浏览器地图与遥测合同 |
| Keil `template` | 增量构建 0错误/0警告 | 全量 rebuild 0错误/0警告 |
| Keil/EIDE 文件路径 | — | 文件清单解析后均存在，无删除项残留 |
| 活动源码及测试旧模块引用 | 清理前存在 | 已移除，历史文档名称保留 |

无硬件浏览器验收使用临时回环服务 `127.0.0.1:8766`：机械臂、底盘、视觉、二维码、系统、地图六页均正常显示；未连接时实车动作按钮禁用。10 倍速运行默认理想 16 段离线路线，显示“模拟路线结束，外框已进入原启停区”，最后停车位姿 `(2250.0,150.0,90.0°)`，页面 TX=0；浏览器错误日志为空。没有修改浏览器主题或收藏。

独立只读审查未发现阻断项或活动功能误删；修正了协议文档中 IMU 兼容命令的完整写法。修改文档的本地链接及 `git diff --check` 检查通过。工作在用户指定目录原地完成，未创建提交；删除内容仍可通过当前 Git HEAD 追溯。

日志位于项目 `.embeddedskills/`（不提交）：

- `tests/cleanup-baseline-firmware.log`、`cleanup-baseline-web.log`、`cleanup-baseline-bridge.log`。
- `build/cleanup-baseline/template-template-build.log`。
- `tests/cleanup-final-firmware.log`、`cleanup-final-web.log`、`cleanup-final-bridge.log`、`cleanup-final-keil.json`。
- `build/template-template-rebuild.log`。

## 验证边界

本次证明软件构建、主机回归和离线页面保持可用，不证明当前硬件连接、驱动参数、IMU 标定、无线停车或真实路线已通过验收。EIDE 检查范围是工程文件路径，本轮未执行 EIDE 构建。后续上板须先核对实际串口、驱动应答模式、轮向、位置单位及 IMU 状态，再按最小运动与停车步骤测试。
