doinbest/Yachiyo/xjx/模版搭建/docs/开发记录/2026-09-14起步航向保持补偿.md

# 起步航向保持补偿（2026-09-14）

## 实测依据与 Git 基线

用户尺量上一轮名义1米前进，反馈“几乎完全一致”。继续使用轴距210mm、轮距240mm、轮径80mm、传动比1，不改变数值；该试验支持直行综合距离比例，不单独证明轴距/轮距、转向比例或每圈反馈单位已确认。原测试未启用航向保持，IMU前后0.03°→-1.32°。

修改前 Git 提交：5e1c769（chore: snapshot vehicle firmware before heading hold integration）。此快照包括此前尚未提交的工程/网页/测试/文档，保留作者工作；不收录串口运行日志、临时备份或编译产物。后续功能提交可直接与此基线比较。

## 最小改动

`chassis run vx vy omega hold_ms`：当omega为0时，选择新增HOLD_CURRENT模式，在MCU接受任务时只捕获一次经过验证、新鲜的HWT101航向，后续复用原航向PID纠偏。前进、后退、横移共用同一控制器，不重复造PID。没有有效IMU则拒绝；运行中IMU失效、采样或调度超限时沿用停车流程，不降级到开环。

当omega非0时，保留主动给定角速度模式；两种旋转控制不会叠加。原显式`chassis heading`和地图距离任务保持原语义与锚点约束。新增起步保向不要求地图锚点，不设置原点、不改单位，也不接入视觉任务或旧持续速度入口。

仍使用20ms计算、100ms同步发送、半余弦起停、统一轮速缩放、整数RPM。PID参数继续使用Kp=0.02、Ki=Kd=0、输出限幅0.15rad/s、HWT角度符号+1。这些参数和纠偏方向仍需上板验证；整数RPM会影响小偏差时的纠偏分辨率。

`chassis task` 新增mode、target_deg、yaw_deg、yaw_valid、omega：mode=0给定角速度，mode=1显式目标航向，mode=2锁定起步航向。yaw_deg为带符号模块展开角度，target_deg为等价包角目标，不是地图角度；有效性必须看yaw_valid。完成后的omega可能是最后一次规划值，停车状态与轮速另看现有字段。

网页改为“自动保向 / 转向”，表单说明角速度0的IMU前置条件，更新资源版本。没有增加额外必点按钮。

## 验证

- 新增测试先因缺少HOLD_CURRENT能力失败，再通过：无地图锚点的起步锁定、正反向、横移、±180°展开、IMU无资格/过期拒绝或停车、非0角速度保留原模式、禁止两种旋转控制叠加、状态字段。
- 复用已有真实PID及异步电机总线测试；运动单元测试用PID替身检查接入，不能冒充实车纠偏方向验证。
- 网页61项测试通过；Keil template 0错误0警告。固件完整回归含C/网页合同，结果见.embeddedskills/tests/host-tests.log。
- 本轮没有烧录、发送运动命令，补偿效果尚未实测。

## 上板步骤

烧录后静止执行imu verify，通过后确认原有receive应答配置与四轮通信。先执行chassis run 20 0 0 1000，再查询chassis task：mode=2且target_deg应为起步角度。观察纠偏是否减小偏航，再对照前后各一次短测试。最后在前方空间允许时复测chassis run 50 0 0 19500，并尺量距离/侧偏、记录起止角度。chassis stop和CMD Ctrl+C继续可用。无需建立地图原点即可做这些有限时长测试；正式跑图仍需确认位置单位与实际起点。
