doinbest/Yachiyo/xjx/模版搭建/docs/开发记录/2026-09-11工程整理与OLED三页.md

# 工程整理与 OLED 三页使用说明

本轮按已确认计划直接实施。当前入口为 `template/Core/Src/main.c`，Keil Target 为 `template`。通信引脚、USB B2 帧、串口波特率和 I²C 速率保持迁移配置。

## 找代码的位置

| 想修改的内容 | 当前文件 |
| --- | --- |
| 启动顺序、模块调用、扫码后选项、按键业务分派 | `template/Core/Src/main.c` |
| OLED 三页文字、页切换、刷新和错误提示 | `template/App/oled_ui.c/.h` |
| SSD1306 I²C 与 ASCII 字库绘制 | `template/Hardware/oled.c/.h` |
| PE2～PE5 消抖和单次按下事件 | `template/Hardware/key.c/.h` |
| USB B2 请求、拆包、最新快照与通信统计 | `template/Hardware/Camera.c/.h` |
| Base/X 机械臂视觉标定和对准 | `template/App/ArmVision.c/.h` |
| 底盘参与的搜索、标定和 X 轴对准 | `template/App/MaterialVision.c/.h` |
| 三轴默认参数、异步电机命令和应答 | `template/App/mechanical_arm.c/.h` |
| 三轴方向与角度/脉冲换算 | `template/App/mechanical_arm_config.h` |
| 夹爪 | `template/App/Arm.c`、`template/Hardware/Steer.c` |
| 控制台命令和异步输出 | `template/App/arm_console.c/.h` |
| HWT101 I²C 采集与角度缓存 | `template/Hardware/hwt101_i2c.c/.h` |
| 串口屏业务 / USART3 收发统计 | `template/App/contest_screen.c` / `template/Hardware/tjc_screen.c` |

只新增了 `oled_ui` 一组业务文件。底层显示驱动保留原位置。历史 `orange_pi_link`、`robot_task`、`robot_safety`、`screen_verify` 等文件保留，但未进入当前 Target。`chassis_key_test`、`hwt101_show` 是保留的旧测试入口，当前主循环不调用它们。

## 主循环与数据流

初始化外设和模块后，主循环依次处理 USB 字节、机械臂应答、两套视觉流程、底盘速度刷新、HWT101 采集及日志、控制台、串口屏、二维码、按键，最后刷新 OLED。电机事件仍按原方式分发。

`Camera_Process()` 发布共享快照。ArmVision、MaterialVision、控制台、OLED 分别读取快照，两套控制任务用各自序号去重。读取不会清除其他模块的新数据，也不会发起新识别请求。

`Camera_DataGet()` 保留兼容语义：消费它自己的新数据通知。`ArmVision_DataGet/Peek()` 保留旧接口，其历史缓存不能单独用来判断当前目标有效性。新代码优先读 `Camera_SnapshotGet()`。

`HWT101_Process()` 独立负责最短 10 ms 读取和未就绪时每 1000 ms 探测，单次 I²C 超时保持 5 ms。`HWT101_Angle_Get()` 和统计接口只读缓存；删掉日志调用、翻页或多次查询都不会改变采集次数。日志仍按 200 ms 输出，数据年龄超过 300 ms 时停止输出旧角度。

这些周期是调用时的间隔限制，不保证主循环实时周期。

## 已修正的运动流程

- 物料标定顺序：基准采样 → 底盘前移 → 稳定等待 → 前移采样 → 返回 → X 基准采样 → X 外移 → 稳定等待 → X 采样 → X 返回 → 响应检查。
- 每次进入新采样组时跳过已经发布的旧帧，运动期间缓存的坐标不会计入稳定后的新采样组。
- `|Dx| > 15` 时优先调整底盘；窗口内 `Dy` 未达标时调整 X；`Dy` 达标而 `Dx` 未达标时继续调整底盘。`Dx=10、Dy=0` 不再误报零修正。
- 完成仍要求 `Dx/Dy` 均在 ±1 像素内，连续满足原有 3 组条件；每组 5 帧中值。
- 标定持续时间由距离/速度计算并保存；普通修正 200 ms，累计位移估算使用同一持续时间。
- 电机脉冲换算使用机械臂配置常量；原 PID 系数、符号和输出限幅保持不变。
- 电机发送失败、忙、参数错误、到位超时、X/底盘行程限制、USB 未配置、摄像头忙等分别记录。底盘发送失败显示 `Chassis tx`。
- 两套视觉任务的启动入口均先检查对方和共享电机忙状态，拒绝后不切换摄像头目标、不启动电机。
- **Z 轴默认加速度从 500 改为 20**。原字段为 `uint8_t`，旧值会截断为 244。本轮是实际运动参数变更，需单独上板验证。Base/X 参数保持原值。
- `Mecanum_VelocityRefresh_Stop()` 只停止周期刷新；`Mecanum_Test_Stop()` 才发送实际停车命令。UART 电机发送宏改为 `Emm_UartSendCmd`。

**测试模式保持：**`MATERIAL_VISION_TEST_NO_TIMEOUT` 仍为 `1U`。物料任务不会因为首帧等待、丢失、数据过期或任务高层时间自动退出。原电机应答、到位、回零超时和 ArmVision 超时保持有效。上板测试继续使用既有手动停止命令。

## 三页布局

6×8 ASCII，每屏 8 行、每行最多 21 字符。以下是布局示例，不是上板截图。

```text
1/3 Overview Test
123+231+312+321
Item:2 Color:Blue
Task:Arm Align
Usb:On Vis:Ok
Yaw:+123.4 Ok
Err:None
2:Run 3:Sel 4<5>
```

任务码完整显示；未扫码显示 `Code:Waiting`。`Item` 为第二组第 1～3 项，`Color` 为准备选中的颜色。`Task` 区分标定、机械臂对准、物料回零、搜索、对准、完成及错误。姿态未取得或过期时显示 `Yaw:--- Wait/Stale`。

```text
2/3 Vision Test
Target:3 Blue
Cx:0334 Cy:0338
Dx:+012 Dy:-008
Age:120ms Vis:Ok
Ref:Ok Cal:Ok
Err:None
4:Prev 5:Next
```

`Target` 是实际请求目标，可能不同于总览页准备选择的颜色。没有请求显示 `Target:None`。只有当前目标新鲜有效时显示坐标；其他状态显示占位符。`Age` 是最近当前目标报文年龄，含 `Valid=0`；历史有效坐标仍可通过控制台诊断。`Ref` 为机械臂参考；`Cal` 对应最近启动的视觉任务，完成后仍保留该任务的标定结果。上电默认查看 ArmVision 标定，物料任务完成后不会误切回另一套标定。

| Vis | 意义 |
| --- | --- |
| Idle | 无请求 |
| Off | 有请求，USB 未配置 |
| Wait | 有请求，尚未收到当前目标有效协议报文 |
| Ok | 最近当前目标报文有效，年龄不超过 1200 ms |
| Lost | 最近报文明确 `Valid=0`，年龄不超过 1200 ms |
| Stale | 最近当前目标报文超过 1200 ms 未更新 |

`Usb:On` 只表示 USB 已配置，不能代替 `Vis`。`Lost/Stale` 为显示和诊断状态，不新增物料任务自动停车。

```text
3/3 Link Test
Usb:On Rx:1234
Vis:Ok Age:120ms
I2c:Ok Err:0
Sum:0 Drop:0
Screen:T12 R3
Err:None
4:Prev 5:Next
```

`Rx` 是 USB 接收字节累计数；`Sum` 是视觉候选帧校验失败数；`Drop` 是接收缓冲区溢出次数；I²C `Err` 是 HWT101 读取错误累计数。

**布局小调整：**串口屏行使用 `T/R`，分别表示 DMA 发送完成数、完整接收帧数。这样两个计数均显示 `9999+` 时仍不超过 21 字符。发送完成不代表屏幕在线。所有大计数和年龄使用 `9999+` 上限标记；完整值通过控制台查看。未启用的雷达不显示在线状态。

## 按键与错误

| 引脚 / 事件 | 总览页 | 其他两页 |
| --- | --- | --- |
| PE2 / KEY_EVENT_PE2 | 检查任务码、忙、参考和标定后启动机械臂对准 | 无业务动作 |
| PE3 / KEY_EVENT_PE3 | 空闲时循环选择第二组项目 | 无业务动作 |
| PE4 / KEY_EVENT_PE4 | 上一页，循环 | 上一页，循环 |
| PE5 / KEY_EVENT_PE5 | 下一页，循环 | 下一页，循环 |

20 ms 消抖，长按只触发一次。主循环只取一次按键事件。任务运行中允许翻页，不能用 PE3 改选项目。翻页不切换摄像头目标，也不改变任务和选色；不增加按键停车功能。

三页共用 `Err` 行，错误不强制跳页。启动拒绝显示简短原因；任务错误保留到明确停止或新的任务成功启动，翻页不清除。

`oled_ui` 每 200 ms 生成显示内容，正常运行只发送改变的行，每圈最多一行。切页将全部行标记待更新，不先清屏。显示初始化失败不阻止其他模块；初始化或运行发送失败后，每秒最多重试一次，成功后继续待刷行。

## 当前控制台命令

USART1 / Zigbee，115200 8N1，ASCII、回车结束。原有轴控制、夹爪、底盘命令及异步提示格式保留，`help` 查看完整列表。

| 命令 | 作用 |
| --- | --- |
| `camera material 3` | 仅请求蓝色识别和坐标跟踪，不启动运动 |
| `vision ref` | 确认已由作者手动到达的机械参考姿态 |
| `vision calib material 3` | Base/X 视觉标定，需要有效参考 |
| `vision material 3` | Base/X 机械臂对准，需要参考和标定；PE2 调用同一任务 |
| `vision calib chassis 3` | 底盘前后 + X 响应标定 |
| `material auto 3` | 底盘参与的物料搜索与对准 |
| `camera status` | 实际请求、目标有效性、年龄、历史坐标、USB 和接收统计 |
| `imu status` | I²C 就绪、缓存角度、新鲜度、读取次数、错误数 |
| `screen status` | 发送完成、完整接收帧、溢出、串口错误、发送忙状态 |
| `vision status` / `material status` | 对应任务与标定状态、错误 |
| `camera stop` | 仅识别请求停止；视觉任务忙时按原规则拒绝 |
| `vision stop` / `material stop` | 按现有命令停止对应视觉流程 |
| `stop all` | 保留原全轴停止入口 |
| `chassis stop` / `wheel stop` | 保留原底盘停止及忙状态限制 |

颜色 1 红、2 黄、3 蓝、4 绿、5 黑、6 浅蓝。旧 `vision calib <1..3>`、`vision ring <1..3>` 对应不支持的 B3，已从正常帮助移除，收到时明确返回 `Unsupported`。USB 未配置、发送忙、发送失败分别报告。

三个新增 `status` 命令只读缓存，不改变任务或发起 I²C/摄像头请求。`config` 修改 RAM 中后续位置命令的参数，复位恢复默认；角度、速度、加速度和脉冲上限单位与旧命令一致。

## 软件验证与上板清单

主机测试入口：`python tests/run_firmware_tests.py`。测试使用假时钟与接口桩，运行实际 C 解析/流程/显示逻辑；不代表真实运动效果。日志：`.embeddedskills/tests/host-tests.log`。

覆盖：标定往返全流程、±1/±15 及交接窗口边界、距离变化后的持续时间、任务互斥、原超时保留、USB 有效/无效/过期/忙、缓存多读者、I²C 采集与日志分离、按键消抖、三页数值边界及异常重试。控制台测试通过真实字节输入检查 CRLF、异步提示、单位换算、忙状态、停止、历史坐标、完整计数和物料异步错误仅输出一次。

最终软件检查（2026-09-11）：

| 检查 | 结果 |
| --- | --- |
| 7 组 C 主机程序，GCC `-Wall -Wextra -Werror` | 全部编译并运行通过 |
| Python USB 协议、CDC 持久发送缓冲、帧工具及命令检查 | 全部通过 |
| Keil `template` 全量 Rebuild | **0 errors、0 warnings**；Z 加速度截断警告消除 |
| Keil / EIDE 文件引用 | 89 / 86 个引用均存在；EIDE 未执行构建 |
| 构建日志与产物 | `.embeddedskills/build/template-template-rebuild.log`；`template/MDK-ARM/template/template.hex`、同目录 AXF |
| 烧录、实物显示与运动 | 尚未执行 |

控制台帮助按命令组分段发送，避免整份帮助超过 115200/8N1 在原 100 ms 发送超时内可完成的长度。物料任务异步失败会输出一次 `ERR material reason=...`，翻页不影响该记录。

Keil/EIDE 仅增加 `oled_ui.c/.h` 引用，没有重新生成 CubeMX 或改变硬件分配。未提交 Git。

上板尚未执行，顺序如下：

1. OLED 三页、翻页、未扫码/无数据提示；分别检查 Zigbee、USB、二维码和 HWT101。
2. 单独验证 Z 加速度 20，记录起停与运动现象。
3. 分别执行机械臂视觉和底盘视觉标定及单次对准，核对方向、响应和最终误差。
4. 检查断 USB、目标消失、I²C 读取失败和 OLED 无应答；确认测试模式手动停止有效。
5. 单项验证后再考虑完整搬运流程；本轮不实现比赛路线、自动抓放、雷达、USB 自动重连或中文字体。

所有烧录和电机动作仍需实际硬件参数及明确操作授权。当前完成的是软件修改与软件验证，上述硬件结果不能写作“已通过”。
