doinbest/Yachiyo/xjx/模版搭建/docs/开发记录/2026-09-12COM23共用控制台与软件停车.md

# COM23 共用控制台、一键准备与软件停车

## 交付范围

本轮以现有底盘、地图、无线遥测限速和 10 秒 IMU 验证为基础。Python 服务统一管理 COM23（115200、8N1），网页和 CMD 共用事件流。没有更改 CubeMX 外设参数，没有写入驱动器持久配置，没有自动烧录。

网页的“本车配置”需要作者先核对应答模式、协议位置单位和四轮方向。保存位置为 `.embeddedskills/local-car.json`，默认没有已确认参数。“准备跑图”复用这些确认信息配置 MCU RAM，并依次检查反馈、IMU 和人工确认的地图起点。准备本身不会运行路线。

## 停车语义

CMD Ctrl+C 保留窗口，撤销未发送命令和网页准备，优先请求停车并锁定新的运动命令。`quit` 先停车再退出。原始 `0x03` 和文本停车共用固件入口；查询使用 `chassis stop-status`。

回复字段：

```text
OK chassis stop id=N token=N requested_ms=N tx_complete=0 wheels_stopped=0 reason=pending_tx
```

`id` 为 MCU 停车编号，`token` 用于关联本次上位机请求，`requested_ms` 为 MCU 收到请求的时间。`tx_complete` 表示四轮停车发送流程完成；`wheels_stopped` 只有新的有效四轮反馈满足停止条件才成立。通用 OK 不算停止确认。

停止判据独立于地图原点、目标位置和 IMU：发送完成后，至少三组新反馈覆盖 500 ms，四轮绝对速度均不超过 1 RPM，各轮相邻位置增量换算均不超过 2 mm。仍需已确认的位置单位；旧反馈和过期反馈不能确认停止。

无线失联、强制结束进程或电脑断电时无法保证停车。本功能不替代硬件断电停车手段。

## 本轮实际硬件记录

2026-09-12 20:50，COM23 成功打开。保持原波特率，依次发送关闭遥测、`info`、`chassis stop-status`、`chassis task`、`imu status` 和 `chassis feedback`，约 16 秒内没有收到任何字节。端口已释放，未发送运动命令。

原始证据：`.embeddedskills/logs/serial/bridge-baseline-20260912-205026/`。这只能说明当时没有回复，不能据此区分主控电源、无线链路或固件接收问题。已向作者询问主控与车端 DL-20 上电情况。

## 待上板步骤

1. 作者烧录本轮构建固件；重新启动新版 `start.cmd`，释放其他软件占用的 COM23。
2. 连接后先读取设备信息和 `chassis stop-status`，确认命令回复恢复。
3. 保持静止，观察遥测 60 秒，检查 JSON 完整性和回复延迟，关闭后再查 `info`。
4. 在输入未完成、准备中和遥测中分别按 Ctrl+C，检查准备取消、停车编号、发送完成和反馈结果。窗口应保持运行。
5. 完成方向与四轮反馈检查后，才执行 20 mm/s、保持 1 秒的有限任务；随后检查保持 2 秒任务中途停车。
6. 恢复到右下起点、车头朝上并由作者明确确认后，重新建立原点，再测试 `chassis move 0 100`。记录尺量位移和反馈结果。

本轮软件结果与后续实物结果分别登记；未完成上板步骤不得写为通过。

## 软件验证结果

- `python tests/run_firmware_tests.py`：通过，含新增独立停车测试、原机械臂/视觉/IMU/USB/底盘回归和 C/网页合同测试。
- `node --test upper-computer-web/local-car/tests/*.test.mjs`：61 项通过。
- `python upper-computer-web/local-car/tests/test_bridge.py`：14 项通过。使用假串口与本地 HTTP 服务，验证唯一线程、优先停车、配置保存、输入中断、无重放及准备取消后的迟到请求拒绝。
- Keil `template` Target：0 错误、0 警告；本轮构建产物 `template/MDK-ARM/template/template.hex`。Flash 使用 109296 字节、RAM 使用 38608 字节，以构建记录为准。
- Headless Edge 模拟 HTTP/串口事件联调：1366×768 与 390×844 检查通过。完整执行空配置拒绝、保存已确认配置、MCU 配置应用及回读、实际等待 10 秒验证、起点明确确认、有效遥测、停止锁定与刷新不自动发令。此处所有设备回复均为模拟，不是实车结果。
- 审查后补充两个竞态测试：旧准备 owner 的迟到原点请求被服务拒绝；较旧的解除停止/连接 HTTP 回复不能覆盖新停止/断线事件。相同停车 token 的发送失败结果也保持幂等。

日志：`.embeddedskills/tests/bridge-firmware-tests.log`、`bridge-web-tests.log`、`bridge-python-tests.log`、`bridge-browser-tests.log`、`bridge-keil.json`；Keil 原始日志 `.embeddedskills/build/template-template-build.log`。浏览器截图为 `bridge-desktop.png`、`bridge-mobile.png`。

2026-09-12 21:16 已启动新版交互 CMD 和本地服务，检查到 `connected=false`、无已保存配置、无自动 TX。没有将测试参数写入真实配置文件。

目前**软件通过，真实 COM23 仅完成打开/无回复记录；遥测 60 秒、实物停车和运动均未验收**。已经请求作者烧录并确认上电。现有总线在某些中断同步事务或查询的停车情形下可能故障隔离，停车发送与反馈不完整时必须保留“未确认”，不可放宽反馈条件冒充通过。
