doinbest/Yachiyo/xjx/模版搭建/docs/开发记录/2026-09-14COM23遥测与最小运动复测.md

# COM23 遥测与最小运动复测

用户释放串口后，经本地共用服务连接 COM23（CH340，115200/8N1），未烧录或复位。info 回读正确。应用用户此前确认的 receive 应答模式，未填写未经确认的位置单位。误发 chassis feedback all 被拒绝，随后按帮助改用 chassis feedback 0；反馈轮询开启。

## 实测结果

- 四轮状态、速度、位置均 valid=1,1,1，开始时全部0 RPM。IMU ready/fresh/verified/control_ready=1，i2c_errors=0，bias=0x006A。
- 60.08秒遥测：session1416267909，配置1帧，状态29帧，JSON错误0，到达间隔1.883496～2.0922秒，dropped=0。关闭后 info 正常回复。
- 遥测 yaw.valid=false 是当前字段要求地图锚点有效，不能解释成 IMU 掉线。units=0、原点未设置，地图反馈位姿不可用。
- 静止统一停车：发送原始0x03、文本及令牌命令，同CMD Ctrl+C入口。token2420470547，最终id3，tx_complete=1；units=0导致停止位置增量条件不能评价，wheels_stopped=0/reason=missing_feedback，主机6秒提示未确认。
- 有限前进 chassis run 20 0 0 1000：回读 timed_complete，dt_ms20，seq20，stage5，error0，locked0。前后位置[-9,5,5,3]→[7973,8007,-7953,-7979]，增量[7982,8002,-7958,-7982]，最终四轮0 RPM。IMU约0.01→-0.04度。20mm/s与约30mm位移是命令/名义值，未用尺量验证。
- 再提交 chassis run 20 0 0 2000，收到受理后约0.35秒触发统一停车；实际相对MCU启动时间受无线回复延迟影响，未宣称精确0.8秒。token2037977889，最终id6，requested_ms443212，tx_complete=1。task cancelled，seq25，error0，locked0。
- 停止后两份新反馈MCU约453xxx/457xxx ms，均四轮0 RPM，位置[8745,8829,-8825,-8903]→[8747,8829,-8825,-8903]。读取继续，无总线锁死；单位未确认，因此仍不能判定完整停止验收通过。此次使用同一软件入口，未模拟Windows键盘按键本身。
- 末次IMU yaw0.00，ready/fresh/control_ready=1，i2c_errors0。

## 留存状态及下一步

遥测已关闭，串口共用服务继续持有COM23，主机停车锁保留，固件底盘cancelled且四轮反馈0 RPM，反馈轮询开启。没有设置位置单位、地图原点，也未启动路线或100mm定距任务。

后续需要确认实测每圈位置单位，并请用户恢复到右下起点、车头朝上，明确回复后重新建立地图原点。不能由短时移动反推未经尺量/圈数核对的位置单位，也不能以IMU角度代替XY位置确认。

原始日志在 .embeddedskills/logs/serial/，遥测汇总为 telemetry-60s-20260914-184816.json，其他为同一时段validation日志。

## 18:53 前进/后退追加测试

按用户授权分别执行 `chassis run 20 0 0 1000` 和 `chassis run -20 0 0 1000`，每段之间查询完成状态、四轮零速及IMU；正常完成后才进入下一段。各段起停各500ms、保持1000ms，名义位移各约30mm，未尺量。

前进位置增量 [7976,7990,-8030,-7978]；后退 [-7934,-8010,7994,7946]。四轮方向符号均反转，两段均timed_complete、dt_ms20、error0、locked0，最终四轮valid=1,1,1且0 RPM。起始IMU0.01°，前进后0.01°，后退后0.03°，i2c_errors0、control_ready1。两段累计位置增量[42,-20,-36,-32]为协议原始单位，不能换算实际误差或断言回到起点。

原始汇总 `.embeddedskills/logs/serial/forward-backward-20260914-185303.json`。当前固件为定时任务完成，遥测关闭，轮询开启，串口仍由共用服务持有。未发送正式路线命令。

## 18:57 名义一米前进测试

用户要求向前走1米。执行前明确说明位置单位尚未确认，只能做定时名义距离测试，实际需尺量。静止前置检查通过，发送 `chassis run 50 0 0 19500`，50 mm/s，保持19.5秒，起停各0.5秒，名义速度积分1000mm。没有地图原点或航向闭环，没有自动返程。

运动中六次四轮查询全部有效，瞬时RPM幅值约7～15，四轮采样不同步，不直接判定同一时刻轮速差。完成后 task timed_complete，dt_ms20，seq270，error0，locked0。四轮均0RPM。原始位置增量[260968,261240,-261354,-261078]，幅值最大差386，约均值0.15%。这些数值不作为每圈单位已确认的依据。

IMU查询前0.03°、结束后-1.32°，前后差-1.35°；包含两次查询间全部运动和静止时段，不能当作重新测得的静止零漂。i2c_errors0，control_ready1。本任务直接给omega=0，没有使用航向保持补偿。实际前进距离与横向偏移待用户尺量，不能报告精确到达1米。

日志 `.embeddedskills/logs/serial/forward-meter-20260914-185726.json`。当前任务已结束，无后续运动排队，遥测关闭、四轮反馈轮询开启。
