doinbest/Yachiyo/xjx/模版搭建/docs/开发记录/2026-09-14COM37功能验证.md

# COM37 功能验证

## 连接和测试边界

作者确认已烧录并上电，允许无需另行提示地执行最小运动验证，但正式跑图前须提示准备。重新扫描识别到 COM37（USB-SERIAL CH340，VID 1A86/PID 7523）；COM17 为 Horco 下载器附带串口，COM3/4 为蓝牙端口。

通过本地共用服务连接 COM37、115200/8N1，未直接抢占网页串口。`info` 返回本工程 USART1/UART5 参数、四轮地址 1/2/3/4 和机械臂地址 5/6/7，确认通信对象正确。

没有发送使能、速度、位移或路线启动命令；没有修改驱动应答模式、位置单位、原点，也没有清除故障锁定。

## 实测结果

| 项目 | 结果与证据 |
| --- | --- |
| 普通信息查询 | 多次收到完整 info；持续传输后也出现延迟、缺行，不能据此宣布链路整体稳定 |
| 初始底盘配置 | state=0、ack=0、units=0、locked=0；尚无人工确认配置 |
| 四轮反馈轮询 | 选择全部车轮并启用，只看到轮 1/2 的速度记录；位置和状态均无效，轮 3/4 无有效记录 |
| 停车请求 | 原始 0x03、普通 stop、token stop 均有 MCU 回复；同 token 保持同一 MCU id |
| 停车发送与反馈 | 首次 id=3 显示 tx_complete=1、wheels_stopped=0、reason=missing_feedback；独立停止确认未通过 |
| 停车后底盘状态 | state=4、reason=bus_fault、stage=5、error=2、locked=1；没有绕过隔离继续运动。error=2 对应当前枚举 TX 类错误，不能仅凭日志断言驱动硬件损坏 |
| IMU 10 秒验证 | PASS，run_id=1、verified=1、control_ready=1，101 个样本，max_gap_ms=100、i2c_errors=0，输出 drift_dps=0.00000、rms_deg=0.0000；只是该次短时检查 |
| 遥测 60 秒 | session=948987768，19 条带 @CHASSIS 前缀的行解析失败，0 条有效配置帧/状态帧；存在丢字和跨帧拼接 |
| 关闭遥测 | 第一轮 off 未及时见到受理，后续再次 off 收到回显与受理，之后不再观察到遥测；info 恢复完整回复但仍有延迟 |
| 重启服务后的停车复核 | 请求事件可见，但 MCU 回复超过服务 6 秒时限；正确显示 timeout。随后手动查询的原始日志出现 id=9、tx_complete=1、wheels_stopped=0，不能将迟到回复改写为按时停车确认通过 |

遥测破损已经存在于服务收到的串口原始行中，不是网页渲染造成。尚未取得 MCU TX 引脚与无线链路两端的对照抓包，因此不能断言全部丢字发生在 DL-20 内部。下一步需做 USART1 有线对照或两端抓包。

## 本轮修复的上位机问题

`serial_bridge.py` 将 MCU 停车状态中的 `id` 展开到事件对象，覆盖了递增的事件编号。网页和 `/api/events?after=N` 因此可能过滤掉停车受理、完成、超时或解除锁定事件。

改为事件 `id` 专用于流游标，MCU 停车编号作为事件 `stop_id`；GET status 内的 `stop.id` 保持原协议。修复包括停车事件和解除锁定事件。

新增重现测试：先产生 20 条事件，再接收 MCU id=7 的停止确认，确认该事件仍能被新游标取到。修改前失败（收到 0 条 stop 事件），修改后通过。服务测试 15 项通过，网页桥接测试 9 项通过。本轮未改固件，无需重新烧录。

## 日志与当前状态

- `.embeddedskills/logs/serial/telemetry-60s-20260914-015439.json`：完整 60 秒观测、坏帧和原始事件。
- `.embeddedskills/logs/serial/validation-20260914-*.json`：各轮查询及停车事件。
- `.embeddedskills/logs/serial/com37-final-status.json`：最终服务状态，不包含启动鉴权令牌。

服务已重启加载修复，继续连接 COM37，软件停止锁定保留；未启动运动或正式跑图。当前无法验收最小运动，原因是四轮反馈不完整、总线故障隔离和无线传输异常。已询问作者确认四轮上电、地址、驱动应答模式和实测位置单位；未知项未猜测填入。

## 本轮逐轮复测

通过 COM37 共用串口服务，115200 8N1，只执行底盘状态与反馈查询，未发送运动命令，未开启地图遥测。

- 初始 task：idle，error=0，locked=0，ack=0，units=0。
- 分别选择 1、2、3 号，开启反馈约 3 秒后关闭，再查询缓存与 task。
- 1 号：rpm=0，raw_units=-5，flags=0x03，valid=1,1,1；接收时间 441525/441493/441509 ms。查询后未锁定。
- 2 号：rpm=0，raw_units=-1，flags=0x03，valid=1,1,1；接收时间 491409/491425/491440 ms。查询后未锁定。
- 3 号：没有有效缓存，接收时间仍为零；task 出现 stage=6、error=2、locked=1。
- 4 号：因总线锁定未继续测试，不能判定无应答。

本轮将故障出现范围缩小到切换 3 号后的查询阶段，但 error=2 为发送错误类别，不能据此确定是 3 号驱动器硬件故障。需进一步区分 UART5 发送/错误处理与驱动器地址、接线、应答情况。未清除故障锁，反馈轮询已关闭。原始事件保存于 .embeddedskills/logs/serial/validation-20260914-*.json。

## 重新插线后的四轮共同轮询及静止停车复测

作者确认重新插线，3号单独查询恢复。通过 COM37/115200 共用服务执行四轮轮询，未开启地图遥测，未发送运动指令。

四轮在 MCU 时间约 70.9 s、147.3 s、222.9 s 的快照中均 valid=1,1,1，rpm=0，时间戳持续更新。task 初始及轮询后 error=0 locked=0。电脑串口曾出现 ClearCommError PermissionError 后断开，一次重新连接成功；不能把这一电脑串口异常归因于电机总线。

通过统一 stop 接口测试原始 0x03 与文本停车。此次 token=2598158008、MCU id=3，收到 tx_complete=1；6秒内 wheels_stopped=0 reason=missing_feedback。后续 task state=3 reason=cancelled stage=5 error=0 locked=0 units=0；再次读取四轮反馈均正常。

核对 chassis_motion.c：停止确认要求每圈位置单位匹配配置；当前 units=0 已足以导致 missing_feedback，因此该提示不等于电机未回复。未擅自确认位置单位或驱动应答模式，未启动运动。服务保留停车锁，四轮后台反馈仍开启供监测。

## 完整测试续测：应答配置与零速度有限任务

用户确认驱动器采用 receive，应为 Emm42 固件默认模式。只在 STM32 RAM 中执行 chassis profile receive，回读 ack=2、error=0、locked=0，未改驱动器持久配置。

连续三次间隔约10秒查询四轮，均 valid=1,1,1、rpm=0、时间戳更新，无总线锁定。执行 chassis run 0 0 0 1000 验证有限任务及零速度同步发送路径，结果 timed_complete、dt_ms=20、seq=20、stage=5、error=0、ack=2、locked=0、units=0。不把零速度测试视为实车位移或方向验收。

每圈位置增量仍未实测，尚未启用距离任务或确认轮子停止条件。非零运动、方向、一圈单位、动态停车及100mm定距均待验证。

## 落地最小前向运动测试：未通过后续准入

用户明确授权不架空进行底盘测试。执行 chassis run 20 0 0 1000；任务回读 timed_complete、dt_ms=20、seq=40、error=0、ack=2、locked=0。运动期间四轮均有非零速度及位置反馈。

运动前位置原始值 [1,-3,-1,1]，任务后/追加停车时缓存 [2691,7967,-7987,-7961]，增量 [2690,7970,-7986,-7962]；左前轮明显不同。未确认单位，未换算实测毫米或宣称实际直行。

随后统一停车接口发送 raw03、普通 stop、带 token=2326027653 的 stop；MCU id=6，tx_complete=1，wheels_stopped=0 missing_feedback。最终 task state=4 reason=sync_cache_uncertain stage=5 error=5 locked=1 units=0；4号 speed_valid=0，其余缓存保留，接收时间停在停车请求附近。不能用旧缓存零速宣称停止确认。

停止后续横移、转向及定距测试；服务停车锁保留，未执行 reset-confirmed，未更改固件。优先排查停车取消在途反馈导致总线隔离/锁定及左前轮增量异常。完整运动验收未完成。
