doinbest/Yachiyo/xjx/模版搭建/docs/开发记录/2026-09-14IMU验证前Z轴归零.md

# IMU 验证前 Z 轴归零（2026-09-14）

## 问题与依据

本轮实测原固件 IMU 10 秒验证失败：relative_deg=-0.500、drift_dps=-0.05056、rms_deg=0.0039、i2c_errors=0。失败来自持续角度变化，不是绝对角度偏离零，也不是采样中断。上电时触碰底盘不能单独解释随后静止期间的持续漂移。

用户提供的 HWT101 IIC 协议截图中，CALIYAW 明确为 0x76，写入 0x00 0x00 触发 Z 轴角度归零；末尾 IIC 时序说明数据低字节在前。网页访问失败，依据为本地完整截图。

本地官方上位机 `Downloads/Witmotion(V2026.8.31.0)/Config/CommandPanel/hwt101.xml` 的 `set_z_axis_reset_func` 也使用解锁后发送 `FF AA 76 00 00`，100 ms 指令间隔。该上位机随后发送保存；本轮只需运行时归零，按 IIC 截图中的归零动作执行，不在独立验证中额外保存配置。是否实际归零须上板观察，HAL 成功不等于动作确认。

## 修改

- `hwt101_calibration.c/.h`：验证前新增非阻塞解锁、写 CALIYAW、等待 100 ms 三个步骤。解锁与归零写入间隔 100 ms。归零后丢弃已有缓存样本，从后续新样本开始计时和相对角度拟合。
- `imu verify`、`imu verify 10`、`imu verify 120` 以及原生标定退出正常模式后的验证均经过归零。验证时长仍为完整的 10/120 秒；原生标定后的验证仍为 30 秒。
- 独立验证不写 WORKMODE、GYROBAIS 或 SAVE。原生标定只在既有验证通过条件下保存。漂移速度与 RMS 阈值不变，不扣除软件零偏。
- `imu status` 新增 `zero_requested`、`zero_sample_received`、`zero_before_deg`、`zero_after_deg`。前者只表示写请求成功，后者表示已取得归零等待后的新样本，均不直接宣称归零生效。
- 写失败分别报告 `yaw_zero_unlock` / `yaw_zero_write`，不继续验证或保存。取消保留已有正常模式恢复机制。
- 流程启动撤销航向控制资格；现有主循环 heading_read 会清除地图锚点，定位模块随之撤销原点有效性。运行中的底盘/路线及控制台所检查的机械臂、视觉任务拒绝启动验证。

## 验证与边界

新增主机测试先在旧实现上失败，再通过新实现：归零指令及间隔、失败、取消、归零跳变不参与拟合、单独验证不保存。回归覆盖持续漂移仍失败、跨 ±180°、系统时间回绕、采样中断、原生标定及保存异常。

Keil template 构建 0 错误、0 警告，Flash 109956 字节，RAM 38624 字节。日志：`.embeddedskills/build/template-template-build.log`。固件主机回归结果见 `.embeddedskills/tests/host-tests.log`。

本轮未烧录、未向实物执行归零。新固件烧录后，保持静止运行 `imu verify 10`，结束查询 `imu status`，检查归零前后值及 drift_dps。若仍是 drift_or_noise，执行既有 `imu cal start` 原生零偏标定，再检查验证结果。归零不解决位置单位未确认；重新验证后需重新建立地图原点。
