doinbest/Yachiyo/xjx/模版搭建/docs/开发记录/2026-09-14串口设备识别与静止查询.md

# 串口设备识别与静止查询

作者确认已烧录本轮固件，授权重新扫描串口并开始功能验证。

## 实际结果

- pyserial 扫描仅发现 COM17：USB 串行设备，VID FAED / PID 4873，序列号 7B168F48。
- Windows PnP 枚举进一步确认串口接口描述为 **Horco CDC**，父设备为 **Horco CMSIS-DAP**。它是下载器附带串口，不能仅凭 COM 号将其认定为原来的 DL-20 无线通道。
- 系统另外列出 COM3、COM4 蓝牙标准串行链接；本轮未打开。未发现原 COM23 / CH340。
- 通过本地共用服务打开 COM17，使用已确认的 115200 / 8N1，发送 `info`，观察 6 秒，收到 0 条 RX、没有有效设备回复。
- 随后通过服务断开接口执行停车收尾并释放 COM17。没有收到停车确认，服务结果 timeout、tx_complete=false、wheels_stopped=false。未发送任何运动命令。

没有改动固件、外设参数或驱动配置。新交互 CMD 使用 `--serial-port COM17` 启动，但连接已经释放；后续须按实际重新识别的串口连接，不能沿用网页原来的 COM23 标签猜测设备。

## 证据与下一步

查询日志：`.embeddedskills/logs/serial/validation-20260914-010721-728899.json`。服务原始日志前缀：`20260914-010623-cd426b`。

已询问作者：继续使用 DL-20 并接好电脑端 USB 转串口，还是已将 Horco 下载器 UART 接到 USART1 PA9/PA10。待连接对象明确且 `info` 回复恢复后，继续静止停车和 60 秒遥测检查。本轮尚不能评价新固件的真实遥测或电机功能。
