doinbest/Yachiyo/xjx/模版搭建/docs/开发记录/2026-09-14停车取消反馈查询修复.md

# 2026-09-14 停车取消反馈查询导致总线锁定修复

## 已复现问题

COM37 最小前向任务正常 timed_complete 后，统一停车取消正在等待回复的反馈查询。MotorBus_Cancel 对任何有回复的活动事务一律设置 quarantined，导致反馈停止，最后显示 sync_cache_uncertain/error=5/locked=1。此路径独立于此前3号插头接触问题。

## 本轮变更

仅修改 template/Hardware/motor_bus.c：对 MOTOR_BUS_FEEDBACK 的 0x35/0x36/0x3A 三字节只读请求，取消后保留一个待丢弃回复的地址、功能码、长度与截止计时。优先停车无需等待回复；普通事务在该旧回复完整接收并丢弃前不得发送。分包缓冲在优先停车发送时保留，避免丢失半包。

取消发生于DMA发送中时，保持原缓冲直到发送完成，回复超时从TX完成计时；已经等待回复时沿用原计时。超过原100ms期限仍未收到，继续隔离总线。机械臂/运动事务取消、UART错误、真实超时以及部分同步批次故障保护不解除。未调用或绕过 reset-confirmed。

## 验证

- 新增 motor_bus_test 用例在修改前因取消只读查询触发隔离而失败；修改后通过。
- 覆盖优先停车、跨停车的半包旧回复、旧回复不能完成新查询、取消发生在DMA发送期间、回复缺失仍隔离。
- mecanum_feedback_test 使用独立保存的模拟回复地址/功能码，覆盖反馈等待期间停车，四条停车发送完成后四轮反馈恢复。慢回复场景初始400ms观察窗不足完整12项轮询，改为800ms后通过；有效性阈值未放宽。
- python tests/run_firmware_tests.py：PASS，包含固件回归及C/网页合同测试。
- 最后增加半包跨停车断言后，motor_bus_test 再次PASS。
- Keil template：0 errors / 0 warnings；Flash 109464 bytes，RAM 38616 bytes。
- 构建日志：.embeddedskills/build/template-template-build.log。
- 固件：template/MDK-ARM/template/template.hex。

## 上板复测

本轮未烧录，未再次运动。烧录后先静止开启四轮反馈，再使用统一停车入口；预期没有正常取消导致的locked=1，四轮接收时间继续更新。没有确认位置单位时仍不能声称轮子停止资格通过。

随后再做低速短时前向复测，采集动作前后IMU与轮子反馈。左前轮增量偏小、真实位置单位及方向、动态停车均仍待验证，不能把本软件修复等同于完整底盘验收。

## 重新上电后 COM9 静止复测

扫描识别 CH340 COM9，115200；info及task完整回复。初始 idle/error=0/locked=0。应用作者确认的 receive，开启全部四轮反馈后，仅1、2号速度有效（rx_ms=89086/89101），其余位置/状态及3、4号均无有效缓存。随后 task stage=6/error=2/locked=1/ack=2。已关闭轮询。

本次没有发送运动或停车指令；因此故障发生在普通反馈查询阶段，与上一轮停车取消导致error=5的路径不同。停车修复尚未完成实物验收。此前重新插线后曾四轮正常，本轮再次异常不能仅据日志确定是3号接触、UART错误或其他原因。未清锁、未改参数、未自动复位。

## COM9 新固件完整验证续测

四轮静止反馈全部有效，receive已应用。静止时统一停车：token1783408020/id3，tx_complete=1，task error=0 locked=0，停车后四轮时间戳继续更新；证明本次取消只读反馈的恢复路径上板通过。units=0仍导致停止确认不通过。

前向20mm/s保持1000ms任务正常timed_complete，dt=20ms，seq20，error0 locked0。运动前原始位置[1,1,-3,9]，后[7953,7983,-7983,-7949]，增量[7952,7982,-7980,-7958]。本次未复现左前轮明显偏小。IMU前后-1.29/-1.50度，读数间含约13秒静止及运动，不能全部作为运动偏差。

接着发送前向20mm/s保持2000ms，在主机提交约0.8秒后触发统一停车。token1217585960/id6，MCU requested_ms195502，tx_complete1；task state4 reason sync_cache_uncertain seq29 stage5 error5 locked1。最后轮速缓存[5,4,-5,-3]及接收时间均在停车前，不能据此判断停车后还在转，也不能确认已停。该动作取消发生于部分同步批次，现有保护设计会锁定；与只读查询取消修复边界不同。

未继续横移、转向或路线。未确认真实位置单位，未跑100mm距离；地图遥测60秒复测未执行。须先解决部分同步停车后的只读反馈与恢复问题，不能把实际底盘完整验收记为通过。当前服务停车锁保持。
