doinbest/Yachiyo/xjx/模版搭建/docs/superpowers/plans/2026-10-09-materialvision-retirement.md

# MaterialVision退役与上位机功能保留实施计划

依据用户明确批准的计划执行。执行目录为当前工作区，修改前快照提交为 `23987b7`。保留该提交包含的控制整合和文档修改。

## 范围和接口

删除MaterialVision文件、旧后退搜索、material命令及兼容状态转换。响应采样迁移到grab_calibration，由GrabTask唯一调度反馈、任务和停车；保留原标定参数与模型生命周期。

| 命令 | 合同 |
|---|---|
| grab calib ref | 人工确认当前观察姿态；不运动、回零或覆盖有效模型 |
| grab calib 1..6 | 采样底盘前后及X响应；保持Base/Z/夹爪 |
| grab calib status | 只读阶段、确认、上次有效响应；忙状态及网页停止锁定中可读 |
| grab stop | 取消并走既有停车确认；保留旧模型 |

成功以实际轮位置和X电机角度更新j00/j10、j02/j12，保留j01/j11；失败或取消不提交候选值。普通grab状态与OK grab calib诊断独立解析。旧material命令仅回复退役提示，不转发运动。

## 实施与验证账目

- [x] 核对工作区并提交基线；固件主机、网页485项、Python81项基线均通过。
- [x] 迁移采样、删除搜索及MaterialVision；增加服务和实际GrabTask联动回归。
- [x] 接入固件新入口；查询前置、独立相机输出、OLED统一状态；逐处核对互锁范围。
- [x] 网页三个控件和独立状态显示；浏览器/Python只读与停车分类；更新Keil清单和现行手册。
- [x] 固件全量主机回归、网页490项、Python82项通过；新增USB恢复、九种忙状态查询及底盘锚点标定占用用例通过。
- [x] 主车Keil template全量重建通过，0错误、0警告。
- [x] 最终独立代码审查与审查意见处理；实际complete状态映射、重启历史标识和arm>前缀回归通过。
- 提交交付：全部必要检查完成后创建独立实现提交，提交号由交付回复记录。

## 保留项与边界

必须保留：camera material/ring/status/stop及坐标输出；颜色/编号环对准；手动环放置；码垛补偿和高度滚轮；动态追踪/夹取；姿态准备、车载取放、路线/赛事状态、参数读写、顶部停车和断线恢复。网页验证使用真实app函数、真实表单与FakeSerial。

不改硬件、香橙派协议、HMI或F103转盘；不处理雷达配置、二维码进度或P001；EIDE不修改、不构建。本次不连接实车、不烧录、不部署。历史记录保留事实，现行入口见[退役记录](../../开发记录/2026-10-09-MaterialVision退役与控制台保留.md)。
