doinbest/Yachiyo/xjx/模版搭建/docs/开发记录/2026-10-09-文档整理前快照/原协作规则.md

# 整理前文档快照：原协作规则

2026-10-09 文档整理前保存。原位置：[AGENTS.md](../../../AGENTS.md)。以下内容保留当时描述，包含已被覆盖的参数、规则及操作；不作为现行开发指令、操作手册或实机部署证明。相对链接已按原位置重新定位。

---

# 首要原则：整体效果优先，避免过度防御

**每次分析、设计、修改和审查，首先遵守本节。以实车任务完成率、动作连续性、定位效果和操作效率评价方案；保护机制必须服务这些目标。用户当次明确需求和已确认的实物条件，是工程取舍的首要依据。**

- **把保护的代价算进去。** 频繁停车、恢复次数耗尽、反复回零、参数被作废或任务无法继续，都可能降低系统整体效果。不能仅因方案“更保守”就认定它更好；要同时评估误触发、额外动作、恢复成本及比赛任务成功率。
- **保护要有具体依据。** 新增或加严校验、互锁、超时和退出条件前，说明它针对的实际故障或明确硬件条件、触发依据、影响范围和恢复方式。先核对当前源码、手册、日志与用户已确认配置，避免凭“万一有危险”叠加限制、重复门槛或再次要求用户确认已确认的事实。
- **短暂异常优先恢复。** 区分单次视觉漏检、低帧率、通信间隔抖动、暂缺状态与持续失联、驱动故障。按具体任务优先保持状态、短时沿最近有效运动信息继续、降速、等待或重新获取；恢复后继续原任务。不要把一次波动或累计几次恢复直接升级为整任务失败。
- **运动与完成判定分开。** 视觉水平对准可以按实际速度和目标条件容忍短时缺帧，复用最近有效方向或速度，并在新坐标回来后及时修正；到点确认、下降夹取仍使用相应的新鲜坐标和机构反馈。不能为了夹取确认的严格要求，把整个接近过程一并锁死；也不能把旧误差反复当作新测量累加移动。
- **阈值匹配实际运行。** 连续观测次数、数据新鲜度、宽限时间和重试策略，应结合实机采集/处理/发送速率、总线延迟、底盘速度与任务阶段确定。重点考虑“识别—丢失—识别”反复跳变及帧率下降；避免随意设定固定次数或过短窗口造成必然停车。恢复计数优先用于诊断，任务退出条件要能解释为什么已无法继续。
- **保留有效参数、参考与进度。** 普通停止、取消、总线恢复和网页重连，不应无依据地清除有效配置或强制从头开始。只有确实影响位置原点、观察姿态或模型适用性的变化，才作废对应的最小范围，并及时说明原因；优先提供必要的局部恢复，避免默认要求全系统重启、重新标定或三轴回零。
- **修正妨碍正常工作的保护。** 在已授权需求范围内，检查现有保护是否重复、过宽、掩盖真实问题或阻断合理操作；有依据地缩小、调整或移除。保留作用明确的必要校验，例如人工停车响应、实际机械边界和驱动故障处理，并让异常状态及恢复路径清楚可见。
- **减少操作与信息负担。** 常规实现由 Codex 完成，不为普通修改增加审批、确认步骤或通用防御框架。界面默认展示任务状态、关键原因和必要操作提示；详细诊断保留在状态页、原始日志或按需展开内容中。参考失效、参数缺项、通信失败分别解释，避免笼统归为“参数错误”。
- **验证正常流程与恢复效果。** 修改保护时，既验证它能处理具体故障，也验证正常任务、短时波动和恢复后的任务仍能完成。每次改动自查：新增限制解决了什么实际问题？是否误伤已验证流程？能否用更小的限制完成恢复？完成与改动相关的必要验证后及时交付。

# STM32F407VGT6 搬运小车项目协作约定

## 项目与协作方式

项目面向工训赛事搬运小车，主控为 STM32F407VGT6（LQFP100）。自 2026-09-21 起采用需求驱动的 Vibe Coding 协作：用户负责需求、修改建议、关键取舍和实物验收；Codex 负责方案设计、全部代码编写、集成、软件测试、调试分析和文档维护。

- 明确的功能、修复或清理请求即授权实施相关修改，包含必要的头文件、调用位置、工程清单、测试和文档；在已授权范围内持续完成，不反复请求许可。
- 用户只要求分析、解释或审查时，先给结论，不自动改代码。明显改变产品目标、硬件连接或取消未获授权的现有功能时，先确认取舍。
- 主动发现问题、提出替代方案并实施需求范围内的必要改进，不局限于逐字机械修改；避免无关重构和没有实际需求的通用框架。
- 可以参考优秀开源实现。采用前核查原始来源、许可证、硬件条件及工程适配性；记录实际借鉴内容，复制或改编时保留必要的许可证和归属说明。
- 解释关键设计、数据流和验证依据，帮助用户理解；不要求用户亲自编码、手动复制参考代码或逐函数批准。
- 常规实现细节由 Codex 判断；多种方案明显影响操作习惯、性能或维护成本时，说明取舍并向用户确认关键偏好。

## 工作流程

1. 阅读当前源码、工程配置和相关手册，明确目标、输入输出、调用周期及预期现象。
2. 检查 Git 状态，保留用户已有未提交修改，不覆盖无关内容。
3. 对复杂需求给出可执行方案，按可独立验证的小步骤连续实现。
4. 同步维护实现、接口、调用位置、构建清单、测试与现行文档。
5. 运行与修改相关的软件测试和构建；先定位第一个失败步骤，区分原有问题和本次回归。
6. 报告完成内容、验证结果、实际限制和必要的上板步骤；将关键参数、原因和结果记入开发记录。

## 代码与资料原则

- 固件以当前 STM32 HAL 和工程配置为基础；采用 LL 或其他机制时说明具体收益。
- 用户不再要求特定代码风格，上层自研代码的命名、结构、抽象和注释方式由 Codex 按实际需求选择，不要求模仿张大头官方驱动。用户通过提问了解逻辑，Codex 负责实现、维护和解释，不以用户手动阅读、修改代码为设计前提。
- 张大头 `Emm_V5.c/.h` 底层源码、官方接口和协议组包保留，不因上层风格调整而重命名、重写或删除；接口单位和实际前置条件仍须准确。详见 [STM32 开发与电机驱动约定](../../开发规范/张大头风格STM32代码规范与AI提示词.md)。不批量改写 HAL/CMSIS 第三方源码。
- 用户提供模块手册或原理图时先读相关章节；芯片行为优先以对应 ST 手册为依据，HAL 行为同时检查当前固件包实现。
- 板卡引脚与供电以实际板卡资料为准，不套用其他 F407 开发板；明确区分资料事实、源码推断和待实测假设。
- 不把示例、主机模拟测试或编译成功描述为实车验收完成。

## 当前工程与硬件基线

后续开发在本目录进行；`stm32_orangepi_test` 仅是历史迁移来源。主车固件为 `Code/template/`，本地香橙派代码在 `Code/orange_pi/`，串口屏配置在 `Code/HMI/`，本地控制台在 `Code/upper-computer-web/local-car/`；`Code/物料台转盘/turntable/` 是独立 F103 工程。

## 项目目录约定（2026-10-02）

全部代码、软件工程、参考项目、测试和工具放在 `Code/`；根目录保留 docs、日志、临时资料和项目说明。

| 目录 | 职责与入口 |
|---|---|
| `Code/template/` | F407 主车固件；Keil `MDK-ARM/template.uvprojx`，Target `template` |
| `Code/orange_pi/` | 香橙派视觉源码；当前入口 `vision.py` 为用户 2026-10-02 提供的最新 B2 版本 |
| `Code/HMI/` | 串口屏编辑工程 `display.HMI` 和 `.zi` 字库资源 |
| `Code/物料台转盘/` | `turntable/` 为 F103 固件，`archives/` 保存原始压缩包 |
| `Code/upper-computer-web/local-car/` | 当前本地控制台；从 `start.cmd` 启动 |
| `Code/reference/` | 外部参考项目和验证样例；来源、保留范围及分析记入目录 README |
| `Code/tests/` | F407 主机回归；网页和转盘测试保留在各自模块中 |
| `docs/` | 协议、硬件/赛事资料、开发规范及有日期的开发记录 |
| `Code/tools/` | 项目共用开发工具；单模块脚本跟随所属模块 |
| `.embeddedskills/` | 本地工具配置、构建/测试/通信日志和分析产物 |
| `tmp/` | 本地临时工作文件；不作为工程或资料的正式入口 |

- 保持 `Code/` 内活动工程入口稳定；目录整理不顺带重构业务代码、修改硬件配置或部署程序。
- 独立转盘工程不加入 F407 的 Keil/EIDE 清单，不与主车共用下载参数；其构建入口为 `Code/物料台转盘/turntable/MDK-ARM/turntable.uvprojx`，Target `turntable`。
- `Code/reference/GongXun2025-main/` 保存原参考项目；雷达参考位于同目录索引中。参考工程自己的芯片、协议和构建入口不作为当前主车默认值，不批量构建或直接复制进活动工程。
- 移动目录时先核查脚本、工程相对路径和文档链接，保留原内容并核对完整性；旧开发记录可补充现行位置提示，不改写当时事实。
- `README.md` 负责入口与使用导航，模块 README 负责本模块细节，`AGENTS.md` 负责协作规则；新规则和新入口同步维护，避免靠有日期的记录推断现状。

## 主车硬件与通信约定

| 接口 | 引脚 | 用途 |
|---|---|---|
| USART1 | PA9/PA10 | 无线文本控制台 |
| USART2 | PA2/PA3 | LDS50C 雷达，921600/8N1，DMA1 Stream5/Channel4 循环接收 |
| USART3 | PD8/PD9 | 串口屏 |
| UART4 | PC10/PC11 | 二维码 |
| UART5 | PC12/PD2 | 步进电机总线 |
| USB CDC | PA11/PA12 | 香橙派 B2 颜色视觉协议 |
| I2C1 | PB6/PB7 | OLED |
| I2C2 | PB10/PB11 | HWT101，SDA 为 PB11，只使用 Z 轴角度 |

- USART1 使用空格分隔 ASCII 命令；不要恢复 `sys.ping#`、旧 CRC 香橙派协议或 B3 圆环编号接口。
- HWT101 当前采用原生标定与静止验证，不使用已退役的软件漂移补偿和外部 Flash 参数存储方案。
- 网页历史离线16段时间示意与固件实车15目标路线独立；地图模拟不得自动驱动实车。当前固件路线预览共用 `chassis_route_profile.c`，网页只显示和播放C生成的动作。
- 雷达采集、5×5建图及实车规划由 F407 负责；网页离线对照调用相同 `radar_map.c`，不得另写一套路线算法。`radar scan` 只静止采集一圈，扫描/读图/规划均不自动运动；执行分别用 `radar nav start` 和 `radar task start`。固定路线入口与模拟任务码测试保留，未实现全赛事自动搬运。
- 2026-10-04：`#map/radar` 当前使用共享 F407 USART1 115200链路和独立 `radar host` / `profile:"f1_host"` 协议；F407 USART2 921600收完整圈后按F1默认 `(230,230)`、阈值1、固定掩码`0x00050140`、保护掩码`0x00404405`及任务`1-5-4-2-3-4-2-3-1`建图规划。状态变化通知网页，普通单次扫描只逐页请求障碍掩码、25格统计和路线，不自动下载完整点云/重复配置，不与自动广播竞争；单页超时可重读两次，失败保留完整快照。“读取状态/结果”显式读RAM配置及缺少结果，`fetch cloud`仅保留按需诊断。改筛选和分区时MCU复用同圈重建，不重新扫描。设备配置只存RAM，本机配置仅在网页显式保存；进入/切换页面、重连和保存均不发雷达或运动命令。第一阶段USB-UART直连代码保留但不再是当前雷达页数据源；实车监控和离线对照不变。此F1主机坐标与下述实车雷达 `(2250,150)` / `(2250,2250)` 配置是两个独立工作剖面，不得混用。
- 2026-10-03：`radar scan auto`在右上(2250,2250,270°)和右下(2250,150,90°)假设下流式计数；先以二维码前bit14、原料台前bit22原始阈值冲突判定，再豁免这两格扫描障碍，保留原始点数。唯一无冲突才选择，两者均无冲突/均冲突保持待定；`radar start upper|lower`可从同圈人工选择，`radar start status`只读。名义安装沿用下方参考参数推导，不宣称实测定位。实际固定路线/运动入口仍右下，右上仅建图与规划；不自动改底盘原点、IMU或驱动方向。离线对照调用相同`radar_start.c`及`radar_map.c`。
- 2026-10-04：雷达页先本地选择起点，再在该角落用地图方向箭头指定0°，应用读回后以`radar scan upper|lower`从名义起点采一圈；选择与导航不发送指令。2026-10-04中心静态建图修正后，右上方向写入下方参考时减90°。自动扫描仍单圈，完整圈/10秒超时后请求LSTOPH；同圈人工复用`radar start upper|lower`另列入口，不要求先完成自动扫描才能使用人工扫描。
- 2026-10-04：`radar debug scan upper|lower|auto`按需记录解析前USART2原始字节，16KB滚动窗口与最后有效圈偏移、单位及冻结参数同圈绑定；普通scan不捕获。raw分页CRC/完整下载与设备完整圈证明分别校验，失败允许导出部分证据且不套历史点云。诊断采集与页面导航不启动底盘/机械臂，保持当前运动、过滤及起点判定算法；地图显示实际5×5判障网格并区分固定/扫描障碍。
- 2026-10-03：固定/雷达/首件组合路线默认200 mm/s、距离加减速300 mm/s²，5000 mm/s及3000 RPM上限保留。右下起点首腿先斜移至(2100,300)，再保持90°沿X=2100直行至扫码位(2100,1200)；两阶段同属目标1，首腿之外的规划绕行保持原路点，长段先转向再前后走，工位最终90°；暂存在(425,1200)接驳转向、最后75 mm进出≤min(启动速度,50)。转向使用地图绝对航向 `chassis turn`，保留原点/锚点；扫码与首原料交接按station/visit=5/1、4/2。完整顺序见[低速路线验收记录](../2026-10-03-底盘低速转向路线与验收顺序.md)，软件验证不代表实车验收。
- 2026-10-03 后续速度调整：原地/路线转向上限100°/s，网页转向输入及地图角速度显示用°/s；底层`chassis run`和遥测仍用rad/s，网页负责换算。直行航向纠偏保持0.15 rad/s限幅，路线直行默认200 mm/s不变；底盘网页平移测试输入及合速度上限300 mm/s。当前C路线预览从C服务获取转向上限。
- 雷达与地图统一为左下原点、X向右、Y向上，地图yaw从+X逆时针；历史参考只导入时应用 `T(x,y)=(2400-y,x)`，严禁再旋转已验证的底盘、IMU、电机方向。2026-10-04用户确认雷达直接位于标准起点中心，默认下方雷达位姿 `(2250,150,180°)`、上方 `(2250,2250,270°)`；上方零角相对下方加90°是静态角点扇区关系，不是车载180°刚体安装关系。旧 `(2170,230)` 偏移不再作为默认值；扫码/原料/粗加工/暂存到点坐标保持当前地图基线。
- 雷达短暂坏帧、单位变化或DMA覆盖只重采当前不完整圈，在10秒扫描窗口内继续恢复；不叠加固定恢复次数。停止/失败/重连保留完整历史地图。新扫描复用单个点云缓存，未完成时不提供半圈云点；网页保留自己已接收的历史快照并标识来源和年龄。工位交接按 `station/visit`，不能按绕行后易变的路点序号触发。
- 2026-10-04：`radar live start upper|lower`为持续点云查看，`radar live stop`或`radar stop`结束；与单圈建图/原始诊断互斥，使用独立120分区预览缓存，不改已完成地图、规划及完整点云。只发送最新完整圈，网页已有完整圈时等下一圈收齐后整体刷新；导航不自动开启，断线/重启保留历史图并重新接受设备当前实时编号。
- 2026-10-04：F1主机剖面 `radar host live start` 使用独立非零 `live_id`（与静态scan无关，stop/start不复用）；控制台另存一圈冻结发送缓存，点数/身份/CRC和数据在所有分页中不变，发完再取最新圈。网页按live_id隔离分组、忽略晚到旧圈页，完整CRC通过后整体刷新；保留真实重复页冲突和CRC校验，不用关闭校验掩盖串圈。USART1 115200及32字节/30ms节奏不变。
- 2026-10-05：F1主机剖面 `radar host live start` 每个完整圈用全部原始点按 `radar_host_map.c` 流式判障并规划，120分区仅预览；不改实车 `radar live` 行为。地图/路线按256字节预算合并分号记录、offset按记录计，冻结到网页收齐后 `radar host ack <plan>` 确认，丢失最后路径页仍可补读；之后发一圈预览，再通知最新结果。空预览格不压入有效点数组。持续参数应用在下一完整圈生效，无完整缓存的停止圈不能冒充同圈重筛选；旧图保留。未读回显示待同步/—，不等于0点或不可达。ACK仅发送缓存握手，在停止锁定中可用；不新增采集/运动门槛。
- 2026-10-03：扫描完整圈成功后，网页自动只读同步障碍地图与路径；地图/路径按256字节报文预算连续分页，不等待点云。点云为按需诊断读取，不占用导航操作。普通页请求取消每页一秒等待，保留低频状态推送、USART1无线分块节奏及停车回复优先；按pages/offset拼装，不写死分页容量。切页及重连本身不发送命令。
- 2026-10-05：F1雷达页通过只读`radar host result <plan>`一次请求连续回传冻结的地图/路径，`host_result_end`报告实际页数，网页仅补读缺页、收齐同圈后ACK，不并发逐页请求。120点预览每4次不同结果ACK发送一次，结果请求可抢占预览。用户明确要求取消USART1固定30ms等待；当前64字节DMA分块、115200波特率、完整行原子性和停车回复优先保留，DMA完成后主循环立即续发。未改变F1判障/规划或实车监控界面，真实无线吞吐及丢字需上板验证。
- 2026-10-03：`radar probe`通过既有USART2发送LUUIDH身份查询，`radar probe status`只读结果；不启动雷达、不改参数/地图，可在网页停止锁定中使用。只有新鲜PRODUCT SN回复及MCU发送完成同时满足才确认查询通信；持续报警、发送完成或回显不能独立作为往返成功。原始24字节RX片段与SN保留在诊断及日志；无身份应答不能直接断言外部供电故障。
- 本地网页共享连接必须由用户从设备列表选择串口，不默认或自动选择 COM 号；通信格式默认 115200 / 8N1。工具配置中的串口号也可能不同，操作前核对。

## 工程文件维护

- 2026-10-09：用户授权退役独立Base/X对准 `ArmVision`；删除其源码、Keil清单、主循环/事件分发、旧 `vision` 命令与PE2概览页启动入口，历史依赖Git追溯。静态对准统一用 `grab align color|ring`，不将旧命令自动别名到会移动底盘的新流程。保留 `MaterialVision` 搜索功能，其独立RAM参考/标定入口为 `material ref`、`material calib <1..6>`，普通停止保留参考；`grab` 不依赖该参考。舵机测试页PE2选择脉宽行为保留。本轮EIDE继续不修改、不构建。

- 2026-10-08：手动码垛改用 `grab stack align <1..6>`，复用统一静态入口，先对准原绿色准心并停稳，再独立执行固定图像补偿CX+39/CY+1（DX=39/DY=-1），补偿后停稳保持，允许人工装料/夹紧及独立调高、松爪。补偿不写回ref_u/ref_v，不移动香橙派绿色准心；普通静态颜色、编号环、动态追踪及正式任务不启用此补偿。控制台码垛按钮已切到专用入口；日志DX/DY仍相对绿色准心，最终39/-1是预期。补偿依据用户截图Center(373,339)相对绿色准心(334,338)，不是39/1 mm，不跟随以后检测到的红点改补偿。

- 2026-10-08：静态对准统一入口 `grab align color <1..6>|ring <1..3> [z_mm] [stay]`，共用 `GrabTask_AlignStart` 和 `align_control`；旧 `grab ring align` / `grab start align` 保留兼容。静态颜色、编号环及pick阶段共用grab RAM调速参数，默认底盘160、X60 mm/s、accel300、lambda2.5、lead12、DX/DY各1px；动态grab track仍独立配置。颜色准心保持(334,338)，编号环保持(378,333)。码垛手动测试：颜色中心对准→人工grip catch→`grab stack lower <z_mm>`→`grab stack release`→`grab stack lift`；高度为绝对mm，可向上调整或覆盖未完成目标，下降不松爪、松爪不自动提起，不取仓/改库存。控制台“码垛”滚轮每格1mm，仅本地预览，停滚1秒发送最后一个高度；停止/断线/切页/故障取消待发，不重放。X视觉目标按实际脉冲比较，避免半脉冲浮点残差重复发送同一位置并阻断停稳。

- 2026-10-08：动态追踪页“准备抓取姿态”发送grab pose work；“一键持续追踪”发送grab track begin [color] [remaining]，固件等待本轮反馈/新鲜视觉，缺少参考才建立参考，已有预算不充值。grab track pick [color] [z] [speed]在物料停留、对准、停车后新坐标仍在窗口时下降闭爪提起，完成picked，不自动入仓/改库存。物料默认窗口±5 px、z_grab=-80/z_lift=-40，独立z_pick_speed=111.111 mm/s（当前1000 RPM）与正式store共用；观察/提起/色环z_speed不改。任务拥有的Base转向停稳差大于2°且不超过5°时以不超过15 RPM重发原绝对目标，禁止使用实车异常的FD模式2补偿，临时采用2°容差并保留原锚点，不解决已延期的手动Base参考失效P001。

- 2026-10-08：编号环grab ring align独立准心(378,333)，align_parameter统一用于对准误差、短缺帧/停车重获、下降接近进度及stay观察偏差；物料Config ref_u/ref_v默认(334,338)、grab track保持原配置，不切换写回共享参考。香橙派颜色--center-x/y与编号环--ring-center-x/y独立，默认分别334/338与378/333；本地源码更新不代表远端部署。环受理回复明确参考点，get/set ref_u/ref_v仍是物料参数。

- 2026-10-08：控制台故障模拟使用真实app处理函数/表单与FakeSerial，禁止连接实车发送测试运动。表单刷新登记区分“构建中未挂载”和“曾挂载后移除”；连接变化清旧路线锁定，路线状态解析兼容arm>前缀。BridgeLink覆盖HTTP头/响应体12秒期限，离线radar/plan按C编译30秒+运行15秒保留50秒预算；超时释放网页忙状态、不重发命令。grab route/mission status在网页与串口服务均归为只读，停止锁定中可查；原运动锁定保留。

- 2026-10-07：香橙派入口 `Code/orange_pi/vision.py` 已原样替换为用户最新版 `Final.py`，新增B2目标0A/0B/0C按数字1/2/3定位同心圆；01～06颜色通道保留。后续已接入STM32与网页：`camera ring <1|2|3>`仅识别，`grab ring align [1|2|3]`按编号对准，省略默认1。B2目标0A～0C与正式物料颜色分开；尚不能将软件检查描述为实车验收。

- 2026-10-07：新增独立粗加工1号黑白环手动装料测试 `grab ring align` / `grab ring place <z_mm>`，控制台视觉任务页分步操作。现已升级为B2数字目标0A/0B/0C，可选1～3号，省略默认1；对准后允许人工夹爪控制，放置仅Z下降/松爪/提起，不从仓取料或改库存。编号环测试取消预伸50mm：从朝后姿态先收回X、转Base90°，到位后识别；X仅在视觉对准阶段按误差调整，放置按钮默认−150mm（用户实物验证），Z回零验证后软件下限−150mm；正式取放高度参数保留。

- 2026-10-07：机械臂默认Position与显式PositionEx统一允许底盘路线期间排队发送位置指令，删除临时BaseRoutePosition入口。动作并行条件由GrabTask等任务层管理，底层仅保留当前请求互斥、参数校验和总线应答；任务work姿态仍先核验X收回/Z抬起再转Base。HOME/ZERO及驱动配置更改的路线互斥保留，HOME_STATE只读放行。grab route status、grab mission status及chassis task/route status在任务运行时可读，不启动或中断运动；实车并行转向仍需验收。

- 2026-10-07：Base姿态/转向完成按用户临时调整的2°业务容差、命令后的新鲜反馈、静止稳定及正常使能判断，不再额外等待驱动位置到位位；X/Z到位判据不变。新增只读 `grab status base|x|z` 短诊断。实车曾停在turn，取消前状态位回传缺字，修复后需重新实测，不以取消后0x83状态或主机回归代替验收。

- 2026-10-07：新增 `grab place car` 初始机械臂车载放料入口，控制台替换原“转到仓位”控件。复用已验证后向 Base 锚点（默认逆时针90°到车载口）、X默认100 mm、车载Z高度，反馈到位后松爪并停留；不重复回零、不驱动ID8、不改库存。原 `turntable index` 与自动分仓取放保留。

- 2026-10-07：ID 8 控制台新增 `turntable enable/disable/save_zero/home`。首次失能手动对齐第一仓、使能后保存驱动器单圈机械零点（0x93 存储标志 1）；以后显式就近回零（0x9A 模式 0），读取 0x3B、实际位置、速度与状态确认完成后自动同步第一仓软件参考，无需每次人工建立参考。回零不清驱动位置计数、不要求反馈数值为零或位置运动到位位；中断先退出回零再停止。驱动器机械零点与 STM32 RAM 仓位参数、库存分别管理，旧 `turntable origin` 软件参考采集保留。

- 2026-10-07：用户确认物理Base回零改为朝后。新 `grab mission [speed]` 入口按右下固定两批任务调度：二维码先通过；原料前90°左移、最后75 mm切车头0°并将Base顺时针90°作业；加工车头180°、暂存90°，每站后向收回并返回中心后续跑。粗加工三件全部释放后取回，第二批暂存按第一批同色位置码垛，最终返回右下；官方环号粗加工1右/2中/3左、暂存1下/2中/3上，间距150 mm。Base保存实际多圈后向锚点，车载相对作业−180°、X默认100 mm，切换不重复HOME/ZERO或清视觉模型。缺场景Z参数用config_wait保留当前件，补齐后 `grab mission continue`；三仓角度不代填。自动路线附加dwell取消，反馈停稳/到位保留。旧grab route/radar task start仍是首件调试；新C task_fixed/task_planned预览仅播放底盘阶段及朝向。Z搜二维码后续实现；软件验证与实车验收分开。见[任务记录](../2026-10-07-实车后向机械臂两批任务流程.md)。

- 2026-10-06缺包修复：正式静态CE采集以连续报文学习正常角步长，超过1.5倍的跨度触发`angle_gap`，仅重采当前不完整圈、保留已完成圈并在原10秒窗口继续；不将丢包前点云跨扇区拉伸。备用host、CF、实时预览、阈值1、三圈任一圈命中保留及现行150～2250判障不变。`radar fetch evidence <scan> <page>`只按需取最近完整正式扫描的逐圈计数/有效mask及每格前两、后两点报文来源，不加入正常结果下载；新正式扫描清证据不清历史地图。见[缺包修复记录](../2026-10-06-雷达缺包角度插值与逐圈证据修复.md)。

- 2026-10-06 用户确认临时恢复内缩判障：正式监控物理场地外框仍0～2400 mm，实际5×5判障边界改为`[150,550,1000,1400,1850,2250]`，格宽400/450/400/450/400；外围150 mm不参与扫描判障。正式点归格仍逆T旋转，精确边界为`150<X<=2250、150<=Y<2250`，内部X边界归左、Y归上。安装起点保护查格允许2250 mm末端，标准右下/右上及备用转换位置保护不丢失；任务保护、人工mask、90°方向、工位锚点、三圈有效障碍并集和快速结果回传保留。地图`g:3`标记新内缩网格；历史`g:2`仍按0～2400旧网格显示，不将旧图换格。备用F1页不改。以下2026-10-05“全场判障”记录为历史范围，已被本条覆盖。

- 2026-10-06：正式监控默认`radar scan lower|upper 3`，一次启动连续采3个有效完整圈，每圈沿用已验证的全场F1对齐判障，有效mask取并集、第三圈后统一发布并规划。counts/evidence为累计/并集，完整cloud仅最后一圈；不重新按累计counts判障，不要求连续3次命中。短暂坏帧只重采当前圈，停止/失败保留上次完整图。备用F1 host和旧单圈接口不改。正式结果一次`radar result <plan>`连续回传map/path，result_end报告mp/pp，仅缺页fetch补读；实际位宽预算压缩页数，路径元数据只在第0页。结果流100ms非阻塞页调度避免DL-20突发丢字，不恢复全局30ms分块等待，不改115200或运动行为。

- 2026-10-05现场修正（10-06续测更新）：正式监控增加“备用已验证位置 · 转90°”静止扫描参考，备用(230,230)复制为正式(2170,230,180°)，扫描前读RAM且仅写差异，标准启停中心默认不变。全场0～2400 mm保持；正式同圈已知场边回波只有离边<=40 mm、相邻投影点间距<=150 mm形成连续段、至少8点、沿边跨度>=400 mm且有法向场外点时不计入有效扫描障碍；圈首尾同边连续段合并，原始counts/evidence保留。实测场边偏入28.3 mm，旧20 mm范围不足；40 mm不是整条外围禁判带，独立外圈点、人工mask及备用host不作删除，不恢复通用轮廓规则。见[现场修复记录](../2026-10-05-实车监控安装偏移与场边回波实测修复.md)。

- 2026-10-05：用户要求正式实车规划与备用F1采用相同逐格点数判障规则，取代2026-10-04连续轮廓/背景删除规则。正式默认原始角0～360°、距离100～40000 mm、能量0～255、每格最少1点；保留全场0～2400 mm网格。筛选后逐点投影累计所在格，场外点只记诊断，不删除邻接场内点；完整云和流式计数一致，120点预览仍不参与。当前安装角落、二维码前和原料前扫描豁免、原始证据、90°坐标转换、工位路线及备用F1功能不变。

- 2026-10-05 后续F1对齐：正式`RadarPlan`逆变换mask及起终格，复用F1 `RadarGrid_Path`的北东南西邻居顺序、毫米曼哈顿代价与同分优先级，再旋转返回格链；正式对应西北东南。移除跨格直线/单拐角捷径优先逻辑，保持350/775/1200/1625/2050格中心通道，只作工位所在格的局部轴向接驳、合并同向共线点，所有实际线段判障。任务坐标、station/visit、首段和最终停车接驳不变，备用F1 host不改。网页C预演核对与设备实际有序路点一致，不用新核心路线冒充旧规划。
- 2026-10-05：正式`RadarPlan`首段显式发布右下起点→(2100,300)通行点→(2100,1200)扫码点，两条实际线段均判障，受阻保留绕行；右上仅规划对应通行点(2100,2100)。通行点station/visit=0/0，扫码仍5/1；不得再画起点直接扫码的旧长斜线，也不让执行层重复插点。固定15目标旧直接首腿的profile拆分兼容保留，备用F1 host不改。

- 2026-10-05 后续F1对齐：正式`#map/monitor`网格仍为X/Y `[0,550,1000,1400,1850,2400]`，格宽550/450/400/450/550；筛选含360°端点语义与F1相同。测量点逆T在参考全场网格归格再旋转，正式X分界线归左、Y归上，外边界`0<X<=2400、0<=Y<2400`。扫描保护工位bits2/10/14/22（粗加工/暂存/二维码/原料）和安装启停格bit4或24，分别为下方0x00404414、上方0x01404404；另一角落仍判障。保留counts/evidence，人工mask及规划器不清障碍，自动起点冲突仍仅依据14/22。备用F1的150～2250网格和功能不变。正式地图g:2保留，首个counts页a:3及f记录新算法和本圈冻结筛选，旧历史不套新保护标记。“当前安装”扫描读回RAM后显式用`radar scan lower`，上方用upper，不隐式跟随底盘反馈；默认360°/阈值1，自定义保留并标明。导航不发命令，预演仅本机；实际运行仍需显式nav/task start。

- `App` 放业务、控制台和任务；`Hardware` 放硬件驱动；`System` 放无业务含义的公共功能；`Core` 保留 CubeMX 结构。
- 已授权的模块增删或清理可以同步更新 Keil `.uvprojx` 和 EIDE `.eide/eide.yml` 文件清单；不得顺带改变芯片、地址、工具链、引脚或时钟。
- 2026-10-02 固件精简边界：完整保留 `Emm_V5.c/.h`、W25Q128 驱动及默认关闭的读 ID 诊断；用户未授权后续修改前，不将它们作为冗余模块删除或重写。本次只维护 Keil 清单，EIDE 配置完全不改、不构建；其已删除模块的旧清单路径及原有 SPI 缺项留待单独处理。
- 修改 `Code/template/template.ioc`、引脚/时钟配置或重新生成代码，须属于用户明确请求范围；生成前检查 USER CODE 和预期差异。
- 删除历史实现依赖 Git 追溯，不在活动工程复制备份。历史开发记录保留当时事实，以状态提示说明替代关系。
- 当前入口以 README、控制台手册和 `docs/上位机协议.md` 为准；有日期的开发记录不自动代表现状。
- 修改串口屏时保持 `.HMI` 和所需 `.zi` 资源一起管理，同时核对 `Code/template/App/contest_screen.c` 的页名、控件名及显示调用；不能仅修改屏幕工程后就描述为固件和实屏已同步。

## 构建、测试与工具

- 2026-10-08：`Mecanum_Feedback_Select(0..4)` 只关闭新增轮询并改变后续查询名单，允许已有查询排队/在途/应答待消费；已有请求按原 token 正常完成，不取消或改写回复归属。追踪、静止对准/取放及手动 feedback 选择共用此行为，调用者显式 Enable 后继续；不要求持续轮询出现空闲间隙。机械反馈新鲜度、Receive 应答及停车规则不变，见[修复记录](../2026-10-08-反馈轮询切换与追踪启动修复.md)。

- 2026-10-08：动态追踪 IO 在 X 最新运动、X 位置、低频轴反馈之间公平轮转，无待办立即跳过；保留反馈阈值与机械边界。追踪过期保存 feedback_fault 的 ID/类型/年龄，停止回读不覆盖，显式 observe/start 清除。取消在途机械轴运动/普通停车允许匹配只读反馈取得停车证据，但保留运动隔离，真正应答超时/UART 故障不因此解锁。bus status 独立显示 motion locked/error/feedback_allowed。持续变化目标回归、Keil、DAP 烧录及短段追踪停止验证见[修复记录](../2026-10-08-动态追踪公平查询与停车回读修复.md)。

- 2026-10-08：动态追踪 track_window_end 改为停稳后继续观察和计算可达性，新的有效目标可在原行程/预算内跟随后自动续追（track_window_recovered）；不重建参考、不充值预算。旧坐标/定时预测不独立触发恢复，等待候选速度不下发，恢复按原加速度从静止起步。人工停止仍结束本轮。等待期间记录持续更新，停止后再冻结导出。见[行程暂停续追记录](../2026-10-08-动态追踪行程暂停后自动续追.md)。

- 2026-10-07：普通距离/转向停车在零速快照确认后由Mecanum_RequestPlannedStop排队：停止下一条反馈提交，保留当前应答，轮批次/查询结束后执行四轮FE；不再靠调用方轮询撞上空闲间隙。紧急停车仍立即中断，恢复清待办；停稳阈值及超时未放宽。

- 2026-10-07 用户要求：每次 STM32 烧录完成后，主动提醒重新打开香橙派程序；等待程序重开后再进行依赖视觉的实车测试。烧录完成不等于香橙派视觉链路已恢复。

- 2026-10-07：UART5 ID1～8统一按匹配Receive应答推进，无固定10 ms及底层80/100 ms门槛；FF只收ID1回复，四轮批次保持原子性，批间轮转服务真实待办。普通FE等ACK，紧急FE/9C按TX完成连续停车并排空迟到应答；stop all逐ID1～8。追踪新完整B2包主循环即时修正、定时预测默认20 ms，batch_ms默认0（0～200，非零显式限频），X写入/50 ms位置读取交替；保持速度、加速度、模型、250 ms宽限、机械边界及参考预算。bus/track status按需读计时，不以摘要间隔冒充实发频率。Keil独立scatter仅将CPU追踪状态放CCM，DMA原SRAM不动；IOC/EIDE/驱动板设置不变。软件验证与烧录/实车结果分开；本条覆盖下述历史10/50/80 ms节奏。

- 2026-10-06：第一阶段动态追踪为独立`grab track`和`grab_tracking.c/.h`，入口视觉任务页。追踪参数不覆盖静态align/pick；默认底盘160/X60 mm/s、软件accel300、计算50/批次80 ms，UART5 Receive/10 ms间隔与同步保留。只从已对准/小偏差姿态开始，X0～100 mm、固定料台参考累计接近50 mm；停止/重启追踪不重置预算，不移动Z/Base/夹爪、不下降夹取。仅观察显式重发B2以支持Pi程序重开，空闲后先刷新反馈而不作废有效参考。128条冻结记录及`Code/tools/tracking_report.py`区分启动过渡、稳定段、软件模拟与实车验证；真实6/8/10 rpm验收见本轮开发记录，不以编译/理想模型代替。

- `keil` 为默认构建后端：`Code/template/MDK-ARM/template.uvprojx`，Target `template`。
- `eide` 为备用后端：`Code/template/MDK-ARM/eide`，配置 `template`。模块清单应与 Keil 保持一致。
- 用户要求本轮暂缓 EIDE 维护，当前精简结果只以 Keil 验证；不将备用工程描述为已同步或可用。
- 2026-10-03：车载三仓转盘 ID 8 共用 UART5，电机与盘 1∶1 直连；第二/第三仓角度尚未标定，不预填 120°。`App/turntable` 独立于机械臂三轴，人工对齐首仓后读取反馈建立软件参考，不自动回零或清零。上电库存待人工核对，普通停止与总线恢复保留配置及库存。
- 本轮参数界面与单件取放保护官方 Emm_V5、W25Q128 及诊断测试、IOC、EIDE 配置；仅维护 Keil 文件清单。参数页读回与写后比较不等于运动或实物验收，页面导航不得自动发送命令。
- `grab set` 和 `config <axis> ...` 修改的是 STM32 RAM 参数，复位/重新上电恢复已烧录固件默认值；网页保存的路线速度属于浏览器本地设置。当前未实现这些参数的 Flash 保存与上电加载，不把保留 Flash 驱动或读 ID 诊断描述为已有参数持久化。
- 2026-10-05：用户指定车载取放口 X 绝对位置为10cm，`x_car`固件默认100mm；初始化和X回零反馈验证成功后恢复。普通停止保留RAM调参，手动改变X原点仍使相关参考失效；本次不改Base回零故障判定，位置动作待实车验收。
- 2026-10-03 视觉联动二次提速：GrabTask共享align/pick默认body_speed=40、lambda=1.2、accel=60、x_speed=10（mm/s及mm/s²）；自动z_speed=55.5556 mm/s，对应当前Z尺度500 RPM，下降/提起共用，不改回零配置。vision_wait_ms=12000用于首次等颜色及停稳后重获；RecoveryUsed仅诊断，不设累计两次退出。坐标新鲜度、短漏检宽限和夹取前到位判据独立。
- 固件主机回归：根目录运行 `python Code/tests/run_firmware_tests.py`，需要 Python 和 GCC。
- 网页回归：根目录运行 `node --test Code/upper-computer-web/local-car/tests/*.test.mjs`。
- 桥接回归：`python -m unittest discover -s Code/upper-computer-web/local-car/tests -p test_bridge.py`。
- 控制台启动：`Code/upper-computer-web/local-car/start.cmd`；无需 npm 安装或云部署。
- 用户明确要求一键构建烧录或自动诊断时使用 `workflow`；下载调试按实际硬件选择 `openocd` 等工具，不猜测调试器。
- `serial` 用于端口扫描和日志；CAN1/CAN2 自 2026-09-22 起停用；将来重新启用 CAN 时再确认参数并使用 `can`；`embedded-docs` 用于文档维护。
- 默认通过本地代码和串口调试，不使用 SSH；用户当次明确要求 SSH 时再使用。
- 2026-09-30：用户确认香橙派实际运行入口不是本地 `Code/orange_pi/change.py`，当前不方便修改香橙派；视觉联调优先保持现有香橙派程序和B2协议，仅修改STM32。不得把本地视觉脚本的修改视为实机生效。
- 2026-10-02：用户提供最新 `vision.py`，已原样更新到 `Code/orange_pi/vision.py` 并删除旧 `change.py`、`test_connect.py`。以上旧文件名说明保留为历史事实；后续分析以最新源码和 B2 为准，本地更新不等于实机部署。用户确认 `align` 已完整验证，要求后续 `pick` 的视觉对准流程与 `align` 对齐；本轮仅分析，未修改 STM32 行为。
- 2026-10-02 后续检查：普通停止和 `bus recover` 不清抓取配置；手动 HOME/ZERO、Base 移动及放置转向会使相关参考失效，需 `grab rehome` 完整验证后恢复。放置转向后的缺项状态已同步刷新；终端抓取中文摘要保留关键状态与异常，完整诊断通过原始报文、导出和状态页查看。本次仅修复诊断与显示，未改变 align/pick 控制和恢复策略。

## 硬件操作与产物

- 只读扫描、工程分析、软件测试和编译可以在任务范围内直接执行。
- 烧录、复位、擦除 Flash、写内存、发送串口数据或 CAN 帧，必须有明确用户意图和完整硬件参数。
- 不猜测串口号、波特率、CAN 适配器/通道/速率、调试器配置或烧录地址；软件默认值不等于硬件确认。
- 构建成功后再进入烧录；优先使用带地址的 ELF/HEX，BIN 必须明确地址。
- 软件停车、命令受理、发送完成和反馈确认分别表述；不把断开网页或无线失联当成停车保证。
- 构建、测试及通信日志存入 `.embeddedskills/`，其中仅提交 `.embeddedskills/config.json`；不删除用户已有日志、备份或分析文件。

## 已确认的驱动配置（2026-09-22）

- 用户明确确认：使用张大头 Emm42 固件，仅修改电机 ID，其余驱动设置保持默认。后续不重复将此配置视为未知，也不套用 X 固件的位置/速度单位。
- 本地《ZDT_X42S 第二代闭环步进电机用户手册 V1.0.5》Emm 章节第 57 页规定：默认 1.8°、16 细分下，位置控制为 3200 命令脉冲/电机轴圈；第 72 页规定：0x36 实时位置按 65536 协议单位/电机轴圈换算。两者不同，不能互相替换；轮圈与电机轴圈还须按实际传动比换算。
- 上述 65536 是协议换算常量，不是必须靠实测才能确定的待选参数。实车距离、轮向、轮径与传动关系的验收仍独立记录；不得将文档核对写成已完成实物测量。
- 控制台已取消“实测一圈为 65536 单位”的确认文案及门槛，准备流程按 Emm 默认 Receive/65536 预设执行；仅保留轮向与实际起点确认。不要重新引入协议单位选择或反复要求单轮实验。

- 2026-09-22：固件上电默认 Emm42 Receive（ack=2），控制台不再设置应答模式。IMU 初始化完成后等待新鲜数据并自动进行一次归零及5秒静止验证，失败保留门槛且不自动重试；手动 verify 也是5秒。原生标定仍为手动20秒加30秒验证，不随启动触发。
- 2026-10-03：UART5 首次发送尝试前、无活动事务的单独 FE 帧错误允许清理残片并重启接收，成功后沿原 10 ms 间隔继续启动回零；恢复次数由 `info` 保留。首次发送后不再适用此例外，手动恢复也不重开例外；DMA/溢出及接收重启失败仍隔离。`owner=8/addr=0/func=0` 是无历史事务标记，不是 ID 8 转盘。

- 2026-10-06：`bus recover`可免断电处理四轮非零同步批次被停车中断后的缓存锁定。沿用ID1～8停车、排空与三轮健康检查，再对ID1～4逐条写入Receive确认的同步零速F6、逐地址FF同步和新鲜停稳检查，禁止广播触发ID5～8；成功才解锁，不自动续跑，不重建追踪参考/预算或清参数。新运动/故障使旧恢复证明失效；正常停车反馈排队不阻断成功收尾。`chassis reset-confirmed`仍只能确认实际驱动复位，不作强制解锁入口。
- 2026-10-06：未受理的机械臂请求保留 `HAL_BUSY → BUSY`，上电回零沿原 100 ms 轮询和每轴 60 s 窗口等待重试，不重发已受理 HOME；总线隔离拒绝映射为发送错误，输出 `ERR grab home_request` 的轴、动作、总线原因及 UART 错误，并以 `home_bus_fault` 区别真正锁定。未完成三轴验证显示 `missing=home_pending`，不是用户漏设尺度；X 验证后的 x_ppm/x_car 默认恢复、原 FE 例外、驱动故障及停止流程不变。本次软件回归和 Keil 构建通过，DAPLink/COM14 实机验证状态见开发记录。

- 2026-10-04：静态建图默认仅原始0°至顺时针90°，距离保持雷达毫米实值；按投影点与2400×2400正方场地判断场外，不用2400 mm径向上限裁掉场内对角点。完整云轮廓分析仅排除有场外连通证据的长背景，独立场内长障碍保留；连续物体按总点数达到阈值（默认1，沿用F1已验证值，不无依据提高）后标记全部触点格，避免跨格漏标。静态地图、自动起点候选和网页离线重放共用RadarMap_BuildCloud；实时120点只作预览，不参与正式障碍判定。历史快照以冻结pose重放，不能套新默认重定位旧点。

2026-10-07上板补充：持续四轮查询期间抢发紧急FE，以及紧急FE链连续发帧，出现应答丢失和drain_timeout。仅紧急FE/9C在前一帧TX完成后保留2 ms非阻塞发帧间隔，不等待前台ACK，不影响普通Receive应答后立即推进；不恢复普通10 ms或追踪80 ms门槛。实测过程与最终状态见本日UART5上板通信测试记录。

- 2026-10-07：正式取放与独立 `grab place car` 共用 `x_transfer_speed`（默认60 mm/s）；静态视觉 `x_speed` 默认10、动态追踪独立默认60。实测入仓中断为 UART5 FE/NE 后总线锁定、反馈过期，不是固定X行程超时；本次速度修改已软件验证并烧录，实测X约59.2 mm/s；完整入仓仍因UART5 FE中断，bus recover后确认三轴/四轮停稳。

- 2026-10-07 06:26最终现场基线：普通UART5事务保留匹配Receive应答控制，完整应答后增加2 ms非阻塞交接间隔；覆盖此前普通应答后零间隔推进，不恢复旧10/80/100 ms门槛。紧急FE/9C绕过普通间隔，保留既有TX后2 ms停车链。相同固件RAM设0复现UART5 FE、设2完成入仓。自动Base使用保存的多圈后向锚点发送绝对位置模式1；仅Z上限收回可用新鲜静止/容差/使能无故障确认，不要求到位位，下降及X保持到位位。独立入仓与正式任务共用x_transfer_speed默认60。DAPLink烧录校验后连续两轮入仓松爪→后向收回完成，中间未回零/复位，首故障为空；尚不等于完整赛事和带料验收。见docs/开发记录/2026-10-07-UART5应答交接间隔与入仓连续循环实测修复.md。

- 2026-10-07：grab route [speed]更新为右下固定路线蓝色首件测试，复用ContestMission后向姿态/任务路线/单件取放，二维码直接通过、固定蓝色3入第一仓并收回朝后后结束，不续加工、不返回起点。固定测试颜色不写QR/屏幕任务码，报告mode=single source=test code=none color=3 slot=1；正式grab mission仍读取任务码，radar task start保留旧红色首件。只要求ID8参考及第一仓已配置为空；控制台视觉页单件抓取第5项直接显示启动按钮。

- 2026-10-07：上电三轴home_complete后主循环调用Turntable_BootHomeProcess自动启动一次ID8就近回零，复用Turntable_Home反馈验证并捕获实际多圈OriginRaw、第一仓相对0°/ref=1。不改驱动机械零点、不清位置计数、不预置有效位，不因普通重连/任务结束重复回零。人工转盘操作或停止取消待启动请求；忙准入重试、总线锁定显式报错。第二/第三仓不代填、库存仍待人工核对。

2026-10-08：编号环对准单独复用当前grab track速度/加速度/收敛/权重/领先参数（默认底盘160、X60mm/s、accel300、lambda2.5、lead12mm），DX/DY完成窗口各±1px；正式物料align/pick参数不覆盖。仍不预伸50mm，环模式取消轮批次额外50ms等待。环放置返回高度在顶部位置容差内归到Z_MAX，避免微小编码器误差导致提起后无法完成；下降释放到位判据保留。

2026-10-08续改：`grab ring align [1|2|3] [z_mm]`默认对准高度−100mm，视觉任务页可调。先Z最高识别，首次有效编号坐标后底盘/X对准并同时降Z；低位对准完成后退出视觉控制，保持X/底盘，只抬Z到最高进入HOLD等待装料。`grab ring place <z_mm>`放置高度独立可调。页面顶部“停止并退出色环测试”执行grab stop，停止确认后可操作其他功能；不清参考参数。

2026-10-08下降时序更新：编号环先提交底盘/X横向接近，后续新坐标根据环心接近准心进度逐步下降。640×480画面左右64px、上下48px边缘区域暂缓下降；Z目标最多领先实际反馈5mm、最短100ms更新，重复坐标不追加下降。完成仍须所设Z高度到位及±1px对准、停稳，之后停止视觉只抬Z。命令、独立放置高度和正式物料参数不变；本轮边缘/分段数值为初始调试值，软件回归及烧录已验证，实车视觉效果待验收。

2026-10-08低位观察分支：`grab ring align <1|2|3> <z_mm> stay` 在对准高度到位/停稳后HOLD，不自动抬高；保留B2编号识别及最新偏差只读显示，不继续底盘/X运动纠偏。控制台第一步两个按钮共用环号与可调Z高度；不带stay仍自动抬至最高。`grab stop`结束识别及任务，下一次启动重置分支选择。原放置和正式物料流程保留。
