doinbest/Yachiyo/xjx/模版搭建/output/pdf/task-code_126-123-216-231_A4_preview.png

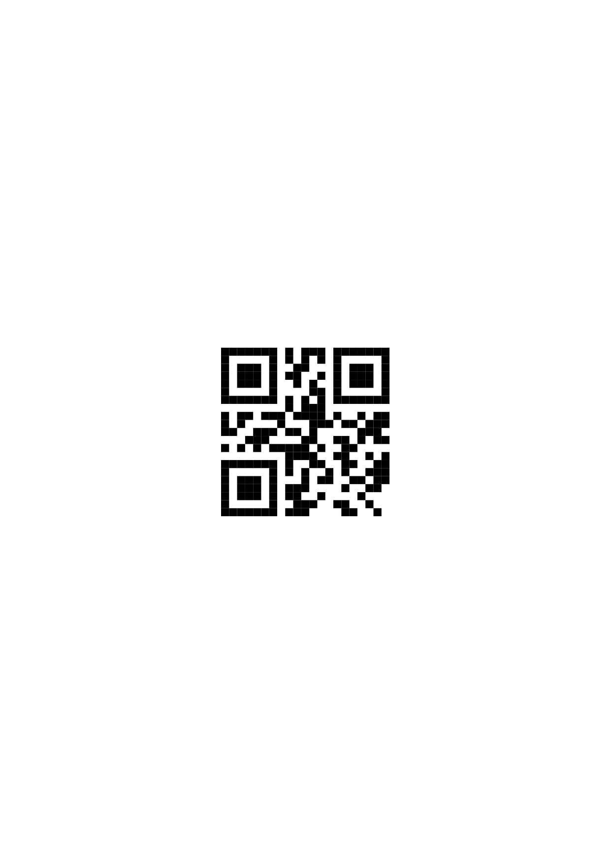
xjx/模版搭建/output/pdf/task-code_126-123-216-231_A4_preview.png
