doinbest/Yachiyo/xjx/模版搭建/output/raw-entry-rpm-preview.png

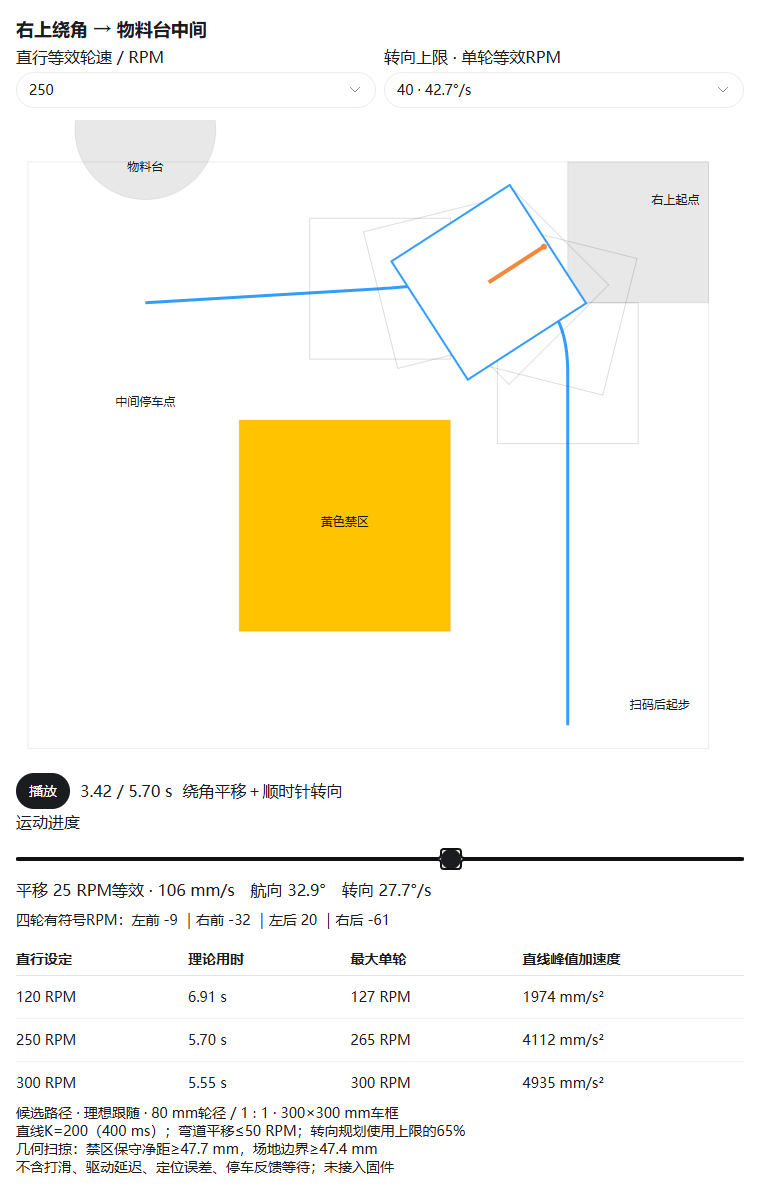
xjx/模版搭建/output/raw-entry-rpm-preview.png
