doinbest/Yachiyo/xjx/模版搭建/docs/开发记录/2026-09-30-仅协同对准改为蓝色物料.md

# 仅协同对准改为蓝色物料

用户要求将“仅协同对准”目标改为蓝色，以排查橙色夹爪与红色物料可能产生的识别干扰。此前像素跳变的原因尚未通过实物验证。

## 实现

- `grab start align` 使用 B2 蓝色物料，颜色编号 3；识别请求、请求有效性校验、坐标校验、漏检恢复和状态/坐标日志统一按当前任务颜色处理。
- `grab start pick` 及路线交接的视觉抓取继续使用红色，颜色编号 1。固定位置抓取不请求相机。
- 网页任务2说明、页面总述、README 和现行协议同步说明颜色区别。按钮命令不变，初始响应模型与准心不变；无需修改香橙派协议或程序。
- 保留工作区已有改动。本轮未连接硬件、发送设备命令、烧录或复位。

## 验证

先在旧固件逻辑上运行新增回归，确认蓝色请求断言失败。更新后验证蓝色对准拒绝红色坐标、蓝色对准完成不夹取、状态及坐标日志报告 color=3，以及随后启动视觉抓取恢复红色请求。既有蓝色对准漏检恢复、停车及红色完整抓取状态机回归通过。

- `python tests/run_firmware_tests.py`：全部通过，日志 `.embeddedskills/tests/blue-align-firmware.log`。
- `node --test upper-computer-web/local-car/tests/*.test.mjs`：116 项通过，日志 `.embeddedskills/tests/blue-align-web.log`。
- Keil `template/MDK-ARM/template.uvprojx`、Target `template`：0 错误、0 警告；Flash 137056 字节，RAM 42408 字节。日志 `.embeddedskills/build/blue-align-20260930/template-template-build.log`。
- 产物：`template/MDK-ARM/template/template.hex`、`template.axf`。未烧录。

## 实物验证

烧录新固件并完成原有回零与 IMU 验证后，放置蓝色物料并启动“仅协同对准”。核对 VISION RX 中 color=3，观察夹爪进入画面时 cx/cy 是否仍跳变。软件测试与编译通过不代表已确认干扰来源或实车闭环通过。
