doinbest/Yachiyo/xjx/模版搭建/docs/开发记录/2026-10-08-一键追踪与快速物料夹取.md

# 一键追踪与快速物料夹取

## 需求与参数

控制台动态追踪页合并观察、料台参考、开始追踪操作，增加作业姿态准备与实际物料夹取。保留持续追踪，物料停止后仍继续跟随，不把“追踪并夹取”混入纯追踪。

物料准心保持(334,338)，动态追踪窗口水平/垂直各±5 px；编号环独立(378,333)、±1 px不变。原料已有z_grab=-80 mm、z_lift=-40 mm；粗加工实物验证的-150 mm不能作为原料台高度。Z原观察/提起速度55.5556 mm/s保持，新z_pick_speed默认111.111 mm/s，当前480脉冲/mm、3200脉冲/转对应1000 RPM。正式store和新夹取复用axis_move的下降选择，色环/车载放置不使用快速夹取速度。

## 操作与实现

- 准备抓取姿态：`grab pose work`。Z抬起、X收回、Base到作业方向，等待work_ready。面板接收姿态进度，准备期间“读取状态”读grab status。
- 一键持续追踪：`grab track begin [color] [remaining_mm]`。先在GRAB_TRACK_OBSERVE收集本轮新鲜反馈和视觉，用现有fit_ms（默认240 ms）观察窗口估计目标速度。反馈停稳且新坐标有效后，缺少参考才按0～50 mm初始余量建立参考，再启动追踪。已有参考和已耗预算沿用，不因重连/重新点击充值。旧observe/reference/start保留。
- 追踪并夹取：`grab track pick [color] [z_mm] [speed_mm_s]`。自动入口相同；默认使用z_grab/z_pick_speed。目标对准稳定，估计目标在下降+闭爪期间的漂移不超过现有像素窗口时，请求停车。停车反馈确认且停车后新坐标仍在窗口，下降闭爪提起；目标偏出或漏检时回到原追踪/视觉暂停恢复，不闭爪。下降/闭爪/提起复用transfer_process，完成picked后保持物料，不转ID8、不改库存、不自动入仓。
- 控制台夹取高度、下降速度是明确发送的草稿，固件受理后写入共享RAM参数z_grab/z_pick_speed，正式原料取料复用。抬起使用已有z_lift。默认首次夹取缺参考采用50 mm，其他初始余量先用一键追踪建立。未识别到目标时不运动。
- 人工停止仍结束本轮，不自动续追/闭爪，保留料台参考与已耗预算。

## Base准备卡住

后续实测发现本节最初的模式2相对补偿会转回约2.36°，目标仍90.90°。现已改为低速重发原绝对目标；下面“相对小角度修正”仅记录最初实现，已被替代。修复与烧录验收见[Base微调绝对目标修复](2026-10-08-Base微调绝对目标修复.md)。

此前实际反馈为88.605°、目标90.113°，静止且使能，但差1.508°超过1°业务容差。任务未作修正，一直占用busy。现在任务拥有的Base转向在命令后新鲜反馈确认停稳、驱动正常且差1～5°时，以测量误差发送相对小角度修正，速度不超过15 RPM；原最终目标、后向锚点和1°容差不变。大角度、未停稳、过期或驱动故障不触发小步修正。没有删除MechanicalArm接口，也未处理已延期的手动Base作废参考问题P001。

## 验证

新增grab_track_pick_test先在旧代码因未知入口失败，修改后通过：自动观察/参考/追踪、保留预算、快速下降闭爪提起、目标偏移恢复、漏检、未到位人工停止、非法高度不写参数。grab_pose_test先复现1.5°差导致准备不完成，修正后通过。相关grab_task、grab_transfer、grab_grace、grab_track_task回归通过。

控制台真实mountTracking函数的Fake DOM回归覆盖按钮命令、被动重连、准备进度、停止、错误与冻结日志导出；物料参数页同步新增z_pick_speed。全部网页Node测试477项通过。Keil主车Target template构建0错误0警告。主机模拟与编译不代表实物高度、速度和夹取验收。

本轮串口桥保留用户选择的COM38/115200，连接后发送停止和查询未收到设备回复。CMSIS-DAPv2读取探针信息报CMD_INFO失败；未烧录，也未启动实车新夹取流程。恢复连接后烧录仍需提醒重开香橙派，得到重开回复后再执行依赖视觉的实测。
