doinbest/Yachiyo/xjx/模版搭建/docs/开发记录/2026-10-14-开局与物料台连续转弯.md

# 开局与物料台连续转弯

用户确认：整车按300×300 mm计算；开局边移边转到90°随后直行，物料台进站同样连续转向；接受转弯向路口内侧偏移约50～100 mm，工位终点不变。前后轮轴心距200 mm另记，本轮未调整现有轮径80 mm、运动学轴距210 mm或轮距240 mm。

## 实现

- 正式标准右下首段：保持180°从(2250,150)靠近(2050,350)，沿内侧弧段转至(2050,450,90°)，连续接入二维码终点。原(2100,300)不再成为停车/原地转向点。
- 第一批物料台：从(2100,2100)靠近(1300,2050)，沿内侧弧段转至(1200,2050,0°)，连续到(1200,2100)。第二批从中心朝90°接近(1200,1950)，沿另一条内侧弧段转至同一物料台方向；中心原有转向仍保留。
- `chassis_path.h`维护共用几何；`chassis_motion.c`按反馈投影推进路径、跟踪位置与朝向，转弯前减速，并受本轮角速度限制。中间节点不发停车，终点继续使用新鲜位置/航向及实际停车证据。
- 路线暂停保存毫米进度；继续从保存路径和当前反馈续接，不重走开局或弯道。正常故障、暂停、终止语义保留。
- QR Base+35°在车体完成转向后与直行并行，只允许在已有收X/提Z行驶姿态上做Base准备，并重新核验机构反馈。物料台曲线完成车体转向后标记`work_dock`，再允许作业姿态准备；到工位仍等待机构完成。
- 离线C输出`kind=curve`和路径节点；网页连续插值位置和角度、绘制内侧路径，只记录整段终点停车。普通路线/独立二维码测试、加工/暂存、非标准规划接驳保留原语义。

## 验证

- 新增路径profile测试、二维运动模型、完整车框检查及网页C路径消费测试。
- 二维模型包含100 ms一阶运动响应、0/120/220 ms位置反馈延迟、1000 mm/s路线设置、20/50/100°/s限制、弯中暂停续行。模型终点位置误差小于12 mm、航向误差小于2.1°，转弯运动期间未插入停车。8199个模型位姿的300×300 mm完整车框检查通过；旋转中心假定在车框中心，仍需实车验收。
- 本轮路线/预演相关网页27项通过；profile、路径运动、任务路线、连续衔接、QR并行准备和机械臂衔接测试通过。离线规划对应改动的测试通过。
- 全量网页618项中614项通过、4项失败，分别是其他既有修改后的路线速度默认值及参数数量/页面预期未同步；本轮未改这些默认值/布局。完整固件回归先遇到旧128°测试夹具与当前130°源码不符；撤去本轮GrabTask改动后同样复现。将相关pose/choreography夹具改为共用作业角常量后通过；后续扫描到既有`radar_console_test`仍期望默认200而当前为1000。全量不标为通过。
- Keil Target template于2026-10-14 05:09:44完成：0错误、0警告。

## 下载状态

OpenOCD于05:13重新检测已确认的CMSIS-DAPv2探针`7b168f48`、SWD/stm32f4x、1000 kHz，返回`CMSIS-DAP command CMD_INFO failed`。当前未识别到目标芯片，未烧录或复位实车。

保留HEX：`.embeddedskills/continuous-turn/firmware.hex`；SHA256 `6DF8578067D566E3849BBAA460C503B61EB27F025283BC282CF48539A10AFFE2`。构建、探针及测试日志均在同目录；实车验收和全面审查尚未完成。
