doinbest/Yachiyo/xjx/模版搭建/docs/开发记录/2026-09-24-F103物料台转盘双按键控制.md

# F103 物料台转盘双按键控制

> 此前状态（2026-09-25，已由下述按键直发联调替代）：用户在恢复按键后再次要求切回上电直发。main 当前调用 Turntable_BootInit/Process：1 秒后使能，100 ms 后发送 8 RPM 连续旋转；不启用按键、分度和停留，不依赖回包。保留两套模块，仅切换入口。独立回归和 Keil 编译结果见原日志目录；本次不执行烧录。下文保留此前变更记录。

> 2026-09-24 临时联调状态（已于 2026-09-25 被替代）：用户反馈按键后无反应，要求临时停用按键。当时 main 入口改为 `App/turntable_boot.c`：上电 1 秒发送使能，100 ms 后发送 8 RPM 连续旋转指令，不依赖回包、不启用按键。原模块保留；下面记录为此前分度控制版本。未确定无反应的硬件根因，未将直发联调描述为按键故障已修复。

直发联调测试覆盖上电等待、两帧内容/间隔、仅发送一次、不依赖 GPIO/RX、计时回绕及 HAL 发送失败结果。当前模式无分度停留，需断电停止电机；状态变量只记录本机发送尝试及 HAL 返回结果。

## 需求与确认

在 `物料台转盘/turntable` 用户已生成的 STM32F103C8T6 HAL 工程中开发。独立于 F407 小车固件。

用户确认使用 Emm42 固件、其余默认配置，电机与转盘 1:1 直连；仅焊接 PA15/PB3，按下接 GND。取消机械回零和 PB3 长按，人工摆成人字形起点。停留时间确定为 2 秒。

核查比赛资料：命题与运行第 4 页、2027 宣讲第 12 页均规定 6-10 秒/圈，停留次数及时间以现场为准。选择 8 RPM（匀速段约 7.5 秒/圈），不把包括停顿的循环平均速度当作该转速。

## 实现

- PA15 自动启停；PB3 停止状态单步；20 ms 消抖，无长按、无连发。
- 首次操作读取实时位置建立人工起点；不做机械回零、不发送坐标清零、不修改驱动器持久参数。
- 首次 60°，后续 120°，累计绝对目标避免三等分取整漂移；中途停止保留原目标。
- 默认地址 1、115200/8N1、CW、加速度档位 10、到位停留 2000 ms。
- 按手册区分 3200 命令脉冲/圈和 65536 反馈单位/圈；Receive 应答只代表命令受理。
- 连续两组状态、位置、零速反馈确认到位；停止也必须有 ACK 和零速反馈。
- 通信/驱动/运动超时会尝试停止并锁定故障，不能把停止指令发送等同于物理停车。
- `main.c` 只改 USER CODE，Keil 增加 App/Hardware 源文件及头文件目录。保留用户已生成的 .ioc、时钟及 GPIO 初始化；未使用 PB4。

## 验证与限制

先编写行为回归，空实现在首次 60°命令断言失败，再实现真实状态机及协议模块。主机测试覆盖自动/单步、停留时长、长按不重复、停止续行、旧到位状态、拒绝/超时、失能、按键消抖、累计取整、负起点、计时回绕、串口分包/错误尾字节。

Keil Target `turntable` 首次编译 0 errors / 0 warnings；后续最终验证以 `.embeddedskills/turntable/host-tests.log` 与 `build/turntable-turntable-build.log` 为准。

没有执行烧录、复位或串口发送。位置方向、负载启停、实际停留、停止续行须上板验收。通信丢失不保证停车；故障后需排除原因、重新上电并确认人工摆放位置。

## 2026-09-25 恢复双按键入口

用户确认原因是串口线接反，已经纠正，要求恢复原按键版本。main.c 切回 Turntable_Init/Process；保持 PA15 自动启停、PB3 停止状态单步、首次 60°后续 120°、8 RPM、到位停留 2 秒。无长按和机械回零。直发联调模块保留但不调用；不修改引脚、时钟或电机永久配置。用户报告的接线原因不等同于本次按键分度功能已实物验收。

验证使用独立主机回归与 Keil turntable Target 编译，结果见 .embeddedskills/turntable/host-tests.log 和 build/turntable-turntable-build.log。本次未烧录或发送硬件命令。

## 2026-09-25 双按键不等待回包联调

用户实测上电直发 8 RPM 可正常转动，但原按键版无反应。源码分析表明原版按键后先读取位置并等待回包，无法仅凭直发正常断定按键有问题。用户同意 PA15/PB3 均不等待回包。

新增 turntable_direct 模块，main 切换到此入口：PA15 直接启停 8 RPM 连续旋转；PB3 空闲时单步，首次 60°、后续 120°，Emm FD 模式 2 相对实时位置，不依赖坐标查询。使能与运动间隔 100 ms；20 ms 按键消抖，按住不连发。单步完成仅按速度估时加 500 ms，不宣称实际到位，也不保留被打断目标的续行语义。原带反馈模块和上电直发模块均保留不调用。

增加按键事件数和 HAL 发送结果观察变量。无 RX 实现的主机测试覆盖两键指令、启停、单步、长按、等待使能期间取消及计时回绕；完整独立回归与 Keil 编译日志在 .embeddedskills/turntable。未烧录、未实测按键。已保存的上电直发提交 2e23ffe 保持不变。

## 2026-09-25 纠正 PA15 自动流程

用户指出 PA15 被错误改为持续旋转，偏离原自动分度需求。当前无回包入口恢复 PA15 自动分度：首次约 60°，之后每次约 120°；每段按脉冲/速度估时加 500 ms 后再停留 2000 ms。PB3 保持单步；运行、停留或使能等待阶段按 PA15 均取消自动流程并发送停止。停止 TX 失败也取消待发送动作，允许再次按 PA15 重发停止。两键仍不等待回包、不查询位置；未改成 DMA。无反馈版本仍不能精确确认到位或补完被中断目标，不能将估时写成实际到位。

先将回归期望改为 PA15 发位置指令，测试在旧速度指令处失败；修改后验证首次/后续角度、2 秒软件停留、PB3 不自动循环、旋转中/停留中/使能间隔中停止及计时回绕。最终测试和 Keil 编译结果见既有日志目录。本次未烧录。

## 2026-09-25 相对位置模式兼容修正

用户实测第一段 60°正确，第二段只再走 60°，之后停留在 120°。当前 FD 模式字节为 2，参考示例注释定义为相对实时位置，但实物现象与该非零值被按绝对目标处理一致；尚未读取驱动固件版本，不断言具体版本行为。

将当前 turntable_direct 位置指令改为模式 0（相对上一输入目标递增），避免依赖模式 2。正常每段完成时，累计命令目标为 533、1600、2667、3733 脉冲，约 60°、180°、300°、420°。PA15 自动循环、PB3 单步、8 RPM、估时后停留 2 秒及不等待回包不变。中途停止后无反馈，不能保证相对实际停点的精确续行。

增加模拟“非零模式按绝对目标处理”的兼容测试，旧代码在第二目标应为 1600 的断言失败；模式 0 修正后验证自动和单步的累计目标。该测试复现用户现象，不代替固件版本确认或实物验收。未烧录。
