doinbest/Yachiyo/xjx/模版搭建/docs/开发记录/2026-10-16-开源工程来源清单整理.md

# 开源工程来源清单整理

用户要求列出此前检索过的工创赛智能搬运代码并提供GitHub等来源链接。

新增[已检索开源工程与链接清单](../赛事资料/智能搬运赛题/已检索开源工程与链接清单.md)，以原综合报告26个来源为基础，补入后续Gitee塔吊完整工程及本对话的ZexinLiang项目，合计28个入口（GitHub 26、Gitee 2）。enginer-train迁移地址合并计数；同源、视觉专用、邻近AGV、空框架和资料索引分别注明，不宣称28套独立完整工程。

本轮在线复核ZexinLiang与DylanLi0720同名仓库、enginer-train重定向及Gitee塔吊入口。ZexinLiang README描述2025项目，DylanLi0720仓库描述2021项目；不能据同名认定同作者或实验室传承。视频只收录原研究报告已记录的两条对应链接，另保留Gitee作者教程；ZexinLiang未确认的视频不编造链接。

同步文档总入口、参考代码入口和开发记录索引。检查条目编号、GitHub/Gitee计数、原报告来源覆盖、旧地址去重、本地相对链接及差异；历史报告不改写。本轮仅文档整理，未修改运行代码、未编译、未烧录、未访问串口或部署远端程序。
