doinbest/Yachiyo/xjx/模版搭建/docs/开发记录/2026-10-17-第二批物料台接近直线误限速修复.md

# 第二批物料台接近直线误限速修复

用户发现第一批暂存结束、返回地图中心后第二次前往物料台很慢，要求修复并检查后续类似情况。沿用当前“只修改、不测试、不编译、不烧录”。

## 根因与修改

ChassisPath_Build的物料台kind3路径在(1200,1950)点设置60，其limit实际约束从前一节点(1200,1200)到该点的整段，path_command对当前段制动距离取0，因此750 mm长直线也被锁在60。共享kind2东侧连续进站同类。仅提高总速度或转向上限不能解除该限制。

修正kind2/3的长直线终点limit为传入的路线阶段速度，仅后续20个转弯点保留min(阶段速度,60)。没有改变坐标、航向、节点数或转弯几何，也不增加中间停车；保留路径前瞻对后续弯道的提前制动、300向量加减速、150制动预算及航向误差限速。kind1余弦开局200限制保持，P010不在本次修复范围。

正式linear的work_curve长直线基准上限取min(请求路线速度,CHASSIS_MISSION_TRANSIT_MM_S=800)，连续加速度仍300；区别于普通直线的800起步配置。速度分配提前到ChassisPath_Build之前，路径基准节点使用已分配速度，随后阶段和PathStart按原职责对K各缩放一次，避免用原始1000构造与800阶段不一致的节点。估时对K=1也计入实际分段限速，避免仅按高速总上限估算。实际750 mm峰值受加减速距离约束，不能据参数800宣称实车达到800。

Code/tools/radar_plan_cli.c同步用phase->speed_mm_s构造路径，与固件同源；未构建工具或更新旧缓存二进制。现有curve profile测试源码改为长直线1000/后续弯道60、请求40时全段不超40，并增加正式linear曲线阶段800/加速度300断言；整场分段速度测试期望将第二批1000曲线改为800。未执行测试。

## 后续路线静态检查

- 旧kind2东侧连续物料台接近存在相同点限速问题，已共享修正；当前正式第一批仍走横移再原地转向，不因此改为连续弯。
- 第二批物料台至加工区按普通分段，通道上限1000及原起步800；末端贴近50有独立短阶段。
- 加工退出/地图中心、中心到暂存、暂存退出后的长通道以及最后回起点仍按普通分段分配，未发现把长直线绑定60的相同路径。工位退让/对接75 mm及工位内换环50是现行机械/视野动作范围，最后短斜移300是独立短段上限，均保留。
- 普通直线路径未经过raw kind2/3的硬编码60；连续开局kind1的200为当前不用的余弦兼容边界，不按本次问题解除。

## 状态

代码、预览生成源码、相关现行文档和既有测试源码已修改。本轮仅阅读与编辑，未运行测试、未编译CLI/Keil、未烧录/复位/连接实车，未证明性能或整场通过。需要后续验证入弯前减速、暂停续接、倍率、低总速度及预览一致性，实车效果尚未验收；此前HEX不含本次修复。
