doinbest/Yachiyo/xjx/模版搭建/docs/开发记录/2026-10-14-物料台进站姿态完成衔接修复.md

# 物料台进站姿态完成衔接修复

## 现场证据

COM11/115200控制台只读日志：底盘station=4、visit=2、phase=move、stop_confirmed=1；机械臂complete/work_ready，Base129.67°对目标130.27°；比赛仍driving/to_raw，视觉Idle。完整记录位于.embeddedskills/raw-station-diagnosis-20261014/。

## 原因与修改

contest_mission.c在M_DRIVING中将WorkReady的更新限制在work_turn/work_dock内。chassis_route.c末端误差修正会改为move，之后机械臂虽完成，比赛未接收完成状态，不能交接物料台。

现改为WorkStarted后独立接收该次work_ready，原姿态启动边界、底盘工位与停稳判定保留。暂停继续保留WorkStarted，不重复准备；没有启动本次姿态时，不接受旧完成状态。本次不改视觉、抓取参数、路线、第三件避让或夹爪动作。

## 验证

新增回归先在原代码复现失败，修复后通过：物料台/加工区/暂存区，move修正中或已station时姿态后完成，暂停继续，底盘尚未停稳，以及旧姿态不能冒充本次完成。保留原两批完整调度验证。

共7组相关主机测试通过：contest_choreography、contest_mission、mission_scan、mission_prepare、mission_cancel、mission_recovery、chassis_route_continuity。Keil主车template编译0错误0警告，日志和固件保存于.embeddedskills/station-handoff-20261014/。实车流程待用户验收，下载结果后补。

03:43:40下载完成：CMSIS-DAP 7b168f48 / SWD 1000 kHz，当前IDCODE=0x10076413、Flash=1024 KB；programmed=true、verified=true，已复位运行。固件SHA256：4d1c2ff5299354dcb44af5bdf96d017c6e7a2fd22da049217fdd832d9055c8fc。未发送比赛启动或其他机构测试命令。

## 修复后审查

本轮主审与独立审查未发现限定差异中的可复现缺陷或新增回归。已核对姿态启动边界、完成接收、工位停车门槛、暂停恢复以及跨工位标记清除；未启动本次姿态时不会接收旧work_ready。暂停恢复不重复创建准备任务，但仍由原流程重新核验姿态。

另运行4组离线测试：contest_choreography、mission_grab_integration、mission_stop_feedback、chassis_route_pause_feedback，全部通过。其中真实比赛与抓取状态机联动完成两批12次入仓和12次放置，并覆盖暂停及并行衔接。证据位于.embeddedskills/station-handoff-20261014/review/。

现行比赛约定、视觉任务手册及机械臂协议的衔接说明已移至对应比赛章节，并澄清暂停后的姿态复核语义。本轮审查未修改运行源码，未重新编译固件、烧录或操作实车；实际进站位置修正及暂停恢复后的连续夹取仍待现场验收。
