doinbest/Yachiyo/xjx/模版搭建/docs/开发记录/2026-10-14-统一DXDY与物料台一次横移.md

# 统一DX/DY与物料台一次横移

用户确认全部视觉控制直接消费B2 DX/DY；随后确认码垛39/−1补偿已加到香橙派，要求STM32删除该补偿。同时指定正式比赛保持90°从(2100,2100)左移至(1200,2100)，再转0°。

## 实现

- GrabTask颜色、编号环、暂存、加工取回、追踪和码垛统一使用报文DX/DY，真实零值不回退到CX/CY计算。删除ref_u/ref_v、MaterialErrors分流及相应网页字段；55项参数由grab_parameters.def生成网页元数据。
- CX/CY只保留记录和视野边缘判断。渐进下降用同一帧CX−DX、CY+DY推得视觉准心作为视野比例，控制误差始终用DX/DY。
- 删除STM32 StackCompensating状态、39/−1常量和二次对准。单项与比赛码垛以0/0为目标；保留新帧稳定、停车、机械到位、下降与释放阶段。网页按钮改为“码垛视觉对准”。香橙派补偿已部署为用户提供事实，本轮未修改或部署视觉端。
- 物料台同高度向左末段不再分825+75 mm；横移900 mm后转0°，网页预览共用C核心。加工/暂存及非水平物料台进站仍使用原接驳，不删除雷达规划途经点。

## 审查与验证

检查正常控制、有效零值、准心改变、漏检恢复、暂停续接、码垛最终放置及固定/规划路线预览。新用例在旧代码复现旧准心和二次补偿问题；修复后通过。更新旧75 mm路线断言，同时将仍需覆盖的转向后靠近/暂停测试移到加工区，保留其覆盖。共享工作区新增Ex接口导致mission_stop_feedback_test缺测试桩，补齐代理桩后全套通过，未改变该任务运行逻辑。

- 固件完整主机回归：PASS；含实际GrabTask与比赛调度两批12入仓/12放置模拟。
- Node控制台：606通过，0失败。
- Python地图预览：26通过。
- Keil template编译：0错误、0警告。
- 检测到Horco CMSIS-DAP v2；工程配置CMSIS_AGDI、SWD、STM32F407VGTx、1MB Flash。沿现有Keil链路下载，2026-10-14 00:03:11日志确认Erase Done / Programming Done / Verify OK / Application running。未额外读取芯片UID。

日志：.embeddedskills/tests/dxdy-route-final-firmware.log、dxdy-route-final-web.log、dxdy-route-preview.log；构建/下载为.embeddedskills/build/template-template-{build,flash}.log。

软件验证和烧录已完成，实车DX/DY符号/目标、码垛无双重补偿及(1200,2100)原地转向的完整车体包络仍需实车验收。刷新控制台加载新字段与文案。
