doinbest/Yachiyo/xjx/模版搭建/docs/开发记录/2026-09-27-扫码与静止物料单件协同抓取方案.md

# 扫码与静止物料单件协同抓取方案

日期：2026-09-27。

> 后续实施状态（同日更新）：用户已确认新PCB后的底盘方向、机械臂极性及Base回零点设置完成，并授权代码实施。实现顺序调整为固定姿态抓取→物料台协同对准→单件完整抓取→扫码/前四段路线。当前软件入口与参数见[单件抓取实现与标定](2026-09-27-单件抓取实现与标定.md)，执行记录见[实施计划](2026-09-27-单件抓取实施计划.md)。以下保留最初设计及当时静态核对事实；“待实现”不再单独代表当前代码状态。实测位置/响应/抓持验收仍独立进行。

状态：控制设计与实测方案；本文不表示功能已实现或已上板验收。本轮只新增本文，不修改运行代码。参数分为用户已确认值、源码事实、建议初值和待实测值。

## 1. 已确认需求和本轮验收范围

- 用户已经在上位机控制台验证固定16段路线能够实车运行。
- 用户已实测验证天空星Type-C口与香橙派USB接口相连可以通信；脚本通过`--uart-port`指定USB设备。此链路作为已验证基线，后续不重复作为未知条件。
- 扫码模块尚未安装；到扫码站确认停稳后等待1000 ms，以模拟扫码方式载入 `156+123+516+231`。
- 第一批颜色顺序是红、黑、浅蓝，放置编号1、2、3；第二批颜色是黑、红、浅蓝，放置编号2、3、1。
- 第一次抓取测试：转盘保持静止，按第一批第一项抓红色物料。塔吊Base保持已经摆好的工作角度。
- 夹爪500 us打开，800 us闭合。带物料闭合时间、抓持可靠性仍需实测。
- 首轮终点是抓起一个红色物料并暂停，人工检查是否抓牢。三个物料连续抓取、车内存放及后续路线属于后续阶段。
- 软件完成一次闭合/抬升不能独立证明“正确抓取”；没有抓持传感器时，先由人工验收，串口屏正确抓取数不因闭合指令自动增加。

## 2. 路线、扫码和显示

当前路径前四段为 `(2100,300)` → `(2100,1200)` → `(2100,2100)` → `(1200,2100)`，航向90度。结合现有地图，扫码站位于第2段，原料台位于第4段。任务点序号不能直接当作路线段号。

建议增加独立“两站单件抓取测试”入口，复用16段路径中的前四段及已经验证的运动控制。原有纯路线测试仍作为独立入口。测试开始由用户在上位机显式触发。

### 扫码站

1. 第2段结束，沿用原有到点与停车反馈判据。
2. 从停车确认后计时1000 ms，主循环继续运行，不能阻塞串口、电机反馈和显示处理。
3. 计时结束，载入同一份完整任务码并明确来源为“模拟扫码”。任务调度、OLED、串口屏和上位机都读取该任务数据；不伪造UART4收到真实二维码的统计。
4. 串口屏上行显示 `156+123+`，下行显示 `516+231`，抓取/放置数初始为0。等两行发送完成后再推进第3段；发送完成与屏幕实际显示正确分别验收。若传输失败，停留并报告，不带着旧显示继续。
5. 当前屏幕每100 ms最多发送一个字段，显示发送可能让站点总停留略长于1秒；1秒指模拟扫码等待，不是全部站点动作的严格总时长。

### 当前必须处理的接入问题

- `QR_Init()`清空RAM缓存；没有当前任务码的掉电保存。测试码应作为明确的测试配置。
- `main.c`只在路线和距离任务都空闲时调用 `ContestScreen_Process()`；路线waiting也算忙，必须在扫码站允许显示刷新。
- 当前按键测试的 `Camera_ColorTaskDigitGet()`读取第二组；自动抓取应读取第一组，任务解析需统一，不能把放置编号当颜色。
- `ChassisRoute_IsBusy()`包含waiting，机械臂和物料任务会拒绝启动。需增加清晰的站点任务交接状态，释放路径运动控制权，同时禁止自动进入下一段。
- 当前自动路线一般站点等待是100 ms；扫码站的1000 ms应独立定义。

## 3. 控制方式和源码适配

### 采用的思路

借鉴参考项目持续根据视觉修改底盘和伸缩目标的方式。同一次视觉计算同时产生底盘前后、左右和X轴修正，不设置“超过15像素只让底盘动”的交接阈值。

本车建议底盘输出有限幅和加减速限制的平移速度，航向使用已有HWT101保持；X轴输出持续更新的绝对位置目标。底盘反馈用于速度限制、停车确认和工作区域约束。参考项目的OPS场地位置外环不能直接当作本车已经具备的能力。

### 坐标与控制分配

统一定义视觉误差 `e=(DX,DY)`，车身位移 `q=(前进mm,左移mm,X伸出mm)`；实际正方向与现有驱动接口在适配层对应。固定Base和车身航向，分别测量各动作产生的两个像素分量。

测得局部响应矩阵 `J=像素误差变化/机构位移`，大小为2行3列。小范围近似下，误差变化率为 `J*v`。共同控制目标为 `J*v ≈ -lambda*e`，其中lambda单位1/s。视觉尺度用于估计效果，lambda决定修正速度。

若两执行方向的响应近似共线，可以在该方向按贡献比例分配；若交叉影响显著，应按测得的响应求解两个方向的修正，不能把DX、DY机械地一对一分配给机构。可使用带权的最小位移速度解；权重使X在可用范围内多承担修正，接近边界时减少其贡献。近共线导致无法修正二维误差时，需要调整观察姿态并重新测量。

“X承担70%、底盘承担30%”仅适用于两者都能有效修正同一方向的初始分配建议，指像素修正贡献，不是原始增益比例，更不是所有姿态都适用的硬性规定。所有机构的合成修正须满足同一个总体速度要求，避免每个单轴全强度输出造成过冲。

### 时间、目标和总线

- 当前底盘批次启动间隔至少100 ms；视觉采集频率、控制计算频率、总线下发频率分别记录。
- 首轮建议以100 ms作为运动目标更新的起点，并以实际完成时间验证。只发送最新目标，不积压已经过时的位置请求。
- X目标按 `x_target += vx * dt`更新。dt使用实际时间，暂停/丢帧后不把整个停顿时间补积分；内部使用浮点或保留小数余量，在最终下发时换算整数脉冲。
- X目标受绝对机械边界约束，还要限制目标领先实际反馈位置的距离；执行器跟不上时不得继续积累远处目标。
- 必须先验证Emm驱动在运动中接受绝对位置更新的行为；软件收到ACK不等于运动完成。绝对零位置应允许表达，当前接口拒绝Position==0的条件需要区分相对零位移和绝对零目标。
- 四轮批次和同步帧保持完整，X/Z请求安排在批次间，持续保留反馈查询时间。串口传输顺序执行，电机实际运动可重叠。
- 抓取任务统一拥有执行机构，避免路线、手动控制与视觉控制同时改写目标；通过任务权限适配现有busy判断，不能简单删除所有互锁。

## 4. 首轮状态流程

| 阶段 | 动作 | 转移条件 |
|---|---|---|
| 前往扫码站 | 执行第1、2段 | 第2段到点且停车确认 |
| 模拟扫码 | 等1秒，载入并显示固定任务码 | 计时结束、任务码合法、两行发送完成 |
| 前往物料台 | 执行第3、4段 | 第4段到点且停车确认 |
| 观察准备 | Base保持，X/Z到已标定预备位置，500 us打开 | X/Z反馈到位，姿态有效 |
| 目标获取 | 请求颜色1，等待请求后的有效新帧 | 红色目标有效、数据新鲜 |
| 协同对准 | 粗定位阶段共同接近，圆心精定位阶段重新累计稳定条件 | 已确认精定位阶段，误差窗口、稳定时间、新帧数量和低速条件均满足 |
| 停止水平运动 | 底盘和X停止，继续观察 | 停车与X反馈稳定，视觉仍在窗口内 |
| Z下降 | 首轮保持水平位置，Z下降到夹持高度 | Z反馈到位，无故障 |
| 闭合 | 800 us，等待标定闭合时间 | 计时完成；只代表动作完成 |
| 抬升 | 保持夹爪闭合，Z到提起高度 | Z反馈到位 |
| 等待验收 | 保持夹持，不自动进入第5段 | 用户检查物料是否被抓牢 |

水平停止后若视觉超出窗口，回到有限次数的对准重试，不能无限往返。Z下降后的视觉误差只有在验证高度相关映射后才可用于水平修正。首轮不启用下降期间追踪；第二阶段可在已验证的间隙内重叠下降前段和小幅修正。

丢帧、目标无效、行程边界无法消除误差、反馈失效或电机故障：结束本次动作并请求相应机构停止，不继续下降、不自动续跑路线。闭合后故障默认保持夹爪和升降轴承载状态，不能用统一失能造成物料或Z轴下落。报告停止请求与反馈确认的区别。

## 5. 参数确定和测量方法

### 5.1 机械位置尺度

使用已有 `pos x/z <degree>`、`position x/z` 操作小范围运动，记录前后实际位移和反馈。控制台角度是电机轴角度，不能直接当毫米。

对每个轴记录正向和反向各3次。避开端点，在确认有余量后逐步扩大测量行程。

- 若轴角度变化为theta度、实际位移为L mm，则命令脉冲/mm = `(3200*abs(theta)/360)/abs(L)`。
- 若用反馈差n记录实际电机转动，则电机转数为 `n/65536`；命令脉冲的一圈3200与反馈一圈65536分别使用。
- 测得正反行程差异说明可能有回差，记录它，不能只取一次样本当最终换算。
- 设置可复现的零位/参考位置后，记录X/Z机械上下限；现有Z接口没有固定软件脉冲上限，新抓取任务必须按实测行程限制Z目标。

### 5.2 准心与高度

1. 转盘停住，红色物料摆在常规工位；手动把打开的夹爪调整到能下降包住物料的位置。
2. 记录夹持高度 `z_grab`；记录抬起后物料完全离开转盘所需的 `z_lift`。
3. 保持底盘和X不动，把Z抬到能稳定识别且有间隙的 `z_observe`。
4. 记录此时圆心精定位得到的目标中心 `(u_ref,v_ref)`，用作观察姿态准心。轮廓重心只用于接近。现有默认(334,338)只是待核对配置，不能用参考项目(320,230)替换。
5. 若相机随Z移动，记录观察、中间、夹持三个高度的图像变化；首轮不根据下降引起的画面变化追加水平修正。
6. 记录X观察位置 `x_pre` 和Base工作角度；首次预备动作的路径也须有间隙，不能仅检查终点。

### 5.3 三个运动方向的像素响应

保持目标、Z、Base和相机配置固定。逐个测试底盘前进、左移、X伸出，各次只动一个机构。

取运动前后的数帧有效坐标均值，记录实际位移d、DX变化、DY变化，得到每个方向的 `(deltaDX/d,deltaDY/d)`。前后必须采用同一种识别阶段，最终抓取标定用圆心精定位；不能把轮廓重心与圆心的差当成机构运动响应。反向返回再测，重复3次。小步长从有余量的范围开始；若像素变化小于噪声再适当增大，不预设所有机构都能安全移动10 mm。

标定只需覆盖本次预抓取位置附近，超出这个范围需要重新评估尺度。相机朝向、分辨率、裁剪或观察高度改变后应重新核对。

### 5.4 待调参数表

下列建议初值用于制定调试起点；测量不满足前置条件时不得直接启用运动。

| 参数 | 初始方案 | 如何确定最终值 |
|---|---|---|
| 扫码等待 | 1000 ms，已确认 | 不参与抓取调参 |
| 打开/闭合脉宽 | 500/800 us，已确认 | 带物料检查，不增加闭合脉宽挤压端点 |
| 更新周期 | 100 ms建议起点 | 测批次、应答、反馈和视觉端到端延迟 |
| 总体视觉收敛增益lambda | 0.3/s建议起点 | 检查不同方向误差是否平稳下降，再逐步提高 |
| 底盘平移速度上限 | 10 mm/s建议起点 | 先确认低速命令能有效执行，再按误差曲线提高 |
| X直线速度上限 | 5 mm/s建议起点 | 完成mm换算及运动中改目标测试后使用 |
| 加速度/减速度 | 待测 | 记录实际启停时间，驱动acc档位不能直接当mm/s² |
| X/Z位置、行程限幅 | 待测 | 采用本车实际边界，不照搬±80 mm |
| 抓取像素窗口 | 待测 | 从能稳定抓住的物理偏移范围与像素响应推导，并留余量 |
| 稳定判据 | 至少200 ms且至少3个不同的新帧，建议值 | 检查视觉噪声、机构残余运动；不能只计循环次数 |
| 允许下降的速度阈值 | 待测 | 结合反馈分辨率及停稳测量设置，不能只看命令速度为0 |
| 闭合等待 | 待测 | 实测500到800 us带物料闭合时间，留适量裕量 |
| 视觉最大数据年龄 | 待测 | 从新帧间隔和延迟分布定；超龄先停止修正，恢复后重新稳定判断 |
| 目标获取/对准/下降超时 | 待测后设置有限时间 | 根据正常阶段耗时加裕量，不沿用高层超时关闭配置 |

参数示例：某方向响应2 px/mm，误差40 px，lambda=0.3/s，则期望误差修正速度12 px/s，相当于总机构修正速度6 mm/s。若两机构该方向效果近似相同，70%/30%贡献对应X=4.2 mm/s、底盘=1.8 mm/s；实际方向由响应符号决定。这是计算示例，不是本车标定结果。

### 5.5 抓取窗口

从手动可抓住的位置出发，逐步改变水平偏移，测出左右、前后分别能可靠夹住的范围。窗口应考虑夹爪张开宽度、物料夹持部位、视觉抖动、停机后的残余位移和回差；按较小的可用范围留出余量。尺寸容差不足以覆盖视觉抖动时，先改善图像/姿态再调阈值。

不直接采用参考代码约±22像素，也不强制沿用本车当前±1像素。原始图像分辨率相同也不说明两车的物理容差相同。

## 6. 上位机操作与验收

以下按钮/阶段属于待实现设计，不是当前已经可用的命令。

- 保留原有16段纯路线入口；新增“两站单件抓取测试”。一次启动从原路线起点执行，首件抬起后暂停。
- 提供“物料台单件调试”，供已经摆到观察区域的小车重复测对准/抓取，无需每次跑前四段；每次显式启动并重新检查姿态、任务码和反馈。
- 标定区显示X/Z实际位置、目标位置、单位换算、观察/夹持/提起位置和准心；缺少必要标定时显示缺项，不代填未知毫米值。
- 运行区显示站点、阶段、任务码来源、目标红色、DX/DY、新帧年龄、X实际/目标、底盘速度、耗时和错误原因。
- 停止按钮终止路线和抓取的自动推进，并分别显示停止请求与反馈状态；网页重连不恢复运动。
- 串口屏正确抓取计数以人工验收或将来可靠检测为依据；本版软件仅上报“抬升动作完成，待确认”。

| 验收阶段 | 检查内容 | 通过依据 |
|---|---|---|
| 软件阶段 | 模拟扫码计时/分行/第一组颜色、任务交接、取消、丢帧、限幅、反馈与ACK区分 | 主机回归、网页/桥接回归、Keil构建通过；不等于硬件验收 |
| 路线显示实测 | 扫码点1秒等待，屏幕完整显示，物料台停止交接 | 实车观察、串口日志、屏幕读数一致 |
| 单轴标定 | 零点、位移比例、准心和像素响应 | 正反重复记录可复现 |
| 共同对准 | 从几个不同偏移开始，Z保持观察高度 | 两方向误差收敛，无持续振荡、边界累积或旧指令追赶 |
| 单件抓取 | 红色静止物料，停稳后下降、闭合、抬升 | 建议连续5次抓住并保持，记录失败现象；这是初步验收目标，不是统计可靠性结论 |
| 提速 | 一次只增加增益/速度或减少必要等待 | 成功率不下降，完整周期缩短；之后才验证下降前段重叠 |

## 7. 后续实现顺序

1. 统一任务码数据与屏幕刷新，增加前四段站点交接和首件后暂停。
2. 沿用用户确认的USB通信，补齐粗/精阶段可判定性，再增加X/Z位置标定数据、限位和准心配置，验证绝对目标中途更新。
3. 增加抓取任务统一调度与底盘/X协同控制，验证共享总线与反馈。
4. 接入停稳、Z下降、夹紧和抬升状态，补充异常退出。
5. 接入上位机入口、参数与阶段显示，完成软件测试和Keil构建。
6. 按第6节完成实物测量与验收，再确定提速参数。

代码编写、测试与集成由Codex完成；用户提供实际位移、姿态与抓取结果。当前文档中的设计不能描述为已实现。

## 8. 来源与事实核对

- 用户本轮确认：16段路线实测可运行、任务码156+123+516+231、先停转盘验证单件抓取、Base保持、500/800 us。
- 当前工程：`template/App/chassis_route.c`、`chassis_config.h`、`MaterialVision.c`、`mechanical_arm.c`、`mecanum_chassis.c`、`contest_screen.c`、`template/Core/Src/main.c`、`template/Hardware/QR.c`、`orange_pi/change.py`。
- 赛事任务码规则：`docs/赛事资料/智能搬运赛题/智能搬运赛题设计与开发指导.md`。
- 参考仓库：https://gitee.com/pinksakura/Logistics_Vehicle_F407_V2 ，本地核对版本4101ec28f1c7b968192bc09def869e88a4ea1dd7，电控V2.7.4，`RTOS_APP/Tower_task.c`与`Chassis_task.c`。
- 作者教程：https://blog.csdn.net/m0_74056439/article/details/150104661 。仓库LICENSE.txt声明CC BY-NC-SA 4.0。本轮记录控制思路，不复制作者实现进本车固件；后续若复制/改编，应保留来源与相应许可信息。
- 本文为静态代码分析及设计，无硬件发送、烧录或抓取验收。

## 9. 用户提供的香橙派实机程序核对

用户在本轮提供 `D:/Document/xwechat_files/wxid_gh3hulr1y4vm22_1404/msg/file/2026-09/change(2).py`，说明这是香橙派现在使用的代码。后续以该文件及实际启动参数为实机依据。

用户随后确认：天空星Type-C口与香橙派USB接口相连，通信此前已实测通过；启动时使用 `--uart-port` 指定设备路径。默认ttyS6未用于本次通信。链路可用性已确认；实际设备路径仅在今后执行设备访问时获取，不作为本轮设计或代码工作的阻塞条件。

SHA256：`407A6D7F290CAA52E1A0FB5AF6007AFE40864B146907C03A0AF7C3908640EED5`。

静态对比结果：`LatestFrameCamera`和`ColorCircleDetector`两个类与仓库 `orange_pi/change.py` 的AST一致；主要差异是通信封装和启动选项。Python语法解析通过，未执行相机或串口程序。

| 项目 | 实机文件默认行为 | 对方案的影响 |
|---|---|---|
| 通信设备 | 默认ttyS6；用户已确认通过`--uart-port`覆盖为USB设备 | 实际走USB CDC，与当前STM32链路一致；UART2类名不决定硬件接口 |
| 识别触发 | 收到一次 `FF B2 Color FF` 后持续识别 | 红色请求为 `FF B2 01 FF`，不要周期重发同色命令 |
| 重发同色 | command_version仍增加，重置到coarse | 每次重发会打断精定位，重试须限定在明确的重获取阶段 |
| 粗定位 | 最大同色轮廓重心，面积大于2000像素 | 用于接近，不作为已完成圆心精定位的证据 |
| 粗到精切换 | 一帧满足DX/DY各在±50像素内后，下一处理帧进入circle | 50像素是识别算法切换阈值，不是底盘/X切换或夹取容差 |
| 精定位 | Hough圆＋颜色ROI确认，同色候选取图像Y最大的圆 | 需要检查选中的是物料夹持目标；有多个同色候选时可能换目标 |
| 精定位丢失 | 返回Valid=0，保持circle，不自动退回coarse | 立即暂停修正；持续丢失时有限次重新请求，稳定计时清零 |
| 准心 | 默认(334,338)，启动参数可覆盖 | 用实际运行参数和实测抓取姿态核对 |
| DX/DY | DX=CX-准心X，DY=准心Y-CY | DX向右正、DY向上正；参考项目水平误差符号相反，不能直接复制其增益符号 |
| 采集 | 请求640×480 MJPG 120 FPS，最新帧覆盖 | 请求帧率不是实际识别输出帧率；不能据此推断120Hz反馈 |
| 输出 | `--send-hz`默认50，处理完成后按时间限频 | 实际输出不超过处理吞吐与该限频，测实际间隔；没有检测到也发送Valid=0 |
| 14字节B2 | 包含Color、Valid、CX/CY、DX/DY、校验；没有粗/精阶段、采集时间戳 | MCU无法可靠区分轮廓坐标与圆心坐标，接收序号只代表收到的数据包，不证明采集时刻 |

### 自动下降前需补齐的阶段信息

保留当前粗定位接近、圆心精定位抓取的视觉结构，但后续联合修改Python和STM32，使B2链路明确表达粗/精阶段；具体字段布局在实现时形成双方一致的协议定义并测试，不擅自把Valid=2当新阶段（现有解析器只接受0/1）。

阶段切换时重置对准稳定计时，防止粗定位的低误差直接触发下降。最终准心、抓取窗口、反馈响应均基于circle坐标。若暂不增加阶段信息，仅限人工观察视觉窗口的对准实验，不能把小误差推断为已进入精定位并自动下降。

一帧粗定位坐标与下一帧精定位坐标可能存在跳变，控制器需重新开始稳定判断并遵守速度/目标增量限制。精定位丢失或目标切换时也同样处理。

### 链路与后续范围

STM32当前 `Camera.c`通过USB CDC发送请求、接收B2。用户已确认附件启动时通过 `--uart-port`指定USB设备，因此链路一致，类名UART2不造成协议冲突。保留USB CDC通信入口；具体设备路径只在实际部署/通信时核对。

当前附件没有远程停止识别命令；MCU `Camera_RequestStop()`停止本地使用目标，不表示香橙派停止处理。首轮抓取可由MCU阶段控制是否使用视觉结果，不能假定Python已经退出circle。

当前完成：附件读取、与仓库对比、协议与控制设计修订。未覆盖附件或仓库Python，未修改固件，未运行硬件。
