doinbest/Yachiyo/xjx/模版搭建/Code/reference/GongXun2025-main/机械/初赛夹爪上层1-玻纤.SLDPRT

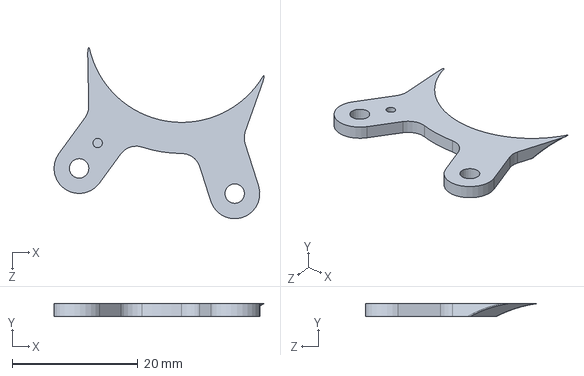
[picture p5: CAD file, 2026-09-14]
xjx/模版搭建/Code/reference/GongXun2025-main/机械/初赛夹爪上层1-玻纤.SLDPRT
33.4 x 2.00 x 27.3 mm
