doinbest/Yachiyo/xjx/模版搭建/Code/reference/GongXun2025-main/机械/下底板.SLDPRT

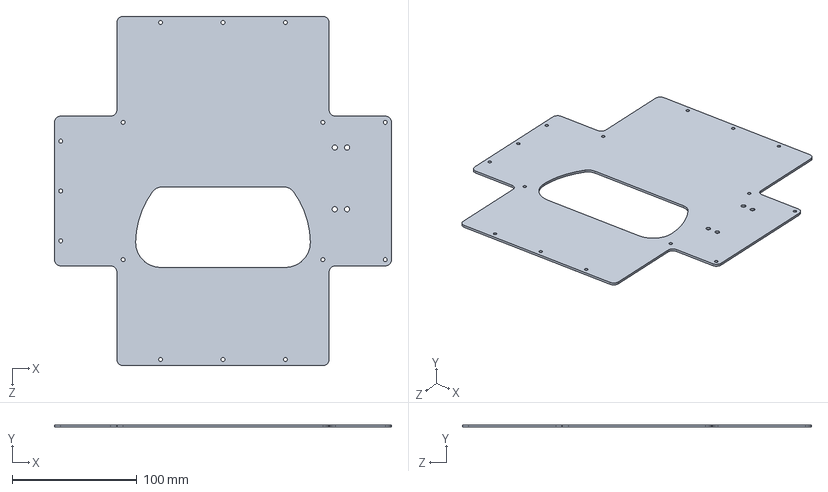
[picture p6: CAD file, 2026-09-14]
xjx/模版搭建/Code/reference/GongXun2025-main/机械/下底板.SLDPRT
270.0 x 2.00 x 280.0 mm
