doinbest/Yachiyo/xjx/模版搭建/Code/reference/GongXun2025-main/机械/同步带.SLDPRT

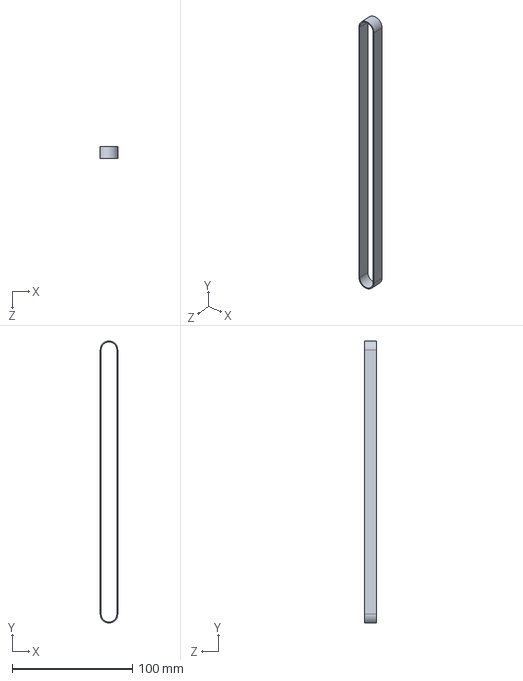
[picture p7: CAD file, 2026-09-14]
xjx/模版搭建/Code/reference/GongXun2025-main/机械/同步带.SLDPRT
14.6 x 234.6 x 10.0 mm
