doinbest/Yachiyo/xjx/模版搭建/Code/reference/GongXun2025-main/机械/初赛物料座.SLDPRT

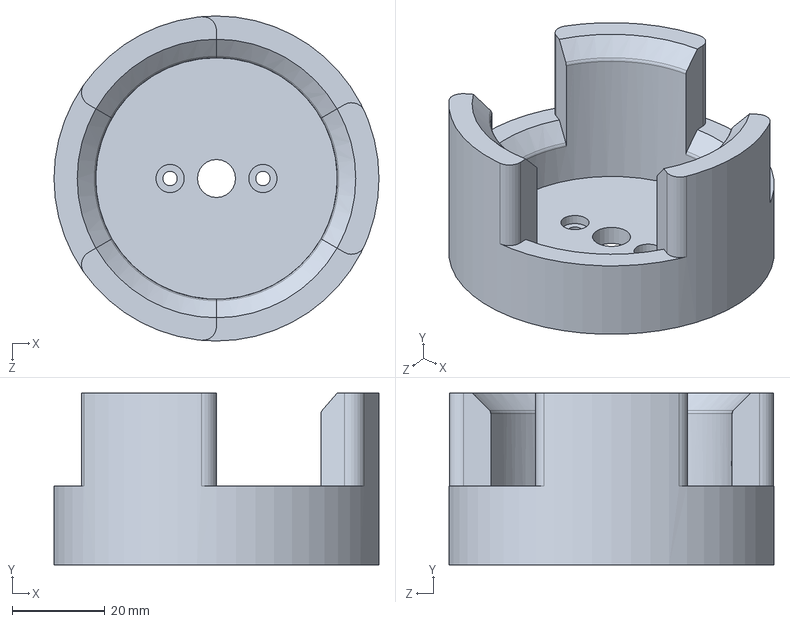
[picture p9: CAD file, 2026-09-14]
xjx/模版搭建/Code/reference/GongXun2025-main/机械/初赛物料座.SLDPRT
70.0 x 37.0 x 70.0 mm
