doinbest/Yachiyo/xjx/模版搭建/Code/reference/GongXun2025-main/机械/云台轴承内挡边.SLDPRT

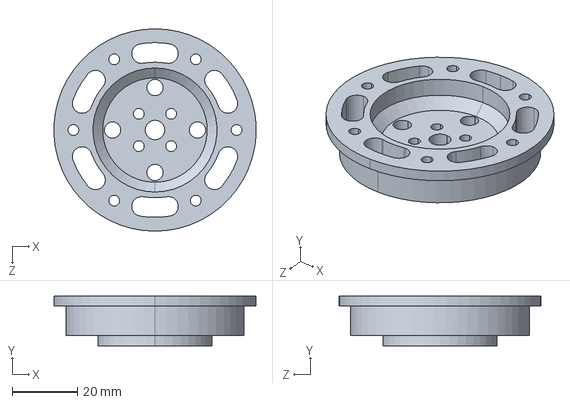
[picture p10: CAD file, 2026-09-14]
xjx/模版搭建/Code/reference/GongXun2025-main/机械/云台轴承内挡边.SLDPRT
61.9 x 15.2 x 62.0 mm
