doinbest/Yachiyo/xjx/模版搭建/Code/reference/GongXun2025-main/机械/尼龙螺柱M3-D5-11.SLDPRT

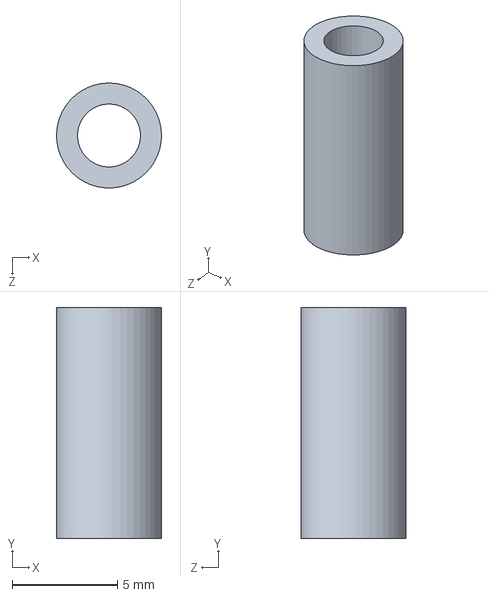
[picture p11: CAD file, 2026-09-14]
xjx/模版搭建/Code/reference/GongXun2025-main/机械/尼龙螺柱M3-D5-11.SLDPRT
5.00 x 11.0 x 5.00 mm
