doinbest/Yachiyo/xjx/模版搭建/Code/reference/GongXun2025-main/机械/GM865二维码模块.SLDPRT

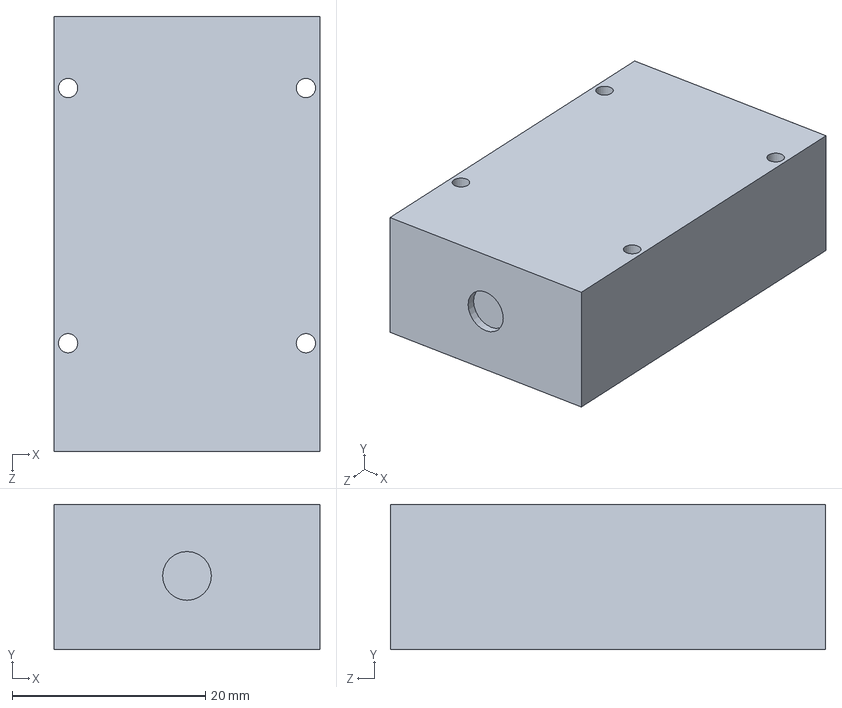
[picture p12: CAD file, 2026-09-14]
xjx/模版搭建/Code/reference/GongXun2025-main/机械/GM865二维码模块.SLDPRT
27.5 x 15.0 x 45.0 mm
