doinbest/Yachiyo/xjx/模版搭建/Code/reference/GongXun2025-main/机械/转盘.SLDPRT

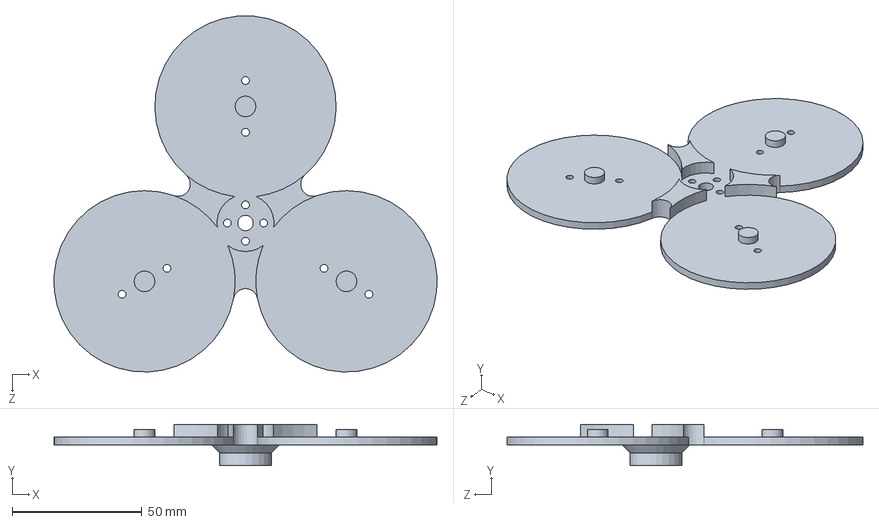
[picture p13: CAD file, 2026-09-14]
xjx/模版搭建/Code/reference/GongXun2025-main/机械/转盘.SLDPRT
147.8 x 16.0 x 137.3 mm
