doinbest/Yachiyo/xjx/模版搭建/Code/reference/GongXun2025-main/机械/夹爪连接板.SLDPRT

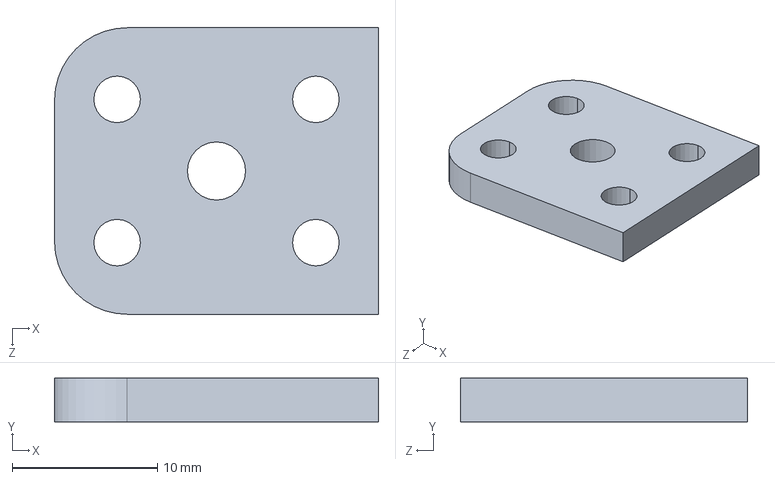
[picture p14: CAD file, 2026-09-14]
xjx/模版搭建/Code/reference/GongXun2025-main/机械/夹爪连接板.SLDPRT
22.3 x 3.00 x 19.7 mm
