doinbest/Yachiyo/xjx/模版搭建/Code/reference/GongXun2025-main/机械/铝柱M4-D6-10.SLDPRT

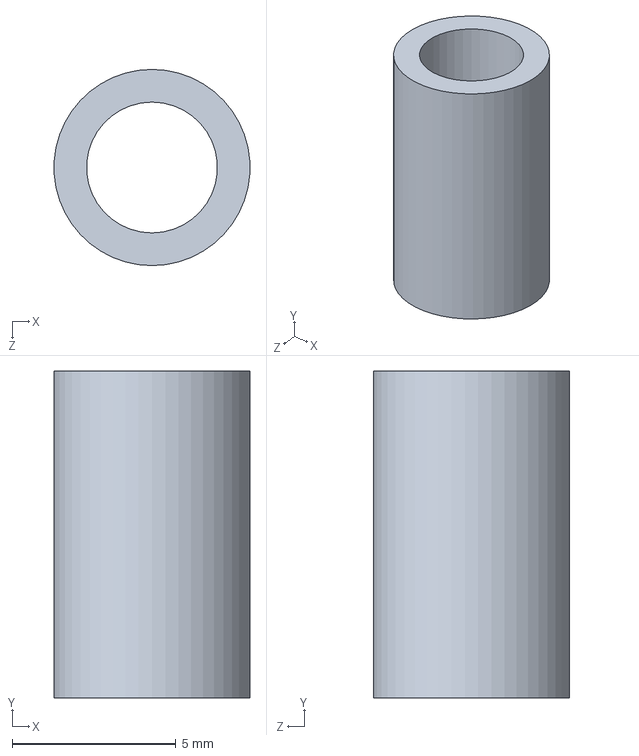
[picture p15: CAD file, 2026-09-14]
xjx/模版搭建/Code/reference/GongXun2025-main/机械/铝柱M4-D6-10.SLDPRT
5.99 x 10.0 x 6.00 mm
