doinbest/Yachiyo/xjx/模版搭建/Code/reference/GongXun2025-main/机械/42步进.SLDPRT

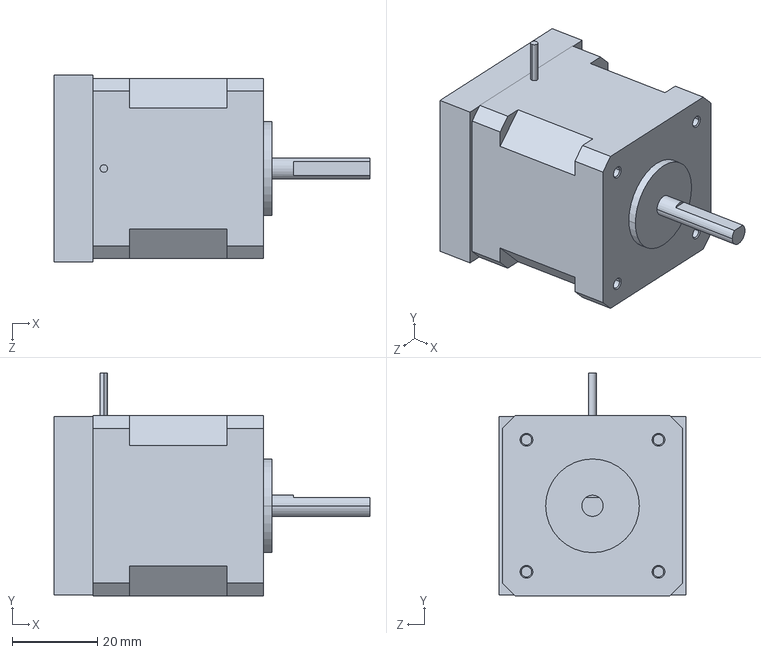
[picture p16: CAD file, 2026-09-14]
xjx/模版搭建/Code/reference/GongXun2025-main/机械/42步进.SLDPRT
74.2 x 52.3 x 43.9 mm
