doinbest/Yachiyo/xjx/模版搭建/Code/reference/GongXun2025-main/机械/HWT101CT.SLDPRT

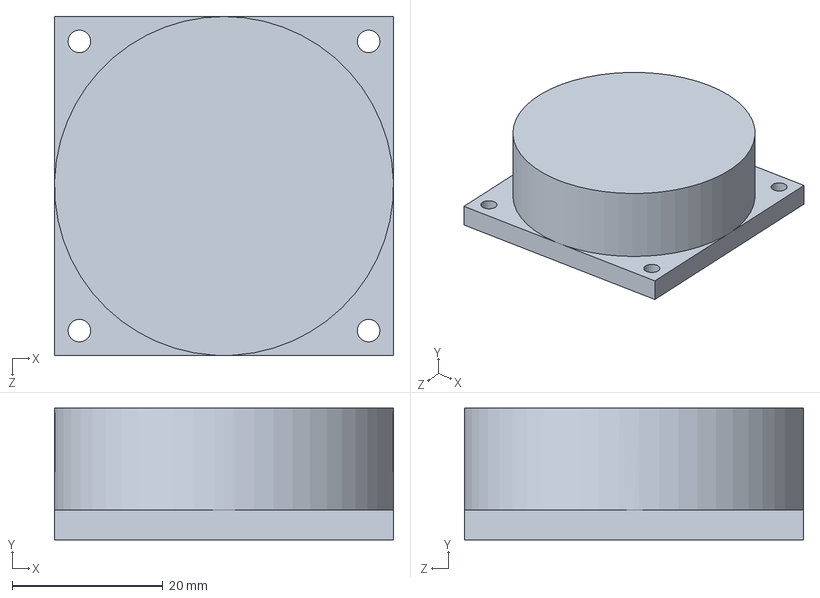
[picture p17: CAD file, 2026-09-14]
xjx/模版搭建/Code/reference/GongXun2025-main/机械/HWT101CT.SLDPRT
45.0 x 17.5 x 45.0 mm
