doinbest/Yachiyo/xjx/模版搭建/Code/reference/GongXun2025-main/机械/连接块6x6x40.SLDPRT

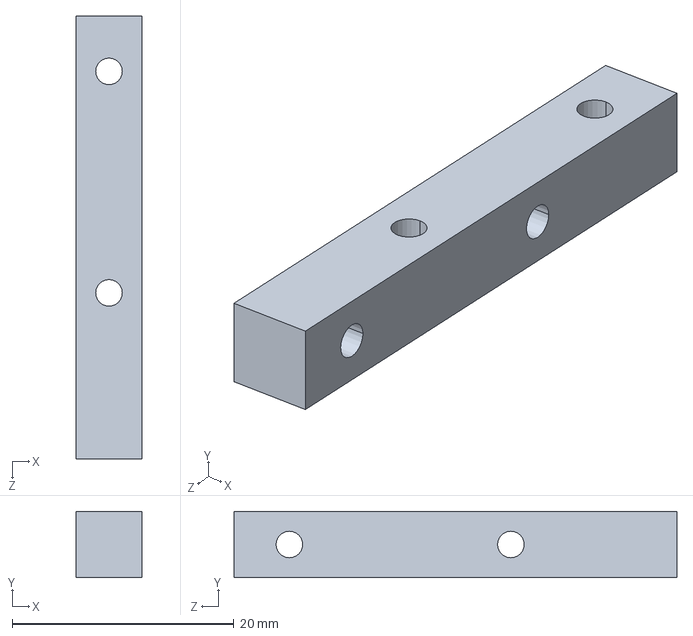
[picture p18: CAD file, 2026-09-14]
xjx/模版搭建/Code/reference/GongXun2025-main/机械/连接块6x6x40.SLDPRT
6.00 x 6.00 x 40.0 mm
