doinbest/Yachiyo/xjx/模版搭建/Code/reference/GongXun2025-main/机械/同步带轮上连接块.SLDPRT

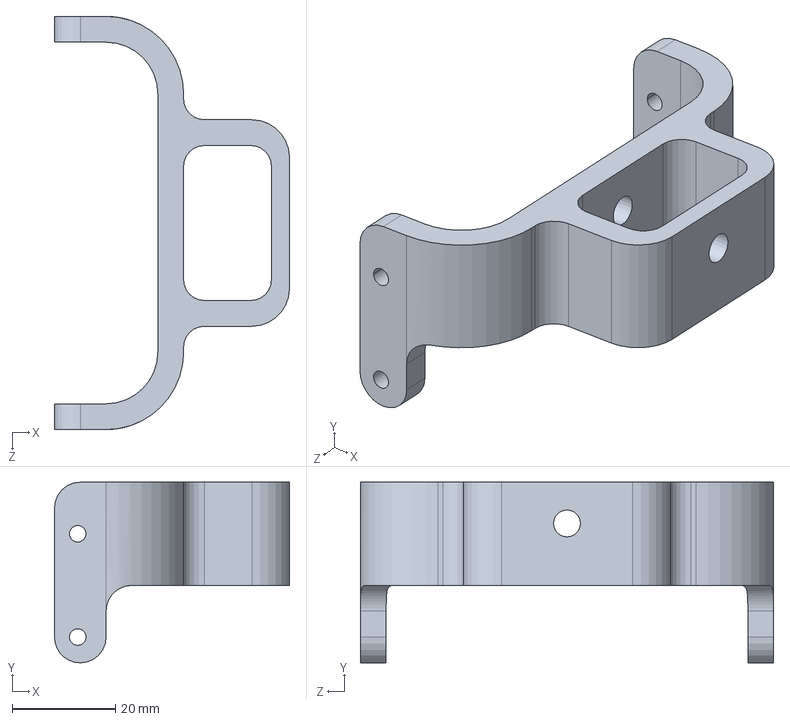
[picture p19: CAD file, 2026-09-14]
xjx/模版搭建/Code/reference/GongXun2025-main/机械/同步带轮上连接块.SLDPRT
45.5 x 35.0 x 80.0 mm
