doinbest/Yachiyo/xjx/模版搭建/Code/reference/GongXun2025-main/机械/夹爪连接垫块.SLDPRT

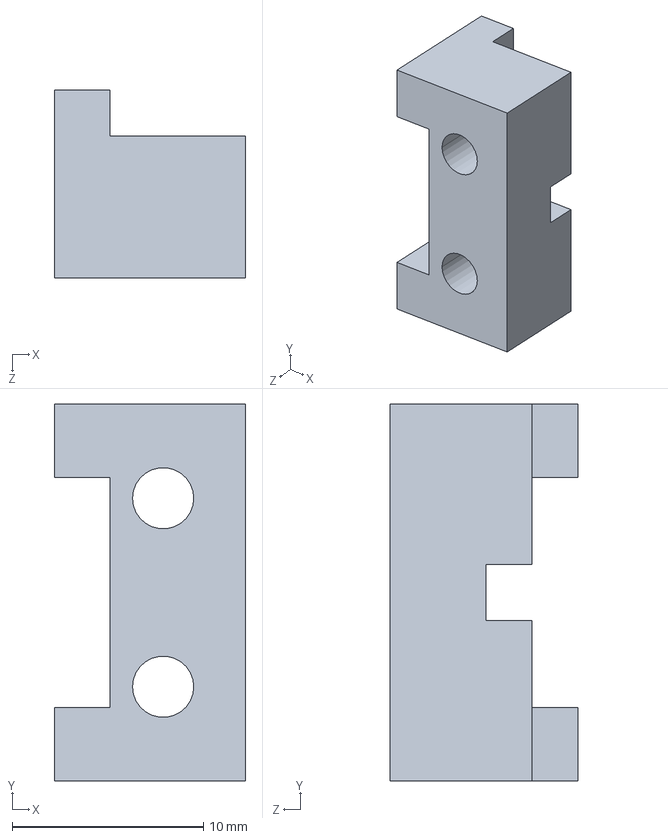
[picture p20: CAD file, 2026-09-14]
xjx/模版搭建/Code/reference/GongXun2025-main/机械/夹爪连接垫块.SLDPRT
9.99 x 19.7 x 9.80 mm
