doinbest/Yachiyo/xjx/模版搭建/Code/reference/GongXun2025-main/机械/舵机.SLDPRT

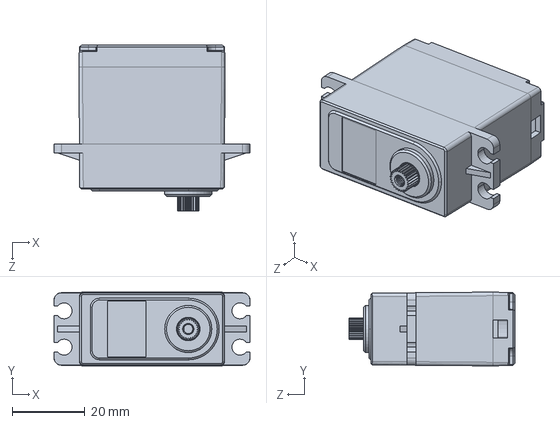
[picture p21: CAD file, 2026-09-14]
xjx/模版搭建/Code/reference/GongXun2025-main/机械/舵机.SLDPRT
54.1 x 20.4 x 45.7 mm
