doinbest/Yachiyo/xjx/模版搭建/Code/reference/GongXun2025-main/机械/舵盘.SLDPRT

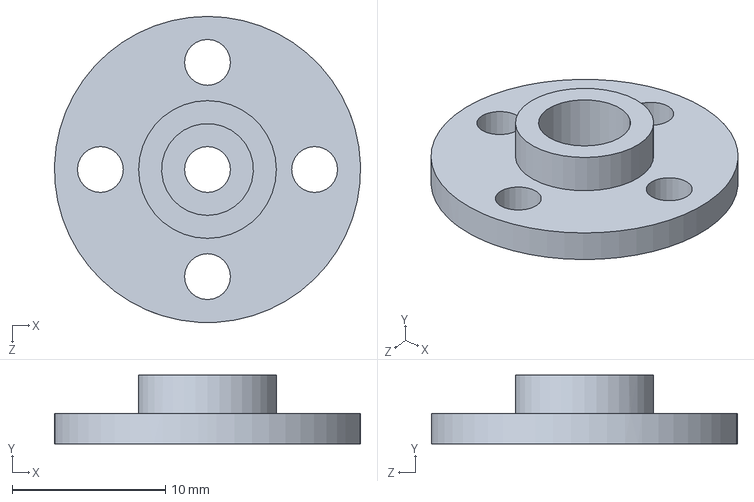
[picture p24: CAD file, 2026-09-14]
xjx/模版搭建/Code/reference/GongXun2025-main/机械/舵盘.SLDPRT
20.0 x 4.50 x 20.0 mm
