doinbest/Yachiyo/xjx/模版搭建/Code/reference/GongXun2025-main/机械/同步带压板.SLDPRT

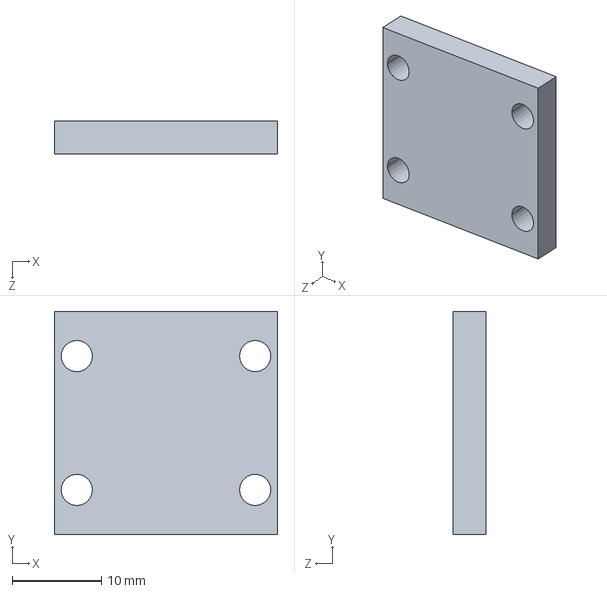
[picture p25: CAD file, 2026-09-14]
xjx/模版搭建/Code/reference/GongXun2025-main/机械/同步带压板.SLDPRT
25.0 x 25.0 x 3.70 mm
