doinbest/Yachiyo/xjx/模版搭建/Code/reference/GongXun2025-main/机械/云台轴承.SLDPRT

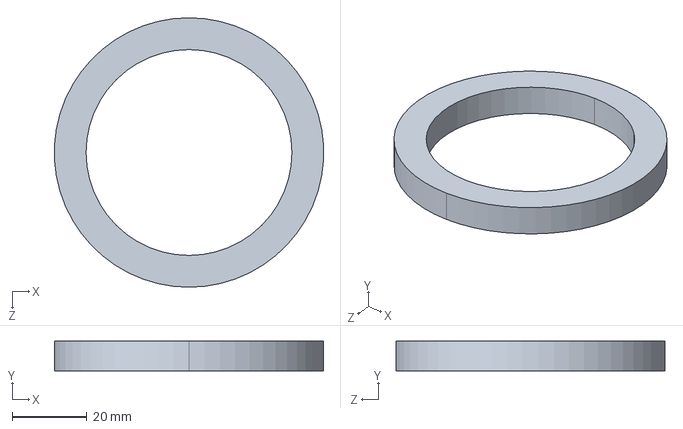
[picture p26: CAD file, 2026-09-14]
xjx/模版搭建/Code/reference/GongXun2025-main/机械/云台轴承.SLDPRT
71.9 x 8.00 x 72.0 mm
