doinbest/Yachiyo/xjx/模版搭建/Code/reference/GongXun2025-main/机械/云台轴承外挡边垫块.SLDPRT

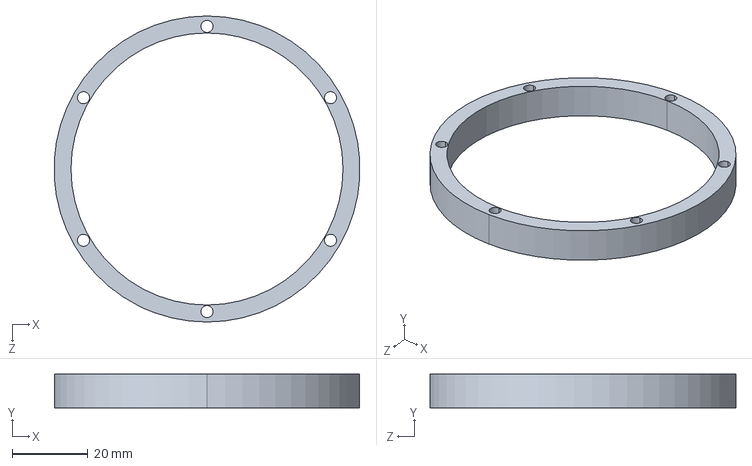
[picture p27: CAD file, 2026-09-14]
xjx/模版搭建/Code/reference/GongXun2025-main/机械/云台轴承外挡边垫块.SLDPRT
80.9 x 9.00 x 81.0 mm
