doinbest/Yachiyo/xjx/模版搭建/Code/reference/GongXun2025-main/机械/导轨250mm.SLDPRT

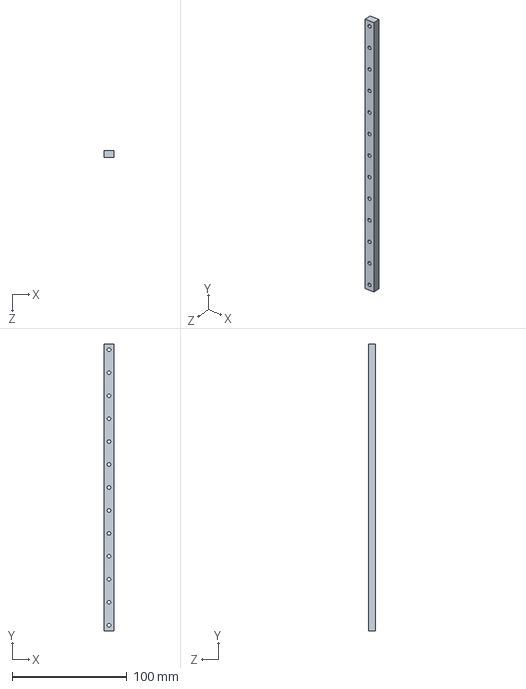
[picture p28: CAD file, 2026-09-14]
xjx/模版搭建/Code/reference/GongXun2025-main/机械/导轨250mm.SLDPRT
9.00 x 250.0 x 6.50 mm
