doinbest/Yachiyo/xjx/模版搭建/Code/reference/GongXun2025-main/机械/电池盒.SLDPRT

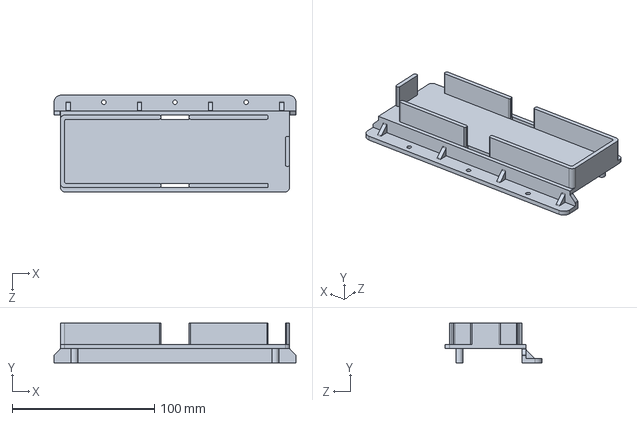
[picture p29: CAD file, 2026-09-14]
xjx/模版搭建/Code/reference/GongXun2025-main/机械/电池盒.SLDPRT
170.0 x 28.0 x 68.0 mm
