doinbest/Yachiyo/xjx/模版搭建/Code/reference/GongXun2025-main/机械/铝柱M4-D6-6.SLDPRT

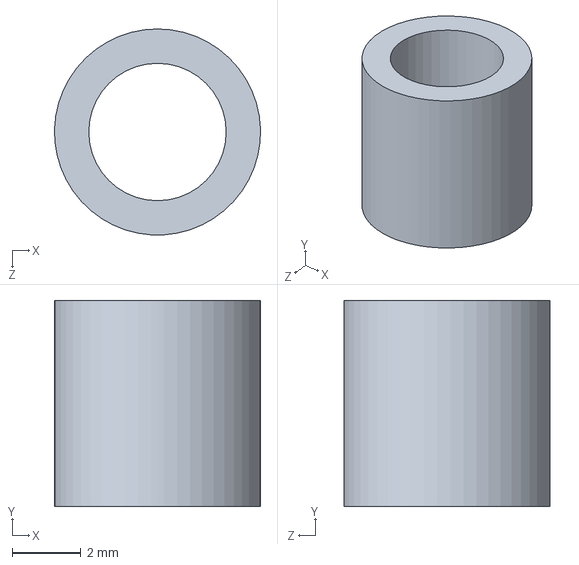
[picture p30: CAD file, 2026-09-14]
xjx/模版搭建/Code/reference/GongXun2025-main/机械/铝柱M4-D6-6.SLDPRT
6.00 x 6.00 x 6.00 mm
