doinbest/Yachiyo/xjx/模版搭建/Code/reference/GongXun2025-main/机械/同步带轮.SLDPRT

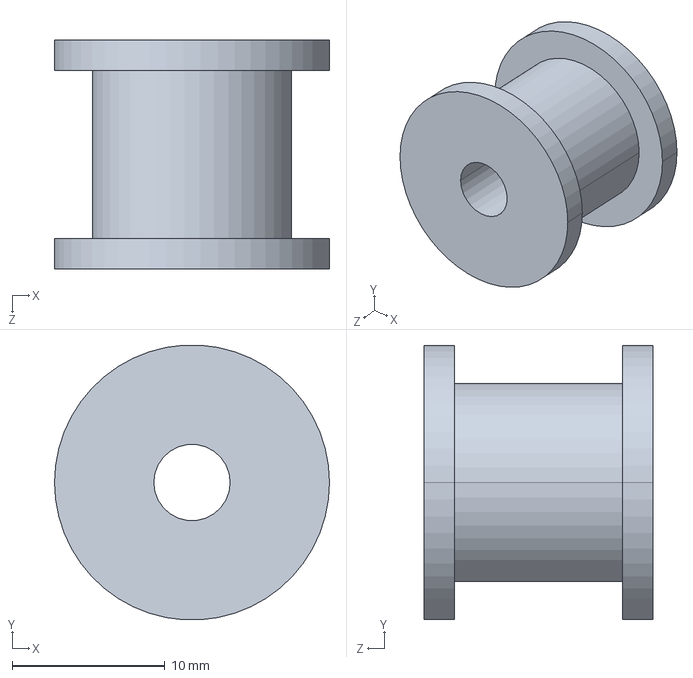
[picture p31: CAD file, 2026-09-14]
xjx/模版搭建/Code/reference/GongXun2025-main/机械/同步带轮.SLDPRT
18.0 x 18.0 x 15.0 mm
