doinbest/Yachiyo/xjx/模版搭建/Code/reference/GongXun2025-main/机械/云台轴承外挡边下板.SLDPRT

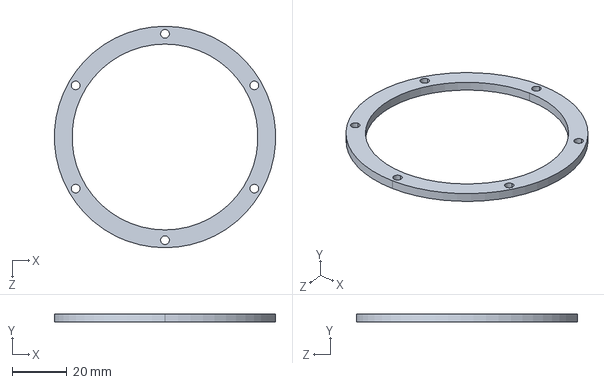
[picture p32: CAD file, 2026-09-14]
xjx/模版搭建/Code/reference/GongXun2025-main/机械/云台轴承外挡边下板.SLDPRT
80.9 x 3.00 x 81.0 mm
