doinbest/Yachiyo/xjx/模版搭建/Code/reference/GongXun2025-main/机械/上底板.SLDPRT

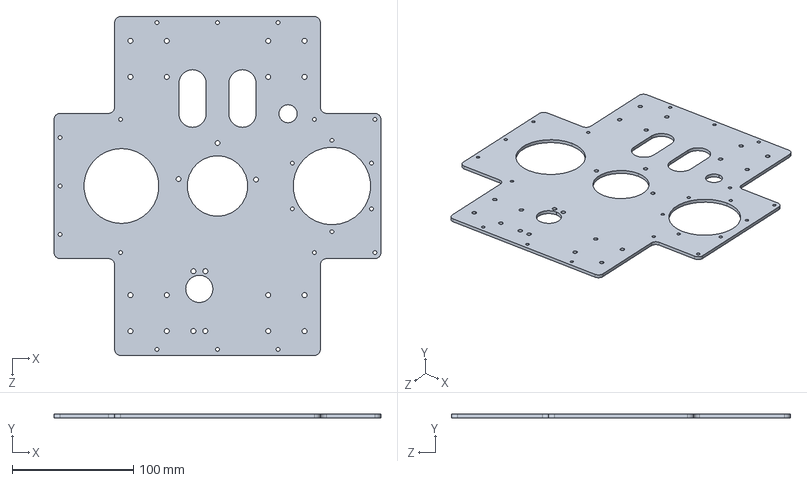
[picture p33: CAD file, 2026-09-14]
xjx/模版搭建/Code/reference/GongXun2025-main/机械/上底板.SLDPRT
270.0 x 3.00 x 280.0 mm
