doinbest/Yachiyo/xjx/模版搭建/Code/reference/GongXun2025-main/机械/摄像头固定件.SLDPRT

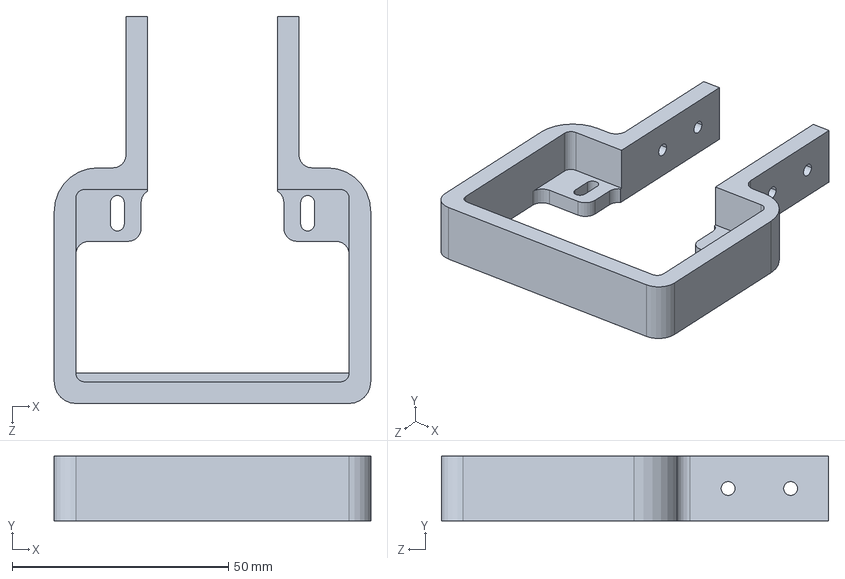
[picture p34: CAD file, 2026-09-14]
xjx/模版搭建/Code/reference/GongXun2025-main/机械/摄像头固定件.SLDPRT
73.2 x 15.0 x 89.5 mm
