doinbest/Yachiyo/xjx/模版搭建/Code/reference/GongXun2025-main/机械/云台底板.SLDPRT

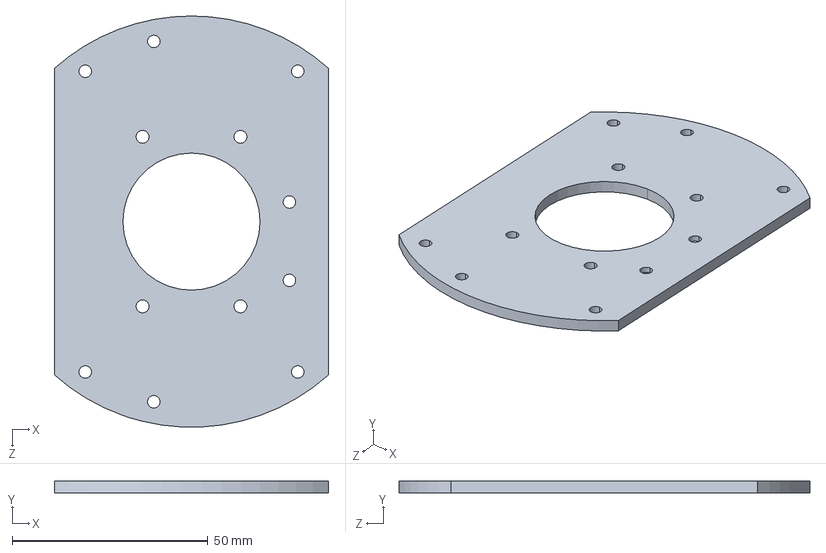
[picture p35: CAD file, 2026-09-14]
xjx/模版搭建/Code/reference/GongXun2025-main/机械/云台底板.SLDPRT
70.0 x 3.00 x 104.9 mm
