doinbest/Yachiyo/xjx/模版搭建/Code/reference/GongXun2025-main/机械/导轨滑块.SLDPRT

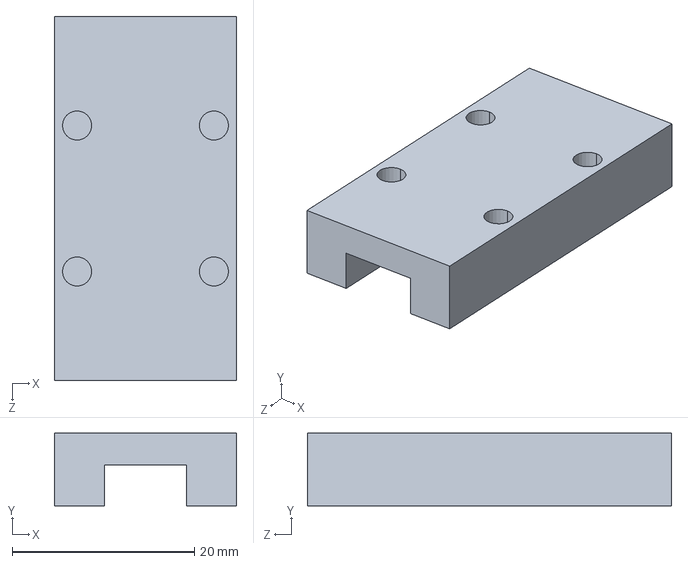
[picture p36: CAD file, 2026-09-14]
xjx/模版搭建/Code/reference/GongXun2025-main/机械/导轨滑块.SLDPRT
20.0 x 8.00 x 39.9 mm
