doinbest/Yachiyo/xjx/模版搭建/Code/reference/GongXun2025-main/机械/夹爪下层2.SLDPRT

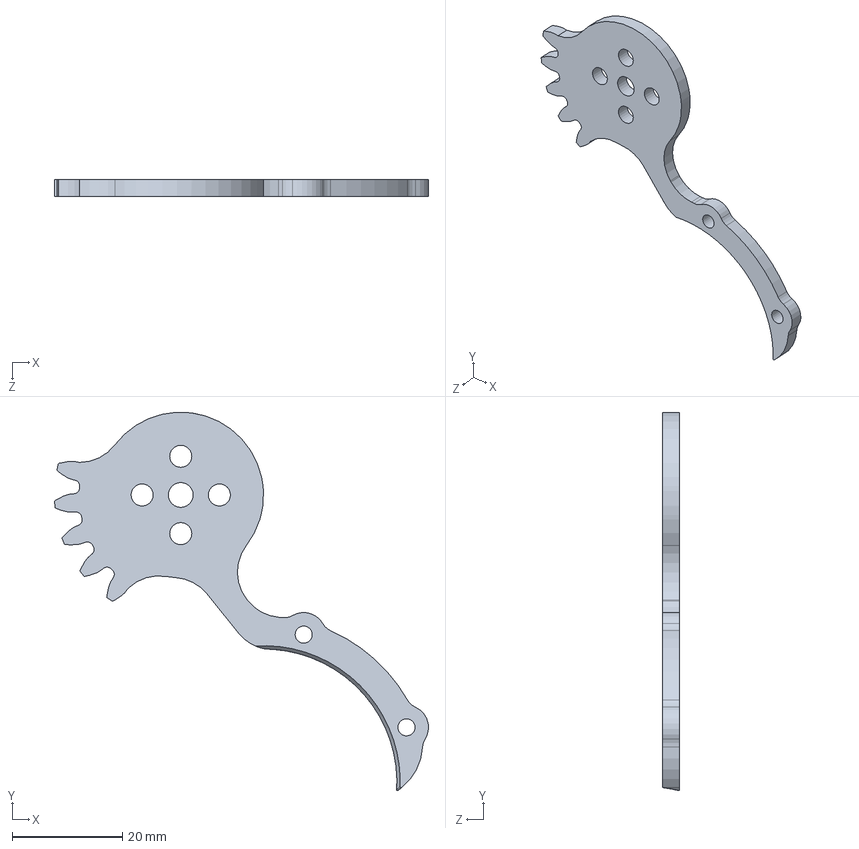
[picture p37: CAD file, 2026-09-14]
xjx/模版搭建/Code/reference/GongXun2025-main/机械/夹爪下层2.SLDPRT
67.8 x 68.6 x 3.00 mm
