doinbest/Yachiyo/xjx/模版搭建/Code/reference/GongXun2025-main/机械/推力轴承.SLDPRT

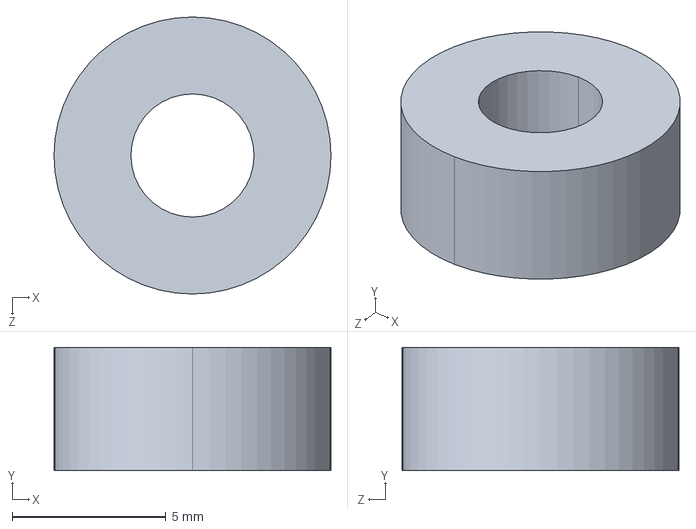
[picture p38: CAD file, 2026-09-14]
xjx/模版搭建/Code/reference/GongXun2025-main/机械/推力轴承.SLDPRT
9.00 x 4.00 x 9.00 mm
