doinbest/Yachiyo/xjx/模版搭建/Code/reference/GongXun2025-main/机械/云台夹爪链接架.SLDPRT

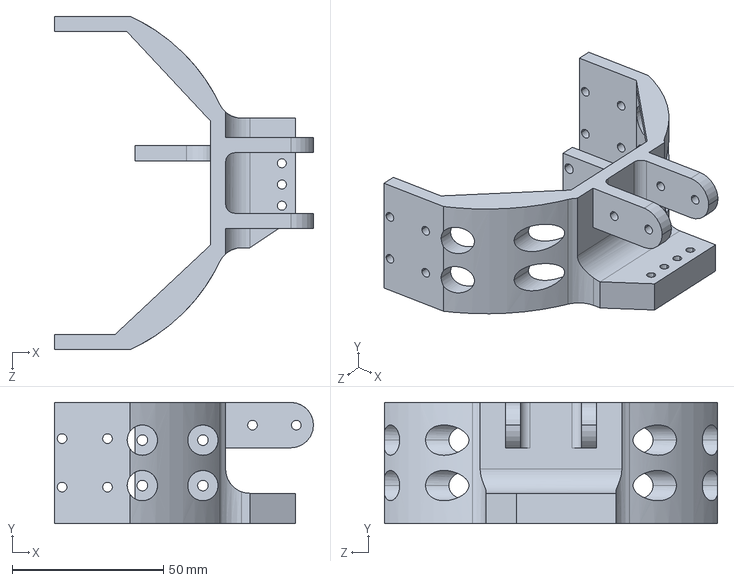
[picture p39: CAD file, 2026-09-14]
xjx/模版搭建/Code/reference/GongXun2025-main/机械/云台夹爪链接架.SLDPRT
85.5 x 40.0 x 110.0 mm
