doinbest/Yachiyo/xjx/模版搭建/Code/reference/GongXun2025-main/机械/云台导轨连接块.SLDPRT

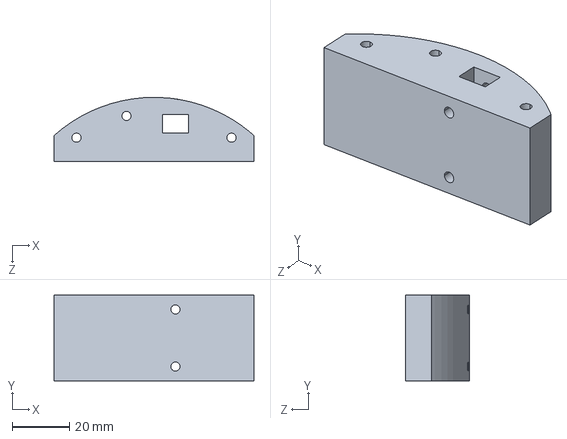
[picture p40: CAD file, 2026-09-14]
xjx/模版搭建/Code/reference/GongXun2025-main/机械/云台导轨连接块.SLDPRT
70.0 x 30.0 x 22.5 mm
