doinbest/Yachiyo/xjx/模版搭建/Code/reference/GongXun2025-main/机械/六角不锈钢柱M3x60.SLDPRT

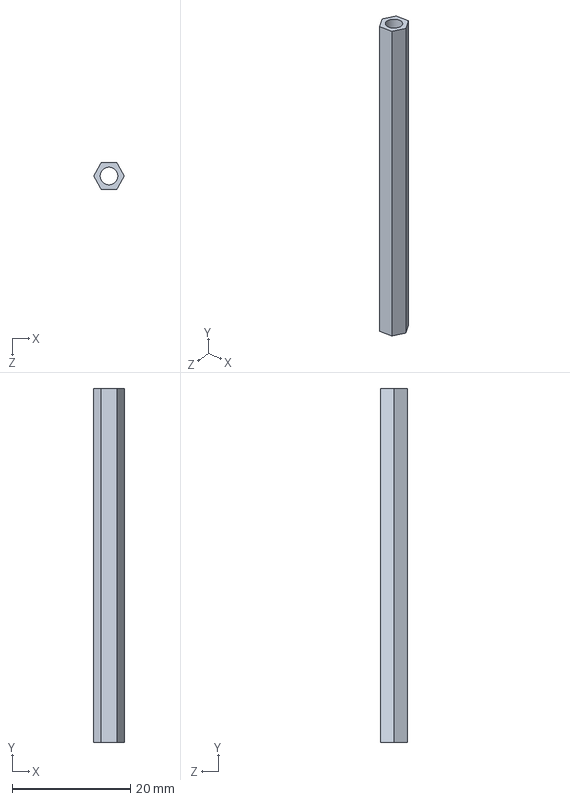
[picture p41: CAD file, 2026-09-14]
xjx/模版搭建/Code/reference/GongXun2025-main/机械/六角不锈钢柱M3x60.SLDPRT
5.20 x 60.0 x 4.60 mm
