doinbest/Yachiyo/xjx/模版搭建/Code/reference/GongXun2025-main/机械/云台步进连接板.SLDPRT

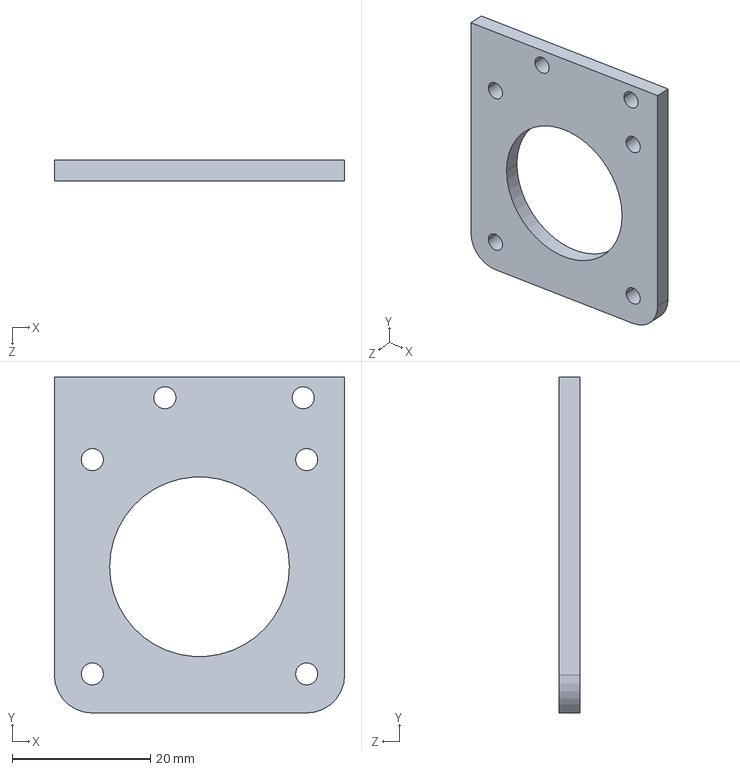
[picture p42: CAD file, 2026-09-14]
xjx/模版搭建/Code/reference/GongXun2025-main/机械/云台步进连接板.SLDPRT
42.0 x 48.6 x 3.00 mm
