doinbest/Yachiyo/xjx/模版搭建/Code/reference/GongXun2025-main/机械/夹爪舵机架.SLDPRT

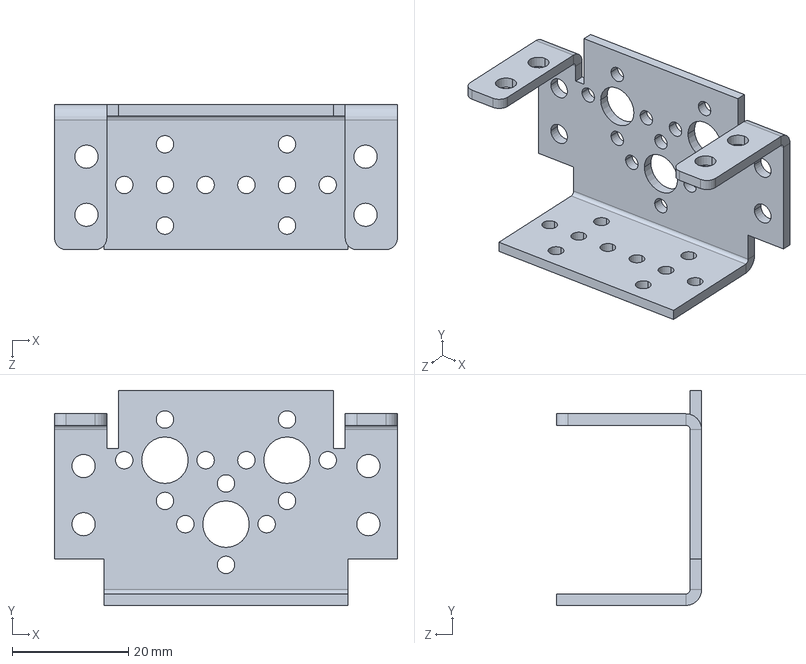
[picture p43: CAD file, 2026-09-14]
xjx/模版搭建/Code/reference/GongXun2025-main/机械/夹爪舵机架.SLDPRT
59.0 x 37.0 x 25.0 mm
