doinbest/Yachiyo/xjx/模版搭建/Code/reference/GongXun2025-main/机械/决赛物料顶层.SLDPRT

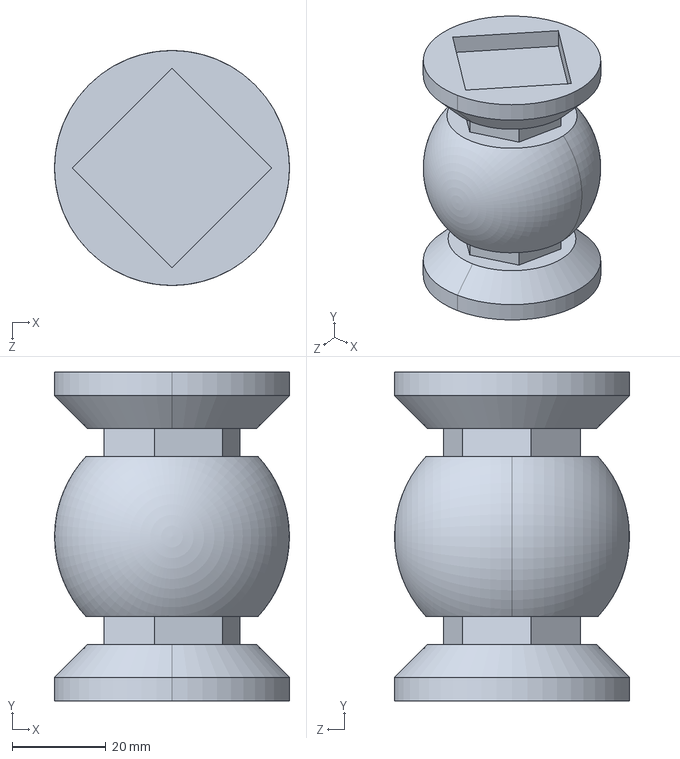
[picture p44: CAD file, 2026-09-14]
xjx/模版搭建/Code/reference/GongXun2025-main/机械/决赛物料顶层.SLDPRT
50.0 x 70.0 x 50.0 mm
