doinbest/Yachiyo/xjx/模版搭建/Code/reference/GongXun2025-main/机械/夹爪下层1.SLDPRT

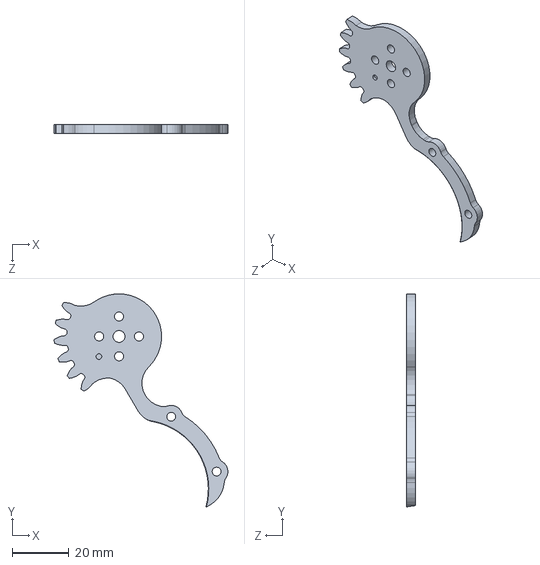
[picture p45: CAD file, 2026-09-14]
xjx/模版搭建/Code/reference/GongXun2025-main/机械/夹爪下层1.SLDPRT
61.2 x 75.0 x 3.00 mm
