doinbest/Yachiyo/xjx/模版搭建/Code/reference/GongXun2025-main/机械/OPS9.SLDPRT

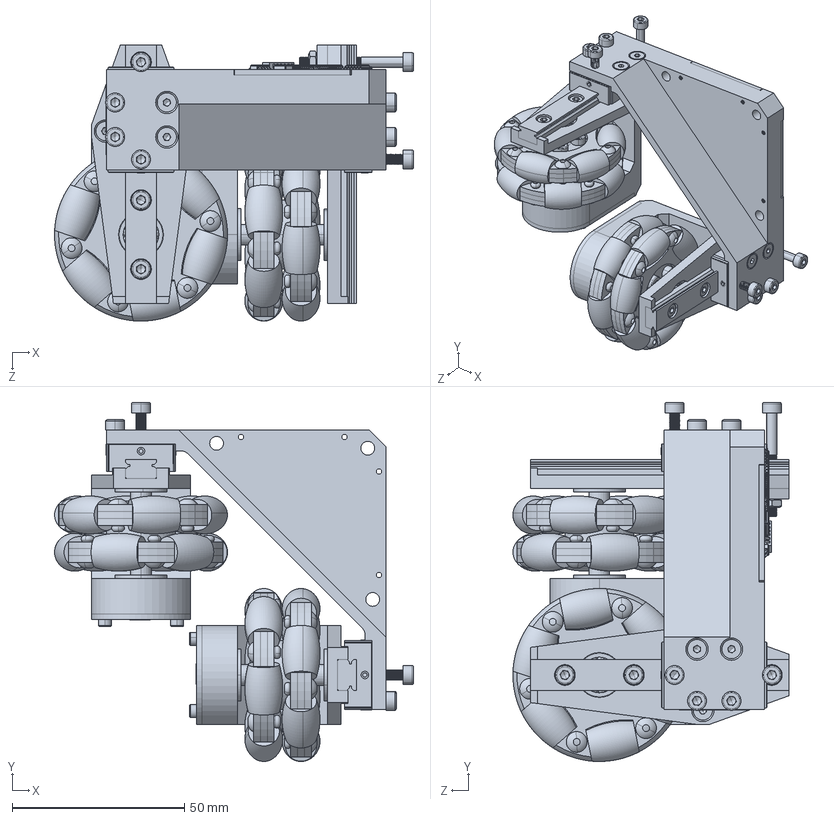
[picture p46: CAD file, 2026-09-14]
xjx/模版搭建/Code/reference/GongXun2025-main/机械/OPS9.SLDPRT
104.1 x 104.1 x 80.1 mm
