doinbest/Yachiyo/xjx/模版搭建/Code/reference/GongXun2025-main/机械/陀螺仪及按钮固定板.SLDPRT

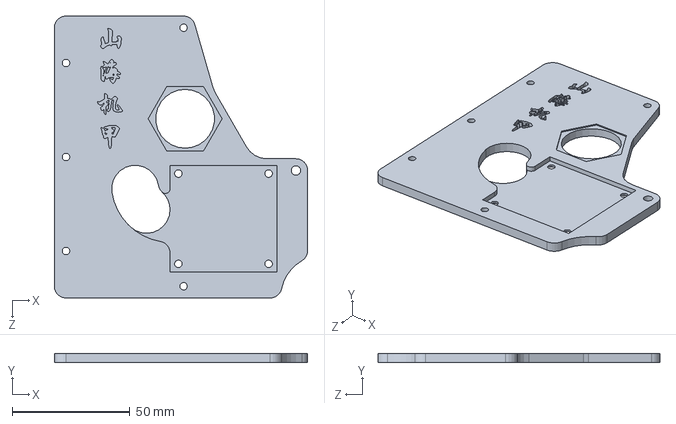
[picture p47: CAD file, 2026-09-14]
xjx/模版搭建/Code/reference/GongXun2025-main/机械/陀螺仪及按钮固定板.SLDPRT
107.8 x 4.00 x 120.0 mm
