doinbest/Yachiyo/xjx/模版搭建/Code/reference/GongXun2025-main/机械/六角不锈钢柱M3x45.SLDPRT

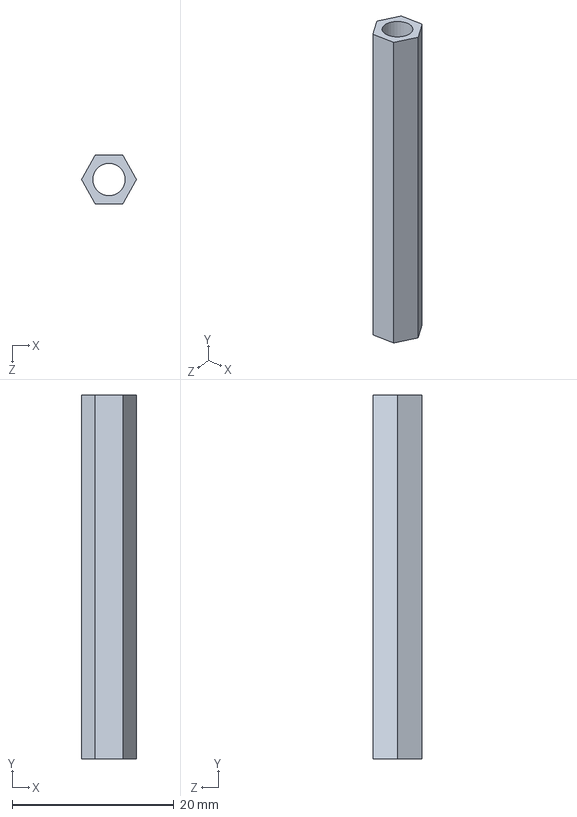
[picture p48: CAD file, 2026-09-14]
xjx/模版搭建/Code/reference/GongXun2025-main/机械/六角不锈钢柱M3x45.SLDPRT
6.80 x 45.0 x 6.00 mm
