doinbest/Yachiyo/xjx/模版搭建/Code/reference/GongXun2025-main/机械/决赛夹爪上层-CNC.SLDPRT

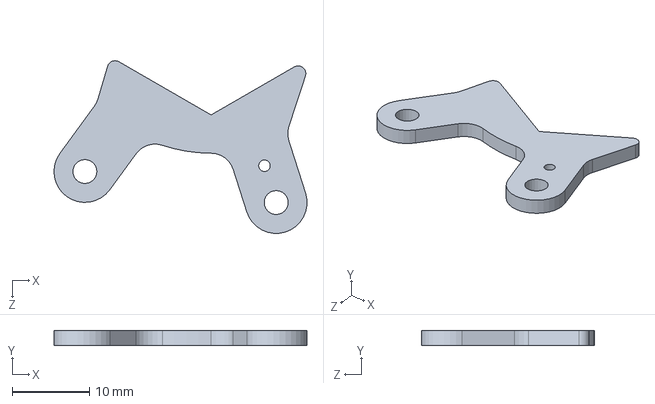
[picture p49: CAD file, 2026-09-14]
xjx/模版搭建/Code/reference/GongXun2025-main/机械/决赛夹爪上层-CNC.SLDPRT
32.7 x 2.00 x 22.3 mm
