doinbest/Yachiyo/xjx/模版搭建/Code/reference/GongXun2025-main/机械/连接.SLDPRT

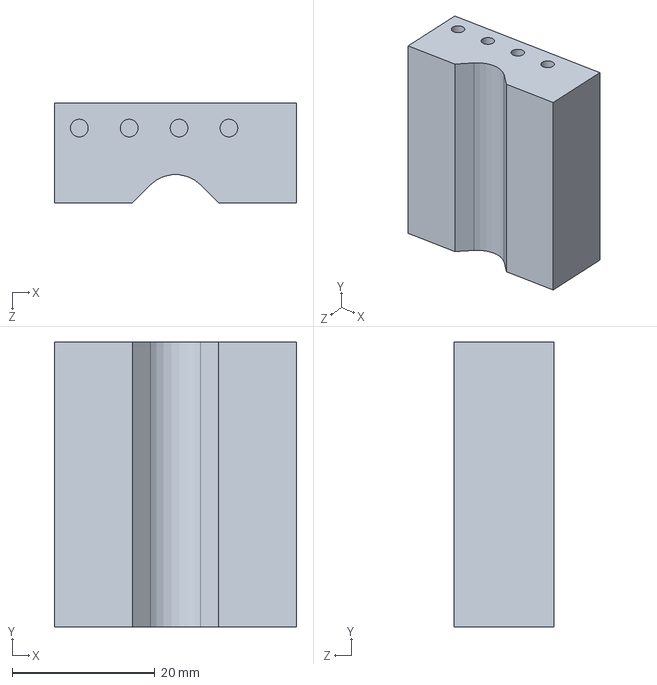
[picture p50: CAD file, 2026-09-14]
xjx/模版搭建/Code/reference/GongXun2025-main/机械/连接.SLDPRT
34.0 x 40.0 x 14.0 mm
