doinbest/Yachiyo/xjx/模版搭建/Code/reference/GongXun2025-main/机械/上岸.SLDPRT

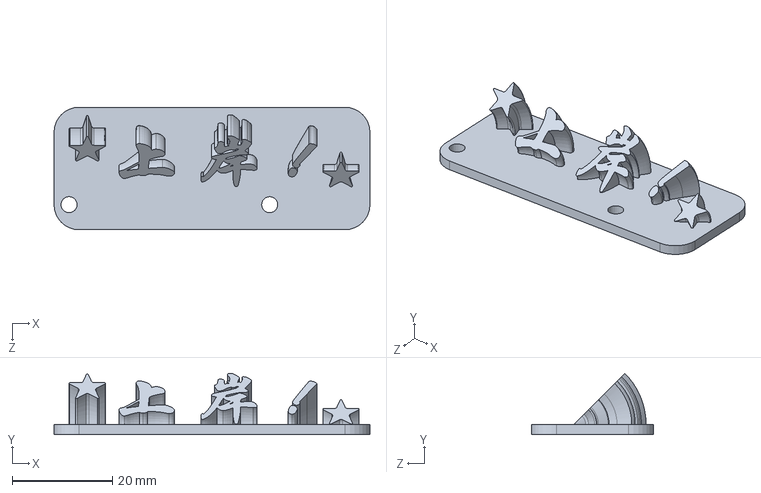
[picture p51: CAD file, 2026-09-14]
xjx/模版搭建/Code/reference/GongXun2025-main/机械/上岸.SLDPRT
63.0 x 12.2 x 24.4 mm
