doinbest/Yachiyo/xjx/模版搭建/Code/reference/GongXun2025-main/机械/电池.SLDPRT

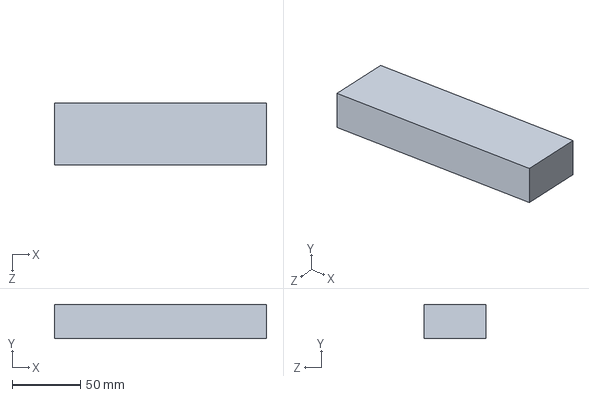
[picture p53: CAD file, 2026-09-14]
xjx/模版搭建/Code/reference/GongXun2025-main/机械/电池.SLDPRT
155.0 x 25.0 x 45.0 mm
