doinbest/Yachiyo/xjx/模版搭建/Code/reference/GongXun2025-main/机械/轮组.SLDASM

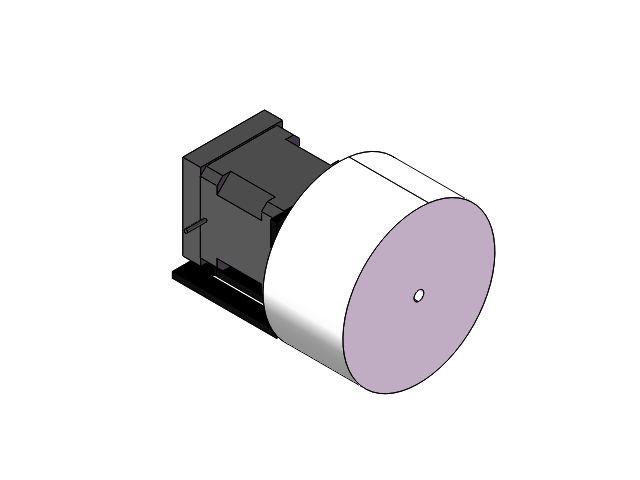
[picture p54: CAD file, 2026-09-14]
xjx/模版搭建/Code/reference/GongXun2025-main/机械/轮组.SLDASM
42步进电机支架^是轮组_车(2)_车
llllll^是轮组_车(2)_车
42步进
