doinbest/Yachiyo/(list of files, cad)

Other CAD files:
xjx/模版搭建/Code/reference/GongXun2025-main/机械/初赛夹爪上层2-玻纤.SLDPRT
