doinbest/Yachiyo/xjx/模版搭建/docs/superpowers/plans/2026-10-05-radar-fast-result.md

# 雷达同圈结果提速实施计划

> **For agentic workers:** 使用 superpowers:executing-plans 在当前会话逐步实施，步骤以复现实测和测试驱动为准。

**Goal:** 采完完整圈后尽快同时刷新障碍和完整路线，保持算法、115200 和其他界面不变。

**Architecture:** 为雷达页增加显式 fast 命令，扫描完成主动推送紧凑 ASCII/Base64 同圈结果包。25 格统计、三个掩码、扫描统计和所有完整路点无损编码；CRC 覆盖身份、分页和内容。网页收齐后原子发布地图与路径；缺页用一个列表请求补发，不逐页往返。旧命令与诊断分页继续可用。

**Tech Stack:** STM32 HAL/C、Keil、原生 JavaScript、OpenOCD CMSIS-DAP、COM14/115200。

**Spec:** 本轮已确认的聊天需求：采完一圈后很快同时显示；修改、编译、DAPLink 烧录、串口验证。

## Global Constraints

- 不改建图、规划、实车监控、IOC、EIDE、USART1 波特率或全局无线发送节奏。
- 不恢复固定 30ms 等待；旧圈历史与停止优先保持。
- 当前工程有大量用户改动，直接在指定工程实施，不创建脱离实机入口的工作树，不提交现有改动。

## Review Focus

- 丢失首/末页：按页数补读，不能等待十秒才能开始恢复。
- CRC 损坏与混圈：不发布错误结果或拆开地图/路径。
- 无可用路线：仍发布障碍和明确的规划失败原因。
- 新扫描/停止打断：取消旧读取，保留完成快照。
- 最大 uint32 身份、最大路点数：每行 ≤256 字节，完整路点保留。

## Task 1: 紧凑结果与原子发布

- [x] 在 `tests/radar-host-fast.test.mjs` 与 `Code/tests/radar_host_console_test.c` 增加失败测试：主动推送、无损 25 格/完整路线、CRC、缺页与一起发布。
- [x] 验证新测试失败。
- [x] 修改 `radar_host_console.c`：fast scan/live/status、短帧、批量补页和冻结身份。
- [x] 修改 `radar-host-model.mjs`：解析 v2 短帧、CRC、无损解码、同圈原子发布。
- [x] 修改 `radar-host-client.mjs` 与雷达入口：自动接收、快速缺页批量请求、保留旧协议。
- [x] 运行网页与固件完整回归、C/JS 线协议验证。

## Task 2: 上板验收与文档

- [x] Keil template 编译无错误，再通过 DAPLink/SWD/4000kHz 烧录带地址 HEX 并 verify。
- [x] 通过既有桥接连接 COM14/115200，使用生产客户端统计多次单圈与 live→single 的完成/显示耗时，检查地图与路径同一时刻更新。
- [x] 验证结束停止雷达并清理本次读取占用，按实测记录结果及限制。
- [x] 更新协议和开发记录；不以主机测试代替实机通信证明。

## 执行记录

- 前置核对：同一结果从 C 到 JS，桥接按 `@RADAR` 行透传，短帧不需要修改实车监控或桥接接口。
- 执行方式：沿用用户已确认的原生执行；不额外等待审批，不提交混合工作树。
- 实测发现并测试驱动修正：补读过早重复、迟到持续圈冒充单次、自动结果饿死完整预览；最终393项网页回归、固件/桥接回归及DAPLink校验通过。
- 两轮实机共14组原子结果，0客户端同步错误；最新四次3.332～3.895秒，另保留20.526秒无线异常慢样本。详细事实见开发记录，不承诺无线异常时固定耗时。
