doinbest/Yachiyo/xjx/模版搭建/docs/开发记录/2026-10-06-机械臂上电回零提交忙与故障诊断修复.md

# 机械臂上电回零提交忙与故障诊断修复

## 现象与确定的原因

用户日志在 Z 回零启动后约 1 秒出现 `home_request_failed`，随后显示 `missing=x_ppm`。

源码确认：`Emm_Send` 把未受理统一返回 HAL_BUSY，而 `MechanicalArm_RequestStart` 又把所有非 HAL_OK 映射为 TX_ERROR。因此队列暂时忙和总线隔离都丢失了分类，Boot 原有的 BUSY 等待分支不能处理前者。原日志不足以确认实机当时属于哪种拒绝，不能据此断言是噪声或缺少参数。

X 尺度在 X 回零验证成功后恢复。Z 请求失败时 X 尚未验证，所以旧日志中的 x_ppm 是未建立参考的后果，不是 HOME 命令依赖的前置参数。

## 本轮修改

- Emm 提交失败：总线隔离为 HAL_ERROR，未隔离的暂时拒绝为 HAL_BUSY；成功仍表示受理而非运动完成。
- 机械臂请求保留 BUSY，Boot 按既有 100 ms 周期等待未受理请求；每轴 60 s 窗口及已受理请求去重不变。
- 硬提交错误记录 axis/action/result/bus_locked/bus_reason/uart_error/fault_ms；锁定原因使用 home_bus_fault，未锁定的其他错误仍为 home_request_failed。
- 未完成回零显示 home_pending，真实配置检查仍用于任务启动及三轴完成后的状态。X 验证后仍恢复约 31.746 命令脉冲/mm 和 x_car=100 mm。
- 中文终端区分回零未完成、请求失败、总线故障及驱动故障；homing 阶段出现故障也立即标记启动失败。

不改 Z/X/Base 顺序、回零模式、速度、机构行程、总线锁定恢复、FE 例外、雷达或底盘。

## 软件验证

- 测试先复现：真实机械臂+总线队列忙被误报；Grab 状态误报缺尺度；中文摘要无法解释 home_pending。
- 修正后：暂时忙释放后只提交一次 HOME，三轴验证完成；锁定总线不盲目重试且原始错误完整可见；优先停止/中止行为仍通过。
- `python Code/tests/run_firmware_tests.py`：完整固件回归 PASS。
- 网页 Node 回归：422 项通过，0 失败。
- Keil Target template：0 errors / 0 warnings，Flash 197388 B，RAM 117264 B。

## 实机验证状态

使用确认的 CMSIS-DAP/SWD/4000 kHz、STM32F4 配置和本轮 HEX，烧录两次均在探针 CMD_INFO 查询失败，尚未写入新固件。USB 枚举仍显示 Horco CMSIS-DAP v2 在线；未修改探针配置或强制终止用户 Keil。

通过现有共享桥接监听 COM14/115200，发送 grab status、尺度及 x_car 读回、bus status、imu status，只有 TX 写出记录，没有 RX。不能把这些查询视为设备反馈，也不能声明上板回零已验证。

已请用户退出活动调试模式并重新插拔 DAPLink、给车端无线重新上电。连接恢复后继续烧录，抓 Z/X/Base → home_complete → IMU 验证启动日志并读回参数；冷上电偶发问题最终仍需要冷上电观察。

日志目录：`.embeddedskills/boot-home-20261006/`，含构建、固件/网页回归、烧录失败及串口原始记录。

## 重新上电后续验证（04:11～04:12）

用户重新上电后，重新打开 COM14/115200，共享桥接收到有效设备回复。DAPLink 烧录同一 HEX 成功，programmed=true、verified=true，随后正常复位启动，没有跳过回零。

- 04:11:58 开始 Z 回零，约 1.7 s 后进入 X，约 3.7 s 后进入 Base。
- 04:12:03 收到 `reason=home_complete missing=none ref_cause=home_verified elapsed=5603`，三轴验证约 5.6 s 完成。
- 04:12:08～09 收到 IMU `result=PASS verified=1 control_ready=1`，静止验证 51 样本，I2C 错误为 0。
- 查询读回 `x_ppm=31.746`、`z_ppm=480`、`x_car=100`，`bus status locked=0`。
- 本次完整启动未出现 home_request_failed、home_bus_fault、home_driver_fault 或误报缺少 x_ppm；没有启动底盘或取放任务。

成功烧录记录：`.embeddedskills/boot-home-20261006/flash-repower.json`。
原始串口记录：`.embeddedskills/boot-home-20261006/serial-1791231091644.log`（时间戳使用 UTC，以上文字为北京时间）。

本次确认烧录后复位启动正常，不等同于多次断电冷启动偶发故障已全部排除；后续若再次发生，新固件的 home_request 诊断可区分暂时忙、总线锁定及真正发送错误。
