doinbest/Yachiyo/xjx/模版搭建/docs/开发记录/2026-10-07-追踪实时长日志与发送反馈诊断.md

# 追踪实时长日志与发送／反馈诊断

## 本轮目标与范围

用户确认增加电脑实时日志，解决128条MCU环形记录约6.4秒、早期运动过程被覆盖的问题，并继续定位上一段“计算请求非零，编码器变化为零”的现象。本轮不调整追踪估计器、J、速度／加速度／延迟参数，不修改香橙派、不改变静态align/pick、雷达、路线、回零或驱动默认配置。

上一段只能证明末尾窗口有38.31/5.78/13.49 mm/s的计算请求、实际位置差分为0，不能证明这些请求实际以对应RPM发到电机，也不能归因于通信断连或供电。新日志补充发送链路证据，不宣称该运动问题已经修复。

## 实现

- 独立`grab track log start [50..1000 ms] / stop / status`，默认关闭，默认周期50 ms。只有观察／追踪产生计算记录才有实时行，不自动启动机构、视觉、参考或任务。
- `TRACK live`独立会话id及候选记录序号，19项控制数据加34项IO整数，整行IEEE CRC32。请求速度、四轮完成同步后RPM、速度反馈、原始位置、各反馈年龄、X受理/发送目标和总线状态分别保存；Receive确认不冒充实际运动。
- X的DMA完成时刻通过motor_bus事件传到MechanicalArm事件；事务结束再发布，但时间不取ACK接收时刻。实际驱动动作不变。
- 实时发送复用console_tx空闲的DMA帧缓冲，没有额外大队列，忙时跳过诊断，未开始行让位于正常／停车回复，已开始整行不拼接。候选序号使跳过或无线丢失可见，不为日志添加固定等待。
- 原128条冻结环形缓存不扩展，仍导出19项原核心数据；不将当前IO塞到旧时间记录。详细IO保留一个当期快照，长期记录由电脑磁盘承担。
- 网页追踪卡新增实时记录操作和最新IO显示，不自动订阅／重建参考，日志关闭不等于运动停车。重连后查询订阅可接受后续数据，不冒充从第0条完整采集。
- 本地桥接原有无缓冲原始RX文件持续落盘；报告工具支持原始bin、JSONL RX事件与旧工具JSON，区分实时和冻结来源、缺号／坏CRC、启动过渡／稳定段、发送RPM与反馈年龄。

## 使用

1. 新固件烧录后按现有流程恢复有效机构状态；本轮尚未执行烧录或恢复动作。
2. 本地控制台连接实际COM14、115200/8N1，视觉任务页点击“开启实时记录”。可以先仅观察；物料移动期间连续留存，不必停车后才导出全部数据。
3. 开始与停止追踪仍用原来的明确运动操作。先停止追踪并取得反馈确认，再关闭记录；保留最终整行传输的时间。
4. 电脑文件在`.embeddedskills/logs/serial/<连接时间>-rx.bin`和同名`.jsonl`；保存时长不受6.4秒限制。分析：`python Code/tools/tracking_report.py <文件> --source live --kind physical`。
5. 默认50 ms为请求节奏，不保证DL-20无损20 Hz；链路占用高可显式`grab track log start 100`。报告必须保留缺条，不能补造之前未上传的详细IO或将图像估计速度当独立的转盘实际转速。

## 验证与资源

软件验证覆盖无运动订阅、发送忙／停车优先、整行原子性、同会话序号与缺号、重连、X发送时刻与ACK时刻不同、int64精度及长期文件保存。详细IO加入每条环形记录的初版曾超出RAM，未烧录；现采用单快照和复用发送缓冲，原128条核心环形窗保留。

固件主机完整回归通过；网页431项通过；桥接33项通过（新增300行／约15秒原始文件落盘且没有发送运动请求），报告工具8项通过（长窗、缺号、坏CRC、JSONL、重复帧及复位后同id新段不混合）。这些属于软件证据，不是无线吞吐或动态实机追踪验收。

Keil Target `template`编译0错误、0警告；Flash 216756字节，RW+ZI 130996字节（链接统计，包含工程已有栈／堆区域）。没有扩大内存配置、修改IOC/EIDE或缩减雷达缓存。构建日志在`.embeddedskills/stable-tracking-20261006/build-live-diagnostics/template-template-build.log`，产物`Code/template/MDK-ARM/template/template.hex`。后续增加静态RAM对象需重新核对128 KiB链接区域余量，不能把此编译结果当实车运行验收。

最终HEX SHA256：`B788C122894FBD1E7F940A1CA5396B8265B0ADE72B6DFD55E561399ED9306733`。构建时间2026-10-07 00:05；此标识只代表生成产物，不代表已烧录。

当前仅软件测试、编译和文档交付，**没有烧录、串口指令、复位或运动**。需要新实机长日志后，才能确定先前非零请求/零反馈究竟发生在控制请求、批次发送、驱动执行还是反馈／观察器层。

## 后续上板与长日志实测（2026-10-07 00:16后）

上节是编译交付时的状态；用户准备好后，已通过DAPLink（CMSIS-DAP/SWD 4000 kHz、stm32f4x）烧录上述同SHA256的HEX，工具返回programmed=true、verified=true。串口明确使用COM14、115200/8N1；查询确认三轴home_complete、missing=none及IMU验证PASS。启动广播未完整录到，不将空的启动抓取文件当回零过程证据。

香橙派重开后USB开始接收有效B2格式报文；X回零时持续Lost而非USB断连。恢复X约55 mm后，反馈55.008 mm、reached=1且二次位置读回稳定，原手动X配置恢复。仅恢复X，不发送底盘/Z/Base/夹爪准备运动；正常烧录启动回零另计。蓝色坐标约(369,353)，目标(334,338)，尚存在约35/-15 px偏差，不宣称已对准。

同一静止姿态下对比诊断上传周期，未调整追踪控制50 ms、批次80 ms或任何控制参数：

| 诊断请求周期 | 实际记录证据 | 结论 |
| --- | --- | --- |
| 50 ms | 初始抓取解析出22条CRC有效行、96条坏行；开始/结束回复另存，不作完整率统计 | 详细文本流出现大量残缺，不能宣称20 Hz无损 |
| 200 ms | 80/80条，跨度15800 ms，0条CRC错误、0缺号 | 本次静止长记录完整，已超过MCU6.4秒环形窗 |
| 100 ms | 126/160条CRC有效，10条CRC错误、34缺号，跨度15900 ms | 当前链路未达到无损10 Hz；缺号还可能包含MCU忙时跳过，不能全归为无线丢包 |

后续实机段显式使用`grab track log start 200`，不是改变固件默认控制周期。200 ms静止通过不代表运动时无线吞吐或6/8/10 rpm追踪已通过；运动时需继续检查缺号和CRC。报告的receive_hz是上传所覆盖的新观测，不是完整摄像头帧率；control_interval由上传行计算，不等于内部控制周期。X记录中的6 RPM为前面恢复位置动作留下的历史发送快照，发送年龄已很旧，不表示观察期间仍发送X运动。

日志：`.embeddedskills/stable-tracking-20261007/restore-x55.log`、`observe-after-pi-reopen.log`、`observe-x55.log`、`live-observe-200ms.log`、`live-observe-100ms.log`。观察结束均有stop_confirmed=1，记录订阅已关闭，未启动共同追踪。用户确认没有人工搬动车和料台，但上一段程序曾移动底盘；当前间隙尚未重新量出，不能用烧录重置的局部参考重新充值50 mm接近预算。

## 70 mm间隙参考与手动转动段（00:33～00:37）

用户随后实测间隙约70 mm，在停止观察时以`grab track reference 50`恢复本地料台参考，之后停止/重启未重新充值预算。先见目标(44,303)、水平偏差约-290 px，未让底盘追大偏差；用户将物料转回近端后坐标约(344,337)，偏差10/1 px，从此小偏差进入追踪。

第一段35秒：用户确认没有注意提示、未转物料，属于静物对准/保持。约0.6秒进入follow（300 ms上传采样的粗粒度结果），最终准心(334,338)，两轴全段RMS1.224/0.200 px（MCU新样本统计）。停车确认，不算动态验收。日志`track-manual-near-01.log`107/117条有效、3条坏CRC；不宣称记录完整。

用户明确要求重新启动，第二段留90秒操作窗口，日志显式300 ms；不改任何控制参数、不重建参考、不下降夹取。用户回复已转动，实际角度/转速没有独立测量，不按提示的20°或固定6 rpm当实测值。

- `track-manual-near-02.log`覆盖90秒，301个候选号、287条CRC有效、0坏CRC、14缺号。其中前期每10条缺1条，可能含发送忙跳过；不能以正常COM回复或0坏CRC断言无数据缺失。
- 底盘本地前后向净位移+92.15 mm，接近向净位移-15.81 mm（远离料台）；X55.10→38.32 mm、净回缩16.78 mm。实际反馈峰值前后85.26、接近15.83、X15.47 mm/s；对应采样请求峰值84.68/16.19/37.78 mm/s。各峰值不同步、X差分反馈仍非独立测速，不能凭峰值比直接判定驱动减速原因。
- 全90秒MCU新视觉样本1801条，两轴RMS3.821/2.151 px、95%2/1 px，但大量静止时间稀释运动误差，不能据此宣布稳定动态追踪达到5 px验收目标。
- 用有效实时行中实际或请求任一速度>5 mm/s定位运动区间，再向前扩300 ms、向后扩1000 ms，区间5200 ms含17条采样；运动段两轴RMS15.761/8.845 px、合成RMS18.073 px，采样峰值28/21 px，状态摘要另外观测到水平-36 px。动态滞后尚需优化；300 ms采样也可能漏掉更短峰值。
- 运动区间以记录内`batch`实际完成批次间隔统计95%为113 ms，X位置反馈年龄95%98 ms。报告工具从稀疏上传行反推出的371 ms发送间隔不是完整批次节奏，不据此认定控制退化至300 ms。
- 最终目标(334,338)、误差0/0；停车stop_confirmed=1、总线无locked，X最终38.32 mm，参考剩余预算65.91 mm（退离后预算增多，仍以固定参考计算，非重启充值）。本段实证发送与反馈都发生，排除“本段全程请求非零但机构不动”；Z/Base/夹爪无自动指令。

现阶段结论：静物保持与停转收敛良好，手动转动时有显著暂态误差；下一步需针对动态段检查X位置流实际执行及目标运动估计，不能用静物长窗或编译成功替代6/8/10 rpm动态验收。本次未再次烧录、未修改控制算法或速度参数。
