doinbest/Yachiyo/xjx/模版搭建/docs/开发记录/2026-10-09-控制台故障原因中文提示.md

# 控制台故障原因中文提示

用户要求将不熟悉的英文故障原因改成中文，简单名称及单位可以保留。本轮仅修改本地网页显示，不改变固件通信协议、运动控制、互锁或恢复条件。

修改前工作区干净；快照提交为 `1ac3a90`，原有490项网页测试通过。

## 修改

- 新增 `Code/upper-computer-web/local-car/device-text.mjs`，集中补齐抓取、底盘、总线、转盘、IMU、参考、标定和赛事交接原因的中文说明。
- 终端、抓取/标定状态卡、追踪提示、路线/遥测详情及参数拒绝提示使用中文。Base、X、Z、USB、IMU、ID、DX/DY、RPM及数值、单位保留。
- 拒绝提示的英文说明改为中文，例如码垛请求被拒绝时提示读取抓取任务状态；不推断固件没有报告的拒绝原因。手动操作反馈检查与命令未发送分别说明。
- 保留“停止未确认”与实际停车失败的区别；`transfer_off_pose`解释为Base转离观察姿态；转盘回零不显示成三轴回零。
- 原始报文、日志导出、串口捕获及解析后的内部故障码保留；未知代码仍可追溯。更新网页入口缓存标记，刷新后使用新显示。

## 验证

- Node网页回归494项通过，包含实际app处理函数、状态卡及表单验证；状态卡翻译不改内部故障码、不发送命令，既有停车、断线、按钮恢复及参数读回回归保留。
- Python串口服务82项测试通过，使用FakeSerial/模拟设备。
- 检查当前抓取、转盘、底盘、总线、IMU和赛事源码中的直接原因赋值及故障调用，补齐中文映射。
- 未修改固件、Keil/EIDE、香橙派、HMI或F103工程；不连接实车发送测试运动，不烧录。网页显示实际效果待用户刷新后验收。
