doinbest/Yachiyo/xjx/模版搭建/docs/开发记录/2026-10-09-追踪电机故障串口排查与后台记录.md

# 第二次追踪电机故障串口排查

COM38 / 115200 / 8N1，沿本地串口服务发送查询，避免竞争占用。用户确认车辆在地面正常接触。

20:09:11启动持续追踪，20:09:22触发wheel_disabled_or_stall，20:09:23回复stop_confirmed=1。20:09:38才开启本段记录，所以本段618条校验有效像素都是m=0的故障后观测，不能作故障前跟随分析。候选824帧、缺206帧、坏格式/CRC39行，设备queued=824/dropped=0；证明设备入队成功不代表电脑收到，链路问题依然存在。

两轮显式反馈轮询后，新鲜四轮均raw_rpm=0、flags=0x03、valid=1,1,1。临时轮询已关闭。恢复后或人工停止后的当前正常状态不能证明触发时无异常。未发送新运动、使能、清堵转、总线恢复或复位命令。

固件wheels与track_feedback中的wheel_disabled_or_stall条件为state_valid且(原始flags的0x0C相关位非零，或使能位0x01为0)。状态文本未保存触发电机ID和原始flags，无法区分失能、具体堵转位、或反馈异常。现有TrackFeedbackFault只冻结反馈缺失/过期，不冻结电机状态故障。因此根因尚未确定，不删改保护、不将当前0x03当触发时快照。

第二次停止后冻结窗口共128条，当前校验有效84条，补读仍有缺失和无线文本损坏。有效记录请求峰值前向160 mm/s、左向29.25 mm/s、X60 mm/s；反馈推算峰值前向124.77 mm/s、左向33.91 mm/s、X37.88 mm/s。只能作部分轨迹证据，不据此认定过载。第一轮也出现较高请求后状态故障，缺驱动电压/电流和触发标志证据。

可复核结论：故障入口是四轮电机状态判定；静止查询未复现持续异常；故障当时ID/flags缺失。进一步精确定位需要捕获触发瞬间ID、原始状态、状态接收时间及当时速度，而不是重复读取已恢复的缓存。若补充固件诊断，应只保存首个触发快照并在显式status中输出，保留停车后证据，不增加运行时高频打印。

终端精简显示修正另在源码实现：默认隐藏PIX与TRACK live/row且不占500条缓存，后台解析、原始落盘和完整TXT仍保留；CMD也隐藏采集行。本次不重启正在连接的服务，网页刷新可载入显示修正，CMD修改需服务下次启动生效。

终端显示修正验证：网页500项测试、Python服务90项测试通过。未修改故障判定、未烧录。晚些时候4项参数查询未收到完整设备回复，不把源码默认当实际参数。
