doinbest/Yachiyo/xjx/模版搭建/docs/开发记录/2026-10-16-行驶总线故障与公开实现对照分析.md

# 行驶总线故障与公开实现对照分析

## 范围与结论

用户要求分析行驶中反复总线故障，并参考开源实现及CSDN。本轮核对当前共享UART5收发、底盘同步批次、X轴位置入口、工程所带HAL和已有串口日志；只修改分析记录及问题台账，未修改控制代码、运行C、编译、烧录或发送设备命令。其他并行轮次的编译状态不由本记录覆盖。

确认一个可达的软件丢应答路径P022：运行中可恢复UART错误分支在解析前清空全部未处理接收字节，因此可能主动丢掉已经完整收到的本次应答。静态X Both主动到位通知与四轮事务并存是另一个有日志相关性的通信嫌疑，但现有证据不能证明物理碰撞。实际UART错误告警和坏帧也不能全部归因于P022。

## P022：接收恢复清空尚未解析的完整应答

源码入口为`Code/template/Hardware/motor_bus.c`的`MotorBus_Process`、`MotorBus_RxBytes`和`MotorBus_ErrorCallback`。当前Process先处理io_error，再处理tx_done，最后消费rx_ring。NE/FE/ORE可恢复分支执行`rx_read=rx_write; parse_length=0`，重启RX后保留活动请求及原期限。

可达顺序：

1. 某轮F6或35/36等请求已发送，完整匹配应答由DMA回调复制到rx_ring；主循环尚未解析。
2. 随后的另一个字节触发NE/FE/ORE，ErrorCallback设置io_error。
3. 下次Process先将rx_read追到rx_write，完整应答随残片一起被删除。
4. 驱动不会再次主动发送这个普通应答；原事务继续等待，期限到后进入reply_timeout及比赛恢复。

这是源码确定允许的错误时序，不是本轮已运行的C复现，也不能仅凭已有日志确定每次现场超时均走了此路径。工程所带HAL在DMA接收期间遇到UART错误会中止接收，RX重启本身有必要；问题在于恢复时不区分此前已接收完整帧与不确定残片。

`Code/tests/motor_bus_startup_test.c`的active_ne/active_ore等用例先注入错误并Process，再送ACK；没有覆盖“ACK先入队、随后错误、没有第二份ACK”的顺序。后续应补该回归及错误跨帧、残片、迟到应答、TX完成尚未被主循环处理等边界，核对真实生产MotorBus；不能通过放宽匹配、信任损坏残片或重发运动规避。

建议修复原则：保存接收错误边界及当时事务上下文，保留可证明在错误前完整收到、匹配本事务且在期限内的应答；对无法证明完整性的残片重新同步。保持RX恢复、原请求期限、人工停车和禁止重放运动语义。

## 已有日志能说明什么

本地证据：`.embeddedskills/logs/serial/20261016-032050-d35ca5.jsonl`；摘录位于`.embeddedskills/analysis/driving-bus-20261016/`。日志跨多个BUILD及重启，记录条数不能当作一次比赛的故障次数；rx_sample是最近字节诊断，不是逻辑分析仪上的完整事务抓包。下列时间为北京时间。

| 时间及构建 | 首故障与最近接收字节 | 可确认范围 |
|---|---|---|
| 07:27:08，BUILD 07:23:43 | ID2/F6超时，`07FD9F6B` | 等轮应答时收到X轴到位通知，未收到可匹配轮应答 |
| 07:27:15，同上 | ID4/F6超时，`07FD9F6B026B` | 仍有X到位通知和残片，不能据此证明物理冲突 |
| 08:37:50，BUILD 08:27:04 | ID1/35超时，`0135000000EB` | 最近字节形似速度回复但结尾不符；损坏发生位置待实测 |
| 08:41:47，同上 | ID1/36超时，`06FD9F6BED8D6B` | 另轴到位通知与不可匹配残片并存 |
| 08:42:58，同上 | ID7/36超时，`07366B` | X位置回复不完整，故障不局限于某一个轮地址 |

另有反复`rx_restarted uart_error=0x00000004`，按工程所带HAL头文件对应FE帧错误；NE噪声错误为0x00000002，ORE溢出为0x00000008。首次分析将0x04误称NE，用户追问DMA时重新核对工程宏定义并在此更正。FE表示接收帧的停止位未被正确识别，不能直接认定为电磁噪声。超时记录的`uart_error=0`来自超时分支传入0，不代表此前没有UART错误或RX重启。现有诊断未保存本次事务错误前后的完整接收边界，不能把P022与所有坏帧直接等同。

## 静态X与四轮通信的交互

当前`GrabTask.axis_move`仍走普通`MechanicalArm_PositionEx`，固定位置模式准备Both；动态追踪的专用入口才使用`MechanicalArm_PositionTrackingEx`及Receive。Both会在受理时回复，也会在真正到位时主动发送FD/9F。主机串行安排请求与2 ms交接可以约束自己的发送，不能预约驱动未来某一刻的主动通知。

因此，静态纠偏连续发短X目标期间，另一电机正在回复时X恰好到位，存在返回通道竞争风险。当前解析器已经识别异步9F，并非完全不会解析这种消息；收到一帧9F也不等于已经证明线路碰撞。应针对连续纠偏评估专用Receive与新鲜反馈完成判据，固定取放Both保持原合同；不能全局禁用到位通知、取消真实停稳或简单增加等待。

## 公开资料对照

- [张大头本人CSDN协议说明](https://blog.csdn.net/zhangdatou666/article/details/132644047)：区分Receive、Reached、Both；Both包含受理与到位回复。该在线说明面向旧Emm42 V5，此处仅交叉核对共同应答语义，当前X42S二代具体帧长与配置仍以项目对应手册及实现为准，不照搬旧板参数。
- [MaJerle STM32 UART DMA示例](https://github.com/MaJerle/stm32-usart-uart-dma-rx-tx)：循环DMA配合HT/TC/IDLE、按游标消费新增数据，UART与DMA回调避免抢占重入。项目当前已有循环DMA及HT/TC/IDLE，UART5和相关RX/TX DMA IRQ同为优先级1/0；没有发现需整体改成另一种DMA架构的依据。该项目MIT，未复制其代码。
- [ST官方HAL UART源码](https://github.com/STMicroelectronics/stm32f4xx-hal-driver/blob/master/Src/stm32f4xx_hal_uart.c)：用于理解错误恢复；最终以工程自带HAL对应分支核对，不能把在线最新HAL等同于工程版本。

简单阻塞收发示例无法直接替代当前八电机共享、异步到位、紧急停车与恢复调度。未找到足以证明当前驱动固件存在某个特定版本缺陷的原厂依据，不建议据二手文章直接升级驱动。

## 后续处理优先级及验证边界

1. 优先修P022，补生产组件回归，证明错误前完整应答不会被清空，错误残片仍不能冒充成功；不重放运动。
2. 专项处理静态X连续纠偏的应答模式及切换完整性，保留固定位置、HOME及人工停车语义，覆盖纠偏结束接固定取放。
3. 把本次事务与UART错误前后的接收边界关联到诊断。若仍有FE/NE或坏帧，结合实际返回通道、供电和电平波形定位；目前不能单靠源码区分干扰、返回竞争、驱动异常或丢字节。

当前未确认控制周期1 ms导致每1 ms强制发送一套四轮串口命令：发送侧有同步批次和最新待发目标替换。也没有依据将所有100 ms期限直接放大，或给全部运动增加重发。此前P017/P018修复的是取消、交接与限定状态补读，不代表所有F6/位置查询超时已解决。

## 用户补充08:52噪声告警后的分层分析

用户提供08:52:07 count257/258及08:52:11 count259，三条均为0x00000002，按本工程宏定义确为NE。它们不能被上一节0x04的FE更正覆盖。count是自初始化累计接收恢复数，并非连续失败次数；tasks_interrupted=0表示该次接收恢复没有主动中断任务，不证明活动请求已经成功或之后不会超时。

偶发损坏帧应丢弃并重新同步，不应直接等同于整个比赛失败；八设备共享串口本身也不意味着必然丢帧。当前Process已把NE/FE/ORE恢复为告警，但757～769行在事务100 ms无匹配应答后，除StatusReadMayRetry限定的状态读取外仍直接Quarantine整条总线。故接收层容错与事务层容错没有完全衔接，普通读反馈丢包也会扩大为整车恢复。

当前协议没有独立固定包头：首字节为1～8地址，随后功能码、已知长度和固定0x6B；固定0x6B不是内容校验，数据区也可能含地址、功能码及0x6B值。ParseByte会逐字节移位寻找候选，但不完整候选可跨请求保留，普通发送只等2 ms静默后放行；地址/长度/尾字节看似成立的非本事务候选会整帧消费。因此不能承诺漏一两个字节后仅凭头尾一定恢复正确，更不能用损坏数据补齐实测反馈。需要后续以真实MotorBus注入删字节、跨帧拼接、异步通知和正常ACK，验证重新同步及不误认成功；本轮没有执行该回归或据此登记新的现场根因。

建议事务按语义分级：

| 类型 | 可采用的处理方向 | 仍需保留的事实 |
|---|---|---|
| 速度/位置等只读反馈 | 单次漏答本次无新样本，调度下次轮询或有界只读补读；最近有效反馈只在原新鲜度范围内使用 | 不刷新旧测量时间，不外推实际位移，不宣布到位或停稳 |
| 连续四轮速度目标 | 设计可续接的整组最新目标确认与同步流程，失败组不能混用部分新目标 | 某轮ACK丢失时无法区分未受理与已受理；不能直接跳过它发送FF同步，也不能重放历史积压目标 |
| 相对位置、HOME、设零、写参及SAVE | 保留待确认状态，按对应动作的新鲜位置/状态或读回核验 | 禁止盲目重发，不因无ACK宣布成功 |
| 停车与完成交接 | 丢包可继续取真实证据，未确认期间不推进取放/新动作 | 真实停车、新鲜反馈、驱动保护和机械边界保持 |

若后续反馈及时恢复、可重建完整当前轮组及共同时间定位，应继续原阶段；若持续缺少可用控制依据，先减速/停车并保留任务进度，再按原暂停续接语义恢复。是否自动续跑须遵循原故障类别的既有约定，不能把独立IMU暂停的显式继续改成自动发车。触发依据应为当下反馈年龄、同步缓存状态及动作是否可确认，不能仅凭累计count终止比赛。该方案本轮仅分析，未更改100 ms期限、重试范围、运动语义或代码。

## 再次定位：噪声报警最可能来源

本次用户要求结合代码、日志和提示判断最可能原因。补读同一日志至08:54，08:52这轮设备报告仍是BUILD 08:27:04；不能用之后工作区P022修复源码替代当时运行固件。当前台账另轮已记录P022专项及Keil通过、未烧录，本节仅分析现场日志，不重做或覆盖其验证结论。

### 不仅发生在行驶或X视觉纠偏期间

- 08:48:54用户发mission stop，之后08:49:11进行IMU验证、08:50:30进行原生标定，08:51:41读回标定结束及控制资格恢复。
- 08:51:00～08:51:53，日志已有74条rx_restarted，累计count从157到251，均为NE=0x02；新比赛08:51:54才受理。因此不能把这些错误全部归因于行驶震动、工位X短目标或高速四轮调速。静止使能时驱动仍可能产生电气干扰，不能由此排除供电/共地问题。
- 08:50:06总线统计transactions=59521，ID1～4各约14843次请求，所报timeouts均0；ID5～8请求分别35/57/20/34。说明后台四轮读取一直运行，尚不能称作无总线通信的空闲对照。该样本更支持共享接收信号或普通读反馈交接问题，削弱“仅静态X Both导致全部NE”的解释。

### 故障接收样本出现疑似发送指令回显

08:52:17.740事件23986：ID7/FD超时，owner=2，rx_bytes=17，最近16字节为：

```text
FD 01 00 1F 14 00 00 02 34 01 00 6B | 06 FD 9F 6B
```

前12字节恰好符合`Emm_V5_Pos_Control`发送13字节去掉首个地址后的格式：方向1、速度31 RPM、加速度20、564脉冲、绝对模式1、非同步0、6B尾。后4字节是ID6到位通知。若前面缺失的一个字节为地址，则与rx_bytes=17及最近只留16字节的诊断一致；但没有对应逐事务TX抓包，尚不能把这一地址补成事实，也不能证明这段确为当时主机原样回显。

正常FD受理回复为地址/FD/02/6B，拒绝回复也不是这段长位置指令。rx_recent仅在RX DMA数据进入MotorBus_RxBytes时更新，不是把发送日志直接拼入；因此疑似发送回显/收发串扰是值得优先核实的新线索。回显可能来自实际转换/接线拓扑，不能只据格式直接断言接线错误；它本身也未必产生NE，NE还须结合电平稳定性判断。

### 当前判断与证据边界

最可能的类别是共享UART5返回通道的信号完整性或返回竞争问题：收发通路耦合、驱动返回电平竞争、线束/共地/供电引起的采样不稳定均属候选。软件同时存在已识别的故障放大路径，但解析错误不能凭空制造USART_SR_NE；NE由HAL读取硬件状态位后记录。当前115200/8N1/16倍采样及循环DMA配置未发现本身足以解释此现象的错误；没有软件证据证明某个指定驱动已损坏或波特率错配。

优先用同一时基捕获主机PC12 TX、PD2 RX及必要驱动返回线，核对疑似回显是否实际存在、报警时有无波形重叠/窄脉冲；再以单节点/多节点及仅反馈/机构动作组合区分线路与交接因素。此处为后续验证方向，本轮没有变更接线、发测试帧、关闭反馈或操作实车。证据保存在`.embeddedskills/analysis/driving-bus-20261016/noise-cause-focus.json`。

## 后续离线复现：完整ACK后发生NE

用户进一步要求确认原因后，新增忽略目录中的最小复现，链接未修改的生产motor_bus.c、mechanical_arm.c、Emm_V5.c，HAL收发边界替身来自既有motor_bus_startup_test；未修改活动测试或控制代码。GCC -std=c99 -Wall -Wextra -Werror构建通过。4个独立进程分别验证：clean完整ACK正常受理；ack_then_noise完整ACK入队后、前台尚未处理TX完成即NE，ACK被丢、100 ms后超时锁总线；tx_observed_ack_then_noise前台已处理TX完成后，同序仍丢ACK并超时；parsed_then_noise先处理ACK再NE则保持成功。每场景TX计数均为1，无运动重发。证据保存在.embeddedskills/analysis/p022-proof-20261016/（p022_proof.c、results.json、source.json）。此处复现的是软件错误时序，不是新增实车复现；现场占比及异常原样查询来源仍待确认。

## 后续实施：接收边界、恢复容错与报错信息

用户授权完整修改，随后指定“代码修改完成后告知，实机测试同时再审查”。实现阶段必要自检继续，独立全面审查已暂停，不把本次交付称为完整审查完成。沿用此前不烧录要求，本轮未发实车命令、未复位或下载。

MotorBus_ErrorCallback保存首次错误时已入队的RX边界及事务序号；Process先落实原TX完成信息，只在同一事务内使用原解析规则处理错误前字节，随后清残片并重启RX。错误后字节不能与前段拼帧；错误前完整且在期限内的匹配应答可以完成原请求。主循环解析期间若出现新错误，先交回错误处理再检查期限或派发下一事务。重复错误合并错误位，防止NE后到来的DMA错误被忽略。普通运行及恢复中的NE/FE/ORE不重发运动、不延长原请求100 ms及恢复总期限；DMA/溢出/重启失败、驱动保护及真实缺应答继续阻断。

故障增加first_tx/attempt_tx（长度、TX完成时刻、最多前16字节），现有首次故障和本次恢复证据分开保留。rx_restarted追加错误时间、对应边界排队量及累计保留应答数，仍沿500 ms限频。排空旧读超时无法对应原TX时留空，避免误指另一指令。网页同步这些诊断名称，把总线锁定导致的转盘任务故障明确为共享总线阻断，并修正动态夹取提示为高位进入本次窗口后连续下降、Z完成即闭爪并请求底盘/X停止；旧暂停Z原因仅标旧流程。未改夹取参数或静态X应答模式，未把回显/物理争抢当作已证实原因。

验证按先失败再修复：新增motor_rx_error_boundary_test先复现错误前完整ACK被误删；覆盖TX待前台处理、已处理TX、分片、错误前后残帧、错误后完整帧、错地址、损坏尾字节、过期、重复错误、RX队列/时钟回绕、NE/FE/ORE、持续噪声但原100 ms期限不延长、取消及NE后DMA错误。恢复测试补NE/FE/ORE发生在已有完整回复之后仍能完成，保留缺回复、真实DMA、重启失败、残余运动、保护/失能和人工取消。专项成功不代替线路原因已消除。

日志及结果在.embeddedskills/uart-rx-fix-20261016/。选定旧回归35项中29项通过，6项失败（motor_bus_test、turntable_test、turntable_bus_fairness_test、mecanum_bus_test、mechanical_arm_bus_test、mechanical_arm_emergency_chain_test）均在修复前motor_bus.c上重现相同断言；未扩大修改这些既有差异，不宣称全套通过。配置/停车专项通过，网页83项通过。Keil template构建0错误/0警告，生成AXF/HEX；没有烧录。最终哈希与结果见delivery-verification.json。

## 后续代码审查

用户要求审查已交付UART5修改。核对生产源码哈希与delivery-verification.json一致，独立检查接收边界、恢复/停车交接及网页/协议说明；本轮没有修改生产代码、未编译固件、未发送设备指令、未复位或烧录。软件离线复现和文档同步不影响运行中的实机。

确认两项P2：P023为隔离后已授权停车只读反馈遗漏RX-only处理，完整零速回复遇单次NE仍丢失、反馈资格被撤销；修复前后均复现，属既有遗漏。P024为RecoveryEvidence按同ID同功能匹配旧active，新的复读尚在排队时仍输出旧tx_ms，之后失败还会冻结该时间；本轮新增诊断问题。详细条件、源码位置和修复方向已登记问题清单。两项尚未修改。

16种新接收边界及motor_recovery_test重新编译运行通过；网页terminal-format/grab-track专项67项通过。6项旧失败在隔离复制夹具中，仅同步Both准备、已消费帧计数、当前Z默认2250 RPM、合理的TX/RX顺序与相邻回绕时间后全部通过，机械臂停车附加4变体也通过；原活动测试未修改，不能将原全套声明通过。一个“abort后HT可能提前交付”的候选因遗漏HAL ReceptionType切换而排除，未作为缺陷。RX原样指令及实际NE/FE来源仍待实测。

已同步连接与恢复、系统协议及P017的过时编译状态：当前固件Keil通过，配置停车专项通过，本对话未烧录，未运行专项与实车验收仍单独保留。审查产物位于.embeddedskills/uart-rx-review-20261016/，包括独立审查结论、集成报告、两个复现及review-summary.json。

## 09:34:53上电测试导出日志补验

用户反馈尚未修P023/P024，重新上电后仍频繁故障，提供Downloads/serial-20261016-032050-d35ca5-console.txt。按最新启动边界（原文件6858行附近，09:34:53，BUILD09:32:52）隔离此前历史；09:35:08开始比赛，09:36:46人工暂停。此次只离线分析，未改固件或发送设备指令。

本次启动RX重启计数达到129；57条字段完整的告警中48条NE、7条FE、2条NE|FE，均queued=0、preserved_replies=0。计数129不等于129次比赛故障，15次bus_recoveries包含恢复重试。恢复失败的完整样本有ID8/3A→836B、ID5/3B→036B、ID8/35→0000006B；普通故障有ID5/3A→6B、ID5/36→00195E6B、ID3/35→FA。它们不足以组成当前查询的完整回复，涉及多个电机；本轮完整样本没有对应TX原样回显证据。

这说明整体现场尚未通过，不能把P022源码修复当成通信链路已修好。本次完整告警未显示错误时有已入队完整应答被保留，实际异常涉及进入解析队列前缺字节的情况；仅凭rx_bytes和残片不能确定电机未发送、线路损坏还是HAL/DMA错误中止及RX重启丢失未交付数据。真实DMA/线路快照或波形仍需要补证。P023/P024仍待修，但本轮缺少它们各自的完整触发证据，不能把所有超时和stop_unconfirmed归因于它们。

日志本身有控制台拼接缺字，残缺first行没有补猜。末状态stored=1、item=2、auto_resume=0，原因为人工暂停恢复流程，stop_confirmed=0；没有比赛完成或最终停车确认。建议先补齐已确认P023/P024，并在错误发生时保存有界的DMA未交付数据、游标及对应TX，再进行单ID只读与并发场景对照；不通过放宽匹配、延长全部期限或重发运动掩盖缺帧。证据与统计在.embeddedskills/analysis/poweron-0936-20261016/。

## 10:12:32重新烧录后的比赛串口实测

用户明确已重新烧录，要求再次发送比赛开始指令、抓日志。沿用已连接的本地串口服务COM23、115200/8N1，只发送一次`grab mission qr 1000 100 lower fixed raised linear`，受理编号295；随后仅被动读取服务事件。该次运行没有修改控制代码、编译、烧录、复位、重发开始或额外发送恢复指令。用户后来说明已断电，要求分析之前的日志；10:15:14出现的新BUILD和初始化单独划界，不将其直接登记为小车自行复位。

| 北京时间 | 本轮可确认事件 |
|---|---|
| 10:12:32～10:12:33 | 比赛受理并进入`driving/to_qr` |
| 10:12:37 | 第一次完整故障证据：ID3/F6超时，此前发生硬件FE；尚未到原料台 |
| 10:12:45 | 实际扫码并冻结执行码`126+123+216+231`，驶向原料台 |
| 10:13:58 | `stored=3`，三件入仓后已进入离站及回工位中心，随后正常驶向加工区 |
| 10:14:16～10:14:28 | 第一件空爪色环对准，期间漏检重获；之后明确进入`car_pick_prepare` |
| 10:14:39～10:14:46 | 进入加工区持料放置下降，反复被总线恢复中断；仍为`placed=0` |
| 10:14:46～10:14:58 | 连续7份完整恢复失败证据均为ID7/35超时，接收只有`07356B` |

最后完整比赛状态为10:14:58的`bus_recovery_retry`、第一批第一件、`stored=3 placed=0 stop_confirmed=0 bus_recoveries=18 auto_resume=1`。18包含恢复失败后的重试，不等于18个独立根故障；接收恢复计数最高完整值28同样是本次启动累计。16条字段可完整解析的接收告警中FE有9条、NE有7条，限频及控制台拼接使其不是全部错误次数。

### 新增IRQ/DMA快照实际提供的证据

获得12组字段完整的DMA快照，其中11组为HAL处理前的UART IRQ入口采集、1组为callback后备采集。只按保存的游标和NDTR计算尚未转交的软件边界区间，不将64字节循环缓冲中的旧内容当作本次新回复；完整样本的两次NDTR均相同，但仍不等同于逻辑分析仪逐字节波形。

第一份seq=5：当前TX为`03F601006500016B`，TX完成56539 ms；IRQ在56540 ms记录`uart_sr=0xC2`，HAL错误为FE=0x04。DMA消费游标28、NDTR=32，未转交的区间为偏移28～31，实际`05FD9F1B`，呈ID5到位通知形状但尾字节不符。100 ms原期限到时，解析队列诊断仅有`F6026B`，不能组成ID3应答。不能将该DMA后32字节中的历史`03F6`拼回来当作已完整收到本笔ACK。

另一个完整样本seq=18：ID1/35查询后、FE IRQ时尚未转交的6字节为`01350000017F`，尾字节不是0x6B。由此确认这轮并非只有上层解析/恢复误删这一类现象：硬件状态位在恢复代码执行前已报告NE/FE，原始DMA区也出现无法组成合法回复的内容。本轮没有发现足够证据证明某份完整、匹配的ACK已在未转交DMA中却被恢复删除；也不能仅凭这些快照排除所有HAL/DMA交接问题。

### 恢复阶段的原样查询字节

10:14:46～10:14:58的7份完整失败记录均为`health_checks addr=7 func=0x35 tx_sent=1`，实际TX和RX样本都恰好是`07356B`，RX为3字节且partial=3。它是查询格式，缺少速度数据，不能作为停车或健康证据。各次`tx_ms`随新发送推进，没有在这些样本中看到借用上一笔时间的现象。

seq=24的IRQ快照还记录：当前TX=`04366B`、尚未完成发送，DMA未转交区间已有`0436`。这是收发通路耦合/回显值得优先核对的进一步线索，不能据此直接指定接线错误、某一驱动损坏或物理冲突。ID7在此是X轴；只收到原样查询也不证明只有ID7异常，前面的故障涉及ID1、3、4及其他轴异步通知。

### 视觉与下一步边界

加工区这次对准总计约12秒，先等待有效目标约2～3秒，随后出现多次`vision_pause`；最大报告漏检约2058 ms。10:14:26已出现`vision_measured_continue`，随后新帧DX/DY进入窗口，并在10:14:28进入取仓。因此视觉漏检增加耗时，但最终卡住的位置已在取仓/放置及总线恢复，不能把本轮终止归因于一直未完成色环对准。

下一步先完成此前已安排、这次尚未做的单电机只读查询与多电机轮询对照，再结合PC12 TX、PD2 RX及驱动返回通道同一时基波形，区分主机回显、返回竞争、电平/供电与HAL错误恢复造成的丢字节。错误前完整应答保留和诊断修正不能据此宣称已消除现场通信根因；不扩大运动重发或放宽坏帧匹配。实测原始事件、控制台、二进制及分层解析在`.embeddedskills/p023-p024-dma-20261016/direct-101230/`，本次只新增离线解析脚本与记录。

## 后续收窄：只处理电机故障及报错归属

用户明确先搁置加工区漏检，仅分析电机故障。设备已断电，本轮没有发送串口命令、探针操作、编译主车固件或烧录；未改生产控制代码。按系统排查流程核对UART5配置、工程自带HAL错误路径、MotorBus解析/恢复、底盘反馈及机构停车消费者，并运行离线复现。

报错链的共同关系为：UART NE/FE或无法匹配的回复 → 原事务超时/总线隔离 → 转盘等客户被总线阻断 → 缺少停车证据产生stop_unconfirmed → 比赛恢复检查及失败重试。turntable的bus_locked及机构停车未确认不单独证明对应驱动出现硬件保护；必须保留最初fault地址、功能、TX、RX与IRQ快照。工程当前HAL在DMA接收中遇NE/FE也会结束RX，短时恢复只能保留已证明完整的应答，不能使缺失的合法回复自动出现。当前RX/TX分别DMA1 Stream0/7，没有在所查分发路径发现把TX数组直接复制到RX的代码；回显来源仍需实机对照。

将现场输入送入当前生产MotorBus，使用生产2 ms交接、严格GCC告警，8种行为得到确认：正常速度回复受理；仅`07356B`按原100 ms期限超时；查询字节后跟合法速度回复能重新同步并受理；FE后仅F6026B不成功；06FD9F6B68FB与F6EB6B不能完成对应位置查询；异步9F后匹配F6 ACK正常；完整ACK后NE保留应答且计数preserved=1。每场景实际TX一次，没有运动重发。因此，本轮这些不完整样本被判超时具有依据，不能靠改成成功来消除故障提示。

另有1种合成输入暴露P025：当前7号速度查询等待期间，连续注入`07356B07356B`，ParseByte会输出6字节MOTOR_BUS_REPLY，第三字节符号=0x6B。原厂手册5.5.11及5.5.13列明速度/位置符号只允许00/01；当前解析没有对应校验，速度消费者又将任意非零解释为负数，此样本相当于虚假−1845 RPM。该缺口会影响反馈可信度和恢复判断，已登记，尚未修复。合成连续两份输入不代表10:12实车已出现；该轮只有3字节的7份恢复失败样本均按超时处理。

同时重新编译运行当前P023/P024专项：停车只读NE/FE/ORE完整回复保留、缺回复、DMA共5变体；恢复请求待发/失败证据与新发送归属共2变体通过。同步修正问题索引、主车README及系统协议中“两项尚未修改”的过时状态，历史审查记录保留原事实。这里是7种主机验证，不是新增实车验收或全套测试通过。

当前待办为修复P025的非法符号误认，并完成单电机只读/多电机轮询与必要波形对照；加工区漏检不在本轮范围。复现代码、命令、生产源码哈希及输出在`.embeddedskills/motor-fault-focus-20261016/`。这轮只完成电机故障归属与软件复现，没有宣称NE/FE、回显或整场比赛已修好。

## 10:34～10:38单电机与多电机只读实机对照

用户要求有发送、有回复的多电机轮询测试，并确认主车及所有电机驱动已上电。使用现有本地串口服务独占的COM23、115200/8N1；先以缓存状态确认比赛idle、机构idle/home_complete、总线未锁、恢复未活动。未编译或烧录固件，没有发送运动、回零、写参数、归零或bus recover。本轮仅改变读取选择/开启反馈采集，结束后关闭采集并恢复全轮选择。

| 场景 | 发送/匹配回复 | 超时/驱动拒绝 | 记录到NE | 节奏及范围 |
|---|---:|---:|---:|---|
| ID1～8逐台只读核验 | 240/240 | 0/0 | 0 | 每台10轮，每轮3A/36/35，沿原20 ms间隔；逐台分组，非八台同时发送 |
| 四轮正常连续轮询 | 10580/10580 | 0/0 | 2 | ID1～4，约31.76秒、333.12笔/秒；每轮各2645笔，ID5～8无新增请求 |
| 单4号正常连续轮询 | 10338/10338 | 0/0 | 0 | 同一反馈调度，约31.00秒、333.53笔/秒；其他7个ID无新增请求 |

逐台阶段保留240份完整原始回复，地址/功能/长度/尾字节及35/36符号全部符合所测格式，MCU报告最长回复2 ms。例：ID1/3A请求`013A6B`，实际回复`013A036B`；ID7/3A请求`073A6B`，实际回复`073A036B`。发送完成数来自MCU实际TX完成统计，查询字节按执行的固件入口核对，未连接逻辑分析仪。连续阶段按前后稳定的各ID计数差取值，并以反馈接收时刻持续推进确认有新样本；没有将PC命令已排队或旧缓存当作新电机回复。速率按主机on/off发出时间估算，不是精密链路吞吐测量。

### 四轮只读时仍复现硬件噪声

北京时间10:35:07、10:35:08两份WARN均为NE=0x02、tasks_interrupted=0，计数1、2。两份HAL处理前IRQ快照均记录uart_sr=0x84，当前仍处于TX发送阶段，wait=0、tx_complete=0：

| seq | 当时查询 | DMA消费游标 / NDTR | 尚未转交的新增字节 |
|---|---|---|---|
| 1 | `04356B`（ID4速度） | 59 / 4 | 偏移59，仅`FF` |
| 2 | `03366B`（ID3位置） | 22 / 41 | 偏移22，仅`FF` |

两次都不是已完整匹配回复被软件删除的证据：当时出现异常新增字节，RX重启后当前查询最终收到回复，连续阶段计数10580次均成功，没有总线隔离或整车恢复，emergency保持0。四轮缓存读回速度均0；本次没有发机械臂动作，ID5～8没有新增请求。因此，本轮确认静止、只读查询也能触发NE，不能把全部NE归因于车辆运动、视觉纠偏或机构主动到位通知。产生NE的具体电气或接收条件仍待定位。

同等查询密度的单4号窗口未记录NE，提供了切换地址/共享返回通道的对照线索；各仅一次约30秒窗口，不足以断言地址切换就是根因，也未物理隔离其他驱动。P025在本轮未见非法符号误认证据，仍单独待修；固定0x6B尾本身不能当内容CRC。

### 收尾及证据

四轮阶段关闭采集后，多次只读bus status保持transactions=11205，各轮requests=success=2675，证明已停止新增查询；控制对照结束恢复选择0并保持采集关闭，两次只读统计的有效计数均保持transactions=21543、ID4 requests=success=13013，其他ID计数不变，总线locked=0、恢复active=0。未启动比赛。

原始事件、UART控制台字节和逐台原始回复：`.embeddedskills/multi-motor-poll-20261016/real-poll-103417/`；补齐控制台截断计数的只读收尾查询：`verify-end-103621/`；同密度单ID对照：`single-control-103741/`。`comparison.json`保存两组统计与IRQ/DMA区间；`serial_poll.py`及`analyze_poll.py`保存运行与分析代码。部分控制台长行有截断，缺字段未补猜，最终计数采用完整稳定快照。上述完成了静止只读条件下的首次对照，运动/异步回复叠加及波形验证尚未进行。

## 10:47～10:53补齐1、2、3号同频单电机实测

用户授权补齐1、2、3号同频测试。沿用COM23、115200/8N1及现有普通反馈调度，先确认比赛/机构idle、恢复未活动、总线未锁；每次只选择一台轮电机读取35/36/3A，其他节点仍接线并上电。每台30秒目标，按实际on/off串口发送时刻约31秒，不增加运动、回零、bus recover或驱动写参。本轮仅修改忽略目录中的测试/分析脚本，没有编译或烧录主车固件。

| 单电机 | 主机on/off间隔 | 约查询频率 | 发送/匹配回复 | 超时/拒绝 | 记录到NE |
|---|---:|---:|---:|---:|---:|
| ID1 | 30.903 s | 333.69笔/s | 10312/10312 | 0/0 | 0 |
| ID2 | 31.900 s | 333.51笔/s | 10639/10639 | 0/0 | 4 |
| ID3 | 31.376 s | 333.67笔/s | 10469/10469 | 0/0 | 0 |
| ID4（此前同频对照） | 30.996 s | 333.53笔/s | 10338/10338 | 0/0 | 0 |

本次新增三组31420次查询，均得到匹配回复；前后总事务21543→52963，差值同为31420。各组目标轮计数增长与总发送差一致，可收到完整字段的其他ID计数不变，目标轮反馈时间持续推进、速度读回0，没有将其他轮旧缓存当成本轮新回复。

### 单ID2已可触发NE

10:48:48、10:48:57、10:49:08、10:49:20的4次NE对应错误seq=3～6、MCU毫秒1194883/1203080/1214382/1226500。四份IRQ/DMA快照均为active=1、wait=0、tx_complete=0，前两笔当前TX为`02356B`、后两笔为`023A6B`；按游标及NDTR限定的尚未转交区间分别为偏移28、32、30、54，每次都只有一个新增`FF`。SR分别0x84、0x04、0x84、0x84，均有硬件NE位。RX重启后对应查询最终获得回复，没有事务超时、总线隔离或整车恢复。

该结果否定“必须切换多个电机地址才会产生NE”这一必要条件；单独查询2号已经可以复现相同的发送阶段异常字节。它不证明2号驱动损坏：其他驱动和共享线路仍物理连接，本轮没有改变线束、供电或隔离支路，也未记录模拟波形。后续可在2号单ID这个复现条件下对比查询节奏和线路条件，不能直接把所有历史F6/位置超时归到某一电机。

### 统计截断与收尾

ID2关闭采集和恢复选择0均收到受理，但收尾bus status中无关计数行连续截断，首份session保留cleanup_error，没有将它改写成电机通信失败。随后纯只读`verify-end-105047/`取得完整ID2计数13314/13314，三次总事务均42494，证明采集已停止；由该补充证据计算本组增量。第一次ID3准备`single-control-id3-105117/`同样因要求8行全齐而未通过测试脚本准入，未发送feedback on，不计为一次测试。随后将脚本准入收窄到目标ID完整计数加总事务，保留缺行事实，完成实际ID3窗口；没有猜补缺失字节。

最终已发送feedback off并恢复选择0，两份收尾总事务均52963、ID3 requests=success=13144，采集停止得到计数稳定验证；总线locked=0、恢复active=0、emergency=0。本次只完成静止只读对照，未改固件或宣布现场根因已修复。

新增证据目录位于`.embeddedskills/multi-motor-poll-20261016/`：`single-control-id1-104759/`、`single-control-id2-104842/`、补读`verify-end-105047/`及有效ID3测试`single-control-id3-105237/`；各有events/console/raw及分析记录。汇总为`single-ids123-comparison.json`，旧测试及未启动尝试的原始记录全部保留。

## 后续官方手册及网络原始资料核对

用户要求核对张大头官方驱动说明及CSDN、知乎资料。本轮只阅读资料和源码、保存分析，未操作串口、修改控制代码、编译或烧录。首先以项目内《ZDT_X42S第二代闭环步进电机用户手册V1.0.5_260527.pdf》为依据，实际渲染并检查第18、26、37页；图片和文本保存在`.embeddedskills/zdt-official-review-20261016/`，未改原PDF。

- 第26页明确给出TTL多机并接图：控制板TX连接各驱动R/A/H，驱动T/B/L共用返回控制板RX，并正确共地、选择TTL版本。因此，不能仅因本车多个驱动共用TTL返回线而判定接法错误，也不能套用其他型号“UART只允许一对一”直接要求改CAN/485。
- 第37页3.5.2多机同步运动示例明确提醒“每条命令发送完后，要延时几毫秒，防止命令之间粘包失效”。这是官方的通信交接提醒，原文没有规定统一5或10 ms，也没有声称粘包一定产生STM32的NE。本项目当前普通交接是在完整回复后按HAL毫秒时间戳等待2 ms，紧急停车另行处理；这是本项目基于既有实测选择的值，不能把它当作厂家保证适用于所有线路/驱动的下限。需要把普通查询交接余量作为软件侧可验证因素，与线路信号质量一起排查。
- 第18页及其后Response说明区分Receive、Reached、Both；非控制类读取的正常回复不由这些动作应答选项替代。第36页说明主动到位返回FD/9F。它能解释运动时存在异步返回竞争的风险，但10:34四轮静止纯查询没有发机构动作，不能用Both解释全部NE。
- 第18页明确默认0x6B是固定字节，另有XOR、CRC8选项。当前长度/尾字节匹配不能代替内容校验，P025的非法符号误认仍需单独修复；改变校验协议涉及所有驱动及收发端，不属于本次资料阅读，也不能消除硬件采样NE。

网络交叉核对优先采用作者为“张大头闭环伺服”的原始CSDN说明：[Emm_V5.0 Rev1.3](https://blog.csdn.net/zhangdatou666/article/details/132644047)、[ZDT_X系列_V2 Rev1.0](https://blog.csdn.net/zhangdatou666/article/details/135709033)。两篇确认多机地址、同步控制及Receive/Both等共通语义；它们面向较早硬件/固件，具体参数与帧长仍以本项目对应版本为准。未复制其代码。当前手册列出的官方语雀资料入口本轮无法读取，不能把第三方GitHub整理本冒充官方源。此次检索未找到足以直接解释本车两次NE、具备同型号寄存器及波形证据的知乎案例，不以泛泛经验或AI生成问答作为根因结论。

下一步可做普通只读查询2/4/6 ms交接对照，使用相同ID路径、查询种类及相近样本量，分别记录真实查询速率、NE/FE、超时和反馈延迟。增加间隔同时改变总查询密度，改善只能先说明时序/负载敏感，不能单凭一次“加延时后正常”宣布电气根因已消除。紧急停车、动作语义及100 ms期限不据此全局改动；若仍有NE，继续以PC12/PD2同一时基波形定位。当前只能确认接收前端异常，之前优先怀疑线路的判断需要同时保留软件交接余量这个候选。

## 后续工训赛公开工程源码对照及Both解释

用户进一步要求查看工训赛智能搬运相关UART多机控制代码，核对是否有“完整回复后等2 ms”，并解释Both。本轮取得两套公开参赛工程的固定Git版本，只读取电机驱动、接收中断和调用路径，未执行其程序、编译或操作实车。两个仓库根目录均未见LICENSE/COPYING等明确许可文件，因此仅保存到忽略目录作分析，不把代码移植入活动工程。GitHub API遇到匿名访问限额后，改用无工作区检出的浅克隆按需读取；没有把README说明替代实际源码审查。

### Ycn115/enginer-train：2025物流搬运，STM32F407/USART1

固定版本`8f2f08e42ac95fafdfdb0e51af525893c98ff47b`。电机路径为`Drivers/Hardware/Emm_V5.c`、`move.c`和`Core/Src/stm32f4xx_it.c`：

- 速度函数发送DMA后阻塞等待全局`rxFrameFlag`；`Car_Run_Vx_Vy`每轮调用返回后还调用标称`delay_ms(1)`。这里不是严格地址/功能匹配应答后统一2 ms。
- `read_cur_position`发送查询后等待同一标志，然后检查地址、功能及长度；`Step_run_acc_dec`在每轮读取返回后再调用标称`delay_ms(5)`。这是与本项目“回复后留间隔”最接近的参赛代码实例，但其等待层较简单。
- `Emm_V5_Pos_Control_temp`发送后HAL_Delay(10)，标志未到时重复发相同位置命令、每次再延时10；上层固定位置包装另有标称delay_ms(10)。不能仅看调用处HAL_Delay(1)就把整条位置路径说成1 ms，也不能把它的运动重发移植进当前项目。
- 真正USART1 IRQ在IDLE时停止DMA、计算rxCount、置rxFrameFlag并重开接收。IDLE标志表示收到了一个空闲分段，所查速度/停止/同步等待没有完整地址/功能/期限匹配，缺回复时可能一直等。其delay_ms为自定义忙循环，标称值不当作已测得精密毫秒。

源码：[驱动](https://github.com/Ycn115/enginer-train/blob/8f2f08e42ac95fafdfdb0e51af525893c98ff47b/Drivers/Hardware/Emm_V5.c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)、[四轮发送及位置读取](https://github.com/Ycn115/enginer-train/blob/8f2f08e42ac95fafdfdb0e51af525893c98ff47b/Drivers/Hardware/move.c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)、[USART1 IDLE](https://github.com/Ycn115/enginer-train/blob/8f2f08e42ac95fafdfdb0e51af525893c98ff47b/Core/Src/stm32f4xx_it.c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)。

### GX-Intelligent-Logistics-Silver：2025物流搬运，STM32F103/USART1

固定版本`c6359fbadc494e281ec3154aabb898b69419deeb`。`Core/wc/Motor.c`的Motor_pos顺序发各电机位置命令，每次调用后HAL_Delay(5)，最后触发同步，再按距离估算等待运动时间。`Core/wc/bjdj.c`的底层位置函数仅组帧后HAL_UART_Transmit_IT，没有等待匹配ACK。所查main.c的USART1接收回调中重新启动接收语句被注释，定位反馈另走USART3；不能把它归类为“完整电机回复后等5 ms”，也不能用它是否打印错误判断链路是否没有NE。

源码：[5 ms调用间隔](https://github.com/liaojingwu20041031/GX-Intelligent-Logistics-Silver/blob/c6359fbadc494e281ec3154aabb898b69419deeb/Core/wc/Motor.c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)、[位置发送](https://github.com/liaojingwu20041031/GX-Intelligent-Logistics-Silver/blob/c6359fbadc494e281ec3154aabb898b69419deeb/Core/wc/bjdj.c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)、[接收回调](https://github.com/liaojingwu20041031/GX-Intelligent-Logistics-Silver/blob/c6359fbadc494e281ec3154aabb898b69419deeb/Core/Src/main.c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)。

### 与本项目2 ms及Both的关系

这两套实际UART电机路径都留有等待/间隔，未发现与本项目完全相同的“统一按地址、功能、长度、期限取得匹配回复，再非阻塞等待2 ms”的机制。因此，“回复后等待”有同类工程依据，具体2 ms不是从这两个项目照搬的统一标准。不能从这两套样本推广所有参赛代码，也没有获得它们实车无NE的证据。本项目的2 ms是普通报文交接；短时RX重启、整条总线停车/静默/逐电机验证是另外的流程。

Both是驱动Response选项，表示控制动作同时启用“接收确认”和“完成通知”：例如7号位置命令正确受理后返回`07 FD 02 6B`，以后到位再主动返回`07 FD 9F 6B`。Receive只返回受理确认，Reached只返回完成通知；读取速度/位置的正常数据回复不等于这两阶段动作通知。官方解释见[厂商Emm V5说明](https://blog.csdn.net/zhangdatou666/article/details/132644047)。

本项目当前代码固定机构位置动作准备Both并读回，动态X前瞻准备Receive以减少连续9F；四轮保持既有Receive约定。它使固定动作能利用主动到位反馈，也使返回线上可能出现与当前查询无关的异步通知；当前纯查询两次NE仍不能直接归因于Both。这里描述源码准备规则，不冒充所有驱动此刻RAM模式已重新读回。

公开源码副本、固定提交及SHA256清单位于`.embeddedskills/open-source-uart-review-20261016/`；只作静态实现对照，没有运行外部项目或更改本车收发策略。

## 指定工程复核：GongXun2025与39汐的步进链路

用户提供工程链接清单，指定核对GongXun2025及“39夕”（清单对应39汐/Thirtynine3939）。本轮只分析源码及更新索引，没有发送串口命令、运行参赛程序、改固件或烧录。固定版本分别为GongXun `19cb6a69ba3580465f58ab9f204dbaf33878c969`、39汐 `f1fbab3605f4941fdc14a13d9380aa48700a4b87`。

通过公开仓库树的Git blob指纹，确认本地GongXun `Hardware/StepMotor.c`、`CarBody/Chassis.c`及`Start/system_stm32f4xx.c`与固定版本逐字节一致，未据此认证整个本地资料目录。39汐既有`Chassis_v2.0.zip`共12781953字节，其Git blob为`55c2d5561a3f57145de72e8997e8b61bf1e338eb`，与固定提交一致；直接从此包读取motor/car/Timer/task，不执行或解压运行程序。上位机ZDT.py在初赛、决赛中的blob相同，为`95f87c5d7807af1c4b6a3144663e1eeb23e8c7cc`，另分别核对两版robocal.py及既有task.py的文件归属。两仓库根目录未见明确许可证，不复制进主车活动代码。

### GongXun2025：USART1只发命令，TIM6轮流发送

`StepMotor_HardwareInit`仅配置PA9/USART1-TX，模式为USART_Mode_Tx，115200/8N1；没有在该步进口启用RX。`Chassis_InverseMotionControl`只更新各轮目标缓存，`StepMotor_SetSpeed`标记修改；TIM6回调`StepMotor_Callack`使用6个槽，分别安排四轮同步速度命令、广播FF同步及5号机构的位置命令。准确地说，设置函数未再次调用、_Flag维持1时跳过对应更新；设置函数即使写入相同数值也会把_Flag置0，这不是真正的同值去重。广播同步槽仍执行。代码注释描述默认1.5 ms定时槽，本轮未实测其板上节奏。

`StepMotor_DMAReset`等待的是DMA搬运完成标志TCIF7，然后重装发送计数，不是等待驱动ACK或9F，更不能把DMA搬完等同于电机动作完成。因此该步进链路不匹配电机受理回复、不轮询轮速度/位置、不处理Both主动通知，也没有“完整电机应答后再等待2 ms”。源码不接收并不证明驱动RAM里已关闭应答；本轮没有推断其实体Response配置或实车不存在噪声。

来源：[StepMotor.c](https://github.com/zpclyn/GongXun2025/blob/19cb6a69ba3580465f58ab9f204dbaf33878c969/控制代码/Hardware/StepMotor.c)、[Chassis.c](https://github.com/zpclyn/GongXun2025/blob/19cb6a69ba3580465f58ab9f204dbaf33878c969/控制代码/CarBody/Chassis.c)。本工程内的Mecanum.c还存在其他电机类型参考，不能与这条实际步进链混读。

### 39汐底盘：定时器STEP脉冲与GPIO方向

认证源码包内`Drive/Source/car.c`将车体速度换算为四轮RPM，再分别调用MotorA/B/C/D_Move。`motor.c`设置方向GPIO，修改各定时器ARR/CCR改变STEP脉冲频率，速度接近0时关闭对应定时器。四轮分别用TIM13、TIM14、TIM3、TIM2输出脉冲；这条底盘电机控制链不发送UART F6/FD，不需要逐台等串口应答或处理Both。上位机与STM32之间存在串口通信，不应把该车体通信等同于步进电机UART控制。

来源：[固定提交的下位机源码包](https://github.com/Thirtynine3939/2025GongChuang_AGV/blob/f1fbab3605f4941fdc14a13d9380aa48700a4b87/程序/下位机/Chassis_v2.0.zip)。不能把“39汐底盘用脉冲”扩大为其整个项目没有UART步进控制。

### 39汐机械臂：上位机UART、固定2/3 ms发送间隔与按需Reached

上位机ZDT.py通过115200串口直接发送机械臂步进命令；ser_lock只保护每次串口读/写，不覆盖整笔发送到匹配应答的事务。Emm_V5_Pos_Control组FD帧后se.write即返回，没有等待02受理确认。robocal.py的关节/空间固定位置路径通常每台位置命令后sleep(0.003)，三台命令的snF=1，然后发广播FF同步；连续插补的Move路径逐台位置目标后sleep(0.002)，初赛、决赛都能找到这条2 ms路径。它是提交写入后的Python休眠，受系统调度和串口缓存影响，不是本项目“收到完整匹配回复后再交接2 ms”。

决赛task.py后台约每10 ms调用ZDT.Receive，解析FD/9F/6B主动到位及32脉冲数据，并通过Reached_Flag推进任务。Emm_V5_Reached_En写配置中的应答字段为0x02或0x00，即按需Reached/None，非固定Both=0x03；任务在关键动作前启用通知并给配置间隔，完成后再禁用。所查Receive对到位使用全局标志，未核验该9F的电机ID，不能把它等同本项目完整事务/单动作确认。其应答开关写的是整份参数常量，不能只取其函数名字直接移植覆盖本车已核对配置。

来源：[决赛robocal.py](https://github.com/Thirtynine3939/2025GongChuang_AGV/blob/f1fbab3605f4941fdc14a13d9380aa48700a4b87/程序/上位机/国赛决赛/robocal.py#L345)、[共用ZDT.py](https://github.com/Thirtynine3939/2025GongChuang_AGV/blob/f1fbab3605f4941fdc14a13d9380aa48700a4b87/程序/上位机/国赛决赛/ZDT.py#L28)、[决赛task.py](https://github.com/Thirtynine3939/2025GongChuang_AGV/blob/f1fbab3605f4941fdc14a13d9380aa48700a4b87/程序/上位机/国赛决赛/task.py#L62)。

本轮结论：GongXun采用只发的定时UART步进链，39汐底盘走脉冲、机械臂另走UART且有2/3 ms固定发送休眠；它们没有与本车完全相同的逐笔匹配/短时接收恢复/真实停车取证链路。可借鉴缓存与任务组织，不能凭它们没有NE告警推定本车检查应取消，也不能将两种“2 ms”视为同一时序。分析副本、Git blob认证及提交清单位于`.embeddedskills/open-source-uart-review-20261016/gongxun-39xi-evidence.json`。

### GongXun多机协同的进一步说明

用户继续要求详细解释GongXun的多机协同。`Chassis_SetSpeed`先用当前航向做坐标转换，并以HWT101角度计算航向PID，再由`Chassis_InverseMotionControl`把平移、旋转合成四轮目标。四轮编号为左前1、左后2、右后3、右前4。上层循环中的Delay_ms(2)控制规划更新步长，不表示每2 ms已经给四轮各发送并生效一条命令。

该设计有两层独立缓存：MCU的StepMotor_Target保存当前目标；驱动器的同步缓存保存已收到且Sync=1的F6目标。TIM6六槽按循环位置0～5依次安排ID1、2、3、4、广播FF和ID5；实际Count在switch前先自增，初始第一次进入case1，六槽表只作为稳态循环理解。四轮F6均带Sync=1、驱动加速度0，在FF前先存到驱动，收到广播00FF666B后统一应用。MCU的_Flag在派发前置1，仅代表软件认为已安排发送，不是电机ACK、速度到达或停稳凭据。

按TIM6的ARR=41、PSC=1499及源码注明的42 MHz定时器输入，理论槽长1.5 ms，一轮9 ms，四轮同步触发理论上约111次/秒；这是静态时钟推算，实际还受中断/等待影响。115200/8N1下，4/8/13字节线速时间分别约0.347/0.694/1.128 ms，普通报文能放进标称1.5 ms槽，不代表驱动已经处理、回包或机械动作完成。

5号为升降机构。Arm_ArmSetExt把高度场景换成绝对位置脉冲，更新第5份目标；该槽FD以Mode=1、Sync=0发送，收到即按驱动位置模式执行，不等待四轮的FF。底盘运行时可以在自己的槽更新升降目标；爪、Yaw和料盘等舵机由其他PWM/定时器链路处理，不是全部机构都挤进这5份步进缓存。

源码可确认的边界：四轮目标没有在每轮发送前冻结为一个不可变快照，而是在各槽读取最新目标；上层在六槽期间改写目标时，各轮可能来自相邻计算时刻。同步标志保证驱动应用其已缓存目标的共同触发，不保证四个目标来自同一次计算，也不证明每条命令已成功收到。该步进口无RX，因此没有逐笔回复/位置读回/到位通知或NE恢复层。这里是在解释其实现与边界，不据此断言其比赛失稳，也不将它视为本车可直接取消反馈确认的依据。

上述解释未改参考代码或主车固件。5号机构出处：[Arm.c](https://github.com/zpclyn/GongXun2025/blob/19cb6a69ba3580465f58ab9f204dbaf33878c969/控制代码/CarBody/Arm.c#L210)；定时器入口为本地`User/isr.c`的TIM6_DAC_IRQHandler。

## 主动查询调度优化第一版

用户授权先保留现有200 ms实际反馈稳定要求，仅优化主动查询调度。此版没有将ID5～8改成None或Receive，固定位置动作仍按需核对Both，动态X专用Receive、正常9F完成路径和缺通知时的200 ms后备均保留。

三轴查询由每25 ms固定轮转六项改为按位置/状态字段实际年龄选择最超期项：活动且未确认完成的轴各25 ms目标、保持轴150 ms后台目标，提交下限5 ms且单笔在途；短feedback_ms按四分之一收紧目标间隔。后台项按超期程度也能优先，不设置会饿死其他轴的绝对运动优先级。停车与初始姿态补齐本次证据；没有实际读请求受理时不刷新查询时钟。视觉让读遇到全部字段仍新鲜时释放让读标记，避免等待未来查询期限而阻塞已有视觉观测。ID8普通分度/角度/点动运动期间，完整位置/速度/状态组后的空等50→25 ms；组内读取及释放总线、HOME/其他操作50 ms不变。

总线2 ms交接、客户公平性、四轮原子批次、紧急停车、运动目标与速度、到位容差及原200 ms稳定判据均未改变。动态追踪自身调度未修改。本版目标是缩短反馈发现延迟，不代表实车更新率保证或NE/FE根因修复。

验证：新增三轴调度和车仓组调度测试均先在旧代码上观察到预期失败，再在新代码通过。三轴离线端点即时回复模型中，单活动Z的位置/状态最大更新间隔45/45 ms（38/38次每秒），保持X为6/6次每秒；三轴并行六字段最大间隔30/30/35/40/45/50 ms。该数据不包含真实电机和实车总线延迟。测试覆盖后台公平、在途互斥、停车证据、短反馈有效期、tick回绕、视觉让读及200 ms不得提前完成。真实MotorBus调度代码保留生产2 ms交接、机械臂5 ms提交压力及四轮16 ms请求压力下，15秒低速车仓动作完成，机械臂2778、四轮927笔回复保持在原2秒有效期内；未向实车发送此压力测试。

本次18项扩展回归中15项通过；三项既有失败单独保留：grab_raw_handoff_test调用旧双参数GrabTask_Start导致编译失败；grab_mission_pause_test在第25行旧排队状态断言失败；turntable_test第54行未模拟后续模式准备配置报文。这三项在本次修改前HEAD源码上有相同失败，不改生产逻辑迁就夹具，也不宣称完整回归全绿。grab_static_frame_test曾揭示本次让读回归，修正后通过；其旧版对照原本通过。

构建：2026-10-16 19:02，Keil MDK工程Code/template/MDK-ARM/template.uvprojx、Target template编译0错误/0警告；ROM338260字节、RAM196016字节。AGENTS、主车README、比赛约定与机械臂协议已同步本版边界。原始结果在.embeddedskills/tests/feedback-schedule-full.log、feedback-schedule-results.json及.embeddedskills/feedback-schedule-20261016/baseline-results.json。

查询调度版下载状态：2026-10-16 19:05，以既有CMSIS-DAP 7b168f48、SWD100 kHz及主车stm32f4x配置探测；OpenOCD识别到该探针，但报CMSIS-DAP command CMD_INFO failed，尚未建立SWD目标识别，未执行烧录。已保留HEX（SHA256 f188505a92b61035ce059535f755ad9ff993dba17cc5b18a3ce51aaafeb3cb46）及探测日志（.embeddedskills/feedback-schedule-20261016/）。实车更新间隔、正常取放连续性及整场比赛仍待验收。

## 底盘None动作应答版本

### 视觉恢复保流修复

用户授权修复“停车期间视觉已恢复仍重发识别”，同时确认原短暂漏检应按此前目标/方向继续调整。本版保留已有未提交的None底盘及查询调度修改，只改静态视觉恢复决策和停车原因显示，不修改香橙派源码、远端部署、J、速度、容差或200 ms稳定参数。

实现：vision_pause_process在停车验证前检查原请求、暂停后收到且未过新鲜窗口的同目标有效B2；有效流已恢复则取消RecoveryRestartPending并保留原流，不再无必要重发B2/0A。新鲜窗口为min(age_ms,loss_grace_ms)，宽限0时保流检查使用100 ms但运动仍保持无宽限停车语义；优先采用ReceivedTick，缺接收时刻兼容Data.Tick。保流不等于完成：恢复仍核对真实停车，恢复起点后3次不同新观测才返回ALIGN；排队到停稳后才解析的旧USB报文不能计数。有效流再持续丢失仍可重发，USB BUSY重试与重发共用原12秒窗口，不重置RecoveryTick。

短暂漏检控制未改：有合格高位J及共同时间实测基线时继续有限剩余目标，不能沿旧方向无界积分；无基线时沿原趋势减速、使用默认250 ms宽限。接近窗口、新坐标误差方向变化或宽限耗尽仍可停车。原日志这次进入vision_pause_stopping时loss_ms=59、vision=Ok，不能将它解释为已等满250 ms；旧日志未记录恢复帧DX/DY或具体触发条件。本版增加vision_gap_expired、vision_pause_near_window、vision_pause_direction_change原因及中文说明，保持原停止判据，以便区分宽限耗尽与新观测触发停车。

验证：新增grab_recovery_stream_test先在旧代码上观察到预期失败，再验证恢复流保留、停车过程中恢复、旧缓存不计数、3次新观测、实际接收时刻/请求/暂停边界、陈旧及错误目标、真正持续失联仍重发、BUSY待办被有效流取消、0宽限、tick回绕与原恢复期限。27项None/取放专项通过；另行运行grab_grace_test与grab_measured_alignment_test，验证单次漏检沿趋势减速和超过宽限仍可按实测有限目标继续、旧误差不重复补走。新增恢复流专项也在最终日志原因调整后重跑。网页准备与终端格式54项通过。日志在.embeddedskills/vision-stream-recovery-20261016/host-regression-final.log、host-core-final.log、web.log。没有运行实车运动测试，未宣称整场通过。

AGENTS、比赛约定、机械臂协议、B2协议、主车README及网页原因文本已同步保流/停稳/续调边界；此前历史分析保留，不把新修复追写为旧版已实现。

视觉保流修复构建状态：北京时间2026-10-16T21:06:13+08:00，Keil主车template工程/Target template，0错误/0警告；ROM339180字节、RAM196016字节。结构化结果见.embeddedskills/vision-stream-recovery-20261016/keil-build.json。

视觉保流版下载状态：2026-10-16T21:09:15+08:00，已确认DAP 7b168f48 / SWD100 kHz探测未通过（CMSIS-DAP command CMD_INFO failed），未执行烧录；HEX SHA256=e7284d68ce19fd501df31e15084cfc3236001f2b804e96fdb04987f24f4bf91e，产物及日志在.embeddedskills/vision-stream-recovery-20261016/。视觉保流及整场实车效果尚未验收。

### 视觉保流修改交付后审查

本轮按用户要求仅审查与离线验证，未发送实车命令、连接探针、复位、编译固件或烧录。对照本次修改前备份审查差异，并独立核对Camera真实接收时间、暂停/请求边界、停车证据、恢复帧计数及重发期限，未发现本次保流修改新增的可证实代码问题。固件7项源码/工程清单哈希均与上次交付manifest一致，本轮未修改固件。

本轮重新运行27项None/机构/恢复专项、grab_grace_test、grab_measured_alignment_test及54项网页准备/终端格式测试，全部通过；按CRLF行尾规则执行diff空白检查通过。上述软件结果不代替实车视觉、整场任务或链路验收。

文档检查发现B2协议旧正文仍称“耗尽宽限、误差反向或关闭宽限后停车始终重发”，与新保流分支冲突，已修正为待重发可由同请求、暂停后收到的新鲜有效流取消；补明无合格实测基线才进入原减速宽限路径及新增停车原因。同时同步网页视觉任务手册，并将AGENTS/比赛约定的“原12秒窗口”明确为可配置vision_wait_ms（默认12秒），不改变参数。历史构建与下载记录保留原事实。结构化审查结果见.embeddedskills/vision-stream-recovery-20261016/review-result.json。

### 20:36暂存区1号环失去视觉坐标的日志分析

#### 完整新日志复核：已恢复视觉仍被强制重启

后续用户追问具体定位时，检查Downloads同名前缀文件发现console (1)/(2)/(3).txt为本轮新导出；项目原始20261016-032050-d35ca5.jsonl也已更新至20:36:47。以下结论补充前次只检查无后缀旧文件和粘贴片段的证据边界，不把先前推断当作完整日志结论。

关键顺序：20:36:33.605视觉停车刚发起时，快照已经vision=Ok、rx_seq=749、age=1；20:36:34.460停车已确认，仍vision=Ok、rx_seq=776、age=31。随后20:36:34.755仍执行vision_reacquire_wait，快照被清为vision=Wait、rx_seq=0；之后每秒vision=Lost直到恢复窗口超时。GrabTask_StatusGet在超过age_ms时应报告Stale，只有最近仍收到匹配当前目标的报文而目标无效时报告Lost；因此完整日志已能排除“完全断流或始终只发其他目标”作为这段持续Lost的单独解释。

确定的MCU代码问题：vision_pause_begin(false)置RecoveryRestartPending；停车期间即使原目标有效坐标已恢复，vision_pause_process在停稳后仍先执行该重发分支，未按已恢复的同目标新鲜数据取消重发。Camera_RequestStart又清掉本地快照。该路径已用当前实际GrabTask.c离线复现：构造停稳、有效1号环seq776/age31ms及待重发状态，函数仍重发一次B2/0A并清空有效数据；复现源位于.embeddedskills/chassis-none-20261016/recovered_stream_restart_repro.c，没有修改活动控制代码。

本地视觉对应副作用同样复现：USB解析对重复0A仍递增command_version，activate_command调用set_digit并_reset_tracking，把已锁定ring_refine重置为digit_coarse/unlocked。原先稳定跟踪圆环的能力因此丢失，又要求重新通过数字1粗识别。这与本轮“坐标已恢复→重发→持续无效”的顺序相符；是否被具体数字/圆组阈值拒绝，仍需要实机图像或远端阶段日志，不能仅凭MCU报文锁定某个图像阈值。已确认的修复目标是取消已恢复流的无必要重发；恢复仍应核验停稳后的新观测，不能复用旧值宣布完成。

新日志还包含8条OK bus first文本，其中6条字段完整，均为35/36/3A读取超时；另2条串行文本受损（其中1条仍可辨3号/36）。没有从这些可读首次故障中发现F6动作ACK超时，不能把累计bus_recoveries=16等同16个完整独立根因。视觉重启证据已保存为.embeddedskills/chassis-none-20261016/ring-restart-evidence.json。本轮没有发送实车命令、复位、烧录、部署视觉程序或修改活动控制代码。

用户粘贴本轮20:36:32～47日志，并确认停车后香橙派画面里1号环完整可见。本轮仅分析源码及现有文件，不发送串口、修改控制代码、编译、烧录或部署视觉程序。附件路径Downloads/serial-20261016-032050-d35ca5-console.txt实际为旧文件，SHA256=4cb62147c8f4ca4a076bb99aa5eb7bdcca921736afd4bacd25ba2fe9e7d61c0f，最后时间2026-10-16T01:36:46.482893+00:00即北京时间09:36:46，没有20:36这轮内容；不能用它统计本轮16次恢复的具体原因。

直接退出链：目标color=10即B2/0A编号环1；有效误差由-91/-82经-45/-53到-13/-26，尚未达到默认±1px完成窗口。短暂漏检先恢复，20:36:33进入视觉停车，34确认停稳并重发目标请求；35～45秒摘要持续valid=0，46以vision_recover_timeout退出，匹配默认vision_wait_ms=12000恢复窗口。没有本件aligned/capture/picked完成证据，不应解释成已对准后取仓卡死。识别重发成功后RecoveryRestartPending已清除，重复显示vision_reacquire_wait不等于每秒重发或反复重置视觉。

诊断限制：camera_status_write的VISION RX是按Camera快照生成的周期摘要，valid=0既可表示已收到合法Valid=0，也可表示重发后尚无匹配有效坐标或目标不匹配，不能当作一秒一帧真实无效报文。须以camera status中的frame/current_valid/target_valid、rx_bytes、invalid_reports、frame_age_ms、checksum_errors及原始B2目标字节区分：视觉持续判失效、视觉未恢复发送、仍发其他目标或解析错误。用户确认完整可见后，不直接归因车位不够靠近或目标出视野。本地combined_color_digit_ring.py在误差各≤20px并连续3帧时从digit_coarse切到ring_refine，精定位要求圆组跟踪确认；这可解释接近准心后的有效性变化，属于待远端实际版本/阶段日志核对的假设，不能直接判定本次就是此路径。本地README仍明确远端版本未由本轮SSH核对。

旧像素有限目标只在高位、姿态/参考及视觉时刻实测插值基线成立时继续剩余移动；预计到位仍等待新视觉，进入视觉停车后不能凭旧值完成保存/取仓。粘贴片段没有足够有限目标/实测基线信息，不能判定其未接管的具体原因，也不能用延长12秒或强行下降代替查明坐标失效。

末尾UART5 NE发生20:36:47，晚于46秒视觉超时，tasks_interrupted=0；当前TX=043A6B为4号状态查询，不是F6动作ACK。DMA64字节、cursor57/ndtr6，未转交区间仅[57,58)，为FF；其余为历史缓冲，不是本次64字节坏帧。它表明查询侧噪声问题仍存在，但本片段不能证明它触发这次12秒视觉等待；bus_recoveries=16和rx_restart count=89也不能当作16/89个独立根因。

用户明确接受取消底盘逐条动作受理ACK，要求以实际运动观察和原反馈继续测试。此版将底盘ID1～4默认策略改为None，不关闭位置、速度、状态及参数查询；ID5～8固定Both和动态X Receive保持。保留此前查询调度修改，不处理本轮视频分析发现的右上角制动/换向速度谷，也不修改相机camera_tx退出路径。

### None版扫码离站审查

2026-10-16用户要求审查二维码驶出是否仍会故障；本轮仅源码审查、离线测试和记录，不发送实车命令、不复位、不编译主车或烧录。核对当前产物manifest后，所列固件源码与上一轮构建一致，HEX SHA256仍为fce24dad7cbad6c1d32f0d9930e86e84d9f76278822d48ac546671d77fb694eb。

代码发现：扫码离站仍将QrDepartStart机构恢复与WorkResume底盘平移并行；四轮运动必须先通过None模式完整读回核验，F6及FF均按TX完成推进，总线也不会重新自动补ACK等待，无回复时按TX完成2 ms交接。未发现该范围内会将None四轮重新纳入F6/FF受理回复超时的遗漏。不能据此断言整段无故障：第一次准备模式的42/48、四轮35/36/3A/3B及Base/Z/X控制仍需要回复，查询/机构缺回复、DMA或驱动故障仍可能进入恢复；参数已缓存时并非每次离开二维码都重新写驱动。右上角速度谷与到原料台后camera_tx退出是此前已确认、未在None版修复的独立问题。

验证结果：重新运行26项None专项通过。新增忽略目录中的扫码离站混合事务审查夹具，直接编译当前MotorBus与Mecanum源码：None四轮320条F6、339次实际匹配查询、21条模拟Base异步9F交错，无误锁/误恢复并完成停车发送；另外故意让Base FD既无受理ACK也无到位通知，正确保留5号/FD/reply_timeout故障，证明None仅作用于底盘，不会吞掉真实机构失联。该模型没有模拟共享返回线的模拟波形、电机负载或完整物理定位，不能证明实车不会丢查询。夹具和结果在.embeddedskills/chassis-none-20261016/qr_departure_audit.py、qr-departure-audit.json及review-host.log。

文档核对：AGENTS、比赛约定、系统协议与README均区分None动作发送与真实查询/停车确认；本次补充该边界及实车未验收状态，不改变控制规则。None版上轮DAP探测失败，不能仅凭现有历史报文确认实车已更新；若新故障仍报ID1～4 F6/FF reply_timeout，应先核对实际固件和当前选择策略，不能先归咎于线路。

首次待发运动批次之前，底盘对四驱动完整读取33字节配置，必要时只RAM改Response=0并完整读回核对，保留其他字段及原保存值；全部准备好才发实际批次。缓存内部使用mode+1表示已知值，避免None=0与未知/未请求混淆。Receive显式兼容入口同样核对实际模式；选择策略不等于驱动已配置完成，任务ack=1/2分别表示None/Receive策略。

总线不再给None轮电机的控制帧自动补ACK等待，四轮F6/FD及FF同步按TX完成推进，tx_complete不冒充acknowledged。没有动作回复时从TX完成起计2 ms交接，再发后续普通运动或查询；同步批次、去重、最新目标覆盖及客户公平性保留。None FE/9C不建立缺ACK排空；恢复零速缓存和同步同样TX推进，仍完成实际健康、速度与状态检查才能解除。软件选回Receive但驱动已观测为None、尚未重新配置时，停车仍按实际None处理，避免虚假stop_drain_timeout。42/48参数事务、读取期限、3A一次补读、NE/FE/ORE接收恢复及真实驱动故障保持原规则。

固定取放、动态追踪、rehome及人工回零接受None底盘，但原参考、新鲜反馈、机构/底盘停稳和200 ms机构后备稳定条件未放宽。网页准备识别None，也保留Receive兼容，不在连接、刷新、保存或准备中自动改驱动；仅首次运动前固件完成RAM模式准备。AGENTS、硬件基线、比赛约定、系统/机械臂协议、主车README及网页连接说明同步本版语义。

软件验证：新增真实MotorBus+Mecanum联合测试先在旧默认Receive上失败，改后模拟四轮从Receive完整切到None；驱动不返回运动ACK，实际发送间隔断言2 ms，完成运动、查询、NE接收恢复、FE停车、8电机恢复及恢复后只读复核；故意丢查询回复仍进入真实超时。另覆盖Receive兼容、策略已选Receive但驱动仍None时停车、参数写后验证被停车打断只补读、完整快照不符拒绝及缺查询回复不放行。26项专项全部通过；网页准备13项全部通过，新None测试也先观察失败再修正。之前广泛回归的三项既有夹具/断言失败未在本版整改，不宣称全套回归通过。结果见.embeddedskills/chassis-none-20261016/host-final-verified.log；离线测试未操作实车。

构建：2026-10-16 20:21:28北京时间，Keil MDK Code/template/MDK-ARM/template.uvprojx，Target template，0错误/0警告；ROM338836字节、RAM196016字节。原始结构化构建结果见.embeddedskills/chassis-none-20261016/keil-build.json。本轮不承诺消除NE/FE或所有恢复：控制ACK缺失不再触发F6/FF应答超时，但查询/配置缺失、DMA及驱动故障仍按原流程处理。

底盘None版下载状态：2026-10-16T20:23:53+08:00，已确认DAP 7b168f48 / SWD100 kHz探测未通过（CMSIS-DAP command CMD_INFO failed），未执行烧录；HEX SHA256=fce24dad7cbad6c1d32f0d9930e86e84d9f76278822d48ac546671d77fb694eb，产物及日志在.embeddedskills/chassis-none-20261016/。驱动RAM模式和实车效果尚未验收。

## None实车后剩余故障分析（20:32～20:36）

用户报告取消底盘动作ACK后故障减少，物料台仍有故障但可恢复续行，要求继续分析。用户指定Downloads中的console (1)，随后附console (3)；两文件SHA256相同，均为75634885acd0817ce02608ae01deb6f2bf4aecf54784ce1e1261618ae5aebb7a。保留用户导出副本与原始本地JSONL快照于.embeddedskills/chassis-none-remaining-20261016/，未打开串口或发送命令、未改固件、编译主车、复位或烧录。时间统一按北京时间，不能把日志中的UTC12点误报为本地12点。

本次最后启动为20:32:07，Boot打印BUILD Oct16 20:31:14；20:32:23.568发送grab mission qr1000 100 lower fixed vhigh linear，20:36:46.875以vision_recover_timeout结束。最终station3/visit4、stored6/placed3，说明在多个电机故障后确实继续到暂存区；本轮不排查该终止漏检。bus_recoveries16包括启动前后的恢复及恢复重试，不等同16个已独立定位的首因；恢复阶段5号3B仅收到036B导致的一次超时明确属于恢复失败，不可当作新运动故障。

能够完整解析原因、地址、功能、字节数和hex的首故障有6条，全部是35/36/3A读取超时，未发现其中任何一条仍为F6/FF动作受理ACK超时：

| 北京时间 | 正在等待 | 故障接收样本 | 事实边界 |
|---|---|---|---|
|20:33:12|ID4速度35|06FD9F7F|类似Z到位通知，尾字节损坏|
|20:33:25|ID7位置36|06FF9F6B|类似Z到位通知，功能字节不符|
|20:34:04|ID6状态3A|07FD9F6B|合法X到位通知，不能代替Z状态回复|
|20:34:28|ID2位置36|06FD9F6B0017D4436B|合法Z到位通知加残片，不能组成ID2完整位置回复|
|20:34:53|ID3速度35|036B|只有残片|
|20:34:58|ID3速度35|033500000160|速度帧尾非6B|

有4/6完整首故障的等待窗口出现机构到位通知或相似坏帧，支持优先做取消机构主动9F的对照；仍不能仅凭共现证明电气碰撞。另有多份首故障行被截断/拼接，保留缺失，不猜补为完整证据。

按IRQ快照的DMA游标与NDTR，仅计算尚未转交区间，获得26份字段齐全快照，其中19份新增区间只有FF；17份处于active1/wait0，另有空闲FE快照新增B6。这说明还存在与机构到位通知不能直接等同的发送交接/信号异常。不能把64字节DMA历史全当作当前收帧，也不能因uart_error为0就否定其他快照里的硬件NE/FE。打印到48条接收重启告警，其中40条NE、7条FE、1条NE|FE；这些不是48次整车任务中断。

验证：对当前生产motor_bus.c离线回放上述6种实际样本，均不能完成对应查询，按原100 ms期限超时；每种坏样本后在期限内追加完整合法目标回复时均正常完成，12个场景通过。说明这6段接收样本本身缺少所需合法回复，不能靠把9F当查询ACK或放宽坏帧匹配解决；此实验不定位字节是在驱动、线路、DMA还是恢复边界丢失。当前P025非法符号缺口仍单独待修，本轮没有抓到其合成重复35场景的现场证据，不能把P025冒充主因。

下一版建议先保持底盘None和现有查询调度/2ms交接，只将ID5～8固定位置动作Both改为Receive以取消主动9F；受理ACK保留，完成改用既有新鲜位置/状态及200ms稳定条件，晚到旧9F不能绕过该条件。当前运行规则仍要求机构Both，本轮只提出有日志依据的候选，未修改规则或源码。若取消9F后仍有发送时单FF，沿已有单ID只读复现条件分别对比普通交接余量，再考虑同一时基TX/RX波形，不先假定驱动或线束损坏。

## 机构Receive与反馈确认的时序方案分析

用户已决定下一版固定机构动作采用Receive+实际反馈确认到位，但本轮明确先分析旧用法及如何节省时间，因此未改控制代码、驱动配置、主车编译、下载或实车。本轮模型只读取并抽取bc13310和当时最新GrabTask的实际轮询/到位函数，不覆盖其他对话正在修改的恢复等代码。

旧版bc13310普通轴到位先经过axis_quiet的stable_ms=200，再在缺驱动到位位时进入arrival_hold_ms=500后备；六项轮询至少25ms一项，同轴周期约150ms，并且旧X/Z40ms周期重发调速也共享接口。不能将200+500套到所有旧动作：Base、Z最高点或驱动已到位位有效且位置合格时有提前分支，只需先满足axis_quiet。当前arrival_hold_ms默认已200，axis_stable_arrival不再先等另一份axis_quiet200，活动轴字段目标25ms、总提交5ms；固定X/Z也已取消40ms周期重发。

当前还有明确的并行确认问题：取仓GRAB_LIFT同时发送Z抬升与X30mm避让后，以if(!arrived(1,now)||!arrived(0,now))汇合；arrived维护计时状态，逻辑短路会使X在Z完成前不启动后备稳定计时。Receive没有9F快路径后，这会使两个已经并行到位的轴重复串行等稳定窗口。优化应让已启动的每轴独立更新证据，汇合仅读取各自结果；初版保留200ms，不为此改变机械避让顺序或新增中央调度体系。

离线时序模型：物理轴在t0已停止于目标，首份缓存仍是运动前位置，真实位置/状态查询函数即时回复；没有驱动9F或查询到位位、没有UART排队或旧速度曲线IO。抽取原始函数编译运行，结果：旧Z后备500确认1000ms；仅把旧保持改200仍700ms；旧Base提前分支475ms；当前单Z保持200确认270ms；当前X/Z短路汇合515ms；同一当前函数改为两轴每轮均求值295ms。结果仅说明算法额外等待，不是动作全程耗时或实车更新率保证。源码快照、哈希、生成夹具和结果见.embeddedskills/receive-arrival-analysis-20261016/compare.py及results.json。

建议下一版：固定Base/Z/X/ID8统一Receive，动态X继续Receive，消除X在追踪/固定动作间Receive↔Both的反复完整读改验；受理ACK只释放发送占用，实际运动与其他轴/底盘并行。每轴/每动作独立积累200ms新鲜实测证据，已确认且同目标未发生新运动/停车/参考变化时复用；移交阶段不重发同目标或重新完整计时。车仓保留自身25ms完整反馈组和独立200ms窗口，允许与已有合法Z/X动作并行累计，Base回仓前仍等ID8。连续视觉X目标不因每次FD受理而阻塞200ms，200ms只用于需要完成判定的有限目标。夹爪闭合/车仓防碰等待及真实停车、HOME、视觉完成等各自条件保持。

切换同时必须禁止晚到旧9F在Receive任务中绕过实际反馈确认，不能只改驱动参数而保留无条件9F完成捷径。实现时应加入每动作一次的TX完成、首次入窗、静止证据起点、确认与下阶段受理时间，分别评估物理运动、查询发现、稳定及交接耗时。先优化重复等待与并行计时；如实车仍慢，再单独评估依赖新鲜到位状态/位置/实际速度的快速路径，不在首版降低200ms或放宽容差。注意相邻位置差分速度随采样变快对微抖更敏感，计时重置应有实际证据，后续用实机数据判断，不凭模型放宽静止标准。

本轮日志已显示Z33次、Base3次、X2次走200ms实际反馈后备；这些动作在Both版中已经等待过该窗口，不应在Receive版再追加另一份。用户的新Receive目标已记录为待实施，不能将本轮分析或离线模型当作已部署Receive固件。

## 机构Receive与独立反馈到位第一版

用户本轮批准五点方案后实施：固定Base/Z/X/ID8统一Receive，动态X同模式；仅RAM保存应答配置，完整保留和读回其他参数，HOME不预读此配置。02 ACK后立即交还调度，普通2 ms线路交接保留；100 ms仍只是缺回复期限。普通固定路径不再接受9F代替ACK/到位，显式Both兼容接口保留，但常规入口不请求它。

X/Z/Base随各自新位置/状态回调独立累计arrival_hold_ms，默认及下限保持200 ms；真实静止、目标容差、原命令TX时间及反馈连续性都核验。汇合点不再导致第二根轴延后起计。有效同目标可跨阶段复用；新运动、停车、参考变化、失鲜或漂移撤销相应证据。连续视觉X仍可在ACK后更新下一个目标，不逐条等200 ms。ID8分度/角度/点动按完整新鲜位置、速度、状态组累计stable_ms默认200 ms，三字段时间都跨过窗口；反馈断档不能以墙钟时间充当稳定。同目标确认有效时角度/仓2/3不重发，仓1显式HOME仍独立执行；只读验证仅在原同目标证据仍有效时省掉重计，其他情况重新测量稳定。

X/Z避让并行、Z先抬再收X、Base回仓前等ID8、夹爪2120/1920/2450 μs及300 ms等待保持；网页参数名更新为“机构到位稳定时间”，数值范围和显式应用方式保持。此次实现不代表已消除UART5 NE/FE或物理回复竞争。

验证状态：本轮机构专项29/30项通过，网页参数6/6项通过；剩余grab_mission_pause_test失败于旧NextTrack待办姿态断言，已用本轮修改前源码快照复现同一失败。grab_raw_handoff_test的旧双参接口已修正为当前单参接口并通过。Keil主车template于2026-10-16 21:52:57编译完成，0错误0警告，ROM339652字节、RAM196016字节。全量入口run_firmware_tests.py已执行，被既有station_heading_competition_test编译错误（legacy_station_heading_main缺少return，-Werror=return-type）阻断。另行运行的grab_task_test与grab_transfer_test仍失败于旧视觉重识别断言；使用本轮修改前GrabTask源码快照复现了同一失败，基线证据保存在.embeddedskills/mechanism-receive-20261016/baseline-tests/results.json。本轮保留其他对话已加入的视觉恢复流修改，不将这两个旧夹具结果记为通过。

机构Receive版下载状态：2026-10-16T21:53:52+08:00，已确认DAP 7b168f48 / SWD100 kHz探测未通过（CMSIS-DAP command CMD_INFO failed），未执行烧录；HEX SHA256=6950ab127490074507e4e18977b3ad4457281cb3c53db2d112fdd813e1511620，产物及日志在.embeddedskills/mechanism-receive-20261016/。驱动RAM模式和实车效果尚未验收。
