doinbest/Yachiyo/xjx/模版搭建/docs/开发记录/2026-10-17-加工与暂存旧故障覆盖审查.md

# 加工与暂存旧故障覆盖审查

2026-10-17。用户要求检查后续加工区和暂存区是否仍存在此前多个卡住问题。本轮审查当前工作区源码，未修改运行代码，未编译Keil主车固件、未烧录/复位/发送实车命令。

## 代码发现

未发现可确认的旧缺陷在四个工位分支复发的生产问题。两路独立只读审查分别检查静态视觉和机械/比赛衔接，结论一致。不是实车可靠性或固件部署保证。

| 分支 | 已检查的关键路径 |
| --- | --- |
| 加工空爪放置 | 编号环预识别→新鲜在窗/停稳→快照→取仓→首件X30后Base和ID8+90并行→恢复保存X→ID8到位后连续下降释放 |
| 加工物料取回 | 物料颜色对准→固定目标下降闭爪；前两件提前选仓；第三件270°预避让，抬Z后回180°入仓，绝对目标暂停后保持 |
| 暂存第一层 | 空爪编号环对准保存，再取仓放置；持料阶段不重新请求被遮挡的视觉 |
| 暂存第二层 | 物理环按FirstRing[color]定位，视觉按同色物料对准；保存第二层绝对高度后再取仓、恢复并释放 |

共用检查包括：USB重发前原子保留已恢复识别和待解析输入；混合无效后新有效帧及旧漏检计时结束；高位有限目标仅扣实测剩余位移；准备就绪后新接收坐标接管；正常对准连续静止窗口衔接而停车后仍取新证据；空爪快照另需新帧；ID8纯读取消保持busy和原目标/期限，上层不把它当未完成故障；COMPLETE间隙在途转盘仍被暂停/取消；释放记账与父阶段迁移不产生重复记账窗口。

## 软件验证

11组专项通过：grab_recovery_stream_test、grab_static_preparation_test、grab_processing_continuity_test、grab_first_tray_clearance_test、grab_parallel_transfer_test、grab_alignment_handoff_test、grab_station_align_height_test、grab_mission_pause_test、grab_bus_recovery_test、grab_held_place_test、grab_measured_alignment_test。

当前正式mission_grab_integration_test通过：高/低观察模式各完整两批，12次入仓/12次放置，6次取放暂停及3次并行姿态/路线暂停；也通过独立编号环取仓放置。新增contest_departure_heading_test通过。合计13组工位/比赛专项。

turntable_read_preemption_test默认8个读取抢占场景及missing/motion/home_command/enable_command/save_command/deadline/deadline_dense/stop各场景通过，共16场景。

审查期间，另一对话在工作区加入加工离站航向校正并更新测试替身；初次完整集成在旧替身Begin立即assert HeadingReady处失败。生产StationHeading_Process按原逻辑等待Ready。仅在忽略目录临时替身中验证等待语义，随后当前正式替身也更新为等待，已重新运行正式集成入口通过；没有把临时探针当作正式通过的替代。期间主要运行源码仅看到一处departure_heading_prepare原因回报变化，行为主链已核对。快照/哈希保存在.embeddedskills/analysis/station-review-20261017。

本轮没有宣称全套测试通过；上轮已记录grab_processed_store_test旧255档断言与当前X/Z零档配置不一致，以及motor_bus_test旧171ms断言问题。本轮专项结果不覆盖上述全套回归限制。测试输出追加于.embeddedskills/tests/host-tests.log。

## 文档一致性

此前静态视觉恢复、提前识别、停稳衔接、ID8取消补读、首件/第三件避让约定与当前检查到的主流程一致。

另见当前源码新加入加工两批末件入仓后的DepartureHeadingPending：保持观察姿态校正后，再准备行驶姿态离站。现行比赛约定仍主要描述进站观测、每批末件入仓结束在行驶姿态，缺少此新增例外。该功能来自审查期间另一对话新增，最新用户约定未在本审查对话提供；本轮只登记文档待对齐，不依据源码擅改已确认的规范。相应专项通过不等于实车离站校正验收。

## 边界

结论针对当前源码与主机回归。没有核验板上版本、香橙派实机程序或现场噪声/遮挡/定位效果；下一轮实车日志仍需核对实际执行版本及四场景完成情况。
