doinbest/Yachiyo/xjx/模版搭建/output/open-source-acceleration-20261014/GX-Intelligent-Logistics-Silver/Core/Src/main.c

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
/* Includes ------------------------------------------------------------------*/
#include "main.h"
#include "i2c.h"
#include "usart.h"
#include "gpio.h"

/* USER CODE BEGIN Includes */
#include "bjdj.h"
#include "oled.h"
#include "Motor.h"
#include "my_uart.h"
#include "Nixie.h"
#include "servo.h"
#include "smp.h"
#include  "string.h"
#include "JiXieBi.h"
/* USER CODE END Includes */

/* USER CODE BEGIN PTD */

int rx=0;
uint8_t RX=255,Rec;
uint8_t RX_2[32];
uint8_t smp_Rec;
uint8_t RX_dj;
uint8_t RX_pjdj[4];
uint8_t RX_hd;
double jl=200;
int jxb_num=0;
double pos_X=0,pos_Y=0;
float jxb_T[51]={0,0.3,2.4,2,1.2,0.3,3.6,4.1,5.1,3,3.7,4.8,0.3,4,3.4,4,0.6,0.6,0.6,1.3,1.3,1.3,0.8,0.8,1.9,1.3,1.9,2,1.9,2};
float ylq_num=20;
int cjg_num[4]={0,3,2,1};
int zcq_num[4]={0,3,2,1};
int cjg_sb_num=2;
int zcq_sb_num=2;


uint8_t m2_num[6]={0};
float angle_value;

JiXieBi_t woDeJiXieBi;

bool zp_xz=true;

float yddw[][3]={
  {210,0,0},
  {190.32,88.75,0},
	{190.32,-88.75,0},
    
	{230,0,100},
	{230,0,70},
	{330,0,100},
	
	{0,330,100},
    {-330,0,100},
	{-385,0,-40},
	{-280,-175,-40}
  
};


/* USER CODE END PTD */


/* USER CODE BEGIN PV */
void lanya_num(uint8_t *RX);
void JD_Angle_ReceiveData(uint8_t rec);
void JiXieBi_PeiZhi(void);
void wk_cz(bool n);
void HAL_UART_TxCpltCallback(UART_HandleTypeDef *huart)
{
    if(huart->Instance==USART1)
    {


    }
		 if(huart->Instance==USART2)
    {	


    }
	if(huart->Instance==UART4)
	{


	}
	if(huart->Instance==UART5)
	{

	}
}

void HAL_UART_RxCpltCallback(UART_HandleTypeDef *huart)
{
	if(huart->Instance == USART1)
	{

    }                                                                                                                                                                                                                                           
	if(huart->Instance == USART3)
	{
		//bool---->false;
		Data_Analyse(Rec);
		HAL_UART_Receive_IT(&huart3,&Rec, 1);
	}
	if(huart->Instance == USART2)
    {
		smp_por(smp_Rec);
		HAL_UART_Receive_IT(&huart2,&smp_Rec, 1);
    }
	
    if(huart->Instance == UART4)
    {
		
    }
	 if(huart->Instance == UART5)
	{
		JD_Angle_ReceiveData(RX_hd);
		HAL_UART_Receive_IT(&huart5,&RX_hd, 1);
	}
}





/* USER CODE END PV */

void SystemClock_Config(void);
/* USER CODE BEGIN PFP */

void jxb_pos(int num,bool zt);
void cd_cs(void);
void UI_OLED(void);






/* USER CODE END PFP */

/**
  * @brief  The application entry point.
  * @retval int
  */
int main(void)
{

  /* MCU Configuration--------------------------------------------------------*/

  /* Reset of all peripherals, Initializes the Flash interface and the Systick. */
  HAL_Init();

  /* Configure the system clock */
  SystemClock_Config();

  /* Initialize all configured peripherals */
  MX_GPIO_Init();
  MX_USART1_UART_Init();
  MX_I2C1_Init();
  MX_USART2_UART_Init();
  MX_USART3_UART_Init();
  MX_UART4_Init();
  MX_UART5_Init();
  /* USER CODE BEGIN 2 */
	
	
	MAX7219_Init();
	
	HAL_UART_Init(&huart2);
	HAL_UART_Receive_IT(&huart2,&smp_Rec, 1);
	
	 
	
	HAL_UART_Init(&huart3);
	HAL_UART_Receive_IT(&huart3,&Rec, 1);


	HAL_UART_Init(&huart5);
  HAL_UART_Receive_IT(&huart5,&RX_hd, 1);

	
	OLED_Init();
	OLED_Clear();
 
    Gyro_Init();
    HAL_Delay(500);


	cd_cs();
	
  /* USER CODE END 2 */

  /* Infinite loop */
  /* USER CODE BEGIN WHILE */
  while (1)
  {
    /* USER CODE END WHILE */

    /* USER CODE BEGIN 3 */
		lanya_num(&RX);
		UI_OLED();
		
		// Nixie_rwm("321+123");
  }
	
	
  /* USER CODE END 3 */
}

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
/* USER CODE BEGIN 4 */


/**
  * @brief    ��е�����ú���
  */
void JiXieBi_PeiZhi(void)
{

    woDeJiXieBi.OA = 66.71f;
    woDeJiXieBi.AB = 110.0f;
    woDeJiXieBi.BC = 150.0f;
    woDeJiXieBi.theta = 77.01f;

    woDeJiXieBi.alpha0 = 0.0f;
    woDeJiXieBi.beta0 = 16.30f;
    woDeJiXieBi.gamma0 = 19.62f;

    woDeJiXieBi.dizuoAddr = 5;
    woDeJiXieBi.dabiAddr = 6;
    woDeJiXieBi.xiaobiAddr = 7;

    woDeJiXieBi.dizuoMaiChong = 3200.0/360.0;
    woDeJiXieBi.dabiMaiChong = 16*3200.0*10/360.0;
    woDeJiXieBi.xiaobiMaiChong = 16*3200.0*10/360.0;

    woDeJiXieBi.diubuJianCe = 0;
    woDeJiXieBi.pengzhuangJiaoZhun = 0;

    woDeJiXieBi.diubuYuZhi = 0.5f;

    JiXieBi_ChuShiHua(&woDeJiXieBi);
}






/**
  * @brief    UI������ʾ����
  */
void UI_OLED(void)
{
	static uint8_t n=0;
	if(n!=RX)
    {
		OLED_ShowNum(0,0,RX,3,16,1);
		n=RX;
	}          
         
		 OLED_Showdecimal(0,2,pos_x,4,2,16,1);
		 OLED_Showdecimal(0,4,pos_y,4,2,16,1);
		 OLED_Showdecimal(0,6,zangle,4,2,16,1);
		 OLED_Showdecimal(62,2,pos_X,4,2,16,1);
		 OLED_Showdecimal(62,4,pos_Y,4,2,16,1);		
		 
		 OLED_Showdecimal(60,6,angle_value,4,2,16,1);


	     //OLED_ShowChar(72,6,Rec,16,0);

		
         OLED_Showdecimal(25,0,smp_num[0],3,1,16,1);
		 OLED_Showdecimal(65,0,smp_num[1],3,1,16,1);
		 //OLED_ShowNum(106,0,smp_num[2],1,16,1);

		 //OLED_Showdecimal(0,0,smp_num[0],3,2,16,1);
         //OLED_Showdecimal(50,0,smp_num[1],3,2,16,1);
         //OLED_ShowNum(100,0,smp_num[2],1,16,1);        
		  
}

/**
  * @brief    ��������
  * @param    RX  ���������͵�ָ��
  */
void lanya_num(uint8_t *RX)
{
	

    if(*RX<5)
	{
		if(*RX<=4)
		{
      	 Motor_pos(*RX,jl,0,0);
			//Motor_pos_s(*RX,jl,&pos_X,&pos_Y,3,0);
		}
		else
		{
			Motor_Stop();
		}
		//Motor_pos_s(*RX,jl);
	}
	else if(*RX==5)
		 {
		   Data_stop(&pos_X,&pos_Y);
		 }
	else if(*RX>5)
		 { 
		   switch(*RX)
			 {
			   case 6:
				 {
					
				   break;
				 }
				 case 7:
				 {
					
				   break;
				 }
				 case 8:
				 {
					
				   break;
				 }
				 case 9:
				 {
				
				   break;
				 }
				 case 10:
				 {
					
				   break;
				 }
				 case 11:
				 {
					
				   break;
				 }
				  case 12:
				 {

				   break;
				 }
				 case 13:
				 {

				   break;
				 }
				 case 14:
				 {

				   break;
				 }
				 case 15://��λ
				 {
					 
				   break;
				 }
				 case 16:
				 {
					 Motor_jd_90(&pos_X,&pos_Y,1);
				   break;
				 }
				 case 17:
				 {
					//cd_cs5();
					//cd_cs4();
					//cd_cs2();
					//cd_cs3();
				   break;
				 }
				  case 18:
				 {
					 Motor_jd_90(&pos_X,&pos_Y,0);
				   break;
				 }
				  case 19:
				 {
					 //smp_2m_dq();
					 smp_fs(1);
					 
				   break;
				 }
				 default:
					 break;
			 }
		 }
	*RX=255;
}

/**
 * @brief  ��������֡��ʽ��0x55 + 2�ֽڽǶ�����-----------------------������Ƕ����ݷ�����---------------------------------
 * @brief  ��������֡��ʽ��0xFF + 6�ֽڵ���������Ϣ
 * @param rec ���յ��ĵ����ֽ�
 */
void JD_Angle_ReceiveData(uint8_t rec)
{
	static uint8_t ch;
	static uint8_t frame_data[2];
	static uint8_t count = 0;
	static int16_t angle_received;
	ch = rec;
	switch(count)
	{
		case 0:
			if(ch == 0x55)
				count++;
			else if(ch == 0xFF)
				count=100;
			else
				count = 0;
			break;
			
		case 1:
			frame_data[0] = ch;
			count++;
			break;
			
		case 2:
			frame_data[1] = ch;
			

			angle_received = (int16_t)((frame_data[1] << 8) | frame_data[0]);
			

			angle_value = (float)angle_received / 100.0f;
			count = 0;
			break;

		case 100:case 101:case 102:case 103:case 104:case 105://���������
	    {
			m2_num[count-100] = ch;
			count++;
			if(count == 106)
			{
				count=0;
			}
			break;
		}
		default:
			count = 0;
			break;
	}
}
	


/**
  * @brief    ��е��ϸ�ֿ��ƣ�λ��ģʽ��
  * @param    num     :������ID����¼��TXT�ļ���
  * @param    zt      :������ִ��״̬��1-�л��壬0-�޻��壩
  */
void jxb_pos(int num,bool zt)
{
   runActionGroup(num,1);
   UI_OLED();
   if(zt)
   {
	   HAL_Delay(jxb_T[num]*1000);
   }
}

/**
  * @brief    ת�����λ�ø���
  * @param    n:true-˳ʱ�룬false-��ʱ��
  */
void wk_cz(bool n)
{ 
  if(n)
  {
	for(int i=0;i<3;i++)
    {
	smp_wk[i]=(smp_wk[i]+1)%3;
    }
  }
  else
  {
	for(int i=0;i<3;i++)
	{
	  smp_wk[i]=smp_wk[i]-1<0?smp_wk[i]-1+3:smp_wk[i]-1;
	}
  }
}

/**
  * @brief    视觉等待超时包装函数
  * @param    cmd      发送给树莓派的命令
  * @param    timeout_ms  超时时间(ms), 默认3000ms
  * @return   true=成功收到数据, false=超时
  */
bool smp_wait_with_timeout(int cmd, uint32_t timeout_ms)
{
    smp_fs(cmd);
    uint32_t deadline = HAL_GetTick() + timeout_ms;
    while(!smp_bool && HAL_GetTick() < deadline) {
        HAL_Delay(5);
        if(HAL_GetTick() > deadline - 500) {
            smp_fs(cmd); // 超时前重发一次
        }
    }
    if(!smp_bool) {
        // 超时: 使用默认值
        smp_num[0] = 0;
        smp_num[1] = 0;
        smp_num[2] = 0;
        smp_wk[0] = 0;
        smp_wk[1] = 1;
        smp_wk[2] = 2;
        return false;
    }
    smp_fs(2); // 关闭树莓派
    smp_bool = false;
    return true;
}

 /**
  * @brief    ���������˶���һ��ʽ������
  */
void cd_cs(void)
{
      Motor_pos_s(3,155,&pos_X,&pos_Y,2,0,0);
	  Motor_pos_s(1,650+95,&pos_X,&pos_Y,3,0,0);
	
	  smp_2m_dq();
	 
      while(!(m2_num[0]*m2_num[1]*m2_num[2]*m2_num[3]*m2_num[4]*m2_num[5]))
	  {
          HAL_Delay(5);
	  }
	  Nixie_rwm((char*)m2_num);
	  HAL_Delay(200);
	  jxb_pos(1,false);
     
	  Motor_pos_s(1,800-58-95,&pos_X,&pos_Y,3,0,0);
		Motor_jd_s(&pos_X,&pos_Y,0);
	

	  Motor_pos_s(4,60,&pos_X,&pos_Y,3,0,0);


	  smp_fs(0);
      while(!smp_bool)
	  {
        HAL_Delay(5);
		smp_fs(0);
	  }
	  smp_fs(2);
      smp_bool=false;
       
	  wk_cz(zp_xz);
      
	  for(int i=0;i<3;i++)
	  { 
        jxb_pos(smp_wk[m2_num[i]-1]+16,true);
        HAL_Delay(100);
		smp_fs(2+m2_num[i]);
		while(!smp_bool)
	    {
         HAL_Delay(5);
		 smp_fs(2+m2_num[i]);
	    }
		smp_fs(2);
		smp_bool=false;
				
		jxb_pos(smp_wk[m2_num[i]-1]+19,true);

		if(i==2)
		{
		 jxb_pos(m2_num[i]+1,false);
         Motor_pos_s(3,60,&pos_X,&pos_Y,3,0,0);
		}
		else
		jxb_pos(m2_num[i]+1,true);

        wk_cz(zp_xz);
	  }






		
	  Motor_pos_s(2,400-58,&pos_X,&pos_Y,3,0,0);
	  Motor_pos_s(3,860,&pos_X,&pos_Y,3,0,0);
      jxb_pos(22,false);
	  Motor_pos_s(3,860,&pos_X,&pos_Y,3,0,0);


      //jxb_pos(22,true);
	  HAL_Delay(200);
	  smp_fs(1);
	  while(!smp_bool)
      {
		HAL_Delay(5);
		smp_fs(1);
	  }
	  smp_fs(2);
	  smp_bool=false;
      


	  Motor_smp(&pos_X,&pos_Y,smp_num[0],smp_num[1],1,0);

      for(int i=0;i<3;i++)
	  {
          jxb_pos(m2_num[i]+5,true);
	  }	  


	  for(int i=0;i<3;i++)
	  {

        if(i!=2)
		{
			jxb_pos(m2_num[i]+8,true);
		}
        if(i==2)
		{
			jxb_pos(m2_num[i]+8,false);
			HAL_Delay(1500);
            Motor_pos_s(1,825,&pos_X,&pos_Y,3,0,0);
		}
	  }


	  //Motor_pos_s(1,825,&pos_X,&pos_Y,3,0,0);
      jxb_pos(23,false);
	  Motor_pos_s(4,825,&pos_X,&pos_Y,3,0,0);  


      //jxb_pos(23,true);
	  HAL_Delay(200);
	  smp_fs(1);
	  while(!smp_bool)
      {
		HAL_Delay(5);
		smp_fs(1);
	  }
	  smp_fs(2);
	  smp_bool=false;
      

	  Motor_smp(&pos_X,&pos_Y,smp_num[0],smp_num[1],2,0);

	  for(int i=0;i<3;i++)
      {
		if(i!=2)
		jxb_pos(m2_num[i]+12,true);
		else
		{
			jxb_pos(m2_num[i]+12,false);
			HAL_Delay(3300);
            Motor_pos_s(4,895,&pos_X,&pos_Y,3,0,0);
		}
	  }


    jxb_pos(1,false);
	Motor_pos_s(2,425+58,&pos_X,&pos_Y,3,0,0);
			

    Motor_pos_s(4,60,&pos_X,&pos_Y,3,0,0);


	  smp_fs(0);
     while(!smp_bool)
	  {
        HAL_Delay(5);
		smp_fs(0);
	  }
	  smp_fs(2);
      smp_bool=false;


	  for(int i=0;i<3;i++)
	  { 
        jxb_pos(smp_wk[m2_num[i+3]-1]+16,true);
        HAL_Delay(100);
		smp_fs(2+m2_num[i+3]);
		while(!smp_bool)
	    {
         HAL_Delay(5);
		 smp_fs(2+m2_num[i+3]);
	    }
		smp_fs(2);
		smp_bool=false;

		jxb_pos(smp_wk[m2_num[i+3]-1]+19,true);
		if(i==2)
		{
		 jxb_pos(m2_num[i+3]+1,false);
         Motor_pos_s(3,60,&pos_X,&pos_Y,3,0,0);
		}
		else
		jxb_pos(m2_num[i+3]+1,true);

        wk_cz(zp_xz);
	  }




	  Motor_pos_s(2,400-58,&pos_X,&pos_Y,3,0,0);
	  Motor_pos_s(3,860,&pos_X,&pos_Y,1,0,0);
      jxb_pos(22,false);
	  Motor_pos_s(3,860,&pos_X,&pos_Y,3,0,0);
	  Motor_jd_s(&pos_X,&pos_Y,0);

      //jxb_pos(22,true);
	  HAL_Delay(200);
	  smp_fs(1);
	  while(!smp_bool)
      {
		HAL_Delay(5);
		smp_fs(1);
	  }
	  smp_fs(2);
	  smp_bool=false;
      


	  Motor_smp(&pos_X,&pos_Y,smp_num[0],smp_num[1],1,0);

      for(int i=0;i<3;i++)
	  {
          jxb_pos(m2_num[i+3]+5,true);
	  }	  


	  for(int i=0;i<3;i++)
	  {
		  if(i!=2)
          jxb_pos(m2_num[i+3]+8,true);
		  else
		  {
			jxb_pos(m2_num[i+3]+8,false);
			HAL_Delay(1500);
			Motor_pos_s(1,825,&pos_X,&pos_Y,3,0,0);
		  }
	  }


	  //Motor_pos_s(1,825,&pos_X,&pos_Y,3,0,0);
	  jxb_pos(23+m2_num[3],false);
	  Motor_pos_s(4,825,&pos_X,&pos_Y,3,0,0);
	  Motor_jd_s(&pos_X,&pos_Y,0);


       jxb_pos(26+m2_num[3],true);
	   for(int i=4;i<6;i++)
	   {
		   jxb_pos(23+m2_num[i],true);
		   HAL_Delay(100);
		   jxb_pos(26+m2_num[i],true);
	   }




	  Motor_pos_s(4,895,&pos_X,&pos_Y,3,0,0);
	  Motor_pos_s(2,1875,&pos_X,&pos_Y,3,0,0);
	  Motor_pos_s(4,155,&pos_X,&pos_Y,3,0,0);
	
}





/* USER CODE END 4 */
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
