doinbest/Yachiyo/xjx/模版搭建/output/open-source-acceleration-20261014/GX-Intelligent-Logistics-Silver/Core/Inc/main.h

#define USART2_TX_ly_Pin GPIO_PIN_2
#define USART2_TX_ly_GPIO_Port GPIOA
#define USART2_RX_ly_Pin GPIO_PIN_3
#define USART2_RX_ly_GPIO_Port GPIOA
#define Max7219_pinDIN_Pin GPIO_PIN_7
#define Max7219_pinDIN_GPIO_Port GPIOE
#define Max7219_pinCS_Pin GPIO_PIN_8
#define Max7219_pinCS_GPIO_Port GPIOE
#define Max7219_pinCLK_Pin GPIO_PIN_9
#define Max7219_pinCLK_GPIO_Port GPIOE
#define USART3_TX_zjbml_Pin GPIO_PIN_8
#define USART3_TX_zjbml_GPIO_Port GPIOD
#define USART3_RX_zjbml_Pin GPIO_PIN_9
#define USART3_RX_zjbml_GPIO_Port GPIOD
#define USART1_TX_bjdj_Pin GPIO_PIN_9
#define USART1_TX_bjdj_GPIO_Port GPIOA
#define USART1_RX_bjdj_Pin GPIO_PIN_10
#define USART1_RX_bjdj_GPIO_Port GPIOA
#define UART4_TX_zxdj_Pin GPIO_PIN_10
#define UART4_TX_zxdj_GPIO_Port GPIOC
#define UART4_RX_zxdj_Pin GPIO_PIN_11
#define UART4_RX_zxdj_GPIO_Port GPIOC
#define UART5_TX_smp_Pin GPIO_PIN_12
#define UART5_TX_smp_GPIO_Port GPIOC
#define UART5_RX_smp_Pin GPIO_PIN_2
#define UART5_RX_smp_GPIO_Port GPIOD
