doinbest/Yachiyo/xjx/模版搭建/Code/template/Core/Src/main.c

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
/* Includes ------------------------------------------------------------------*/
#include "main.h"
#include "dma.h"
#include "i2c.h"
#include "spi.h"
#include "tim.h"
#include "usart.h"
#include "usb_device.h"
#include "gpio.h"

/* USER CODE BEGIN Includes */

#include "Camera.h"
#include "QR.h"
#include "GrabTask.h"
#include "turntable.h"
#include "GrabRoute.h"
#include "Steer.h"
#include "lidar_servo.h"
#include "arm_console.h"
#include "contest_screen.h"
#include "contest_mission.h"
#include "hwt101_i2c.h"
#include "hwt101_calibration.h"
#include "key.h"
#include "mechanical_arm.h"
#include "mecanum_chassis.h"
#include "oled_ui.h"
#include "tjc_screen.h"
#include "usbd_cdc_if.h"
#include "w25q128.h"
#include "motor_bus.h"
#include "console_tx.h"
#include "console_rx.h"
#include "chassis_motion.h"
#include "chassis_localization.h"
#include "chassis_route.h"
#include "chassis_telemetry.h"
#include "radar_scan.h"
#include "radar_console.h"

#include <stdio.h>
#include <string.h>

/* USER CODE END Includes */

/* USER CODE BEGIN PD */
#define HWT101_UPLOAD_INTERVAL_MS 200U
#define CONSOLE_UPLOAD_TIMEOUT_MS 100U

/* USER CODE END PD */


/* USER CODE BEGIN PV */

static uint8_t QR_RxByte;

static char QR_TaskCode[QR_TASK_CODE_BUFFER_SIZE];
static uint8_t Camera_ColorTaskReady;
static uint8_t Camera_ColorDigitIndex;
static HWT101_Angle_t HWT101_CurrentAngle;
static uint8_t HWT101_AngleValid;
static uint32_t HWT101_UploadLastTick;
static uint32_t HWT101_ProgressLastTick;
static uint32_t HWT101_UploadRunId, HWT101_UploadFinalRunId;
static HWT101_CalState_t HWT101_UploadFinalState;

/* USER CODE END PV */

void SystemClock_Config(void);
/* USER CODE BEGIN 0 */

/* Board bring-up diagnostic only; not part of normal startup. */
#ifndef W25Q128_BOOT_DIAGNOSTIC
#define W25Q128_BOOT_DIAGNOSTIC 0
#endif
#if W25Q128_BOOT_DIAGNOSTIC
/** 启动时先读三次 JEDEC ID，再读三次设备 ID，失败也继续启动。 */
static void W25Q128_StartupCheck(void)
{
  uint8_t Id[3] = {0};
  uint8_t Index;
  uint8_t Command;
  uint8_t Try;
  uint8_t Invalid;
  char Text[96];
  const char *StatusText;
  const char *Prefix;
  int32_t Length;
  HAL_StatusTypeDef Status;

  for (Index = 0U; Index < 6U; Index++)
  {
    /* 首次读取保持原来的启动条件，仅在相邻交易之间等待。 */
    if (Index > 0U)
    {
      HAL_Delay(10U);
    }
    Try = (uint8_t)(Index % 3U + 1U);
    Prefix = (Index == 0U) ? "\r\n" : "";
    if (Index < 3U)
    {
      Command = 0x9FU;
      Status = W25Q128_ReadJedecId(&hspi1, Id);
    }
    else
    {
      Command = 0x90U;
      Status = W25Q128_ReadDeviceId(&hspi1, Id);
    }

    if (Status != HAL_OK)
    {
      switch (Status)
      {
        case HAL_ERROR: StatusText = "ERROR"; break;
        case HAL_BUSY: StatusText = "BUSY"; break;
        case HAL_TIMEOUT: StatusText = "TIMEOUT"; break;
        default: StatusText = "UNKNOWN"; break;
      }
      /* 失败时不打印保留在 Id 中的上次结果。 */
      Length = snprintf(Text, sizeof(Text), "%s[FLASH] cmd=%02X try=%u HAL=%s\r\n",
                        Prefix, (unsigned)Command, (unsigned)Try, StatusText);
    }
    else
    {
      Invalid = ((Id[0] == 0U) && (Id[1] == 0U) &&
                 ((Command == 0x90U) || (Id[2] == 0U))) ||
                ((Id[0] == 0xFFU) && (Id[1] == 0xFFU) &&
                 ((Command == 0x90U) || (Id[2] == 0xFFU)));
      if (Command == 0x9FU)
      {
        Length = snprintf(Text, sizeof(Text),
                          "%s[FLASH] cmd=9F try=%u HAL=OK ID=%02X %02X %02X%s\r\n",
                          Prefix, (unsigned)Try, (unsigned)Id[0], (unsigned)Id[1],
                          (unsigned)Id[2], Invalid ? " INVALID" : "");
      }
      else
      {
        Length = snprintf(Text, sizeof(Text),
                          "%s[FLASH] cmd=90 try=%u HAL=OK ID=%02X %02X%s\r\n",
                          Prefix, (unsigned)Try, (unsigned)Id[0], (unsigned)Id[1],
                          Invalid ? " INVALID" : "");
      }
    }

    if ((Length > 0) && (Length < (int32_t)sizeof(Text)))
    {
      (void)ConsoleTx_Write((uint8_t *)Text, (uint16_t)Length);
    }
  }

  (void)ConsoleTx_Write((uint8_t *)"arm> ", 5U);
}
#endif

/* IMU_TIMING_BEGIN: 主循环分段计时；仅保存数值，失败前不发送日志。 */
typedef enum
{
  IMU_TIME_CAMERA, IMU_TIME_MOTOR, IMU_TIME_MATERIAL,
  IMU_TIME_CHASSIS, IMU_TIME_READ, IMU_TIME_CAL, IMU_TIME_LOG,
  IMU_TIME_CONSOLE, IMU_TIME_SCREEN, IMU_TIME_QR_KEYS, IMU_TIME_OLED,
  IMU_TIME_COUNT
} ImuTimingStage_t;

static struct
{
  uint32_t current[IMU_TIME_COUNT], previous[IMU_TIME_COUNT], maximum[IMU_TIME_COUNT];
  uint32_t start_tick, mark_tick, previous_loop_ms, max_loop_ms;
  uint32_t failure_partial_ms;
  uint8_t active, frozen;
} ImuTiming;
static uint32_t ImuTiming_LastRunId;

static void ImuTiming_Begin(void)
{
  HWT101_CalStatus_t Cal;
  if (!HWT101_Cal_GetStatus(&Cal)) return;
  if (Cal.run_id != ImuTiming_LastRunId)
    memset(&ImuTiming, 0, sizeof(ImuTiming));
  ImuTiming_LastRunId = Cal.run_id;
  ImuTiming.active = !ImuTiming.frozen && (Cal.busy || Cal.control_ready);
  if (!ImuTiming.active) return;
  memset(ImuTiming.current, 0, sizeof(ImuTiming.current));
  ImuTiming.start_tick = ImuTiming.mark_tick = HAL_GetTick();
}

static void ImuTiming_Mark(ImuTimingStage_t Stage)
{
  uint32_t Now, Elapsed;
  if (!ImuTiming.active) return;
  Now = HAL_GetTick();
  Elapsed = (uint32_t)(Now - ImuTiming.mark_tick);
  ImuTiming.current[Stage] = Elapsed;
  if (Elapsed > ImuTiming.maximum[Stage]) ImuTiming.maximum[Stage] = Elapsed;
  ImuTiming.mark_tick = Now;
}

static void ImuTiming_End(void)
{
  if (!ImuTiming.active) return;
  ImuTiming.previous_loop_ms = (uint32_t)(HAL_GetTick() - ImuTiming.start_tick);
  if (ImuTiming.previous_loop_ms > ImuTiming.max_loop_ms)
    ImuTiming.max_loop_ms = ImuTiming.previous_loop_ms;
  memcpy(ImuTiming.previous, ImuTiming.current, sizeof(ImuTiming.previous));
}

static void ImuTiming_Freeze(void)
{
  if (!ImuTiming.frozen)
    ImuTiming.failure_partial_ms = ImuTiming.active ? (uint32_t)(HAL_GetTick() - ImuTiming.start_tick) : 0U;
  ImuTiming.active = 0U;
  ImuTiming.frozen = 1U;
}

static void ImuTiming_Report(const HWT101_CalStatus_t *Cal)
{
  static const char *const Names[IMU_TIME_COUNT] = {
    "camera", "motor_events", "material", "chassis", "imu_read",
    "imu_cal", "imu_log", "console", "screen", "qr_keys", "oled"
  };
  char Text[192];
  int Length;
  unsigned Stage;
  /* 先冻结，故障日志与异步恢复不覆盖首次失败现场。 */
  ImuTiming_Freeze();
  Length = snprintf(Text, sizeof(Text),
      "\r\n[IMU DIAG] gap_ms=%lu max_gap_ms=%lu limit_ms=%lu "
      "loop_prev_ms=%lu loop_max_ms=%lu loop_partial_ms=%lu\r\n",
      (unsigned long)Cal->gap_ms, (unsigned long)Cal->max_gap_ms,
      (unsigned long)HWT101_DATA_FRESH_MS, (unsigned long)ImuTiming.previous_loop_ms,
      (unsigned long)ImuTiming.max_loop_ms, (unsigned long)ImuTiming.failure_partial_ms);
  if ((Length > 0) && (Length < (int)sizeof(Text)))
    (void)ConsoleTx_Write((uint8_t *)Text, (uint16_t)Length);
  for (Stage = 0U; Stage < IMU_TIME_COUNT; Stage++)
  {
    Length = snprintf(Text, sizeof(Text),
        "[IMU TIME] stage=%s prev_ms=%lu current_ms=%lu max_ms=%lu\r\n", Names[Stage],
        (unsigned long)ImuTiming.previous[Stage], (unsigned long)ImuTiming.current[Stage],
        (unsigned long)ImuTiming.maximum[Stage]);
    if ((Length > 0) && (Length < (int)sizeof(Text)))
      (void)ConsoleTx_Write((uint8_t *)Text, (uint16_t)Length);
  }
}
/* IMU_TIMING_END */

/**
  * 函    数：通过USART1上传HWT101最新角度
  * 参    数：无
  * 返 回 值：无
  * 说    明：默认只报告标定进度和结果；stream开启时每200ms更新最新角度槽，发送层每路至少间隔500ms。
  */
static void HWT101_Upload_Process(void)
{
  char UploadText[320];
  int UploadLength;
  uint32_t CurrentTick = HAL_GetTick();
  uint8_t Fresh;
  HWT101_Status_t Comm = {0};
  HWT101_CalStatus_t Cal;
  bool Terminal;

  if (!HWT101_Cal_GetStatus(&Cal)) return;
  (void)HWT101_Status_Get(&Comm);
  if (Cal.run_id != HWT101_UploadRunId)
  {
    HWT101_UploadRunId = Cal.run_id;
    HWT101_ProgressLastTick = CurrentTick;
  }
  if (Cal.state == HWT101_CAL_RESTORING && strcmp(Cal.reason, "none") && strcmp(Cal.reason, "cancelled"))
    ImuTiming_Freeze();
  Terminal = !Cal.busy && ((Cal.state == HWT101_CAL_DONE) ||
             (Cal.state == HWT101_CAL_FAILED) || (Cal.state == HWT101_CAL_CANCELLED));
  if (Terminal &&
      ((Cal.run_id != HWT101_UploadFinalRunId) || (Cal.state != HWT101_UploadFinalState)))
  {
    HWT101_UploadFinalRunId = Cal.run_id;
    HWT101_UploadFinalState = Cal.state;
    if (!strcmp(Cal.result, "ZERO_SAMPLE"))
    {
      UploadLength = snprintf(UploadText, sizeof(UploadText),
          "\r\nOK imu zero sample before_deg=%.3f after_deg=%.3f verified=0 control_ready=0\r\narm> ",
          (double)Cal.zero_before_deg, (double)Cal.zero_after_deg);
      if ((UploadLength > 0) && (UploadLength < (int)sizeof(UploadText)))
        (void)ConsoleTx_Write((uint8_t *)UploadText, (uint16_t)UploadLength);
      return;
    }
    if (Cal.state == HWT101_CAL_FAILED) ImuTiming_Report(&Cal);
    if (Cal.first_reason && strcmp(Cal.first_reason, "none"))
    {
      UploadLength = snprintf(UploadText, sizeof(UploadText),
          "[IMU FAULT] first_reason=%s first_HAL=%u error=0x%08lX state=0x%02lX "
          "op=%u reg=0x%02X tick=%lu reinit_count=%lu\r\n",
          Cal.first_reason, (unsigned)Cal.first_hal, (unsigned long)Cal.first_hal_error,
          (unsigned long)Cal.first_hal_state, (unsigned)Cal.first_operation,
          (unsigned)Cal.first_register, (unsigned long)Cal.first_fault_ms,
          (unsigned long)Comm.reinit_count);
      if ((UploadLength > 0) && (UploadLength < (int)sizeof(UploadText)))
        (void)ConsoleTx_Write((uint8_t *)UploadText, (uint16_t)UploadLength);
    }
    UploadLength = snprintf(UploadText, sizeof(UploadText),
        "\r\n[IMU CAL] result=%s state=%s reason=%s HAL=%u run_id=%lu verified=%u control_ready=%u\r\n",
        Cal.result, Cal.state_name, Cal.reason, (unsigned)Cal.hal,
        (unsigned long)Cal.run_id, (unsigned)Cal.verified, (unsigned)Cal.control_ready);
    if ((UploadLength > 0) && (UploadLength < (int)sizeof(UploadText)))
      (void)ConsoleTx_Write((uint8_t *)UploadText, (uint16_t)UploadLength);
    UploadLength = snprintf(UploadText, sizeof(UploadText),
        "[IMU SAVE] save_state=%s save_requested=%u save_readback_ok=%u persistent=UNTESTED "
        "normal_mode=%u bias_before=0x%04X bias_after=0x%04X bias_after_valid=%u\r\n",
        Cal.save_state, (unsigned)Cal.save_requested, (unsigned)Cal.save_readback_ok,
        (unsigned)Cal.normal_mode_confirmed, (unsigned)Cal.bias_before,
        (unsigned)Cal.bias_after, (unsigned)Cal.bias_after_valid);
    if ((UploadLength > 0) && (UploadLength < (int)sizeof(UploadText)))
      (void)ConsoleTx_Write((uint8_t *)UploadText, (uint16_t)UploadLength);
    UploadLength = snprintf(UploadText, sizeof(UploadText),
        "[IMU VERIFY] samples=%lu drift_dps=%.5f rms_deg=%.4f gap_ms=%lu max_gap_ms=%lu "
        "i2c_errors=%lu elapsed_ms=%lu relative_deg=%.3f verify_elapsed_ms=%lu\r\narm> ",
        (unsigned long)Cal.samples, (double)Cal.drift_dps, (double)Cal.rms_deg,
        (unsigned long)Cal.gap_ms, (unsigned long)Cal.max_gap_ms,
        (unsigned long)Cal.i2c_errors, (unsigned long)Cal.elapsed_ms,
        (double)Cal.relative_deg, (unsigned long)Cal.verify_elapsed_ms);
    if ((UploadLength > 0) && (UploadLength < (int)sizeof(UploadText)))
      (void)ConsoleTx_Write((uint8_t *)UploadText, (uint16_t)UploadLength);
  }
  if (Cal.busy && ((uint32_t)(CurrentTick - HWT101_ProgressLastTick) >= 5000U))
  {
    HWT101_ProgressLastTick = CurrentTick;
    UploadLength = snprintf(UploadText, sizeof(UploadText),
        "\r\n[IMU CAL] state=%s elapsed_s=%lu total_s=%lu verify_elapsed_s=%lu keep_still=1\r\n",
        Cal.state_name, (unsigned long)(Cal.elapsed_ms / 1000U), (unsigned long)(Cal.total_ms / 1000U),
        (unsigned long)(Cal.verify_elapsed_ms / 1000U));
    if ((UploadLength > 0) && (UploadLength < (int)sizeof(UploadText)))
      (void)ConsoleTx_Write((uint8_t *)UploadText, (uint16_t)UploadLength);
  }
  /* Busy calibration suppresses telemetry; sampling continues independently. */
  if (Cal.busy || ArmConsole_ImuStreamEnabled() == 0U) return;
  if (HWT101_Angle_Get(&HWT101_CurrentAngle)) HWT101_AngleValid = 1U;
  if ((uint32_t)(CurrentTick - HWT101_UploadLastTick) < HWT101_UPLOAD_INTERVAL_MS) return;
  Fresh = (HWT101_AngleValid != 0U) &&
          HWT101_Angle_Is_Fresh(&HWT101_CurrentAngle, HWT101_DATA_FRESH_MS);
  if (HWT101_AngleValid == 0U)
    UploadLength = snprintf(UploadText, sizeof(UploadText),
        "HWT101 yaw_deg=NA t_ms=%lu fresh=0 cal_state=%s i2c_errors=%lu\r\n",
        (unsigned long)CurrentTick, Cal.state_name, (unsigned long)Comm.i2c_error_count);
  else
    UploadLength = snprintf(UploadText, sizeof(UploadText),
        "HWT101 yaw_deg=%.2f count=%lu t_ms=%lu age_ms=%lu fresh=%u cal_state=%s i2c_errors=%lu\r\n",
        (double)HWT101_CurrentAngle.yaw, (unsigned long)HWT101_CurrentAngle.update_count,
        (unsigned long)CurrentTick, (unsigned long)(CurrentTick - HWT101_CurrentAngle.last_update_ms),
        (unsigned)Fresh, Cal.state_name, (unsigned long)Comm.i2c_error_count);
  if ((UploadLength > 0) && (UploadLength < (int)sizeof(UploadText)))
  {
    (void)ConsoleTx_Debug(CONSOLE_DEBUG_IMU, UploadText, (uint16_t)UploadLength);
    HWT101_UploadLastTick = CurrentTick;
  }
}

/** Optional blocking I2C work yields to every active motor/control workflow. */
static bool OptionalDisplayReady(void)
{
  MotorBus_Diagnostic_t bus;
  MotorBus_Recovery_t recovery;
  MotorBus_DiagnosticGet(&bus);
  MotorBus_RecoveryGet(&recovery);
  return !HWT101_Cal_IsBusy() && !ChassisMotion_IsBusy() && !ChassisRoute_IsBusy() &&
         !GrabTask_IsBusy() && !GrabRoute_IsBusy() && !Turntable_IsBusy() && !MechanicalArm_IsBusy() &&
         !Mecanum_IsBusy() &&
         !ChassisMotion_StopPending() && !ArmConsole_OperationBusy() &&
         !bus.active && !recovery.active && !RadarConsole_ScanBusy();
}

/* USER CODE END 0 */

/**
  * @brief  The application entry point.
  * @retval int
  */
int main(void)
{

  /* MCU Configuration--------------------------------------------------------*/

  /* Reset of all peripherals, Initializes the Flash interface and the Systick. */
  HAL_Init();

  /* Configure the system clock */
  SystemClock_Config();

  /* USER CODE BEGIN SysInit */
  (void)Camera_Init();

  /* USER CODE END SysInit */

  /* Initialize all configured peripherals */
  MX_GPIO_Init();
  MX_DMA_Init();
  MX_TIM1_Init();
  MX_UART4_Init();
  MX_USART1_UART_Init();
  MX_USART2_UART_Init();
  MX_USART3_UART_Init();
  MX_USART6_UART_Init();
  MX_UART5_Init();
  MX_I2C1_Init();
  MX_I2C2_Init();
  MX_USB_DEVICE_Init();
  MX_SPI1_Init();
  MX_TIM4_Init();
  /* USER CODE BEGIN 2 */

  /* CS 仍为高电平时提前使能 SPI1，验证首次读取的使能时序。 */
  __HAL_SPI_ENABLE(&hspi1);

  /*
   * 优先启动USART1控制台。即使OLED或其他可选外设没有连接，
   * 上位机仍然能够看到启动信息并使用调试命令。
   */
  if (ArmConsole_Init(&huart1) != HAL_OK)
  {
    Error_Handler();
  }

  /* USART1循环DMA接收；HT/TC/IDLE均由HAL分发。 */
  if (ConsoleRx_Init(&huart1) != HAL_OK)
  {
    Error_Handler();
  }

#if W25Q128_BOOT_DIAGNOSTIC
  W25Q128_StartupCheck();
#endif

  /* OLED为可选显示设备，未连接时不阻止其他模块和控制台运行。 */
  OledUi_Init(&hi2c1);

  QR_Init();
  Key_Init();
  if (HAL_UART_Receive_IT(&huart4, &QR_RxByte, 1U) != HAL_OK)
  {
    Error_Handler();
  }


  /* PE9使用TIM1_CH1输出50Hz PWM；CCR为0时夹爪上电不会立即动作。 */
  if (Steer_Init(&htim1) != HAL_OK)
  {
    Error_Handler();
  }
  /* PD12雷达舵机上电保持零脉宽，仅由显式控制台命令动作。 */
  if (LidarServo_Init() != HAL_OK)
  {
    Error_Handler();
  }
  GrabTask_Init();
  GrabRoute_Init();
  Turntable_Init();

  /* HWT101使用I2C2；设备仍在启动时，由轮询稍后重新探测。 */
  (void)HWT101_Init(&hi2c2);
  HWT101_Cal_Init();
  HWT101_UploadRunId = HWT101_UploadFinalRunId = 0U;
  HWT101_UploadFinalState = HWT101_CAL_IDLE;
  HWT101_CurrentAngle.yaw = 0.0f;
  HWT101_CurrentAngle.update_count = 0U;
  HWT101_AngleValid = 0U;
  HWT101_UploadLastTick = HAL_GetTick() - HWT101_UPLOAD_INTERVAL_MS;

  /* 机械臂电机总线使用UART5，模块初始化内部会启动ReceiveToIdle DMA接收。 */
  if (MotorBus_Init(&huart5) != HAL_OK) Error_Handler();
  ChassisRoute_Init();
  ChassisMotion_Init();
  ChassisTelemetry_Init();
  (void)RadarScan_Init(&huart2); /* RX only; scanning requires an explicit command. */
  RadarConsole_Init();
  if (MechanicalArm_Init(&huart5) != HAL_OK)
  {
    Error_Handler();
  }

  /* 比赛串口屏使用USART3 TX DMA，PD8连接屏幕RX，PD9连接屏幕TX。 */
  if (TJC_Init(&huart3) != HAL_OK)
  {
    Error_Handler();
  }
  ContestScreen_Init();
  /* Launch Z/X and ID8 together; GrabTask waits for them before Base HOME. */
  GrabTask_BootHomeStart();

  /* USER CODE END 2 */

  /* Infinite loop */
  /* USER CODE BEGIN WHILE */
  while (1)
  {
    MechanicalArm_EventTypeDef MotorEvent;
    KeyEvent_t Key;
    /* USER CODE END WHILE */

    /* USER CODE BEGIN 3 */
    ImuTiming_Begin();
    ConsoleRx_Process();
    ArmConsole_StopProcess(); /* Ctrl+C cancels producers before they can submit motion. */
    ConsoleTx_Process();
    if (ArmConsole_ResetPending())
    {
      ArmConsole_Process(); /* Consume a queued stop before committing reset. */
      if (ArmConsole_ResetProcess()) continue;
    }
    MotorBus_Process();
    RadarScan_Process(); /* Bounded parsing, no delay or motor submission. */
    Camera_Process();
    ImuTiming_Mark(IMU_TIME_CAMERA);
    MechanicalArm_Process();
    Turntable_Process(); /* Dedicated ID 8 owner; no arm-axis event consumption. */
    if (MechanicalArm_ResultGet(&MotorEvent) != 0U)
    {
      if (GrabTask_MotorEventHandle(&MotorEvent) == 0U)
      {
        ArmConsole_MotorEventHandle(&MotorEvent);
      }
    }
    ImuTiming_Mark(IMU_TIME_MOTOR);
    ImuTiming_Mark(IMU_TIME_MATERIAL);
    HWT101_Process(); /* 独立采集；关闭日志不会停止传感器轮询。 */
    ImuTiming_Mark(IMU_TIME_READ);
    HWT101_Cal_BootVerifyProcess(!Mecanum_IsBusy() && !MechanicalArm_IsBusy() &&
        !ChassisRoute_IsBusy() && !ChassisMotion_IsBusy() &&
        !GrabTask_IsBusy() && !GrabRoute_IsBusy() && !Turntable_IsBusy());
    HWT101_Cal_Process();
    ImuTiming_Mark(IMU_TIME_CAL);
    ChassisMotion_HeadingProcess();
    ChassisLocalization_Process();
    ChassisMotion_Process();
    ChassisRoute_Process();
    GrabRoute_Process();
    GrabTask_Process();
    {
      GrabTask_Status_t boot_arm;
      GrabTask_StatusGet(&boot_arm);
      Turntable_BootHomeProcess(boot_arm.state == GRAB_HOMING &&
          !boot_arm.stop_requested && boot_arm.elapsed_ms >= 1000U);
    }
    Mecanum_Process(); /* Task planners submit targets; this layer advances the bus. */
    ImuTiming_Mark(IMU_TIME_CHASSIS);
    ChassisTelemetry_Process();
    RadarConsole_Process();
    HWT101_Upload_Process();
    ImuTiming_Mark(IMU_TIME_LOG);
    ArmConsole_Process();
    if (ArmConsole_ResetPending()) continue;
    ImuTiming_Mark(IMU_TIME_CONSOLE);
    TJC_Process();
    if (!ChassisMotion_IsBusy() && !ChassisRoute_IsBusy()) ContestScreen_Process();
    ImuTiming_Mark(IMU_TIME_SCREEN);

    if (QR_TaskCodeGet(QR_TaskCode) == 1U)
    {
      if(!ContestMission_OwnsDisplay())
        (void)ContestScreen_TaskCodeSet(QR_TaskCode);
      Camera_ColorTaskReady = 1U;
      Camera_ColorDigitIndex = 0U;
      OledUi_TaskCodeSet(QR_TaskCode, Camera_ColorDigitIndex);
    }

    Key_Scan();
    Key = Key_Get_Press_Event(); /* 每圈只消费一次按键事件。 */
    if (!ArmConsole_OperationBusy() && !GrabTask_IsBusy() && !GrabRoute_IsBusy() && !Turntable_IsBusy() &&
        (Key == KEY_EVENT_PE4 || Key == KEY_EVENT_PE5 ||
         (!ChassisMotion_IsBusy() && !ChassisRoute_IsBusy())) &&
        OledUi_KeyHandle(Key) == 0U)
    {
      switch (Key)
      {
        case KEY_EVENT_PE3:
          if (Camera_ColorTaskReady && !MechanicalArm_IsBusy())
          {
            Camera_ColorDigitIndex = (uint8_t)((Camera_ColorDigitIndex + 1U) % 3U);
            OledUi_TaskCodeSet(QR_TaskCode, Camera_ColorDigitIndex);
          }
          break;

        default:
          break;
      }
    }
    ImuTiming_Mark(IMU_TIME_QR_KEYS);
    if (OptionalDisplayReady()) OledUi_Process(); /* Display I/O only in control-idle gaps. */
    ImuTiming_Mark(IMU_TIME_OLED);
    MotorBus_Process();
    ConsoleTx_Process();
    ImuTiming_End();
  }
  /* USER CODE END 3 */
}

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
/* USER CODE BEGIN 4 */

/**
  * @brief    分发HAL串口单字节接收完成事件
  * @param    huart ：触发回调的串口句柄
  * @retval   无
  */
void HAL_UART_RxCpltCallback(UART_HandleTypeDef *huart)
{
  TJC_Rx_Callback(huart);
  if (huart->Instance == UART4)
  {
    QR_ReceiveData(QR_RxByte);
    (void)HAL_UART_Receive_IT(&huart4, &QR_RxByte, 1U);
  }

}

/**
  * @brief    分发HAL串口DMA空闲接收事件
  * @param    huart ：触发回调的串口句柄
  * @param    Size  ：HAL提供的DMA写入位置（USART1读取实时NDTR防止重复事件）
  * @retval   无
  */
void HAL_UARTEx_RxEventCallback(UART_HandleTypeDef *huart, uint16_t Size)
{
  if (huart->Instance == UART5)
  {
    MotorBus_RxEventCallback(huart, Size);
  }
  else if (huart->Instance == USART1)
  {
    ConsoleRx_RxEventCallback(huart);
  }
  else if (huart->Instance == USART2)
  {
    RadarUart_RxEventCallback(huart,Size);
  }
}

/**
  * @brief    分发HAL串口DMA发送完成事件
  * @param    huart ：触发回调的串口句柄
  * @retval   无
  */
void HAL_UART_TxCpltCallback(UART_HandleTypeDef *huart)
{
  if (huart->Instance == UART5)
  {
    MotorBus_TxCpltCallback(huart);
  }
  else if (huart->Instance == USART1)
  {
    ConsoleTx_TxCpltCallback(huart);
  }
  else if (huart->Instance == USART3)
  {
    TJC_Tx_Callback(huart);
  }
  else if (huart->Instance == USART2)
  {
    RadarUart_TxCpltCallback(huart);
  }
}

/**
  * @brief    分发HAL串口通信错误事件
  * @param    huart ：触发回调的串口句柄
  * @retval   无
  */
void HAL_UART_ErrorCallback(UART_HandleTypeDef *huart)
{
  TJC_Error_Callback(huart);
  if (huart->Instance == USART1)
  {
    ConsoleRx_ErrorCallback(huart);
    /* RX overrun/framing errors do not cancel a healthy TX DMA. */
    if (huart->ErrorCode & HAL_UART_ERROR_DMA) ConsoleTx_ErrorCallback(huart);
  }
  else if (huart->Instance == UART4)
  {
    __HAL_UART_CLEAR_PEFLAG(huart);
    __HAL_UART_CLEAR_FEFLAG(huart);
    __HAL_UART_CLEAR_NEFLAG(huart);
    __HAL_UART_CLEAR_OREFLAG(huart);
    QR_ErrorCallback();
    (void)HAL_UART_Receive_IT(&huart4, &QR_RxByte, 1U);
  }
  else if (huart->Instance == USART2)
  {
    RadarUart_ErrorCallback(huart);
  }


  else if (huart->Instance == UART5)
  {
    __HAL_UART_CLEAR_PEFLAG(huart);
    __HAL_UART_CLEAR_FEFLAG(huart);
    __HAL_UART_CLEAR_NEFLAG(huart);
    __HAL_UART_CLEAR_OREFLAG(huart);
    MotorBus_ErrorCallback(huart);
  }
}

/* USER CODE END 4 */
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
