doinbest/Yachiyo/xjx/模版搭建/Code/template/App/mechanical_arm.h

#ifndef __MECHANICAL_ARM_H
#define __MECHANICAL_ARM_H

#ifdef __cplusplus
extern "C"
{
#endif

#include "main.h"

  typedef enum
  {
    MECHANICAL_ARM_AXIS_BASE = 0,
    MECHANICAL_ARM_AXIS_Z,
    MECHANICAL_ARM_AXIS_X,
    MECHANICAL_ARM_AXIS_ALL,
    MECHANICAL_ARM_AXIS_INVALID
  } MechanicalArm_AxisTypeDef;

  typedef enum
  {
    MECHANICAL_ARM_ACTION_NONE = 0,
    MECHANICAL_ARM_ACTION_ENABLE,
    MECHANICAL_ARM_ACTION_DISABLE,
    MECHANICAL_ARM_ACTION_POSITION,
    MECHANICAL_ARM_ACTION_POSITION_READ,
    MECHANICAL_ARM_ACTION_STATE,
    MECHANICAL_ARM_ACTION_ORIGIN_SET,
    MECHANICAL_ARM_ACTION_HOME,
    MECHANICAL_ARM_ACTION_ZERO,
    MECHANICAL_ARM_ACTION_STOP,
    MECHANICAL_ARM_ACTION_HOME_STATE,
    MECHANICAL_ARM_ACTION_HOME_ABORT,
    MECHANICAL_ARM_ACTION_SPEED_READ
  } MechanicalArm_ActionTypeDef;

  typedef enum
  {
    MECHANICAL_ARM_POSITION_ABSOLUTE = 1U,
    MECHANICAL_ARM_POSITION_RELATIVE_CURRENT = 2U
  } MechanicalArm_PositionModeTypeDef;

  typedef enum
  {
    MECHANICAL_ARM_RESULT_NONE = 0,
    MECHANICAL_ARM_RESULT_OK,
    MECHANICAL_ARM_RESULT_BUSY,
    MECHANICAL_ARM_RESULT_PARAM_ERROR,
    MECHANICAL_ARM_RESULT_TX_ERROR,
    MECHANICAL_ARM_RESULT_MOTOR_ERROR,
    MECHANICAL_ARM_RESULT_ACK_TIMEOUT
  } MechanicalArm_ResultTypeDef;

  typedef struct
  {
    uint16_t SpeedRpm;
    uint8_t Acceleration;
    uint32_t PulseLimit;
  } MechanicalArm_ConfigTypeDef;

  typedef enum
  {
    MECHANICAL_ARM_HOME_NONE = 0,
    MECHANICAL_ARM_HOME_PARAMS_READ,
    MECHANICAL_ARM_HOME_PARAMS_WRITE,
    MECHANICAL_ARM_HOME_PARAMS_VERIFY,
    MECHANICAL_ARM_HOME_TRIGGER
  } MechanicalArm_HomeStageTypeDef;

  /* Last subtransaction only; independent of the requested HOME's TX/ACK.
   * Reply stores up to 18 bytes; ReplyLength is the actual matched length.
   * BusResult is a MotorBus_Result_t, valid only with BusEventValid. */
  typedef struct
  {
    uint32_t UartError, WireTxMs;
    MechanicalArm_HomeStageTypeDef HomeStage;
    uint8_t Function, BusEventValid, BusResult;
    uint8_t WireTransmitted, ReplyReceived, ReplyLength, Reply[18];
    uint8_t VerifyMismatch, VerifyOffset, VerifyExpected, VerifyActual;
  } MechanicalArm_DiagnosticTypeDef;

  typedef struct
  {
    MechanicalArm_ActionTypeDef Action;
    MechanicalArm_AxisTypeDef Axis;
    MechanicalArm_AxisTypeDef FailureAxis;
    MechanicalArm_ResultTypeDef Result;
    int32_t PositionPulses;
    uint16_t SpeedRpm; /* Submitted position speed, not measured speed. */
    uint32_t TxDoneMs; /* UART5 DMA complete; not request/reply/arrival time. */
    int32_t CurrentPosition;
    int32_t CurrentSpeedRpm; /* Signed measured 0x35 speed; not command SpeedRpm. */
    int64_t
        CurrentPositionRaw; /* Full signed 0x36 protocol payload; inspect on legacy range error. */
    uint8_t HomeMode;
    uint8_t MotorCode;
    uint8_t StateFlags[3];
    uint8_t SuccessMask;
    uint8_t FailureMask;
    uint8_t Transmitted;  /* Complete TX observed; never inferred from accepted request. */
    uint8_t Acknowledged; /* Matched reply only; None actions leave this zero. */
    uint8_t StopIdMask; /* Priority STOP targets, bit0=ID1; 0xFF only for true ALL. */
    MechanicalArm_DiagnosticTypeDef Diagnostic;
  } MechanicalArm_EventTypeDef;

  HAL_StatusTypeDef MechanicalArm_Init(UART_HandleTypeDef *huart);
  void MechanicalArm_Process(void);
  MechanicalArm_ResultTypeDef MechanicalArm_Enable(MechanicalArm_AxisTypeDef Axis);
  MechanicalArm_ResultTypeDef MechanicalArm_Disable(MechanicalArm_AxisTypeDef Axis);
  MechanicalArm_ResultTypeDef MechanicalArm_Position(MechanicalArm_AxisTypeDef Axis,
                                                     int32_t Pulses);
  /* Explicit speed and driver acceleration gear (X/Z:0..255, Base:1..255);
   * X/Z gear0 means direct-speed operation without the drive ramp;
   * saved axis configuration and homing parameters are not changed. */
  MechanicalArm_ResultTypeDef MechanicalArm_PositionEx(MechanicalArm_AxisTypeDef Axis,
                                                       int32_t Position, uint16_t SpeedRpm,
                                                       uint8_t Acceleration,
                                                       MechanicalArm_PositionModeTypeDef Mode);
  MechanicalArm_ResultTypeDef MechanicalArm_PositionRead(MechanicalArm_AxisTypeDef Axis);
  /* Dynamic X absolute lookahead: verified None, advance on actual TX complete.
   * Fixed positions share the same mode; arrival still needs real feedback. */
  MechanicalArm_ResultTypeDef MechanicalArm_PositionTrackingEx(MechanicalArm_AxisTypeDef Axis,
                                                       int32_t Position,uint16_t SpeedRpm,
                                                       uint8_t Acceleration,
                                                       MechanicalArm_PositionModeTypeDef Mode);
  MechanicalArm_ResultTypeDef MechanicalArm_SpeedRead(MechanicalArm_AxisTypeDef Axis);
  MechanicalArm_ResultTypeDef MechanicalArm_StateRead(MechanicalArm_AxisTypeDef Axis);
  /** @brief Read Emm 0x3B homing flags into StateFlags[Axis]; single axis only. */
  MechanicalArm_ResultTypeDef MechanicalArm_HomeStateRead(MechanicalArm_AxisTypeDef Axis);
  /** @brief Abort active homing with priority Emm 0x9C; result confirms TX only. */
  MechanicalArm_ResultTypeDef MechanicalArm_HomeAbort(MechanicalArm_AxisTypeDef Axis);
  /* 将当前位置保存为张大头驱动器的单圈机械零度，不会驱动电机运动。 */
  MechanicalArm_ResultTypeDef MechanicalArm_OriginSet(MechanicalArm_AxisTypeDef Axis);
  MechanicalArm_ResultTypeDef MechanicalArm_Home(MechanicalArm_AxisTypeDef Axis, uint8_t HomeMode);
  MechanicalArm_ResultTypeDef MechanicalArm_Zero(MechanicalArm_AxisTypeDef Axis);
  /** @brief Priority stop; cancels the current ARM transaction, even while awaiting ACK.
   * @note Single axis sends FE only to its own ID; ALL sends to IDs1..8.
   * Completion reports TX only. Existing ACK quarantine is retained. */
  MechanicalArm_ResultTypeDef MechanicalArm_Stop(MechanicalArm_AxisTypeDef Axis);
  /** @brief Queue a routine single-axis hold without preempting other UART5 work.
   * @param Axis One of Base/Z/X; ALL is rejected.
   * @return Accepted/busy/error; completion is reported by ResultGet as STOP.
   * @note Tracking zero-speed use only. Human/fault stops use Stop for priority. */
  MechanicalArm_ResultTypeDef MechanicalArm_StopScheduled(MechanicalArm_AxisTypeDef Axis);
  uint8_t MechanicalArm_ConfigSet(MechanicalArm_AxisTypeDef Axis, uint16_t SpeedRpm,
                                  uint8_t Acceleration, uint32_t PulseLimit);
  uint8_t MechanicalArm_ConfigGet(MechanicalArm_AxisTypeDef Axis,
                                  MechanicalArm_ConfigTypeDef *Config);
  uint8_t MechanicalArm_ResultGet(MechanicalArm_EventTypeDef *Event);
  uint8_t MechanicalArm_IsBusy(void);
  MechanicalArm_AxisTypeDef MechanicalArm_AxisGet(const char *Name);
  const char *MechanicalArm_AxisNameGet(MechanicalArm_AxisTypeDef Axis);

#ifdef __cplusplus
}
#endif

#endif
