doinbest/Yachiyo/xjx/模版搭建/output/open-source-acceleration-20261014/GX-Intelligent-Logistics-Silver/Core/wc/Motor.h

#ifndef __Motor_H
#define __Motor_H

#include <stdbool.h>
#include "stdio.h"	
#include "bjdj.h"
#include "my_uart.h"
#include <math.h>
#include "oled.h"
#include <main.h>

#define	M_PI 3.1415926
#define lzjl 58.545264
#define vel 240
#define acc 140
#define bs_jd 0.0015137


#define FRICTION_FACTOR  1.20
#define ERROR_MARGIN     1.15
#define ACCELERATION_FACTOR 1.5

#define smp_mm_x 1.6264*0.4
#define smp_mm_y 0.7835*0.6
#define CW 0
#define CWW 1




void Motor_pos(int fx,double jl,bool num,double jd_num);
void Motor_Stop(void);
void Motor_Delay(uint32_t steps);
int calc_time_for_steps(double steps);
void Motor_pos_s(int fx,double jl,double*pos_X,double*pos_Y,int key,double jd_num,double jd_xs);
void Motor_jd(double jd,bool n,double jd_num);
void Motor_jd_90(double*pos_X,double*pos_Y,bool n);
void Motor_jd_180(double*pos_X,double*pos_Y);
void Motor_jd_0(double*pos_X,double*pos_Y);
void Motor_jd_s(double*pos_X,double*pos_Y,double jd_num);
void Motor_smp(double*pos_X,double*pos_Y,double x,double y,int num,double jd_num);
void Motor_Delay_jd(double jd_num);

// ==================== 导航优化函数 ====================
void Motor_pos_diag(double dx, double dy, double*pos_X, double*pos_Y, int key, double jd_num, double jd_xs);
void Motor_jd_adaptive(double jd, bool n, double jd_num, int max_retries);
void Motor_jd_90_opt(double*pos_X, double*pos_Y, bool n);
void Motor_jd_180_opt(double*pos_X, double*pos_Y);
void Motor_jd_0_opt(double*pos_X, double*pos_Y);
#endif
