doinbest/Yachiyo/(commit log)

2026-08-17 Revert key handling to mecanum control in template
    [key.c, key.h, main.c]
2026-08-17 Add complete STM32F407VGT6 mecanum project baseline
2026-08-21 chore: 保存智能搬运车初始开发状态
2026-08-21 feat: 添加智能搬运车第一版软件底座
2026-09-14 chore: snapshot vehicle firmware before heading hold integration
    [42步进.SLDPRT, GM865二维码模块.SLDPRT, HWT101CT.SLDPRT, OPS9.SLDPRT, 上岸.SLDPRT, 上底板.SLDPRT, 下底板.SLDPRT, 云台夹爪链接架.SLDPRT]
2026-09-14 feat: hold starting IMU heading during finite chassis translation
2026-09-21 chore: checkpoint console UI and user CubeMX generation before DMA integration
2026-09-21 feat: use USART1 DMA with prioritized replies and compact telemetry
2026-09-21 chore: checkpoint current Keil project before reset and yaw-zero controls
2026-09-21 feat: add remote STM32 restart and standalone HWT101 yaw zero
2026-09-21 ui: consolidate device controls and remove redundant favorites
2026-09-22 Default Emm Receive and verify IMU automatically on boot
2026-09-22 fix: plan distance braking and separate stop evidence from arrival
    [chassis_config.h, chassis_distance_test.c, chassis_motion.c, chassis_route_test.c]
2026-09-27 chore: snapshot PCB bring-up before cooperative single-pick implementation
2026-10-02 chore: checkpoint before firmware cleanup
    [42步进.SLDPRT, GM865二维码模块.SLDPRT, HWT101CT.SLDPRT, OPS9.SLDPRT, 上岸.SLDPRT, 上底板.SLDPRT, 下底板.SLDPRT, 云台夹爪链接架.SLDPRT]
2026-10-02 refactor: remove unused camera and motor callback compatibility APIs
2026-10-02 feat: redesign parameter console and verified readback
    [serial_bridge.py]
2026-10-02 fix: align parameter layout and clarify claw timing
2026-10-02 Publish Yachiyo project under xjx folder
    [42步进.SLDPRT, GM865二维码模块.SLDPRT, HWT101CT.SLDPRT, OPS9.SLDPRT, 上岸.SLDPRT, 上底板.SLDPRT, 下底板.SLDPRT, 云台夹爪链接架.SLDPRT]
2026-10-03 fix: decode LDS manual power alarm example correctly
2026-10-03 feat: verify radar identity over existing UART
2026-10-03 chore: checkpoint before motor bus startup recovery
2026-10-03 fix: recover UART5 startup framing errors before first motor command
2026-10-03 chore: checkpoint before chassis turn speed tuning
2026-10-03 feat: raise console translation test limit to 300 mm per second
2026-10-03 feat: raise chassis turn limit to 100 degrees per second
2026-10-08 chore: checkpoint before chassis and vision consolidation
2026-10-08 chore: checkpoint before MaterialVision retirement
2026-10-08 refactor: retire MaterialVision and migrate grab calibration
2026-10-08 fix: sync reversed gripper calibrated pulse widths
2026-10-11 chore: snapshot homing implementation before restoring boot tray home
2026-10-11 chore: snapshot boot console diagnostics before parallel homing
2026-10-11 chore: snapshot homing API header before updating startup documentation
2026-10-11 feat(homing): launch arm and tray boot homes concurrently
2026-10-11 chore: snapshot workspace before two-stage tracking pickup
2026-10-13 chore: snapshot current firmware and console state
    Save the current chassis and X/Z motion changes, mission integration, console, tests, and documentation as a recovery checkpoint. This snapshot does not imply full regression or hardware acceptance.
2026-10-14 chore: snapshot vehicle project before GitHub backup
    Save the current firmware, console, tests, parameter definitions and current documentation as a project checkpoint.
    Validation: firmware host regression PASS; browser tests 632/632 PASS; Python bridge tests 103/103 PASS; radar wire contract PASS; CRLF-aware staged diff check PASS.
    Generated output and runtime logs remain local. This checkpoint does not assert full physical contest acceptance.
2026-10-16 2026-10-16 18:03:49 电机总线故障bug
2026-10-16 2026-10-17 02:06:50 项目完整保存
2026-10-16 取消机构Receive动作应答前保存当前工程
2026-10-16 2026-10-17 07:32:32 当前代码完整保存
    保存当前工作区源码、测试、文档与工程配置。包含独立编号环取仓X30调整及当前机构动作应答改动；各项验证与实车状态见开发记录。本次仅Git保存和上传。
2026-10-16 串口莫名其妙不bug版本
    按用户指定名称完整保存当前工程源码、测试、文档与配置。
2026-10-16 串口莫名其妙不bug版本
    补充保存上传期间新增的当前工程改动，包含源码、测试、文档和配置。
