doinbest/Yachiyo/(notices)

Notices in the files:
xjx/模版搭建/output/open-source-acceleration-20261014/GX-Intelligent-Logistics-Silver/Core/Inc/main.h:
Copyright (c) 2024 STMicroelectronics.
All rights reserved.
This software is licensed under terms that can be found in the LICENSE file
xjx/模版搭建/Code/template/Core/Src/main.c:
Copyright (c) 2026 STMicroelectronics.
